EOSCogniton/ELIZ-2021/CR_Cost_Report/01_BOM/MS/MS_A0100/MS_A0100_Picture.png

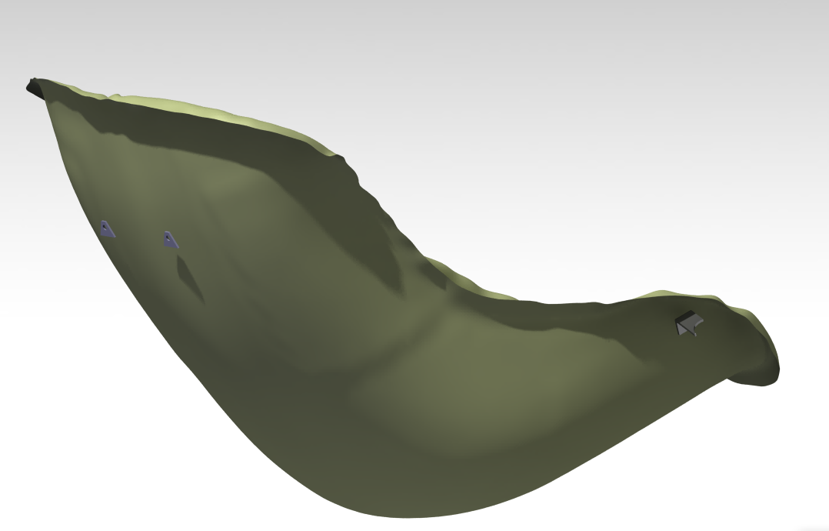
CR_Cost_Report/01_BOM/MS/MS_A0100/MS_A0100_Picture.png
