EOSCogniton/ELIZ-2021/FR_Frame_Body/modèles CATIA pour 0A/FR_A0300 (Pedal Assy) (Invictus)/Notes.txt

distance trou-trou = 5,77 mm
distance verticale jusqu'à l'axe = 7,75 mm
