EOSCogniton/ELIZ-2021/RC_Rendus_Compet/IAD/Bulkhead compliance.docx

\begin{figure}[h]

\centering

\includegraphics[width=1\textwidth]{Images/Page de garde FSG.png}

\label{fig:pdg}

\end{figure}Z

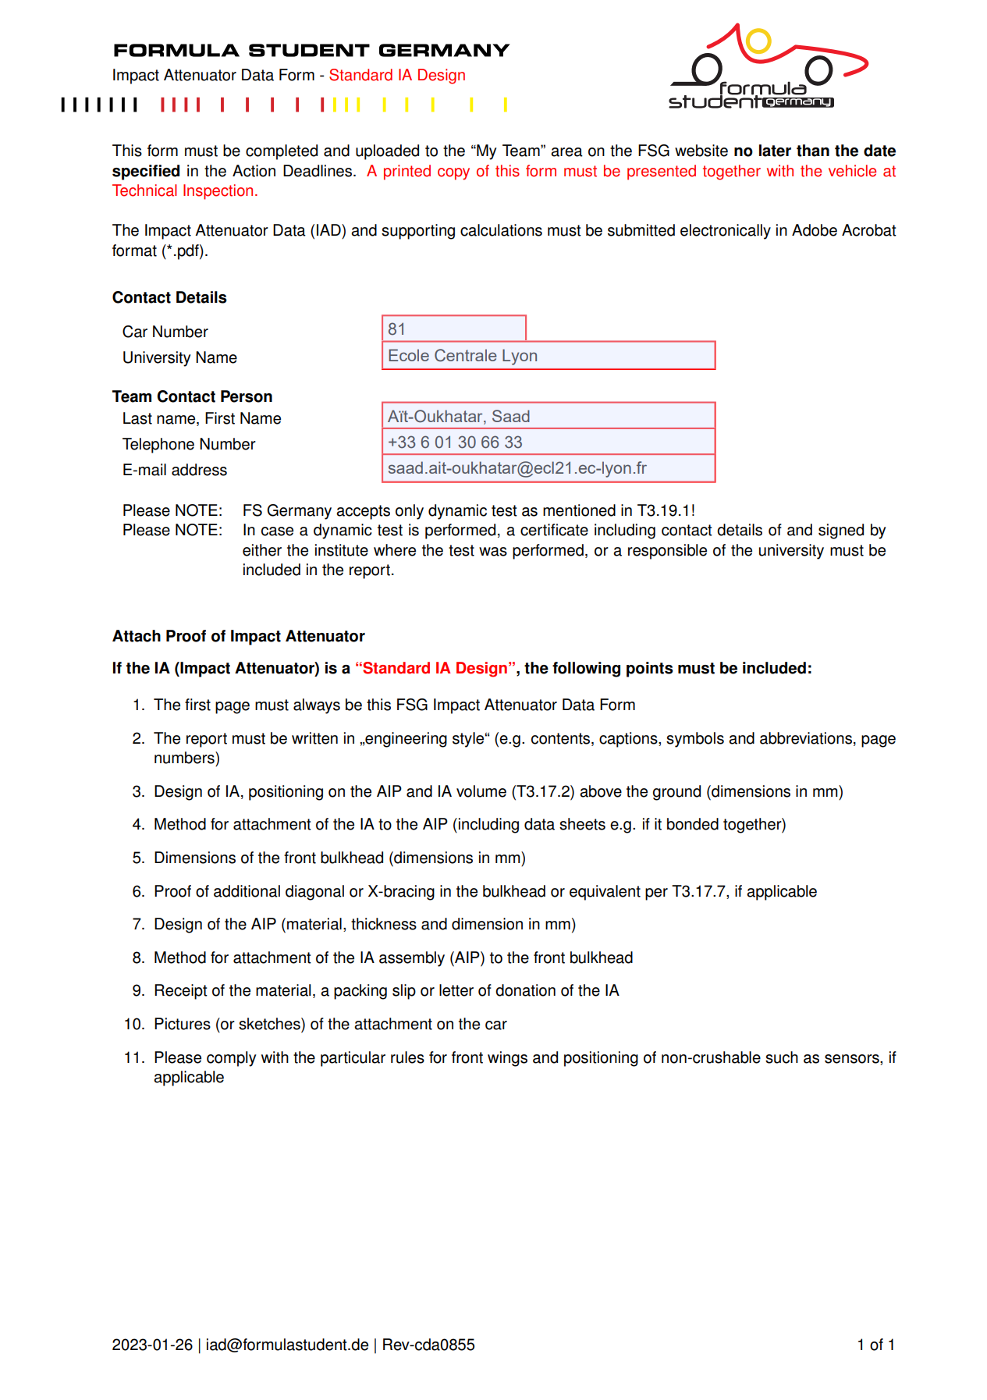
[picture p14: figure]

3. Design of IA, positioning on the AIP and IA volume :

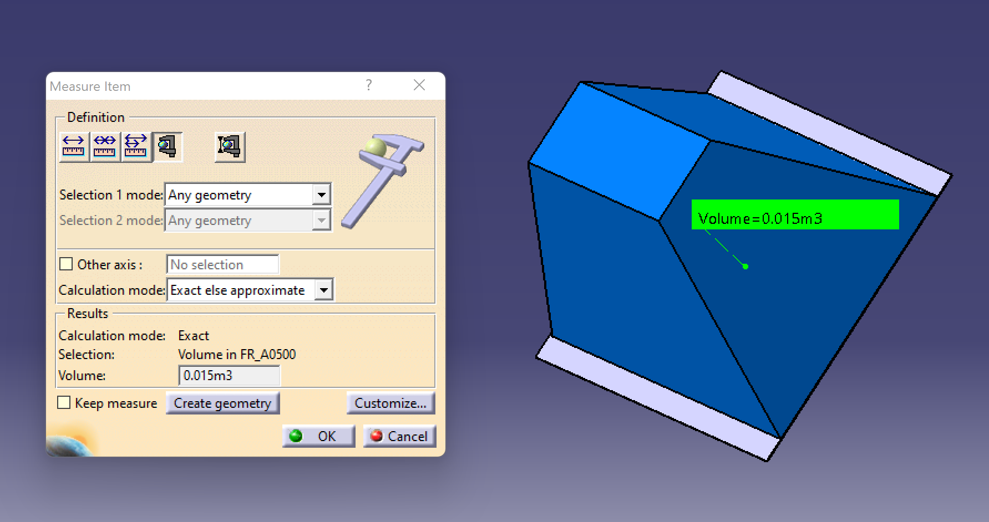
[picture p15: figure]
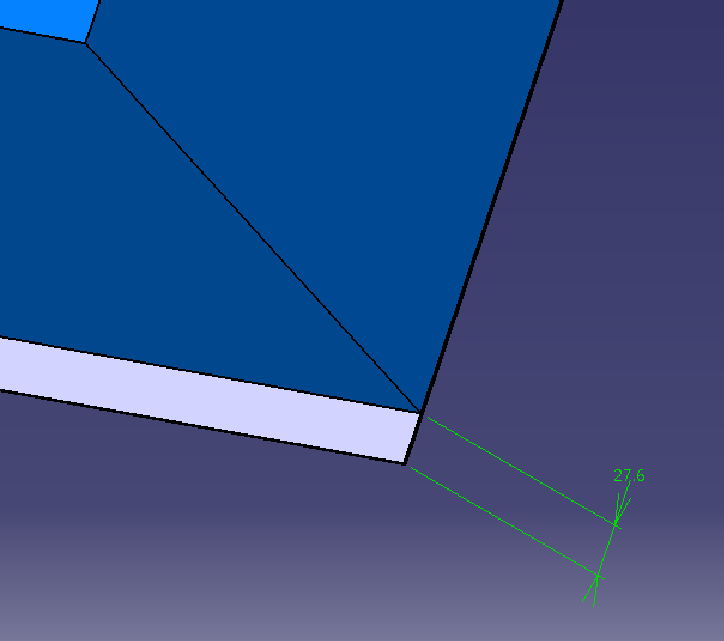
[picture p16: figure]

4. Method for attachment of the IA to the AIP

The Impact Attenuator is glued to the Anti-Intrusion plate. Here follows the data sheet of the glue used :

5. & 6. Dimensions of the front bulkhead and proof of an additional diagonal :

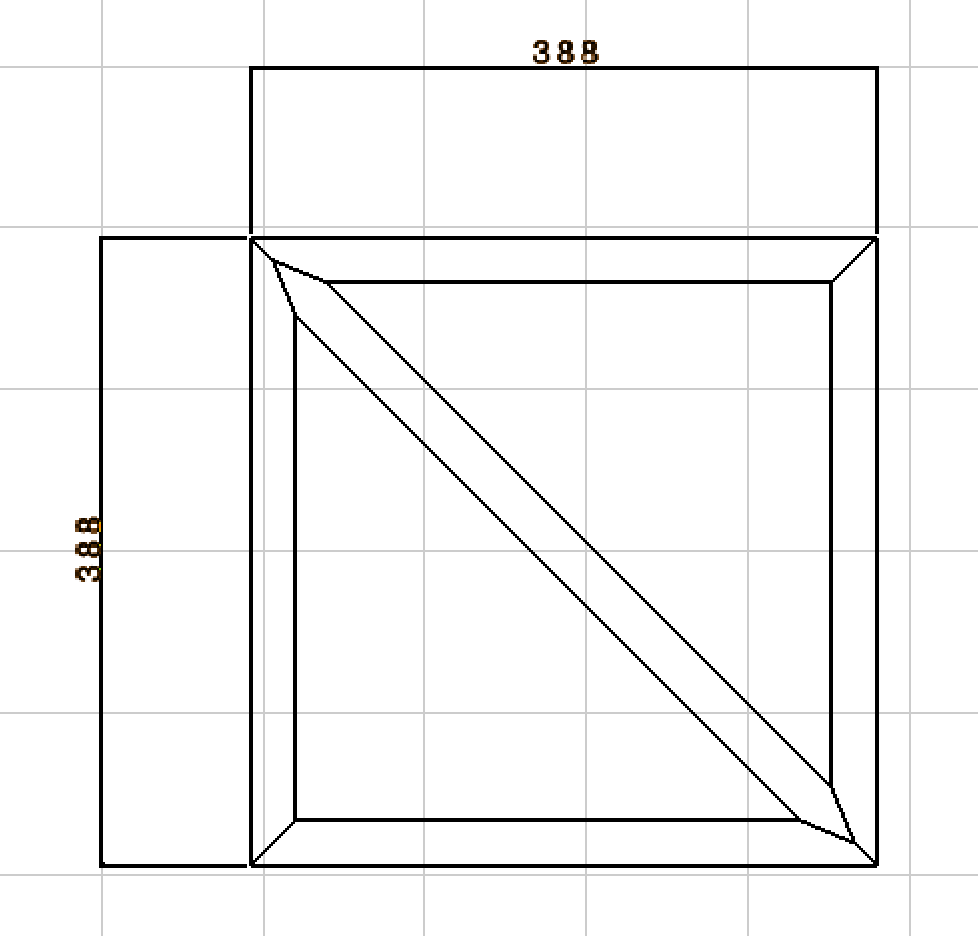
[picture p17: figure]

Tubes dimensions : 28 x 1.5

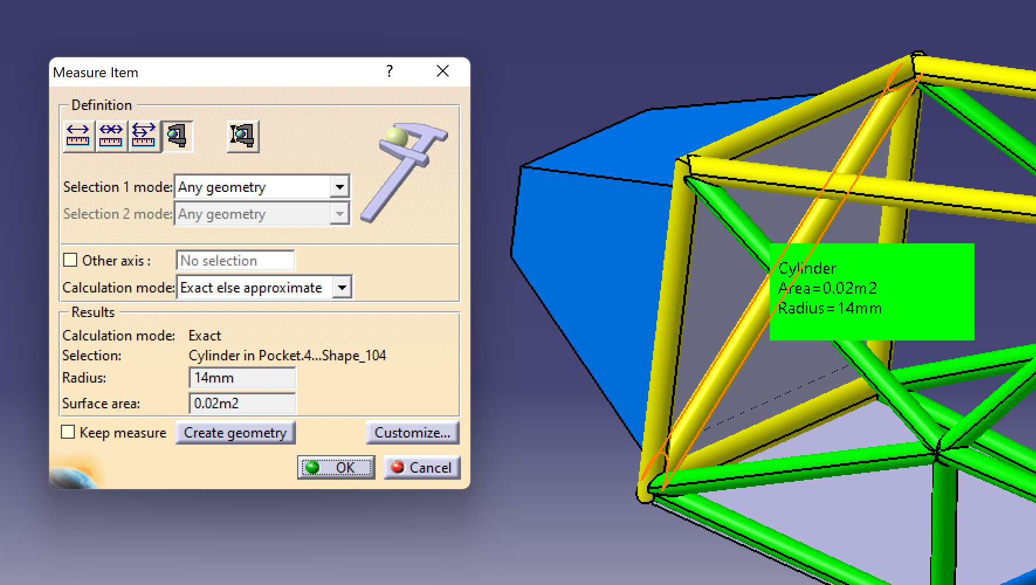
[picture p18: figure]

7. Design of the AIP :

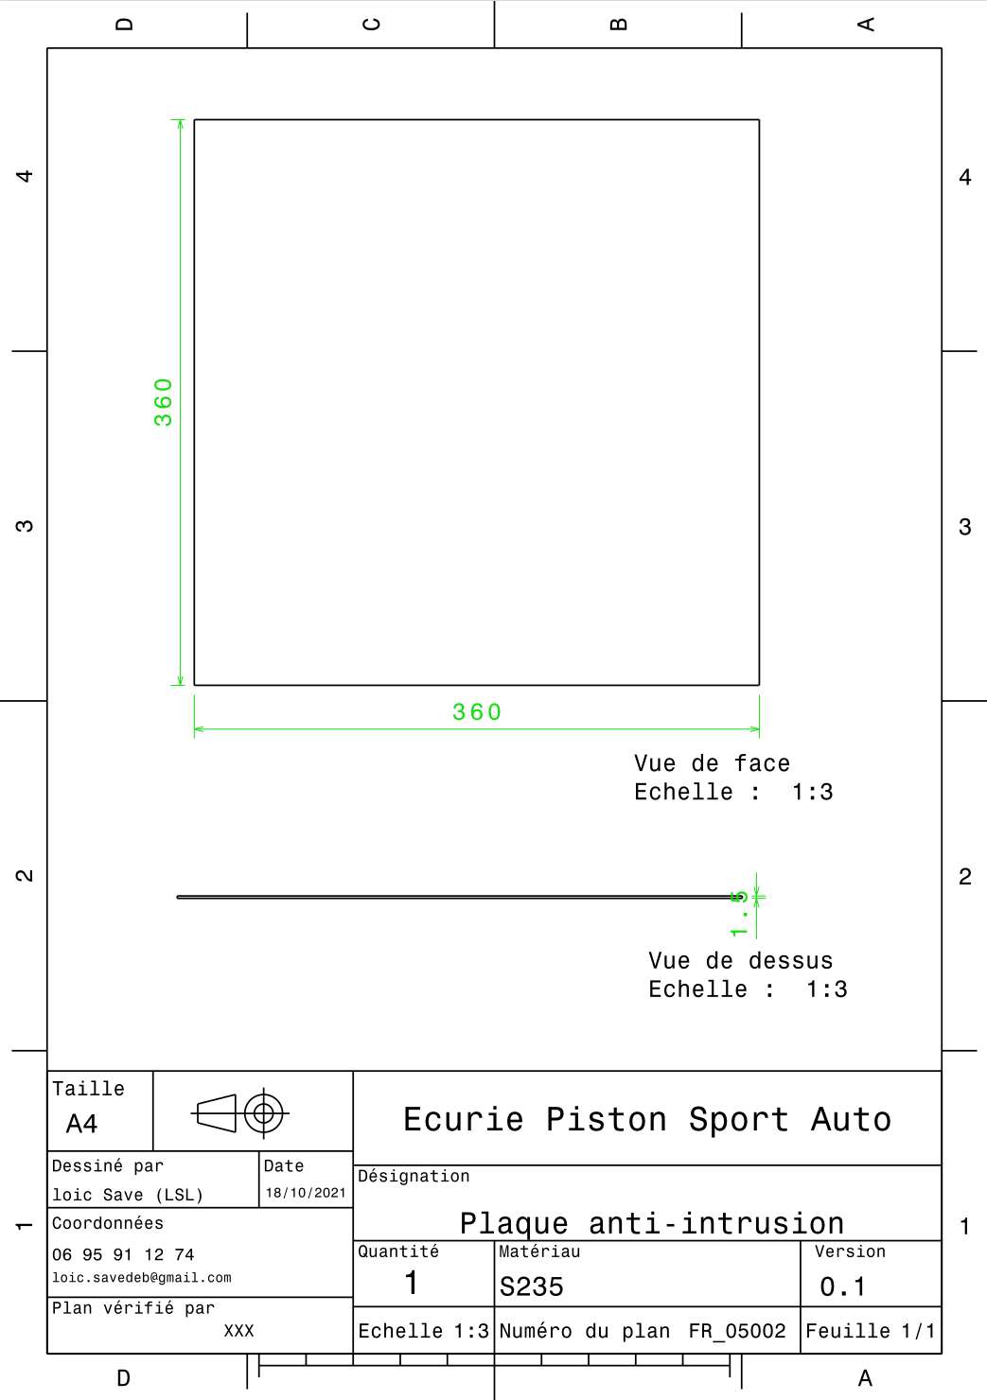
[picture p19: figure]

8.

9.

10.
