EOSCogniton/ELIZ-2021/FR_Frame_Body/FR_A01100 (gabarit)/firewall/consignes impression gabarit.docx

Pour la partie haute : 4 attaches longues

Pour la partie milieu haute : 2 attaches courtes, un support

Pour la partie milieu inf : 2 attaches 15d et 2 jointures milieu

Pour la partie basse : 2 attaches 15d
