EOSCogniton/ELIZ-2021/FR_Frame_Body/FR_A0100 (Frame)/Frame_Tutos/Tutoriel_Gueules_de_loup_Invictus.docx

Tutoriel gueules de loup

Rédigé initialement par Optimus

MAJ Par Invictus le 26/11/19

Ci-dessous les différentes étapes pour une gueule de loup, le tout est illustré pour le tube Shape_712

Le but de ce tutoriel est de vous expliquer comment faire des Gueules de Loup. Les Gueules de Loup sont les découpes Laser effectués sur les extrémités des tubes pour qu’ils puissent s’emboiter entre eux et ainsi pouvoir être soudés.
En effet, Catia ne les fait pas automatiquement, donc il faut modifier CHAQUE tube 1 par 1 pour pouvoir les envoyer en Prod.
Ce tutoriel vous explique comment les dessiner, et comment savoir quel tube s’emboite dans quel tube.

I - Choix des tubes relimitants

Pour commencer, seront relimitants les tubes ayant une « relimitation bissectrice » au nœud étudié

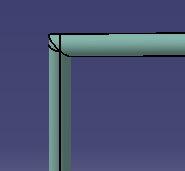
[picture p25: figure]
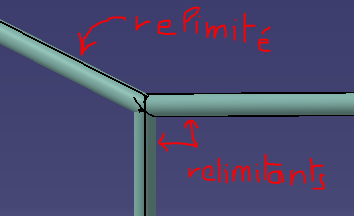
[picture p26: figure]

Le bulkhead, le front hoop et le main hoop sont relimitants

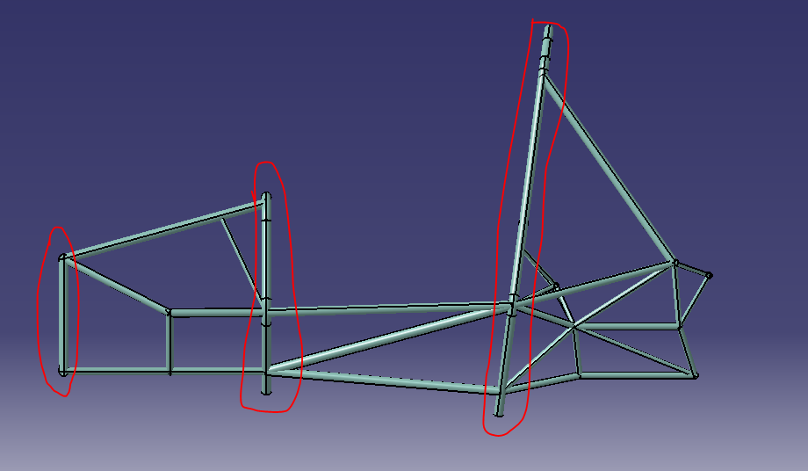
[picture p27: figure]

Enfin, lorsqu’un tube entre dans un autre, c’est lui qui est relimité (celui qui rentre). Attention, un tube peut être relimitant par rapport à un tube, et relimité par rapport à un autre.

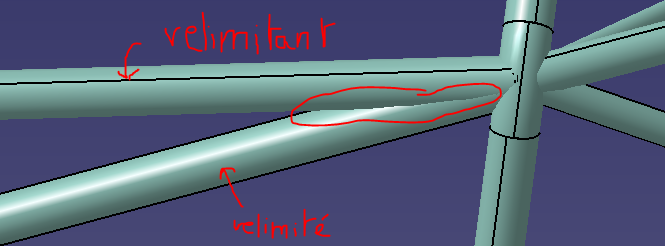
[picture p28: figure]
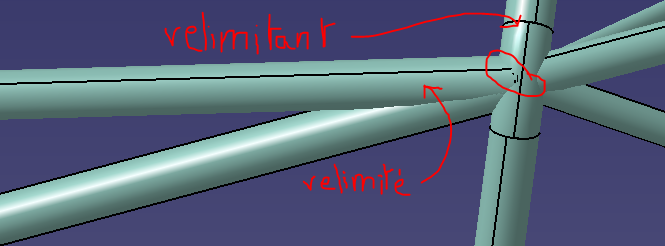
[picture p29: figure]

II – Faire une Gueule de Loup

Ci-dessous les différentes étapes pour une gueule de loup, le tout est illustré pour le tube Shape_712

- Choisir un tube de travail (cf liste donnée à chacun) tube relimité
- Ouvrir l’assemblage Frae_Prod (STUF-2020\FR_Frame_Body\FR_A0100 (Frame)\Frame_Production\Tubulaire_Prod)
- Chercher le tube à travailler dans l’arbre
- Ouvrir sa sous arborescence (signe +)

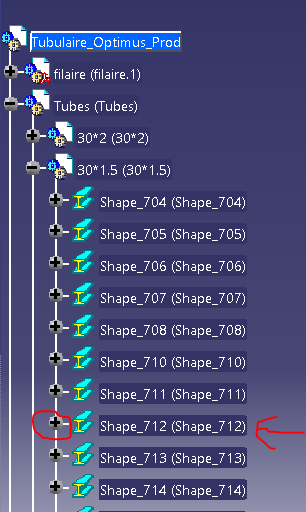
[picture p30: figure]

- Double cliquer pour en faire l’objet de travail

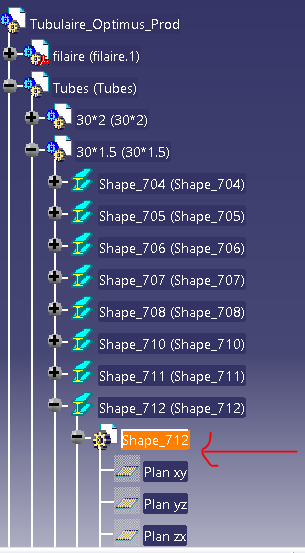
[picture p31: figure]

(**)

- Démarrer le mode part design (Démarrer, conception mécanique, Part design)
- Faites Clic Droit sur votre Part et faites « Recadrez sur » pour la retrouver dans l’espace.
- (*) Repérer un tube avec lequel il entre en contact, et sur lequel il devra s’adapter. Ce tube sera le relimitant (ici, le tube rouge doit s’adapter au jaune et au bleu)

Cf aide à la fin pour ce choix

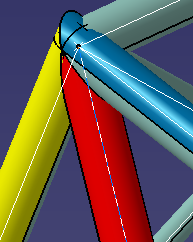
[picture p32: figure]

- Créer un plan normal sur le fil (axe) correspondant à ce tube relimitant (celui qui impose l’adaptation, pas celui que l’on travaille (relimité))

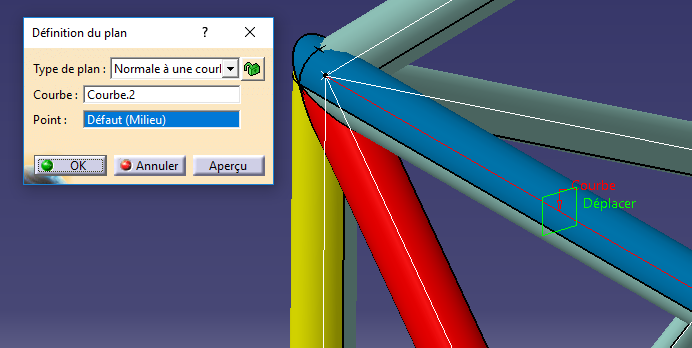
[picture p33: figure]

- Créer une esquisse sur ce plan
- Dessiner un cercle de diamètre le diamètre extérieur du tube relimitant
- Créer une contrainte de coïncidence (distance nulle) entre le centre du cercle et l’axe du tube relimitant (axe en rouge sur le screen (axe du tube bleu))

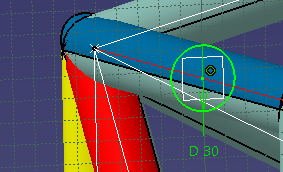
[picture p34: figure]

- Sortir de l’esquisse
- Créer une poche depuis cette esquisse, et sur une longueur permettant de dépasser totalement le tube relimité

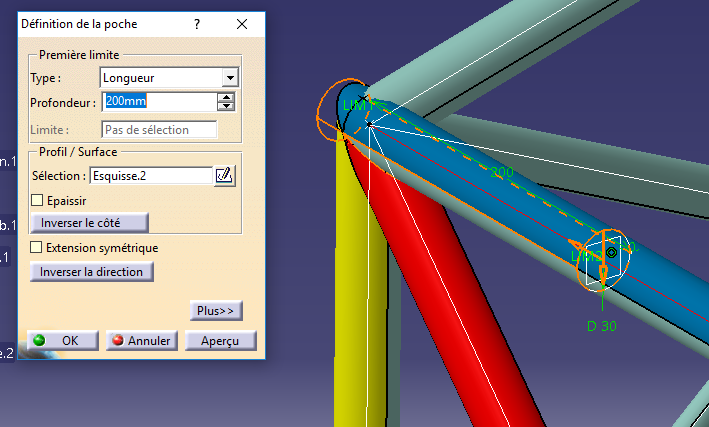
[picture p35: figure]

- Réitérer l’opération depuis le point (*), pour tous les autres tubes relimitants qui entrent en contact avec le notre (par exemple le jaune ici)
- Faites bien attention à ce que vous soyez bien dans l’arbre dans la Part du tube ! Sinon votre poche peut être en train de s’appliquer sur d’autres tubes !
- Enregistrer le tube travaillé uniquement ! (Fichier/enregistrer, en restant dans la configuration de la photo (**)), du coup en fermant l’assemblage Frame_Prod, on n’enregistre pas !!

OU :

Clic droit sur l’objet en cours, puis sous menu « objet… » puis « ouvrir dans une nouvelle fenêtre », puis là vous enregistrez ! Puis vous fermez l’assemblage sans enregistrer, et vous le réouvrez pour repartir sur un nouveau tube

- On obtient alors le tube correctement découpé

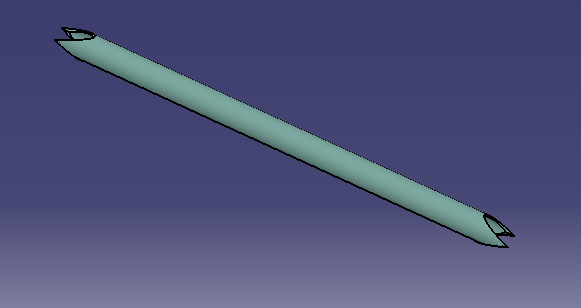
[picture p36: figure]

- N’oubliez pas de Push et de remplir le Excel / Liste de choses à faire qui vous aura été fourni

https://docs.google.com/spreadsheets/d/1tl6bBZY0b3RQ9-AJJpEZ0ktwOgrjCneLkRfVlmMJEiY/edit?usp=sharing
