EOSCogniton/ELIZ-2021/DR_Design_Report/07_Visuels_presentation/A - Overall vehicle design - Final.pdf

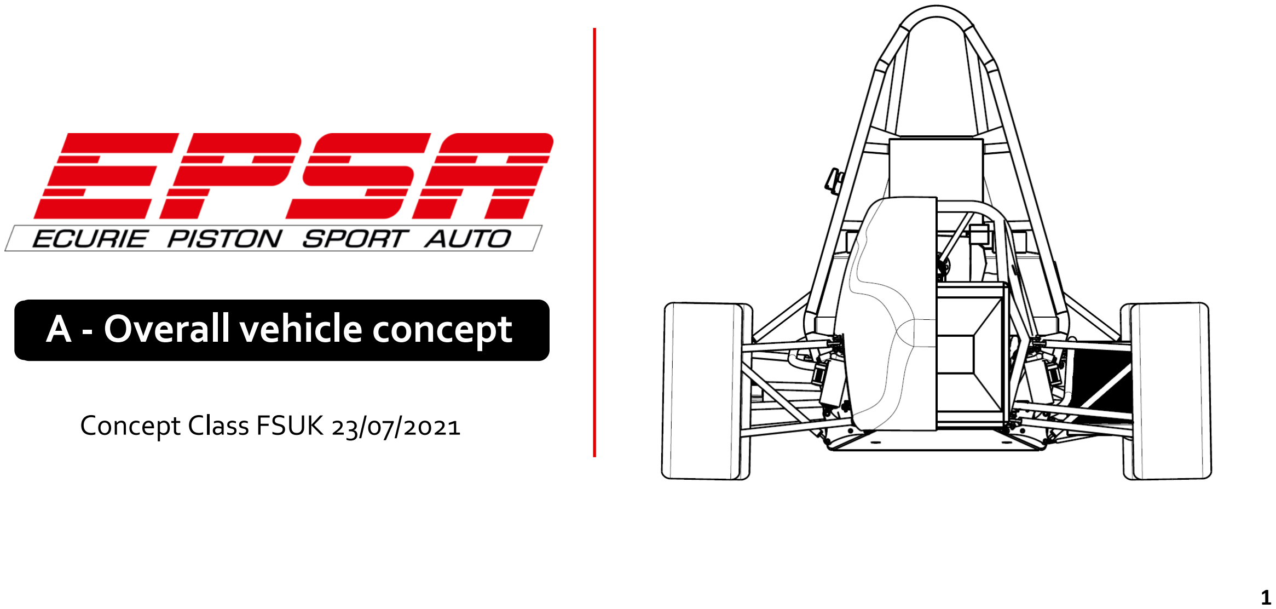
[picture p56: page 1]

# A Management Document - Overall vehicle concept

# Concept Class FSUK 23/07/2021

1

© EPSA Association, 2019. All rights reserved. Information contained in this document is indicative only. No representation or warranty is given or should be relied on that it is complete or correct or will apply to any particular project. This will depend on the technical and commercial circumstances. It is provided without liability and is subject to change without notice. Reproduction, use or disclosure to third parties, without express written authorisation, is strictly prohibited.

# Objectives

# 1st electric vehicle: Pass the Scrutineering + Finish endurance

# Focus on reliability

Event | Objective | Max pts
Cost Event | 75 | /100
Business Event | 60 | /75
Design Event | 80 | /150
Skid Pad | 30 | /75
Acceleration | 30 | /100
Autocross | 40 | /125
Endurance | 125 | /275
Efficiency | 10 | /100
Total | 450 | /1000
Event | Objective
SkidPad | 5,3 sec
Acceleration | 4,4 sec
Endurance | Finish

2

# The vehicle: Valkyriz

3

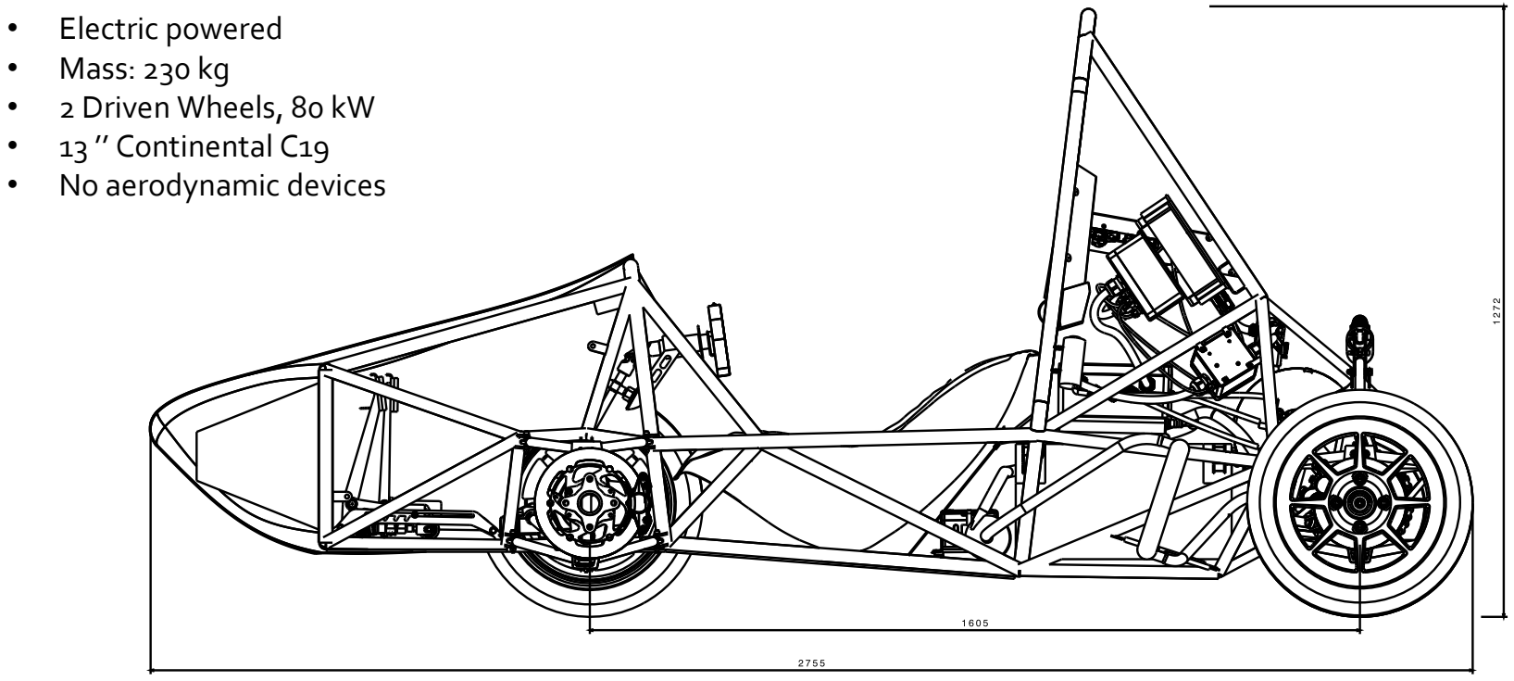
[picture p57: figure]
• Electric powered • Mass: 230 kg • 2 Driven Wheels, 80 kW • 13 ’’ Continental C19 • No aerodynamic devices

# Frame & Body

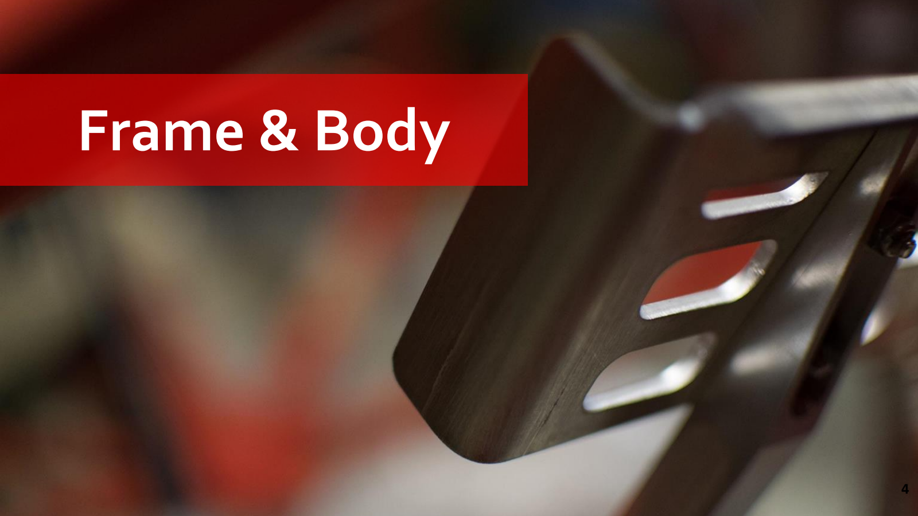
[picture p58: page 4]

4

# Frame & Body

5

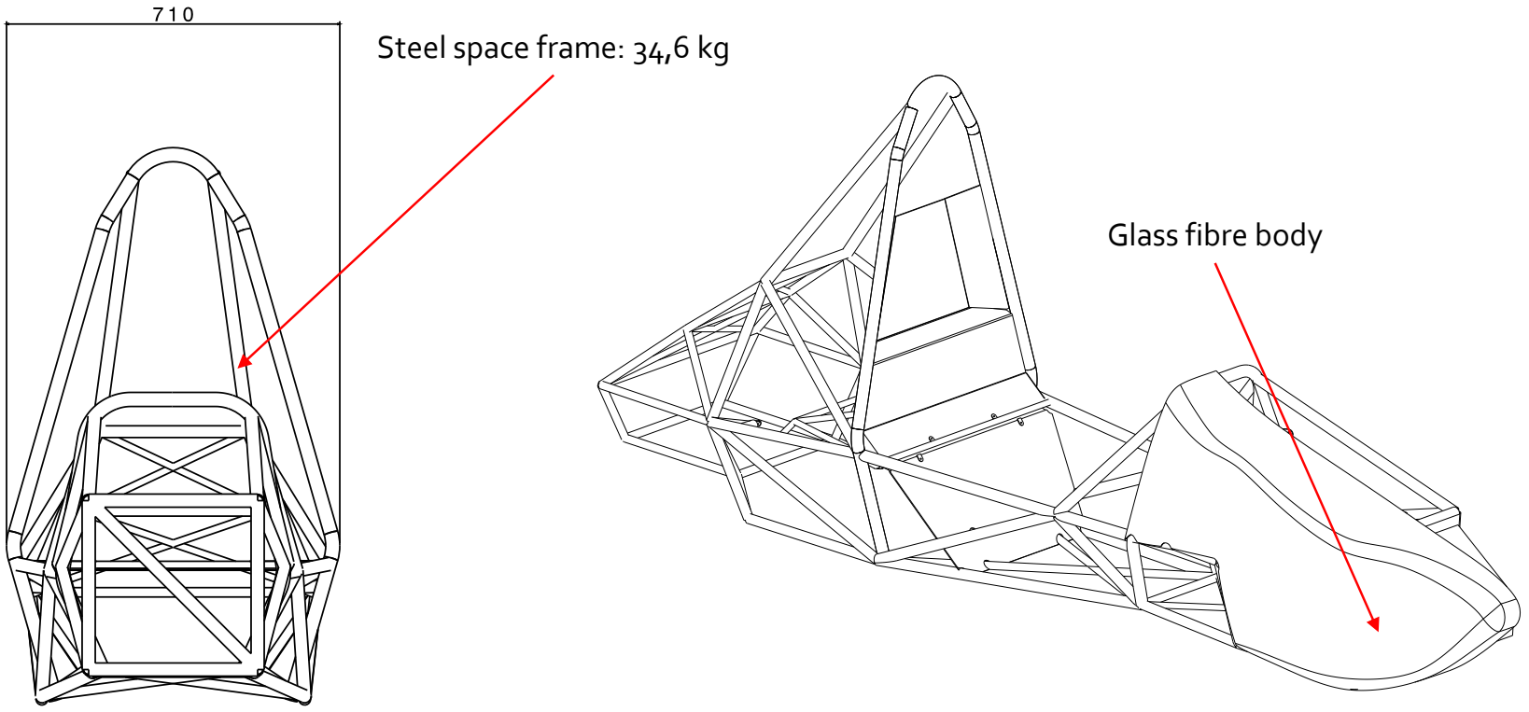
[picture p59: figure]
Steel space frame: 34,6 kg; Glass fibre body

# Suspension system

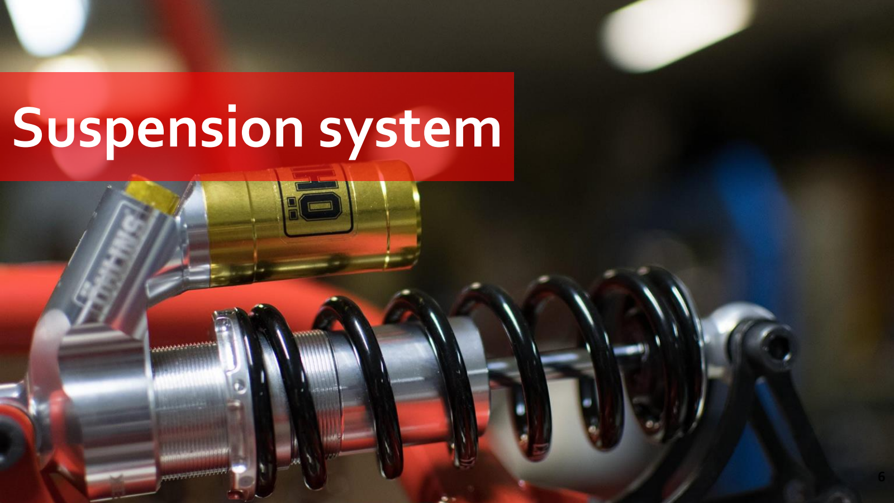
[picture p60: page 6]

6

# Front Suspension System

# Pull rod

# Anti roll bar Double wishbone

# Parallel steering system

7

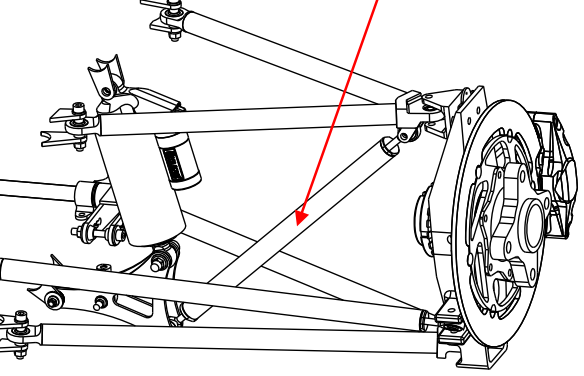
[picture p61: figure]

# Rear Suspension System

# Double wishbone

# Drexler limited slip differential

# Push Rod

8

# Powertrain

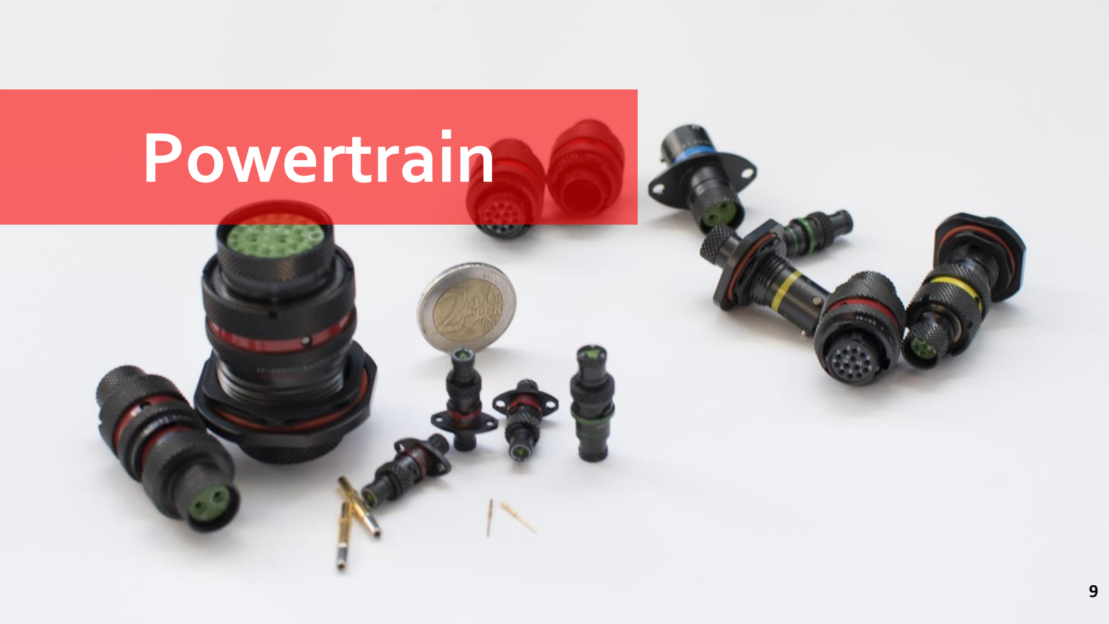
[picture p62: page 9]

9

# Powertrain

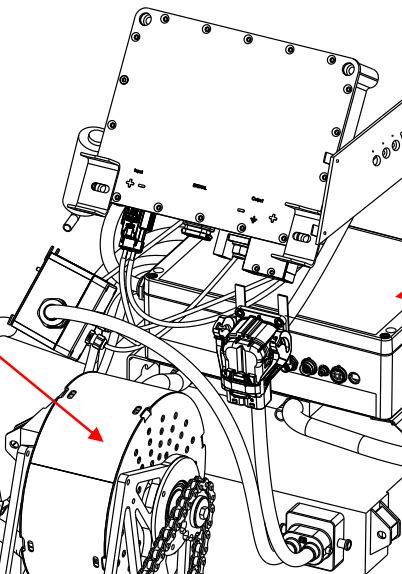
[picture p63: figure]

# One Motor EMRAX 228: 80 kW

# Accumulator: 7.3 kWh

# Inverter BAMOCAR D3

# 2 driven wheels

# Liquid Cooling system

10

# Overview

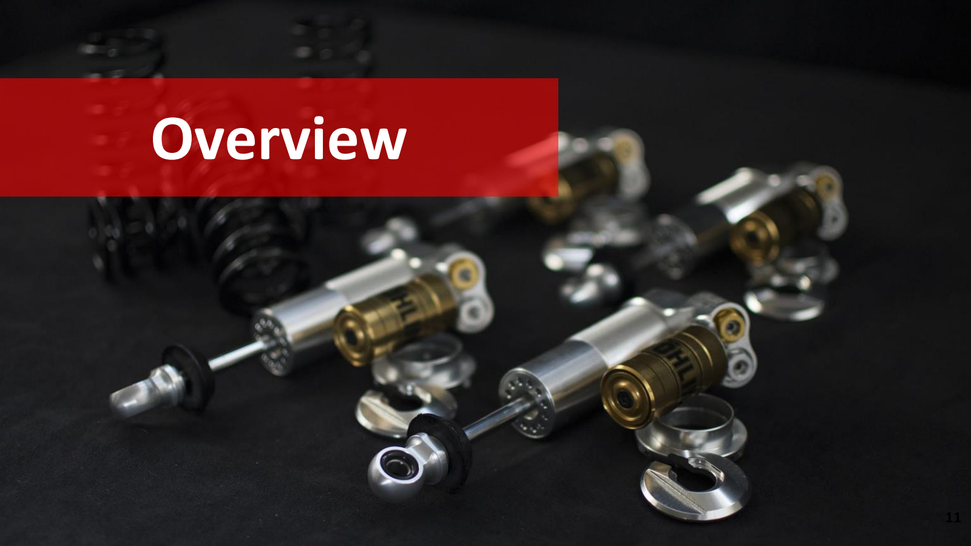
[picture p64: page 11]

11

# Mass schedule

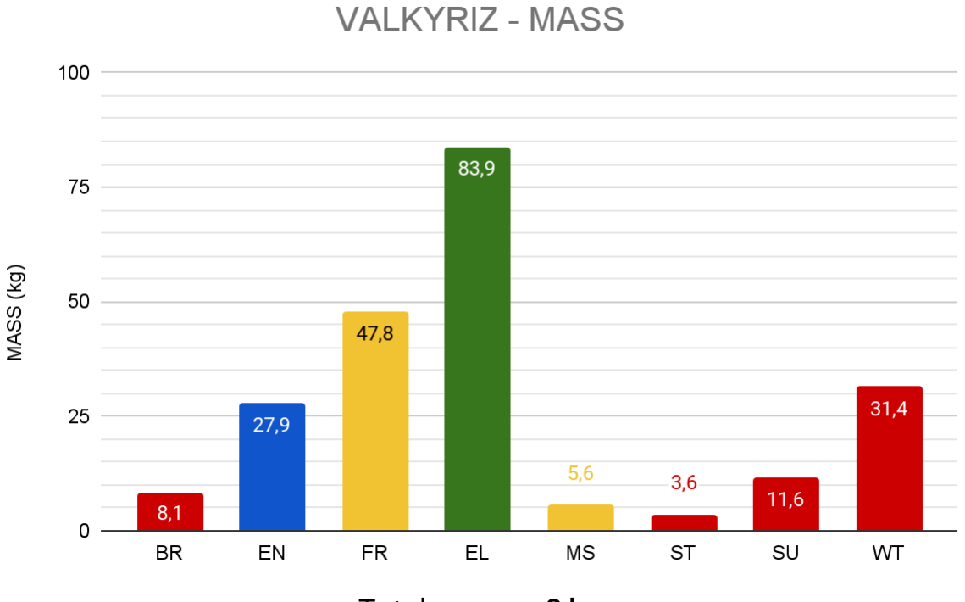
[picture p65: figure]

# Total mass: 218 kg

12

# Cost schedule

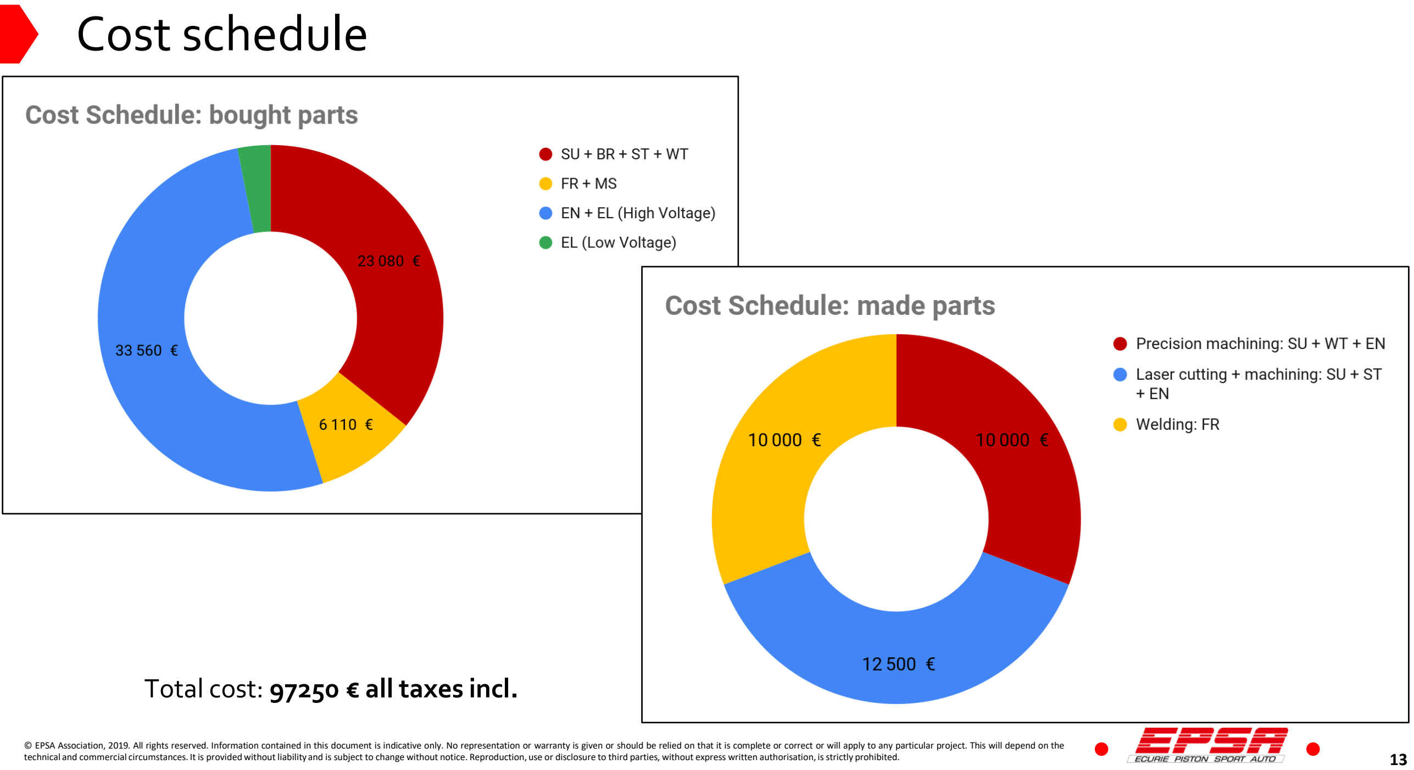
[picture p66: page 13]

Total cost: 97250 € all taxes incl.

13

# Appendices

# XXh - XXh

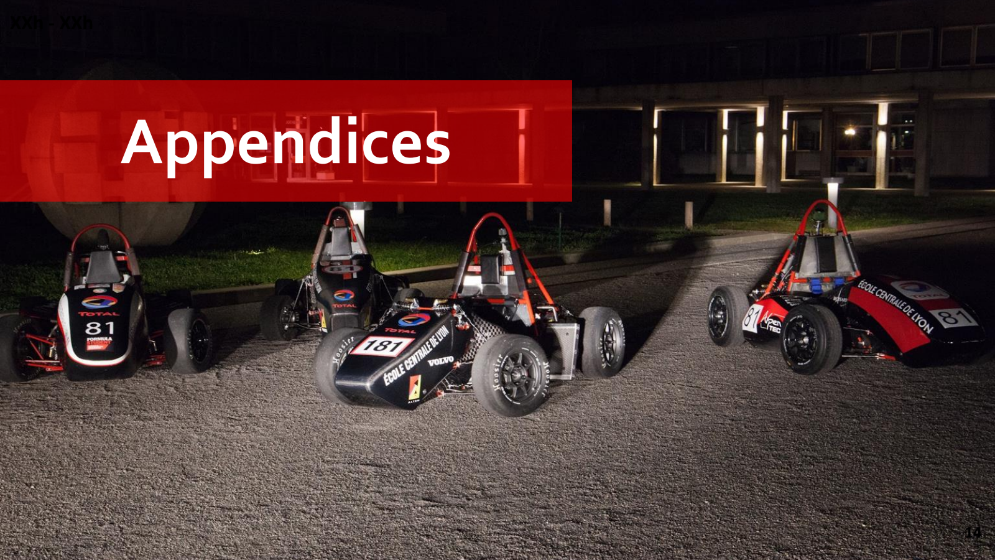
[picture p67: page 14]

14

# Front suspension: Top View

15

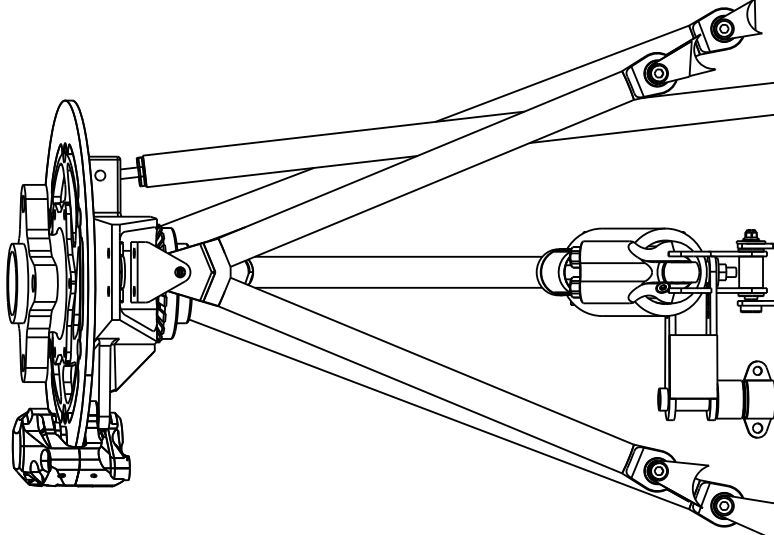
[picture p68: figure]

# Rear suspension: Top View

16

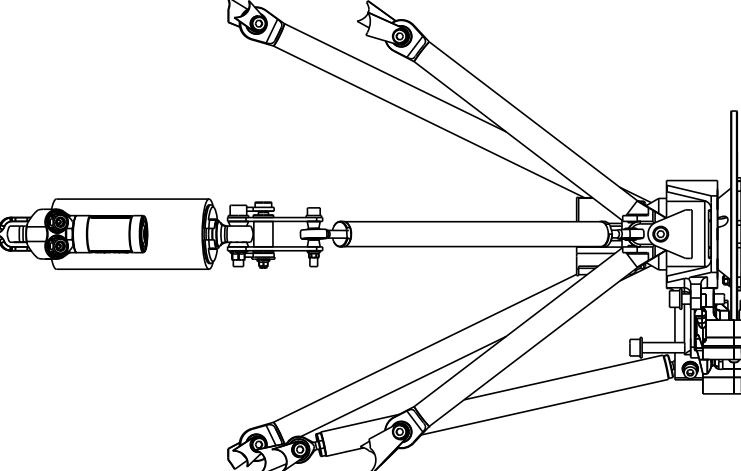
[picture p69: figure]

# Rear suspension system

17

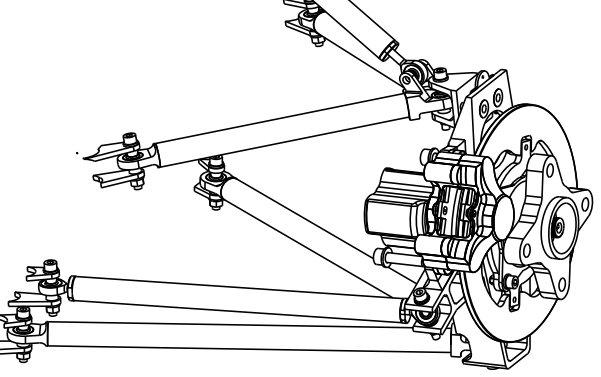
[picture p70: figure]

# Powertrain integrated into the Frame

18

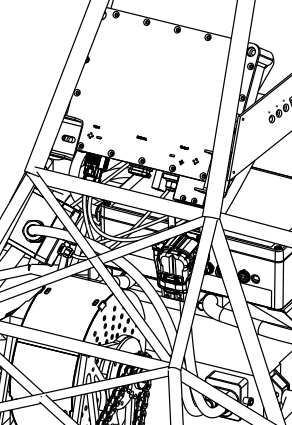
[picture p71: figure]

# Frame

19

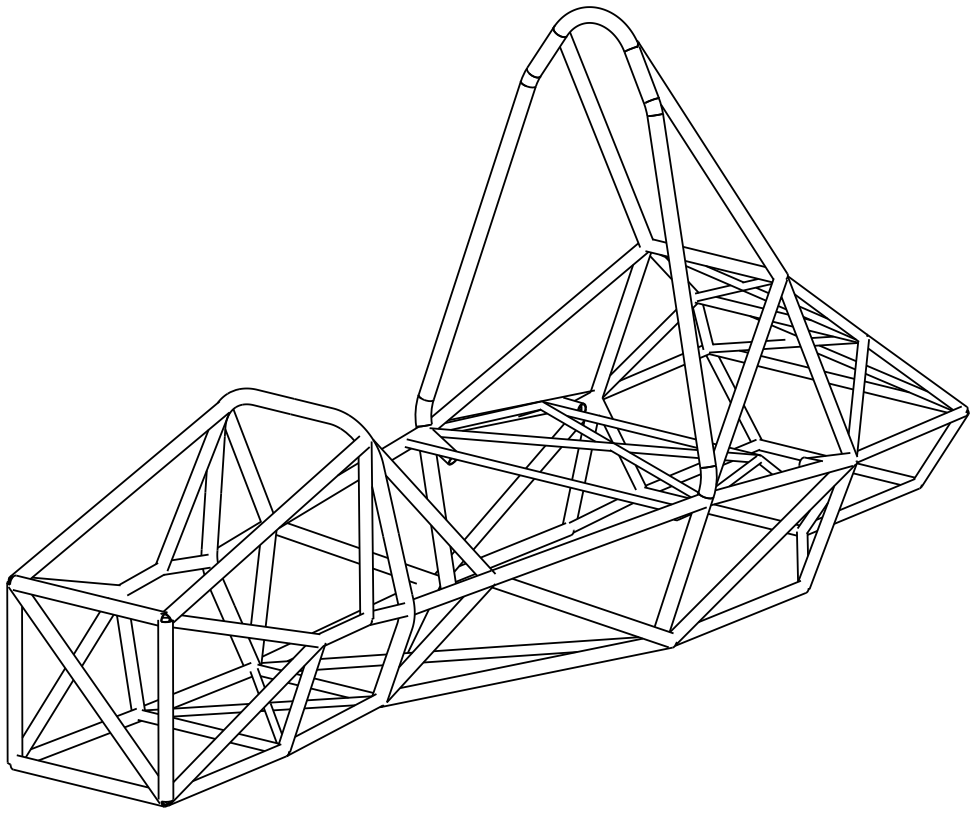
[picture p72: figure]

# Frame: Top View

20

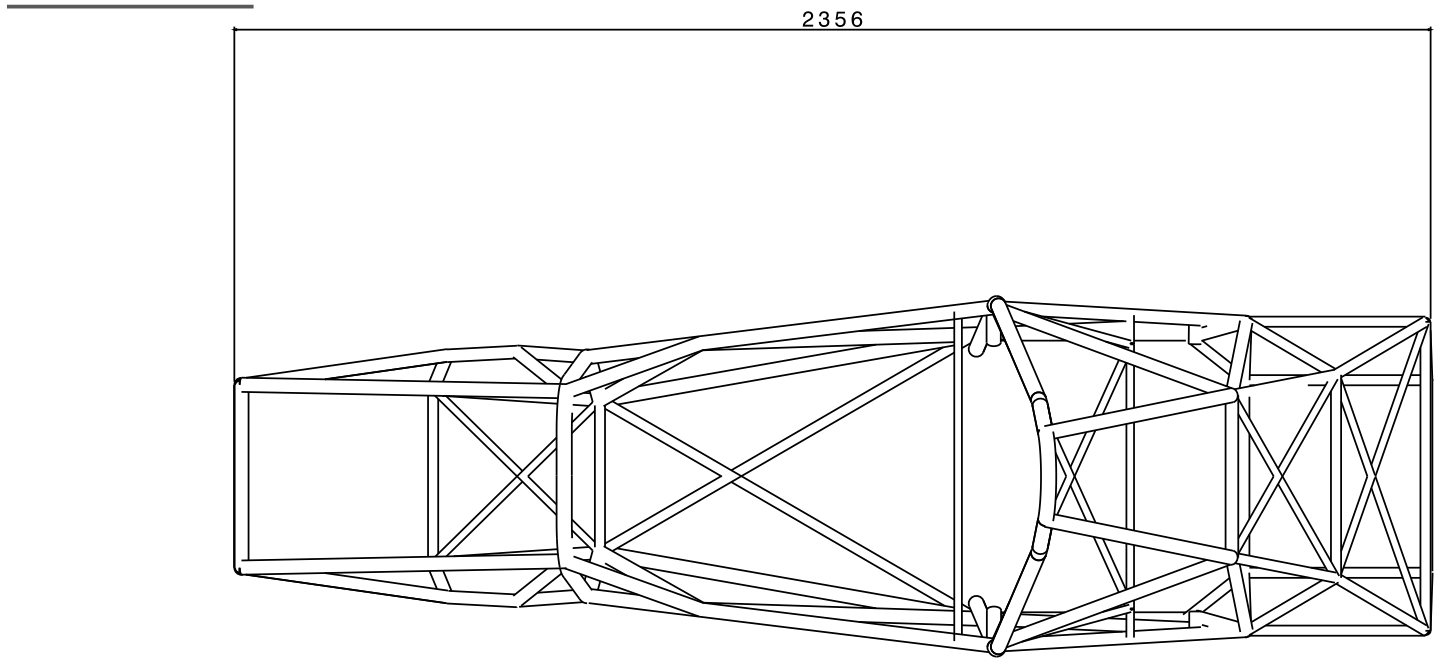
[picture p73: figure]

# Frame: Side View

21

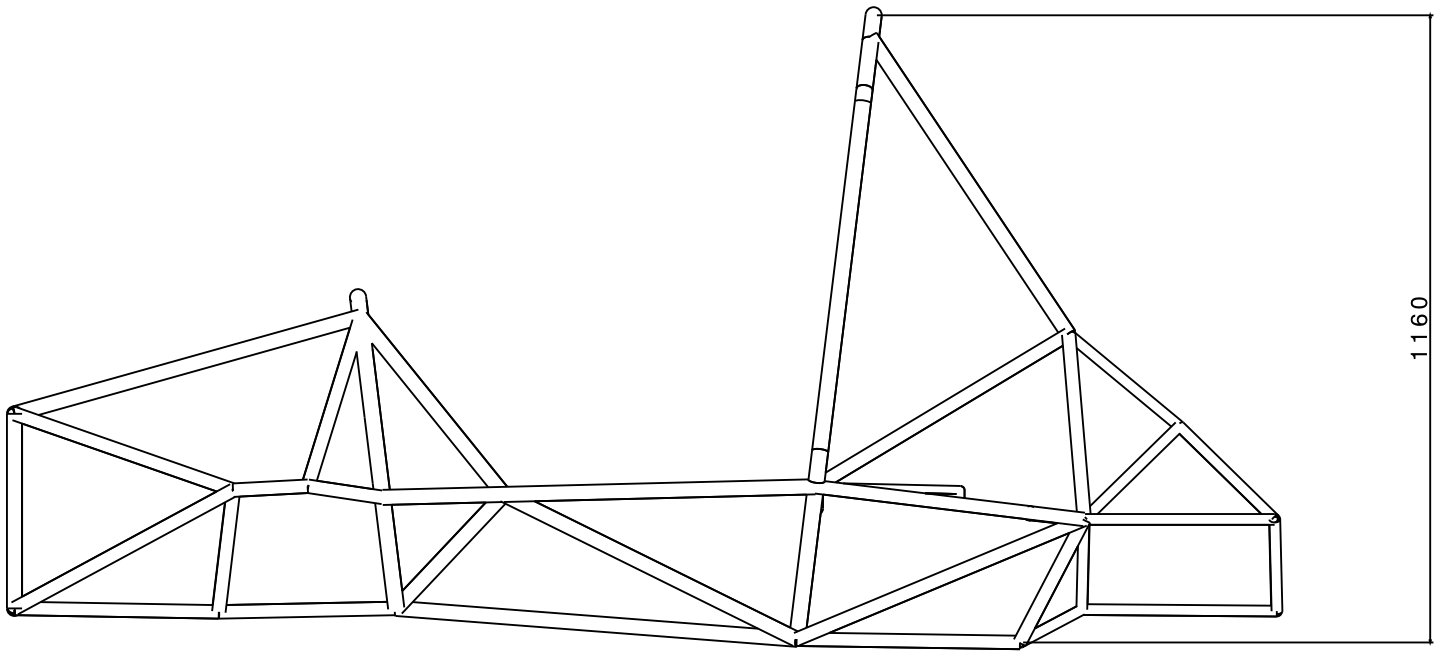
[picture p74: figure]

# A-Arms

22

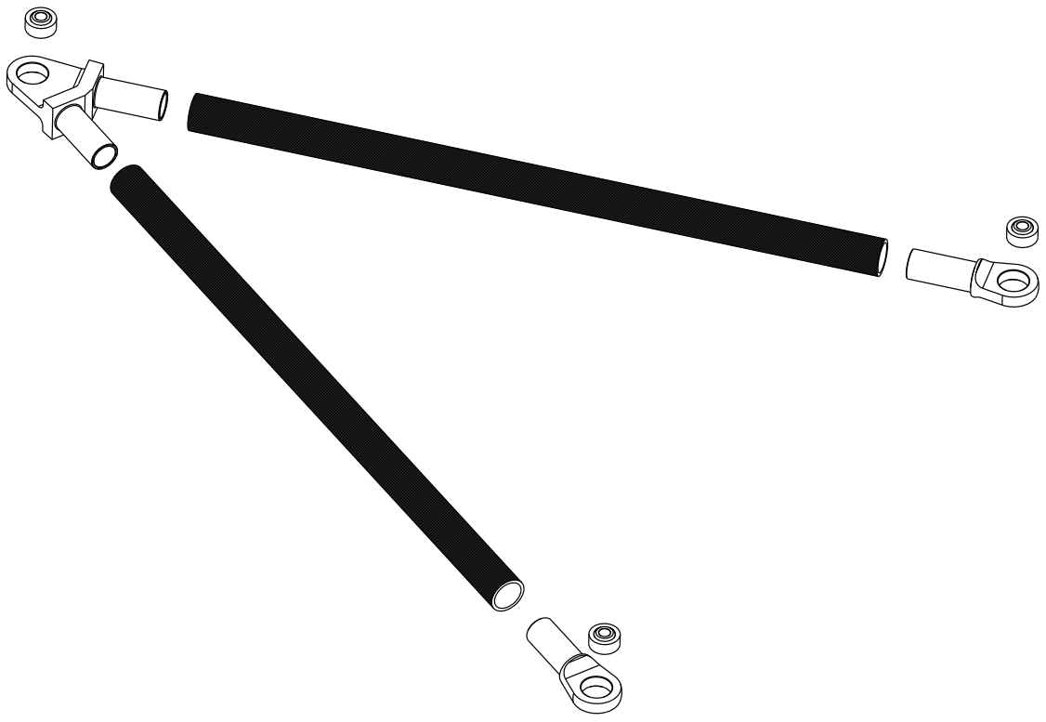
[picture p75: figure]

# Wheel Assembly

23

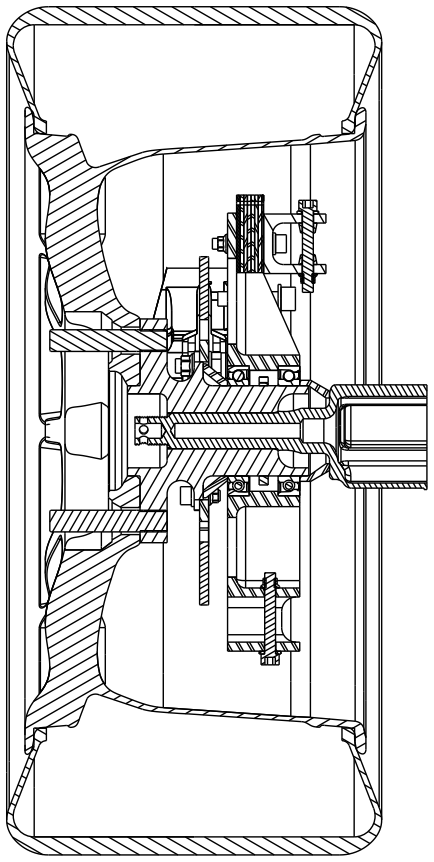
[picture p76: figure]
