EOSCogniton/ELIZ-2021/DR_Design_Report/06_Rendu_compet/281_Ecurie Piston Sport Auto_Design_Support_Part_B.pdf

# Ecole Centrale de Lyon – Car n°281

## B - Structural Design inc Suspension & Brakes

### Frame

### Objectives

- Enhance the position of the driver,
- Minimize the ratio between weight and torsion stiffness

### Conception guidelines

| Target | Simulation
Stiffness (Nm/deg) | 1600 - 2000 | 1865
Weight (kg) | 35-40 | 35

### Load table

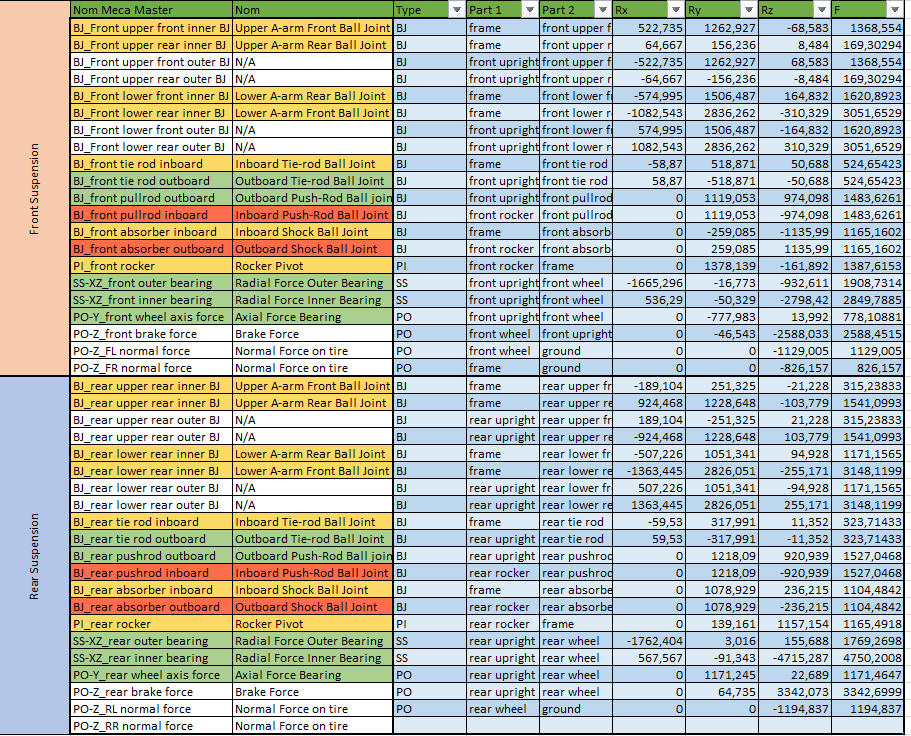
[picture p79: figure]

Fig 1. Load table for Right Turn 1G + braking 1G, given by the software MECAMaster.

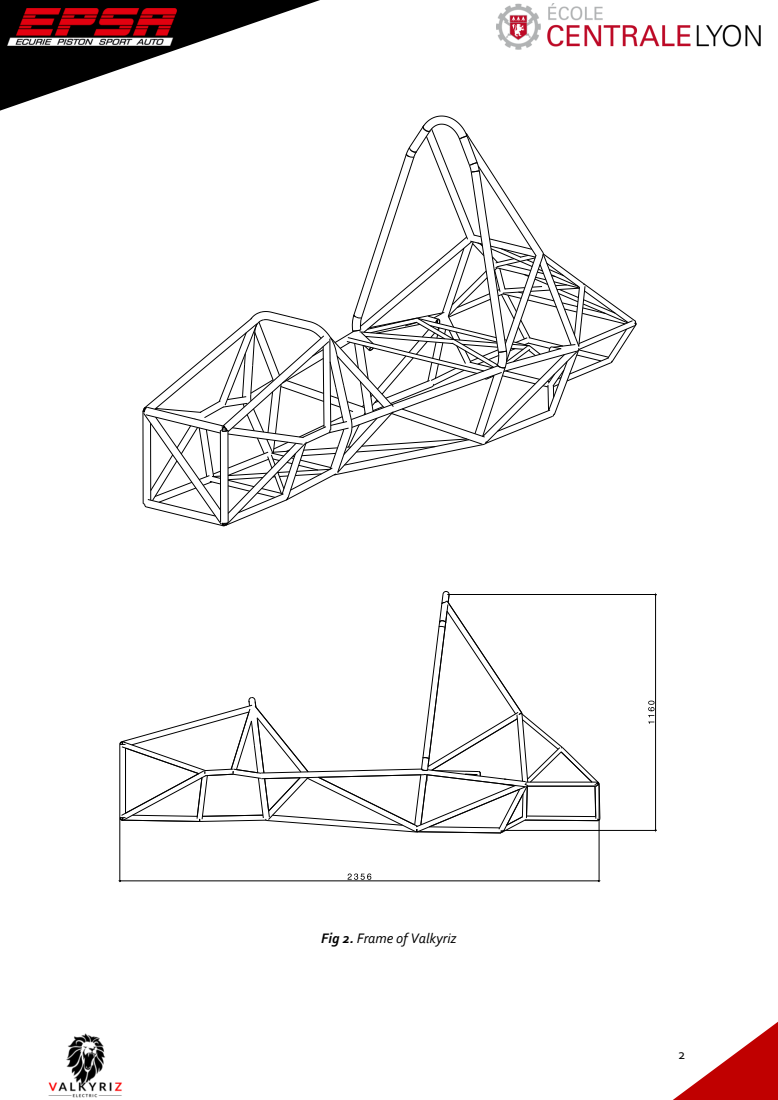
[picture p80: page 2]

Fig 2. Frame of Valkyriz

### Suspension design

### Objectives

- Optimise the contact patch between the tire and the road surface in order to maximise the grip.
- Provide the best driver control of the vehicle.

### Conception guidelines

- Linear behaviour to simplify calculations
- Slow camber changes
- Minimized and coordinated roll centers movements
- Prevent from compliances and non-linear effects
- Move down the gravity center of the car

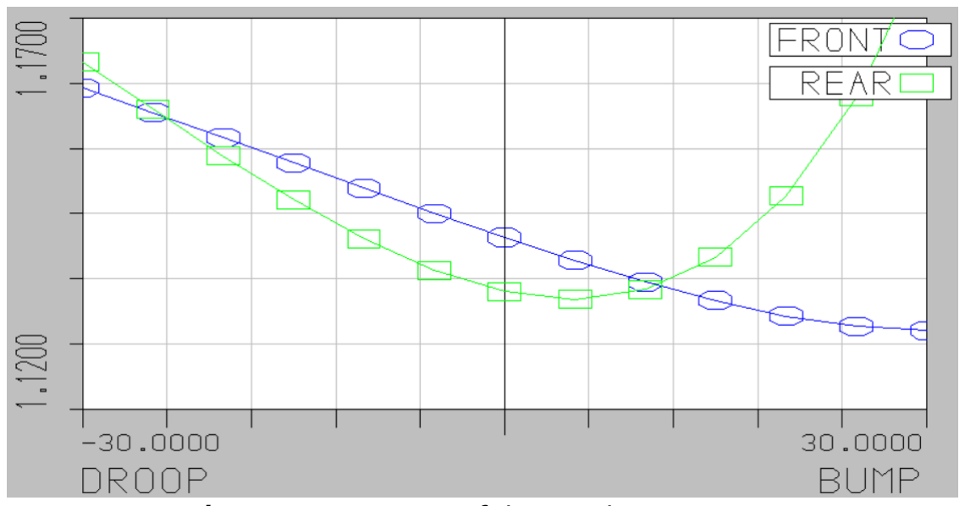
[picture p81: figure]

Fig 3. Motion Ratios of the Car during BUMP.

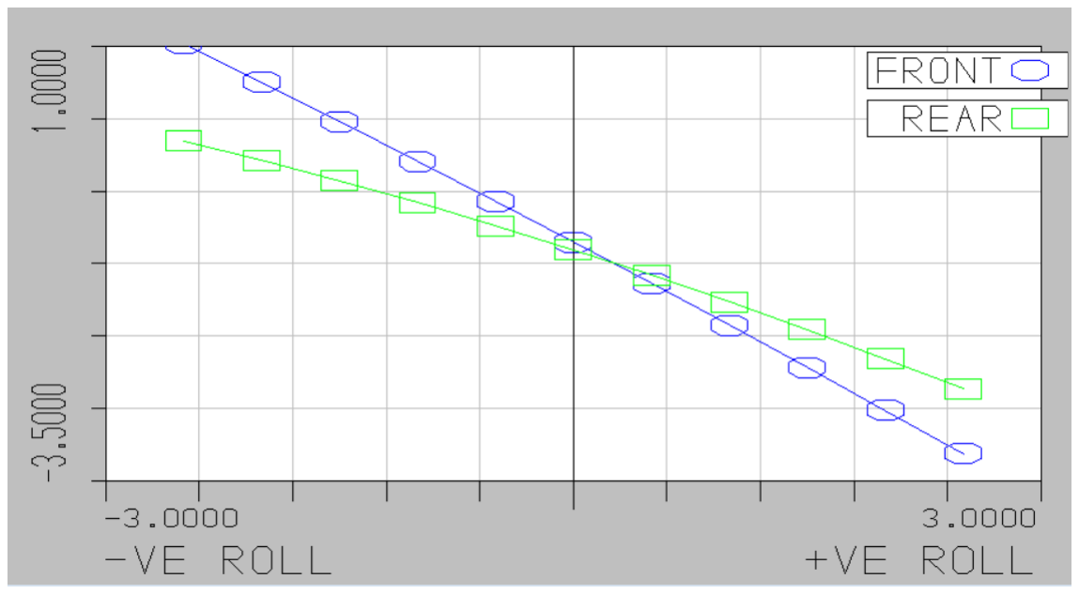
[picture p82: figure]

Fig 4. Camber variations during Roll.

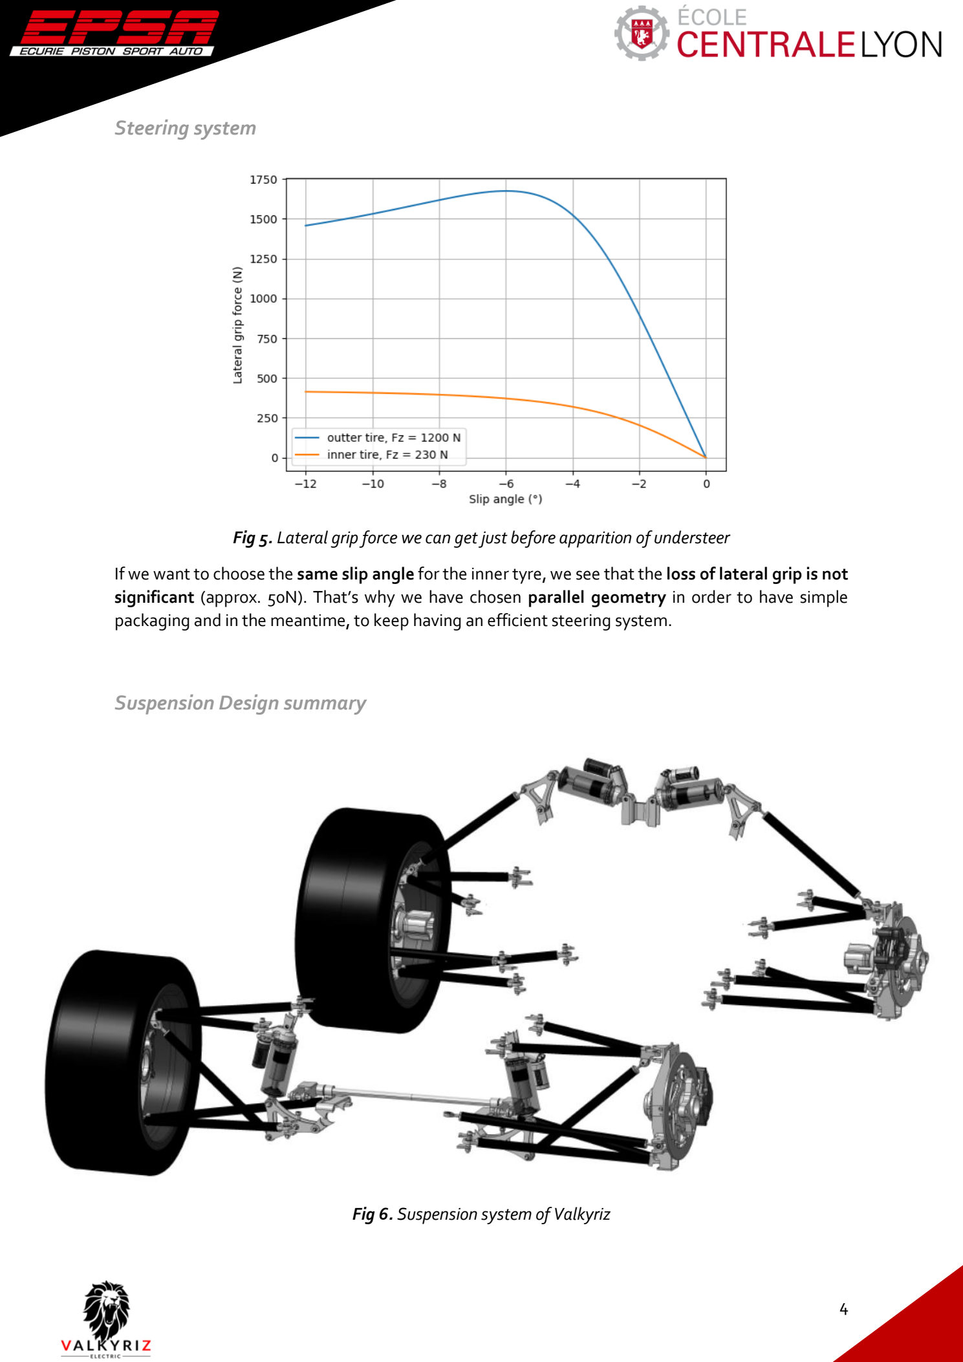
[picture p83: page 4]

### Steering system

Fig 5. Lateral grip force we can get just before apparition of understeer

If we want to choose the same slip angle for the inner tyre, we see that the loss of lateral grip is not significant (approx. 50N). That’s why we have chosen parallel geometry in order to have simple packaging and in the meantime, to keep having an efficient steering system.

### Suspension Design summary

Fig 6. Suspension system of Valkyriz

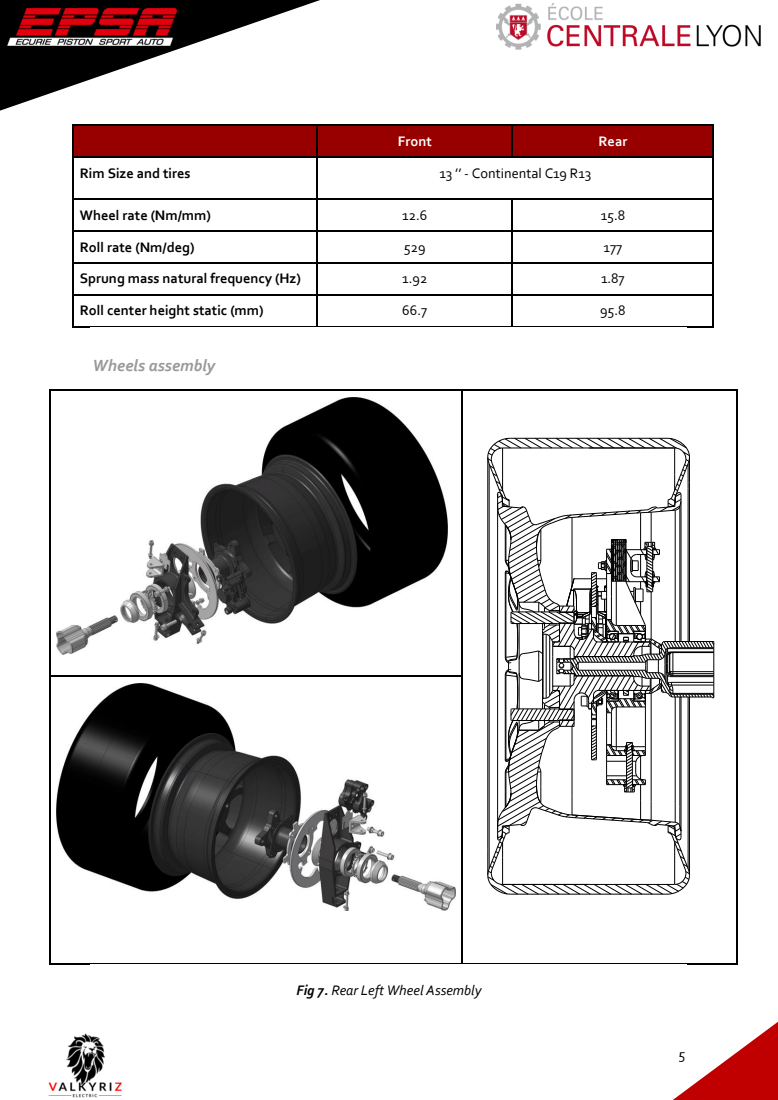
[picture p84: page 5]
Wheels assembly

Front | Rear

Rim Size and tires | 13 ’’ - Continental C19 R13

Wheel rate (Nm/mm) | 12.6 | 15.8

Roll rate (Nm/deg) | 529 | 177

Sprung mass natural frequency (Hz) | 1.92 | 1.87

Roll center height static (mm) | 66.7 | 95.8

Fig 7. Rear Left Wheel Assembly
