EOSCogniton/ELIZ-2021/DR_Design_Report/06_Rendu_compet/281_Ecurie Piston Sport Auto_Design_Support_Part_D.pdf

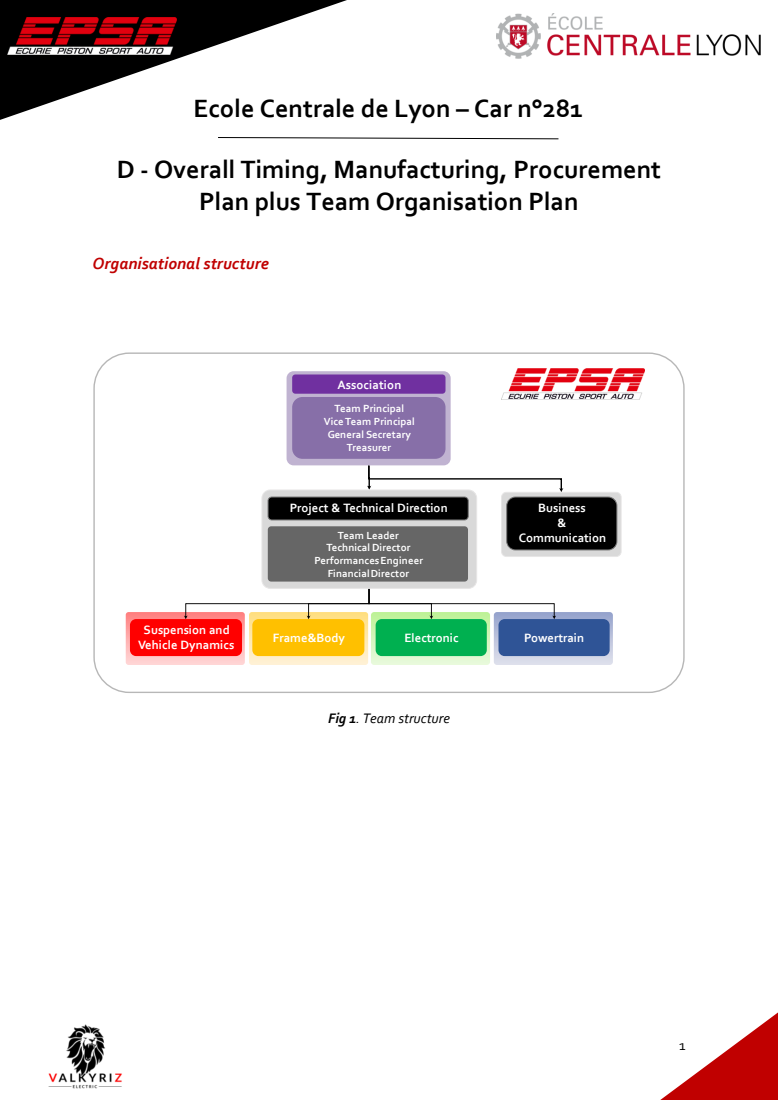
[picture p91: page 1]
Organisational structure

Ecole Centrale de Lyon – Car n°281

D - Overall Timing, Manufacturing, Procurement

Plan plus Team Organisation Plan

Fig 1. Team structure

Timeline

Timeline of next year

Focus: Timeline of the powertrain testbench
