EOSCogniton/ELIZ-2021/DR_Design_Report/04_DSS/281_Ecurie Piston Sport Auto_Spec Sheet.xlsx

Sheet: FS_Specs_EV
EV Design Spec Sheet |  |  |  |  |  |  | 2021
Competitors: Please read the Instructions-Tips (tab below) prior to the completion and submission of this sheet.
Car No. |  | 281
School |  | Ecole Centrale de Lyon
Dimensions | Units
Overall Dimensions | mm | Length: | 2757 | Width: | 1460 | Height: | 1272
Wheelbase & Track | mm | Wheelbase: | 1605 | Front Track: | 1254 | Rear Track: | 1200
Center of Gravity Design Height | mm | CG Height: | 290 | Confirmed Via: | N/A
Mass without driver | kg | Front: | 101.2 | Rear: | 128.8 | Total: | 230
Weight Distribution with 68kg driver |  | % Front: | 0.44 | % Left: | 0.56
Suspension Parameters | Units | Front |  |  | Rear
Tire Size, Compound and Make |  | 205/470 R13 FORMULA STUDENT C19 |  |  | 205/470 R13 FORMULA STUDENT C19
Wheels (width, construction) |  | 7 in 7 in |  |  | 7 in
Suspension Type |  | Double wishbone, rocker arm damper, pull-rod |  |  | Double wishbone, rocker arm damper, push-rod
Suspension design travel | mm | Jounce (col D): Rebound (col E): | 25 | 25 | Jounce (col G): Rebound (col H): | 25 | 25
Wheel rate (chassis to wheel center) | N/mm | 12.6 |  |  | 15.8
Roll rate (chassis to wheel center) | NM/deg | 529 |  |  | 177
Sprung mass natural frequency | Hz | 1.9187 |  |  | 1.8733
Jounce Damping | % critical | N/A | at __ mm/sec: | N/A | N/A | at __ mm/sec: | N/A
Rebound Damping | % critical | N/A | at __ mm/sec: | N/A | N/A | at __ mm/sec: | N/A
Motion ratio | _.__:1 | 1,14:1 | Type: | progressive | 1,14:1 | Type: | progressive
Ride Camber (Rate of Camber Change) | deg/m | 13.5 |  |  | 46
Roll Camber | deg/deg | 0.85 |  |  | 0.51
Static Toe (- out, + in) | deg | 0 |  |  | 0
Static camber | deg | -1,03 |  |  | -1.11
Static camber adjustment method |  | Camber shim between upright and upper wishbone |  |  | Camber shim between upright and upper wishbone
Anti dive / Anti Squat | % | 0 |  |  | 0
Roll center height above ground, static | mm | 66,7 |  |  | 95,8
Roll center position at 1g lateral acc | mm | Height (col D): Lateral (col E): | 66,5 | 35,4 | Height (col G): Lateral (col H): | 95,9 | 5,6
Front Caster, Trail, and Scrub Radius |  | Caster (deg): | 0,75/0 | Kin Trail (mm): | N/A | Scrub Rad (mm) | N/A
Front Kingpin Axis |  | Inclination (deg): | 6,38/6,78 | Offset (mm): | 20,5/29,4
Static Ackermann | % | 3,3 | Adjustable? | No
Suspension Adjustment Methods |  | Suspension rod lenght adjustable with screws
Steer Ratio, C-Factor, Steer Arm Length |  | Steer Ratio (x:1) | 4.05:1 | c-factor (mm) | 88,9 | Steer Arm Length | 58,2
Brake System / Hub & Axle | Units | Front |  |  | Rear
Rotors |  | Fixed brake bell, d=164mm / t=5mm, aluminium, coating NA |  |  | Fixed brake bell, d=132,9/t=5mm, aluminium, coating NA
Master Cylinder |  | Beringer brakes, MC 127, proportioning with rear by a balancer bar |  |  | Beringer brakes, MC 127, D piston: 12.7 mm. Piston stroke : 20 mm.
Calipers |  | Beringer brakes, ber-2p1a/g, d piston: 32mm |  |  | Beringer brakes, 10BRG2D1, d piston: 27mm
Brake Pad/Lining Material |  | Beringer Brakes KIT1158S |  |  | Beringer Brakes KIT2547S
Force and Pressures @ 1g Deceleration |  | Front Pres. (bar): | 3.38 | Rear Pres. (bar): | 2.27 | Pedal Force (kN) | 0.13
Upright Assembly |  | Alu upright, link between Hub, double wishbone, toe rod and brake system |  |  | Alu upright, link between Hub, double wishbone, toe rod and brake system
Hub Bearings |  | Dowels, brake bell, spacer, bearing, speed dic, bearing, lock washer, lock nut |  |  | Dowels, brake bell, spacer, bearing, speed dic, bearing, spacer, tripod
Axle type, size, and material |  | NA |  |  | Tripod, drive shaft
Ergonomics | Units
Driver Size Adjustments |  | Fixed seat and adjustable pedals (in depth)
Seat (materials, padding/damping) |  | Karting seat, carbon and kevlar
Steering Wheel (dia, construction) |  | Diamter (mm) | 270 | Construction | Formula Style steering wheel
Shift Actuator (type, location) |  | None
Clutch Actuator (type, location) |  | None
Instrumentation |  | Speed, water temp, low and high voltage batteries voltage, high voltage battery power, AMS & IMD indicator
Optional: (e.g., Driver Safety Systems, etc.?) |  | N/A
Electrical (non-drive systems) | Units
Power Management / Control |  | All electrical components fuse protected & power devices relay-activated. 3 way switch on the dashboard.
Wiring / Loom / ECM mounting |  | Signal cables : 22-24 AWG. Low power cables : 12-18 AWG. Waterproof harnessing tapes + spiral wrap.
Battery / Charging System |  | Super B LiFePO4 5 Ah, charged after every race by the battery provider dedicated charger.
Grounding |  | Separated grounds for TS Accumulator & LV battery. LV Ground loop for fan, pump and dashboard.
Driver Assist Systems |  | Launch control, traction control.
Logging / Telemetry |  | AutosportLab MK3 logging system. 8 analog channel + bus CAN.
Special Sensing Technology |  | N/A
Frame | Units
Frame Construction |  | Steel spaceframe
Material |  | 25CrMo4 Steel
Joining method and material |  | Steel welding
Bare frame mass with brackets & paint | kg | Target: | 40 | Physical Test: | N/A
Torsional stiffness | N-m/deg | Target: | 4400 | Simulated: | N/A | Physical Test: | N/A
Torsional stiffness validation method |  | N/A
Impact Attenuator configuration |  | Glued to the anti-intrusion plate
Impact Attenuator dimensions | mm | Width: | 356 | Height: | 305 | Depth: | 254
Impact Attenuator energy capacity | kJ | Energy: | N/A | Method: | N/A
Tractive Drive Power System | Units | Front |  |  | Rear
Motor Manufacturer / Model / Type |  | N/A |  |  | Emrax 228 Medium Voltage and liquid cooling
Motor Technology utilized |  | N/A |  |  | Permanent Magnet Synchronous Motor
Motor Count and Location(s) |  | N/A |  |  | 1 motor at the rear of the car
Driven Wheel Count & Location(s) |  | N/A |  |  | 2 driven wheels at the rear
Nominal Motor Voltage (phase and volts) | P, V | Phase (col D): Voltage (col E): | N/A | N/A | Phase (col G): Voltage (col H): | N/A | 331
Maximum Design Motor RPM (1/min) | rpm | N/A |  |  | 5500
Base Speed (max torque until xx RPM) | rpm | N/A |  |  | 4400
Maximum Motor Torque (peak) | Nm for Xsec | N/A |  |  | 230 for a few seconds
Maximum Motor Torque (continuous) | Nm | N/A |  |  | 102
Maximum Motor Power (peak) | kW at RPM | N/A |  |  | 109 at 5500 RPM
Maximum Motor Power (continuous) | kW @ RPM | N/A |  |  | 53 at 5500 RPM
Motor Speed Sensor(s)? If so, what type |  | N/A |  |  | One pole pair resolver
Significant Motor Modifications |  | N/A |  |  | No
Motor Controller(s) Type / Model |  | N/A |  |  | BAMOCAR-PG-D3-700/400-400
Motor Controller Discharge Power (peak) | kW for x sec | N/A |  |  | 180 but we don't have the time yet
Controller Continuous Discharge Power | kW | N/A |  |  | 90
Accumulator Cell Manufacturer / Type |  | N/A |  |  | Hong Kong Mingda Electric Power
Accumulator Cell Voltage / Capacity | Volts, mAh | N/A |  |  | 3,7 / 8300
Accumulator Voltage (fully charged) | V | N/A |  |  | 504
Accumulator Cell Technology/Chemistry |  | N/A |  |  | Lithium Polymer
Accumulator Cell Configuration |  | N/A |  |  | 120S2P
Accumulator Discharge Power (peak) | kW for x sec | N/A |  |  | 100,8 but we don't have them time yet
Accumulator Discharge Pwr (continuous) | kW | N/A |  |  | 55.5
Accumulator Full Charge Time | hrs:min | N/A |  |  | N/A
Accumulator Charging Efficiency | % | N/A |  |  | 94.2
Accumulator Charging Power | kW | N/A |  |  | 44258
Torque Control Modes (vectoring, etc.) |  | N/A |  |  | N/A
Other Special Components |  | N/A |  |  | N/A
Drivetrain | Units
Drive Type |  | Chain : CBR.900.RR '92/95 16X42 RK530GXW # (SC29,SC28). No gear box
Differential Type (if used) |  | Adjustable limited slip differential
Final Drive Reduction Ratio | _:1 | 3,23:1
Vehicle Speed @ max power (design) rpm | kph | 1st gear: | 151 | 2nd gear: | N/A | 3rd gear: | N/A
Vehicle Speed @ max power (design) rpm | kph | 4th gear: | N/A | 5th gear: | N/A | 6th gear: | N/A
Half shaft size and material |  | High alloy 4130 steel, 403,8mm(left), 365mm(right)
Axle Joint type |  | Tripod, RCV, D4672-TA, alloy 4340 steel
Aerodynamics (if applicable) | Units
Type / Configuration |  | N/A
Forces (at 80 kph, ρ= 1.162 kg/m^3) |  | Downforce (N): | N/A | % Front: | N/A | Drag (N): | N/A
Coefficients & Reference Area |  | Cl: | N/A | Ref. Area (m^2): | N/A | Cd: | N/A
Noteable Features (active, etc) |  | N/A
Other Information | Units
Body Work (material, process) |  | Fiberglass, molded nose and flexible plates attached to the tubes
Team Profile (max 1200 characters, written in third person please, for inclusion in event programme) |  | E.g. Team EV from the University of Wattage will be aiming for a top 10 finish at this year's Formula Student competition for their most successful campaign to date. Established in 2010, the team last enjoyed success in the 2019 competition with their highest placed finish of 11th overall and third best scoring EV team. Since 2019, focus has been on improved aerodynamics and power to weight ratio. As well as a top 10 finish, the team will target finishing Endurance with an improved efficiency score. Team Leader, Flo Voltage, and the team would like to thank their sponsors xxxx, ssss and rrrrr as well as Faculty Advisor Dr. E. Lectric and the University of Wattage for their continued support of the Formula Student programme.
Optional Information

Sheet: Programme Info
Car Number | Length/Width/Height/Wheelbase (all mm) | Track (front/rear mm) | Weight (kg) | Weight distribution (front/rear kg) | Suspension | Tyres | Wheels | Brakes | Chassis | Electric Motor | Accumulator | Max power/max torque | Transmission | Differential | Final drive | Team profile
281 | 2757/1460/1272/1605 | 1254/1200 | 230 | 101,2/128,8 | Double wishbone, rocker arm damper, pull-rod front/Double wishbone, rocker arm damper, push-rod rear | 205/470 R13 FORMULA STUDENT C19 front/205/470 R13 FORMULA STUDENT C19 rear | 7 in 7 in front/7 in rear | Beringer brakes, MC 127, proportioning with rear by a balancer bar front/Beringer brakes, MC 127, D piston: 12.7 mm. Piston stroke : 20 mm. rear | Steel spaceframe | N/A front/N/A rear | N/A front/Hong Kong Mingda Electric Power rear | N/A front,109 at 5500 RPM rear/N/A front,230 for a few seconds rear | Chain : CBR.900.RR '92/95 16X42 RK530GXW # (SC29,SC28). No gear box | Adjustable limited slip differential | 3,23:1 | E.g. Team EV from the University of Wattage will be aiming for a top 10 finish at this year's Formula Student competition for their most successful campaign to date. Established in 2010, the team last enjoyed success in the 2019 competition with their highest placed finish of 11th overall and third best scoring EV team. Since 2019, focus has been on improved aerodynamics and power to weight ratio. As well as a top 10 finish, the team will target finishing Endurance with an improved efficiency score. Team Leader, Flo Voltage, and the team would like to thank their sponsors xxxx, ssss and rrrrr as well as Faculty Advisor Dr. E. Lectric and the University of Wattage for their continued support of the Formula Student programme.
 |  |  |  |  |  | ,

Sheet: Instructions-Tips
Instructions / Tips for Design Specification Sheet
Formatting: Please do not modify the formating of the spec sheet. It has been laid out to print on a single sheet of 8.5 x 11 paper (double sided). While we acknowledge that there is little space in the cells, we ask that you be brief and include longer descriptive information within the Design Report.
Completeness: Please complete the spec sheet in its entirety. The judges expect that there will be a value or description entered for each and every line item contained within. If by chance, the particular item does not apply to your vehicle / design, please enter "N/A" in the space provided. N/A in this case meaning: Not Applicable.
Range of Values: In cases where you have yet to determine a specific value for a parameter, please input the range that you anticipate the values to fall within. Please make the noted range as tight (ie. narrow bandwidth) as you feel comfortable.
Units: For the majority of the specifications requiring a numerical input, an example of the desired unit of measure has been provided. Please be consistent with the units as specified on this sheet.
Comments / Clue Tabs: For many line items, there is additional descriptive information provided if you hover your cursor over the specification cell. Please use this information to guide your entry.
Understanding: The sample values in the template are fictional and should not be used as the baseline for your designs. Note that the specifications identified within the spec sheet contain the type of information the judges will expect you to know, understand, and be capable of discussing during the Design Event. Key factors during the discussion shall be the engineering rationale behind each decision and resulting specification.
Consistency: All values contained within this spec sheet are expected to align with your Design report and your vehicle at competition. It should be expected that inconsistencies will be discussed during the Design event. Without adequate reasoning for the discrepancies, a negative impact on your design score may result.
Timeliness: Please submit the Spec Sheet and Design Report ON TIME. Late submission penalties can be significant and there is little excuse for points lost due to late submissions.
Data Entry Issues: If you are having issues with Excel not taking a value (especially if a negative sign is used) please try beginning the entry with a " ' " as the first character.
File naming: Please name your file as follows Car No_Team Name_Spec Sheet e.g. 001_Racing Eagles_Spec Sheet Also, the file shall be uploaded as a spreadsheet, not a PDF.
