EOSCogniton/ELIZ-2021/Insertion_visserie/Read me.txt

Merci de ne pas modifier les noms des dossiers.

Pour connaître le fonctionnement de la macro, vous pouvez lire la documentation, notamment le rapport de PLM, ou demander à RCT pour cette saison 2021.
