EOSCogniton/ELIZ-2021/SU_Suspension/06_Rotules/Askubal G-8D/Read Me.txt

A retrouver sous le nom SU_01005 sur la maquette.

Il faut mettre la documentation
