EOSCogniton/ELIZ-2021/EL_Electrical/EL_A0400 (TS Box)/Info.txt

Il faut changer le boitier pour un boitier alu :

trouver les bons Insulator pour les jeux de barres.
