EOSCogniton/ELIZ-2021/EL_Electrical/CATIA/EL_A0400 (TS Box)/EL_A04003 (Relais)/Relais Info.txt

Littelfuse les relais pour voiture 

DCNLEV50-BAS

TE : ils marchent.

IHVA150 Series
