EOSCogniton/ELIZ-2021/Organisation Git.docx

Dépôts GIT – Saison 2021

# ELIZ-2021

Ce dépôt ne doit servir QUE POUR LE CATIA DE VALKYRIZ. Les modèles, documentation, maquettes primitives et autre n’ont rien à faire là.

Règles d’utilisation :

- Un assemblage, c’est :
  - Un dossier dans le système associé, qui porte le nom donné dans la nomenclature, et qui contient :
  - L’assemblage Catia (du même nom)
  - Toutes les pièces, nommées d’après la nomenclature.

# BENCH01-EPSA

Ce dépôt ne doit servir QUE POUR LA MAQUETTE DETAILLEE DE BENCH01, c’est à dire le CATIA, le soft et autres codes.

Règles d’utilisation :

- Pour la gestion du CATIA, les règles sont identiques à ELIZ-2021.
- L’ensemble des ressources non reliées à CATIA sont regroupées dans un dossier EL-ELECTRICAL.

# Modèles-EPSA

Contient tous les modèles utilisés à l’écurie (dynamique véhicule, refroidissement, freinage …) . Ce dépôt se transmet de saison en saison.

Règles d’utilisation :

- Chaque dossier principal est nommé « XX_description », avec XX un acronyme en 2 lettres.
