EOSCogniton/ELIZ-2021/DR_Design_Report/01_MEP_Globales/Vue_face_Top_traitfin.png

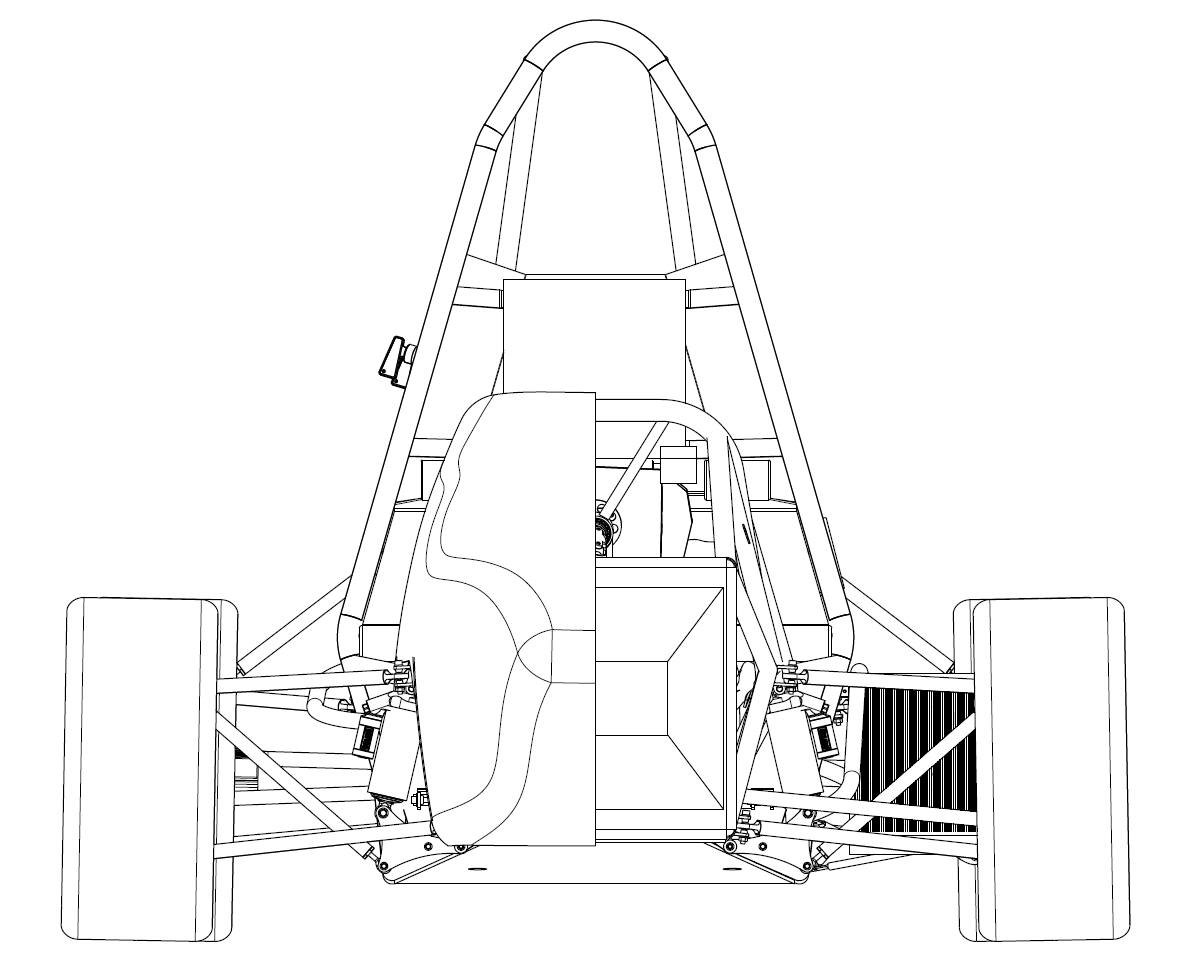
DR_Design_Report/01_MEP_Globales/Vue_face_Top_traitfin.png
