EOSCogniton/ELIZ-2021/DR_Design_Report/01_MEP_Globales/Vue_ISO.png

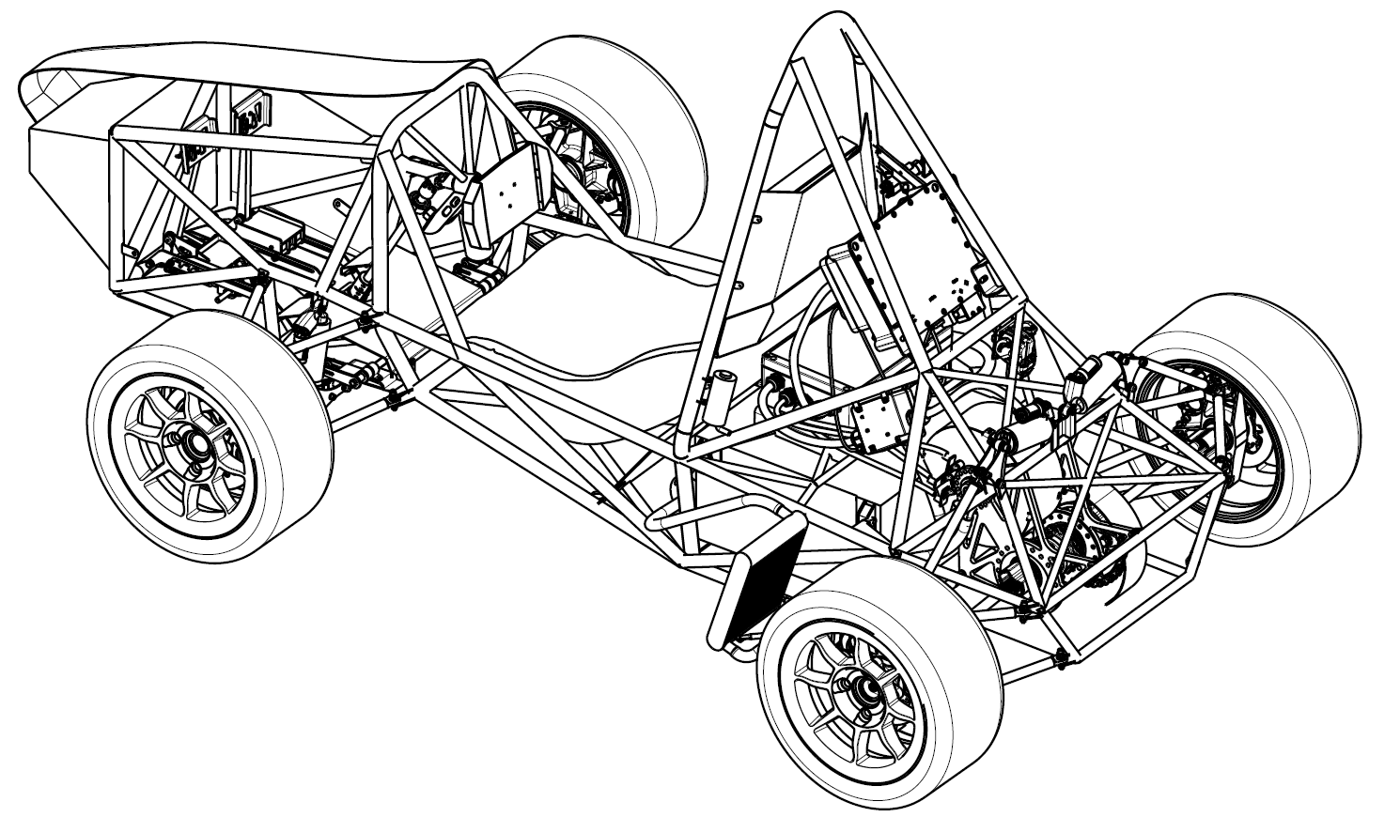
DR_Design_Report/01_MEP_Globales/Vue_ISO.png
