EOSCogniton/ELIZ-2021/DR_Design_Report/05_Design_Report/coupe_roue_equipee.png

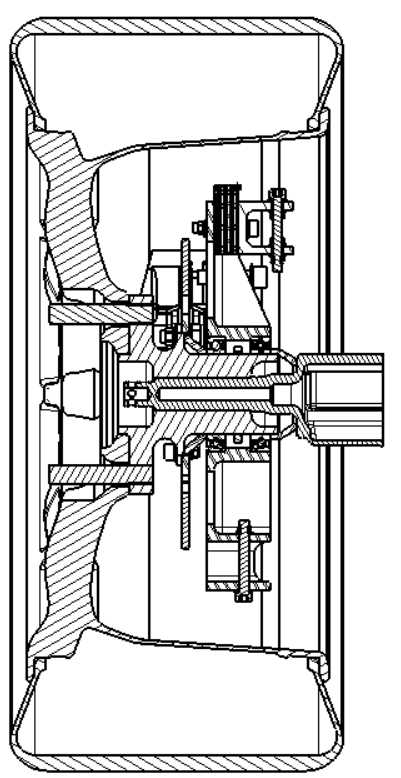
DR_Design_Report/05_Design_Report/coupe_roue_equipee.png
