EOSCogniton/ELIZ-2021/EL_Electrical/CATIA/EL_A0200 (Wire Harness-Connectors)/01FEA/figure/chappe3/chappe3_x_06.png

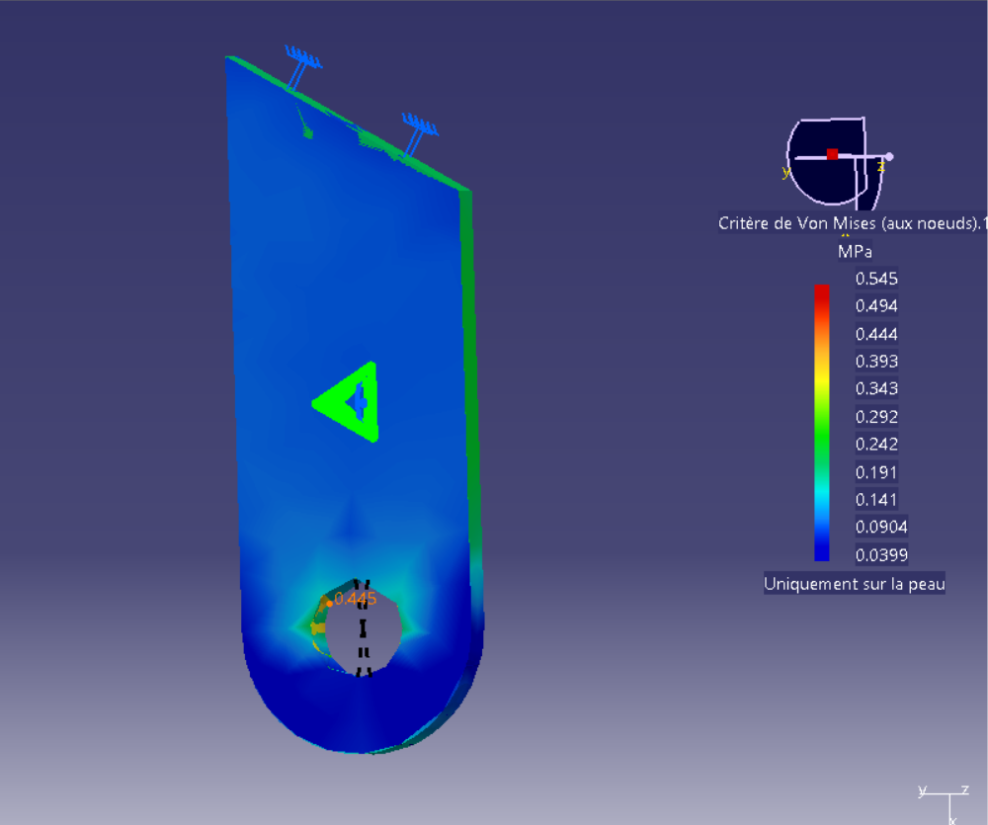
EL_Electrical/CATIA/EL_A0200 (Wire Harness-Connectors)/01FEA/figure/chappe3/chappe3_x_06.png
