EOSCogniton/ELIZ-2021/EL_Electrical/EL_A0400 (TS Box)/TS Box visual Top Down lighted.jpg

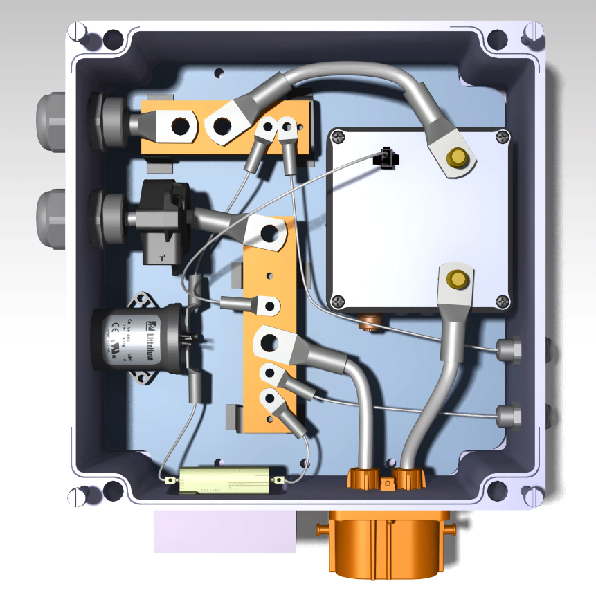
EL_Electrical/EL_A0400 (TS Box)/TS Box visual Top Down lighted.jpg
