EOSCogniton/ELIZ-2021/EN_Engine_Drivetrain/EN_A0200 (Cooling System)/EN_02003_Picture.jpg

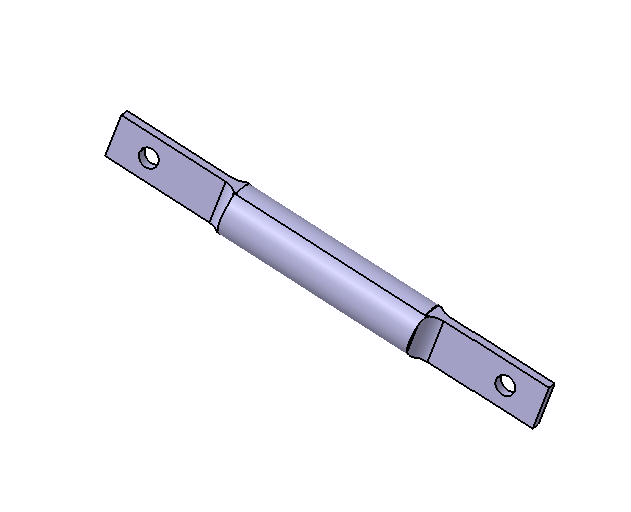
EN_Engine_Drivetrain/EN_A0200 (Cooling System)/EN_02003_Picture.jpg
