EOSCogniton/ELIZ-2021/FR_Frame_Body/modèles CATIA pour 0A/FR_A0300 (Pedal Assy) (Invictus)/Ressources PROM Jodie/accel1.PNG

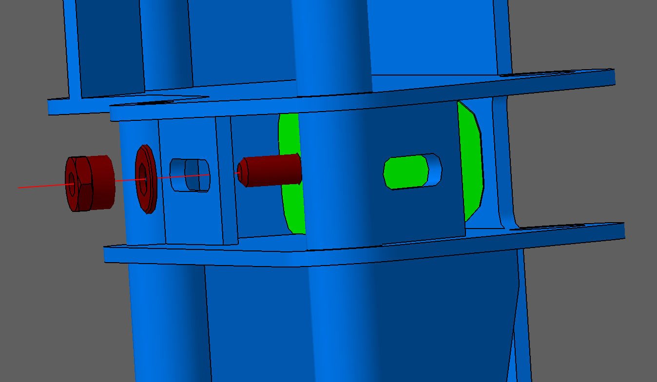
FR_Frame_Body/modèles CATIA pour 0A/FR_A0300 (Pedal Assy) (Invictus)/Ressources PROM Jodie/accel1.PNG
