EOSCogniton/ELIZ-2021/RC_Rendus_Compet/CCPU/15 x 1,5.png

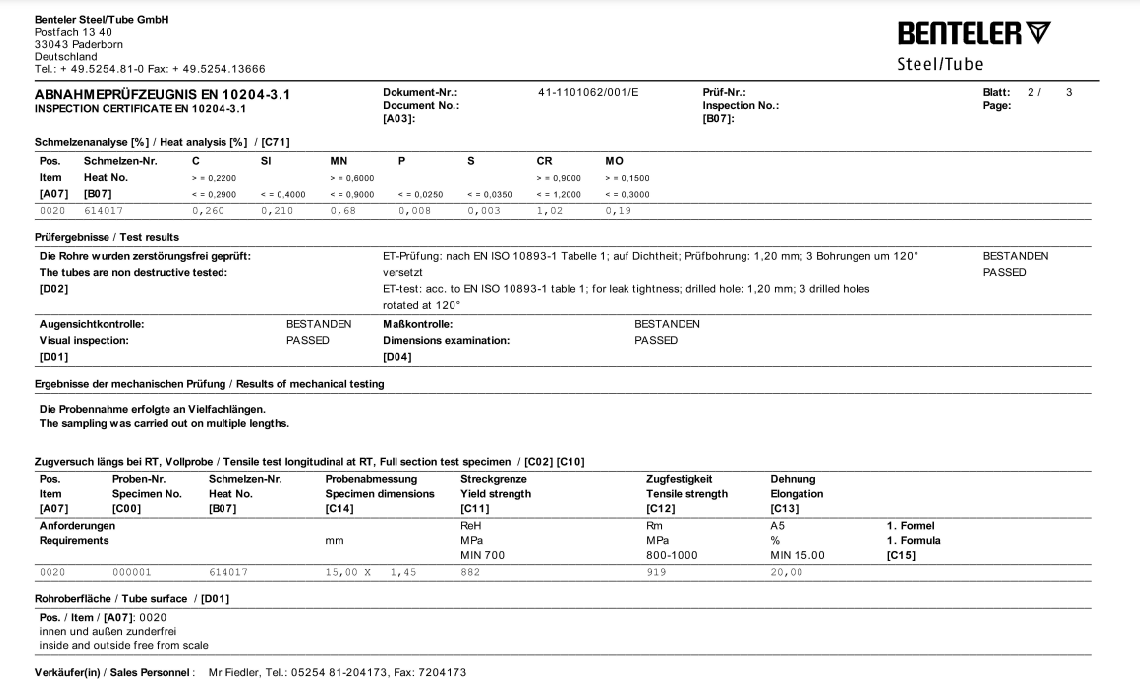
RC_Rendus_Compet/CCPU/15 x 1,5.png
