EOSCogniton/ELIZ-2021/RC_Rendus_Compet/images/comparaison frame Invictus Valkyriz.png

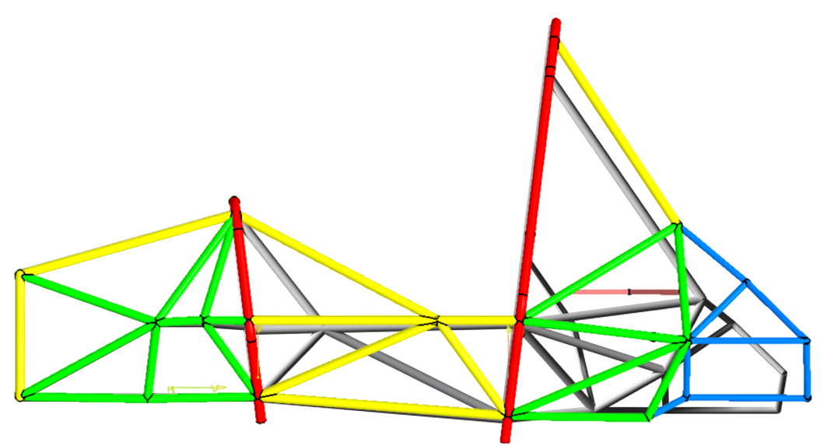
RC_Rendus_Compet/images/comparaison frame Invictus Valkyriz.png
