EOSCogniton/ELIZ-2021/RC_Rendus_Compet/images/cotes ses.jpg

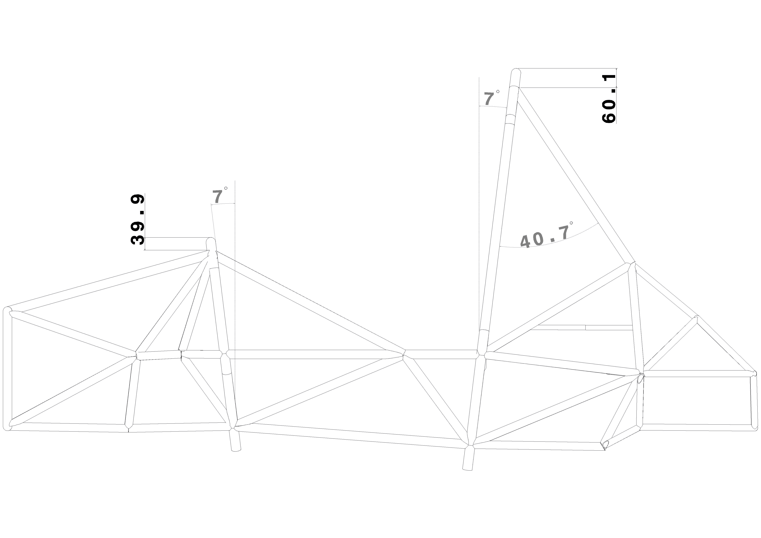
RC_Rendus_Compet/images/cotes ses.jpg
