EOSCogniton/ELIZ-2021/RC_Rendus_Compet/images/cotes ses.png

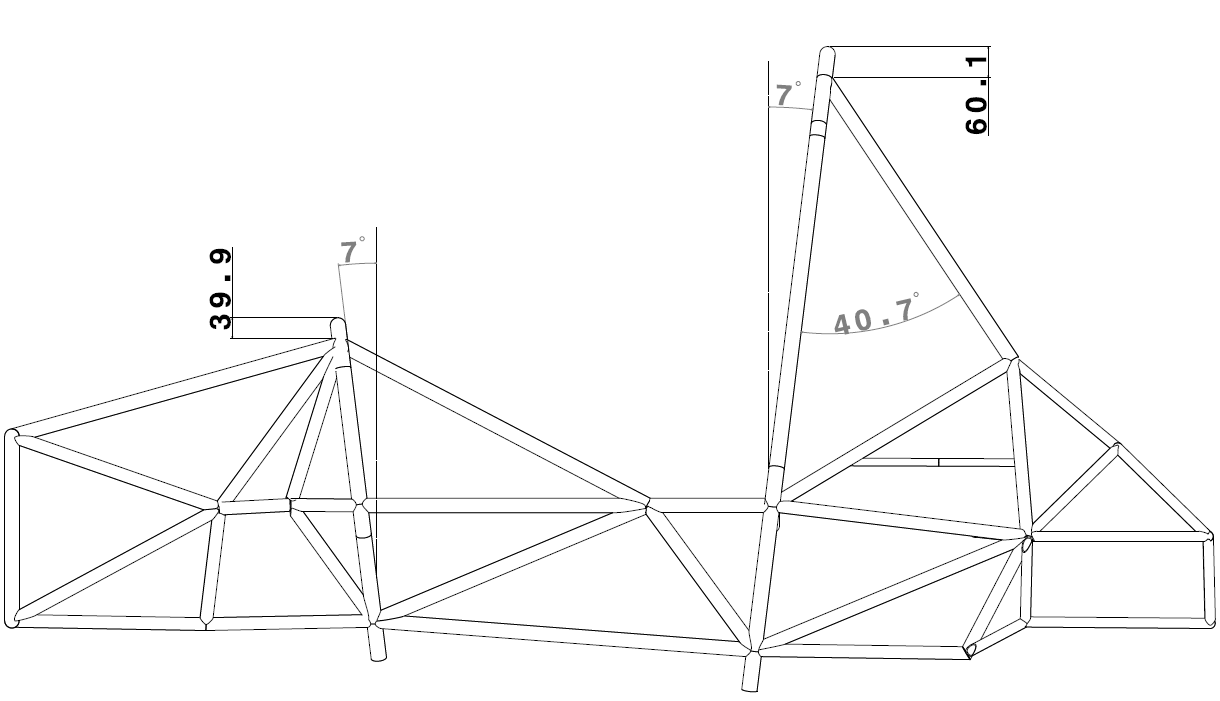
RC_Rendus_Compet/images/cotes ses.png
