EOSCogniton/ELIZ-2021/RC_Rendus_Compet/images/datasheet_nomex_page-0003.jpg

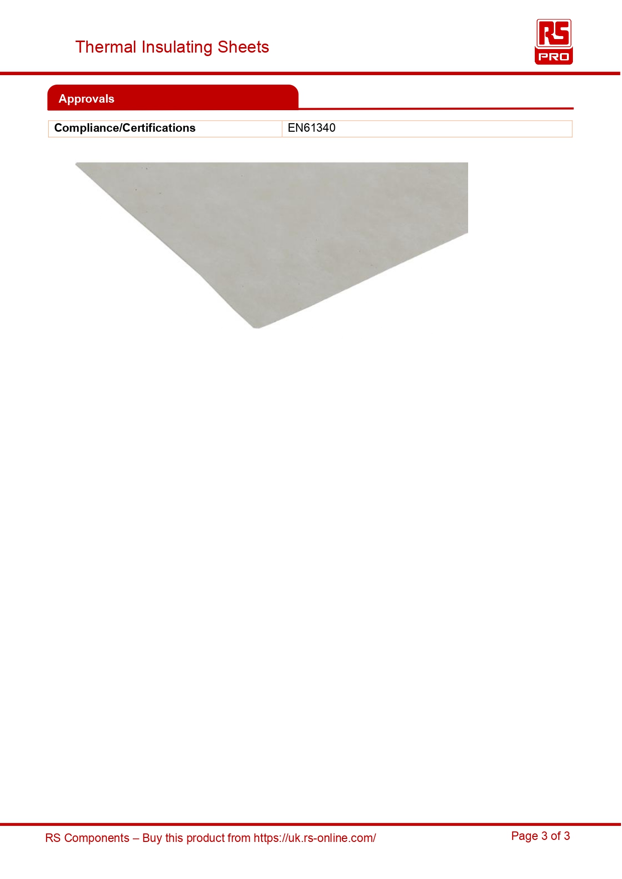
RC_Rendus_Compet/images/datasheet_nomex_page-0003.jpg
