EOSCogniton/ELIZ-2021/RC_Rendus_Compet/images/IA.png

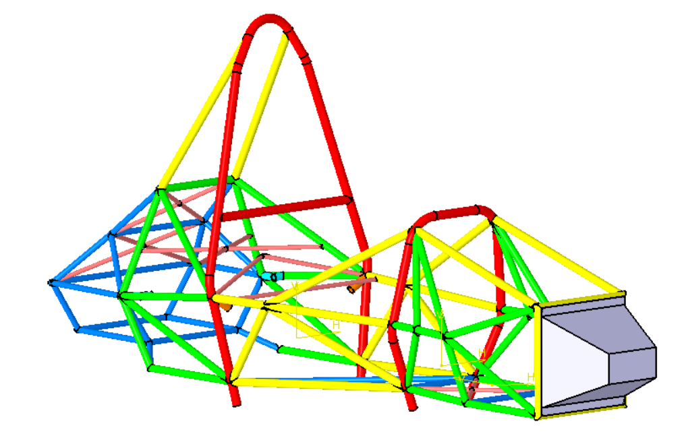
RC_Rendus_Compet/images/IA.png
