EOSCogniton/ELIZ-2021/RC_Rendus_Compet/images/lubricating system.png

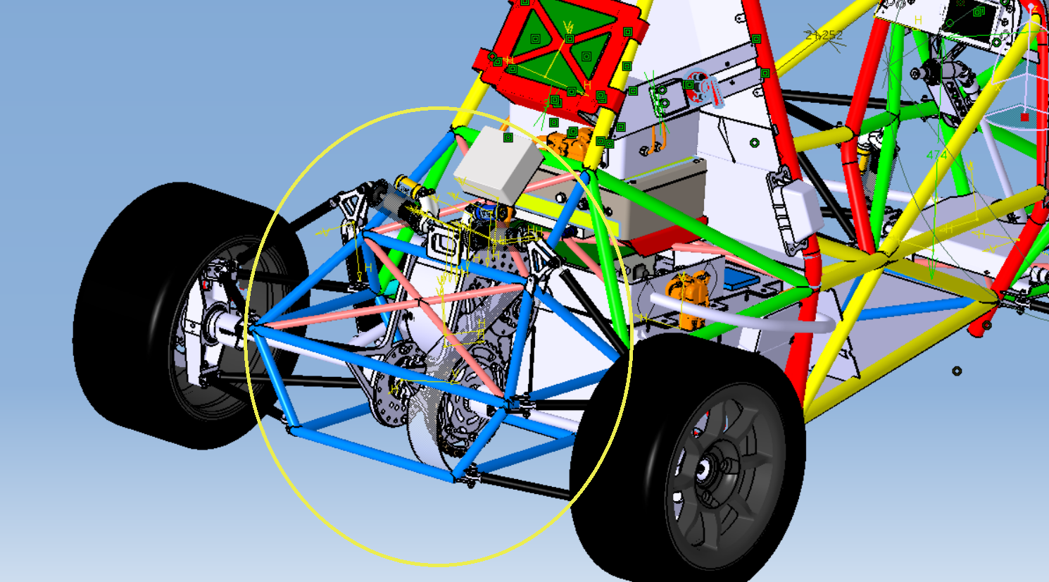
RC_Rendus_Compet/images/lubricating system.png
