EOSCogniton/ELIZ-2021/RC_Rendus_Compet/images/légende tube.png

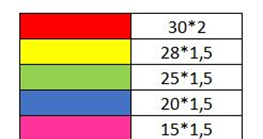
RC_Rendus_Compet/images/légende tube.png
