EOSCogniton/ELIZ-2021/RC_Rendus_Compet/images/RDM (sangles).png

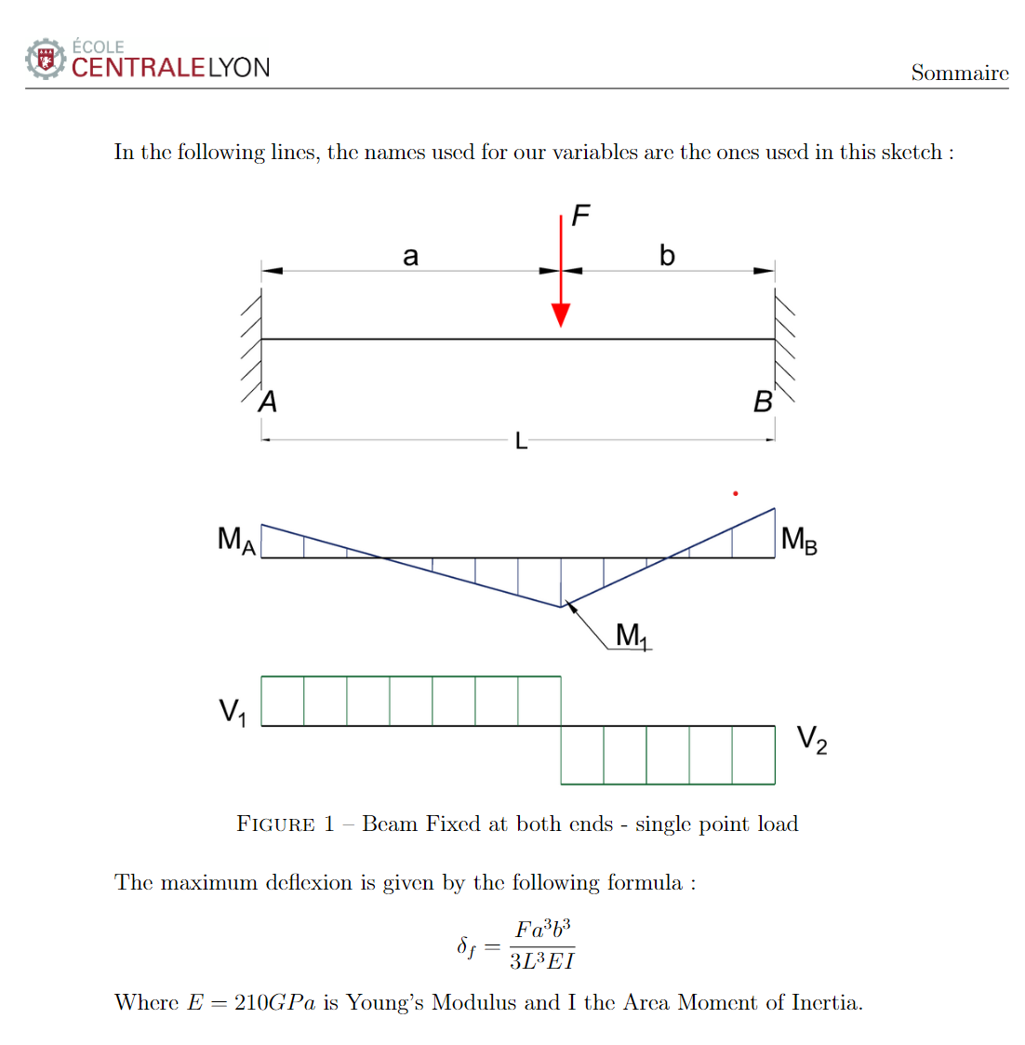
RC_Rendus_Compet/images/RDM (sangles).png
