EOSCogniton/ELIZ-2021/RC_Rendus_Compet/images/RDM SHB.png

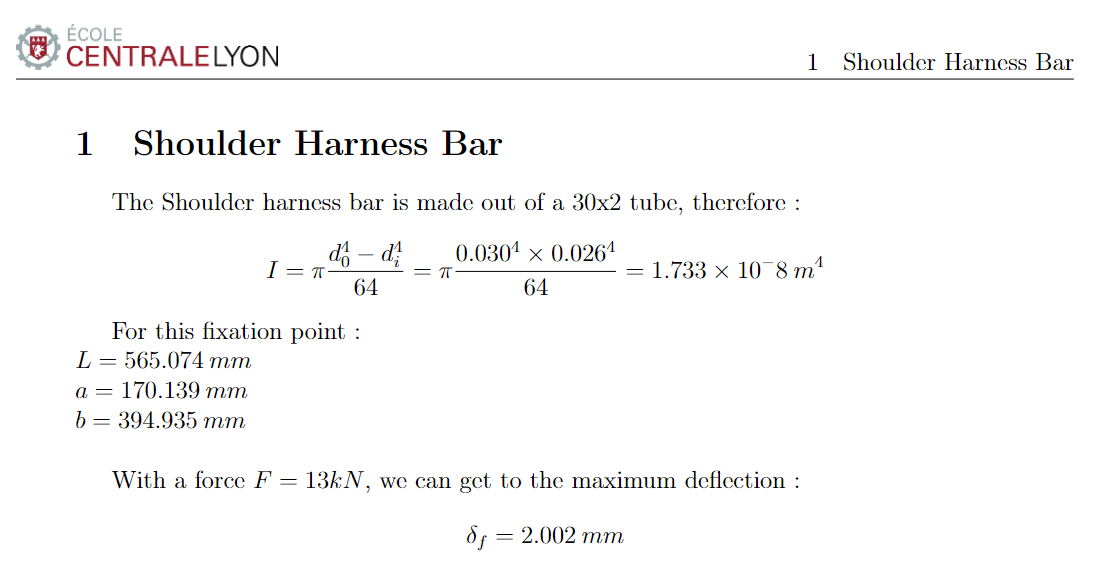
RC_Rendus_Compet/images/RDM SHB.png
