EOSCogniton/ELIZ-2021/RC_Rendus_Compet/images/RDM SIS.png

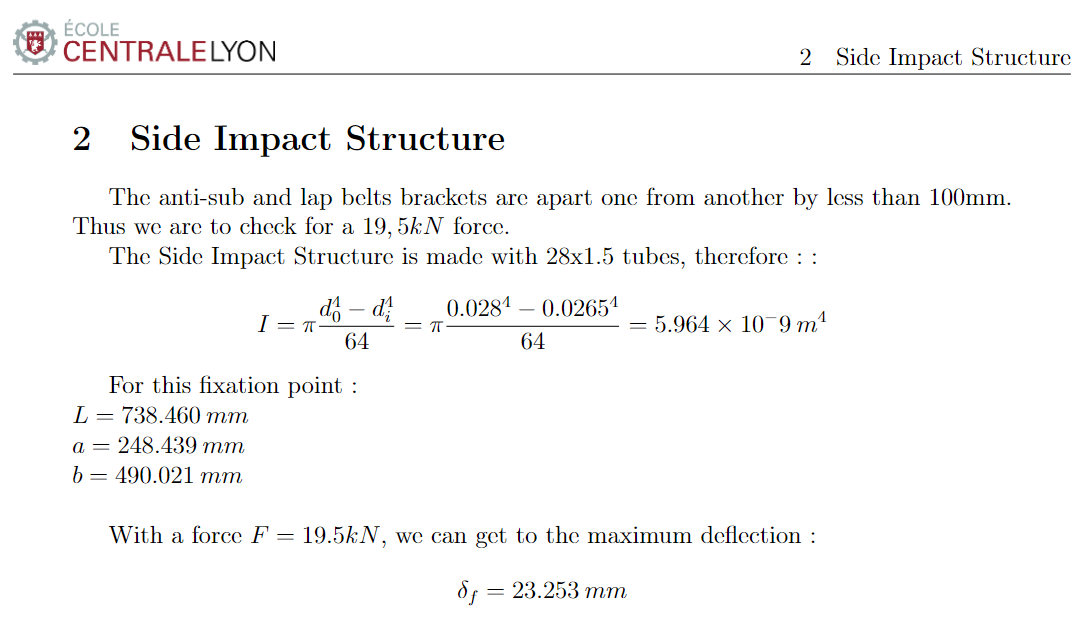
RC_Rendus_Compet/images/RDM SIS.png
