EOSCogniton/ELIZ-2021/RC_Rendus_Compet/images/soudure HV container.jpg

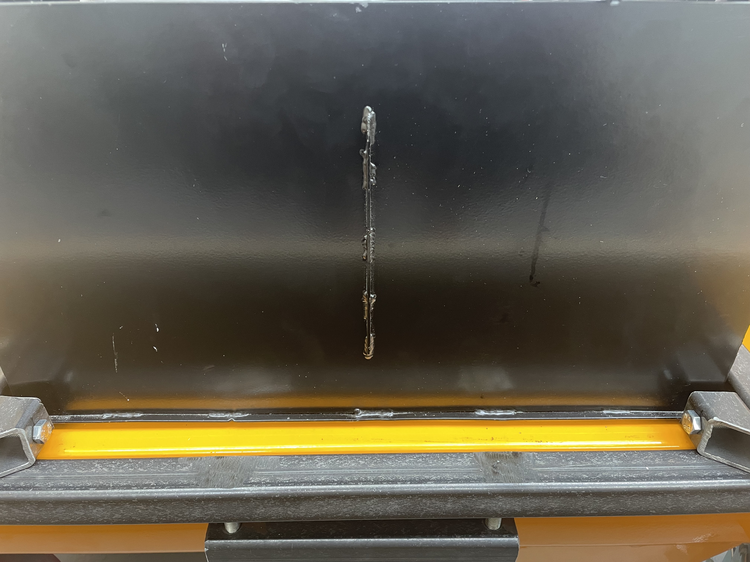
RC_Rendus_Compet/images/soudure HV container.jpg
