EOSCogniton/ELIZ-2021/RC_Rendus_Compet/images/TSAC/20 G vertical.png

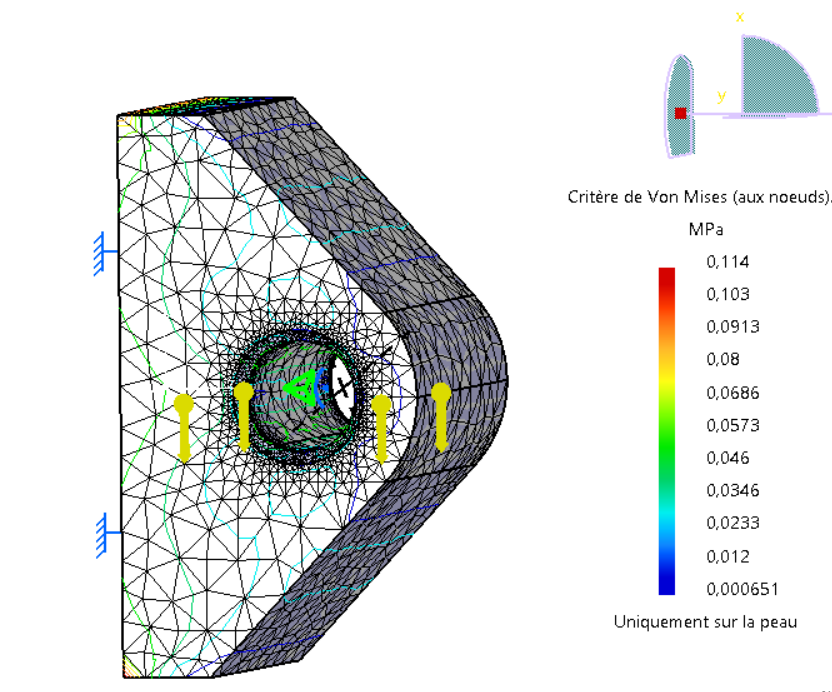
RC_Rendus_Compet/images/TSAC/20 G vertical.png
