EOSCogniton/ELIZ-2021/RC_Rendus_Compet/images/TSAC/40G lateral.png

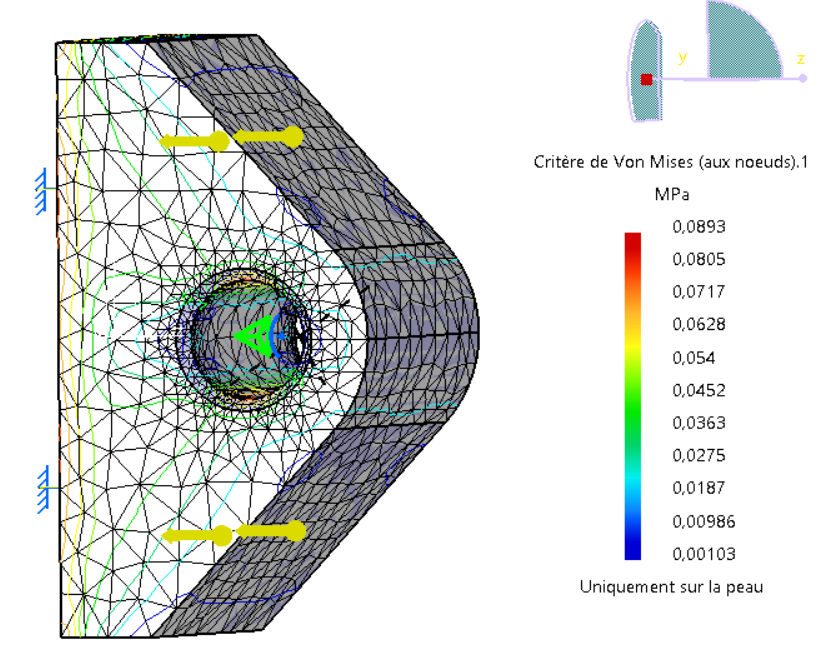
RC_Rendus_Compet/images/TSAC/40G lateral.png
