EOSCogniton/ELIZ-2021/RC_Rendus_Compet/images/TSAC/40G x.png

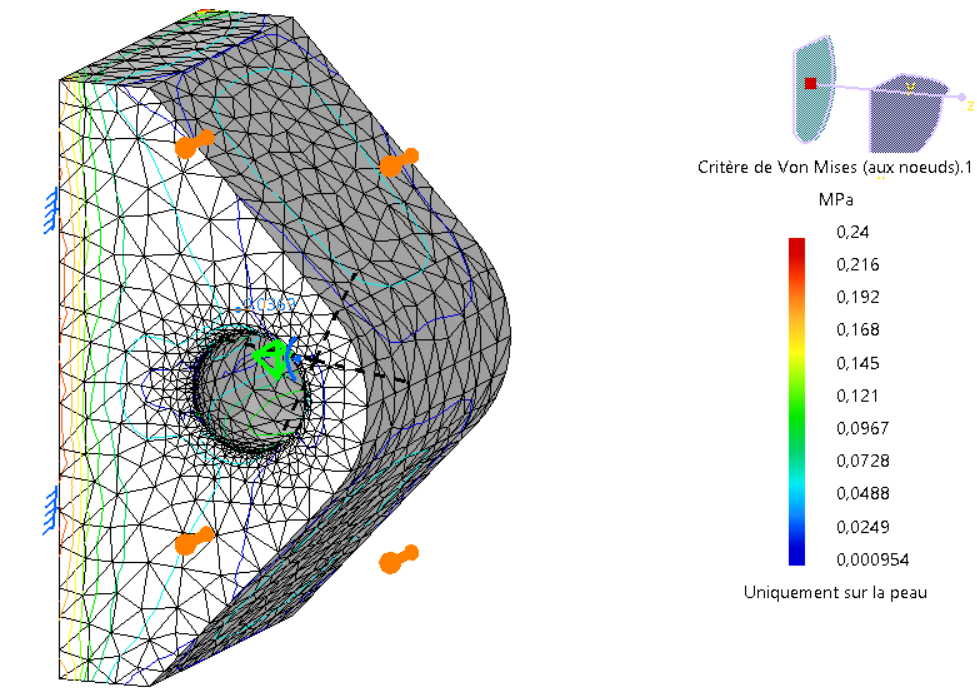
RC_Rendus_Compet/images/TSAC/40G x.png
