EOSCogniton/ELIZ-2021/RC_Rendus_Compet/images/TSAC/Appairage batterie.png

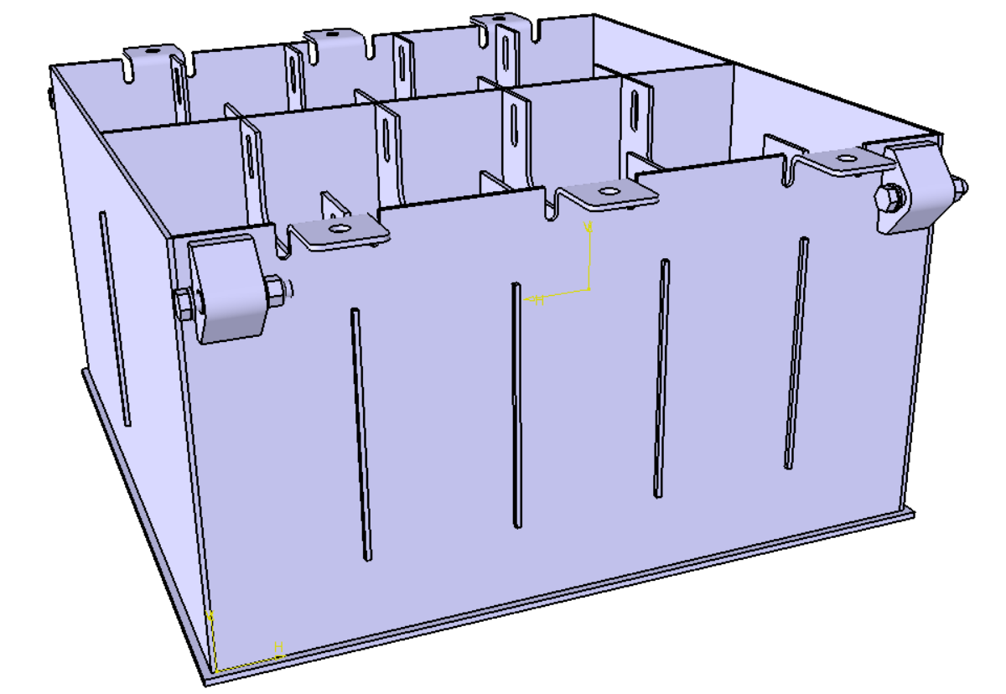
RC_Rendus_Compet/images/TSAC/Appairage batterie.png
