EOSCogniton/ELIZ-2021/RC_Rendus_Compet/images/TSAC/Container mounting point.png

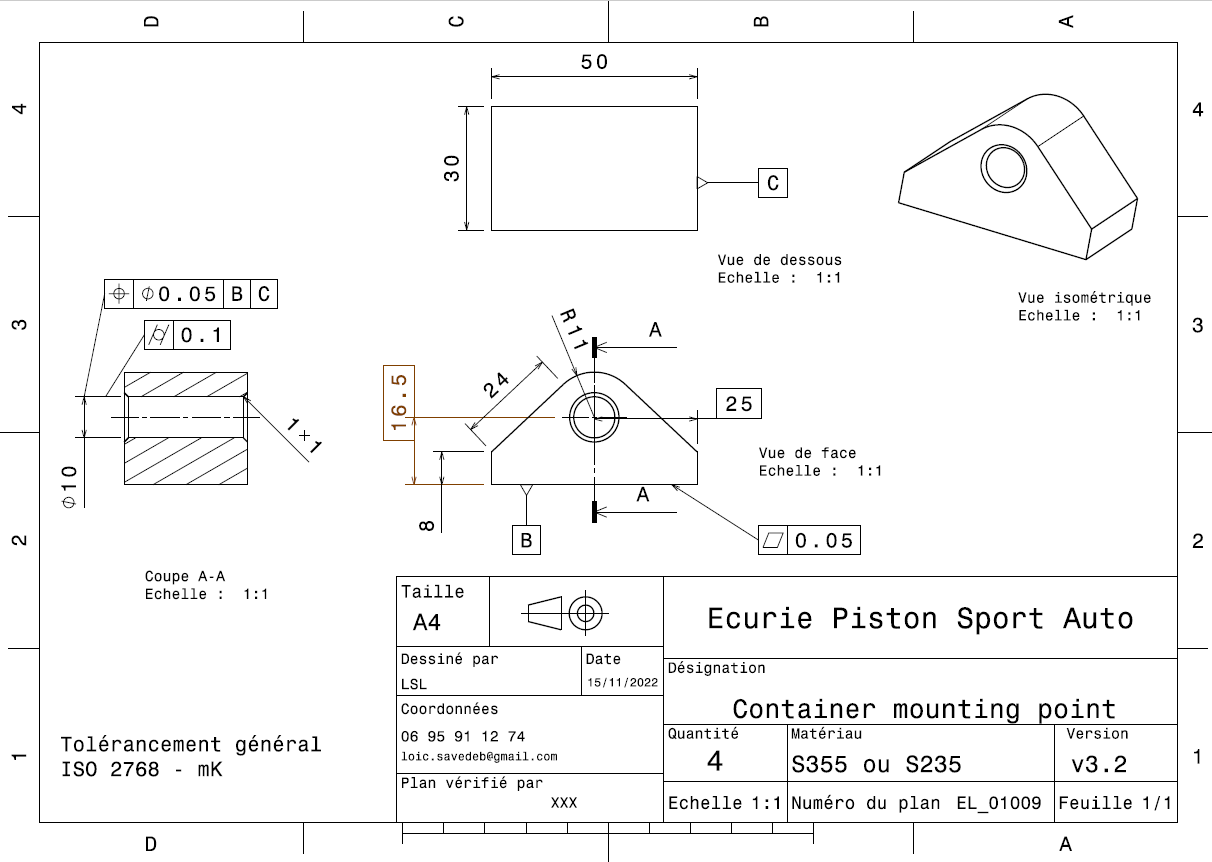
RC_Rendus_Compet/images/TSAC/Container mounting point.png
