EOSCogniton/ELIZ-2021/RC_Rendus_Compet/images/TSAC/dimensionnement vis countainer mounting point.jpg

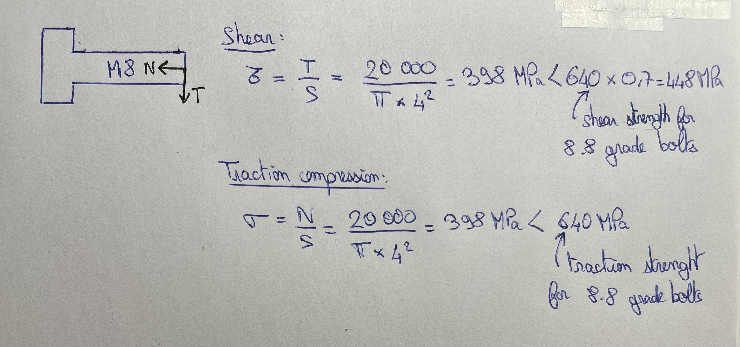
RC_Rendus_Compet/images/TSAC/dimensionnement vis countainer mounting point.jpg
