EOSCogniton/ELIZ-2021/RC_Rendus_Compet/images/vue de coté.png

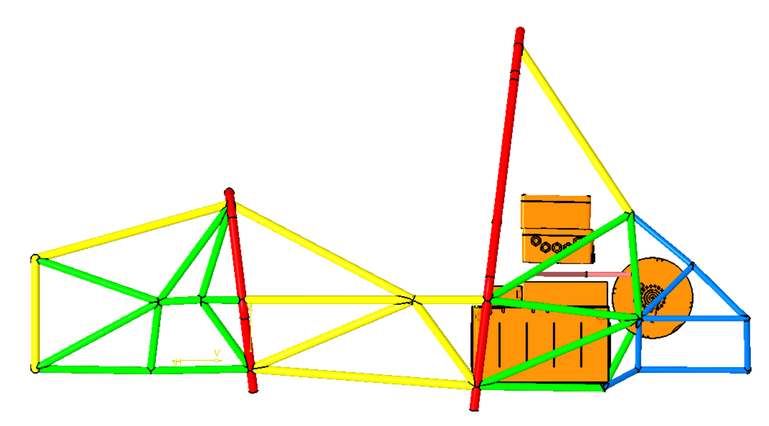
RC_Rendus_Compet/images/vue de coté.png
