EOSCogniton/ELIZ-2021/RC_Rendus_Compet/images/Vue de côté2 detoure.png

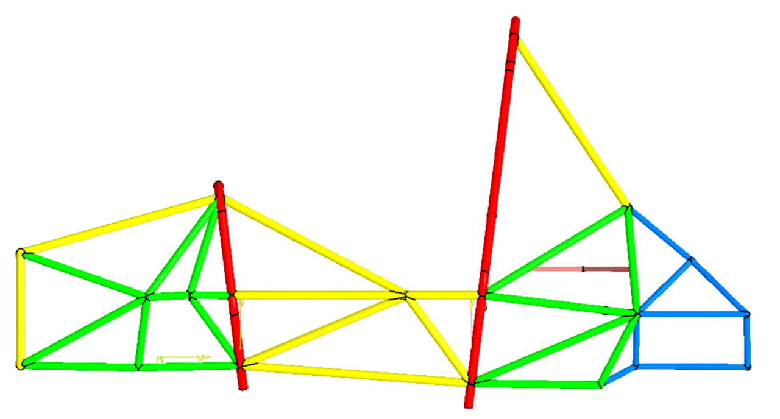
RC_Rendus_Compet/images/Vue de côté2 detoure.png
