EOSCogniton/ELIZ-2021/RC_Rendus_Compet/images/Vue de côté.png

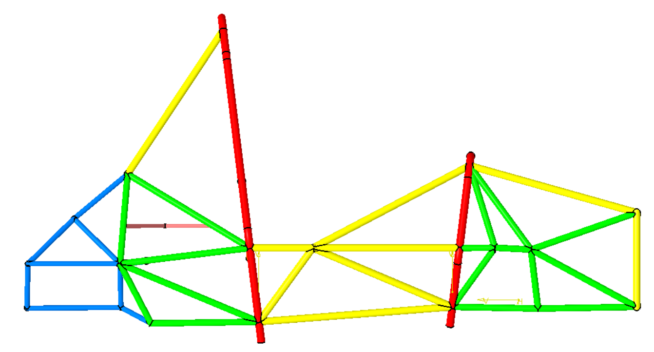
RC_Rendus_Compet/images/Vue de côté.png
