EOSCogniton/ELIZ-2021/RC_Rendus_Compet/images/vue de dessous.png

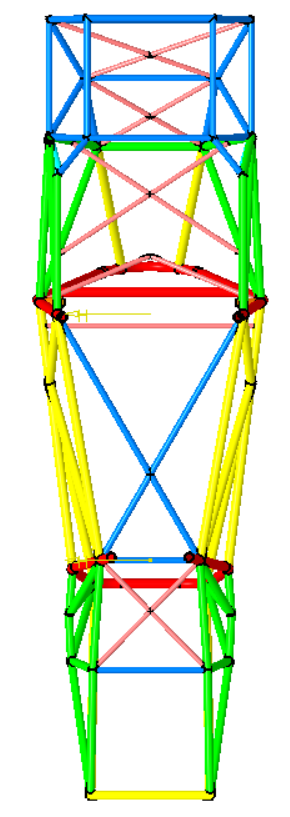
RC_Rendus_Compet/images/vue de dessous.png
