EOSCogniton/ELIZ-2021/RC_Rendus_Compet/images/vue de dessus.png

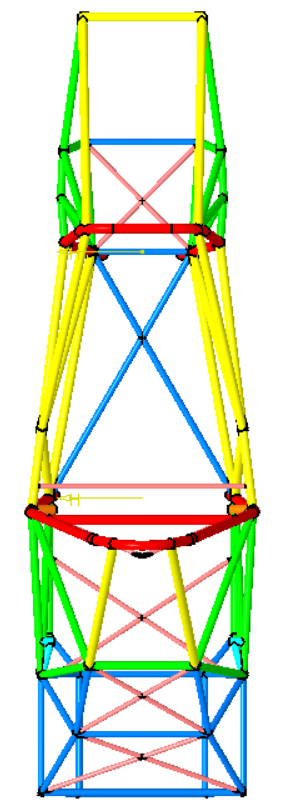
RC_Rendus_Compet/images/vue de dessus.png
