EOSCogniton/ELIZ-2021/RC_Rendus_Compet/images/vue de dos.png

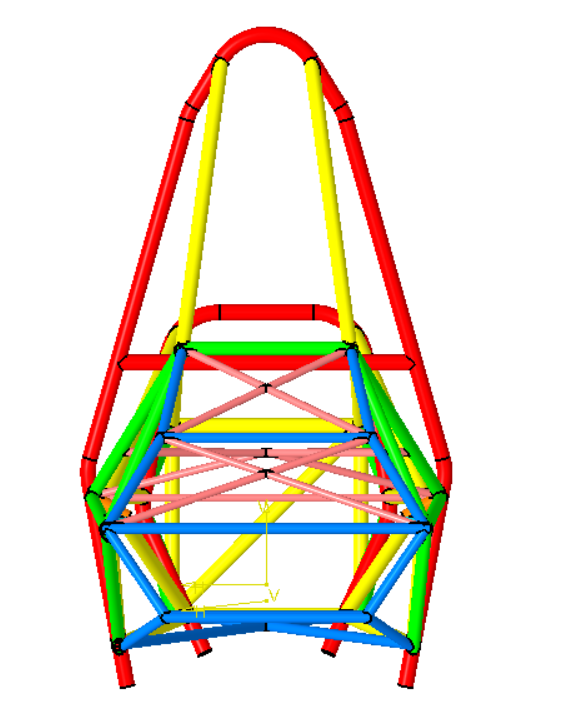
RC_Rendus_Compet/images/vue de dos.png
