EOSCogniton/ELIZ-2021/RC_Rendus_Compet/images/vue de face.png

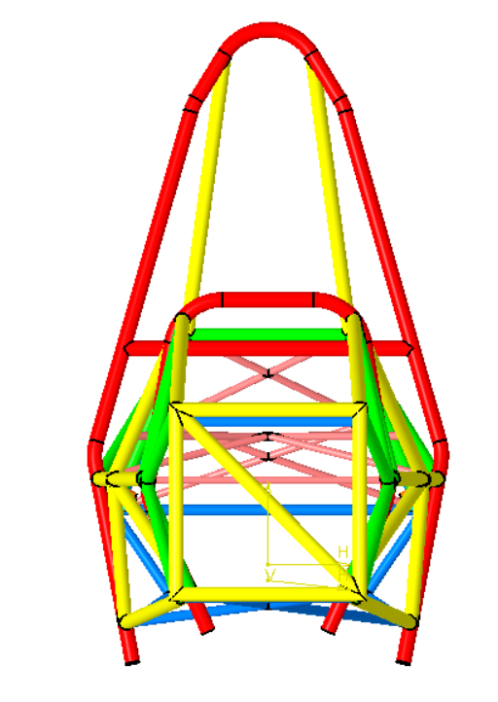
RC_Rendus_Compet/images/vue de face.png
