EOSCogniton/ELIZ-2021/RC_Rendus_Compet/images/vue prismatique arriere.png

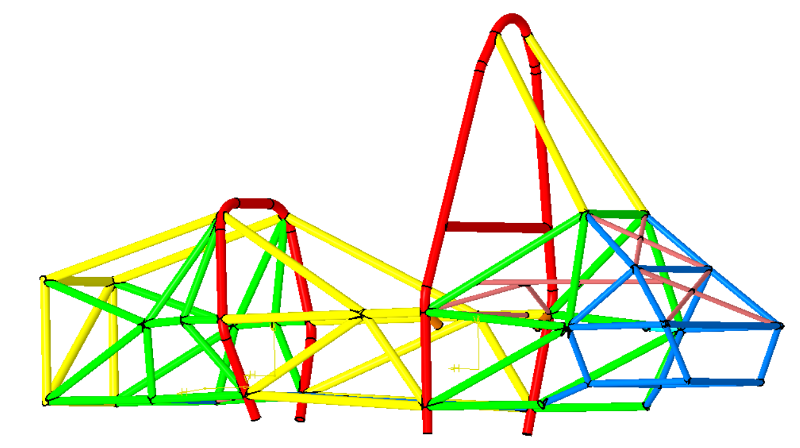
RC_Rendus_Compet/images/vue prismatique arriere.png
