EOSCogniton/ELIZ-2021/RC_Rendus_Compet/images/vue prismatique.png

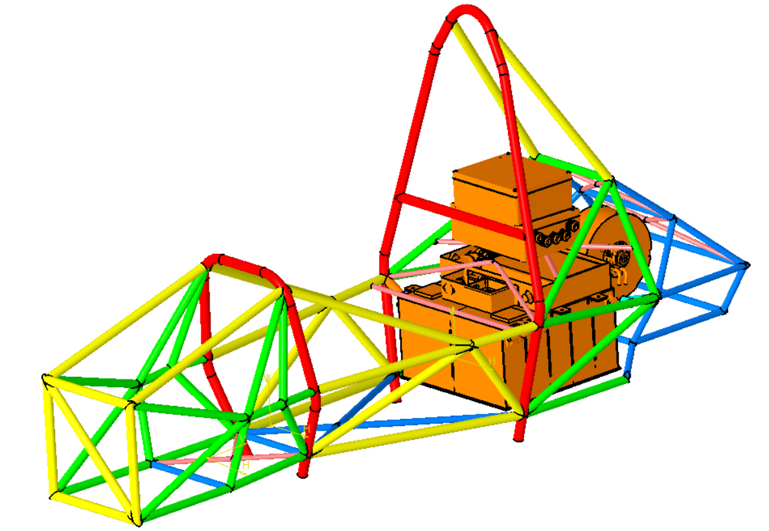
RC_Rendus_Compet/images/vue prismatique.png
