EOSCogniton/ELIZ-2021/SU_Suspension/07_FEA/SU_3003_tubes_fin.JPG

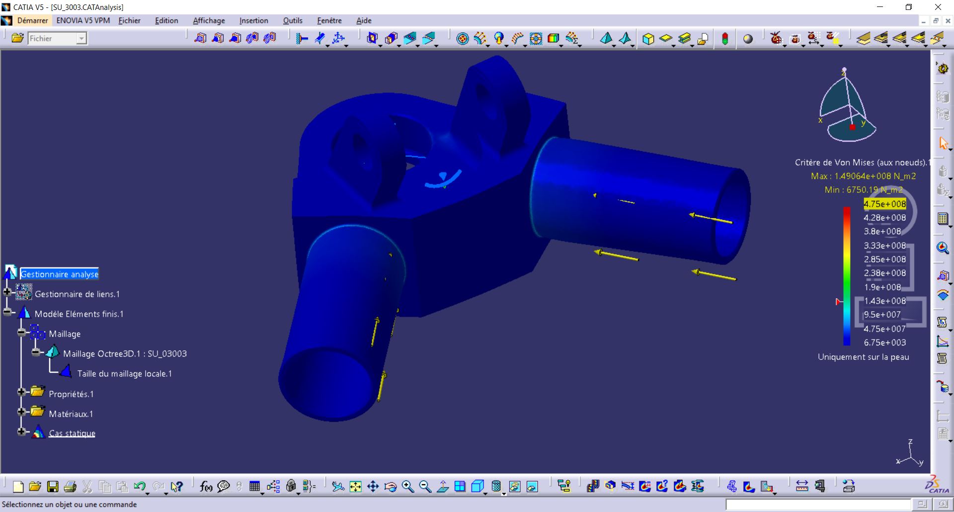
SU_Suspension/07_FEA/SU_3003_tubes_fin.JPG
