EOSCogniton/ELIZ-2021/SU_Suspension/07_FEA/upright_bump_gros.JPG

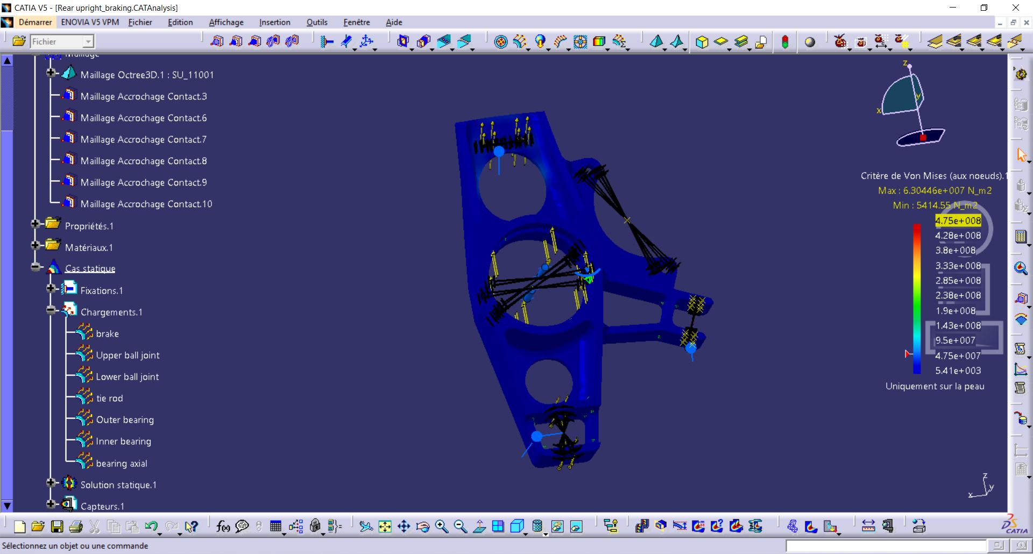
SU_Suspension/07_FEA/upright_bump_gros.JPG
