EOSCogniton/ELIZ-2021/SU_Suspension/07_FEA/upright_virage+freinage_moyen.JPG

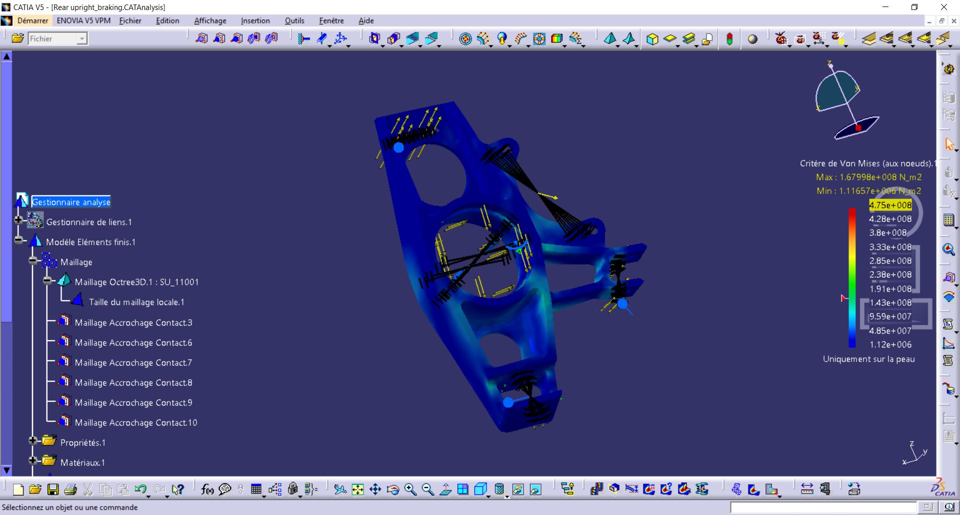
SU_Suspension/07_FEA/upright_virage+freinage_moyen.JPG
