EOSCogniton/ELIZ-2021/CR_Cost_Report/02-REAL_CASES/2_Resource and cost planning/Cost/Cost_plannification.pptx

## Previsionnal Expenses

Suspension Budget

Powertrain Budget

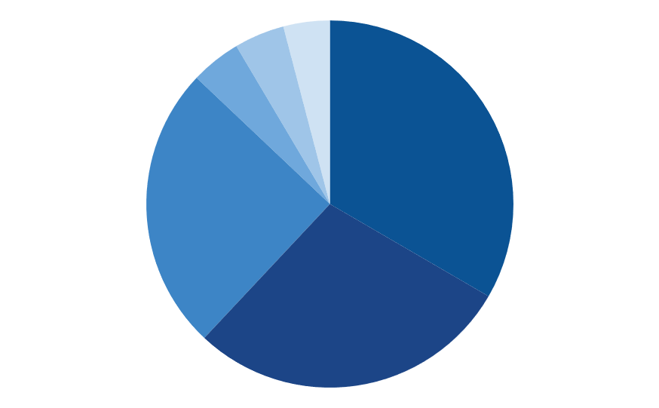
[picture p199: figure]

12 630€

14 680€

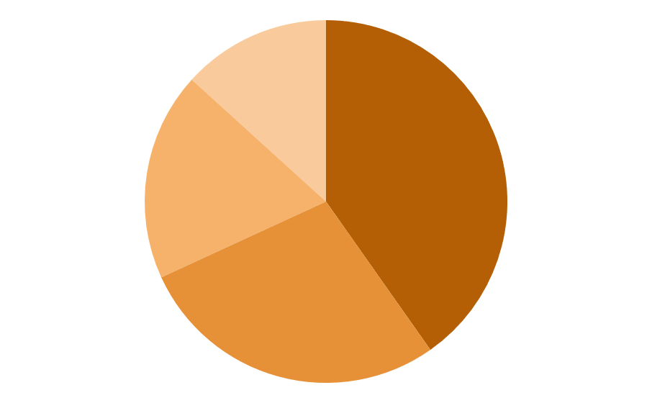
[picture p200: figure]

Steering system 13%

Intake system
5%

Fuel system 4%

Cooling system
4%

Engine & accessories
33%

Wheels and Tires
40%

Brake system
19%

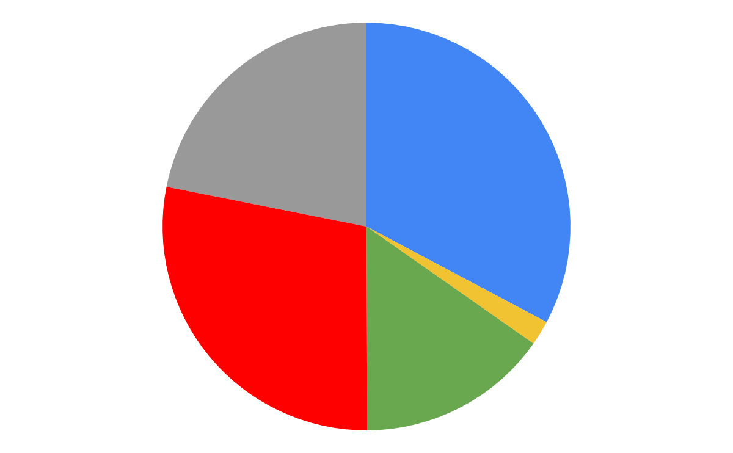
[picture p201: figure]

46 400€

Exhaust system
25%

Dampers
28%

Miscellaneous
22%

33%

Secondary drivetrain system
29%

880 €

Electrical Budget

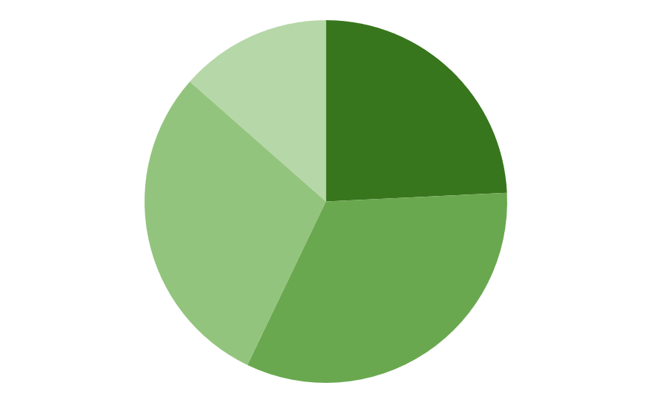
[picture p202: figure]

6 810€

28%

15%

2%

Frame Budget

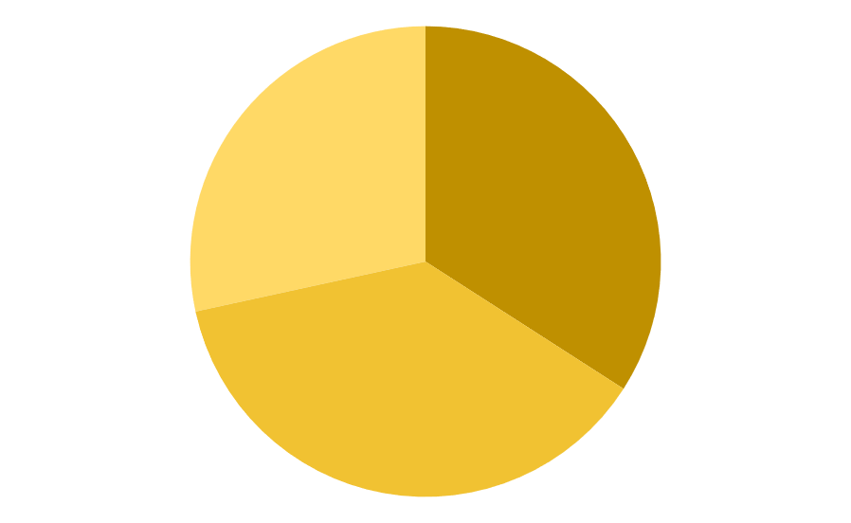
[picture p203: figure]

Data acquisition
14%

Crash box
28%

Frame bending
34%

Other (ECU, Battery…)
24%

Financial provisions:
5 400€

electronic
30%

Gear Shift
25%

Paint
38%

## Overview Expenses

Suspension Budget

Powertrain Budget

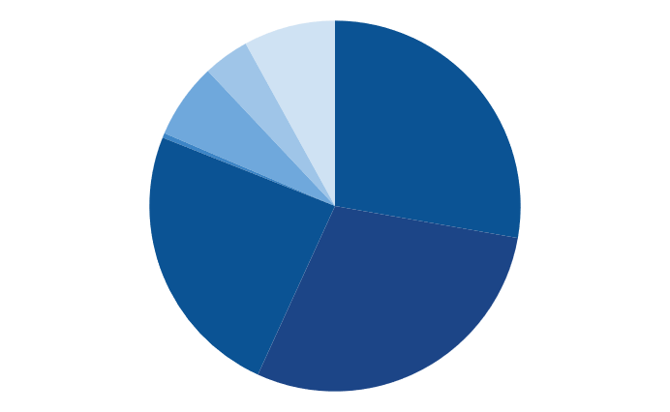
[picture p204: figure]

Miscellaneous
2%

19 480€

14 046€

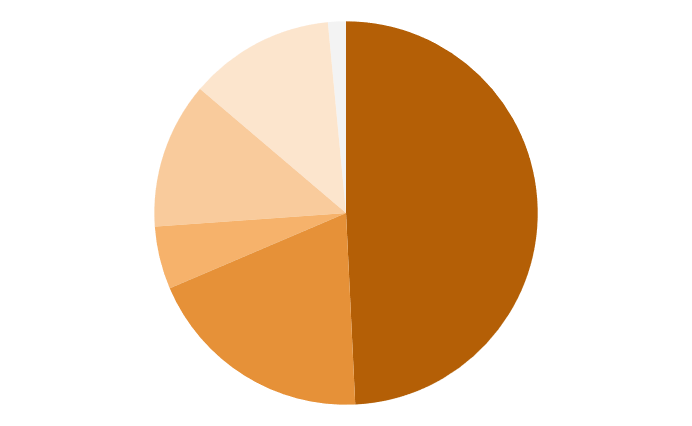
[picture p205: figure]

A_arms 12%

Fuel system 7%

Cooling system
4%

Miscellaneous
8%

Engine & accessories
28%

Steering system
12%

Wheels and Tires
49%

Intake system
≈0%

Brake system
5%

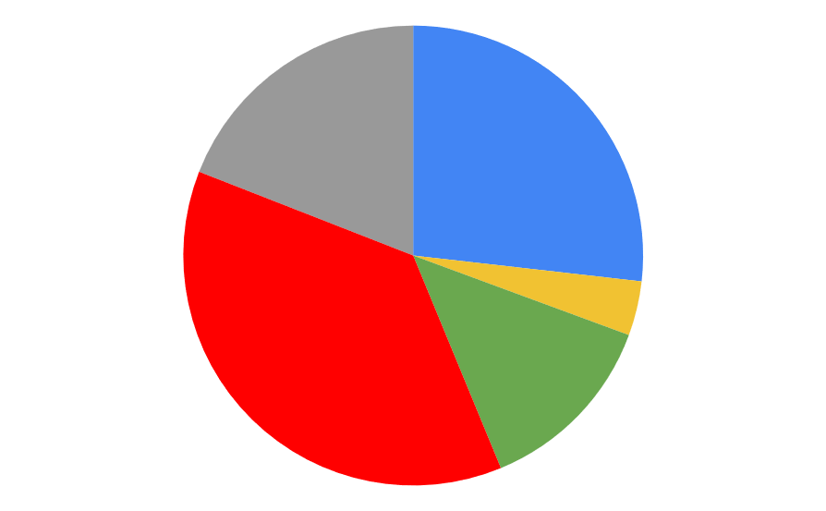
[picture p206: figure]

52 418€

Miscellaneous
19%

Exhaust system
24%

Dampers
20%

27%

Secondary drivetrain system
29%

2 005 €

Rigidity tests
26%

Electrical Budget

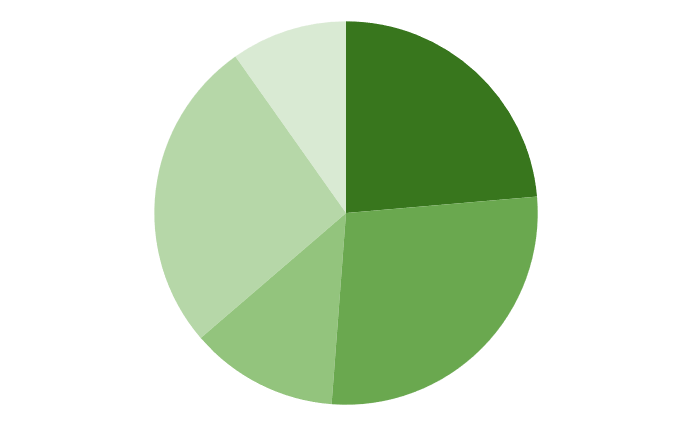
[picture p207: figure]

6 893€

37%

13%

4%

Frame Budget

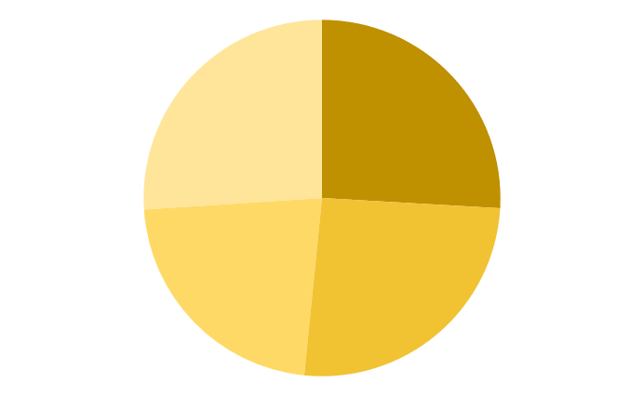
[picture p208: figure]

Miscellaneous
8%

Bodywork 26%

Data acquisition
22%

Other (ECU, Battery…)
20%

Electronic
11%

Gear Shift
39%

Paint
22%

Frame
26%
