EOSCogniton/ELIZ-2021/CR_Cost_Report/ZZ-Ressources/05-REAL_CASES/FS_ATA/Prototype_and_mass_production.pptx

## Prototype and mass production

Examples of manufacturing processes for mass production

Different manufacturing processes

Manufacturing processes (for prototyping and mass production):
- Milling
- Turning
- Laser and waterjet cut
- 3D printing
- Weldments
Manufacturing processes (for mass production):
- Stamping
- Foundry
- Broaching
- Injection molding

Exhaust system

Prototype: Complex geometry to realise acoustic waves.

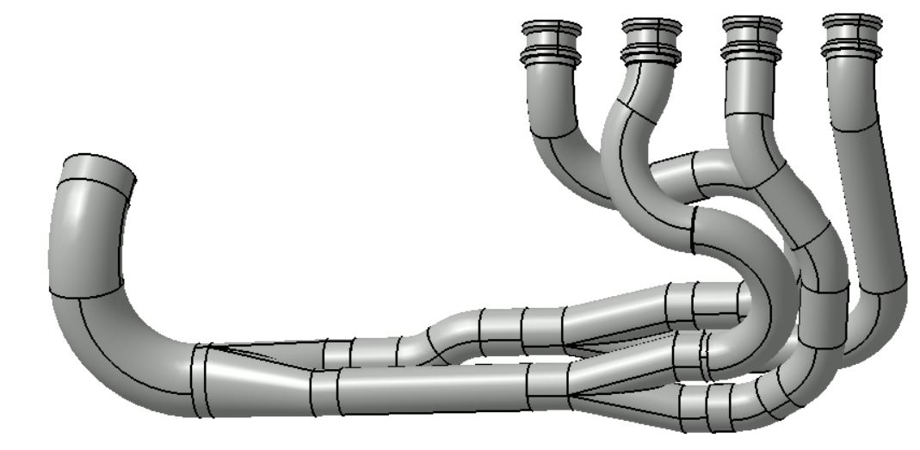
[picture p221: figure]

Intake system

Prototype: 3D printed part + aluminium laser cutted part.

Mass production:
Left: Changement of manufacturing process. Thermoforming from extruded pipes + injection molding.
Right: Injection molding.

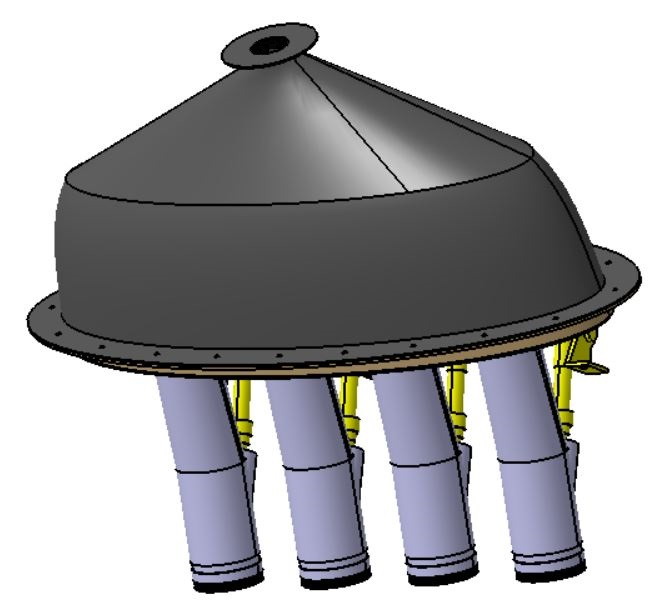
[picture p222: figure]
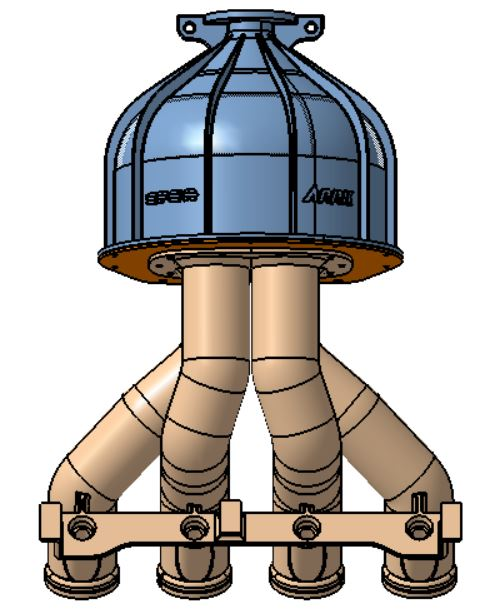
[picture p223: figure]

Mass production: Reduce complexity to reduce cost.

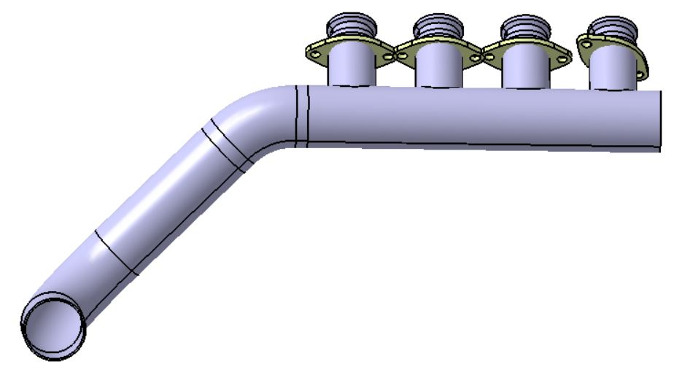
[picture p224: figure]

Oil pan

Example of cost evolution

See below an example of cost evolution versus complexity and size of the series for 3D printing and conventionnal production.


Prototype: Aluminiun laser and waterjet cutted part + welding.

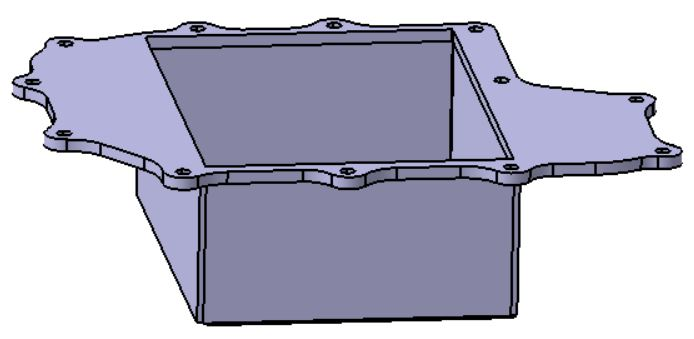
[picture p225: figure]

A-arms

Prototype: CFRP tubes with aluminium machined parts.

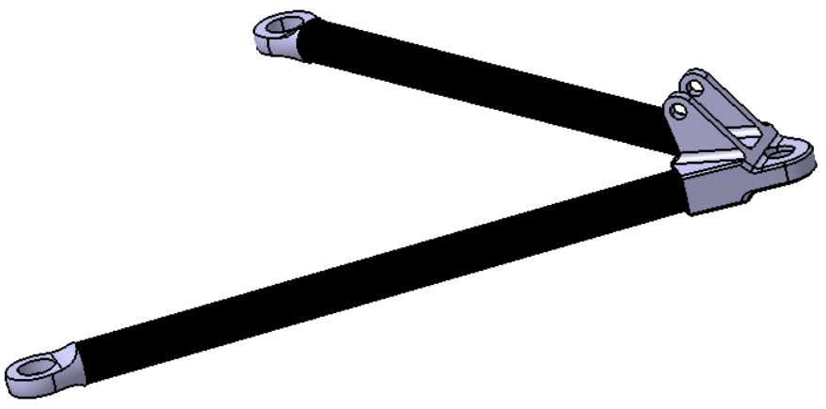
[picture p226: figure]

Mass production: Changement of manufacturing process.
Stamping process.

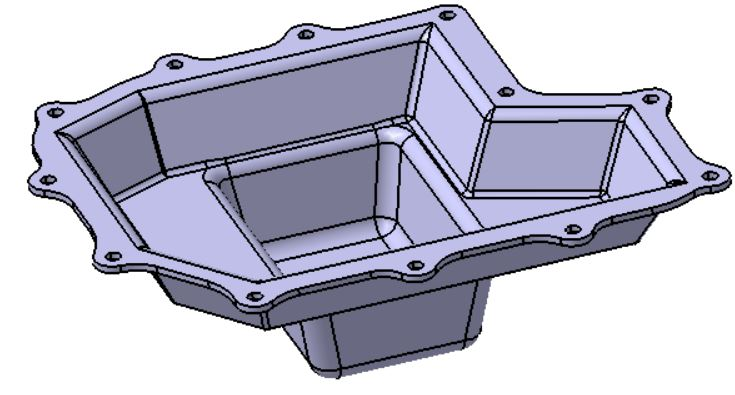
[picture p227: figure]

Prototype: Changement of materials, manufacturing and assembly processes.
Weldments, steel with tubes and laser cutted part.

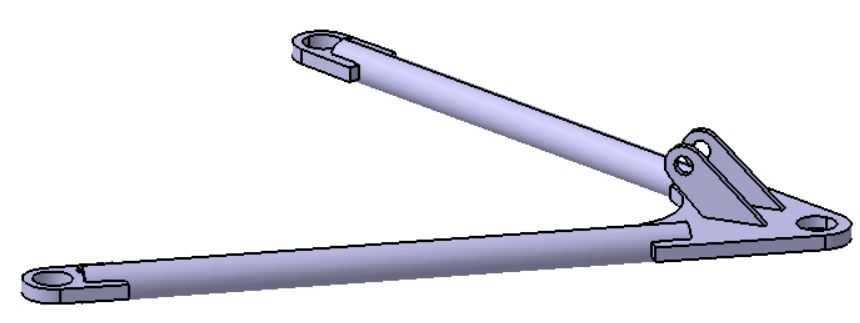
[picture p228: figure]
