EOSCogniton/ELIZ-2021/CR_Cost_Report/03-FR-CBOM/CRD_EPSA/SMF_EPSA.pdf

system | assembly | sub_assembly | assembly_no | part | part_comments | makebuy | part_quantity | part_no
FR | Frame / Frame Tubes FR_A0100
FR | Frame / Frame Tubes | | FR_A0100 | Frame | 25CrMo4 ; 30*1,5, 25*1,5, 20*15, 15*1,5 | m | | 1 FR_01001
FR | Bodywork | FR_A0200
FR | Bodywork | | FR_A0200 | Nose | Nose of the bodywork | b | | 1 FR_02001
FR | Bodywork | | FR_A0200 | Side plates | Side plate from the front hoop to main | b | | 2 FR_02002
FR | Bodywork | | FR_A0200 | Additional plates | Lower side plate with holes | b | | 2 FR_02003
FR | Bodywork | | FR_A0200 | Push-clips | Attachement of the nose to the frame | b | | 4 FR_02004
FR | Bodywork | | FR_A0200 | Hook and loop belts | Attachement of the bodywork to the frame | b | | 20 FR_02005
FR | Pedals (Accelerator) | FR_A0300
FR | Pedals (Accelerator) | | FR_A0300 | Frame throttle | laser cut and soldered | m | | 1 FR_03001
FR | Pedals (Accelerator) | | FR_A0300 | Footrest | laser cut and bended | m | | 1 FR_03002
FR | Pedals (Accelerator) | | FR_A0300 | Throttle pedal stick | link frame and footrest | m | | 1 FR_03003
FR | Pedals (Accelerator) | | FR_A0300 | Throttle fixing rail | allow position adjustment | m | | 2 FR_03004
FR | Pedals (Accelerator) | | FR_A0300 | Throttle rail wedge | laser cut | m | | 2 FR_03005
FR | Pedals (Accelerator) | | FR_A0300 | Throttle Threated Rod | to position rails | m | | 2 FR_03006
FR | Pedals (Accelerator) | | FR_A0300 | Throttle Front Rail Wedge | laser cut | m | | 2 FR_03007
FR | Pedals (Accelerator) | | FR_A0300 | Negative Mechanical Stop | to protect potentiometers | m | | 1 FR_03008
FR | Pedals (Accelerator) | | FR_A0300 | Positive Mechanical Stop | to protect potentiometers | m | | 1 FR_03009
FR | Pedals (Accelerator) | | FR_A0300 | Throttle pedal bearing | allow soft rotation | b | | 2 FR_03010
FR | Pedals (Accelerator) | | FR_A0300 | Springs | bring back the pedal | b | | 2 FR_03011
FR | Pedals (Accelerator) | | FR_A0300 | Potentiometer | Detects pedal postition | b | | 2 FR_03012
FR | Pedals (Accelerator) | | FR_A0300 | Throttle R Threaded rods | to position frame | b | | 1 FR_03013
FR | Pedals (Accelerator) | | FR_A0300 | Throttle F Threaded rods | to position frame | b | | 1 FR_03014
FR | Pedals (Accelerator) | | FR_A0300 | Axle Spacer | allow good position | m | | 1 FR_03015
FR | Pedals (Accelerator) | | FR_A0300 | Potentiom R Threaded Rod | Fix potentiom to frame | b | | 1 FR_03016
FR | Pedals (Brake) | FR_A0400
FR | Pedals (Brake) | | FR_A0400 | Frame brake | laser cut and solded | m | | 1 FR_04001
FR | Pedals (Brake) | | FR_A0400 | Brake pedal Stick | link frame and footrest | m | | 1 FR_04002
FR | Pedals (Brake) | | FR_A0400 | Footrest | laser cut and bended | m | | 1 FR_04003
FR | Pedals (Brake) | | FR_A0400 | Master cylinder | pressurize brake liquid | b | | FR_04004
FR | Pedals (Brake) | | FR_A0400 | Master cylinder wedge | link master cylinder and stick | m | | 2 FR_04005
FR | Pedals (Brake) | | FR_A0400 | Brake fixing rail | allow position adjustment | m | | 2 FR_04006
FR | Pedals (Brake) | | FR_A0400 | Brake R Fixing Rail Wedge | rear wedges | m | | 2 FR_04007
FR | Pedals (Brake) | | FR_A0400 | Brake F Fixing Rail Wedge | front wedges | m | | 2 FR_04008
FR | Pedals (Brake) | | FR_A0400 | Distribution Brake Axle | link cylinder to ball joint | b | | 1 FR_04009
FR | Pedals (Brake) | | FR_A0400 | Distribution Axle Tread | maintain Brake Axle | b | | 2 FR_04010
FR | Pedals (Brake) | | FR_A0400 | Distribution Cylinder | support for ball joint | b | | 1 FR_04011
FR | Pedals (Brake) | | FR_A0400 | Distribution Ball Joint | allows rotation | b | | 1 FR_04012
FR | Pedals (Brake) | | FR_A0400 | BOTS Support | support the BOTS | m | | 1 FR_04013
FR | Pedals (Brake) | | FR_A0400 | BOTS | security if brakes don't work | b | | 1 FR_04014
FR | Pedals (Brake) | | FR_A0400 | Brake Pedal Hose Wedge | to maintain brake hose | m | | 1 FR_04015

FR | Pedals (Brake) | FR_A0400 | Distribution Cylinder | link axle and axle thread | b | 2 FR_04016
FR | Pedals (Brake) | FR_A0400 | Brake Pedale Bearing | allow soft rotation | b | 2 FR_04017
FR | Pedals (Brake) | FR_A0400 | Brake Threated Rod | to position frame | b | 2 FR_04018
FR | Impact Attenuator | FR_A0500
FR | Impact Attenuator | FR_A0500 | Impact Attenuator | Approved by event | b | 1 FR_05001
FR | Impact Attenuator | FR_A0500 | Anti-intrusion Plate | Steel, (thickness 1.5mm) | m | 1 FR_05002
FR | Floor Pan | FR_A0600
FR | Floor Pan | FR_A0600 | Front plate | Floor pan from front hoop to front car | m | 1 FR_06001
FR | Floor Pan | FR_A0600 | Cockpit plate | Floor pan from front hoop to main hoop | m | 1 FR_06002

FR | Frame / Frame Tubes FR_A0100 | Retour
FR | Frame / Frame Tubes | FR_A0100 | Frame | 25CrMo4 ; 30*1,5, 25*1,5, 20*15, 15*1,5 m | 1 FR_01001

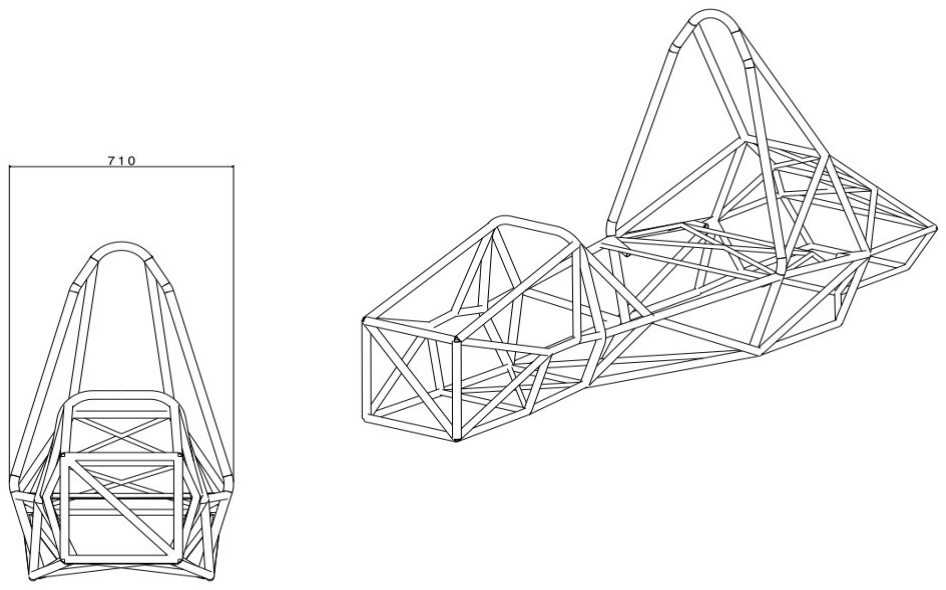
[picture p234: figure]

FR | Bodywork | FR_A0200 | Retour
FR | Bodywork | FR_A0200 | Nose | Nose of the bodywork b | 1 FR_02001
FR | Bodywork | FR_A0200 | Side plates Side plate from the front hoop to main b | 2 FR_02002
FR | Bodywork | FR_A0200 | Additional plates Lower side plate with holes b | 2 FR_02003
FR | Bodywork | FR_A0200 | Push-clips | Attachement of the nose to the frame b | 4 FR_02004
FR | Bodywork | FR_A0200 | Hook and loop belts Attachement of the bodywork to the frame b | 20 FR_02005

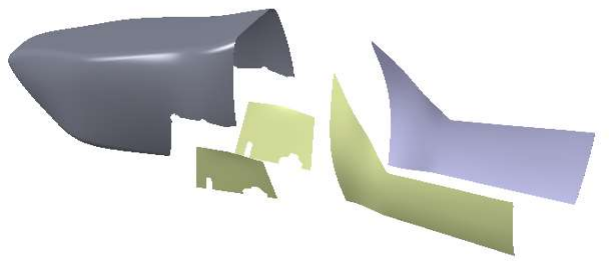
[picture p235: figure]

FR | FR_A0200 | Nose | FR_02001

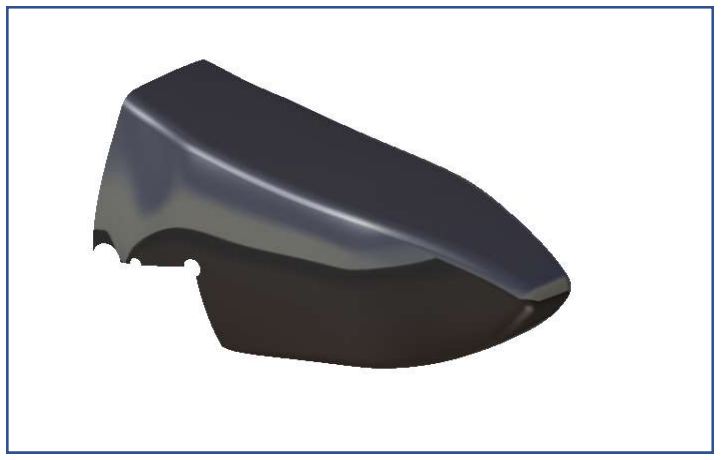
[picture p236: figure]

FR | FR_A0200 | Side plates FR_02002

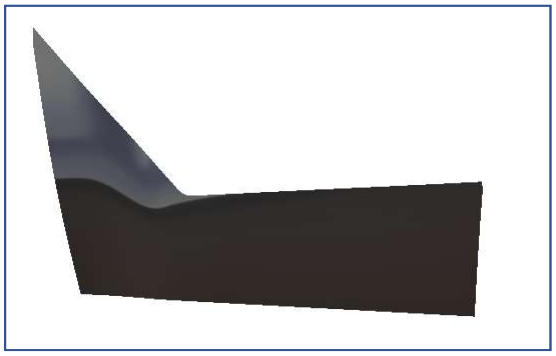
[picture p237: figure]

FR | FR_A0200 | Additional plates FR_02003

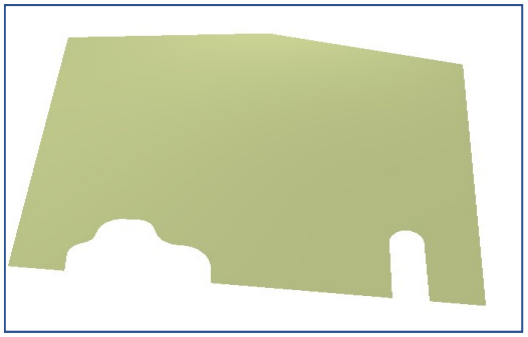
[picture p238: figure]

FR | FR_A0200 | Push-clips | FR_02004

FR | FR_A0200 | Hook and loop belts FR_02005

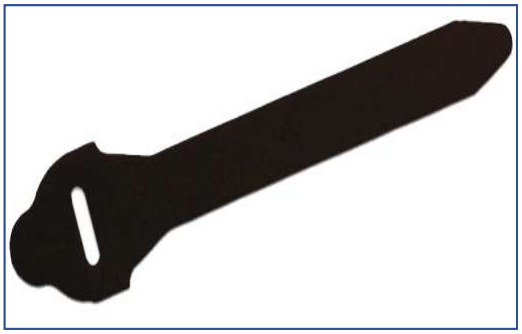
[picture p239: figure]

FR | Pedals (Accelerator) FR_A0300 | Retour
FR | Pedals (Accelerator) | FR_A0300 | Frame throttlelaser cut and soldered m | 1 FR_03001
FR | Pedals (Accelerator) | FR_A0300 | Footrest | laser cut and bended m | 1 FR_03002
FR | Pedals (Accelerator) | FR_A0300 | Throttle pedal stick link frame and footrest m | 1 FR_03003
FR | Pedals (Accelerator) | FR_A0300 | Throttle fixing rail allow position adjustment m | 2 FR_03004
FR | Pedals (Accelerator) | FR_A0300 | Throttle rail wedge laser cut | m | 2 FR_03005
FR | Pedals (Accelerator) | FR_A0300 | Throttle Threated Rod to position railsm | 2 FR_03006
FR | Pedals (Accelerator) | FR_A0300 | Throttle Front Rail Wedge laser cut | m | 2 FR_03007
FR | Pedals (Accelerator) | FR_A0300 | Negative Mechanical Stop to protect potentiometers m | 1 FR_03008
FR | Pedals (Accelerator) | FR_A0300 | Positive Mechanical Stop to protect potentiometers m | 1 FR_03009
FR | Pedals (Accelerator) | FR_A0300 | Throttle pedal bearing allow soft rotation b | 2 FR_03010
FR | Pedals (Accelerator) | FR_A0300 | Springs | bring back the pedal b | 2 FR_03011
FR | Pedals (Accelerator) | FR_A0300 | PotentiometerDetects pedal postition b | 2 FR_03012
FR | Pedals (Accelerator) | FR_A0300 | Throttle R Threaded rods to position frame b | 1 FR_03013
FR | Pedals (Accelerator) | FR_A0300 | Throttle F Threaded rods to position frame b | 1 FR_03014
FR | Pedals (Accelerator) | FR_A0300 | Axle Spacer allow good position m | 1 FR_03015
FR | Pedals (Accelerator) | FR_A0300 | Potentiom R Threaded Rod Fix potentiom to frame b | 1 FR_03016

FR | FR_A0300 | Frame throttleFR_03001

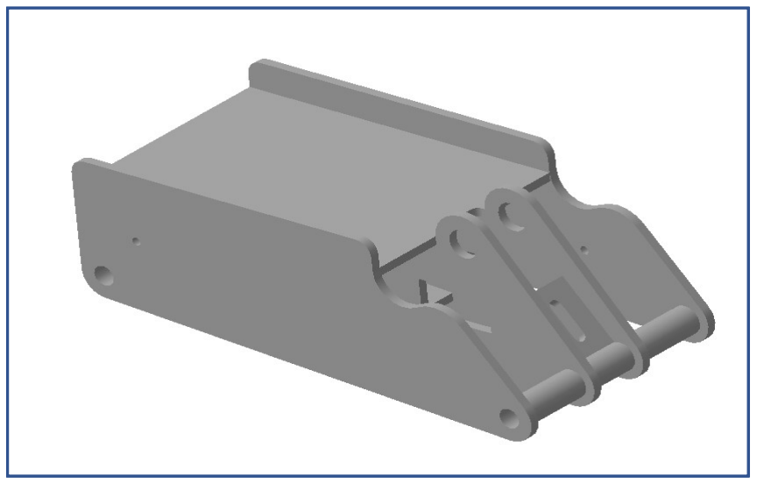
[picture p240: figure]

FR | FR_A0300 | Footrest | FR_03002

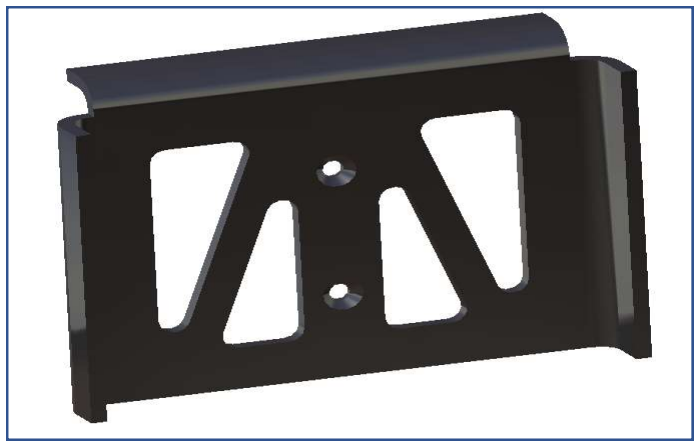
[picture p241: figure]

FR | FR_A0300 | Throttle pedal stick FR_03003

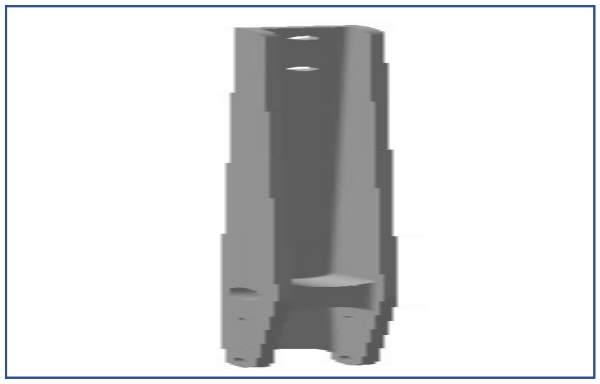
[picture p242: figure]

FR | FR_A0300 | Throttle fixing rail FR_03004

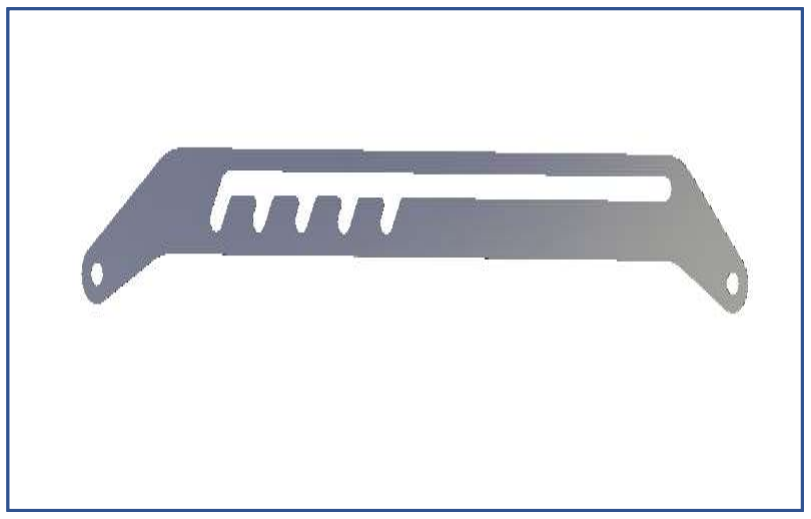
[picture p243: figure]

FR | FR_A0300 | Throttle rail wedge FR_03005

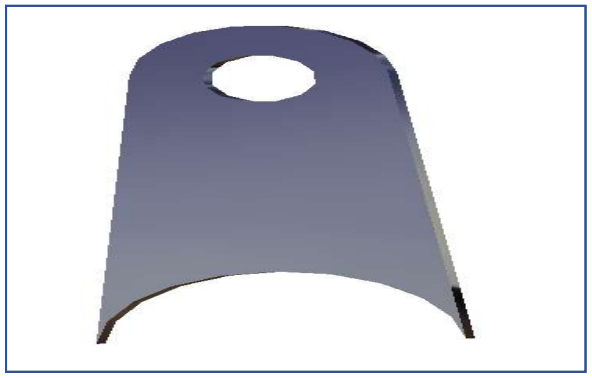
[picture p244: figure]

FR | FR_A0300 | Throttle Threated Rod FR_03006

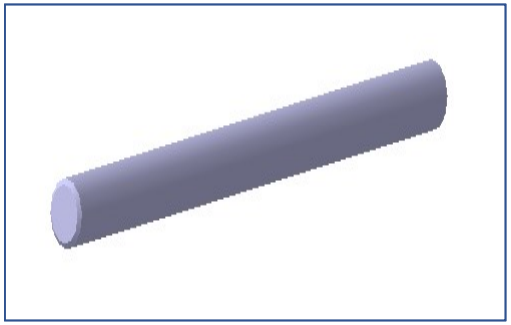
[picture p245: figure]

FR | FR_A0300 | Throttle Front Rail Wedge FR_03007

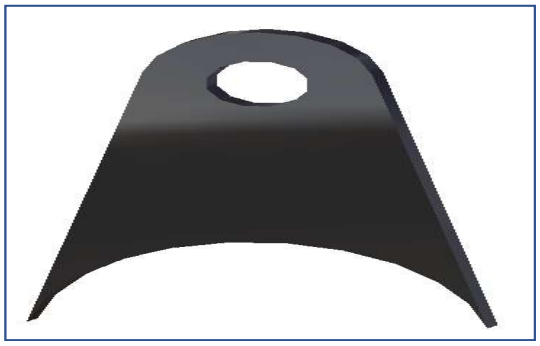
[picture p246: figure]

FR | FR_A0300 | Negative Mechanical Stop FR_03008

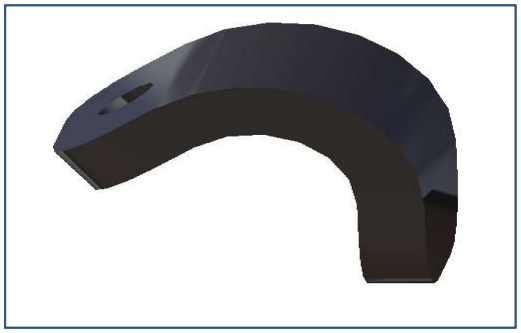
[picture p247: figure]

FR | FR_A0300 | Positive Mechanical Stop FR_03009

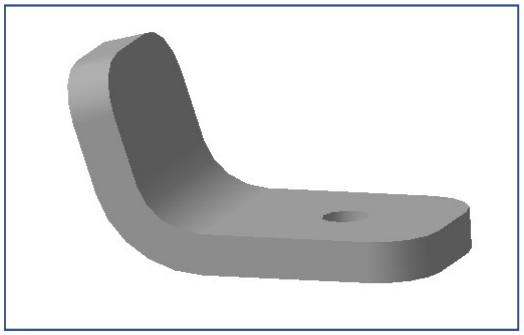
[picture p248: figure]

FR | FR_A0300 | Throttle pedal bearing FR_03010

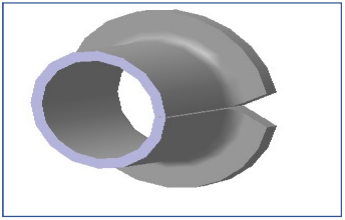
[picture p249: figure]

FR | FR_A0300 | Springs | FR_03011

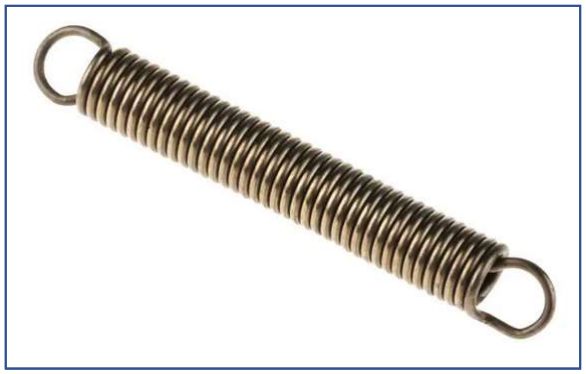
[picture p250: figure]

FR | FR_A0300 | PotentiometerFR_03012

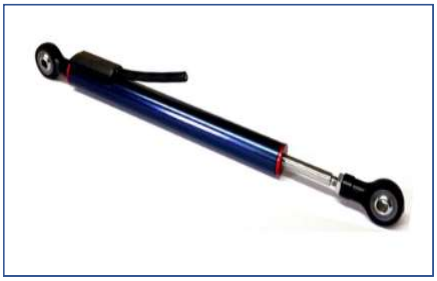
[picture p251: figure]

FR | FR_A0300 | Throttle R Threaded rods FR_03013

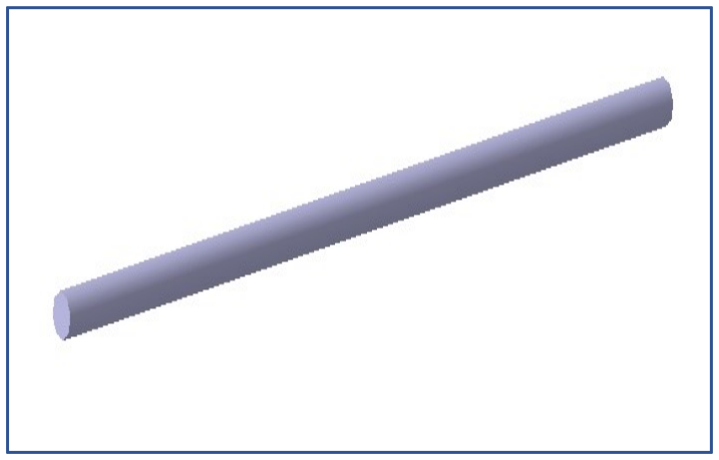
[picture p252: figure]

FR | FR_A0300 | Throttle F Threaded rods FR_03014

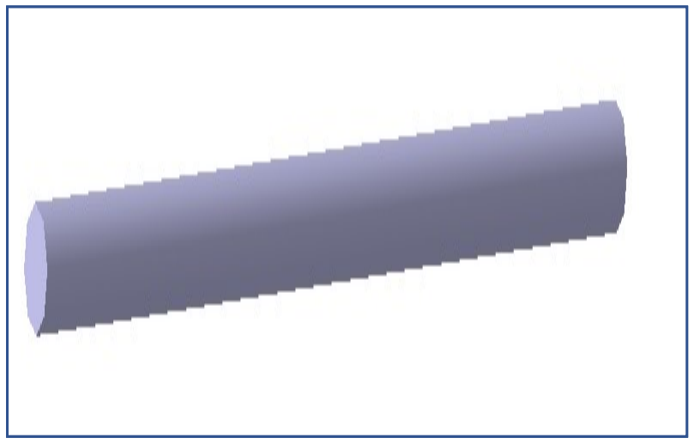
[picture p253: figure]

FR | FR_A0300 | Axle Spacer FR_03015

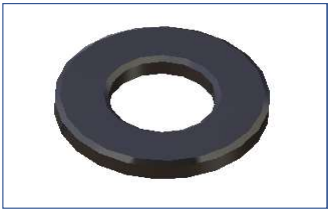
[picture p254: figure]

FR | FR_A0300 | Potentiom R Threaded Rod FR_03016

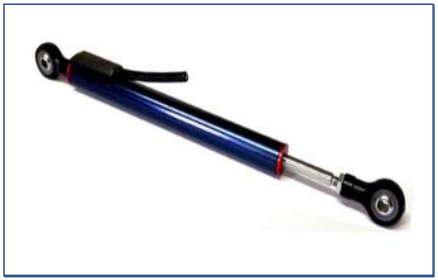
[picture p255: figure]

FR | Pedals (Brake)FR_A0400 | Retour
FR | Pedals (Brake) | FR_A0400 | Frame brake laser cut and solded m | 1 FR_04001
FR | Pedals (Brake) | FR_A0400 | Brake pedal Stick link frame and footrest m | 1 FR_04002
FR | Pedals (Brake) | FR_A0400 | Footrest | laser cut and bended m | 1 FR_04003
FR | Pedals (Brake) | FR_A0400 | Master cylinderpressurize brake liquid b | FR_04004
FR | Pedals (Brake) | FR_A0400 | Master cylinder wedge link master cylinder and stick m | 2 FR_04005
FR | Pedals (Brake) | FR_A0400 | Brake fixing railallow position adjustment m | 2 FR_04006
FR | Pedals (Brake) | FR_A0400 | Brake R Fixing Rail Wedge rear wedges m | 2 FR_04007
FR | Pedals (Brake) | FR_A0400 | Brake F Fixing Rail Wedge front wedges m | 2 FR_04008
FR | Pedals (Brake) | FR_A0400 | Distribution Brake Axle link cylinder to ball joint b | 1 FR_04009
FR | Pedals (Brake) | FR_A0400 | Distribution Axle Tread maintain Brake Axle b | 2 FR_04010
FR | Pedals (Brake) | FR_A0400 | Distribution Cylinder support for ball joint b | 1 FR_04011
FR | Pedals (Brake) | FR_A0400 | Distribution Ball Joint allows rotationb | 1 FR_04012
FR | Pedals (Brake) | FR_A0400 | BOTS Support support the BOTS m | 1 FR_04013
FR | Pedals (Brake) | FR_A0400 | BOTS | security if brakes don't work b | 1 FR_04014
FR | Pedals (Brake) | FR_A0400 | Brake Pedal Hose Wedge to maintain brake hose m | 1 FR_04015
FR | Pedals (Brake) | FR_A0400 | Distribution Cylinder link axle and axle thread b | 2 FR_04016
FR | Pedals (Brake) | FR_A0400 | Brake Pedale Bearing allow soft rotation b | 2 FR_04017
FR | Pedals (Brake) | FR_A0400 | Brake Threated Rod to position frame b | 2 FR_04018

FR | FR_A0400 | Frame brake FR_04001

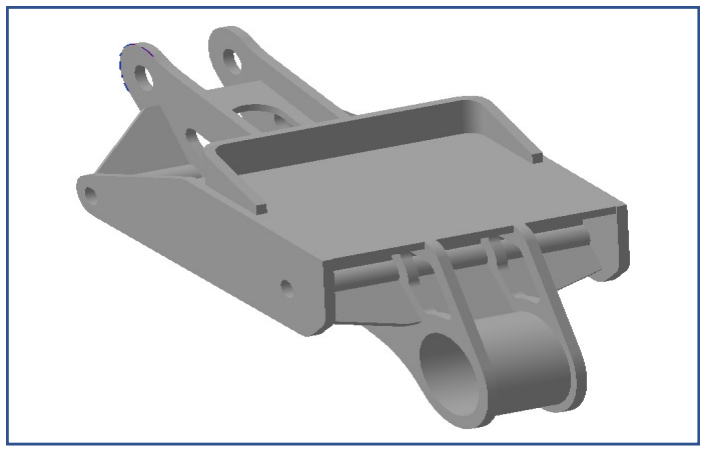
[picture p256: figure]

FR | FR_A0400 | Brake pedal Stick FR_04002

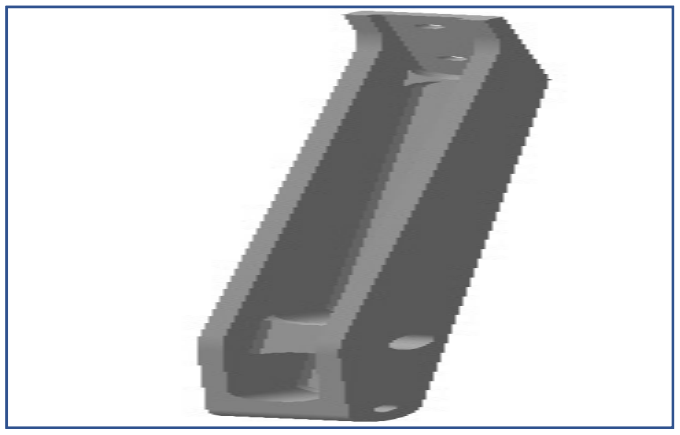
[picture p257: figure]

FR | FR_A0400 | Footrest | FR_04003

FR | FR_A0400 | Master cylinderFR_04004

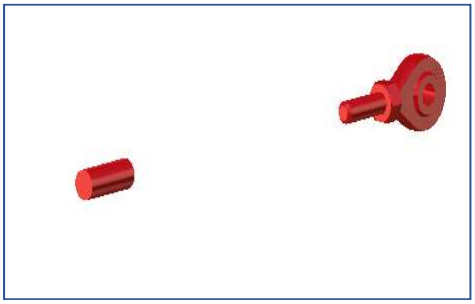
[picture p258: figure]

FR | FR_A0400 | Master cylinder wedge FR_04005

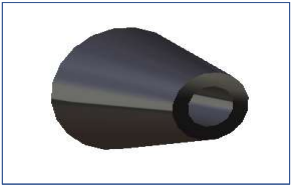
[picture p259: figure]

FR | FR_A0400 | Brake fixing railFR_04006

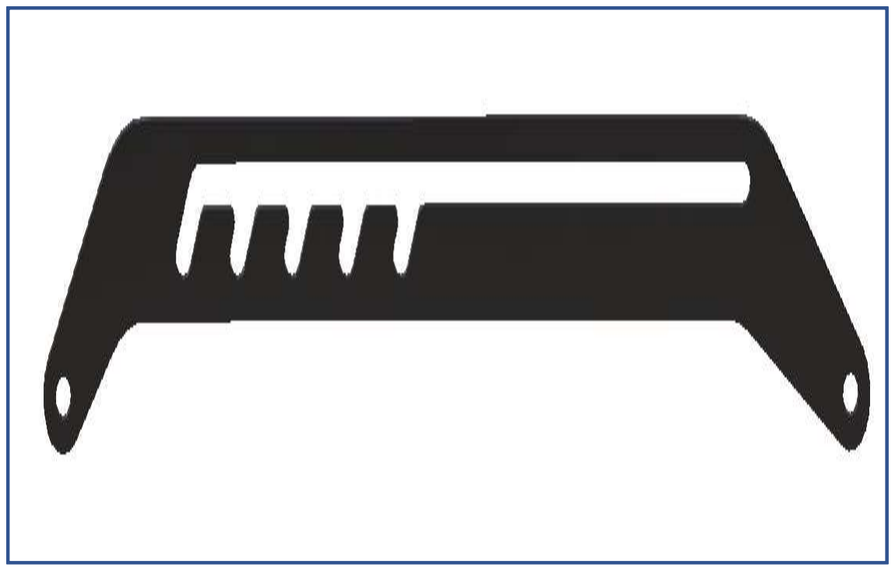
[picture p260: figure]

FR | FR_A0400 | Brake R Fixing Rail Wedge FR_04007

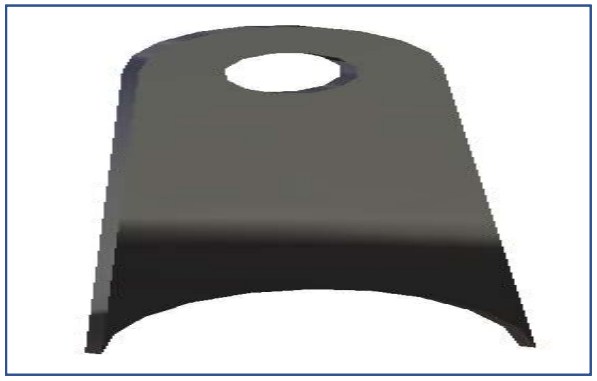
[picture p261: figure]

FR | FR_A0400 | Brake F Fixing Rail Wedge FR_04008

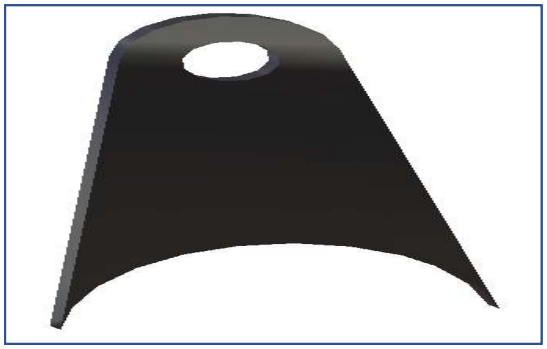
[picture p262: figure]

FR | FR_A0400 | Distribution Brake Axle FR_04009

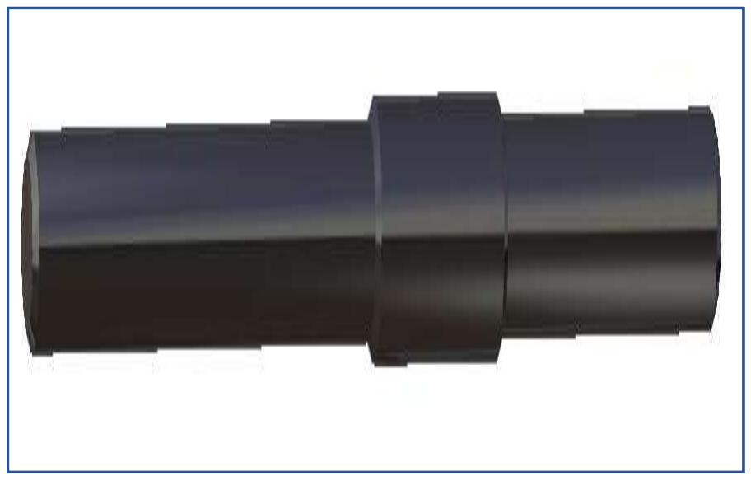
[picture p263: figure]

FR | FR_A0400 | Distribution Axle Tread FR_04010

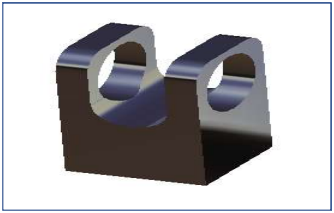
[picture p264: figure]

FR | FR_A0400 | Distribution Cylinder FR_04011

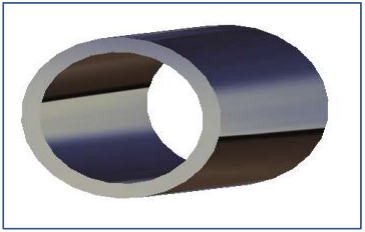
[picture p265: figure]

FR | FR_A0400 | Distribution Ball Joint FR_04012

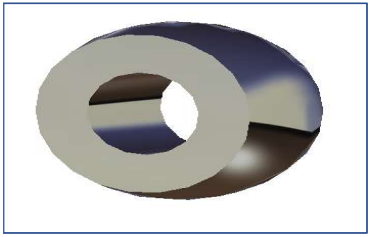
[picture p266: figure]

FR | FR_A0400 | BOTS Support FR_04013

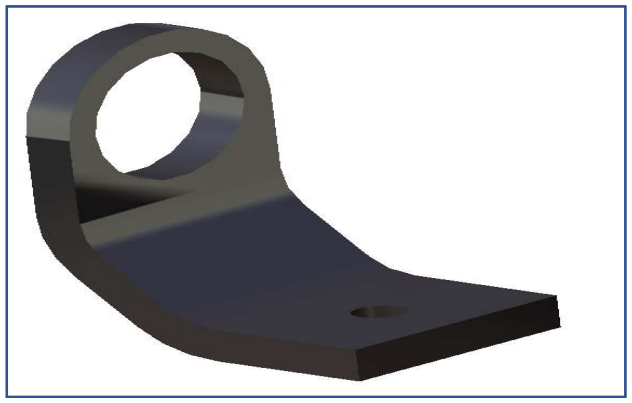
[picture p267: figure]

FR | FR_A0400 | BOTS | FR_04014

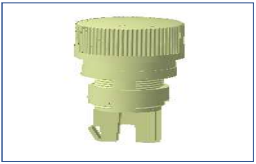
[picture p268: figure]

FR | FR_A0400 | Brake Pedal Hose Wedge FR_04015

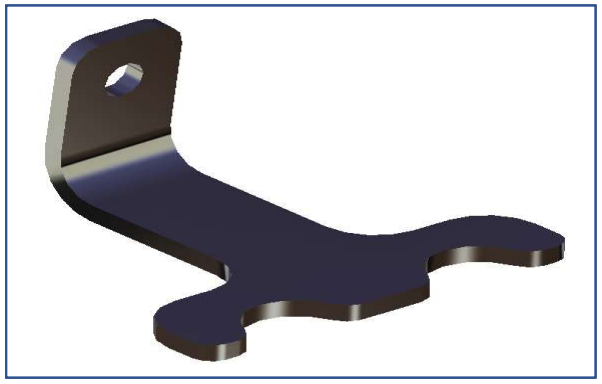
[picture p269: figure]

FR | FR_A0400 | Distribution Cylinder FR_04016

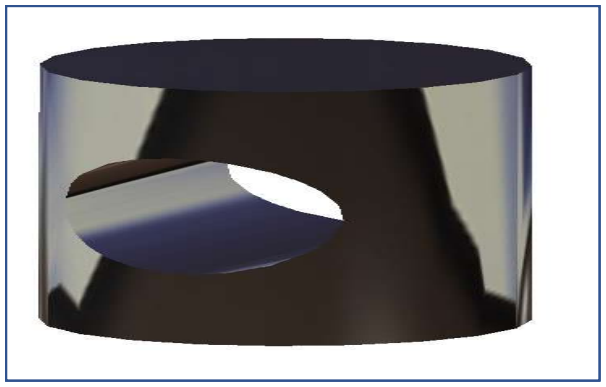
[picture p270: figure]

FR | FR_A0400 | Brake Pedale Bearing FR_04017

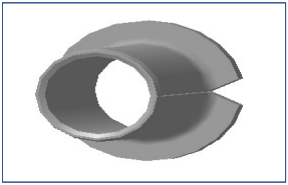
[picture p271: figure]

FR | FR_A0400 | Brake Threated Rod FR_04018

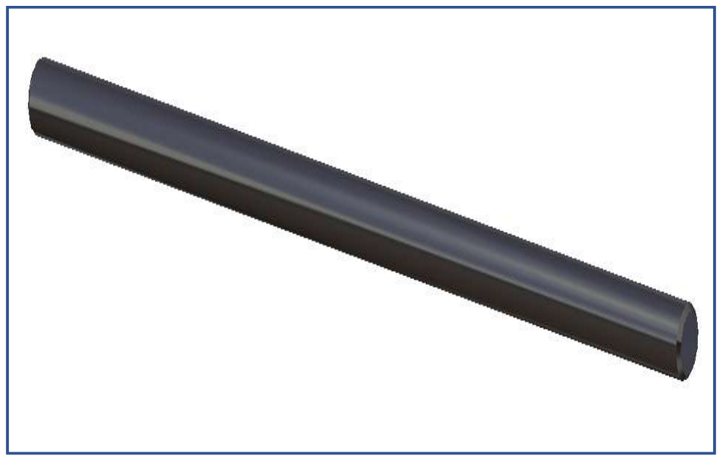
[picture p272: figure]

FR | Impact Atenuator FR_A0600 | Retour
FR | Impact Attenuator | FR_A0500 | Front plate Floor pan from front hoop to front car m | 1 FR_05001
FR | Impact Attenuator | FR_A0500 | Cockpit plate Floor pan from front hoop to main hoop m | 1 FR_05002

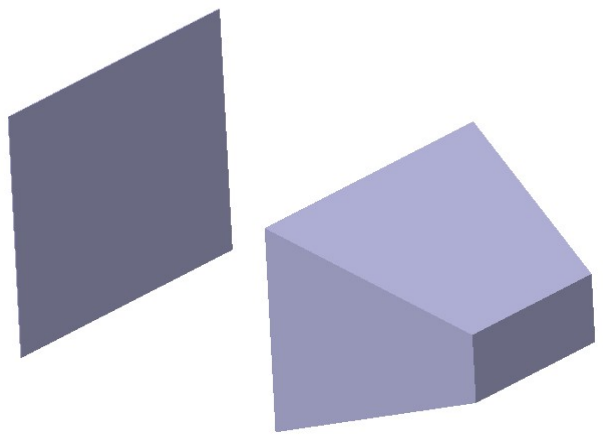
[picture p273: figure]

FR | FR_A0500 | Impact Attenuator FR_05001

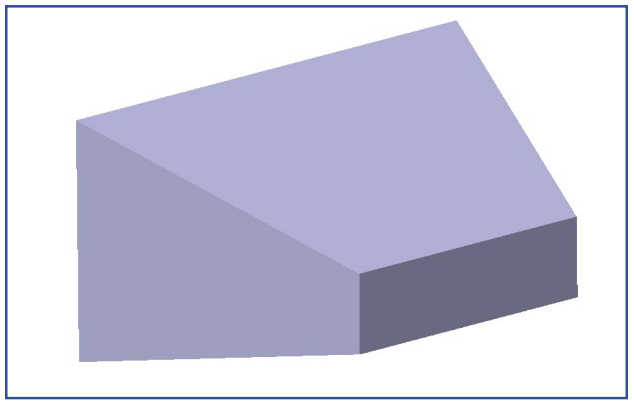
[picture p274: figure]

FR | FR_A0500 | Anti intrusion plate FR_05002

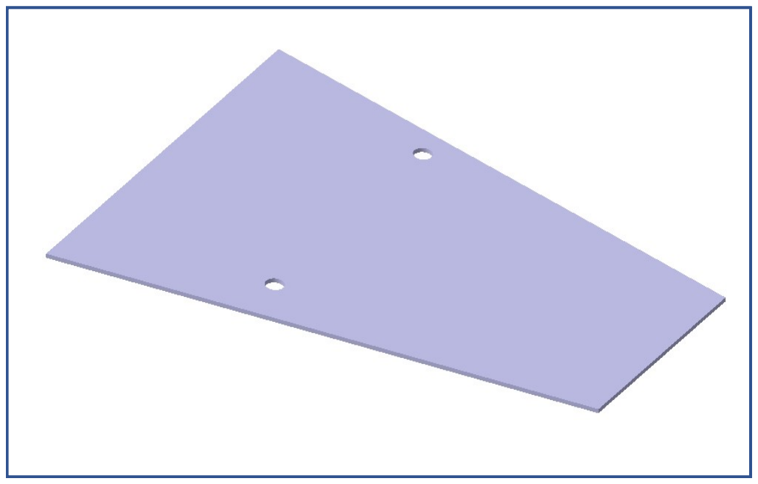
[picture p275: figure]

FR | FR_A0600 | Front plate FR_06001

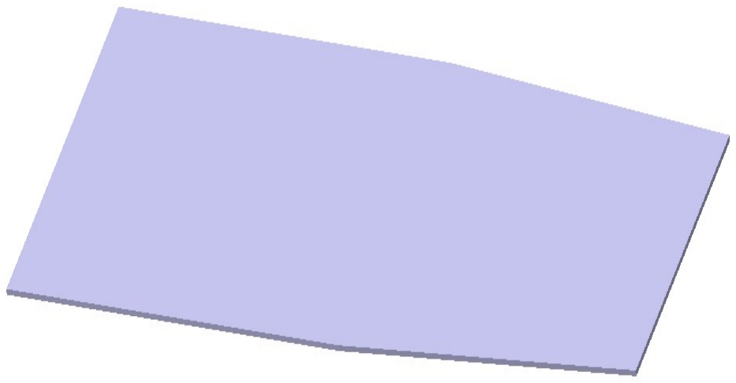
[picture p276: figure]

FR | FR_A0600 | Cockpit plate FR_06002
