EOSCogniton/ELIZ-2021/CR_Cost_Report/ZZ-Ressources/2019_RENDUS_COMPET/Cost_Model_Cost_Report.pdf

## Cost report presentation

## Cost model

The aim of this document is to show the process and philosophy behind the costing method used for the FSAE Cost Event.

### Context and hypothesis

Company description

The simulated company is sized to be a prototyping shop, able to manufacture and assemble most of the components of an FSAE car. Therefore, it will not have in-house specific expensive machinery used for a unique or only few parts of the car. For instance, 3D stereolithography printer used for the air intake, water-jet cutter, …

Of course, the machinery will not be used all the year to build only one FSAE car. Thus, we assume that the remaining time where the equipment is not allocated for the FS project is used for other customers, to build another car, small/medium series of components, prototypes, …

The same hypothesis is used for manpower.

Therefore, the shop is built around:

- Administrative department for marketing, production support (materials orders, invoice, …), finance, …
- Several shop floor workstations:
- A 3 axis Haas CNC Mill VF-3SSYT
- A CNC mill with Y axis Haas ST35-Y
- A CNC laser table FL510HD-1000 from Baileigh
- An assembly station
- A welding station
- A conventional machining area with a mill and a lathe
- A metrological lab
- FAO workstations

Hypothesis

The following assumption are used in the cost model:

- The shop is running 35 hours a week, 46 week per year.
- During the opening time, machines are considered to have an OPE reflecting downtime, preventive maintenance, lack of orders, …
- Manpower of the shop floor are considered to work 95% of the time

Items are attributed a linear depreciation between 3 to 10 years regarding equipment type.

In this simulation is not included:

- Building expense: rent, security, insurance

- VAT for the purchased and sold products
- Governmental taxes
- Margin applied on sell products

Cost model division

It has been chosen to divide the model in several parts.

- Overhead costs : Include all the equipment and expenses needed to run the company.
- Manufacturing cost :
- Machining cost : Equipment like CNC mill and lathe cost are detailed. This cost is added to manpower and overhead cost.
- Assembly cost : This part use cycle time for operation, mix to overhead and manpower cost to reflect the price of assembly.
- Bought parts :
- Materials
- Fasteners

Sources

The cost is built on reliable source to ensure the quality of the model. Machine prices came from Baileigh industrial, Haas machining. Informatic equipment from HP. Metrology equipment are sourced from Mitutoyo, Starrett and Orexad… This is also applicable to fasteners and materials.

General data

Operator are considered to be skilled machinist. Thus, he could manage a CNC machine and program simple parts.

Category | Description | Value | Explanation
Manpower | Operator | 21 376.00 € | Cost per year
| Technician | 39 809.00 €
| Engineer | 69 843.00 €
| Sales/administrative | 39 809.00 €
Time | Hours/week | 35
| Week/year | 46
| Base OPE | 80% | Because prototyping company so not running all time, 6 percent used for maintenance and cleaning of shop floor
| People efficiency | 95% | People not working all time, need to pay them during this time
Energies | Electricity Subscription | 2 874.82 €
| Electricity Rate /kWh | 0.08 €
| Water rate/m³ | 2.22 €
Others | Euro --> Dollar Rate | 1.12964
| TVA | 20%

General Data

### Overhead cost

The overhead cost includes all the equipment and expenses needed to run the company.

Therefore, it takes into account office furniture, items used for different workstations, administrative wages, manpower time used for maintenance purpose, energies cost for small machinery and offices, …

This overhead is then distributed equally between each workstation production in order to annually compensate the overhead expense of the company.

Category | Description | Cost

Depreciation
time (year) | Cost/year
Metrology | Micrometres | 2 320.00 € | 10 | 232.00 €
| Inside micrometers | 1 838.40 € | 10 | 183.84 €
| Indicators | 1 272.00 € | 10 | 127.20 €
| Profile projector | 48 334.81 € | 10 | 4 833.48 €
| Reference Block | 3 209.60 € | 10 | 320.96 €
| Depth gauges | 492.90 € | 10 | 49.29 €
| Measurement column | 5 390.00 € | 10 | 539.00 €
Real Estate | Electricity subscription | 2 874.82 € | 1 | 2 874.82 €
| Electricity consumption for office and small components (avg 16kW) | 1 999.47 € | 1 | 1 999.47 €
| Water (60m^3) | 132.96 € | 1 | 132.96 €
Manwork | Administrative/sales people | 39 809.00 € | 1 | 39 809.00 €
| 40% engineer | 27 937.20 € | 1 | 27 937.20 €
| 5% of manwork OPE on shopfloor | 11 403.29 € | 1 | 11 403.29 €
| Maintenance manwork | 13 108.79 € | 1 | 13 108.79 €
IT | Computers | 6 843.36 € | 3 | 2 281.12 €
| Printer | 192.96 € | 3 | 64.32 €
| Printer consumable (4000 A4pages B&W, 1600 A4pages Colors) | 277.54 € | 1 | 277.54 €
| Office Pack (3 license) | 316.80 € | 1 | 316.80 €
| Dedicated Software (Fusion 360) - 2 license | 796.80 € | 1 | 796.80 €
| Internet/phone access | 1 224.00 € | 1 | 1 224.00 €
| Phone/mobile phone | 381.00 € | 3 | 127.00 €
Office | Office furniture | 200.00 € | 1 | 200.00 €
| Worktable & office storage | 10 550.00 € | 10 | 1 055.00 €
Manufacturing | Band Saw/Drill Press/Sheet metal bender/Hydraulic press/belt and disc grinder/Vise | 19 442.43 € | 10 | 1 944.24 €
| Lifting equipment | 3 259.00 € | 10 | 325.90 €
| Forklift | 1 031.54 € | 10 | 103.15 €
| Roller Cabinet (3 V3 and 3+ V5) | 8 137.45 € | 10 | 813.75 €
| Other specific tools (scribing tool, eletrical pliers, simple measuring tools, …) | 4 068.73 € | 10 | 406.87 €
| Power tools | 4 000.00 € | 5 | 800.00 €
| Consumables (saw blades, drill bits, taps, abrasives, …) | 3 000.00 € | 1 | 3 000.00 €
| Locker | 2 302.57 € | 10 | 230.26 €
| Workstations | 7 066.95 € | 10 | 706.70 €
| Storage equipment (Shelves, drawer, tool cart, boxes, …) | 7 110.13 € | 10 | 711.01 €
| Air compressor | 12 999.00 € | 10 | 1 299.90 €
| Electricity for air compressor (15kW) | 1 874.50 € | 1 | 1 874.50 €
| Industrial Hoovers | 2 150.00 € | 10 | 215.00 €

Overheads cost

### Manufacturing cost

For each equipment, a fixed cost is built around machine, tooling, fixture prices and maintenance cost dedicated to the workstation. It is depreciated as the overhead is. Then is added variable cost like electricity cutting fluid, filler and tools. A ratio is determined to link a machining data (volume, length) to execution time. Finally, it is possible to associate a cost on each operation.

Milling and turning

For both milling and turning, a machine has been selected from Haas catalogue to fulfil most of the production need for the FSAE prototype. A Y axis lathe with live tooling has been preferred to a classic CNC lathe as it allows more versatile machining like sprocket machining and reduce the number of setups.

The company expect to keep its equipment in a proper condition. Therefore, 5 min of operator preventive maintenance (OPM) is included for each job.

The removal rate and programming time has been determined through a CAM analysis of one of our part with Fusion 360. It allows to include machine non-cutting time to obtain an estimation of volume removed per minute.

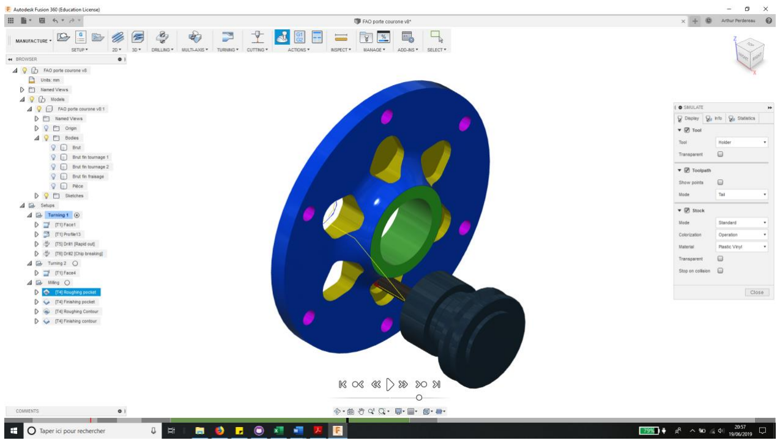
[picture p279: figure]

Programming and metrology operation are added separately to the process in order to show the allocation in the part cost. It is also index on volume removed.

The machine is considered to be managed by an operator. During a first part run in the machine, the operator ensures the program do not have any issue. Coefficient are used for multiple parts as the programming is not needed anymore, and the program is validated through the first run.

The programming of the part could be allocated to an operator, a technician or an engineer regarding part complexity. In this case, the metrology of the part is allocated to the same employee.

For conventional machining, the measurements are included in the machining process.

## OP Description Variable Way of costing Cost Depreciation

## time (year) Cost/year

3 Axis CNC Mill Direct No 108 020.00 € 10 10 802.00 €

Power consumption (kW) 22.4 Milling tool holders No 4 000.00 € 5 800.00 €

OPE 80% Fixtures No 2 500.00 € 5 500.00 €
OPM per job (Cleaning in min) 5 Maintenance No 5 % of initial cost /year 5 401.00 € 1 5 401.00 €

Removal rate (for Aluminium) (min/mm^3) 1.00E-04 Electricity Yes Cost/hour 1.40 €

Programming time and supply order / mm^3

## (50% of machining time) 5.00E-05

Cutting tools Yes €/hour 20.00 €

Measuring and deflash time / mm^3

## (40% of machining time) 4.00E-05

Cutting fluid Yes Refilling/year (1time) 88.03 € 1 88.03 €

Setup time (fixture and tools) (min) 20

CNC lathe with Y Axis No 133 720.00 € 10 13 372.00 €

Power consumption (kW) 29.8 Turning tool holders No 19 200.00 € 10 1 920.00 €

OPE 80% Turning insert holders No 4 800.00 € 5 960.00 €
OPM per job (Cleaning in min) 5 Maintenance No 5 % of initial cost /year 6 686.00 € 1 6 686.00 €

Removal rate (for Aluminium) (min/mm^3) 1.00E-04 Electricity Yes Cost/hour 1.87 €

Programming time and supply order/ mm^3

## (50% of machining time) 5.00E-05

Cutting tools Yes Cost/hour 10.00 €

Measuring and deflash time / mm^3

## (40% of machining time) 4.00E-05

Cutting fluid Yes Refilling/year (1time) 88.03 € 1 88.03 €

Setup time (fixture and tools) (min) 15

Milling machine No 15 000.00 € 10 1 500.00 €

Power consumption (kW) 6 Turning machine No 10 000.00 € 10 1 000.00 €

OPE 44% Tool holders and fixtures No 7 625.00 € 5 1 525.00 €

OPM per job (Cleaning in min) 5 Maintenance No 3 % of initial cost /year 750.00 € 1 750.00 €

Removal rate (for aluminium)

## (include measuring) (min/mm^3) 3.00E-04

Electricity Yes Cost/hour 0.38 €
Setup time (fixture and tools) (min) 10 Cutting tools Yes Cost/hour 10.00 €

Conventionnal machining

Manufacturing cost

Milling

Turning

Laser cutting

Laser cutting removal rate has been chosen from manufacturer spec sheet of the laser cutter.

As this kind of machine is really efficient, it is difficult to index a programming time on the cut length. Therefore, we assume a constant programming time of 1.5 min per part. It is also applicable for measuring operation, that consist of measuring basic part dimensions like holes diameter.

The setup time is related to a full metal sheet with coefficient as it is more realistic.

Welding

The welding rate was estimated thanks to a precise timing of the different steps necessary to weld the exhaust system and all the aluminium parts. The welding rate includes the time of putting in position the parts to be welded, the time of tack welding, the time of welding of course but also the time of metrology.

All the cost of the different of the welding manufacturing machines were found at professional suppliers (Orexad, promeca).

OP | Description | Variable | Way of costing | Cost | Depreciation
time (year) | Cost/year
Laser Cutting Power consumption (kW) 7.5 OPE 70% OPM per job (Cleaning in min) 5 Removal rate (for steel) (min/mm) 4.60E-04 Programation time (min) 1.5 Measuring time (min) 1 Setup time (min) 8 | 2D Laser cut | No | | 185 010.27 € | 10 | 18 501.03 €
| Maintenance | No | 5 % of initial cost /year | 9 250.51 € | 1 | 9 250.51 €
| Electricity | Yes | Cost/hour | 0.47 €
| Assist Gas O2 or air | Yes | Cost/hour | 5.07 €

Manufacturing cost

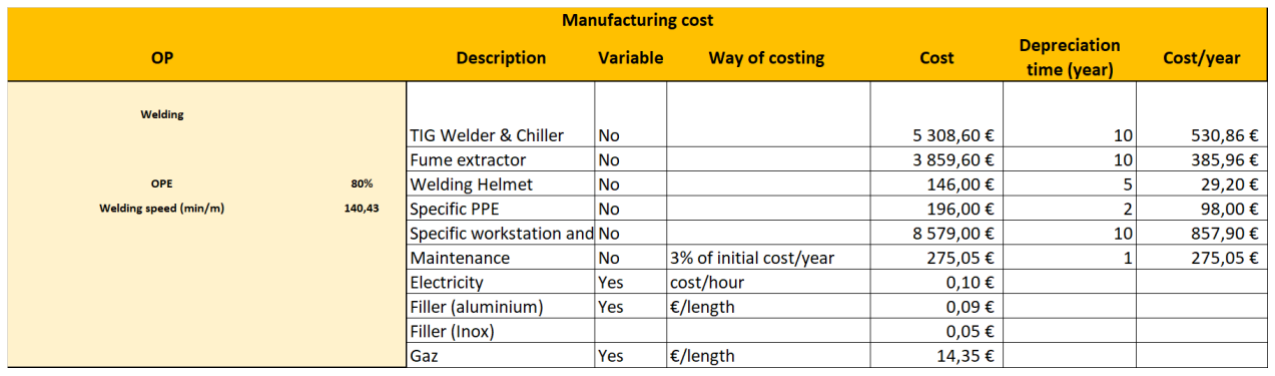
[picture p280: figure]

### Processes cost

Thanks to the established cost model, a cost / hour for each employee, fixing cost included, was determined.

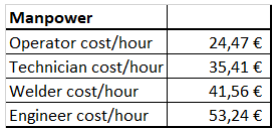
[picture p281: figure]

In order to determine the rest of the processes cost, the different time for each process were methodically timed during vehicle integration. All the details of the processes cost can be found on the summary.

### Fasteners cost

All the fasteners cost used are the one of the team suppliers (TDI visserie, k-Nut, Oreca, …). The price indicated by unit is always the one with taxes (TTC). The one calculated in the column Price when a quantity is entered is without taxes (HT).

All the details of the fasteners cost can be found on the summary.

### Materials cost

Concerning the materials cost, prices between suppliers have been compared to obtain a right price.

Concerning the raw materials, a study was realised to see the influence of the dimensions on the price by mm^3. As the differences of price observed for the dimensions of materials used for Engine & Powertrain were very low, it was decided to keep a unique price (€/mm^3) for each material. Same conclusions for the metal sheet materials.

All the details of the materials cost can be found on the summary.

### Summary

Overhead summary

Fixed Cost | Sum of fixed cost/year (+5% extra equipment integrated) | 128 441.42 €
| Fixed cost/hour to charge on operation (machine/station/programing/metrology) | 11.78 €
Manpower cost | Operator cost/hour | 12.69 €
| Technician cost/hour | 23.63 €
| Welder cost/hour | 29.77 €
| Engineer cost/hour | 41.46 €

Overhead Summary

Manufacturing summary

Milling For aluminium as standard Price for cutting Steel 250% Price for cutting Delrin 50% | Yearly fixed cost of machine | 17 591.03 €
| Fixed cost of machine / hour | 25.56 €
| Cost of machine/hour running | 46.96 €
Cost of machining part (€/mm^3) | 9.94E-05
Manpower part of machining cost | 21%
Cost of programing part Operator (€/mm^3) | 2.04E-05
Cost of programing part Technician(€/mm^3) | 2.95E-05
Cost of programing part Engineer (€/mm^3) | 4.44E-05
Cost of measuring part Operator (€/mm^3) | 1.63E-05
Cost of measuring part Technician(€/mm^3) | 2.36E-05
Cost of measuring part Engineer (€/mm^3) | 3.55E-05
Cost of Setup + cleaning | 15.94 €
Turning For aluminium as standard Price for cutting Steel 250% Price for cutting Delrin 50% | Yearly fixed cost of machine | 23 026.03 €
| Fixed cost of machine / hour | 29.82 €
| Cost of machine/hour running | 41.68 €
Cost of machining part (€/mm^3) | 9.06E-05
Manpower part of machining cost | 23%
Cost of programing part Operator (€/mm^3) | 2.04E-05
Cost of programing part Technician(€/mm^3) | 2.95E-05
Cost of programing part Engineer (€/mm^3) | 4.44E-05
Cost of measuring part Operator (€/mm^3) | 1.63E-05
Cost of measuring part Technician(€/mm^3) | 2.36E-05
Cost of measuring part Engineer (€/mm^3) | 3.55E-05
Cost of Setup + cleaning | 14.17 €
Laser cutting For steel as standard Price for cutting aluminium 72% | Yearly fixed cost of machine | 27 751.54 €
| Fixed cost of machine / hour | 36.62 €
| Cost of machine/hour running | 42.17 €
Cost of machining part (€/mm) | 3.62E-04
Manpower part of machining cost | 27%
Cost of programing part Operator (€) | 0.61 €
Cost of programing part Technician(€) | 0.89 €
Cost of measuring part Operator (€) | 0.41 €
Cost of measuring part Technician(€) | 0.59 €
Cost of Setup + cleaning | 10.68 €
Welding | Yearly fixed cost of machine | 2 176.97 €
| Fixed cost of machine / hour | 13.49 €
| Cost of machine/hour running | 13.59 €
Cost of aluminium welding part (€/m) | 115.92 €
Cost of steel welding part (€/m) | 115.89 €
Conventionnal machining | Yearly fixed cost of machine | 4 775.00 €
| Fixed cost of machine / hour | 18.58 €
| Cost of machine/hour running | 28.96 €
Cost of machining part (€/mm^3) | 2.08E-04
Cost of Setup + cleaning | 7.82 €

Manufacturing Summary

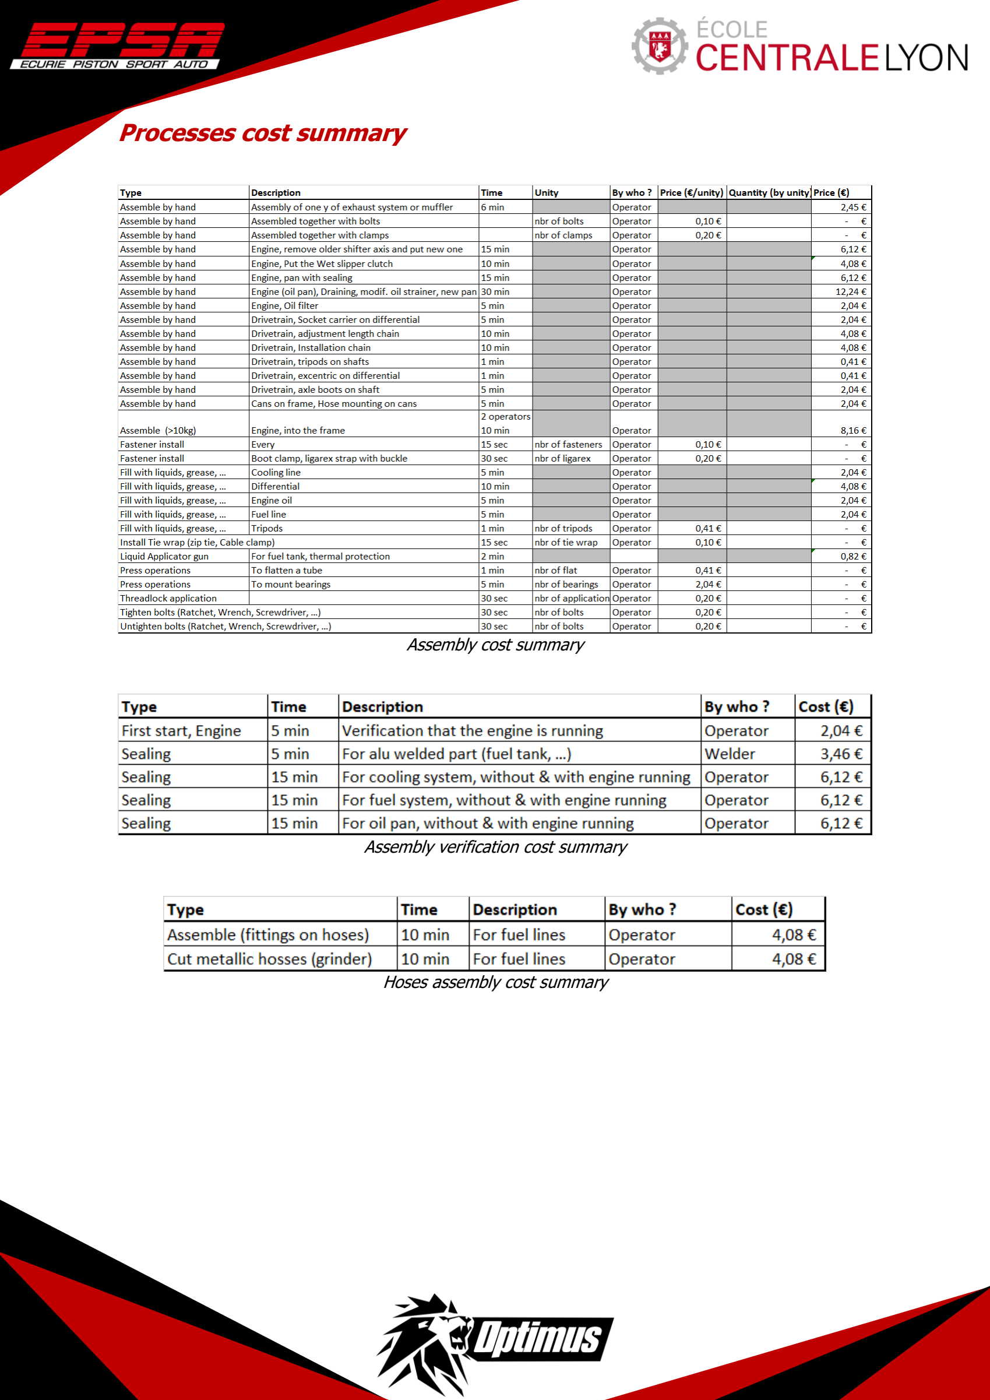
[picture p282: page 10]

### Processes cost summary

Assembly cost summary

Assembly verification cost summary

Hoses assembly cost summary

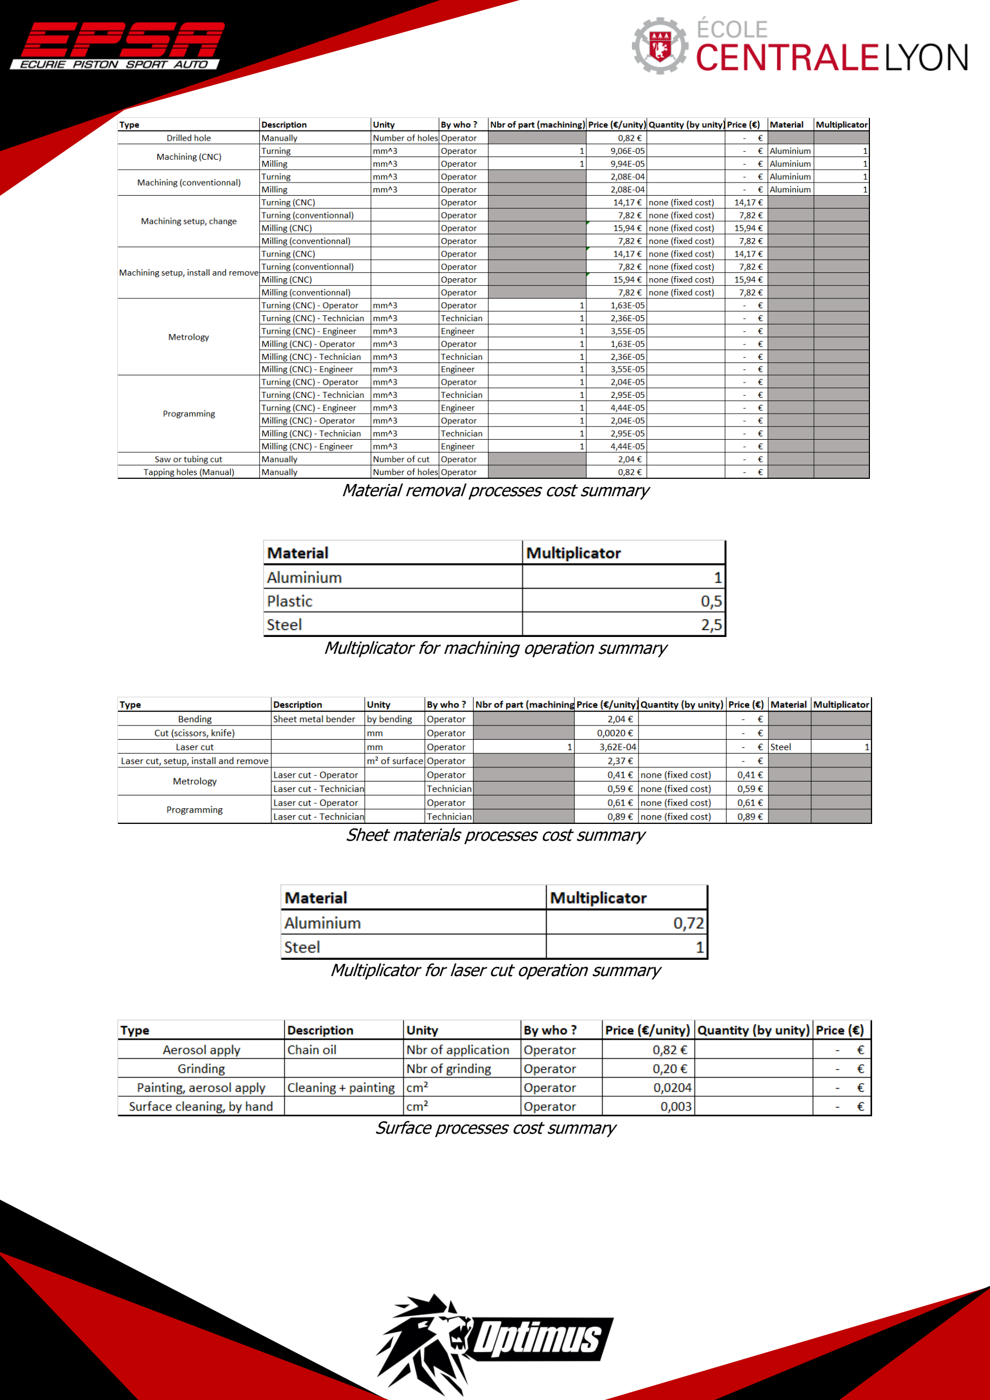
[picture p283: page 11]

Material removal processes cost summary

Multiplicator for machining operation summary

Sheet materials processes cost summary

Multiplicator for laser cut operation summary

Surface processes cost summary

Welding operation cost summary

### Fasteners cost summary

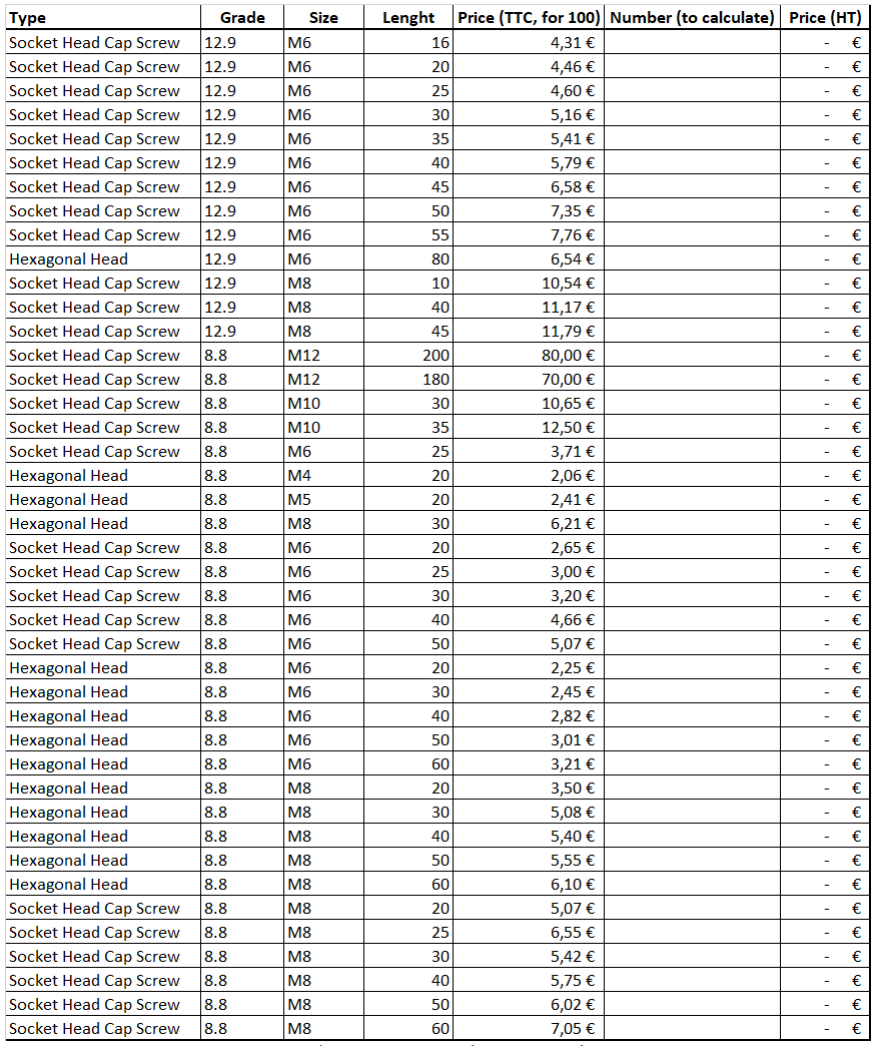
[picture p284: figure]

Bolts cost summary (source : TDI)

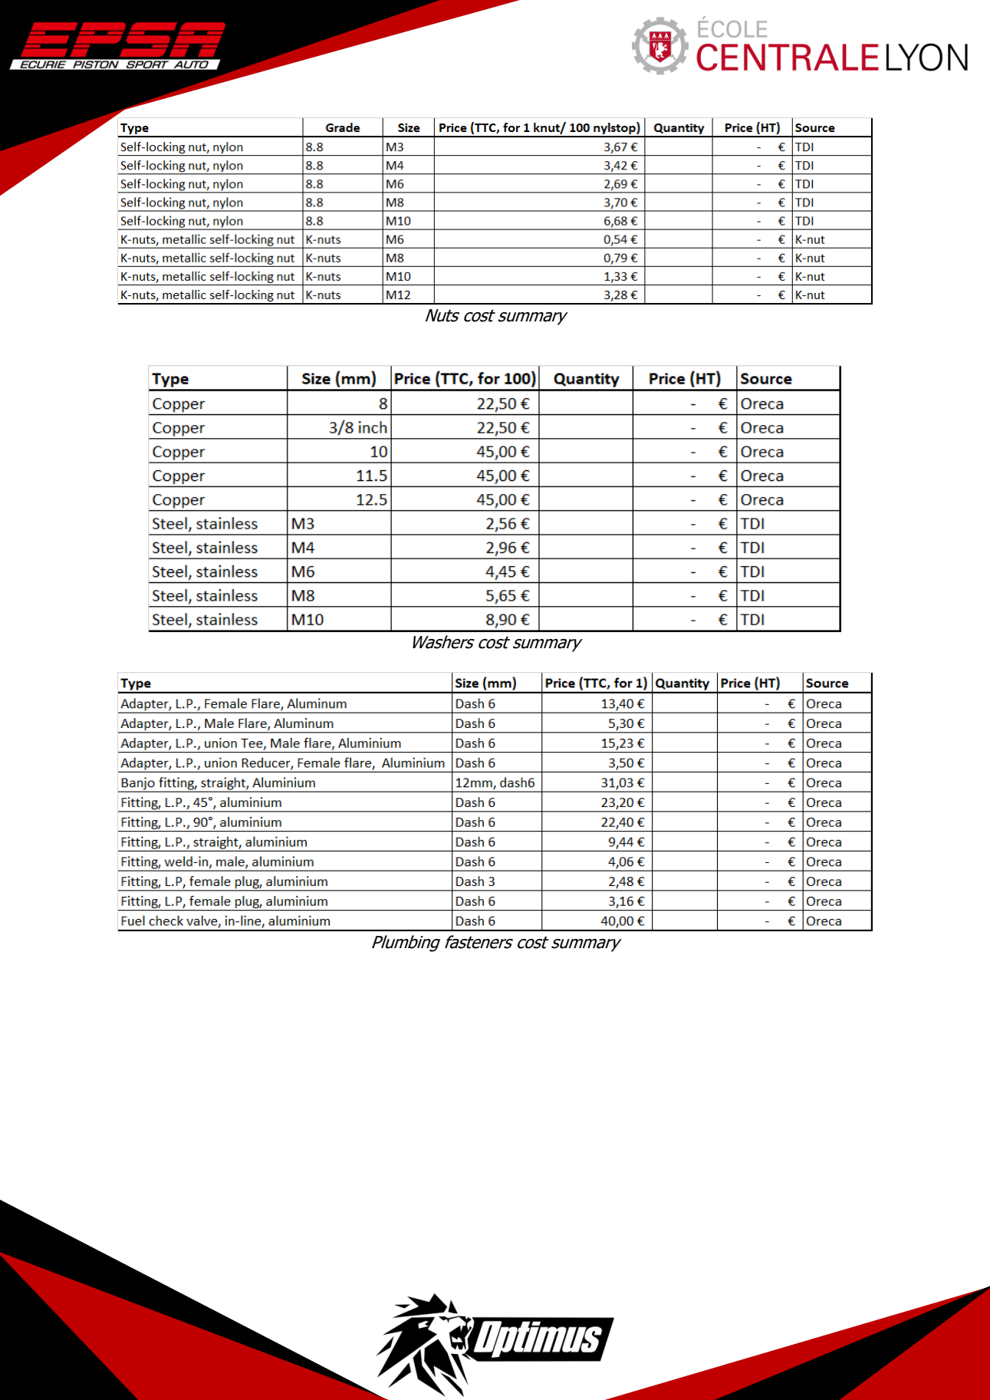
[picture p285: page 14]

Nuts cost summary

Washers cost summary

Plumbing fasteners cost summary

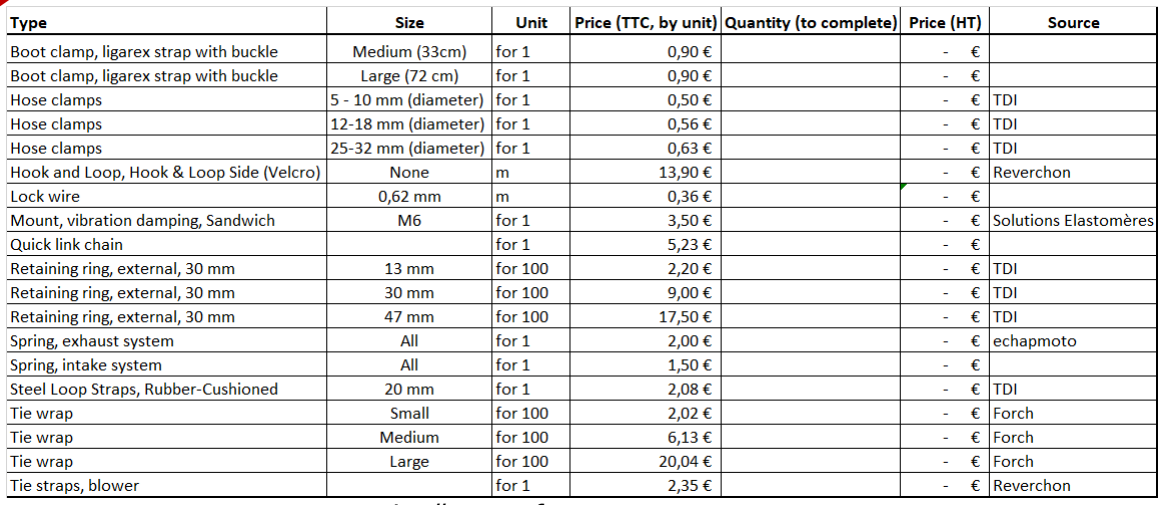
[picture p286: figure]

Miscellaneous fasteners cost summary

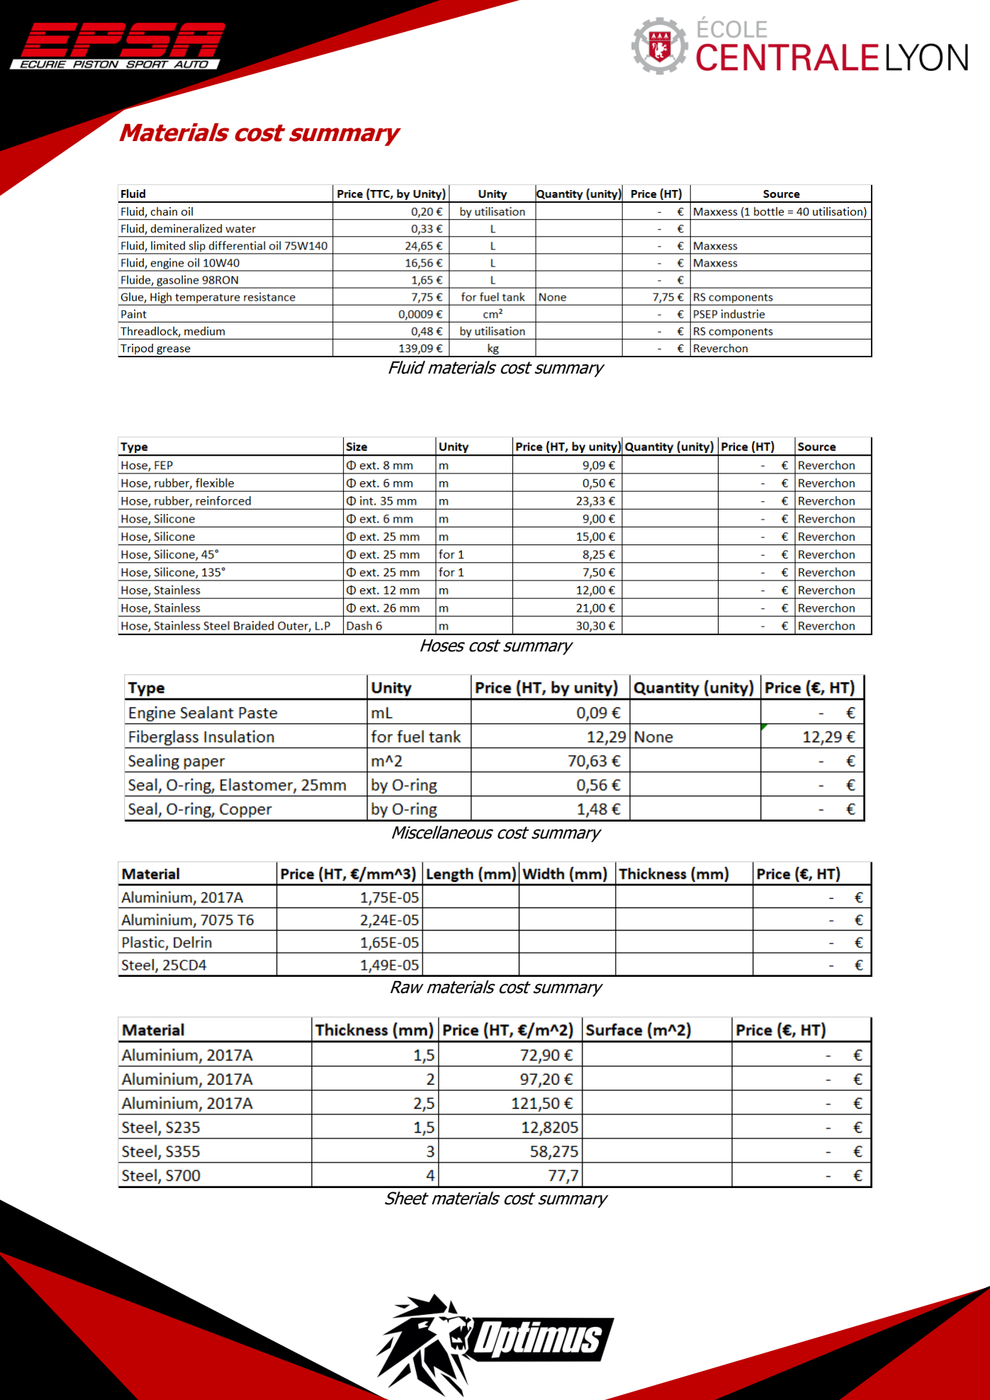
[picture p287: page 16]

### Materials cost summary

Fluid materials cost summary

Hoses cost summary

Miscellaneous cost summary

Raw materials cost summary

Sheet materials cost summary

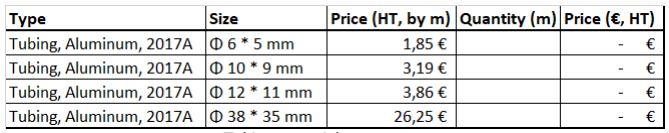
[picture p288: figure]

Tubing materials cost summary

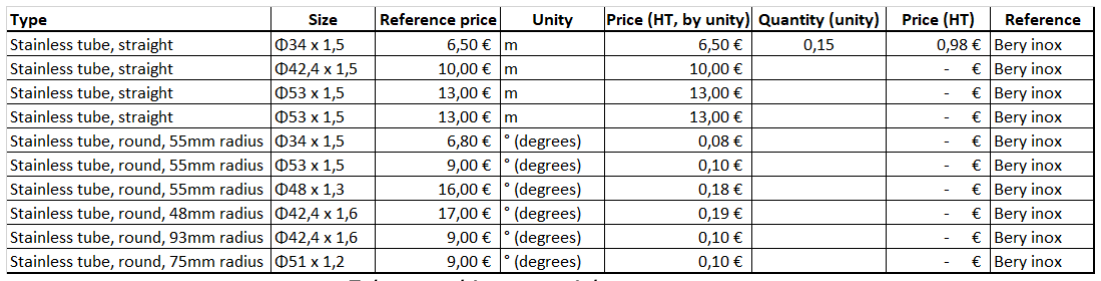
[picture p289: figure]

Exhaust tubing materials cost summary
