EOSCogniton/ELIZ-2021/CR_Cost_Report/03-FR-CBOM/CRD_EPSA/CRD_EPSA_2021/COST_Explanation_file_EPSA.pdf

# Cost & Manufacturing Event

## Cost Explanation file

This document details the Cost Model of the Ecurie Piston Sport Auto (EPSA) team. It aims at clarifying the construction of the CBOM presented at the FSUK Cost Event. To do so, it explains the costing method used which means, the assumptions and calculations done.

### Context and hypothesis

Company description
The simulated company is sized to be a prototyping center, able to manufacture and assemble most of the components for the frame and the body of a Formula Student car. Therefore, it will not have in-house specific expensive machineries used for a unique or only few parts of the Frame & Body System. For instance, 3 axis CNC Mills or CNC lathes will not be part of the investments. Nonetheless they will be considered as outsources expenses.

Of course, the company, its machinery and manpower, will not be dedicated all year long to build only one or few Formula Student frames. Thus, we assume that the remaining time, when the equipment is not allocated for the FS project, is used for other customers, to build other car frames, small/medium series of components, prototypes, …

Therefore, the company is composed with :
- Administrative Division: This division gathers the services that run the business. As it is a really small company that is simulated, we suppose it is held by only one person that has the salary equivalent to the salary of aTechnician in France.
- Operational Division: This division is directly related to the lifecycle of the products.
- Research & Development
- Manufacturing &Assembly Service

Hypothesis
In order to provide a better simulation of the expenses, the model is based on the following assumptions:
The general organisation:
- The company is French.That is why it follows the french labour laws.
- It is running 35 hours a week, 46 weeks per year.
The effectiveness of the company:
- During the opening time, machines are considered to have an Overall Production Effectiveness (OPE) reflecting downtime, preventive maintenance, lack of orders,…
- Manpower of the shop floor are considered to work 95% of the time
The workforce:
- Operators are considered to be skilled machinists. Thus, he could manage a CNC machine and program simple parts.
- D’autres hypothèses sur les autres postes
The expenses:
- Items are attributed a linear depreciation between 3 to 10 years regarding equipment type.
- Building expense (rent, security, insurance) are not included
- VAT for the purchased and sold products are not included
- Governmental taxes are not included
- Margin applied on sell products are not included

Cost model division
The cost model has been divided in the following parts:
Overhead costs : This section includes all the expenses needed to run the company:
- Furniture
- Office consumables...
Manufacturing cost : This section includes all the expenses needed to the production:
- Manpower
- Machining cost
- Assembly cost
Bought parts :
- Materials
- Fasteners

Overall information

First, we need to introduce some data that will be necessary in many costs calculations:

General Data
Category | Description | Value | Explanation
Administrative Workforce | Sales/Administratives | 50 414,81 € | Cost per year
| Welder | 43 935,00 € | Cost per year
| Operator | 36 901,56 €
| Technician | 50 414,81 €
| Engineer | 59 295,58 €
| Hours/week | 35 | French labour law impose this minimal rate to earn the min wage
| Week/year | 45 | Total of week per year without, holiday, bank holiday…
| Base OPE | 80% | It is a prototyping company, soit does not run nonstop. 6%: maintenance and cleaning of shop floor
| People efficiency | 95% | People cannot be working nonstop.
| Electricity Subscription | 3 449,78 €
| Electricity Rate /kWh | 0,09 €
| Water rate/m3 | 3,32 €
| Euro to Dollar Rate | 1,2076 | The 13/05/2021 rate
| VAT | 20% | FrenchVAT

Operative
Workforce

Time

Energies

Others

Moreover, the company owns several shop floor workstations :
- A laser tube cutting machine
- 2 CNC mills: one for wood milling, the other for metal milling
- A CNC laser table
- A sheet metal bender
- An assembly station
- A welding station
- Machines to produce body (air compressor, spray workstation, woodworkstation…)
- A conventional machining area with a mill and a lathe

- A metrological lab
- FAO workstations

Sources
The cost is built on reliable sources to ensure the quality of the model. Machine prices came from providers such as Baileigh industrial, Haas machining,... Informatic equipment comes from HP. Metrology equipment are sourced from Mitutoyo, Starrett and Orexad… This is also applicable to fasteners and materials. When we needed equipment and were not able to find a reliable source, we asked prices of these components to our partners and providers.

### Overhead cost

The overhead cost includes all the equipment and expenses needed to run the company. Therefore, it takes into account office furniture, items used for different workstations, administrative wages, manpower time used for maintenance purposes, energy cost for small machinery and offices, …
This overhead is then distributed equally between each workstation production in order to annually compensate the overhead expense of the company.

Overheads cost
Category | Description | Cost (incl tax) | Depreciation time (year) | Cost/year
| Administrative/sales people | 50 414,81 € | 1 | 50 414,81 €
| 50% engineer | 29 647,79 € | 1 | 29 647,79 €
| 5% of manwork OPE on shopfloor | 9 538,36 € | 1 | 9 538,36 €
| Maintenance manwork | 4 990,86 € | 1 | 4 990,86 €
| Electricity subscription | 3 449,78 € | 1 | 3 449,78 €
| Electricity consumption for office and small components (avg 16kW) | 2 373,05 € | 1 | 2 373,05 €
| Water (60m^3) | 199,44 € | 1 | 199,44 €
| Softwares | 911,12 € | 1 | 911,12 €
| Printer | 269,90 € | 3 | 89,97 €
| Printer consumable (4000 A4pages B&W, 1600 A4pages Colors,A4x5000,A3x2000) | 392,57 € | 1 | 392,57 €
| Computers and accessories | 14 911,80 € | 3 | 4 970,60 €
| Internet/phone access | 1 468,80 € | 1 | 1 468,80 €
| Phone/mobile phone | 1 598,40 € | 3 | 532,80 €
| Office furniture | 200,00 € | 1 | 200,00 €
| Worktable & office storage | 16 747,20 € | 10 | 1 674,72 €
| Manufacturing tools (Band Saw, Drill, Metal bender, belt and disc grinder,Vise, forklift…) | 22 917,65 € | 10 | 2 291,76 €
| Consumables (saw blades, drill bits, taps, abrasives, …) | 3 000,00 € | 1 | 3 000,00 €
| Roller Cabinet (3V3 and 3V5) | 10 266,00 € | 10 | 1 026,60 €
| Other specific tools (scribing tool, eletrical pliers, simple measuring tools, …) | 5 133,00 € | 10 | 513,30 €
| Shopfloor organisation equipement (locker, shelves, drawer…) | 33 591,00 € | 10 | 3 359,10 €
| Industrial Hoovers | 2 580,00 € | 10 | 258,00 €
| Micrometres | 2 416,67 € | 10 | 241,67 €
| Inside micrometers | 1 915,00 € | 10 | 191,50 €
| Indicators | 998,33 € | 10 | 99,83 €
| Profile projector | 48 334,81 € | 10 | 4 833,48 €
| Reference Block | 3 343,33 € | 10 | 334,33 €
| Depth gauges | 513,33 € | 10 | 51,33 €
| Measurement column | 5 390,00 € | 10 | 539,00 €

Manwork

Energy
Consumptio
n

IT&Office

Manufacturi
ng

Metrology

Overhead Summary
Fixed Cost | Sum of fixed cost/year (+5% extra equipment integrated) | 133 974,31 €
| Fixed cost/hour to charge on operation (machine/station/programing/metrology) | 16,29 €
Manpower cost | Operator cost/hour | 23,38 €
| Welder cost/hour | 27,83 €
| Technician cost/hour | 31,94 €
| Engineer cost/hour | 37,56 €

### Manufacturing cost

For each equipment, a fixed cost is built around machine, tooling, fixture prices and maintenance cost dedicated to the workstation. It is depreciated as the overhead is. Then is added variable cost like electricity cutting fluid, filler and tools. A ratio is determined to link a machining data (volume, length) to execution time. Finally, it is possible to associate a cost on each operation.

Milling and turning

Turning was quite particular. Indeed as there are really few parts to turn in the system Frame&Body that we studied, we considered that the company owned a conventional lathe and its price was added to the fixed cost of the overall company. This is why, when it comes to turning, only the fixed costs and the cost of manpower are considered.

For metal milling, a machine has been selected from Haas catalogue to fulfil most of the production need for the FSAE prototype.A Y axis lathe with live tooling has been preferred to a classic CNC lathe as it allows more versatile machining like sprocket machining and reduce the number of setups. The wood milling machine was chosen thanks to the partner that helps us to do the Bodywork. The company expects to keep its equipment in a proper condition. Therefore, 5 min of operator preventive maintenance (OPM) is included for each job.
The removal rate and programming time has been determined through a CAM analysis of one of our parts with Fusion 360. It includes machine non-cutting time in the estimation of volume removed per minute.

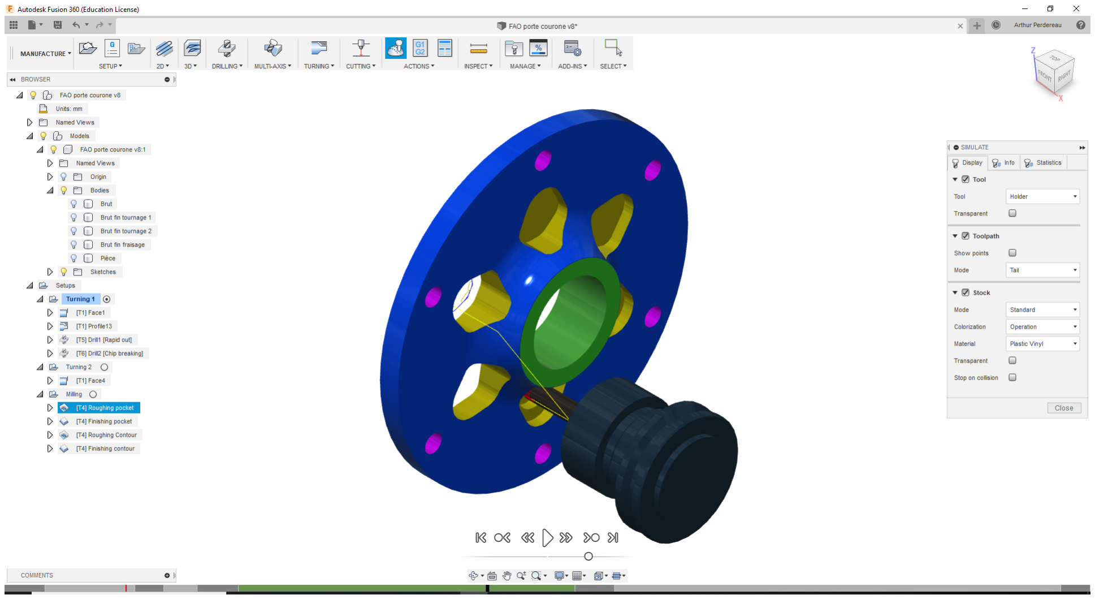
[picture p290: figure]

Programming and metrology operations are added separately to the process in order to show the allocation in the part cost. It is also indexed on volume removed.
The machine is considered to be managed by an operator. During a first part run in the machine, the operator ensures the program does not have any issue. Coefficients are used for multiple parts as the programming is not needed anymore, and the program is validated through the first run.
The programming of the part could be allocated to an operator, a technician or an engineer regarding part complexity. In this case, the metrology of the part is allocated to the same employee. For conventional machining, the measurements are included in the machining process.

Manufacturing cost: Machinery performances
Operating performances of the Machine | Spec
Milling
Power consumption (kW) | 22,40
OPE | 80%
OPM per job (Cleaning in min) | 5
Removal rate (forAluminium) (min/mm^3) | 1,00E-04
Programming time and supply order (min/ mm^3) (50% of machining time) | 5,00E-05
Measuring and deflash time (min/ mm^3) (40% of machining time) | 4,00E-05
Setup time per job (fixture and tools) (min) | 20

Conventionnal machining
Power consumption (kW) | 6
OPE | 44%
OPM per job (Cleaning in min) | 5
Removal rate (for aluminium) (include measuring) (min/mm^3) | 3,00E-04
Setup time (fixture and tools) (min) | 10

Manufacturing cost : Equipement Costs

Description | Variable | Way of costing | Cost

Depreciation
time (year)

Cost/year

| | Milling
3Axis CNC Mill Direct | No | | 95 994,00 € | 10 | 9 599,40 €
Milling tool holders | No | | 4 800,00 € | 5 | 800,00 €
Fixtures | No | | 2 500,00 € | 5 | 500,00 €
Maintenance | No | 5 % of initial cost each year | 4 799,70 € | 1 | 4 799,70 €
Cutting fluid | No | 200L/year | 2 116,00 € | 1 | 2 116,00 €
Electricity | Yes | €/hour | 1,68 €
Cutting tools | Yes | €/hour | 20,00 €

Conventionnal
Conventionnal milling machine | No | | 18 000,00 € | 10 | 1 800,00 €
Conventionnal turning machine | No | | 12 000,00 € | 10 | 1 200,00 €
Tool holders and fixtures | No | | 28 073,50 € | 5 | 5 614,70 €
Maintenance | No | 3 % of initial cost /year | 900,00 € | 1 | 900,00 €
Electricity | Yes | €/hour | 0,25 €
Cutting tools | Yes | €/hour | 10,00 €

Laser cutting

Laser cutting removal rate has been chosen from the manufacturer spec sheet of the laser cutter. As this kind of machine is really efficient, it is difficult to index a programming time on the cut length. Therefore, we assume a constant programming time of 2 min per part. It is also applicable for measuring operations that consist of measuring basic part dimensions like holes diameter.
The setup time is related to a full metal sheet with coefficient as it is more realistic.
For 3D laser cutting, all the performances were discussed with the partner that welds the frame tubes with us. Especially for the programming and operation times.

Manufacturing cost: Machinery performances
Operating performances of the Machine | Spec
2D Laser Cutting
Power consumption (kW) | 7,5
OPE | 70%
OPM per job (Cleaning in min) | 5
Removal rate (for steel) (min/mm²) | 1,37E-04
Programmation time (min) | 2
Measuring time (min) | 1
Cost of Oxygen (€/mm²) | 0,0000334 €
Setup time (min) | 8

3D Laser Cutting
Power consumption (kW) | 6
OPE | 80%
OPM per job (Cleaning in min) | 5
Programmation time and supply order (min/tube) | 10
Time of operation per tube (s/tube) if raw < 6m (setup + cutting) | 613
Time of operation per tube (s/tube) if raw > 6m (setup + cutting) | 373

Manufacturing cost : Equipment Costs

Description | Variable | Way of costing | Cost

Depreciation
time (year)

Cost/year

| | 2D Laser Cutting
2D Laser cut | No | | 120 726,40 € | 10 | 12 072,64 €
Maintenance | No | 5 % of initial cost each year | 6 036,32 € | 1 | 6 036,32 €
Electricity | Yes | Cost/hour | 0,49 €

3D Laser Cutting
Laser cutter tube fiber | No | | 1 000 000,00 € | 7 | 142 857,14 €
Maintenance | No | estimated by our partner | 10 000,00 € | 1 | 10 000,00 €
Consumables | No | | 1 500,00 € | 1 | 1 500,00 €
Water draining | No | | 1 500,00 € | 1 | 1 500,00 €
Electricity | Yes | €/hour | 0,45 €

Welding

The welding rate was estimated thanks to a precise timing of the different steps necessary to weld the exhaust system and all the aluminium parts that the team used to do before when it was doing thermic combustion cars. The welding rate includes the time of putting in position the parts to be welded, the time of tack welding, the time of welding of course but also the time of metrology.
All the cost of the welding manufacturing machines were found at professional suppliers (Orexad, promeca).

Manufacturing cost: Machinery performances
Operating performances of the Machine | Spec
Welding
Power consumption (kW) | 4,96
OPE | 80%
OPM per job (Cleaning in min) | 2
Welding speed (min/m) | 1,40E+02
Setup time (min) | 2

Manufacturing cost : Equipment Costs

Description | Variable | Way of costing | Cost

Depreciation time
(year)

Cost/year

| | Welding
TIG Welder &Chiller | No | | 7 129,69 € | 10 | 712,97 €
Fume extractor | No | | 3 546,58 € | 10 | 354,66 €
Welding table | No | | 5 220,00 € | 10 | 522,00 €
Specific welding tools | No | | 1 815,60 € | 5 | 363,12 €
EPI (Welmet, gloves,…) | No | | 298,12 € | 5 | 59,62 €
Maintenance | No | 5 % of initial cost each year | 533,81 € | 1 | 533,81 €
Electricity | Yes | €/hour | 0,47 €
Filler (35CrMo4) | Yes | €/m | 4,89 €
Gaz | Yes | €/m | 14,35 €

### Processes cost

Thanks to the cost model, a cost / hour for each employee, fixing cost included, was determined.

Manpower | Hourly Wage (€/h/employee)
Operator -Grade 4 | 23,38 €
Operator -Grade 9 Welder | 27,83 €
Technician -Grade 23 | 31,94 €
Engineer -Grade II | 37,56 €

In order to determine the rest of the process's cost, the different time for each process were methodically timed during previous vehicle integration. All the details of the process's cost can be found in the summary.

### Fasteners cost

All the fasteners cost used are the one of the team suppliers (TDI visserie, k-Nut, Oreca, …). The price indicated by the unit is always the one with taxes (TTC). The one calculated in the column Price when a quantity is entered is without taxes (HT). All the details of the fasteners cost can be found on the summary.

### Materials cost

Concerning the materials cost, prices between suppliers have been compared to obtain a right price. Concerning the raw materials, a study was realised to see the influence of the dimensions on the price by mm^3. As the differences of price observed for the dimensions of materials used for Engine & Powertrain were very low, it was decided to keep a unique price (€/mm^3) for each material. Same conclusions for the metal sheet materials.

Materials | Steel S235 | Steel S355 | Steel S700 | Steel 25CD4 | Alu 2017A | Alu 7075T6
Chemical composition | S235 | S355 | S700 | 24CrMo 5 | AlCu4MgSi | AlZn6MgCu
Tensile Strength: Yield (MPa) | 235 | 355 | 700 | 350 | 120 | 480

All the details of the materials cost can be found on the summary.

### Summary

Manufacturing Summary
Comments | Costs
Milling
Prices calculated for aluminium | | Cost of the Machinery
Corrective factor if material = steel | 250% | Yearly fixed cost of machine | 17815
Corrective factor if material = Delrin | 50% | Fixed cost of machine / hour | 3,04E+01
| | Total cost of machine/hour (+ variable costs) | 5,21E+01
| | Cost of the Process
| | Cost of machining part (€/mm^3) | 1,26E-04
| | Manpower part of machining cost | 31%

x = volume (mm^3) removed from the piece c1 = x* cost of the machining part
c2 =x * (cost of programming + measuring) c3 = fixed cost of setup + cleaning

Cost of the piece
=
c1 +c2+c3

Other costs
Cost of programing part Operator (€/mm^3) | 3,31E-05
Cost of programing partTechnician(€/mm^3) | 4,61E-05
Cost of programing part Engineer (€/mm^3) | 5,45E-05
Cost of measuring part Operator (€/mm^3) | 2,64E-05
Cost of measuring partTechnician(€/mm^3) | 3,69E-05
Cost of measuring part Engineer (€/mm^3) | 4,36E-05
Cost of Setup + cleaning | 2,24E+01
3D Laser Cutting
Prices calculated for steel | | Cost of the Machinery
Corrective factor if material = aluminium | 50% | Yearly fixed cost of machine | 155 857,14 €
Corrective factor if material = Delrin | 25% | Fixed cost of machine / hour | 1,40E+02
| | Total cost of machine/hour (+ variable costs) | 1,40E+02
| | Cost of the Process
| | Cost of machining part if raw < 6m (€/tube) | 2,78E+01
| | Cost of machining part if raw > 6m (€/tube) | 1,69E+01
| | Manpower part of machining cost (average) | 14%

x =nb of tubes
c1 = x* cost of the machining part c2 =x * cost of programming c3 = fixed cost of cleaning

Cost of the piece
=
c1 +c2+c3

Other costs
Cost of programing part Operator (€/tube) | 6,61E+00
Cost of programing partTechnician(€/tube) | 8,04E+00
Cost of programing part Engineer (€/tube) | 8,98E+00
Cost Cleaning (setup included in operation time) | 1,36E+01
2D Laser Cutting
Prices calculated for steel | | Cost of the Machinery
Corrective factor if material = aluminium | 42% | Yearly fixed cost of machine | 18 108,96 €
| | Fixed cost of machine / hour | 3,27E+01
| | Total cost of machine/hour (+ variable costs) | 3,32E+01

x =nb of mm to cut
y = nb of mm² to cut = x*thickeness c1 = y* cost of the machining part c2 =y * cost of oxygen
c3 = y* prog and measuring part c4 = fixed cost of cleaning Cost of the piece
= c1 +c2 c3+ c4
| Cost of the Process
Cost of machining part (€/mm) | 1,29E-04
Cost of oxygen (€/mm) | 0,0000334 €
Manpower part of machining cost (average) | 41%
Other costs
Cost of programing and measuring part Operator (€) | 1,32E+00
Cost of programing and measuring partTechnician(€) | 1,61E+00
Cost of programing and measuring part Engineer (€) | 1,80E+00
Cost Cleaning (setup included in operation time) | 12,15 €
Tube Welding

c1 = lenght to weld * welding speed* cost of the machine
c2 =lenght to weld * cost of filler gas and metal
c3 = hours of welder work * welder hourly salary * nb of welders
C = c1+c2 + c3
Yearly fixed cost of machine | 2 546,18 €
Fixed cost of machine / hour | 1,83E+01
Total cost of machine/hour (+ variable costs) | 1,88E+01
Cost of the Process
Cost of filler metal (€/m) | 4,89 €
Cost of filler gas (€/m) | 14,35 €
Total Manpower cost for welding the frame (discussion with our partner) | 6 680,01 €

Bracket Welding

x =nb of m to weld/ t1 = time of wood coding design / t2 = time of wood coding manufacturing / t3 = time for positioning the bracket
c1 = x* cost of the machining part
c2 =x * cost of material
c3 = fixed cost of cleaning
c4 = t1*cost of engineer + t2 * cost of technician+ t3 * cost of welder Cost of the piece
= c1 +c2 c3+ c4
Yearly fixed cost of machine | 2 546,18 €
Fixed cost of machine / hour | 1,83E+01
Total cost of machine/hour (+ variable costs) | 1,88E+01
Cost of the Process
Cost of filler metal and gas (€/m) | 19,25 €
Cost of machining part (€/m) | 174,23 €
Manpower part of machining cost (average) | 75%
Other costs for wood coding parts
Cost of wood coding conception by an Engineer (€/h of conception) | 37,56 €
Cost of wood coding manufacturing by aTechnician (€/min) | 0,53 €
Cost of positioning the brackets by Welder (€/min) | 0,46 €
Conventionnal Machining

x = volume (mm^3) removed from the piece c1 = x* cost of the machining part
c2 = fixed cost of setup + cleaning

Cost of the piece = c1 +c2

Yearly fixed cost of machine | 9 514,70 €
Fixed cost of machine / hour | 3,00E+01
Cost of machine/hour running | 4,02E+01
Cost of the Process
Cost of machining part (€/mm^3) | 1,98E-04
Cost of Setup + cleaning | 8,89E+00
Body Manufacturing
Yearly fixed cost of machine | 52 088,34 €

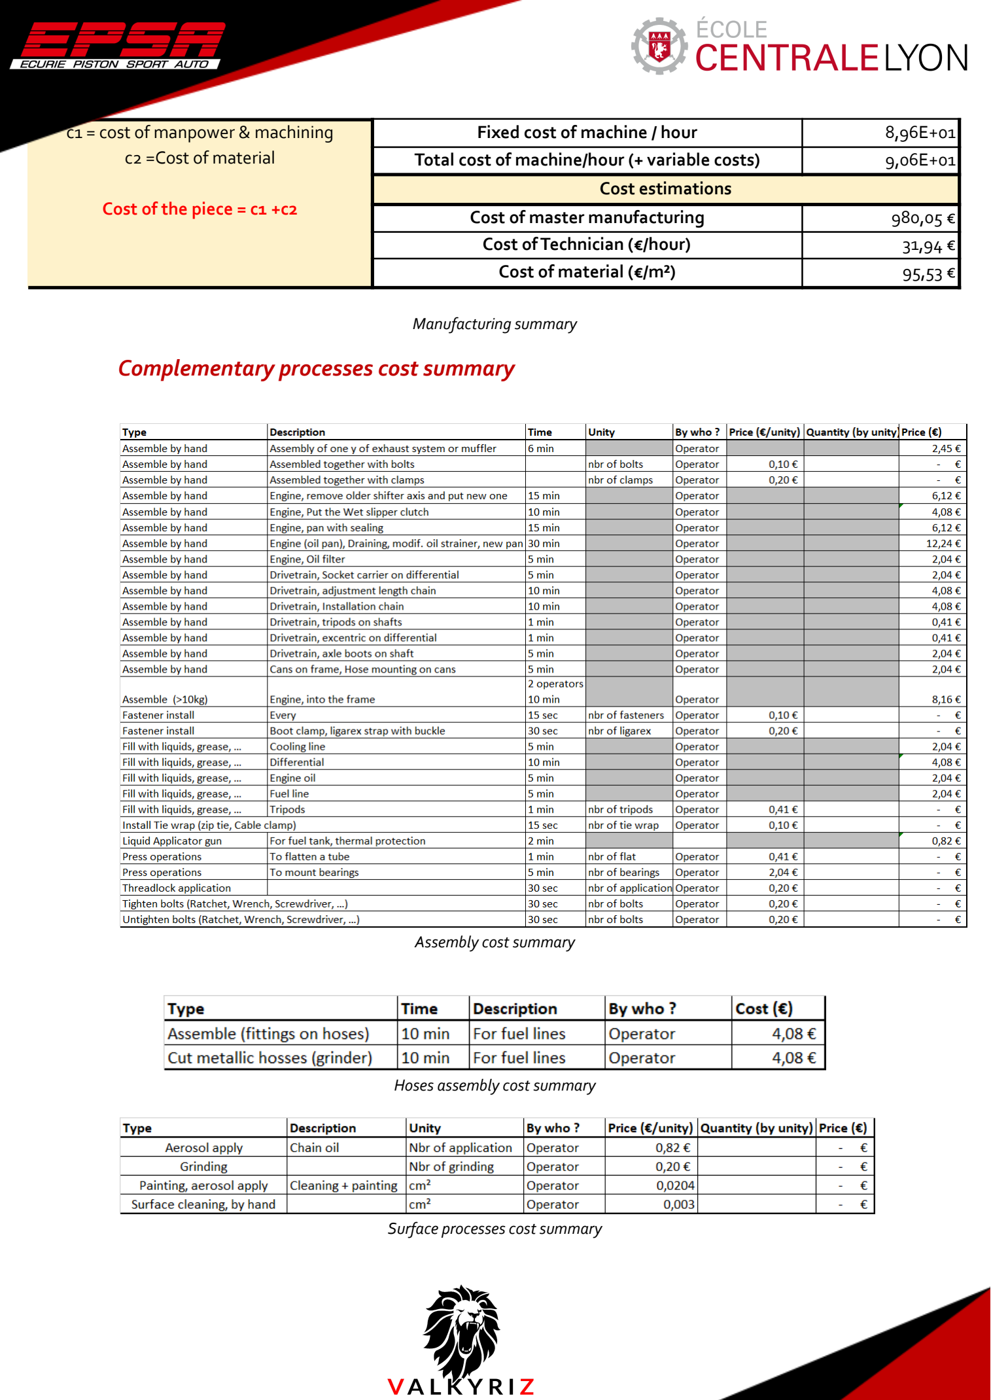
[picture p291: page 13]

c1 = cost of manpower & machining c2 =Cost of material Cost of the piece = c1 +c2 | Fixed cost of machine / hour | 8,96E+01
| Total cost of machine/hour (+ variable costs) | 9,06E+01
Cost estimations
Cost of master manufacturing | 980,05 €
Cost ofTechnician (€/hour) | 31,94 €
Cost of material (€/m²) | 95,53 €

Manufacturing summary

### Complementary processes cost summary

Assembly cost summary

Hoses assembly cost summary

Surface processes cost summary

### Fasteners cost summary


Bolts cost summary (source :TDI)

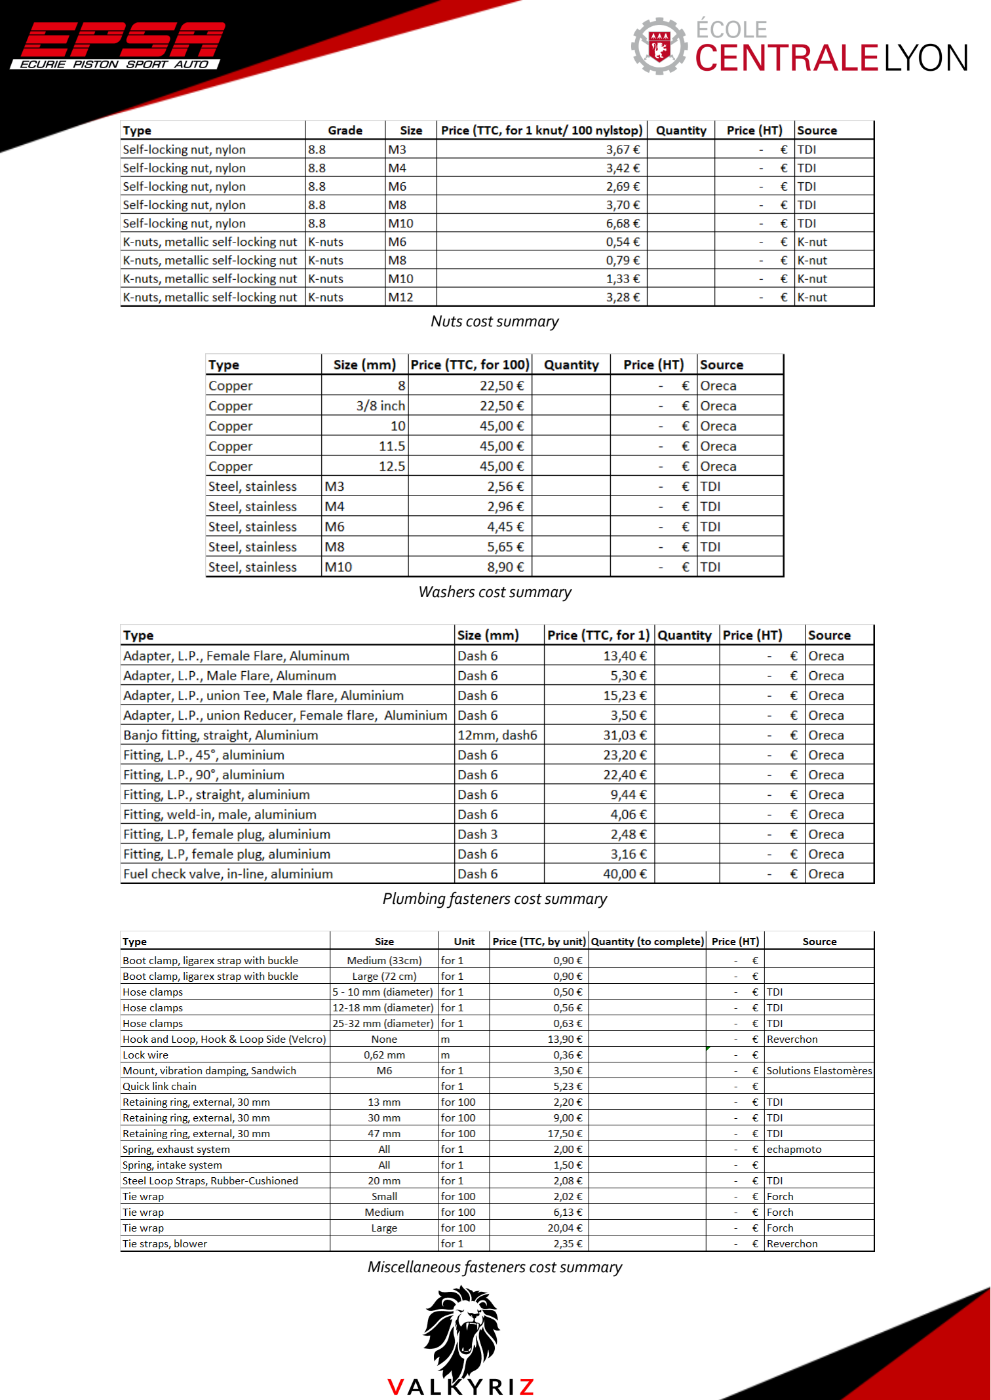
[picture p292: page 15]

Nuts cost summary

Washers cost summary

Plumbing fasteners cost summary

Miscellaneous fasteners cost summary

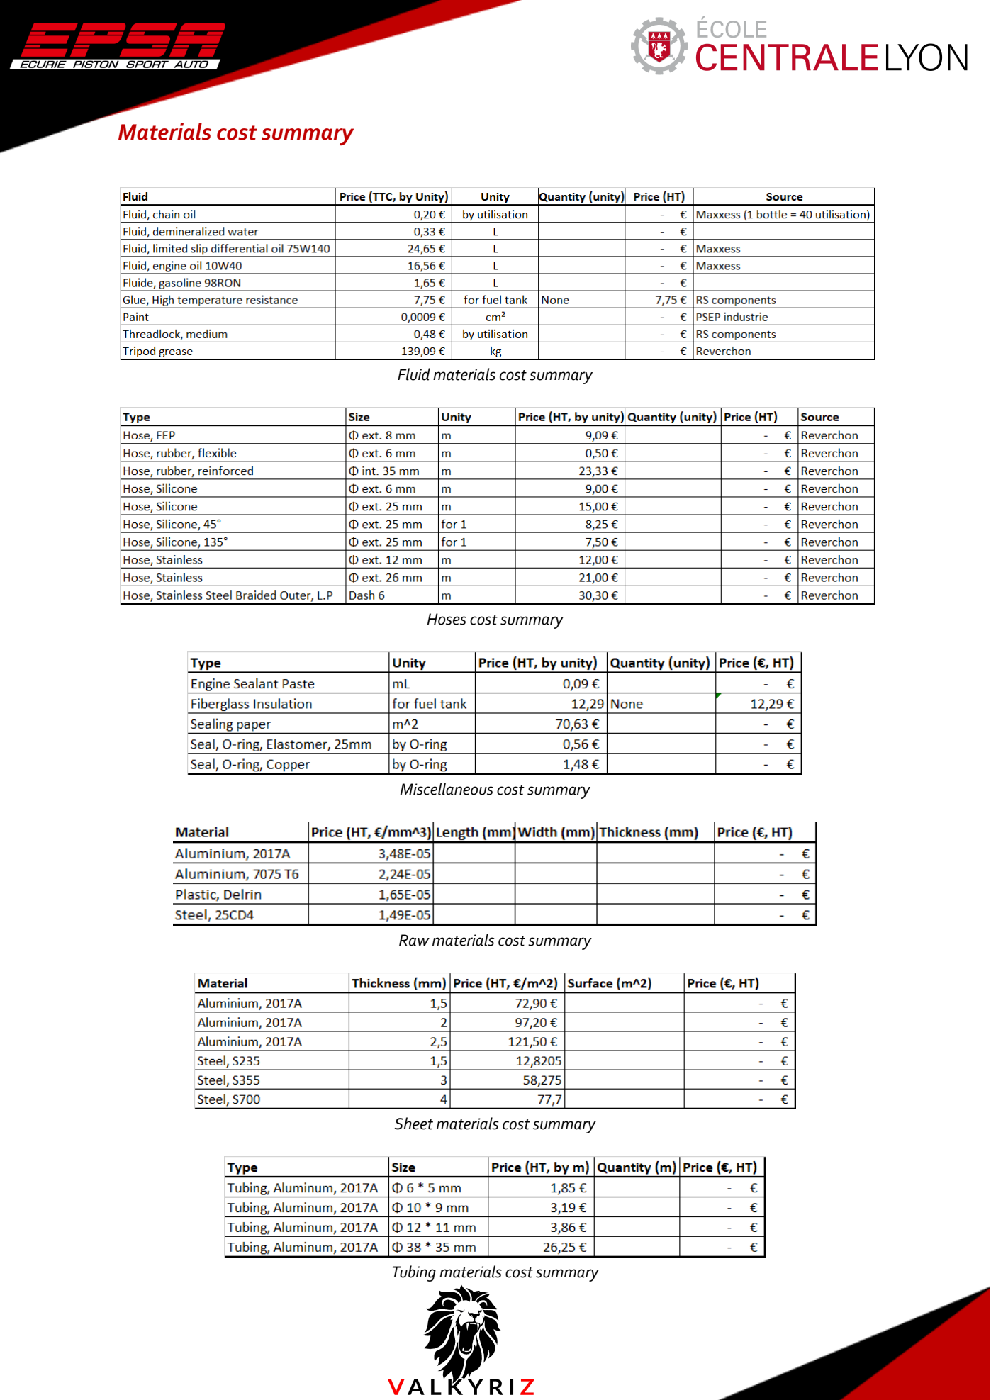
[picture p293: page 16]

### Materials cost summary

Fluid materials cost summary

Hoses cost summary

Miscellaneous cost summary

Raw materials cost summary

Sheet materials cost summary

Tubing materials cost summary
