EOSCogniton/ELIZ-2021/CR_Cost_Report/ZZ-Ressources/05-REAL_CASES/FS_ATA/Affiches_a_imprimer_A3.pdf

# Previsionnal Expenses

14 680€ 12 630€

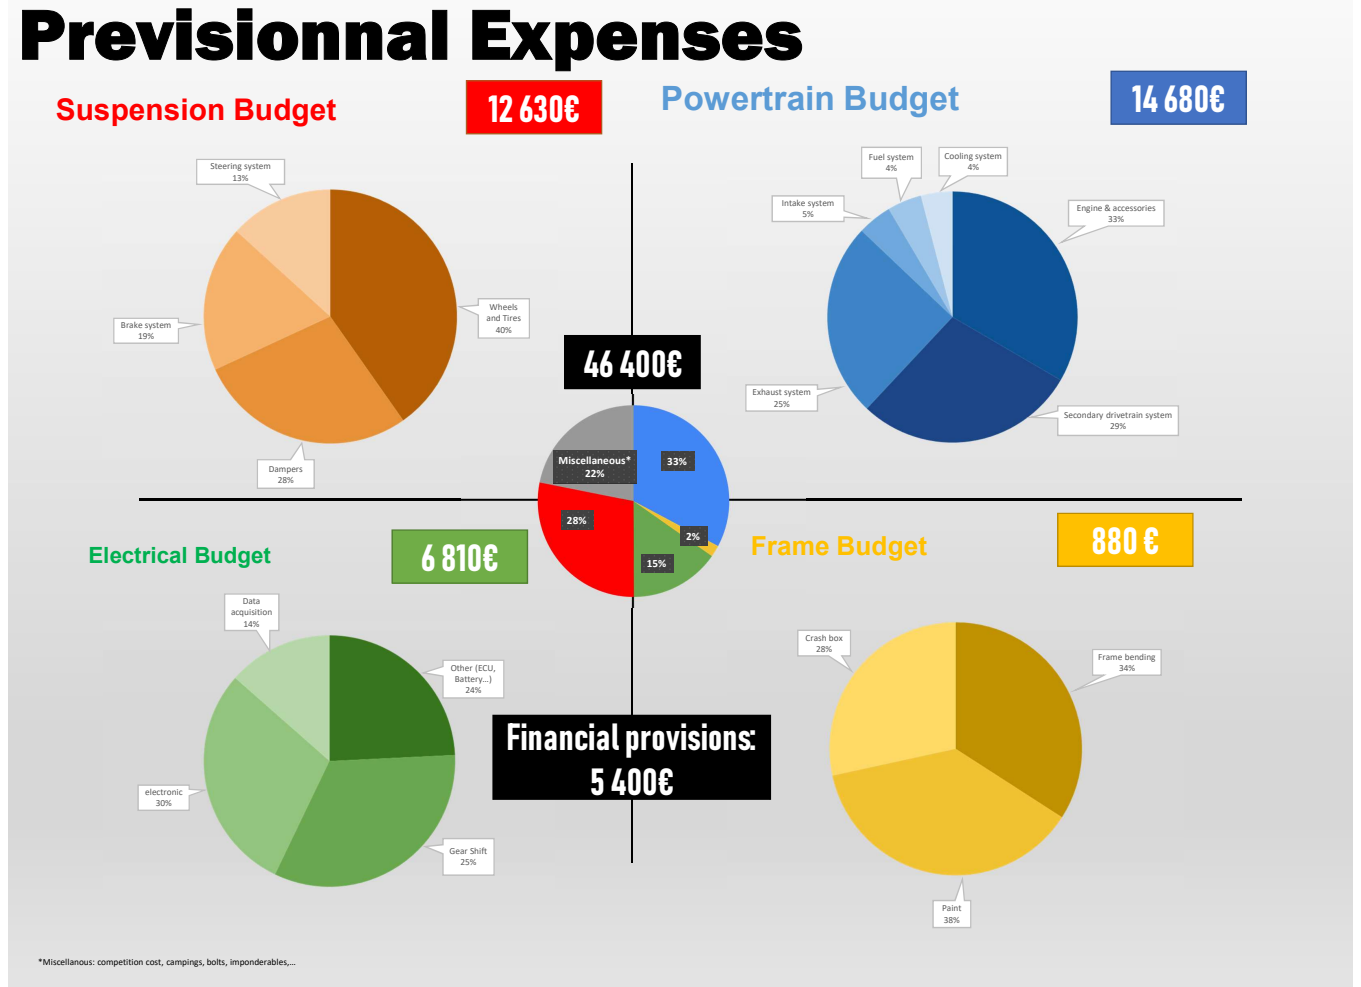
[picture p294: page 1]
Electrical Budget; Frame Budget; Crash box 28%; Paint 38%; Frame bending 34%; Engine & accessories 33%; Cooling system 4%; Fuel system 4%; Intake system 5%; Dampers 28%; Exhaust system 25%; Wheels and Tires 40% Brake system 19%; Steering system 13%; Other (ECU, Battery…) 24%; electronic 30%; Gear Shift 25%; Data acquisition 14%; 28% Miscellaneous* 22%; Financial provisions: 5 400€

Powertrain Budget Suspension Budget

Secondary drivetrain system

*Miscellanous: competition cost, campings, bolts, imponderables,…

# Overview Expenses

14 046€ 19 480€

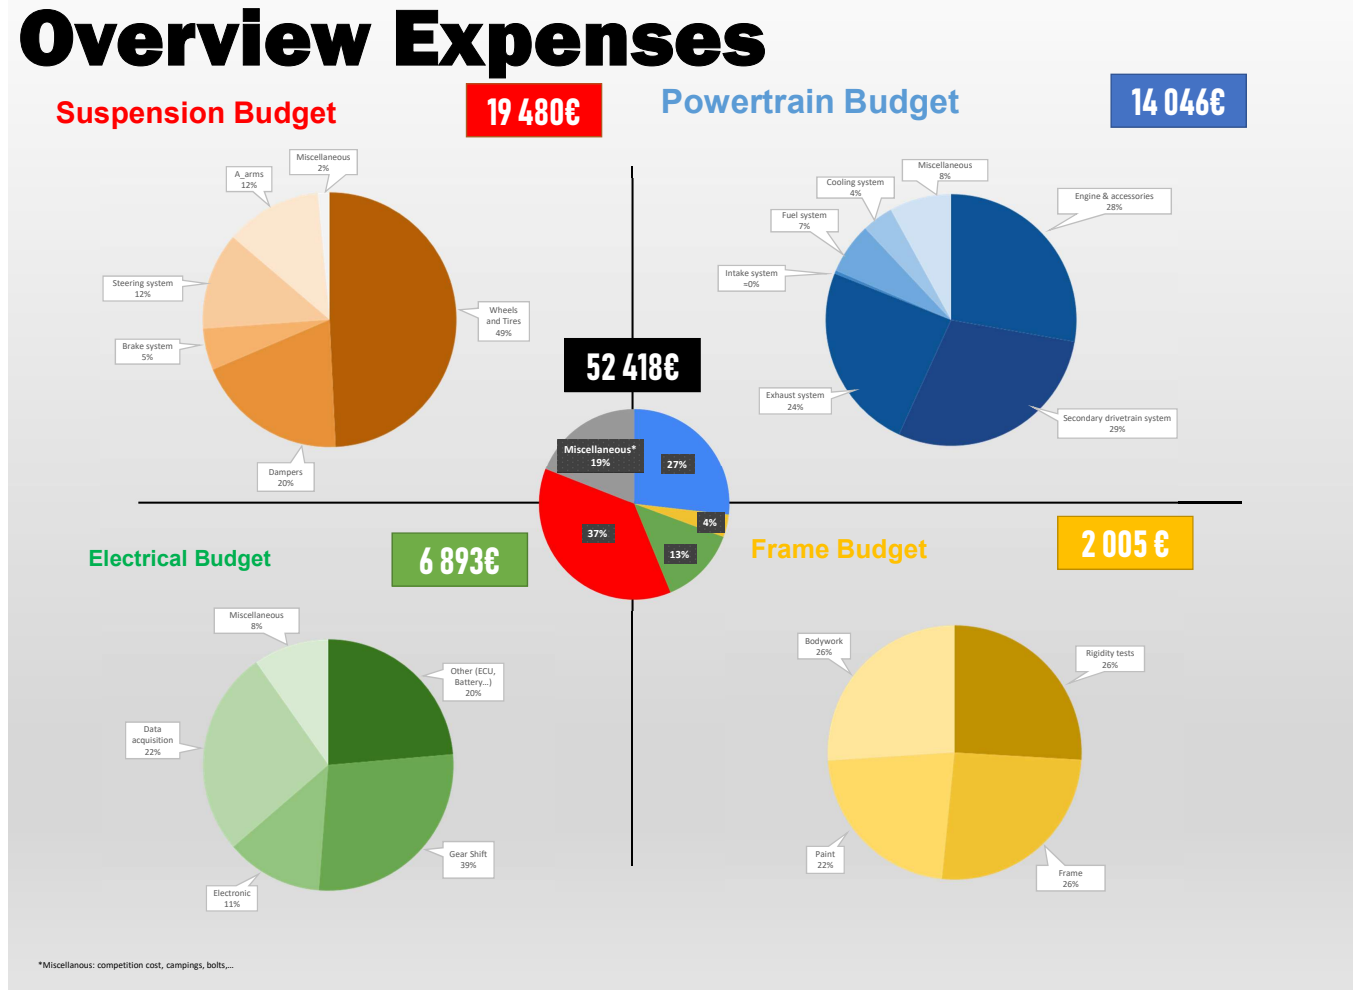
[picture p295: page 2]
Electrical Budget; Frame Budget; Bodywork 26%; Paint 22%; Rigidity tests 26%; Engine & accessories 28%; Cooling system 4%; Fuel system 7%; Intake system ≈0%; Dampers 20%; Exhaust system 24%; Wheels and Tires 49%; Brake system 5%; A_arms 12%; Other (ECU, Battery…) 20%; Miscellaneous 8%; Gear Shift 39%; Data acquisition 22%; 37% Miscellaneous* 19%; Frame 26%; Electronic 11%; Steering system 12%; Miscellaneous

Powertrain Budget Suspension Budget

Secondary drivetrain system

*Miscellanous: competition cost, campings, bolts,…

# Workshop organisation

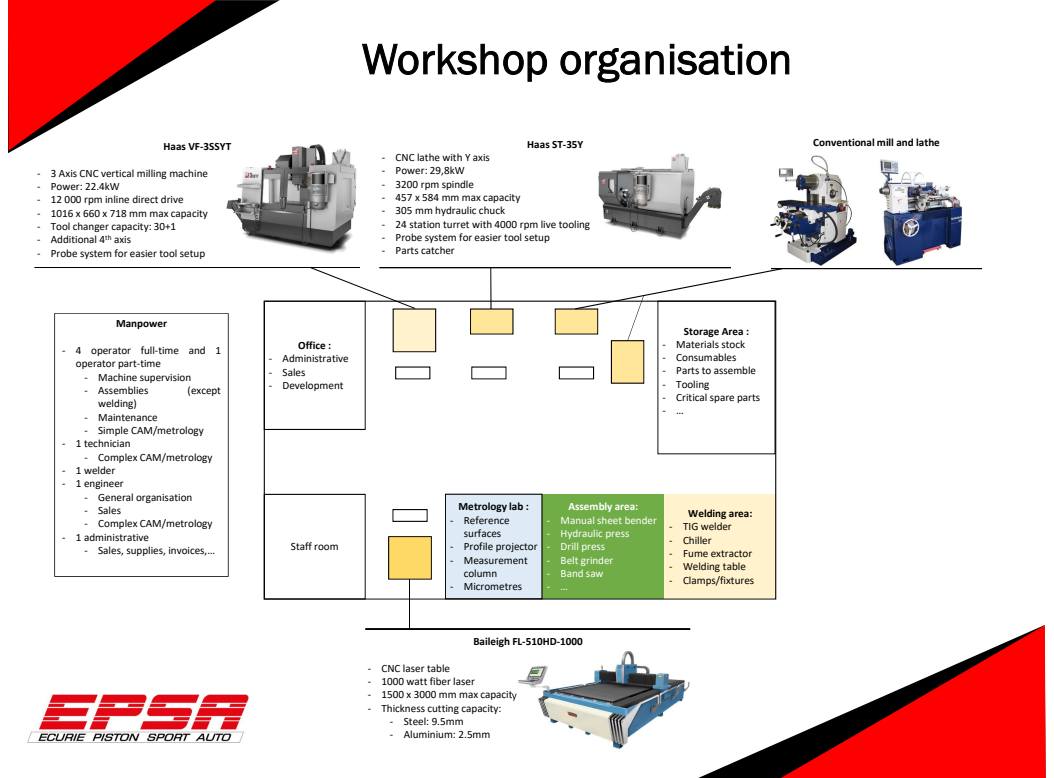
[picture p296: page 3]
Welding area:; - TIG welder - Chiller - Fume extractor - Welding table - Clamps/fixtures; Metrology lab : - Reference surfaces - Profile projector - Measurement column - Micrometres; Office : - Administrative - Sales - Development; Staff room; Haas ST-35Y; Haas VF-3SSYT; Baileigh FL-510HD-1000; Manpower; - Assemblies; (except

Conventional mill and lathe

- CNC lathe with Y axis
- Power: 29,8kW
- 3200 rpm spindle
- 457 x 584 mm max capacity
- 305 mm hydraulic chuck
- 24 station turret with 4000 rpm live tooling
- Probe system for easier tool setup
- Parts catcher

- 3 Axis CNC vertical milling machine
- Power: 22.4kW
- 12 000 rpm inline direct drive
- 1016 x 660 x 718 mm max capacity
- Tool changer capacity: 30+1
- Additional 4th axis

Storage Area :
- Materials stock
- Consumables
- Parts to assemble
- Tooling
- Critical spare parts

- 4 operator full-time and 1
operator part-time
- Machine supervision
welding)
- Maintenance
- Simple CAM/metrology
- 1 technician
- Complex CAM/metrology
- 1 welder
- 1 engineer
- General organisation
- Sales
- 1 administrative
- Sales, supplies, invoices,…

Assembly area:
- Manual sheet bender
- Hydraulic press
- Drill press
- Belt grinder
- Band saw

- CNC laser table
- 1000 watt fiber laser
- 1500 x 3000 mm max capacity
- Thickness cutting capacity:
- Steel: 9.5mm
- Aluminium: 2.5mm
