EOSCogniton/ELIZ-2021/CR_Cost_Report/SFD.xlsm

Sheet: Feuil1
system | assembly | sub_assembly | assembly_no | part | part_comments | makebuy | part_quantity | part_no
FR | Frame / Frame Tubes |  | FR_A0100 | Frame | 25CrMo4 ; 30*1,5, 25*1,5, 20*15, 15*1,5 | m | 1 | FR_01001
FR | Frame / Frame Tubes | FR_A0100
FR | Frame / Frame Tubes |  | FR_A0100 | Frame | 25CrMo4 ; 30*1,5, 25*1,5, 20*15, 15*1,5 | m | 1 | FR_01001

Sheet: FR_A0100
FR | Frame / Frame Tubes | FR_A0100 |  |  |  |  |  |  | Retour
FR | Frame / Frame Tubes |  | FR_A0100 | Frame | 25CrMo4 ; 30*1,5, 25*1,5, 20*15, 15*1,5 | m | 1 | FR_01001

Sheet: FR_01001
FR | FR_A0100 | Frame | FR_01001
