EOSCogniton/ELIZ-2021/CR_Cost_Report/SFD.xlsx

System | Assembly | Part ID | Component (25 chars max) | Comment (40 chars max) | Bought/Made | Qty
FR | FR_A0100 |  | Frame / Frame Tubes |  |  | 1
 |  | FR_01001 | Frame | 25CrMo4 ; 30*1,5, 25*1,5, 20*15, 15*1,5 | m | 1
FR | FR_A0200 |  | Bodywork |  |  | 1
 |  | FR_02001 | Nose | Nose of the bodywork | b | 1
 |  | FR_02002 | Side plates | Side plate from the front hoop to main | b | 2
 |  | FR_02003 | Additional plates | Lower side plate with holes | b | 2
 |  | FR_02004 | Push-clips | Attachement of the nose to the frame | b | 4
 |  | FR_02005 | Hook and loop belts | Attachement of the bodywork to the frame | b | 20
FR | FR_A0300 |  | Pedal (Accelerator) |  |  | 1
 |  | FR_03001 | Frame throttle | laser cut and soldered | m | 1
 |  | 8x30HEX_8.8 | M8x30 shoulder screw | M8x30 (frame-stick) | b | 1
 |  | M8_n | Washer_M8 | M8 washer (frame-stick) | b | 1
 |  | M8_s_8.8 | Nut 8x16 | M8x16 nut (frame-stick) | b | 1
 |  | 4x25CHC_8.8 | M4 CHC Screw | M4x25 (Stick - neg stop) | b | 1
 |  | M4_n | Washer_M4 | M4 (Stick - neg stop) | b | 1
 |  | M4_s_8.8 | Nut 4x9 | M4x9 (Stick - neg stop) | b | 1
 |  | FR_03002 | Footrest | laser cut and bended | m | 1
 |  | 4x25HEX_8.8 | M4x25 Screw | M4x25 (footrest - stick) | b | 2
 |  | M4_s_8.8 | Nut 4x9 | M4x9 (footrest - stick) | b | 2
 |  | FR_03003 | Throttle pedal stick | link frame and footrest | m | 1
 |  | FR_03004 | Throttle fixing rail | allow position adjustment | m | 2
 |  | 6x30HEX_8.8 | M6x30 Screw | M6x30 (fix rail - wedges) | b | 4
 |  | M6_n | Washer_M6 | M6 (fix rail - wedges) | b | 8
 |  | M6_s_8.8 | Nut 6x12 | M6x12 (fix rail - wedges) | b | 4
 |  | FR_03005 | Throttle rail wedge | laser cut | m | 2
 |  | FR_03006 | Throttle Threated Rod | to position rails | m | 2
 |  | FR_03007 | Throttle Front Rail Wedge | laser cut | m | 2
 |  | FR_03008 | Negative Mechanical Stop | to protect potentiometers | m | 1
 |  | FR_03009 | Positive Mechanical Stop | to protect potentiometers | m | 1
 |  | 4x25CHC_8.8 | M4x25 CHC Screw | M4x25 (Pos stop - frame) | b | 1
 |  | M4_n | Washer_M4 | M4 (Pos stop - frame) | b | 1
 |  | M4_s_8.8 | Nut 4x9 | M4x9 (Pos stop - frame) | b | 1
 |  | FR_03010 | Throttle pedal bearing | allow soft rotation | b | 2
 |  | FR_03011 | Springs | bring back the pedal | b | 2
 |  | FR_03012 | Potentiometer | Detects pedal postition | b | 2
 |  | FR_03013 | Throttle R Threaded rods | to position frame | b | 1
 |  | M6_s_8.8 | Nut 6x12 | Fix the threaded rod | b | 2
 |  | M6_n | Washer_M6 | Fix the threaded rod | b | 2
 |  | FR_03014 | Throttle F Threaded rods | to position frame | b | 1
 |  | M6_n | Washer_M6 | Washer_M6 | b | 2
 |  | M6_s_8.8 | Nut 6x12 | Nut 6x12 | b | 2
 |  | FR_03015 | Axle Spacer | allow good position | m | 1
 |  | FR_03016 | Potentiom R Threaded Rod | Fix potentiom to frame | b | 1
 |  | M3_s_8.8 | Nut 3 | Fix the threaded rod | b | 6
 |  | M3_n | Washer_M3 | Fix the threaded rod | b | 6
 |  | FR_03016 | Potentiom F Threaded Rod | Fix potentiom to frame | b | 1
 |  | M3_s_8.8 | Nut 3 | Fix the threaded rod | b | 6
 |  | M3_n | Washer_M3 | Fix the threaded rod | b | 6
FR | FR_A0400 |  | Pedal (Brake) |  |  | 1
 |  | FR_04001 | Frame brake | laser cut and solded | m | 1
 |  | 8x30HEX_8.8 | M8x30 shoulder screw | M8x30 (frame-stick) | b | 1
 |  | M8_n | Washer_M8 | M8 washer (frame-stick) | b | 1
 |  | M8_s_8.8 | Nut 8x16 | M8x16 nut (frame-stick) | b | 1
 |  | 4x25CHC_8.8 | M4 CHC Screw | M4x25 (BOTS support) | b | 1
 |  | M4_n | Washer_M4 | M4 (BOTS support) | b | 1
 |  | M4_s_8.8 | Nut 4x9 | M4x9 (BOTS support) | b | 1
 |  | FR_04002 | Brake pedal Stick | link frame and footrest | m | 1
 |  | 6x80HEX_8.8 | M6x80 Screw | M6x80 (master cyl-stick) | b | 1
 |  | M6_n | Washer_M6 | M6 (master cyl-stick) | b | 1
 |  | M6_s_8.8 | Nut 6x12 | M6x12 (master cyl-stick) | b | 1
 |  | FR_04003 | Footrest | laser cut and bended | m | 1
 |  | 4x30CHC_8.8 | M4x30 CHC Screw | M4x30 (footrest - stick) | b | 2
 |  | M4_s_8.8 | Nut 4x9 | M4x9 (footrest - stick) | b | 2
 |  | FR_04004 | Master cylinder | pressurize brake liquid | b
 |  | FR_04005 | Master cylinder wedge | link master cylinder and stick | m | 2
 |  | FR_04006 | Brake fixing rail | allow position adjustment | m | 2
 |  | 6x30HEX_8.8 | M6x30 Screw | M6x30 (fix rail - wedges) | b | 4
 |  | M6_n | Washer_M6 | M6 (fix rail - wedges) | b | 8
 |  | M6_s_8.8 | Nut 6x12 | M6x12 (fix rail - wedges) | b | 4
 |  | FR_04007 | Brake R Fixing Rail Wedge | rear wedges | m | 2
 |  | FR_04008 | Brake F Fixing Rail Wedge | front wedges | m | 2
 |  | FR_04009 | Distribution Brake Axle | link cylinder to ball joint | b | 1
 |  | FR_04010 | Distribution Axle Tread | maintain Brake Axle | b | 2
 |  | FR_04011 | Distribution Cylinder | support for ball joint | b | 1
 |  | FR_04012 | Distribution Ball Joint | allows rotation | b | 1
 |  | FR_04013 | BOTS Support | support the BOTS | m | 1
 |  | FR_04014 | BOTS | security if brakes don't work | b | 1
 |  | FR_04015 | Brake Pedal Hose Wedge | to maintain brake hose | m | 1
 |  | FR_04016 | Distribution Cylinder | link axle and axle thread | b | 2
 |  | FR_04017 | Brake Pedale Bearing | allow soft rotation | b | 2
 |  | FR_04018 | Brake Threated Rod | to position frame | b | 2
 |  | M6_s_8.8 | Nut 6x12 | Fix the threaded rod | b | 2
 |  | M6_n | Washer_M6 | Fix the threaded rod | b | 2
FR | FR_A0500 |  | Impact Attenuator |  |  | 1
 |  | FR_04001 | Impact Attenuator | Approved by event |  | 1
 |  | FR_04002 | Anti-intrusion Plate | Steel, (thickness 1.5mm) |  | 1
FR | FR_A0600 |  | Floor Pan |  |  | 1
 |  | FR_05001 | Front plate | Floor pan from front hoop to front car |  | 1
 |  | FR_06002 | Cockpit plate | Floor pan from front hoop to main hoop |  | 1
 |  | 4x20CHC_8.8 | M4 Screw | M4x20 Screw to fix pan to frame |  | 8
 |  | M4_n | M4 Washer | M4 washer to fix pan to frame |  | 8
 |  | M4_s_8.8 | M4 Nut | M4 Nutto fix pan to frame |  | 8
