EOSCogniton/ELIZ-2021/CR_Cost_Report/01_BOM/00_Cost_Report_Document/COST_Model.xlsx

Sheet: Summary
General Data |  |  |  | Overheads cost |  |  |  |  | Manufacturing cost: Machinery performances |  | Manufacturing cost : Equipement Costs |  |  |  |  |  | Manufacturing Summary
Category | Description | Value | Explanation | Category | Description | Cost (incl tax) | Depreciation time (year) | Cost/year | Operating perfomances of the Machine | Spec | Description | Variable | Way of costing | Cost | Depreciation time (year) | Cost/year | Comments |  | Costs
Administrative Workforce | Sales/Administratives | 50414.81 € | Cost per year | Manwork | Administrative/sales people | 50414.81 € | 1 | 50414.81 € | Milling |  | Milling |  |  |  |  |  | Milling
Operative Workforce | Welder | 43935.00 € | Cost per year |  | 50% engineer | 29647.79 € | 1 | 29647.79 € | Power consumption (kW) | 22.4 | 3 Axis CNC Mill Direct | No |  | 95994.00 € | 10 | 9599.40 € | Prices calculated for aluminium |  | Cost of the Machinery
 | Operator | 36901.56 € |  |  | 5% of manwork OPE on shopfloor | 9538.36 € | 1 | 9538.36 € | OPE | 80% | Milling tool holders | No |  | 4800.00 € | 5 | 800.00 € | Corrective factor if material = steel | 250% | Yearly fixed cost of machine | 17815.1
 | Technician | 50414.81 € |  |  | Maintenance manwork | 4990.86 € | 1 | 4990.86 € | OPM per job (Cleaning in min) | 5 | Fixtures | No |  | 2500.00 € | 5 | 500.00 € | Corrective factor if material = Delrin | 50% | Fixed cost of machine / hour | 30.39829882
 | Engineer | 59295.58 € |  | Energy Consumption | Electricity subscription | 3449.78 € | 1 | 3449.78 € | Removal rate (for Aluminium) (min/mm^3) | 0.0001 | Maintenance | No | 5 % of initial cost each year | 4799.70 € | 1 | 4799.70 € |  |  | Total cost of machine/hour (+ variable costs) | 52.08206202
Time | Hours/week | 35 | French labour law impose this minimal rate to earn the min wage |  | Electricity consumption for office and small components (avg 16kW) | 2373.05 € | 1 | 2373.05 € | Programming time and supply order (min/ mm^3) (50% of machining time) | 5e-05 | Cutting fluid | No | 200L/year | 2116.00 € | 1 | 2116.00 € | x = volume (mm^3) removed from the piece c1 = x* cost of the machining part c2 =x * (cost of programming + measuring) c3 = fixed cost of setup + cleaning Cost of the piece = c1 +c2+c3 |  | Cost of the Process
 | Week/year | 45.1 | Total of week per year without, holiday, bank holiday… |  | Water (60m^3) | 199.44 € | 1 | 199.44 € | Measuring and deflash time (min/ mm^3) (40% of machining time) | 4e-05 | Electricity | Yes | €/hour | 1.68 € |  |  |  |  | Cost of machining part (€/mm^3) | 0.0001257661211 | 24.61620289
 | Base OPE | 80% | It is a prototyping company, soit does not run nonstop. 6%: maintenance and cleaning of shop floor | IT&Office | Softwares | 911.12 € | 1 | 911.12 € | Setup time per job (fixture and tools) (min) | 20 | Cutting tools | Yes | €/hour | 20.00 € |  |  |  |  | Manpower part of machining cost | 30.98027044%
 | People efficiency | 95% | People cannot be working nonstop. |  | Printer | 269.90 € | 3 | 89.97 € | 3D Laser Cutting |  | 3D Laser Cutting |  |  |  |  |  |  |  | Other costs
Energies | Electricity Subscription | 3449.78 € |  |  | Printer consumable (4000 A4pages B&W, 1600 A4pages Colors, A4x5000, A3x2000) | 392.57 € | 1 | 392.57 € | Power consumption (kW) | 6 | Laser cutter tube fiber | No |  | 1000000.00 € | 7 | 142857.14 € |  |  | Cost of programing part Operator (€/mm^3) | 3.305690958e-05 | 6.470228912
 | Electricity Rate /kWh | 0.09 € |  |  | Computers and accessories | 14911.80 € | 3 | 4970.60 € | OPE | 80% | Maintenance | No | estimated by our partner | 10000.00 € | 1 | 10000.00 € |  |  | Cost of programing part Technician(€/mm^3) | 4.609669709e-05
 | Water rate/m3 | 3.32 € |  |  | Internet/phone access | 1468.80 € | 1 | 1468.80 € | OPM per job (Cleaning in min) | 5 | Consumables | No |  | 1500.00 € | 1 | 1500.00 € |  |  | Cost of programing part Engineer (€/mm^3) | 5.449824961e-05
Others | Euro to Dollar Rate | 1.2076 | The 13/05/2021 rate |  | Phone/mobile phone | 1598.40 € | 3 | 532.80 € | Programmation time and supply order (min/tube) | 10 | Water draining | No |  | 1500.00 € | 1 | 1500.00 € |  |  | Cost of measuring part Operator (€/mm^3) | 2.644552766e-05
 | VAT | 20% | French VAT |  | Office furniture | 200.00 € | 1 | 200.00 € | Time of operation per tube (s/tube) if raw < 6m (setup + cutting) | 613 | Electricity | Yes | €/hour | 0.45 € |  |  |  |  | Cost of measuring part Technician(€/mm^3) | 3.687735768e-05
 |  |  |  |  | Worktable & office storage | 16747.20 € | 10 | 1674.72 € | Time of operation per tube (s/tube) if raw > 6m (setup + cutting) | 373 | 2D Laser Cutting |  |  |  |  |  |  |  | Cost of measuring part Engineer (€/mm^3) | 4.359859969e-05
 |  |  |  | Manufacturing | Manufacturing tools (Band Saw, Drill, Metal bender, belt and disc grinder, Vise, forklift…) | 22917.65 € | 10 | 2291.76 € | 2D Laser Cutting |  | 2D Laser cut | No |  | 120726.40 € | 10 | 12072.64 € |  |  | Cost of Setup + cleaning | 22.40662895
 |  |  |  |  | Consumables (saw blades, drill bits, taps, abrasives, …) | 3000.00 € | 1 | 3000.00 € | Power consumption (kW) | 7.5 | Maintenance | No | 5 % of initial cost each year | 6036.32 € | 1 | 6036.32 € | 3D Laser Cutting
 |  |  |  |  | Roller Cabinet (3 V3 and 3 V5) | 10266.00 € | 10 | 1026.60 € | OPE | 70% | Electricity | Yes | €/hour | 0.49 € |  |  | Prices calculated for steel |  | Cost of the Machinery
 |  |  |  |  | Other specific tools (scribing tool, eletrical pliers, simple measuring tools, …) | 5133.00 € | 10 | 513.30 € | OPM per job (Cleaning in min) | 5 | Welding |  |  |  |  |  | Corrective factor if material = aluminium | 50% | Yearly fixed cost of machine | 155857.14 €
 |  |  |  |  | Shopfloor organisation equipement (locker, shelves, drawer…) | 33591.00 € | 10 | 3359.10 € | Removal rate (for steel) (min/mm²) | 0.0001368262414 | TIG Welder & Chiller | No |  | 7129.69 € | 10 | 712.97 € | Corrective factor if material = Delrin | 25% | Fixed cost of machine / hour | 139.7125551
 |  |  |  |  | Industrial Hoovers | 2580.00 € | 10 | 258.00 € | Programation time (min) | 2 | Fume extractor | No |  | 3546.58 € | 10 | 354.66 € |  |  | Total cost of machine/hour (+ variable costs) | 140.1635631
 |  |  |  | Metrology | Micrometres | 2416.67 € | 10 | 241.67 € | Measuring time (min) | 1 | Welding table | No |  | 5220.00 € | 10 | 522.00 € | x =nb of tubes c1 = x* cost of the machining part c2 =x * cost of programming c3 = fixed cost of cleaning Cost of the piece = c1 +c2+c3 |  | Cost of the Process
 |  |  |  |  | Inside micrometers | 1915.00 € | 10 | 191.50 € | Cost of Oxygen (€/mm²) | 0.0000334 € | Specific welding tools | No |  | 1815.60 € | 5 | 363.12 € |  |  | Cost of machining part if raw < 6m (€/tube) | 27.84742765 | 23.86674005
 |  |  |  |  | Indicators | 998.33 € | 10 | 99.83 € | Setup time (min) | 8 | EPI (Welmet, gloves,…) | No |  | 298.12 € | 5 | 59.62 € |  |  | Cost of machining part if raw > 6m (€/tube) | 16.94468273 | 14.52250251
 |  |  |  |  | Profile projector | 48334.81 € | 10 | 4833.48 € | Welding |  | Maintenance | No | 5 % of initial cost each year | 533.81 € | 1 | 533.81 € |  |  | Manpower part of machining cost (average) | 14.29463304%
 |  |  |  |  | Reference Block | 3343.33 € | 10 | 334.33 € | Power consumption (kW) | 4.96 | Electricity | Yes | €/hour | 0.47 € |  |  |  |  | Other costs
 |  |  |  |  | Depth gauges | 513.33 € | 10 | 51.33 € | OPE | 80% | Filler (35CrMo4) | Yes | €/m | 4.89 € |  |  |  |  | Cost of programing part Operator (€/tube) | 6.611381916
 |  |  |  |  | Measurement column | 5390.00 € | 10 | 539.00 € | OPM per job (Cleaning in min) | 2 | Gaz | Yes | €/m | 14.35 € |  |  |  |  | Cost of programing part Technician(€/tube) | 8.038184445
 |  |  |  |  |  |  |  |  | Welding speed (min/m) | 140.4308321 | Conventionnal |  |  |  |  |  |  |  | Cost of programing part Engineer (€/tube) | 8.975865706
 |  |  |  | Overhead Summary |  |  |  |  | Setup time (min) | 2 | Conventionnal milling machine | No |  | 18000.00 € | 10 | 1800.00 € |  |  | Cost Cleaning (setup included in operation time) | 13.59084715
 |  |  |  | Fixed Cost | Sum of fixed cost/year (+5% extra equipment integrated) |  |  | 133974.31 € | Conventionnal machining |  | Conventionnal turning machine | No |  | 12000.00 € | 10 | 1200.00 € | 2D Laser Cutting
 |  |  |  |  | Fixed cost/hour to charge on operation (machine/station/programing/metrology) |  |  | 16.29 € | Power consumption (kW) | 6 | Tool holders and fixtures | No |  | 28073.50 € | 5 | 5614.70 € | Prices calculated for steel |  | Cost of the Machinery
 |  |  |  | Manpower cost | Operator cost/hour |  |  | 23.38 € | OPE | 44% | Maintenance | No | 3 % of initial cost /year | 900.00 € | 1 | 900.00 € | Corrective factor if material = aluminium | 42.23095342% | Yearly fixed cost of machine | 18108.96 €
 |  |  |  |  | Welder cost/hour |  |  | 27.83 € | OPM per job (Cleaning in min) | 5 | Electricity | Yes | €/hour | 0.25 € |  |  |  |  | Fixed cost of machine / hour | 32.67962143
 |  |  |  |  | Technician cost/hour |  |  | 31.94 € | Removal rate (for aluminium) (include measuring) (min/mm^3) | 0.0003 | Cutting tools | Yes | €/hour | 10.00 € |  |  |  |  | Total cost of machine/hour (+ variable costs) | 33.17291143
 |  |  |  |  | Engineer cost/hour |  |  | 37.56 € | Setup time (fixture and tools) (min) | 10 | Body Manufacturing |  |  |  |  |  | x =nb of mm to cut y = nb of mm² to cut = x*thickeness c1 = y* cost of the machining part c2 =y * cost of oxygen c3 = y* prog and measuring part c4 = fixed cost of cleaning Cost of the piece = c1 +c2 c3+ c4 |  | Cost of the Process
 |  |  |  |  |  |  |  |  | Body Manufacturing |  | CNC Mill | No |  | 300000.00 € | 10 | 30000.00 € |  |  | Cost of machining part (€/mm) | 0.0001289599231 | 0.7452593957
 |  |  |  |  |  |  |  |  | Power consumption (kW) | 22.4 | Spray station | No |  | 30810.00 € | 10 | 3081.00 € |  |  | Cost of oxygen (€/mm) | 0.0000334 € | 0.1930608 €
 |  |  |  |  |  |  |  |  | OPE | 45% | Woodworking station | No |  | 6990.00 € | 5 | 1398.00 € |  |  | Manpower part of machining cost (average) | 41.33933658%
 |  |  |  |  |  |  |  |  |  |  | Specific Tooling | No |  | 5344.20 € | 5 | 1068.84 € |  |  | Other costs
 |  |  |  |  |  |  |  |  |  |  | Maintenance | No | 5 % of initial cost /year | 16540.50 € | 1 | 16540.50 € |  |  | Cost of programing and measuring part Operator (€) | 1.322276383
 |  |  |  |  |  |  |  |  |  |  | Electricity | Yes | €/hour | 0.95 € |  |  |  |  | Cost of programing and measuring part Technician(€) | 1.607636889
 |  |  |  |  |  |  |  |  |  |  | Resin | Yes | €/m² | 29.95 € |  |  |  |  | Cost of programing and measuring part Engineer (€) | 1.795173141
 |  |  |  |  |  |  |  |  |  |  | Fiber fabric | Yes | €/m² | #REF! |  |  |  |  | Cost Cleaning (setup included in operation time) | 12.15 €
 |  |  |  |  |  |  |  |  |  |  |  |  |  |  |  |  | Tube Welding
 |  |  |  |  |  |  |  |  |  |  |  |  |  |  |  |  | c1 = lenght to weld * welding speed* cost of the machine c2 =lenght to weld * cost of filler gas and metal c3 = hours of welder work * welder hourly salary * nb of welders C = c1+c2 + c3 |  | Yearly fixed cost of machine | 2546.18 €
 |  |  |  |  |  |  |  |  |  |  |  |  |  |  |  |  |  |  | Fixed cost of machine / hour | 18.30698151
 |  |  |  |  |  |  |  |  |  |  |  |  |  |  |  |  |  |  | Total cost of machine/hour (+ variable costs) | 18.77302311 | 0
 |  |  |  |  |  |  |  |  |  |  |  |  |  |  |  |  |  |  | Cost of the Process
 |  |  |  |  |  |  |  |  |  |  |  |  |  |  |  |  |  |  | Cost of filler metal (€/m) | 4.89 € | 0.00 €
 |  |  |  |  |  |  |  |  |  |  |  |  |  |  |  |  |  |  | Cost of filler gas (€/m) | 14.35 € | 0.00 €
 |  |  |  |  |  |  |  |  |  |  |  |  |  |  |  |  |  |  | Total Manpower cost for welding the frame (discussion with our partner) | 6680.01 €
 |  |  |  |  |  |  |  |  |  |  |  |  |  |  |  |  | Bracket Welding
 |  |  |  |  |  |  |  |  |  |  |  |  |  |  |  |  | x =nb of m to weld/ t1 = time of wood coding design / t2 = time of wood coding manufacturing / t3 = time for positioning the bracket c1 = x* cost of the machining part c2 =x * cost of material c3 = fixed cost of cleaning c4 = t1*cost of engineer + t2 * cost of technician+ t3 * cost of welder Cost of the piece = c1 +c2 c3+ c4 |  | Yearly fixed cost of machine | 2546.18 €
 |  |  |  |  |  |  |  |  |  |  |  |  |  |  |  |  |  |  | Fixed cost of machine / hour | 18.30698151
 |  |  |  |  |  |  |  |  |  |  |  |  |  |  |  |  |  |  | Total cost of machine/hour (+ variable costs) | 18.77302311
 |  |  |  |  |  |  |  |  |  |  |  |  |  |  |  |  |  |  | Cost of the Process
 |  |  |  |  |  |  |  |  |  |  |  |  |  |  |  |  |  |  | Cost of filler metal and gas (€/m) | 19.25 € | 69.83 €
 |  |  |  |  |  |  |  |  |  |  |  |  |  |  |  |  |  |  | Cost of machining part (€/m) | 174.23 € | 316.05 €
 |  |  |  |  |  |  |  |  |  |  |  |  |  |  |  |  |  |  | Manpower part of machining cost (average) | 74.78093133%
 |  |  |  |  |  |  |  |  |  |  |  |  |  |  |  |  |  |  | Other costs for wood coding parts
 |  |  |  |  |  |  |  |  |  |  |  |  |  |  |  |  |  |  | Cost of wood coding conception by an Engineer (€/h of conception) | 37.56 €
 |  |  |  |  |  |  |  |  |  |  |  |  |  |  |  |  |  |  | Cost of wood coding manufacturing by a Technician (€/min) | 0.53 €
 |  |  |  |  |  |  |  |  |  |  |  |  |  |  |  |  |  |  | Cost of positioning the brackets by Welder (€/min) | 0.46 €
 |  |  |  |  |  |  |  |  |  |  |  |  |  |  |  |  | Conventionnal Machining
 |  |  |  |  |  |  |  |  |  |  |  |  |  |  |  |  | x = volume (mm^3) removed from the piece c1 = x* cost of the machining part c2 = fixed cost of setup + cleaning Cost of the piece = c1 +c2 |  | Yearly fixed cost of machine | 9514.70 €
 |  |  |  |  |  |  |  |  |  |  |  |  |  |  |  |  |  |  | Fixed cost of machine / hour | 29.9899638
 |  |  |  |  |  |  |  |  |  |  |  |  |  |  |  |  |  |  | Cost of machine/hour running | 40.2380182
 |  |  |  |  |  |  |  |  |  |  |  |  |  |  |  |  |  |  | Cost of the Process
 |  |  |  |  |  |  |  |  |  |  |  |  |  |  |  |  |  |  | Cost of machining part (€/mm^3) | 0.0001983414575
 |  |  |  |  |  |  |  |  |  |  |  |  |  |  |  |  |  |  | Cost of Setup + cleaning | 8.894595745
 |  |  |  |  |  |  |  |  |  |  |  |  |  |  |  |  | Body Manufacturing
 |  |  |  |  |  |  |  |  |  |  |  |  |  |  |  |  | c1 = cost of manpower & machining c2 =Cost of material Cost of the piece = c1 +c2 |  | Yearly fixed cost of machine | 52088.34 €
 |  |  |  |  |  |  |  |  |  |  |  |  |  |  |  |  |  |  | Fixed cost of machine / hour | 89.6209733
 |  |  |  |  |  |  |  |  |  |  |  |  |  |  |  |  |  |  | Total cost of machine/hour (+ variable costs) | 90.5680901
 |  |  |  |  |  |  |  |  |  |  |  |  |  |  |  |  |  |  | Cost estimations
 |  |  |  |  |  |  |  |  |  |  |  |  |  |  |  |  |  |  | Cost of master manufacturing | 980.05 €
 |  |  |  |  |  |  |  |  |  |  |  |  |  |  |  |  |  |  | Cost of Technician (€/hour) | 31.94 €
 |  |  |  |  |  |  |  |  |  |  |  |  |  |  |  |  |  |  | Cost of material (€/m²) | 95.53 €

Sheet: Frame tubes
Diamètre tube (mm) | Longueur tube (m) | Nombre tubes | Prix matière tube (€HT/m) | Longueur à souder (m) | Prix découpe tube (€TTC)
30 | 4.4 | 18 | 19 | 1.696460033 | 633.85 €
28 | 10.6 | 21 | 15.9 | 1.84725648 | 521.86 €
25 | 10.7 | 33 | 14 | 2.591813939 | 804.53 €
20 | 8.3 | 24 | 11.5 | 1.507964474 | 578.94 €
15 | 6.1 | 16 | 9.5 | 0.7539822369 | 390.49 €
Total |  |  |  | 8.397477163
Prix découpe tube (€ TTC) | 2929.66 €
Prix soudure tube total (€ HT) | 6841.64 €
Prix tubes total (€ TTC) | 666.45 €
Prix peinture total | 360.00 €
Prix cintrage total (€ HT) | 360.00 €

Sheet: Manpower & time
Documentation Sources
Description | Source
Automotive wage table | https://www.gestionnaire-paie.com/convention-collective-automobile-salaires-minima/
Wage cost calculation for the company | https://www.service-public.fr/professionnels-entreprises/vosdroits/services-en-ligne-et-formulaires/simulateur-cout-embauche
Working time | https://www.juristique.org/social/duree-du-travail
Grades in automobile sector | https://www.services-automobile.fr/sites/default/files/2018-04/Convention%20collective%20-%20Chapitre%20III.pdf
 | https://www.services-automobile.fr/sites/default/files/2020-11/1.4%20-%20Chap.III%20bis%20-%20V29_0.pdf
 | https://www.services-automobile.fr/sites/default/files/2018-04/Convention%20collective%20-%20Chapitre%20V.pdf
Welder Wages in France | https://www.reconversionprofessionnelle.org/salaire-soudeur/
Minimal Wage in France | https://travail-emploi.gouv.fr/droit-du-travail/la-remuneration/article/le-smic-montants-en-vigueur-a-compter-du-1er-janvier-2021
Manpower Cost
Manpower | Staffing | Month wage (gross) | Yearly wage cost for the company (total) | Shopfloor allocation | Fixed cost (5% of the time) | Hourly Wage (€/h/employee)
Operator - Grade 4 (Laser cutting, bending and painting) | 1.0 | 2120.78 € | 36901.56 € | 3 | 5535.23 € | 23.38 € | 1.95 €
Operator - Grade 9 Welder | 1.0 | 2525.00 € | 43935.00 € | 2 |  | 27.83 €
Technician - Grade 23 | 1.0 | 2897.40 € | 50414.81 € | 1 | 2520.74 € | 31.94 €
Engineer - Grade II | 1.0 | 3407.79 € | 59295.58 € | 0.5 | 1482.39 € | 37.56 €
 |  |  | Sum | 6.5 | 9538.36 €
Data for working time
Description | Value
Days/year | 365
Days of weekend | 104
Bank holliday | 8
Payed holliday (5 W) and payed leave (2,5 D) | 27.5
Theoretical worked days | 225.5
Theoretical worked week | 45.1
Manwork availability (95%) /year (hrs) | 1499.575
Workforce allocation
 | CNC mill | Laser Cutter 3D | Laser Cutter 2D | Welding/Assembly | Body Workstation | Prior programmation | Metrology | Maintenance | Total
OPE (machine programmation + operation) | 80% | 80% | 70% | 80% | 45% | 80% | 80% | 6% | -
OPE of machine in hours (hours/year) | 1262.8 | 1262.8 | 1104.95 | 1262.8 | 710.325 | 1262.8 | 1262.8 | 94.71 | 8223.985
Supervision time required (%) | 1 | 1 | 0.5 | 2 | 1 | 1 | 1 | 1 | 8.5
Supervision time (hours/year) | 1262.8 | 1262.8 | 552.475 | 2525.6 | 710.325 | 1262.8 | 1262.8 | 94.71 | 8934.31
Operator - Grade 4 (Laser cutting, bending and painting) | 0.85 | 0.85 | 0.4 |  | 0.5 |  | 0.36 | 0.04 | 3
Operator - Grade 9 Welder |  |  |  | 1.7 |  |  | 0.22 | 0.08 | 2
Technician - Grade 23 |  |  |  |  |  | 0.35 | 0.65 |  | 1
Engineer - Grade II |  |  |  |  |  | 0.5 |  |  | 0.5
Sum of allocated hours (hrs) | 1274.63875 | 1274.63875 | 599.83 | 2549.2775 | 749.7875 | 1274.63875 | 1844.47725 | 179.949 | 9747.2375
Time allocated sufficient (true/false) | TRUE | TRUE | TRUE | TRUE | TRUE | TRUE | TRUE | TRUE | TRUE
Other
Maintenance manwork cost | 4990.862338

Sheet: Energies
Category | Description | Comments | Value | Price (€) (incl tax) | Source
Electricity | Subscription | €/kVA (escl tax) | 38.64 € | 46.37 € | https://www.fournisseurs-electricite.com/edf/pro/tarifs-reglementes/jaune#decomposition-facture
 | Power needed | kVA | 74.4 |  | https://www.fournisseurs-electricite.com/guides/compteur/puissance/estimation
 | Subscription total | € (escl tax) | 2874.82 € | 3449.78 €
 | Price | €/kWh (escl tax) | 0.08 € | 0.09 € | https://www.kelwatt.fr/guide/prix-electricite-entreprise
Water | Water price | €/m3 | 2.77 € | 3.32 € | http://www.eau-direct.fr/gestion/prix.html

Sheet: IT&Office
Categories | Description | Comments | Unit of price | excl tax | incl tax | Total (incl taxe) | Source
Softwares | Fusion 360 | 2 license | /year/user | 373.33 € | 448.00 € | 896.00 € | https://www.autodesk.fr/products/fusion-360/subscribe?plc=F360&term=1-YEAR&support=ADVANCED&quantity=1
 | Office 365 business | x5 (= technician + engineer + operators ) | /month/user | 4.20 € | 5.04 € | 15.12 € | https://products.office.com/fr-fr/compare-all-microsoft-office-products?tab=2
Printing | Printer A3/A4/… Scan/Fax… | x1 | Need depreciation | 224.92 € | 269.90 € | 269.90 € | https://store.hp.com/FranceStore/Merch/Product.aspx?id=G5J38A&opt=A80&sel=PRN
 | Black cartridge 2000 pages | x3 | /year | 41.67 € | 50.00 € | 150.00 € | https://store.hp.com/FranceStore/Merch/Product.aspx?id=L0S70AE&opt=&mastersku=L0S70AE&masteropt=&sel=SUP
 | 4 pack cartridge 1600 pages | x1 | /year | 114.99 € | 137.99 € | 137.99 € | https://store.hp.com/FranceStore/Merch/Product.aspx?id=3HZ52AE&opt=&mastersku=3HZ52AE&masteropt=&sel=SUP
 | A4 *2500 | x2 | /year | 23.60 € | 28.32 € | 56.64 € | https://www.officedepot.fr/a/pb/Papier-Office-Depot-A4-80-g-m2-Blanc-Business-2500-Feuilles/pr=&id=1456200/
 | A3*2500 | x1 | /year | 39.95 € | 47.94 € | 47.94 € | https://www.officedepot.fr/a/pb/Papier-Office-Depot-A3-80-g-m2-Blanc-Everyday-2500-Feuilles/pr=&id=3057842/
Computer | Laptop | 1 (always useful) | Need depreciation | 849.00 € | 2097.60 € | 6292.80 € | https://store.hp.com/FranceStore/Merch/Product.aspx?id=2ZC41ET&opt=ABF&mastersku=2ZC41ET&masteropt=ABF&sel=NTB
 | CAD PC | 2 PC for CAD | Need depreciation | 1791.75 € | 2150.10 € | 4300.20 € | https://store.hp.com/FranceStore/Merch/Product.aspx?id=6QN64ET&opt=ABF&sel=DTP
 | Office computer | x5 (= technician + engineer + operators ) | Need depreciation | 517.00 € | 620.40 € | 3102.00 € | https://store.hp.com/FranceStore/Merch/Product.aspx?id=4CZ83ET&opt=ABF&mastersku=4CZ83ET&masteropt=ABF&sel=DTP
Accessories | Screen 24" | x5 (= technician + engineer + operators ) | Need depreciation | 153.00 € | 183.60 € | 918.00 € | https://store.hp.com/FranceStore/Merch/Product.aspx?id=3ML21AT&opt=ABB&mastersku=3ML21AT&masteropt=ABB&sel=MTO
 | Laptop backpack | 1 for the only laptop | Need depreciation | 45.00 € | 54.00 € | 54.00 € | https://store.hp.com/FranceStore/Merch/Product.aspx?id=1KM17AA&opt=&mastersku=1KM17AA&masteropt=&sel=DEF
 | Keyboard and mouse | 6 for the 6 computers | Need depreciation | 34.00 € | 40.80 € | 244.80 € | https://store.hp.com/FranceStore/Merch/Product.aspx?id=T6T83AA&opt=ABF&mastersku=T6T83AA&masteropt=ABF&sel=ACC
 | Docking station | x1 | Need depreciation | 181.00 € | 217.20 € | 217.20 € | https://store.hp.com/FranceStore/Merch/Product.aspx?id=1MK33AA&opt=ABB&mastersku=1MK33AA&masteropt=ABB&sel=ACC
Internet access | Internet/phone access | 2 standard line, one mobile | /year | 1224.00 € | 1468.80 € | 1468.80 € | Orange Document
Phones | Mobile phone for shop floor | x2 | Need depreciation | 96.00 € | 115.20 € | 230.40 € | https://www.telecomsupplier.fr/avaya-3730-dect-combine.html
 | Phones | x4 | Need depreciation | 285.00 € | 342.00 € | 1368.00 € | https://www.telecomsupplier.fr/avaya-1608-i-ip-telephone-paquet-de-4.html
Categories | Description | Comments | Unit of price | excl tax | incl tax | Total (incl taxe) | Source
Office | Angle worktable | x5 (= technician + engineer + operators ) | Need depreciation | 619.00 € | 742.80 € | 3714.00 € | https://www.francebureau.com/media/catalogue-mobilier/bureau-modulaire-kibo.pdf
 | Drawer | x5 (= technician + engineer + operators ) | Need depreciation | 248.00 € | 297.60 € | 1488.00 € | https://www.francebureau.com/media/catalogue-mobilier/bureau-modulaire-kibo.pdf
 | Shelves without door | x2 | Need depreciation | 320.00 € | 384.00 € | 384.00 € | https://www.francebureau.com/media/catalogue-mobilier/bureau-modulaire-kibo.pdf
 | Shelves with door | x2 | Need depreciation | 515.00 € | 618.00 € | 1236.00 € | https://www.francebureau.com/media/catalogue-mobilier/bureau-modulaire-kibo.pdf
 | Direction worktable | x2 | Need depreciation | 1125.00 € | 1350.00 € | 2700.00 € | https://www.francebureau.com/media/catalogue-mobilier/bureau-direction-etretat.pdf
 | Meeting table | x1 | Need depreciation | 1851.00 € | 2221.20 € | 2221.20 € | https://www.francebureau.com/media/catalogue-mobilier/table-reunion-modulable-arc-reunion.pdf
 | Chair | x10 | Need depreciation | 417.00 € | 500.40 € | 5004.00 € | https://www.francebureau.com/alto-16.html

Sheet: Manufacturing
Category | Description | Comments | Price (€) (excl tax) | Price (€) (incl tax) | Source
Machinery | Convetionnal mill and basic tooling |  | 15000.00 € | 18000.00 € | https://www.machineseeker.fr/mss/schaublin+13
 | Conventionnal Lathe and basic tooling |  | 10000.00 € | 12000.00 € | https://www.surplex.com/fr/vente/c/tours-paralleles-4340.html
Manufacturing tools | Sheet metal bender | For the brackets | 1072 | 1286.40 € | https://www.baileigh.com/sheet-metal-brake-hb-4816e
 | Stock Band saw | For the raw material | 12350.00 € | 14820.00 € | https://www.baileigh.com/semi-auto-band-saw-bs-330sa
 | Drill Press |  | 3954.00 € | 4744.80 € | https://www.baileigh.com/variable-speed-drill-press-dp-1200vs
 | Disc and belt grinder |  | 405.00 € | 486.00 € | https://www.manutan.fr/fr/maf/ponceuse-combinee-disque-bande-jsg-233-promac-230-v
 | Forklift | 1 | 1031.54 € | 1237.848 | https://www.orexad.com/fr/transpalette-galvanise-2-5t/p-G3019000006
 | Vice |  | 245 | 294.00 € | https://www.manutan.fr/fr/maf/etau-magnat
Tool cabinet | Roller cabinet + standard tooling | Tooling kit V3 | 1112.50 € | 1335.00 € | https://www.promeca.com/composition-v5-servante-chrono-6m3-facom-chrono-v5pb-promotion
 | Roller cabinet + standard tooling | Tooling kit V5 | 1739.17 € | 2087.00 € | https://www.master-outillage.com/facom/13765-servante-rouge-7-tiroirs-composition-d-outillage-v8-facom-jetv8m3-3148519073409.html
Organising | Shelves | 5 | 69.40 € | 83.28 € | https://www.orexad.com/fr/fond-tole-rayonnage-a-tablettes-tolees-g-robust/p-G1408010697
 | Stock Shelves | 1 | 1433.25 € | 1719.90 € | https://www.orexad.com/fr/rayonnage-mi-lourd-double-face-horizontale-g-lever/r-PR_G1408014469?
 | Small boxes cart | 1 | 1866.02 € | 2239.22 € | https://www.orexad.com/fr/desserte-de-transport/p-G1359000463
 | Tool holder cart | 1 | 859.65 € | 1031.58 € | https://www.orexad.com/fr/systemes-cn/p-G1359000803
 | Closed drawer | 3 | 699.07 € | 838.88 € | https://www.orexad.com/fr/armoire-a-portes-battantes/p-G1359000412
 | Storage boxes | 30 | 16.90 € | 20.28 € | https://www.orexad.com/fr/bac-rako/p-G1383000092
 | Standard workstation with drawer | 6 | 1001.67 € | 1202.00 € | https://www.orexad.com/fr/etabli-standard/p-G1359000849
 | Standard workstation | 3 | 352.31 € | 422.77 € | https://www.orexad.com/fr/etabli-standard/p-G1359000830
 | Locker | 6 | 2302.57 € | 2763.08 € | https://www.orexad.com/fr/vestiaire-ventile-sur-socle/r-PR_1012867?
Cleaning | Industrial hoover | 2 | 1075.00 € | 1290.00 € | https://www.manutan.fr/fr/maf/aspirateur-eau-et-poussieres-nt-70-2-me-tc-karcher

Sheet: Metrology
Description | Spec | Price (€) (incl tax) | Price (€) (excl tax) | Source
Moveable head Indicator | 0.001mm | 149 € | 124.17 € | https://shop.mitutoyo.fr/web/mitutoyo/fr_FR/mitutoyo/1305010043843/Comparateur%20%C3%A0%20palpeur%20orientable%2C%20mod%C3%A8le%20horizontal/$catalogue/mituto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
Base + movable head indicator | 0.01 | 129 € | 107.50 € | https://shop.mitutoyo.fr/web/mitutoyo/fr_FR/mitutoyo/1305198758390/Comparateur%20%C3%A0%20palpeur%20orientable%2C%20mod%C3%A8le%20horizontal/$catalogue/mituto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
Indicator | 0.01 | 60 € | 50.00 € | https://shop.mitutoyo.fr/web/mitutoyo/fr_FR/mitutoyo/1300888710750/Comparateur%20m%C3%A9canique%2C%20dos%20plat/$catalogue/mitutoyoData/PR/2044SB/index.xhtml
Magnetic stand multiple joint |  | 167 € | 139.17 € | https://shop.mitutoyo.fr/web/mitutoyo/fr_FR/mitutoyo/01.05.03/Support%20articul%C3%A9%20magn%C3%A9ti/$catalogue/mitutoyoData/PR/7019B/index.xhtml
Magnetic stand basic |  | 94 € | 78.33 € | https://shop.mitutoyo.fr/web/mitutoyo/fr_FR/mitutoyo/01.05.033/Base%20magn%C3%A9tique%20avec%20r%C3%A9glage%20fin/$catalogue/mitutoyoData/PR/7011SN/index.xhtml
V Block |  | 282 € | 235.00 € | https://shop.mitutoyo.fr/web/mitutoyo/fr_FR/mitutoyo/01.05.077/Paire%20de%20v%C3%A9s/$catalogue/mitutoyoData/PR/911-111/index.xhtml
Granit surface plate |  | 408 € | 340.00 €
Gauge block set |  | 3322 € | 2768.33 € | https://shop.mitutoyo.fr/web/mitutoyo/fr_FR/mitutoyo/01.07.01/Jeu%20de%20cales%20-%20m%C3%A9trique%20-%20Cert.%20Insp.%20-%20ISO/$catalogue/mitutoyoData/PR/51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
External Micrometer | 0-100 0.001 | 1390 € | 1158.33 € | https://shop.mitutoyo.fr/web/mitutoyo/fr_FR/mitutoyo/01.02.01.0/Microm%C3%A8tre%20DIGIMATIC%20IP65%20en%20jeu%200-100%20mm/$catalogue/mitutoyoData/PR/293-963/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
 | 150-300 0.01 | 1202 € | 1001.67 € | https://shop.mitutoyo.fr/web/mitutoyo/fr_FR/mitutoyo/01.02.01.032/Microm.%20d%27ext%C3%A9rieur%20col%20de%20cygne%20en%20jeu/$catalogue/mitutoyoData/PR/103-91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
 | 100-125 0.01 | 146 € | 121.67 € | https://shop.mitutoyo.fr/web/mitutoyo/fr_FR/mitutoyo/01.02.01.031/Microm.%20d%27ext%C3%A9rieur%20col%20de%20cygne/$catalogue/mitutoyoData/PR/103-141-10/index.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
 | 125-150 0.01 | 162 € | 135.00 € | https://shop.mitutoyo.fr/web/mitutoyo/fr_FR/mitutoyo/01.02.01.031/Microm.%20d%27ext%C3%A9rieur%20col%20de%20cygne/$catalogue/mitutoyoData/PR/103-142-10/index.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
Inside micrometer | 20-50 0.005 | 1623 € | 1352.50 € | https://shop.mitutoyo.fr/web/mitutoyo/fr_FR/mitutoyo/1355993040307/Microm%C3%A8tre%20d%27int%C3%A9rieur%20Holtest%20en%20jeu%2020-50%20mm/$catalogue/mitutoyoD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
 | 12-20 0.005 | 675 € | 562.50 € | https://shop.mitutoyo.fr/web/mitutoyo/fr_FR/mitutoyo/1355993040307/Microm%C3%A8tre%20d%27int%C3%A9rieur%20Holtest%20en%20jeu/$catalogue/mitutoyoData/PR/368-99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
Electronic depth gauge | 0-200 0.01 | 308.00 € | 256.67 € | http://www.starrett.com/metrology/product-detail/3753A-8~200
Profil projector | 510x342 mm | 58001.77 € | 48334.81 € | https://www.orexad.com/fr/projecteur-de-profil-pj-h30/p-G1213001821
Measurement column | 600mm | 6468 | 5390.00 € | https://www.orexad.com/fr/colonne-de-mesure-817clm-cap-600-770-pupitre-2d/p-G1197000019

Sheet: Milling
Equipements
Description | Spec info | Price HT | Price TTC | Source
Reference of the CNC Mills |  |  | 0.00 € | https://www.haascnc.com/shop/category/pricelist.html
Chosen CNC Mill | VF-3SSYT | 79995.00 € | 95994.00 € | https://www.haascnc.com/machines/vertical-mills/vf-series/models/medium/vf-3ssyt.html
Tool Holder | Qty:40 | 100.00 € | 120.00 € | https://www.hoffmann-group.com/FR/fr/hof/Accessoires-machines/Porte-outils/c/30
Milling vise | 2500.00 € | 2083.33 € | 2500.00 € | https://www.hoffmann-group.com/FR/fr/hof/Accessoires-machines/Etaux/Etau-haute-pression-CN---NC8/p/360405-125L
Description | Spec info | Value |  | Source
Technical info | Rotation per minute (rpm) | 12000.00 |  | https://www.haascnc.com/machines/vertical-mills/vf-series/models/medium/vf-3ssyt.html
 | Travel (x,y,z) (mm) | 1016,660,635
 | Power (kW) | 22.40
 | Nominal torque and rpm | 122Nm @ 2000rpm
 | Max cutting speed | 21.2m/min
 | Max load on axis | 13723N
 | electrospindle | yes
 | table dimensions (mm) | x=1372, y=610
 | Material
 | Coolant
 |  | Value | Provider | Source
 | Coolants references |  |  | https://www.otelo.fr/catalogue/fluides-huiles-coupe-solubles.html
 | Coolant chosen |  | Rocol Ultra cut 250+ | https://www.otelo.fr/catalogue/huile-coupe/rocol-0003050209-skg.html
 | Price (€ incl tax/L) | 10.58 € |  | Need 200L/year

Sheet: 3D Laser Cutting
Equipements
Description | Spec info | Price HT | Price TTC | Source
Laser cutter tube Fiber |  | 833333.33 € | 1000000.00 € | Chosen one
Laser cutter tube C02 |  | 625000.00 € | 750000.00 €
Revision price | (€/year) (3 days /machine) | 8333.33 € | 10000.00 € | Discussion with our partner Noel Métal
Consumables | (€/year) lences, buses… | 1250.00 € | 1500.00 €
Water draining | (€/year) | 1250.00 € | 1500.00 €
 | Operation
 | Programation on the machine
 |  | Value | Source
 | Programation time / tube (min) | 5
 | Loading of the machine
 |  | Value | Source
 | Loading time if raw < 6m (min) | 5 | Discussion with our partner Noel Métal
 | Loading time if raw > 6m (min) | 1
 | Cutting
 |  | Value | Source
 | Cutting time for little sections (s/cut) | 3 | Discussion with our partner Noel Métal (little section <254mm)
 | Cutting time for big sections (s/cut) | 40
 | Graving time (s) | 10
 |  | Value | Source
 | Time (s/tube) if raw < 6m | 613 | Discussion with our partner Noel Métal
 | Time (s/tube) if raw > 6m | 373
 | Cost of operator (€/tube) if raw < 6m | 3.98 €
 | Cost of operator (€/tube) if raw > 6m | 2.42 €

Sheet: 2D Laser Cutting
Equipements
Description | Spec info | Price HT | Price TTC | Source
Laser 2D cutter Baileigh | 1500x3000x8mm max | 100605.33 € | 120726.40 € | https://www.baileigh.com/cnc-laser-table-fl-510hd-500
Cutting metal products |  |  |  | https://www.bosslaser.com/metal-cutting-product/
Assist gas 02 |  | 105.00 € | 126.00 € | https://www.cedeo.fr/p/outillage-et-equipements/oxygene-grande-bouteille-10-6m3-ref-g110-i1001l50r2a001-A1204487
Description | Spec info | Value |  | Source
Dimensions of Laser 2D cutter | 1500x3000x8mm max
Power (kW) | 7.5
Assist gas 02 flow and pressure needed | 10.6m^3 @ 200bar + 4,5 hrs of cutting
Time of cutting per bottle |  |  |  | https://fr.wikipedia.org/wiki/Loi_de_Boyle-Mariotte
Calcul of cutting time (min/mm²)
 | Thickness (mm) | mm/min | min/mm^2
Mild Steel | 0.81 | 19812 | 6.231414805e-05
 | 1.63 | 5842 | 0.0001050148806
 | 2.31 | 3175 | 0.000136346593
 | 3.26 | 2184.4 | 0.0001404268752
 | 4.12 | 1879.6 | 0.0001291330318
 | 5.82 | 1498.6 | 0.0001146545481
 | 6.35 | 1270 | 0.000124000248
 | 7.938 | 762 | 0.0001653232499
 | 9.525 | 584.2 | 0.0001797105043
Medium removal rate (min/mm²) | 0.0001368262414
Stainless | 0.81 | 19812 | 6.231414805e-05
 | 1.63 | 5486.4 | 0.0001118214006
 | 2.31 | 1879.6 | 0.0002303151909
 | 3.26 | 1193.8 | 0.0002569513036
 | 4.12 | 609.6 | 0.0003981601814
Medium removal rate (min/mm²) | 0.0002119124449
Aluminium | 0.81 | 7620 | 0.0001620167849
 | 1.63 | 3048 | 0.0002012785212
 | 2.31 | 711.2 | 0.0006086901475
Medium removal rate (min/mm²) | 0.0003239951512
Price of Oxygen (€/min)
Data | Debit (L/min) | Pressure (bar) | Volume (L)
Oxygen 45CFM@90PSI | 1273.5 | 62 | 10600
1CFM = 28,3L/min
1PSI =6 894,76N/m² | Cutting time per bottle (s)
Mariotte Law : t(min) = P(bar)*V(L)/Q(L/min) | 30963.48645
Lenght cuttable per bottle (mm²)
3771631.102

Sheet: Welding
Equipements
Description | Spec info | Price TTC | Price HT | Source
Tig Welder AC/DC |  | 5908.19 € | 4923.49 € | https://www.promeca.com/poste-a-souder-tig220-ac-dc-ta34-ref-eau-esab-caddy-tig2200iac-dc
Tig Chiller |  | 1221.50 € | 1017.92 € | https://www.orexad.com/fr/refroidisseurs-cool-arc/p-G1189001474
Fume extractor |  | 3546.58 € | 2955.48 € | https://www.orexad.com/fr/mobiflex-200-m-systeme-d-aspiration-des-fumees/p-G1189001541
Welding table | 4000x2000 + adjustable height | 5220.00 € | 4350.00 € | https://lastafelshop.com/product/welding-table-4000-x-2000-complete/?lang=en
Squares | complete pack | 393.60 € | 328.00 € | https://fireballtool.com/magic-pack-plus/
Clamping devices | complete pack | 1422.00 € | 1185.00 € | https://lastafelshop.com/product/starter-packet-big/?lang=en
Welding helmet |  | 182.12 € | 151.77 € | https://www.promeca.com/cagoule-speedglas-100v-noir-751120
Clothes/gloves |  | 116.00 € | 96.67 € | https://www.promeca.com/soudage-et-accessoires/equipements-du-soudeur/vetements-specifiques-du-soudeur
 | Material
 | Neutral gas : Argon, quality 2.2
 |  | Value | Provider | Source
 | Price for one bottle (€ HT) | 200.00 € | Conversations with our partner Bery Inox
 | Consumption (unity = bottles/year) | 18
 | Consumption for exhaust system (unity = bottles) | 0.39
 | Lenght of welding for exhaust system (m) | 5.5
 | Price (€/m) | 14.35 €
 | Metal rod : Ø ??? mm TIG acier 35CrMo4
 |  | Value | Source
 | Price (€/kg, HT) | 78 | Conversations with our partner La Giraudière
 | Radius (mm) | 1.6
 | Consumption (m of metal rod / m of welding) | 1.3
 | Weight by welding rod (kg/m) | 0.06273132211
 | Price of welding metal (€/m, HT) | 4.89 €
 | Welding (set up, Tack welding, welding and verification)
 |  | Value | Source
 | Time of the Welding (h) | 120 | Conversation with our partners (Bery Inox and La Giraudière)
 | Cost of operator (€/h) | 55.67 €
 | Cost of operator (€ HT) | 6680.01 €
 | Overall Welding cost (€ HT) | 6699.26 €

Sheet: Conventional Machinery
Category | Description | Comments | Price (€) (excl tax) | Price (€) (incl tax) | Source
Machinery | Convetionnal mill and basic tooling |  | 15000.00 € | 18000.00 € | https://www.machineseeker.fr/mss/schaublin+13
 | Conventionnal Lathe and basic tooling |  | 10000.00 € | 12000.00 € | https://www.surplex.com/fr/vente/c/tours-paralleles-4340.html

Sheet: Body Manufacturing
Tooling
Description | Spec info | Price HT | Price TTC | Source
Drill | Makita 18V Drilling machine + batteries | 280.83 € | 337.00 € | https://www.manomano.fr/p/perceuse-visseuse-18-v-li-ion-4-ah-13-mm-3-batteriesmakita-ddf482rm3j-1442275
Nail gun | Makita 18V Pin Nailer | 573.33 € | 688.00 € | https://www.manomano.fr/p/cloueuse-sans-fil-2-batteries-makita-dbn600rtj-1-pcs-10186275
Sander | Makita 310W Orbital Sander | 158.33 € | 190.00 € | https://www.manomano.fr/p/ponceuse-excentrique-310w-150mm-dans-makpac-makita-bo6030j-19544979?model_id=50464
JigSaw | Makita 720W JigSaw | 154.17 € | 185.00 € | https://www.manomano.fr/p/scie-sauteuse-pendulaire-4351fctk-makita-28080
Air Compressor | Michelin Air Compressor 270L | 1495.83 € | 1795.00 € | https://www.manomano.fr/catalogue/p/michelin-compresseur-270-litres-75-cv-14bars-19634090?model_id=19632092
Roller for resin | Combined roller Aluminium - D15 X140 | 14.92 € | 17.90 € | https://ecomposites.fr/outillage/107-ebulleur-aluminium-combine-d15-x140.html
Roller for resin | Combined roller Aluminium - D45 X70 | 15.75 € | 18.90 € | https://ecomposites.fr/outillage/53-ebulleur-combine-d45x70.html
Kit for resin application | Brush + rollers + gloves | 14.08 € | 16.90 € | https://ecomposites.fr/les-kits/86-kit-resine-gelcoat.html
Spray gun |  | 1746.25 € | 2095.50 € | https://www.esska.fr/shop/Pistolet-pulverisateur-a-2-composants-pilote-mixte-N-melange-exterieur--762432000003-8820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
Machining
Description | Spec info | Price HT | Price TTC | Source
CNC Mill | JOBS Jomach 21 (X3000 Y1600 Z1000mm) | 250000.00 € | 300000.00 € | Partner references
Spray station | All resin types | 25675.00 € | 30810.00 € | https://www.esska.fr/shop/Unite-de-pulverisation-de-fibres-avec-bras-de-mixage-externe-et-chassis-elargi--ipsb-8000-4880
Woodworking station | Leman 6 operations | 5825.00 € | 6990.00 € | https://www.outillage2000.com/machines-a-bois/combines-a-bois/combinee-leman-6-operations-mono-4722.html
Material
Description | Spec info | Price HT/m² | Price TTC/m² | Source
 | €/m² or (€/kg and kg/m²)
Epoxy surfaces gelcoat colorless | 104€/kg and 0,24kg/m² = 25€/m² | 24.96 € | 29.95 € | https://www.mack-kayak.com/gel-coats-polyester-et-epoxy/1332-gel-coat-epoxy-incolore-moulage.html
Glass twill fabric | 6,45€/m² | 6.45 € | 7.74 € | https://www.mack-kayak.com/tissus-techniques/578-carbone-serge-200g-3k.html
Biaxial glass cloth 370g | 8,20€/m² | 8.20 € | 9.84 € | https://www.castrocompositesshop.com/fr/fibres-de-renforcement/1197-450-g-m2-de-fibre-de-verre-tiss%C3%A9-biaxiale-45-45.html
Epoxy infusion resin | 20€/kg and 2kg/m² = 40€/m² | 40.00 € | 48.00 € | https://www.epodex.com/de/produkt/proplus-system/
Discussion with S2MA
What do you use to do the bodywork nose ? | 1 gelcoat de surface époxy incolore : utilisé 300g
 | 1 sergé verre de 200g avec voile de surface : utilisé 2.5m²
 | 1 tissu de verre biaxial 370g : utilisé 2.5m²
 | 1 tissu sergé verre 200g : utilisé 2.5m²
 | Résine d'infusion époxy : utilisé 2.5kg
 | + bache à vide , tissus et accessoires techniques pour réaliser l'infusion.
 | Utilisation d'une pompe à vide.
How long does it take ? (50h, 1 person) | 5h to cut the glass fibers
 | 8h to apply layers on the master
 | 8h to apply the resin
 | 2h of cleaning
 | 5h to cast in the master
 | 10h to smooth the surface
 | 5h to cut the last holes and the final part
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
