EOSCogniton/ELIZ-2021/CR_Cost_Report/01_BOM/00_Cost_Report_Document/Ressources COST Model/Cost_v1.5.xlsx

Sheet: Summary
General Data |  |  |  | Overheads cost |  |  |  |  | Manufacturing cost
Category | Description | Value | Explanation | Category | Description | Cost | Depreciation time (year) | Cost/year | OP |  | Description | Variable | Way of costing | Cost | Depreciation time (year) | Cost/year
Manpower | Operator | 21376.00 € | Cost per year | Metrology | Micrometres | 2320.00 € | 10 | 232.00 € | Milling |  | 3 Axis CNC Mill Direct | No |  | 108020.00 € | 10 | 10802.00 €
 | Technician | 39809.00 € |  |  | Inside micrometers | 1838.40 € | 10 | 183.84 € | Power consumption (kW) | 22.4 | Milling tool holders | No |  | 4000.00 € | 5 | 800.00 €
 | Engineer | 69843.00 € |  |  | Indicators | 1272.00 € | 10 | 127.20 € | OPE | 80% | Fixtures | No |  | 2500.00 € | 5 | 500.00 €
 | Sales/administrative | 39809.00 € |  |  | Profile projector | 48334.81 € | 10 | 4833.48 € | OPM per job (Cleaning in min) | 5 | Maintenance | No | 5 % of initial cost /year | 5401.00 € | 1 | 5401.00 €
Time | Hours/week | 35 |  |  | Reference Block | 3209.60 € | 10 | 320.96 € | Removal rate (for Aluminium) (min/mm^3) | 0.0001 | Electricity | Yes | Cost/hour | 1.40 €
 | Week/year | 45.6 |  |  | Depth gauges | 492.90 € | 10 | 49.29 € | Programming time and supply order / mm^3 (50% of machining time) | 5e-05 | Cutting tools | Yes | €/hour | 20.00 €
 | Base OPE | 80% | Because prototyping company so not running all time, 6 percent used for maintenance and cleaning of shop floor |  | Measurement column | 5390.00 € | 10 | 539.00 € | Measuring and deflash time / mm^3 (40% of machining time) | 4e-05 | Cutting fluid | Yes | Refilling/year (1time) | 88.03 € | 1 | 88.03 €
 | People efficiency | 95% | People not working all time, need to pay them during this time | Real Estate | Electricity subscription | 2874.82 € | 1 | 2874.82 € | Setup time (fixture and tools) (min) | 20
Energies | Electricity Subscription | 2874.82 € |  |  | Electricity consumption for office and small components (avg 16kW) | 1999.47 € | 1 | 1999.47 € | Turning |  | CNC lathe with Y Axis | No |  | 133720.00 € | 10 | 13372.00 €
 | Electricity Rate /kWh | 0.08 € |  |  | Water (60m^3) | 132.96 € | 1 | 132.96 € | Power consumption (kW) | 29.8 | Turning tool holders | No |  | 19200.00 € | 10 | 1920.00 €
 | Water rate/m3 | 2.22 € |  | Manwork | Administrative/sales people | 39809.00 € | 1 | 39809.00 € | OPE | 80% | Turning insert holders | No |  | 4800.00 € | 5 | 960.00 €
Others | Euro --> Dollar Rate | 1.12964 |  |  | 40% engineer | 27937.20 € | 1 | 27937.20 € | OPM per job (Cleaning in min) | 5 | Maintenance | No | 5 % of initial cost /year | 6686.00 € | 1 | 6686.00 €
 | TVA | 20% |  |  | 5% of manwork OPE on shopfloor | 11403.29 € | 1 | 11403.29 € | Removal rate (for Aluminium) (min/mm^3) | 0.0001 | Electricity | Yes | Cost/hour | 1.87 €
 |  |  |  |  | Maintenance manwork | 13837.05 € | 1 | 13837.05 € | Programming time and supply order/ mm^3 (50% of machining time) | 5e-05 | Cutting tools | Yes | Cost/hour | 10.00 €
 |  |  |  | IT | Computers | 6843.36 € | 3 | 2281.12 € | Measuring and deflash time / mm^3 (40% of machining time) | 4e-05 | Cutting fluid | Yes | Refilling/year (1time) | 88.03 € | 1 | 88.03 €
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
