EOSCogniton/ELIZ-2021/CR_Cost_Report/01_BOM/BR/BR_A0100/BR_A0100_Picture.png

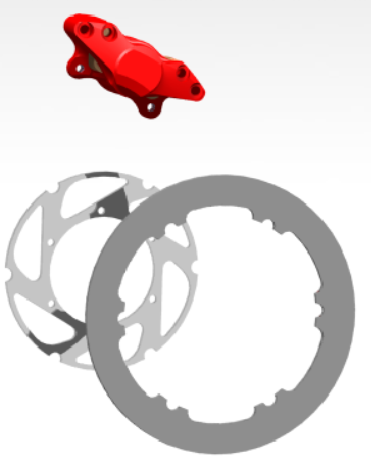
CR_Cost_Report/01_BOM/BR/BR_A0100/BR_A0100_Picture.png
