EOSCogniton/ELIZ-2021/CR_Cost_Report/01_BOM/BR/BR_A0200/BR_02002_Picture.png

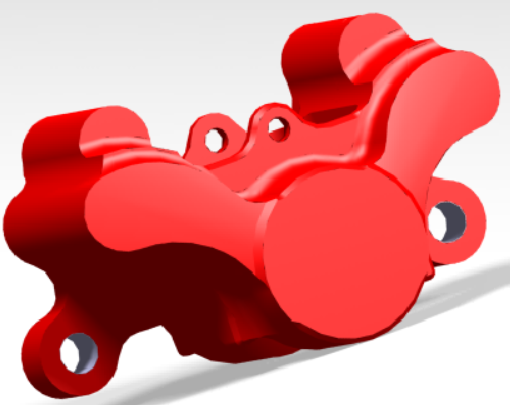
CR_Cost_Report/01_BOM/BR/BR_A0200/BR_02002_Picture.png
