EOSCogniton/ELIZ-2021/CR_Cost_Report/01_BOM/EN/EN_A0100 (Engine)/EN_01004_Picture.jpg

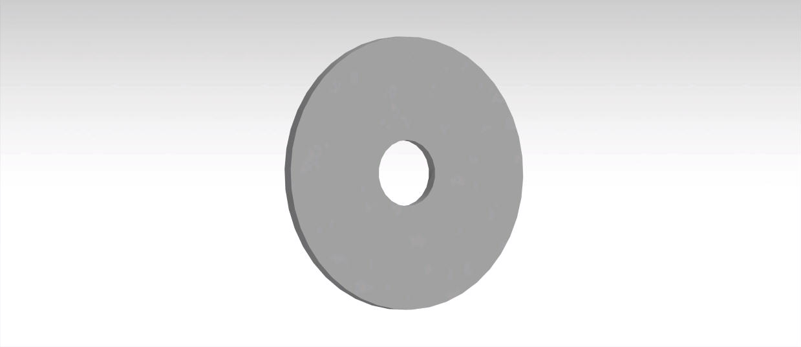
CR_Cost_Report/01_BOM/EN/EN_A0100 (Engine)/EN_01004_Picture.jpg
