EOSCogniton/ELIZ-2021/CR_Cost_Report/01_BOM/EN/EN_A0200 (Cooling System)/EN_02002_Picture.jpg

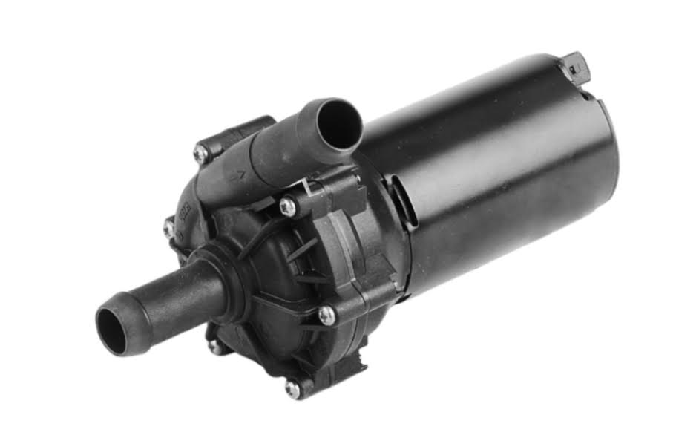
CR_Cost_Report/01_BOM/EN/EN_A0200 (Cooling System)/EN_02002_Picture.jpg
