EOSCogniton/ELIZ-2021/CR_Cost_Report/01_BOM/EN/EN_A0300 (Overflow Bottles)/EN_A0300_Picture.jpg

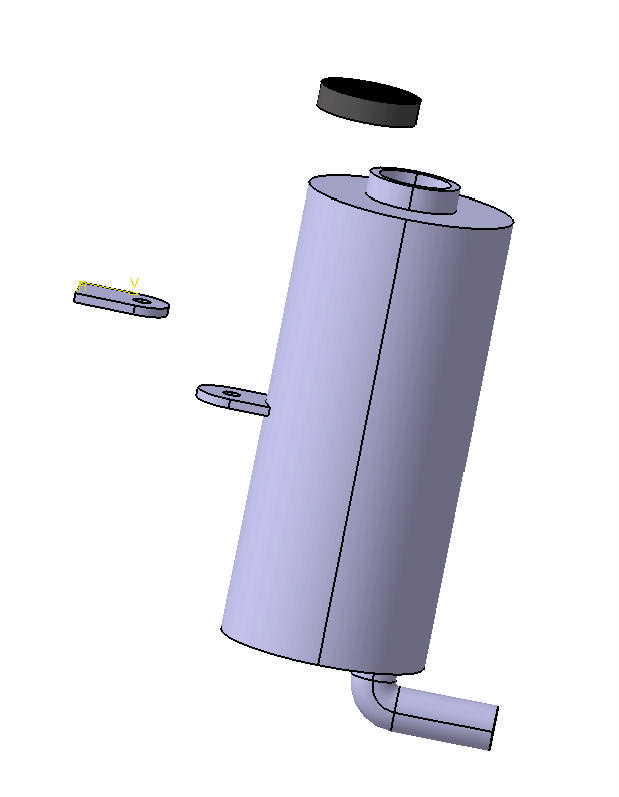
CR_Cost_Report/01_BOM/EN/EN_A0300 (Overflow Bottles)/EN_A0300_Picture.jpg
