EOSCogniton/ELIZ-2021/CR_Cost_Report/01_BOM/FR/FR_A0900/FR_090012-15 EN.png

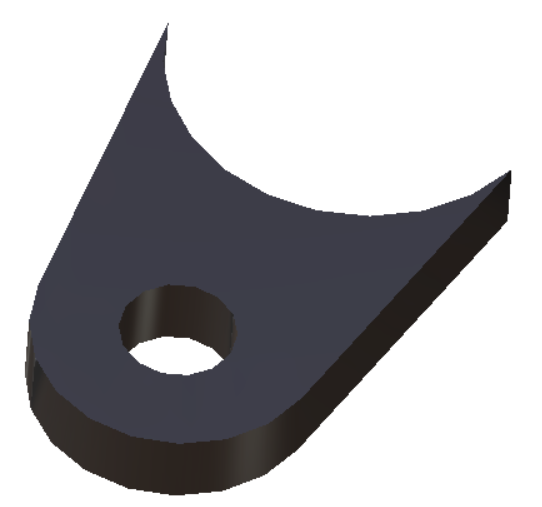
CR_Cost_Report/01_BOM/FR/FR_A0900/FR_090012-15 EN.png
