EOSCogniton/ELIZ-2021/CR_Cost_Report/01_BOM/FR/FR_A1100/FR_12001 MS_Picture.png

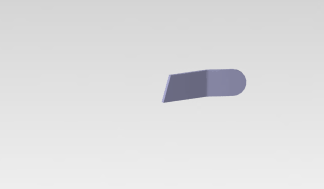
CR_Cost_Report/01_BOM/FR/FR_A1100/FR_12001 MS_Picture.png
