EOSCogniton/ELIZ-2021/CR_Cost_Report/01_BOM/FR/FR_A1200/FR_12004 ST.png

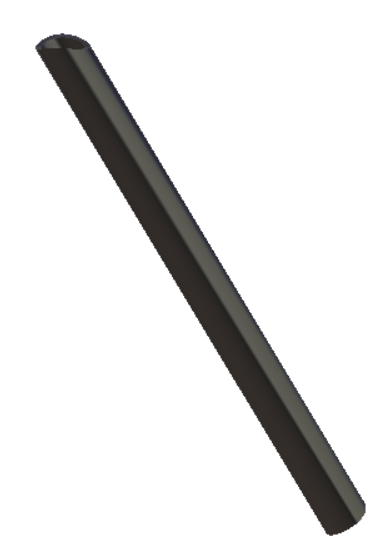
CR_Cost_Report/01_BOM/FR/FR_A1200/FR_12004 ST.png
