EOSCogniton/ELIZ-2021/CR_Cost_Report/01_BOM/FR/FR_A1200/FR_12006-8 ST-2.png

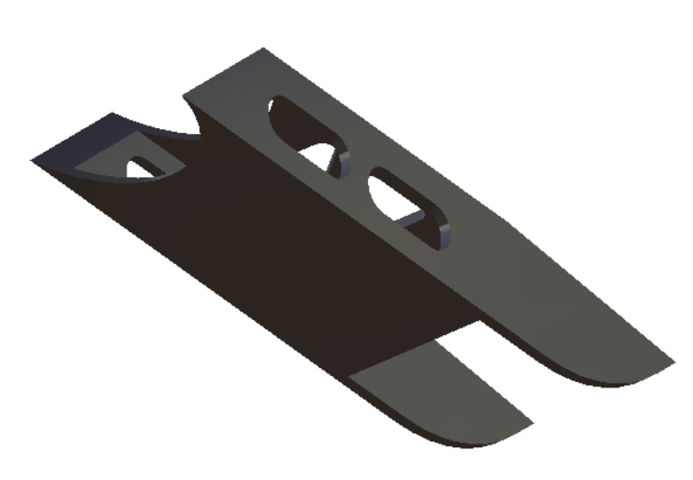
CR_Cost_Report/01_BOM/FR/FR_A1200/FR_12006-8 ST-2.png
