EOSCogniton/ELIZ-2021/CR_Cost_Report/01_BOM/FR/FR_A1200/FR_13001Y ST_Picture.jpg

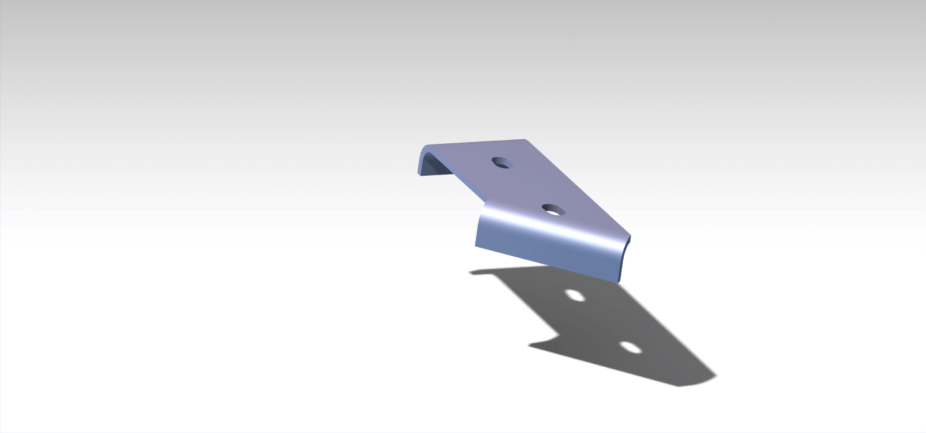
CR_Cost_Report/01_BOM/FR/FR_A1200/FR_13001Y ST_Picture.jpg
