EOSCogniton/ELIZ-2021/CR_Cost_Report/01_BOM/FR/FR_A1300/FR_13002 SU.png

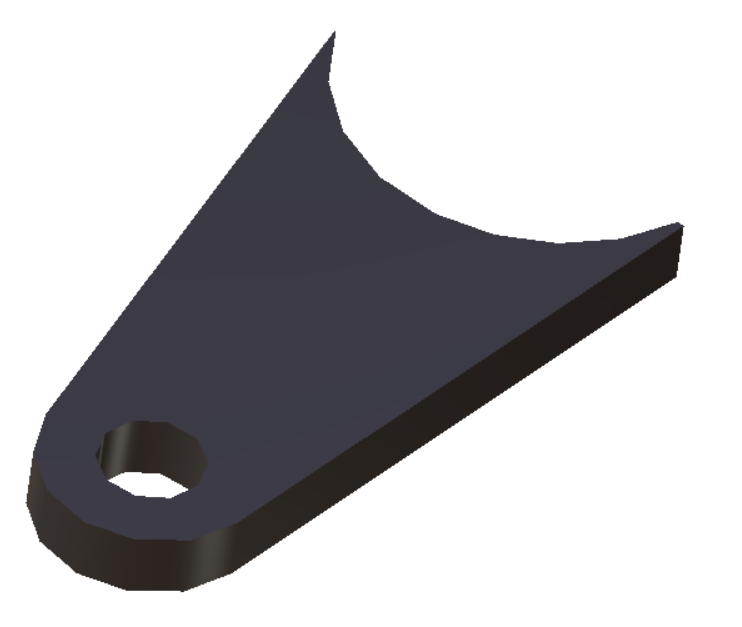
CR_Cost_Report/01_BOM/FR/FR_A1300/FR_13002 SU.png
