EOSCogniton/ELIZ-2021/CR_Cost_Report/01_BOM/MS/MS_A0200/MS_02002_Picture.png

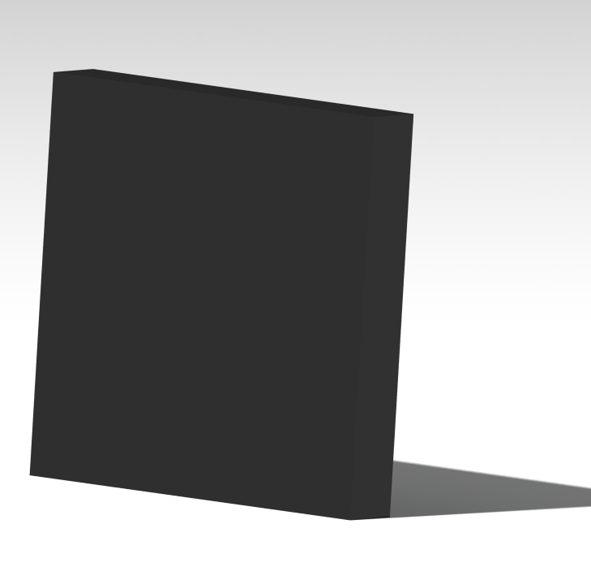
CR_Cost_Report/01_BOM/MS/MS_A0200/MS_02002_Picture.png
