EOSCogniton/ELIZ-2021/CR_Cost_Report/01_BOM/MS/MS_A0300/MS_03003_Picture.png

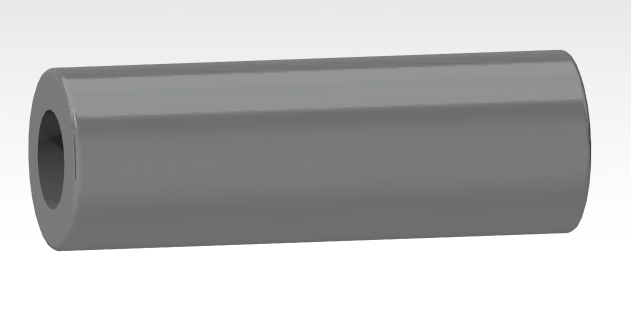
CR_Cost_Report/01_BOM/MS/MS_A0300/MS_03003_Picture.png
