EOSCogniton/ELIZ-2021/CR_Cost_Report/01_BOM/MS/MS_A0400/MS_04003_Picture.png

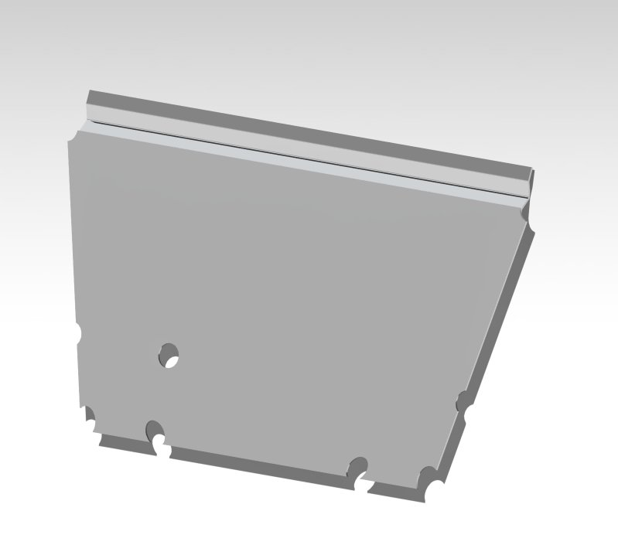
CR_Cost_Report/01_BOM/MS/MS_A0400/MS_04003_Picture.png
