EOSCogniton/ELIZ-2021/CR_Cost_Report/01_BOM/ST/ST_A0300/ST_03004_Picture.jpg

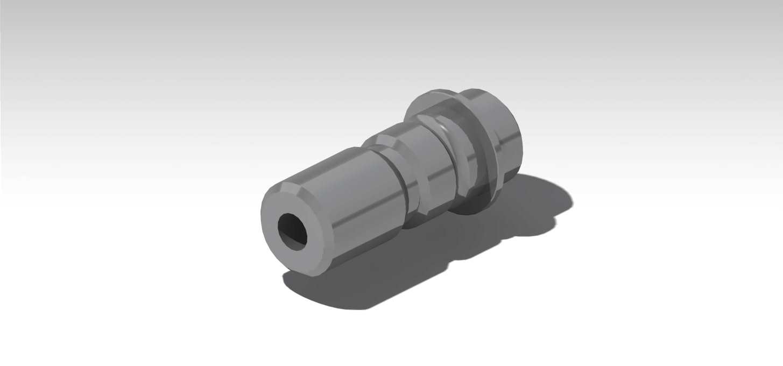
CR_Cost_Report/01_BOM/ST/ST_A0300/ST_03004_Picture.jpg
