EOSCogniton/ELIZ-2021/CR_Cost_Report/01_BOM/ST/ST_A0400/ST_04003_Picture.jpg

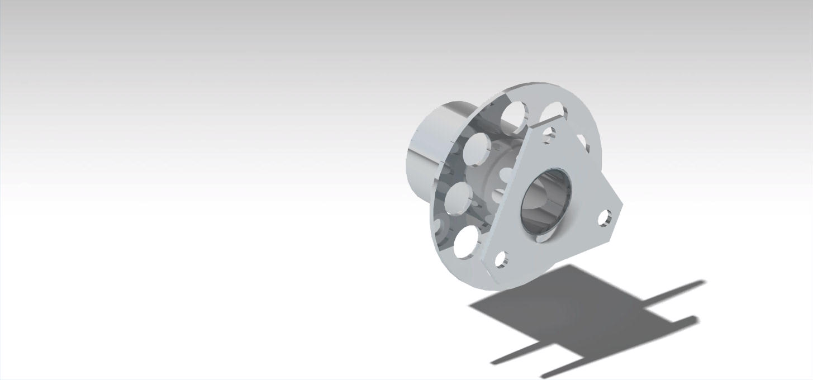
CR_Cost_Report/01_BOM/ST/ST_A0400/ST_04003_Picture.jpg
