EOSCogniton/ELIZ-2021/CR_Cost_Report/01_BOM/SU/SU_A0100/SU_01001_Picture.png

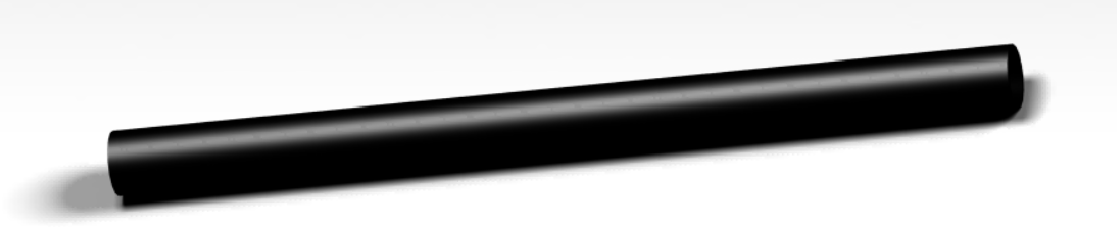
CR_Cost_Report/01_BOM/SU/SU_A0100/SU_01001_Picture.png
