EOSCogniton/ELIZ-2021/CR_Cost_Report/01_BOM/SU/SU_A0100/SU_01004_Picture.jpg

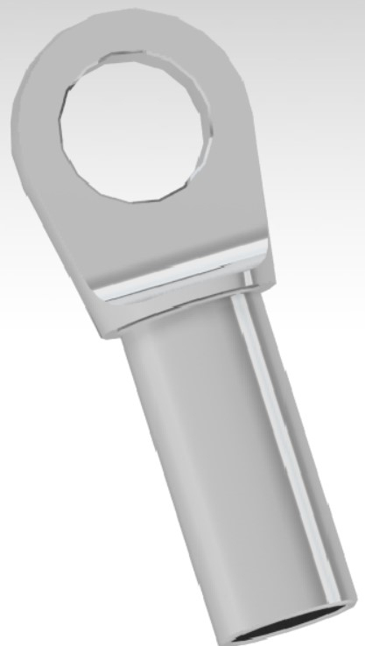
CR_Cost_Report/01_BOM/SU/SU_A0100/SU_01004_Picture.jpg
