EOSCogniton/ELIZ-2021/CR_Cost_Report/01_BOM/SU/SU_A0200/SU_02003_Picture.png

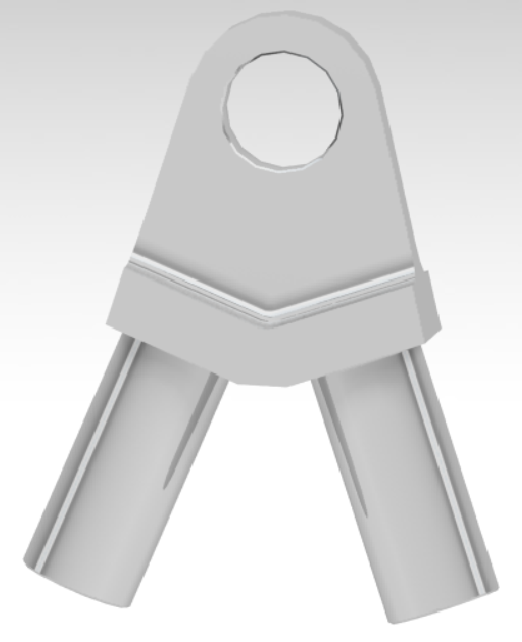
CR_Cost_Report/01_BOM/SU/SU_A0200/SU_02003_Picture.png
