EOSCogniton/ELIZ-2021/CR_Cost_Report/01_BOM/SU/SU_A0200/SU_A0200_Picture.png

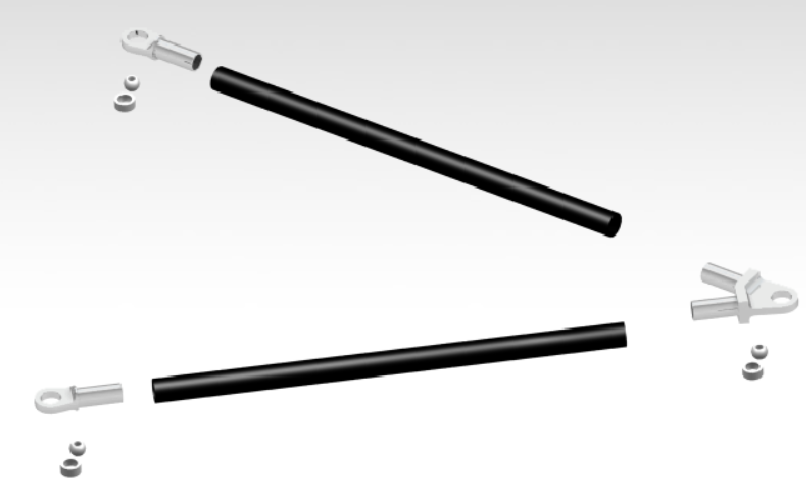
CR_Cost_Report/01_BOM/SU/SU_A0200/SU_A0200_Picture.png
