EOSCogniton/ELIZ-2021/CR_Cost_Report/01_BOM/SU/SU_A0300/SU_A0300_Picture.png

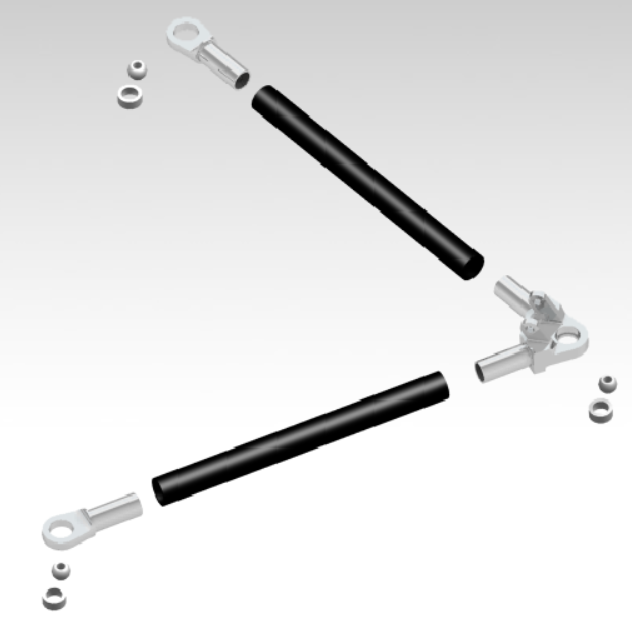
CR_Cost_Report/01_BOM/SU/SU_A0300/SU_A0300_Picture.png
