EOSCogniton/ELIZ-2021/CR_Cost_Report/01_BOM/SU/SU_A0400/SU_04003_Picture.png

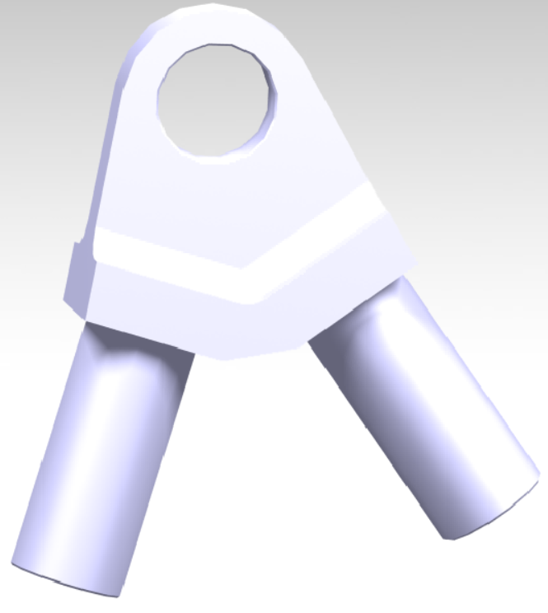
CR_Cost_Report/01_BOM/SU/SU_A0400/SU_04003_Picture.png
