EOSCogniton/ELIZ-2021/CR_Cost_Report/01_BOM/SU/SU_A0500/SU_05002_Picture.png

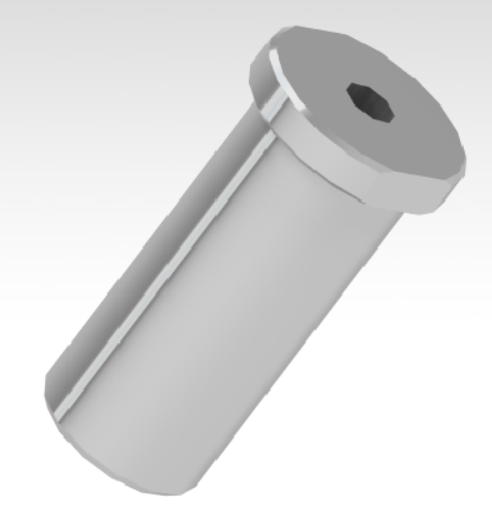
CR_Cost_Report/01_BOM/SU/SU_A0500/SU_05002_Picture.png
