EOSCogniton/ELIZ-2021/CR_Cost_Report/01_BOM/WT/WT_A0100/WT_01001_Picture.jpg

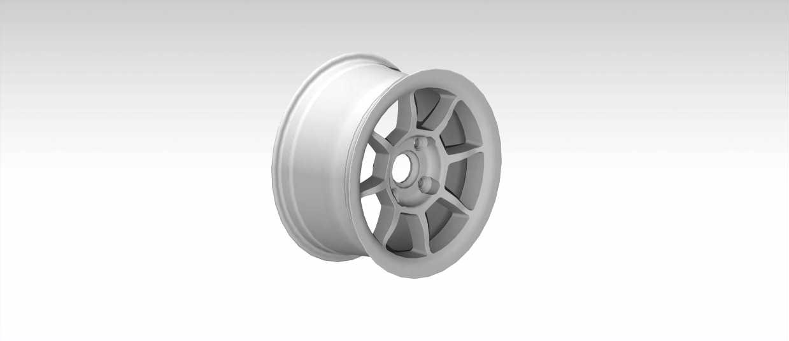
CR_Cost_Report/01_BOM/WT/WT_A0100/WT_01001_Picture.jpg
