EOSCogniton/ELIZ-2021/CR_Cost_Report/01_BOM/WT/WT_A0200/WT_02005_Picture.jpg

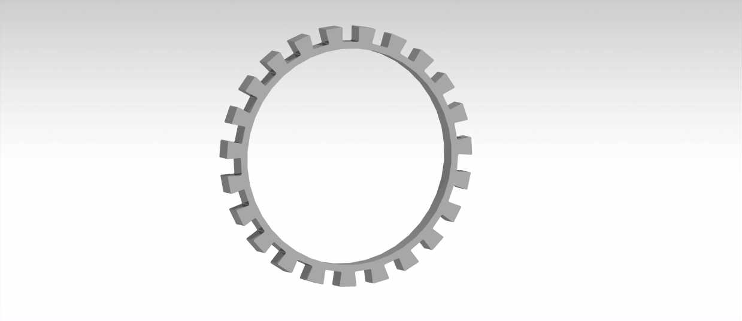
CR_Cost_Report/01_BOM/WT/WT_A0200/WT_02005_Picture.jpg
