EOSCogniton/ELIZ-2021/CR_Cost_Report/01_BOM/WT/WT_A0300/WT_A0300_Picture.jpg

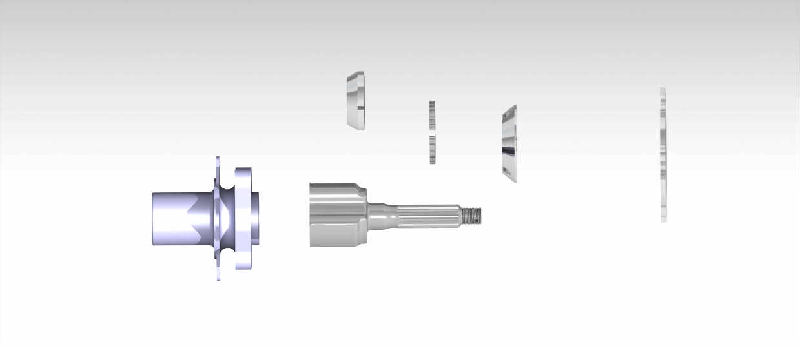
CR_Cost_Report/01_BOM/WT/WT_A0300/WT_A0300_Picture.jpg
