EOSCogniton/ELIZ-2021/CR_Cost_Report/Images_CRD/FR_02001_picture.PNG

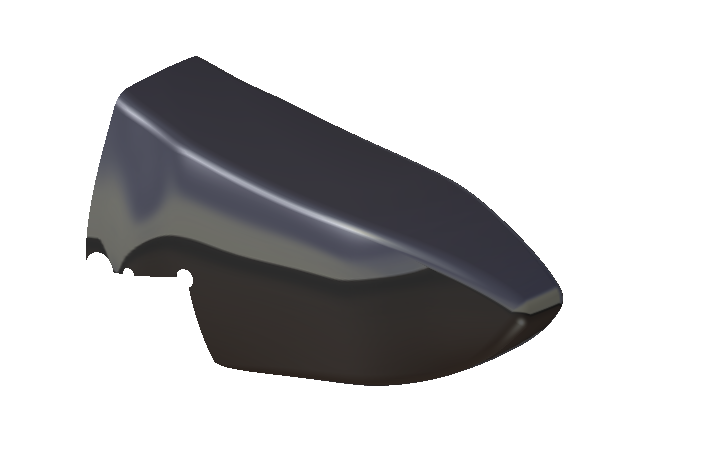
CR_Cost_Report/Images_CRD/FR_02001_picture.PNG
