EOSCogniton/ELIZ-2021/CR_Cost_Report/Images_CRD/FR_02003_Picture.PNG

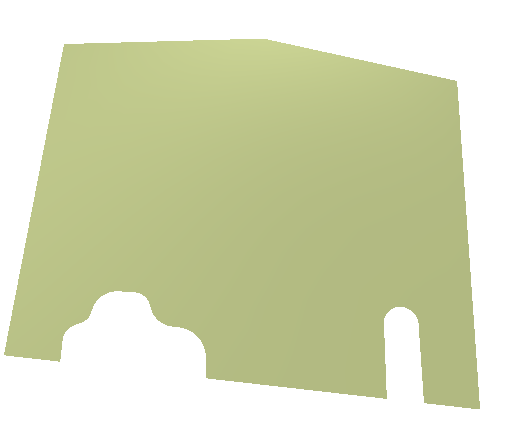
CR_Cost_Report/Images_CRD/FR_02003_Picture.PNG
