EOSCogniton/ELIZ-2021/CR_Cost_Report/Images_CRD/FR_03010_Picture.PNG

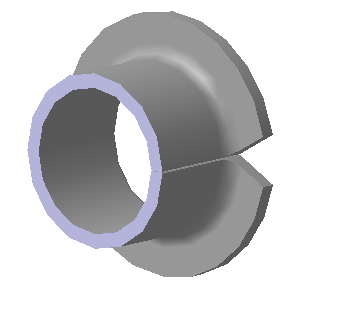
CR_Cost_Report/Images_CRD/FR_03010_Picture.PNG
