EOSCogniton/ELIZ-2021/CR_Cost_Report/Images_CRD/FR_04001_Picture.PNG

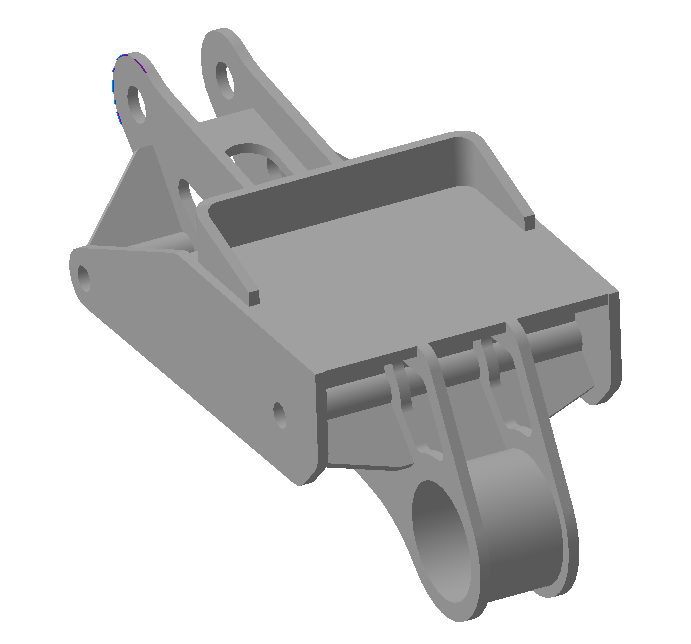
CR_Cost_Report/Images_CRD/FR_04001_Picture.PNG
