EOSCogniton/ELIZ-2021/CR_Cost_Report/ZZ-Ressources/00_Compléments/Slides_FS_ATA/differences FSGvsFSATA.png

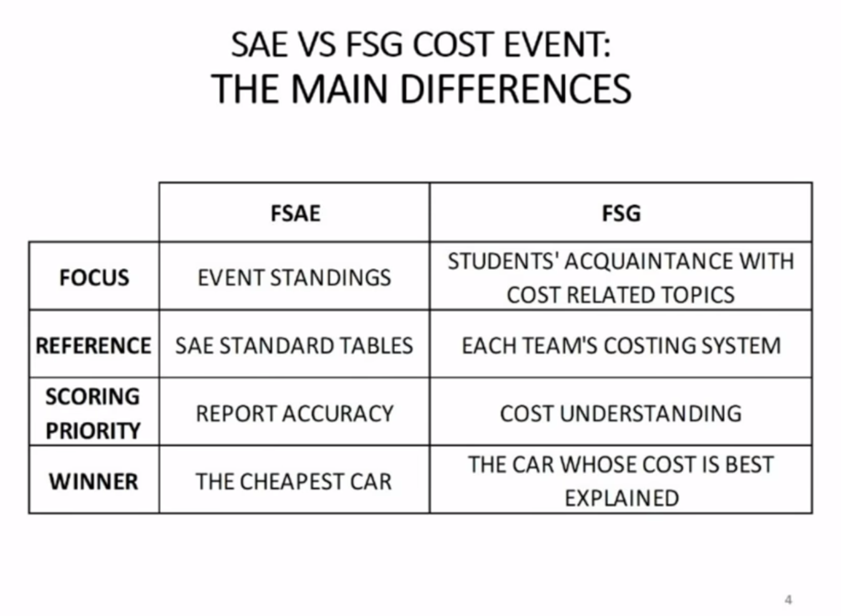
CR_Cost_Report/ZZ-Ressources/00_Compléments/Slides_FS_ATA/differences FSGvsFSATA.png
