EOSCogniton/ELIZ-2021/CR_Cost_Report/ZZ-Ressources/05-REAL_CASES/FS_ATA/software_development.jpg

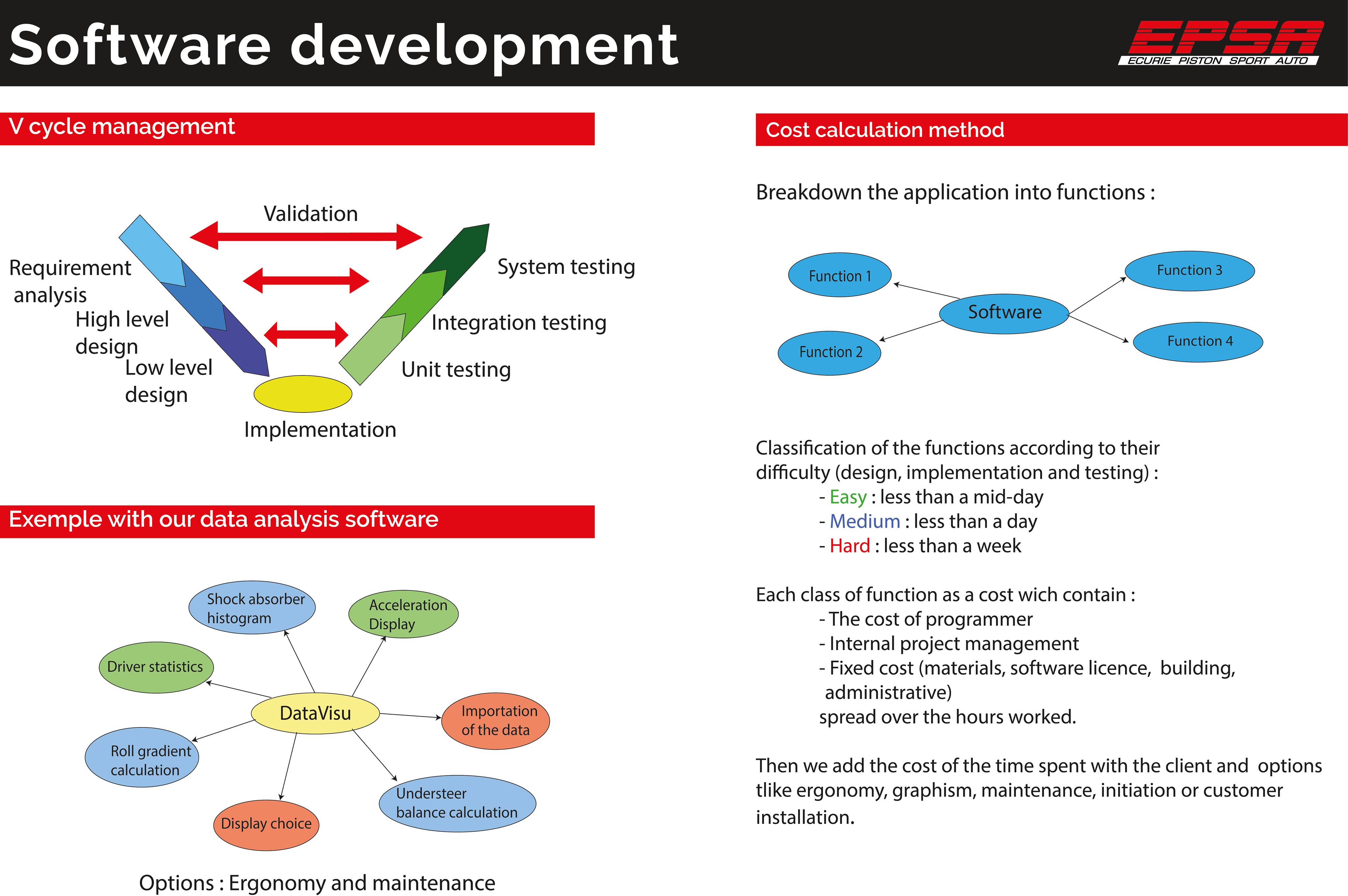
CR_Cost_Report/ZZ-Ressources/05-REAL_CASES/FS_ATA/software_development.jpg
