EOSCogniton/ELIZ-2021/CR_Cost_Report/ZZ-Ressources/2019_RENDUS_COMPET/FSN/proof.JPG

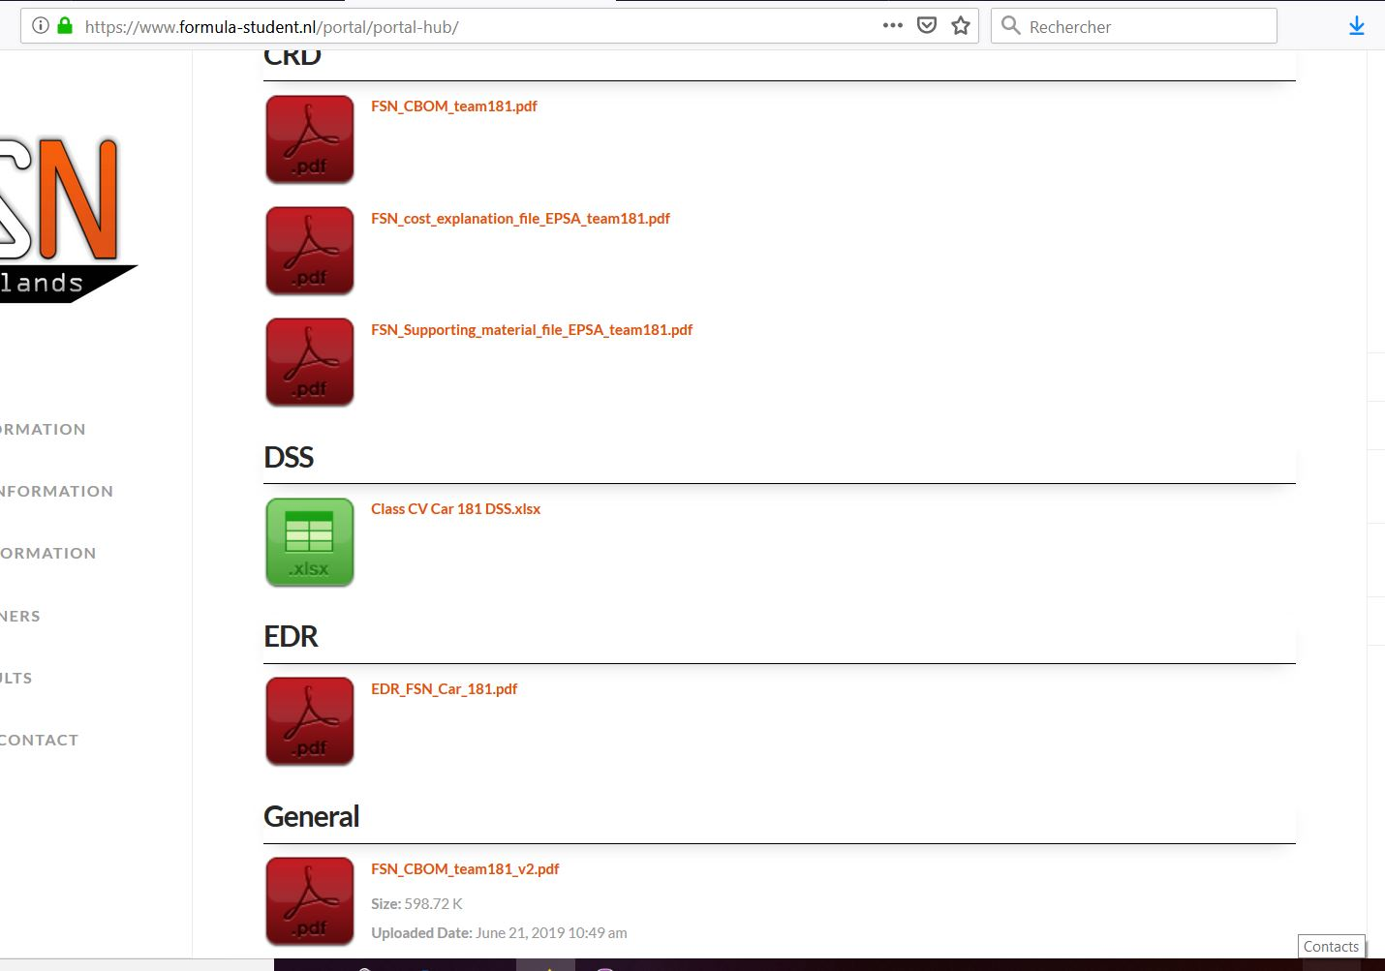
CR_Cost_Report/ZZ-Ressources/2019_RENDUS_COMPET/FSN/proof.JPG
