EOSCogniton/ELIZ-2021/EL_Electrical/CATIA/Gabarits/Gabarit MS bis/attache main hoop.dxf

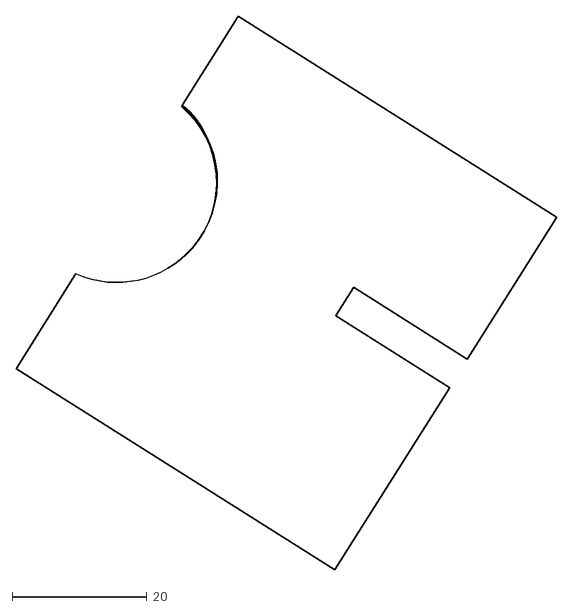
[picture p483: CAD file, 2022-11-24]
EL_Electrical/CATIA/Gabarits/Gabarit MS bis/attache main hoop.dxf
80.4 x 82.2
