EOSCogniton/ELIZ-2021/EL_Electrical/CATIA/Gabarits/Gabarit MS bis/MEP gabarit MS bis/MEP gabarit attache main hoop.dxf

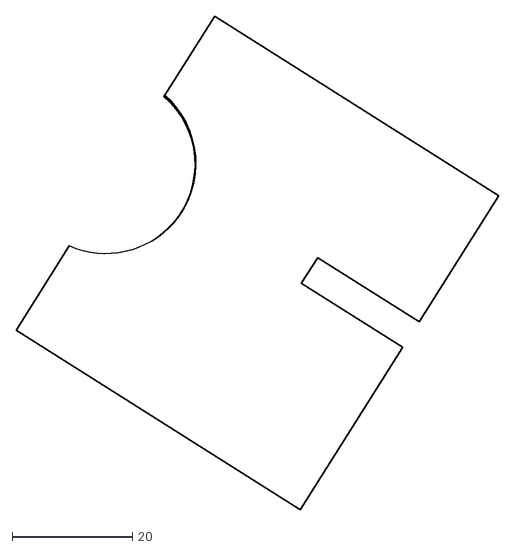
[picture p484: CAD file, 2022-11-27]
EL_Electrical/CATIA/Gabarits/Gabarit MS bis/MEP gabarit MS bis/MEP gabarit attache main hoop.dxf
80.4 x 82.2
