EOSCogniton/ELIZ-2021/FR_Frame_Body/FR_A0100 (Frame)/Frame_Production/MEP/Hoop/main hoop.stp

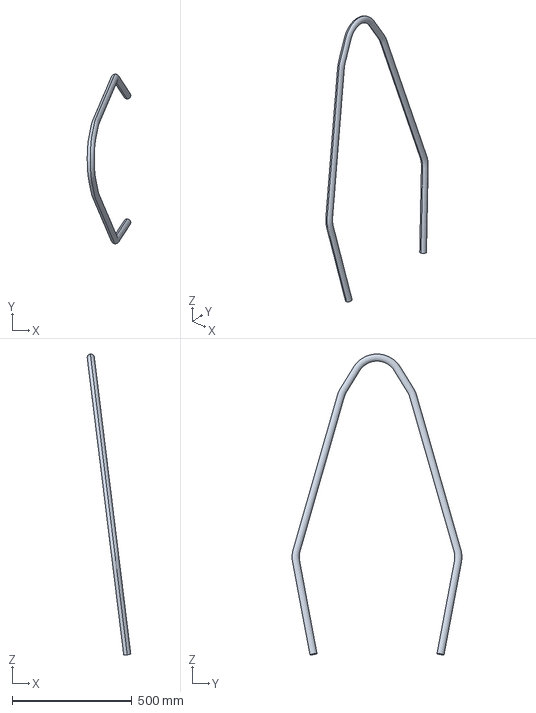
[picture p485: CAD file, 2021-12-08]
FR_Frame_Body/FR_A0100 (Frame)/Frame_Production/MEP/Hoop/main hoop.stp
182.0 x 709.5 x 1257.5 mm
