EOSCogniton/ELIZ-2021/AA - Mise en plan/La mache laser/Pdf+dxf/EL_A1000 (CONTAINER BATTERIE)/MEP EL_01006_DXF [Container main divider].dxf

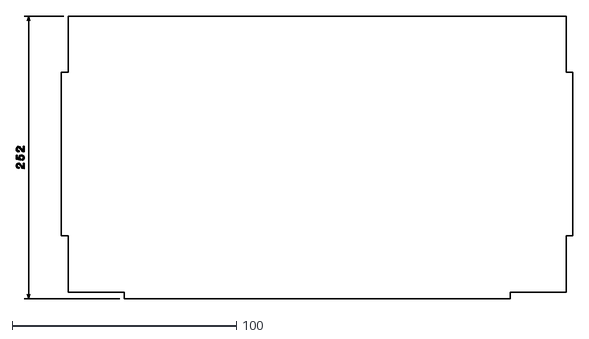
[picture p486: CAD file, 2022-01-12]
AA - Mise en plan/La mache laser/Pdf+dxf/EL_A1000 (CONTAINER BATTERIE)/MEP EL_01006_DXF [Container main divider].dxf
248.2 x 126.0
