EOSCogniton/ELIZ-2021/AA - Mise en plan/Boisard/pdf/Vague artemiz/ST_04002 (Half Moon below).stp

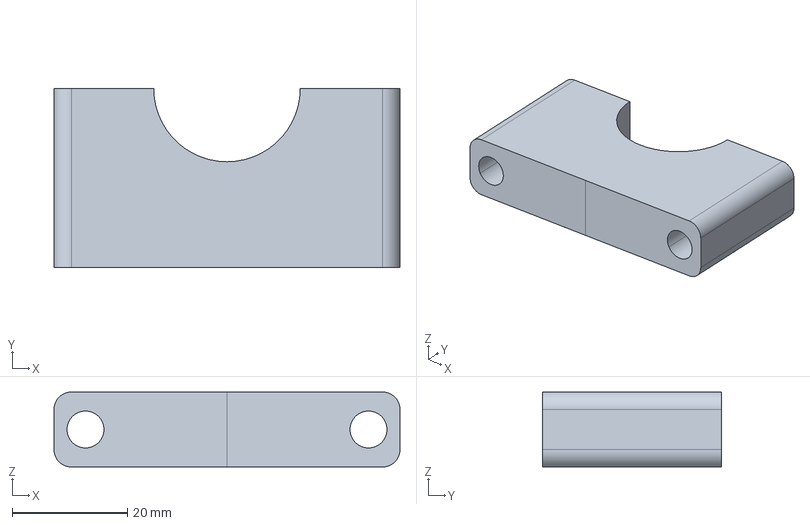
[picture p488: CAD file, 2022-11-23]
AA - Mise en plan/Boisard/pdf/Vague artemiz/ST_04002 (Half Moon below).stp
60.0 x 31.0 x 13.0 mm
