EOSCogniton/ELIZ-2021/AA - Mise en plan/Gorge de loup_artemiz/EN_01002 (flanged shaft).stp

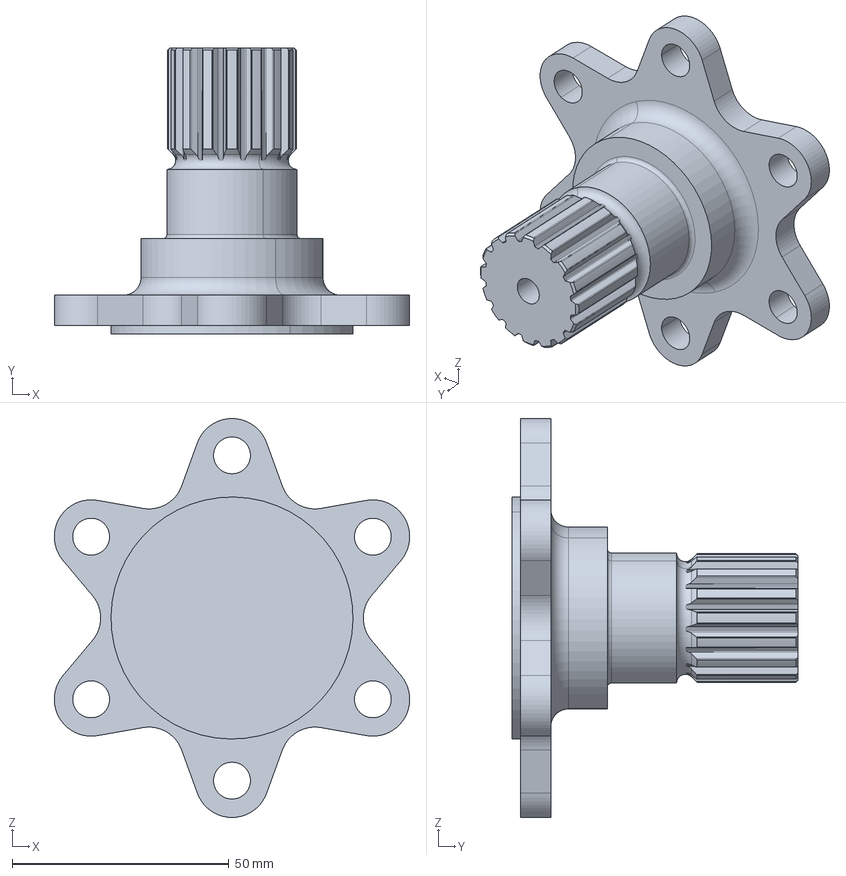
[picture p489: CAD file, 2023-03-05]
AA - Mise en plan/Gorge de loup_artemiz/EN_01002 (flanged shaft).stp
81.9 x 66.0 x 92.0 mm
