EOSCogniton/ELIZ-2021/AA - Mise en plan/La Fabrique/1ervague/FR_010001 (Insert front).stp

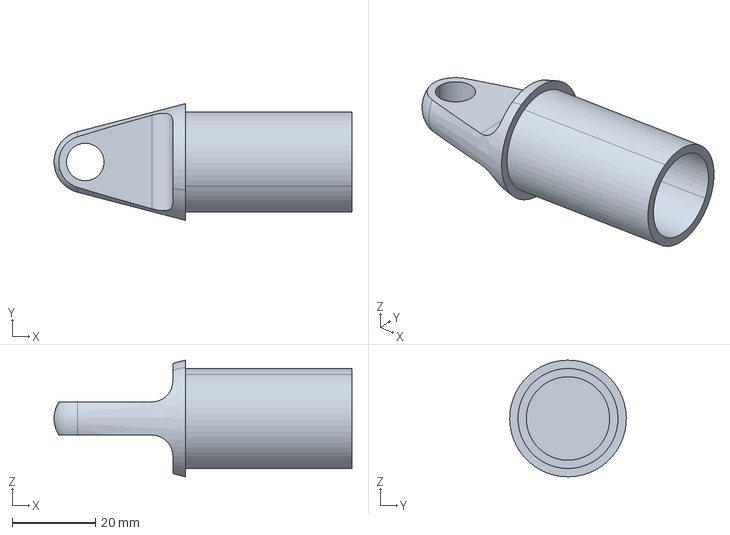
[picture p490: CAD file, 2022-11-15]
AA - Mise en plan/La Fabrique/1ervague/FR_010001 (Insert front).stp
71.5 x 28.0 x 28.0 mm
