EOSCogniton/ELIZ-2021/AA - Mise en plan/La Fabrique/SU_03003  (Rear Upper Rod-End Support).stp

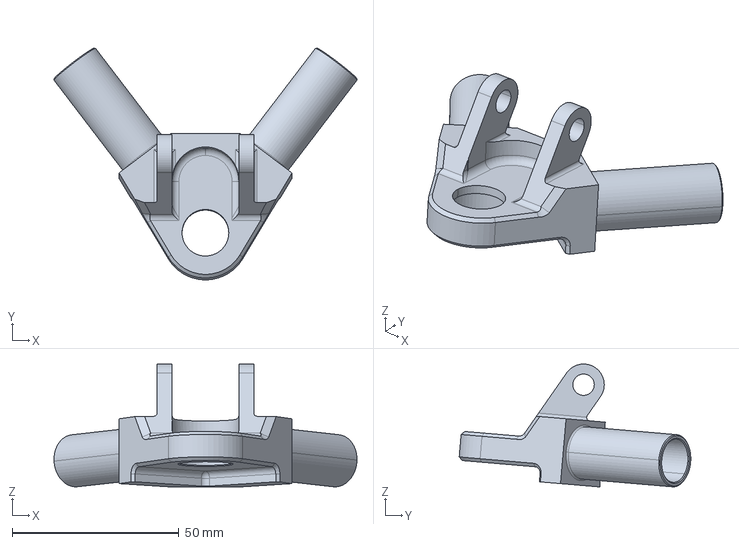
[picture p491: CAD file, 2024-03-12]
AA - Mise en plan/La Fabrique/SU_03003 (Rear Upper Rod-End Support).stp
90.8 x 69.4 x 36.9 mm
