EOSCogniton/ELIZ-2021/AA - Mise en plan/La mache laser/Brake Pedal/FR_04005 (Master Cylinder Wedge).dxf

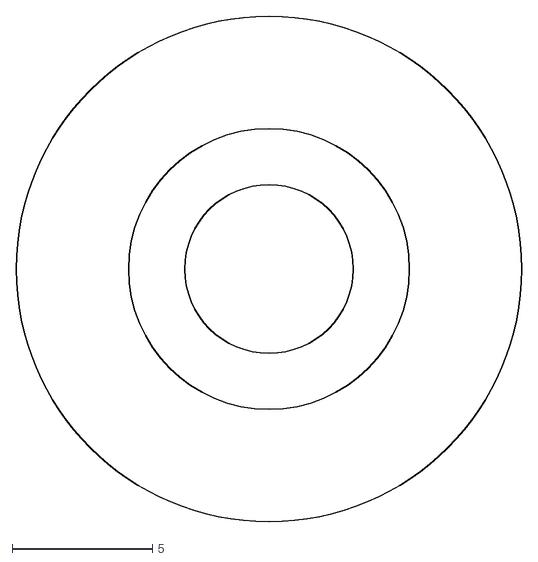
[picture p492: CAD file, 2021-11-15]
AA - Mise en plan/La mache laser/Brake Pedal/FR_04005 (Master Cylinder Wedge).dxf
18.0 x 18.0
