EOSCogniton/ELIZ-2021/AA - Mise en plan/La mache laser/Chapes_SU/Chapes_SU_Artemiz/Chape_tie-rod_Up.dxf

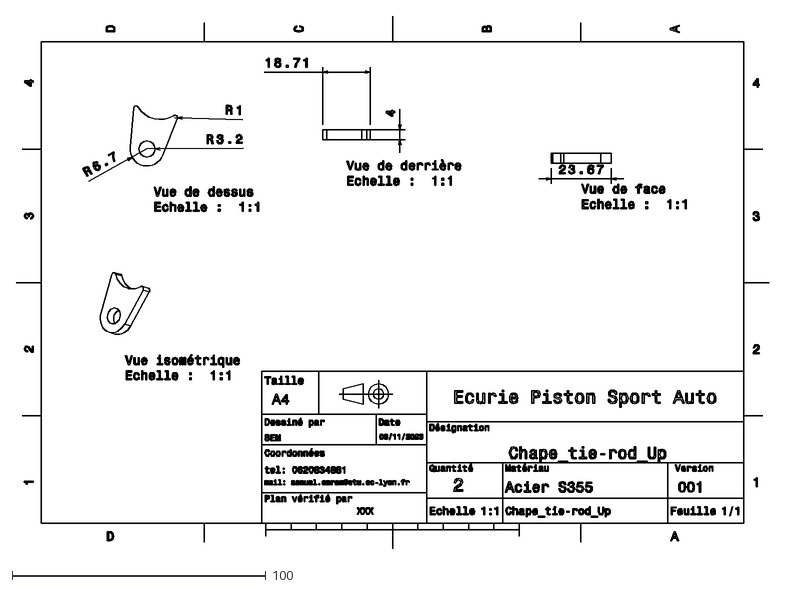
[picture p495: CAD file, 2023-11-12]
AA - Mise en plan/La mache laser/Chapes_SU/Chapes_SU_Artemiz/Chape_tie-rod_Up.dxf
297.0 x 210.0
