EOSCogniton/ELIZ-2021/AA - Mise en plan/La mache laser/CHASEA 2023/AIP/MEP_AIP.dxf

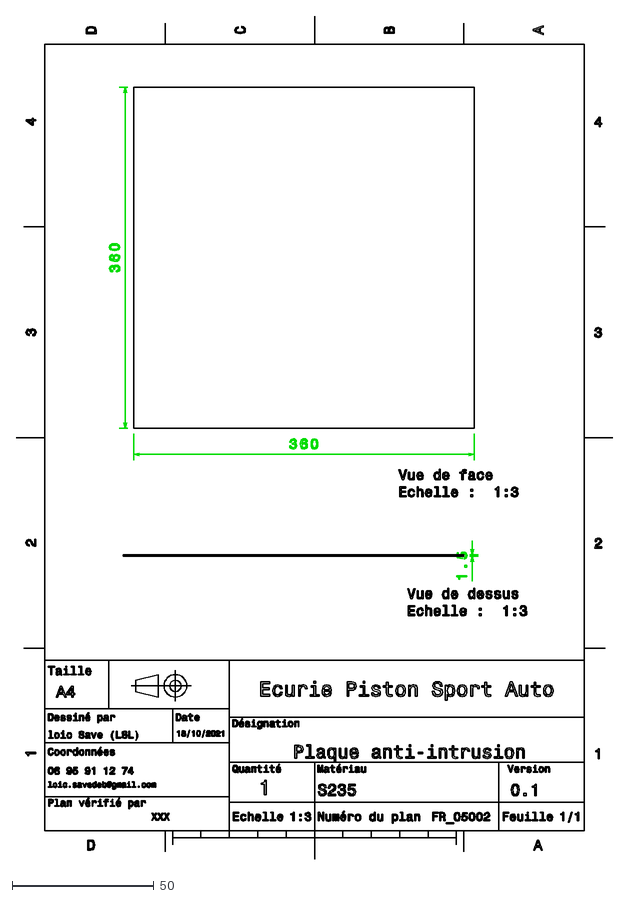
[picture p496: CAD file, 2022-09-28]
AA - Mise en plan/La mache laser/CHASEA 2023/AIP/MEP_AIP.dxf
210.0 x 297.0
