EOSCogniton/ELIZ-2021/AA - Mise en plan/La mache laser/CHASEA 2023/Batterie LV/MEP_chapes_LV.dxf

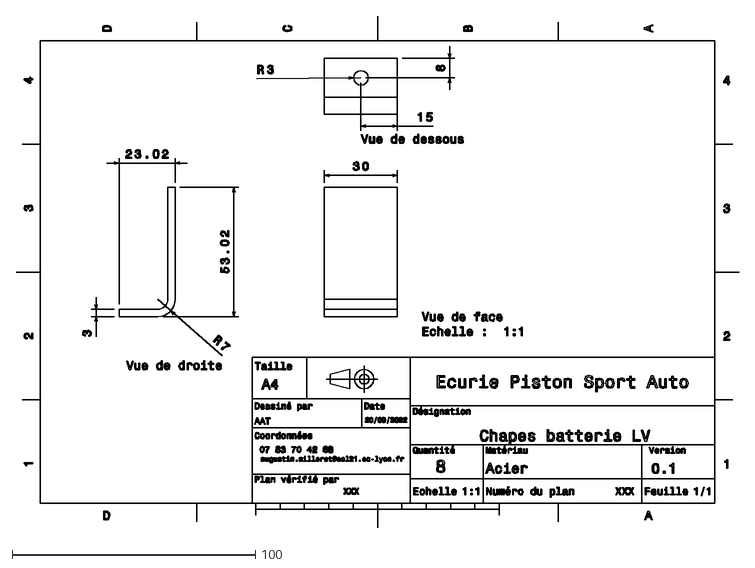
[picture p497: CAD file, 2022-10-06]
AA - Mise en plan/La mache laser/CHASEA 2023/Batterie LV/MEP_chapes_LV.dxf
297.0 x 210.0
