EOSCogniton/ELIZ-2021/AA - Mise en plan/La mache laser/CHASEA 2023/Brake pedal/FR_04013 (BOTS Support).stp

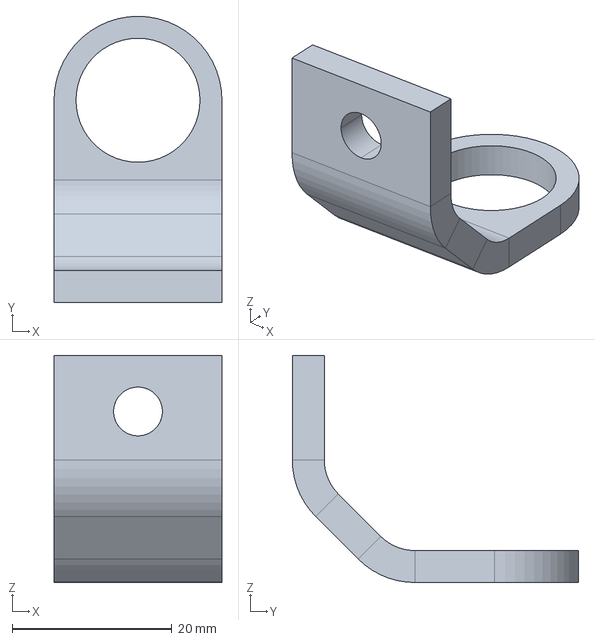
[picture p498: CAD file, 2023-02-01]
AA - Mise en plan/La mache laser/CHASEA 2023/Brake pedal/FR_04013 (BOTS Support).stp
21.0 x 35.8 x 28.4 mm
