EOSCogniton/ELIZ-2021/AA - Mise en plan/La mache laser/CHASEA 2023/carrosserie/MEP_chape_carrosserie.dxf

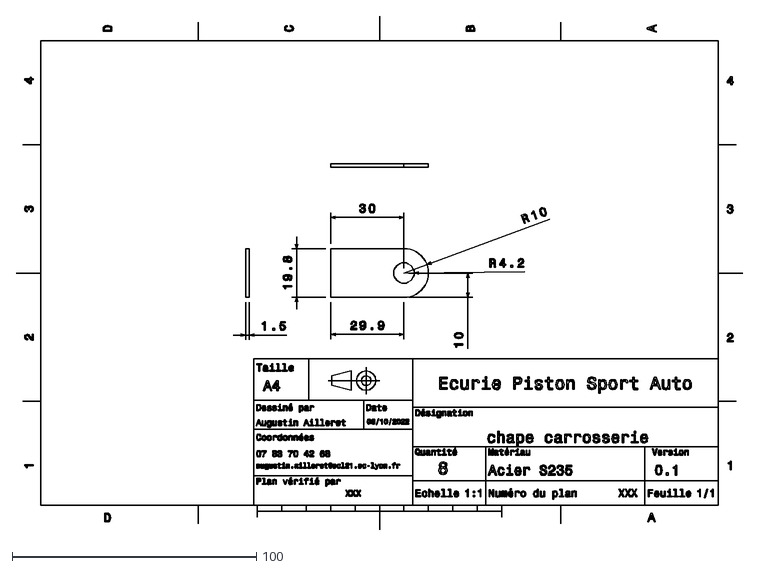
[picture p499: CAD file, 2022-10-06]
AA - Mise en plan/La mache laser/CHASEA 2023/carrosserie/MEP_chape_carrosserie.dxf
297.0 x 210.0
