EOSCogniton/ELIZ-2021/AA - Mise en plan/La mache laser/CHASEA 2023/Fond plat/FR_06001(Front Plate).dxf

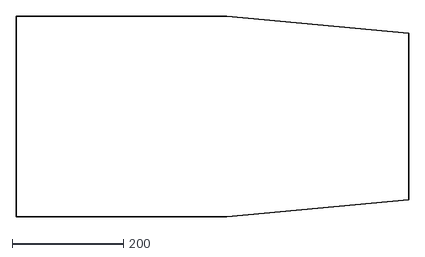
[picture p500: CAD file, 2021-10-19]
AA - Mise en plan/La mache laser/CHASEA 2023/Fond plat/FR_06001(Front Plate).dxf
706.0 x 360.0
