EOSCogniton/ELIZ-2021/AA - Mise en plan/La mache laser/CHASEA 2023/Throttle pedal/FR_03009 (Positive Throttle Mechanical Stop).stp

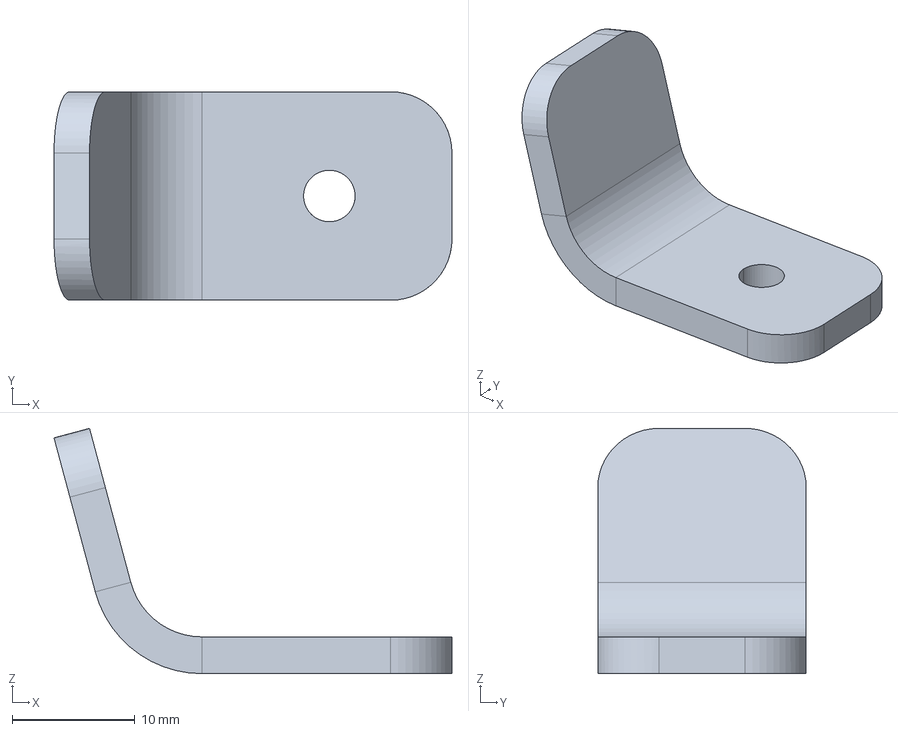
[picture p501: CAD file, 2022-10-07]
AA - Mise en plan/La mache laser/CHASEA 2023/Throttle pedal/FR_03009 (Positive Throttle Mechanical Stop).stp
32.5 x 17.0 x 20.0 mm
