EOSCogniton/ELIZ-2021/AA - Mise en plan/La mache laser/Elec Valky v3/EL_A1102 (Chape brake light).stp

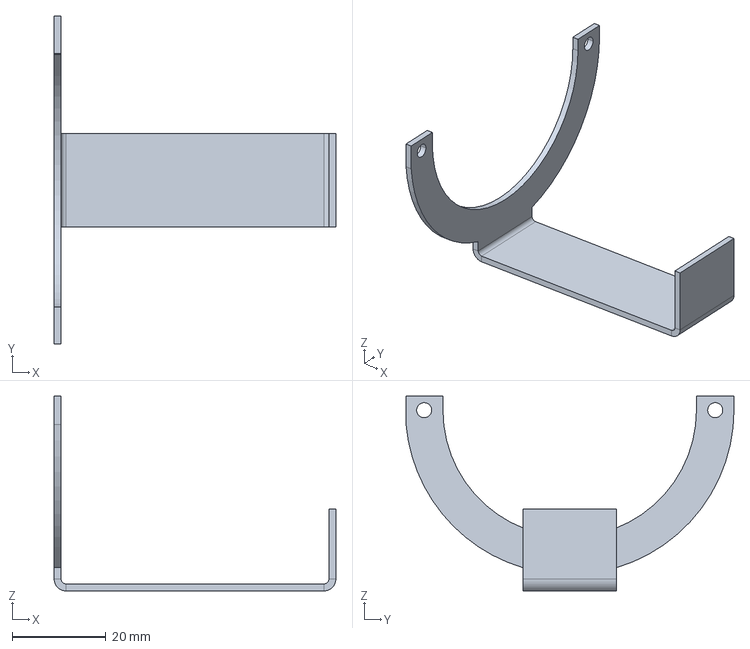
[picture p502: CAD file, 2022-11-16]
AA - Mise en plan/La mache laser/Elec Valky v3/EL_A1102 (Chape brake light).stp
60.0 x 69.9 x 41.5 mm
