EOSCogniton/ELIZ-2021/AA - Mise en plan/La mache laser/EN_01007 Round Scatter Shield.dxf

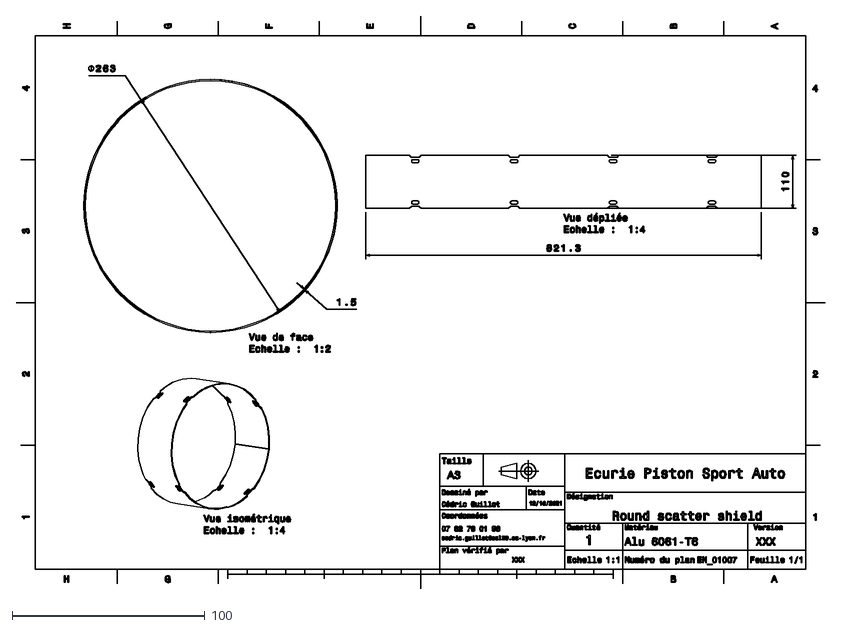
[picture p503: CAD file, 2021-11-15]
AA - Mise en plan/La mache laser/EN_01007 Round Scatter Shield.dxf
420.0 x 297.0
