EOSCogniton/ELIZ-2021/AA - Mise en plan/La mache laser/FR A0300 Throttle Pedal/FR_03004 (throttle fixing rail).dxf

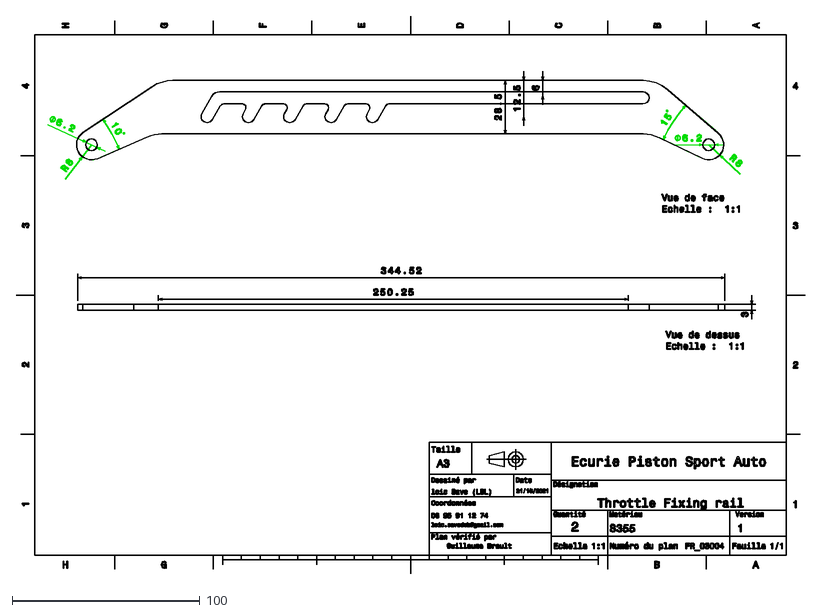
[picture p504: CAD file, 2022-01-12]
AA - Mise en plan/La mache laser/FR A0300 Throttle Pedal/FR_03004 (throttle fixing rail).dxf
420.0 x 297.0
