EOSCogniton/ELIZ-2021/AA - Mise en plan/La mache laser/LAS2023/CHAPE/Chape_FL_Damper_Up.stp

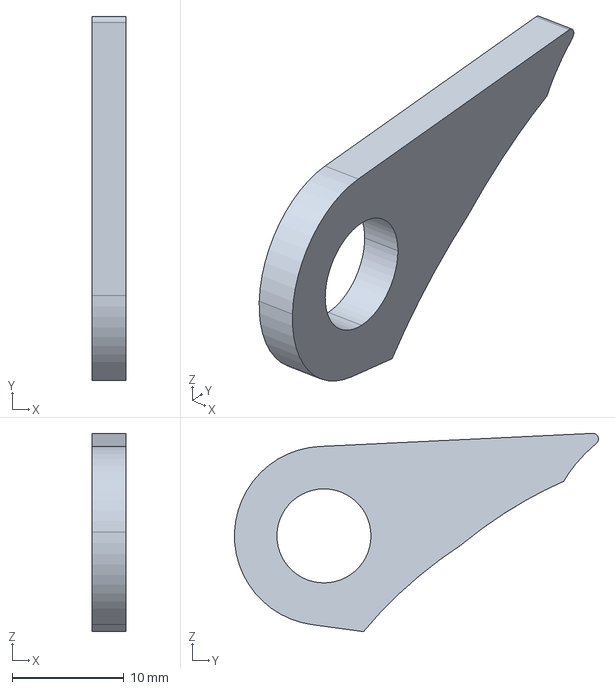
[picture p505: CAD file, 2022-10-13]
AA - Mise en plan/La mache laser/LAS2023/CHAPE/Chape_FL_Damper_Up.stp
3.00 x 32.5 x 17.7 mm
