EOSCogniton/ELIZ-2021/AA - Mise en plan/La mache laser/LAS2023/Direction/Mis sur google drive/ST_04003.1 (Right Bracket).stp

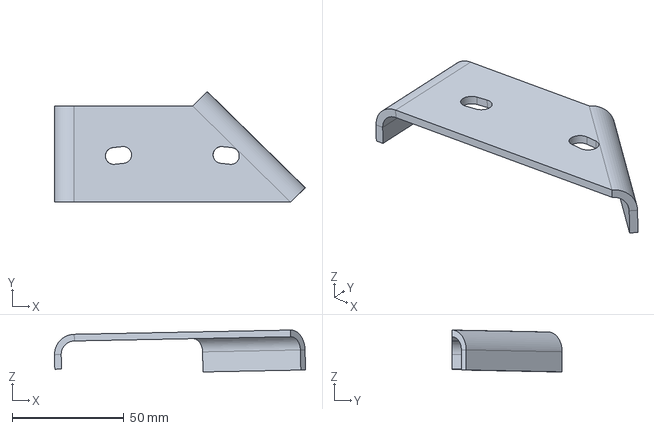
[picture p506: CAD file, 2022-10-13]
AA - Mise en plan/La mache laser/LAS2023/Direction/Mis sur google drive/ST_04003.1 (Right Bracket).stp
112.4 x 49.4 x 18.8 mm
