EOSCogniton/ELIZ-2021/AA - Mise en plan/La mache laser/LAS2023/Direction/Peu être pas/ST_05002 (Rear Bracket).dxf

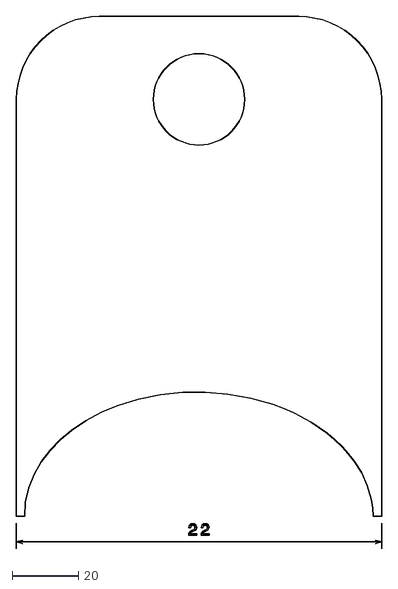
[picture p507: CAD file, 2022-01-12]
AA - Mise en plan/La mache laser/LAS2023/Direction/Peu être pas/ST_05002 (Rear Bracket).dxf
110.0 x 160.3
