EOSCogniton/ELIZ-2021/AA - Mise en plan/La mache laser/LAS2023/Direction/ST_03003 (cale).stp

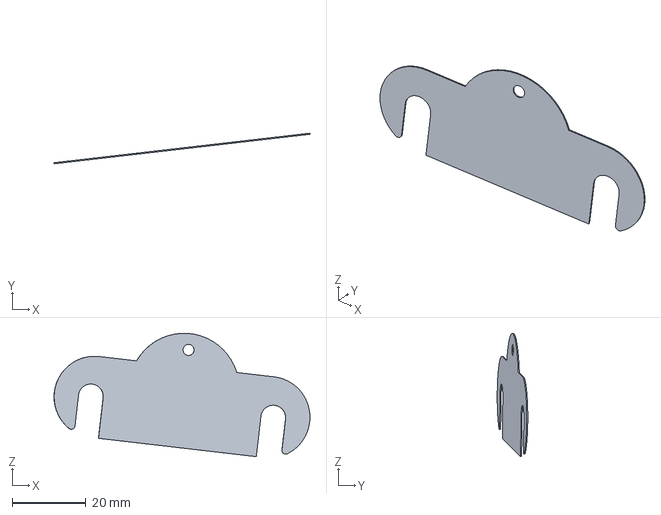
[picture p508: CAD file, 2023-01-16]
AA - Mise en plan/La mache laser/LAS2023/Direction/ST_03003 (cale).stp
69.3 x 8.29 x 33.4 mm
