EOSCogniton/ELIZ-2021/AA - Mise en plan/La mache laser/LAS2023/Suspension/SU_06001/SU_06001 (front Rocker 3 mm).dxf

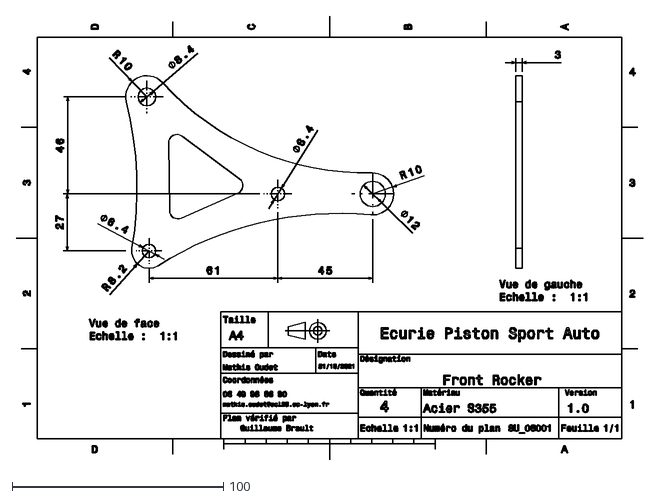
[picture p509: CAD file, 2023-01-16]
AA - Mise en plan/La mache laser/LAS2023/Suspension/SU_06001/SU_06001 (front Rocker 3 mm).dxf
297.0 x 210.0
