EOSCogniton/ELIZ-2021/AA - Mise en plan/La mache laser/LAS2023/Suspension/SU_08001/SU_08001 (Rear Rocker).stp

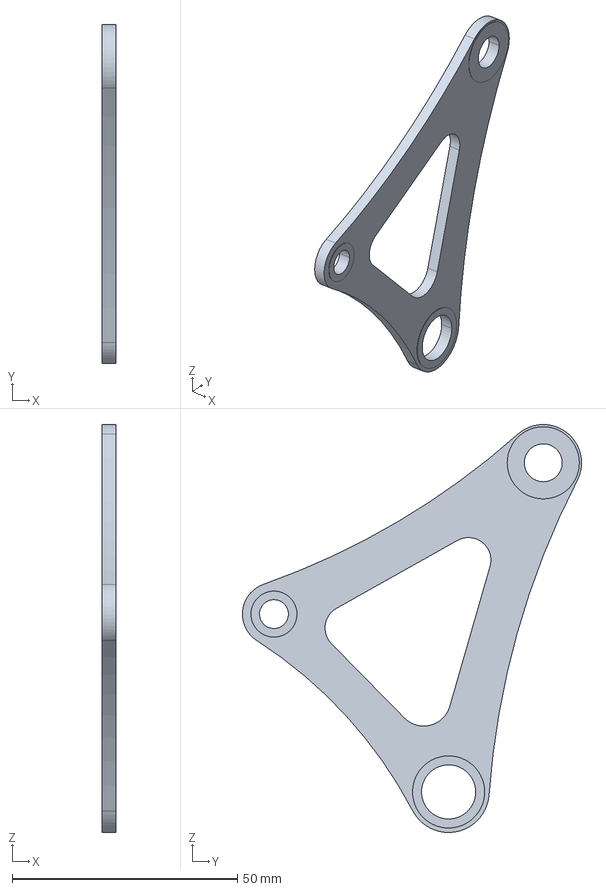
[picture p510: CAD file, 2023-01-16]
AA - Mise en plan/La mache laser/LAS2023/Suspension/SU_08001/SU_08001 (Rear Rocker).stp
3.20 x 75.2 x 90.5 mm
