EOSCogniton/ELIZ-2021/AA - Mise en plan/La mache laser/LAS2023/Suspension/SU_14006 (blade link).stp

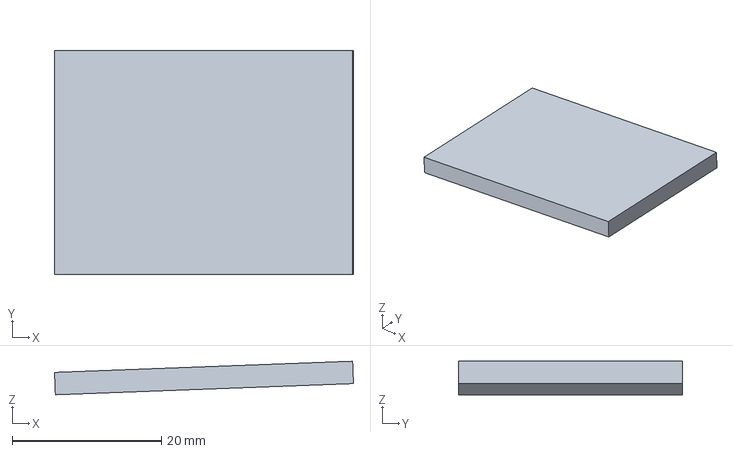
[picture p511: CAD file, 2022-10-13]
AA - Mise en plan/La mache laser/LAS2023/Suspension/SU_14006 (blade link).stp
40.0 x 30.0 x 4.50 mm
