EOSCogniton/ELIZ-2021/AA - Mise en plan/La mache laser/Oubli/MS_02001 (Support).igs

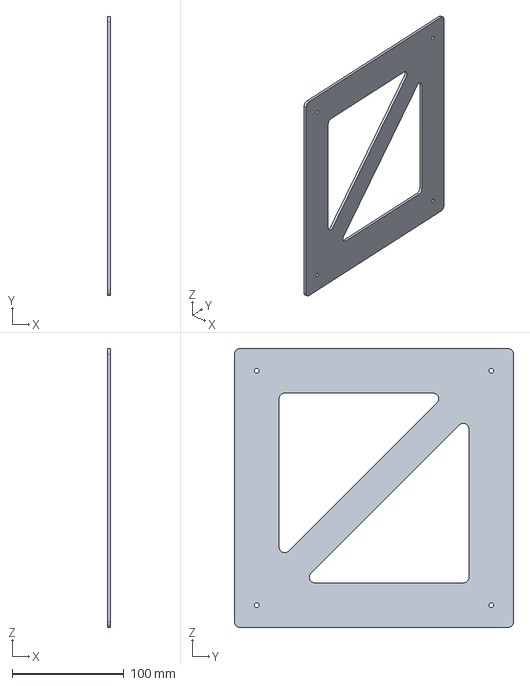
[picture p512: CAD file, 2022-07-04]
AA - Mise en plan/La mache laser/Oubli/MS_02001 (Support).igs
3.00 x 250.0 x 250.0 mm
