EOSCogniton/ELIZ-2021/AA - Mise en plan/La mache laser/Paroi pare feu/Plan de découpe/MS_04003 (Lower part).dxf

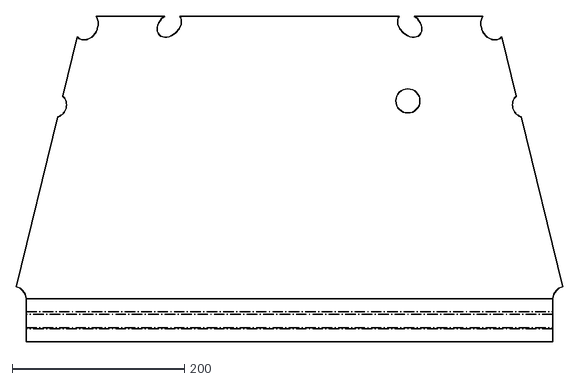
[picture p513: CAD file, 2021-10-19]
AA - Mise en plan/La mache laser/Paroi pare feu/Plan de découpe/MS_04003 (Lower part).dxf
634.0 x 378.2
