EOSCogniton/ELIZ-2021/AA - Mise en plan/La mache laser/Pdf+dxf/CHAPE BASCULEUR/Chape_FRocker_R.dxf

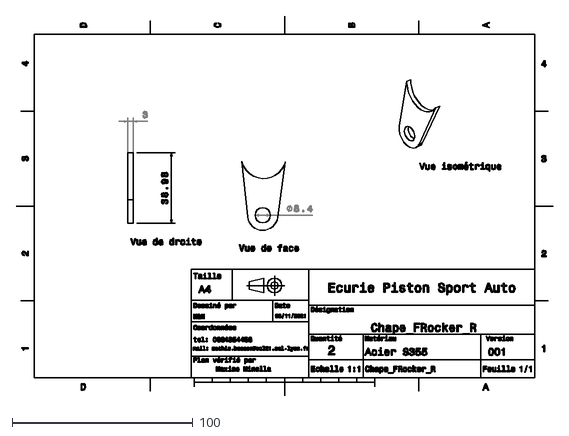
[picture p515: CAD file, 2022-01-12]
AA - Mise en plan/La mache laser/Pdf+dxf/CHAPE BASCULEUR/Chape_FRocker_R.dxf
297.0 x 210.0
