EOSCogniton/ELIZ-2021/AA - Mise en plan/La mache laser/Pdf+dxf/EL_A1000 (CONTAINER BATTERIE)/MEP EL_01011_DXF [Container lid].dxf

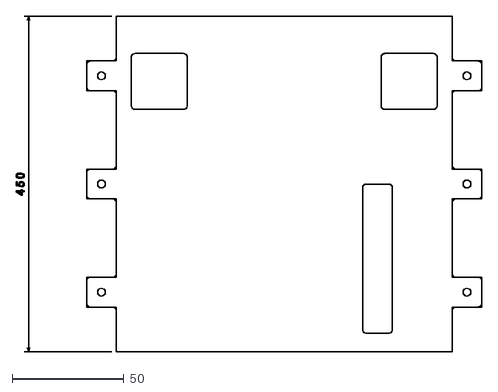
[picture p517: CAD file, 2022-01-12]
AA - Mise en plan/La mache laser/Pdf+dxf/EL_A1000 (CONTAINER BATTERIE)/MEP EL_01011_DXF [Container lid].dxf
208.1 x 150.0
