EOSCogniton/ELIZ-2021/AA - Mise en plan/La mache laser/Pdf+dxf/EN_01006/EN_01006 (Stator scatter shield).dxf

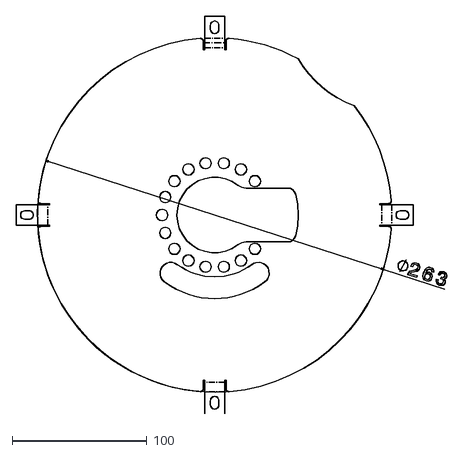
[picture p518: CAD file, 2022-01-12]
AA - Mise en plan/La mache laser/Pdf+dxf/EN_01006/EN_01006 (Stator scatter shield).dxf
319.6 x 294.6
