EOSCogniton/ELIZ-2021/AA - Mise en plan/La mache laser/Pdf+dxf/EN_01007/EN_01007 Round Scatter Shield.dxf

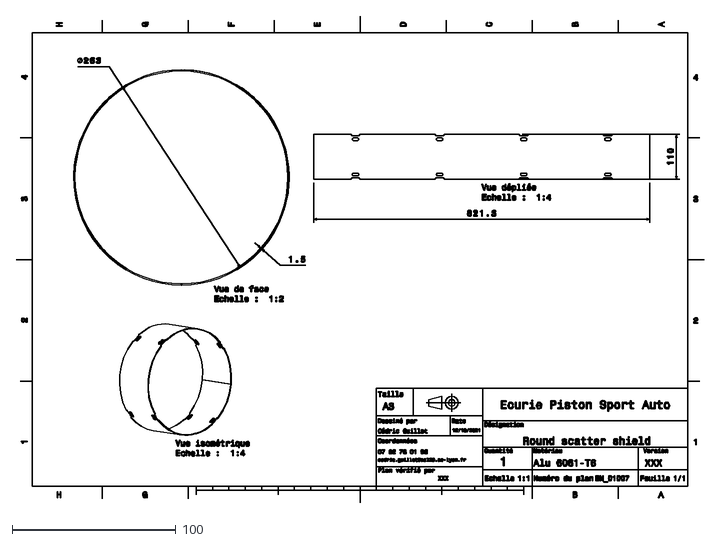
[picture p519: CAD file, 2022-01-12]
AA - Mise en plan/La mache laser/Pdf+dxf/EN_01007/EN_01007 Round Scatter Shield.dxf
420.0 x 297.0
