EOSCogniton/ELIZ-2021/AA - Mise en plan/La mache laser/Pdf+dxf/EN_01011/EN_01011 Rotor Scatter Shield.dxf

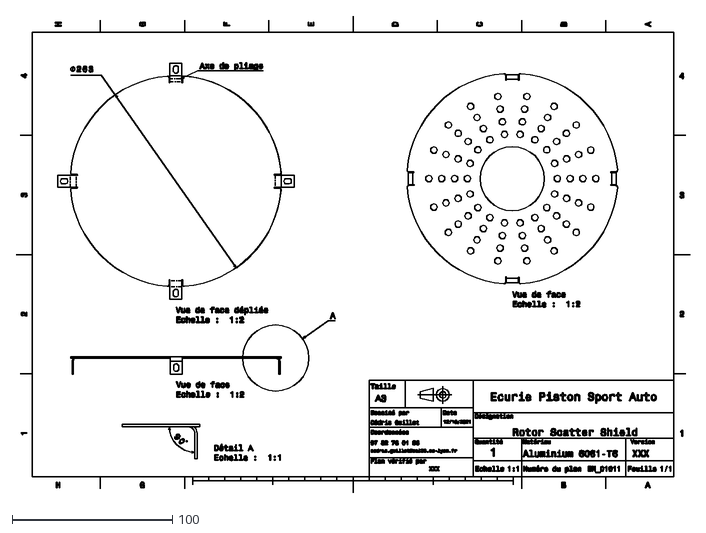
[picture p520: CAD file, 2022-01-12]
AA - Mise en plan/La mache laser/Pdf+dxf/EN_01011/EN_01011 Rotor Scatter Shield.dxf
420.0 x 297.0
