EOSCogniton/ELIZ-2021/AA - Mise en plan/La mache laser/Pdf+dxf/EN_04010/EN_04010 (Chain shield).dxf

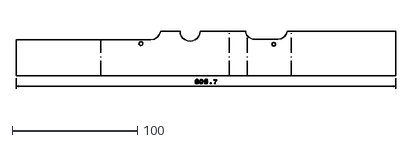
[picture p521: CAD file, 2022-01-12]
AA - Mise en plan/La mache laser/Pdf+dxf/EN_04010/EN_04010 (Chain shield).dxf
303.3 x 46.1
