EOSCogniton/ELIZ-2021/AA - Mise en plan/La mache laser/Pdf+dxf/FR_03001/FR_03001_2 bord droit.dxf

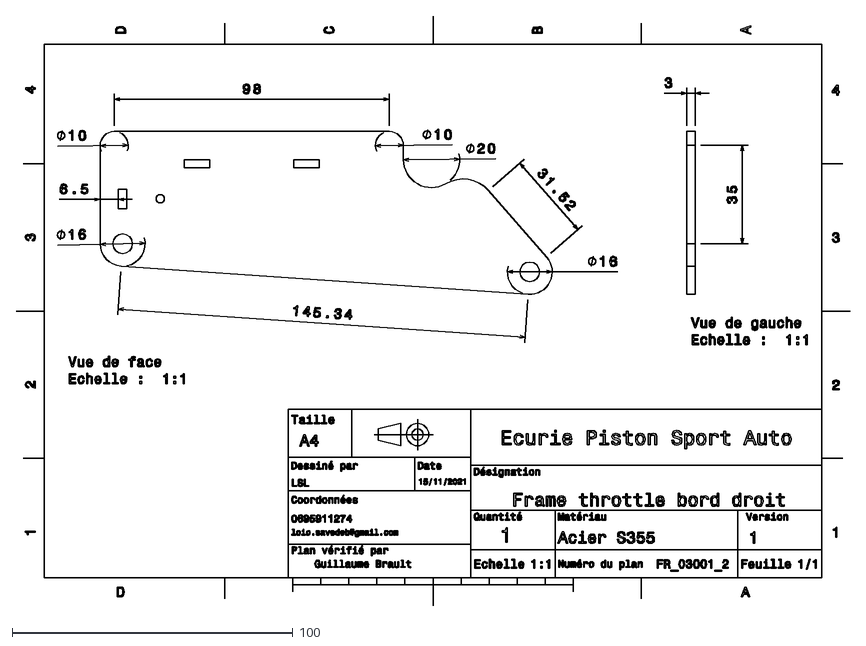
[picture p522: CAD file, 2022-01-12]
AA - Mise en plan/La mache laser/Pdf+dxf/FR_03001/FR_03001_2 bord droit.dxf
297.0 x 210.0
