EOSCogniton/ELIZ-2021/AA - Mise en plan/La mache laser/Pdf+dxf/FR_03004/FR_03004 (throttle fixing rail).dxf

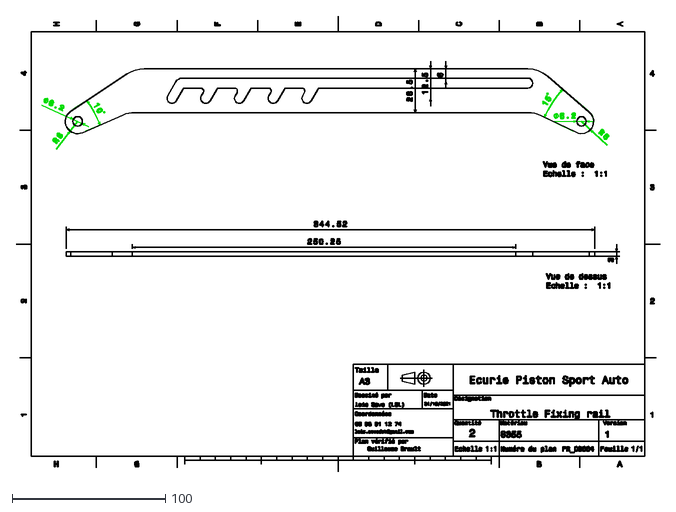
[picture p523: CAD file, 2022-01-12]
AA - Mise en plan/La mache laser/Pdf+dxf/FR_03004/FR_03004 (throttle fixing rail).dxf
420.0 x 297.0
