EOSCogniton/ELIZ-2021/AA - Mise en plan/La mache laser/Pdf+dxf/FR_03005/FR_03005 (Rear Throttle bracket).dxf

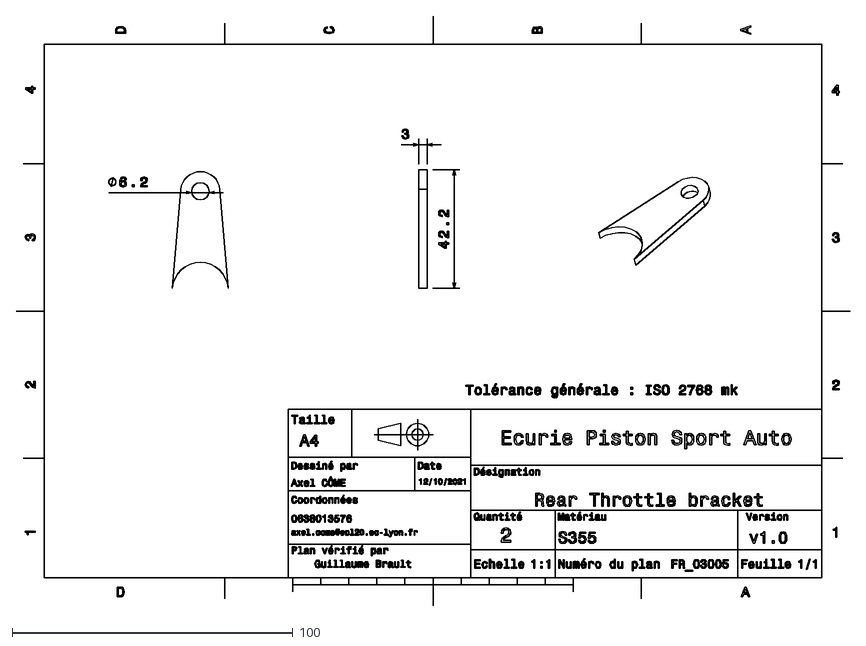
[picture p524: CAD file, 2022-01-12]
AA - Mise en plan/La mache laser/Pdf+dxf/FR_03005/FR_03005 (Rear Throttle bracket).dxf
297.0 x 210.0
