EOSCogniton/ELIZ-2021/AA - Mise en plan/La mache laser/Pdf+dxf/FR_03007/FR_03007 (Front Throttle bracket).dxf

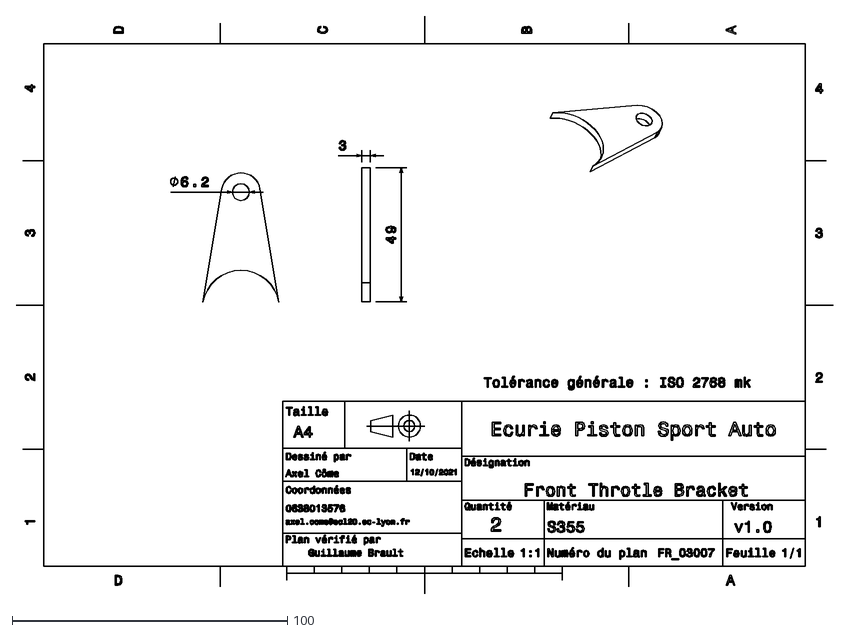
[picture p525: CAD file, 2022-01-12]
AA - Mise en plan/La mache laser/Pdf+dxf/FR_03007/FR_03007 (Front Throttle bracket).dxf
297.0 x 210.0
