EOSCogniton/ELIZ-2021/AA - Mise en plan/La mache laser/Pdf+dxf/FR_04001/FR_04001_9 (Frame Brake).dxf

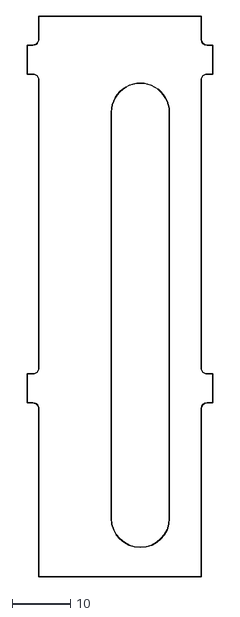
[picture p526: CAD file, 2022-01-12]
AA - Mise en plan/La mache laser/Pdf+dxf/FR_04001/FR_04001_9 (Frame Brake).dxf
32.0 x 96.7
