EOSCogniton/ELIZ-2021/AA - Mise en plan/La mache laser/Pdf+dxf/FR_04006/FR_04006 (Brake Fixing Rail).dxf

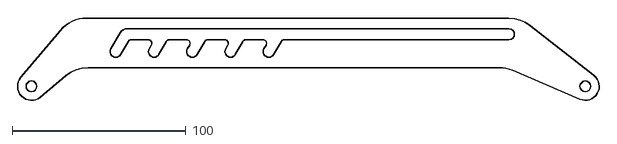
[picture p527: CAD file, 2022-01-12]
AA - Mise en plan/La mache laser/Pdf+dxf/FR_04006/FR_04006 (Brake Fixing Rail).dxf
336.2 x 48.2
