EOSCogniton/ELIZ-2021/AA - Mise en plan/La mache laser/Pdf+dxf/FR_04007/FR_04007 (Rear Brake bracket).dxf

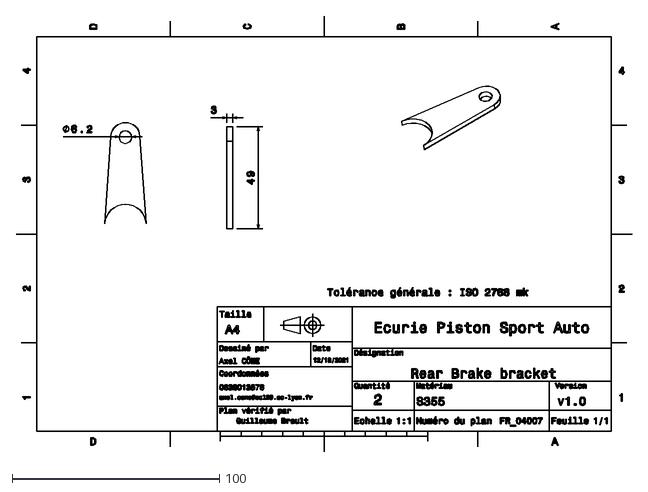
[picture p528: CAD file, 2022-01-12]
AA - Mise en plan/La mache laser/Pdf+dxf/FR_04007/FR_04007 (Rear Brake bracket).dxf
297.0 x 210.0
