EOSCogniton/ELIZ-2021/AA - Mise en plan/La mache laser/Pdf+dxf/FR_04008/FR_04008 (Front Fixing Rail Wedge).dxf

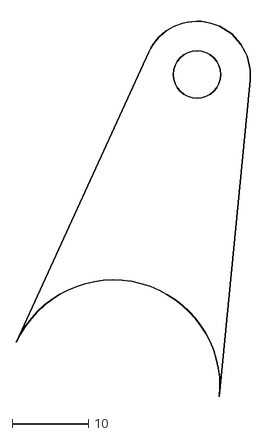
[picture p529: CAD file, 2022-01-12]
AA - Mise en plan/La mache laser/Pdf+dxf/FR_04008/FR_04008 (Front Fixing Rail Wedge).dxf
31.0 x 50.0
