EOSCogniton/ELIZ-2021/AA - Mise en plan/La mache laser/Pdf+dxf/FR_04013/FR_04013 (Bots Support).dxf

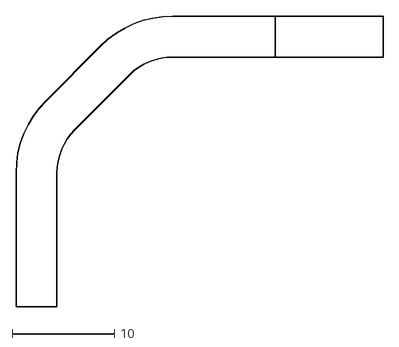
[picture p530: CAD file, 2022-01-12]
AA - Mise en plan/La mache laser/Pdf+dxf/FR_04013/FR_04013 (Bots Support).dxf
35.8 x 28.4
