EOSCogniton/ELIZ-2021/AA - Mise en plan/La mache laser/Pdf+dxf/FR_04015/FR_04015 (Brake Pedal Hose Wedge).dxf

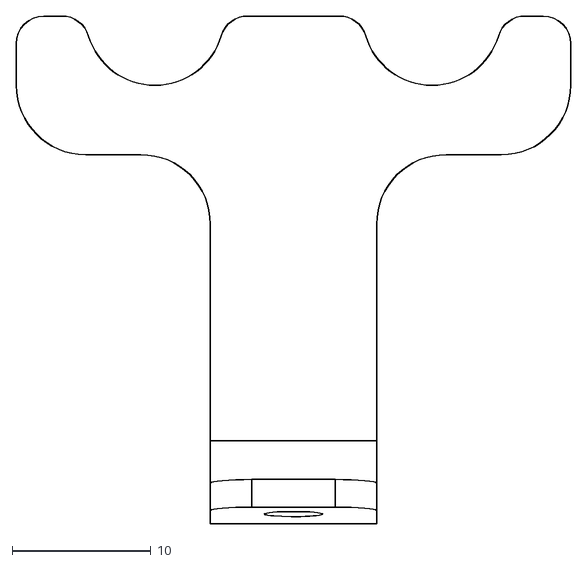
[picture p531: CAD file, 2022-01-12]
AA - Mise en plan/La mache laser/Pdf+dxf/FR_04015/FR_04015 (Brake Pedal Hose Wedge).dxf
40.0 x 36.6
