EOSCogniton/ELIZ-2021/AA - Mise en plan/La mache laser/Pdf+dxf/FR_05002/FR_05002 (AIP).dxf

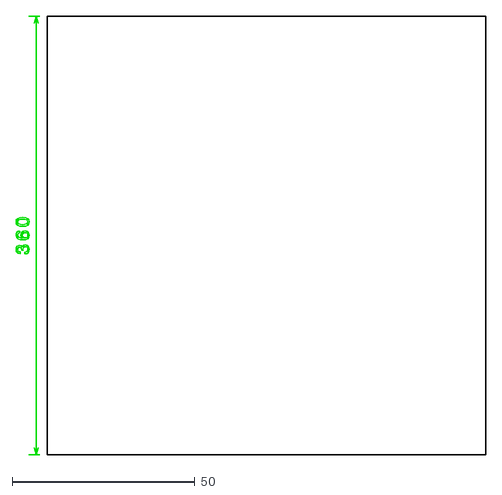
[picture p532: CAD file, 2022-01-12]
AA - Mise en plan/La mache laser/Pdf+dxf/FR_05002/FR_05002 (AIP).dxf
128.5 x 120.0
