EOSCogniton/ELIZ-2021/AA - Mise en plan/La mache laser/Pdf+dxf/MS_01006/MS_01006 (Bracket seat rear).dxf

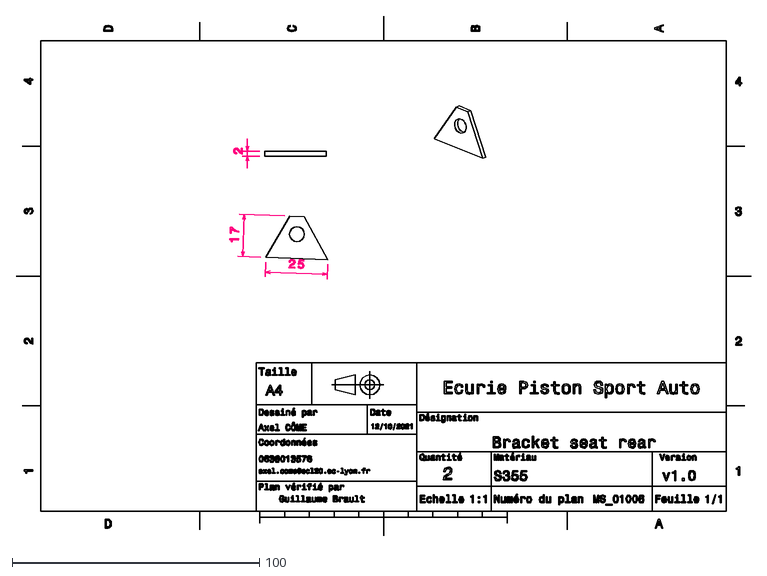
[picture p534: CAD file, 2022-01-12]
AA - Mise en plan/La mache laser/Pdf+dxf/MS_01006/MS_01006 (Bracket seat rear).dxf
297.0 x 210.0
