EOSCogniton/ELIZ-2021/AA - Mise en plan/La mache laser/Pdf+dxf/MS_01007/MS_01007_1 (Right Seat Bracket).dxf

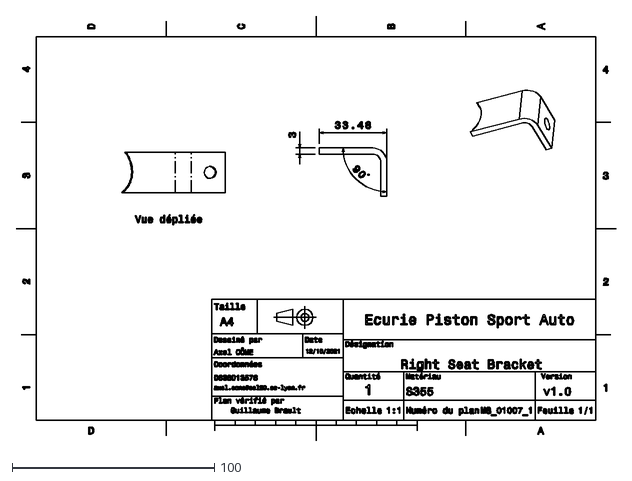
[picture p535: CAD file, 2022-01-12]
AA - Mise en plan/La mache laser/Pdf+dxf/MS_01007/MS_01007_1 (Right Seat Bracket).dxf
297.0 x 210.0
