EOSCogniton/ELIZ-2021/AA - Mise en plan/La mache laser/Pdf+dxf/MS_02002/MS_02002_2 (Left Up Bracket Head Restraint).dxf

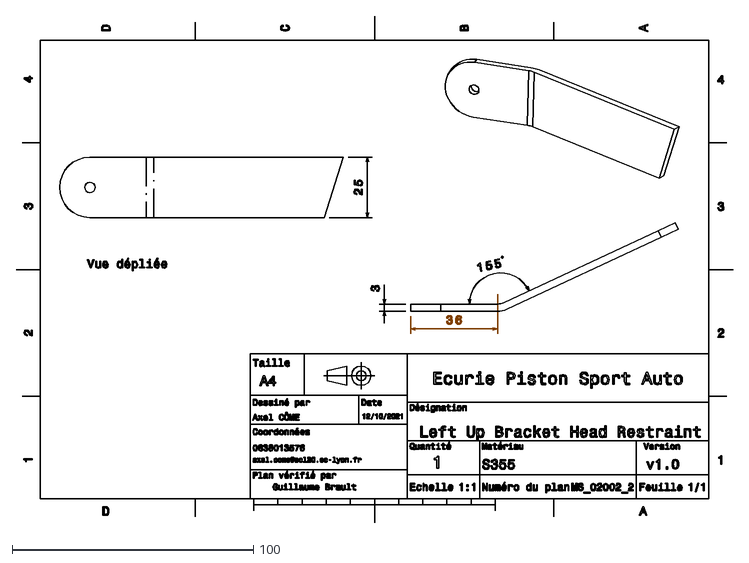
[picture p536: CAD file, 2022-01-12]
AA - Mise en plan/La mache laser/Pdf+dxf/MS_02002/MS_02002_2 (Left Up Bracket Head Restraint).dxf
297.0 x 210.0
