EOSCogniton/ELIZ-2021/AA - Mise en plan/La mache laser/Pdf+dxf/MS_03004/MS_03004 (Anti-submarine + lap belt bracket).dxf

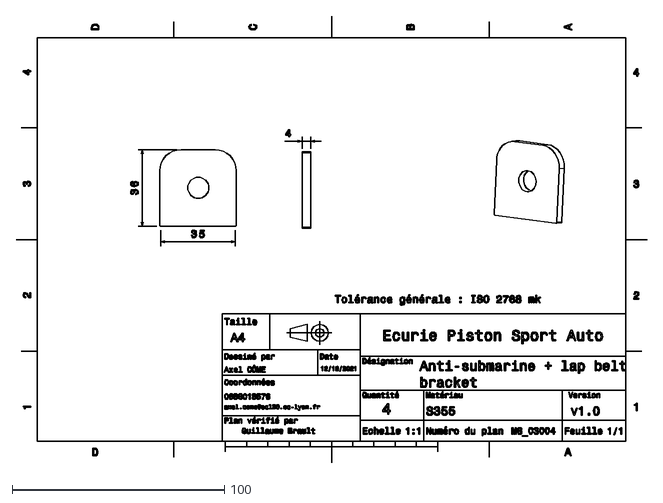
[picture p538: CAD file, 2022-01-12]
AA - Mise en plan/La mache laser/Pdf+dxf/MS_03004/MS_03004 (Anti-submarine + lap belt bracket).dxf
297.0 x 210.0
