EOSCogniton/ELIZ-2021/AA - Mise en plan/La mache laser/Pdf+dxf/MS_04001/MS_04001 (Middle part).igs

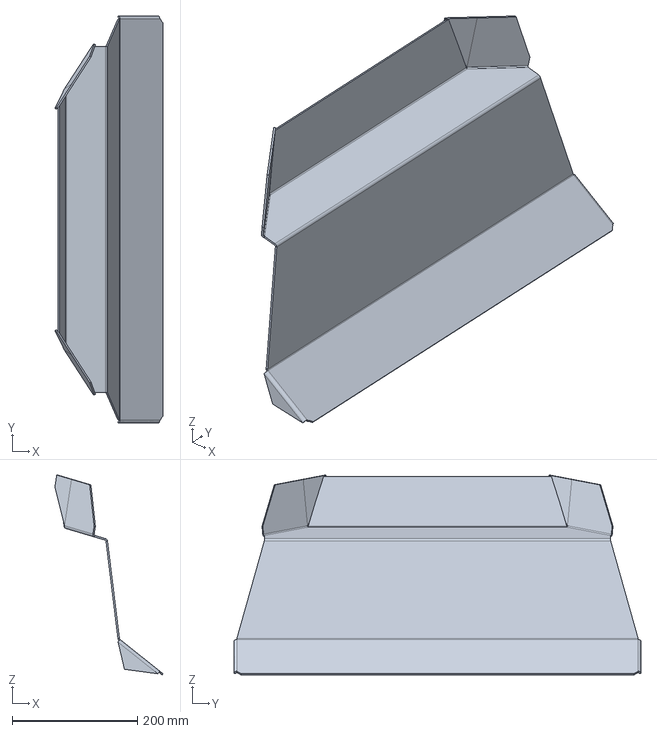
[picture p539: CAD file, 2021-10-19]
AA - Mise en plan/La mache laser/Pdf+dxf/MS_04001/MS_04001 (Middle part).igs
172.8 x 649.7 x 319.2 mm
