EOSCogniton/ELIZ-2021/AA - Mise en plan/La mache laser/Pdf+dxf/MS_04002/MS_04002 (Upper part).igs

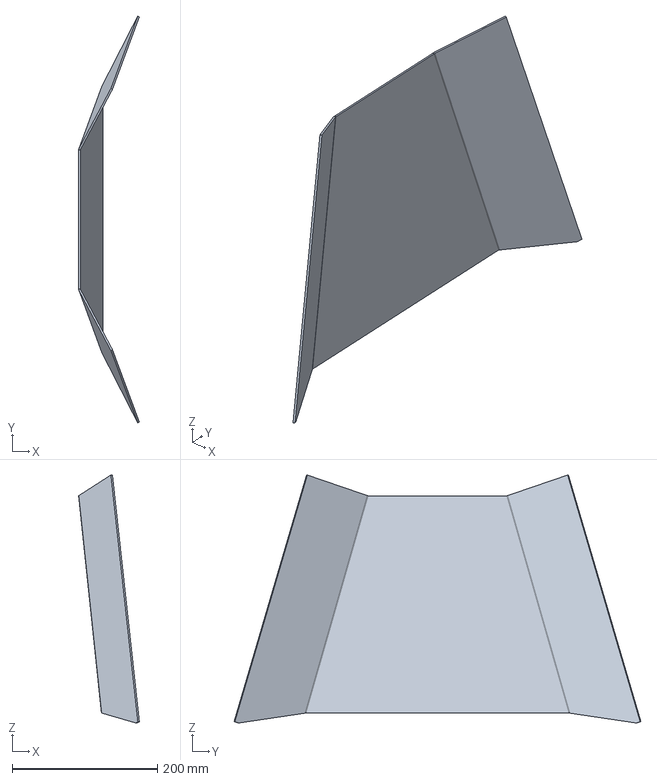
[picture p540: CAD file, 2021-10-19]
AA - Mise en plan/La mache laser/Pdf+dxf/MS_04002/MS_04002 (Upper part).igs
83.6 x 559.4 x 340.9 mm
