EOSCogniton/ELIZ-2021/AA - Mise en plan/La mache laser/Pdf+dxf/MS_04003/MS_04003 (Lower part).igs

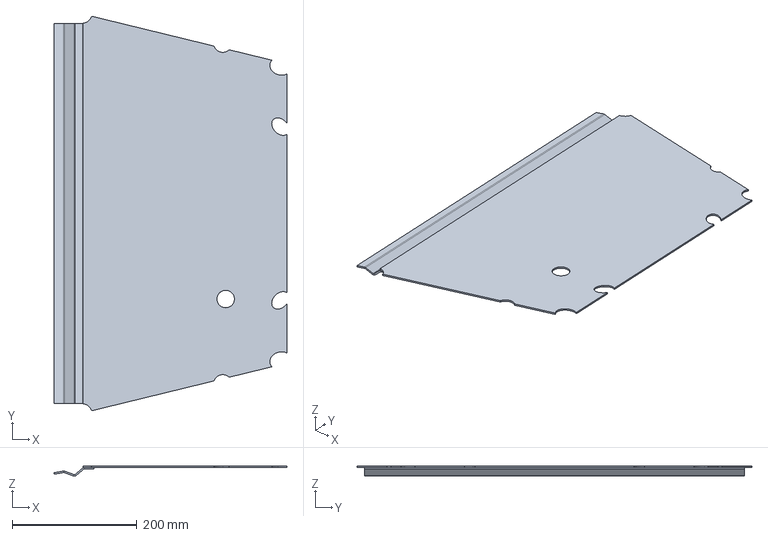
[picture p541: CAD file, 2021-10-19]
AA - Mise en plan/La mache laser/Pdf+dxf/MS_04003/MS_04003 (Lower part).igs
374.3 x 634.0 x 16.6 mm
