EOSCogniton/ELIZ-2021/AA - Mise en plan/La mache laser/Pdf+dxf/MS_04004/MS_04004 (Firewall bracket).dxf

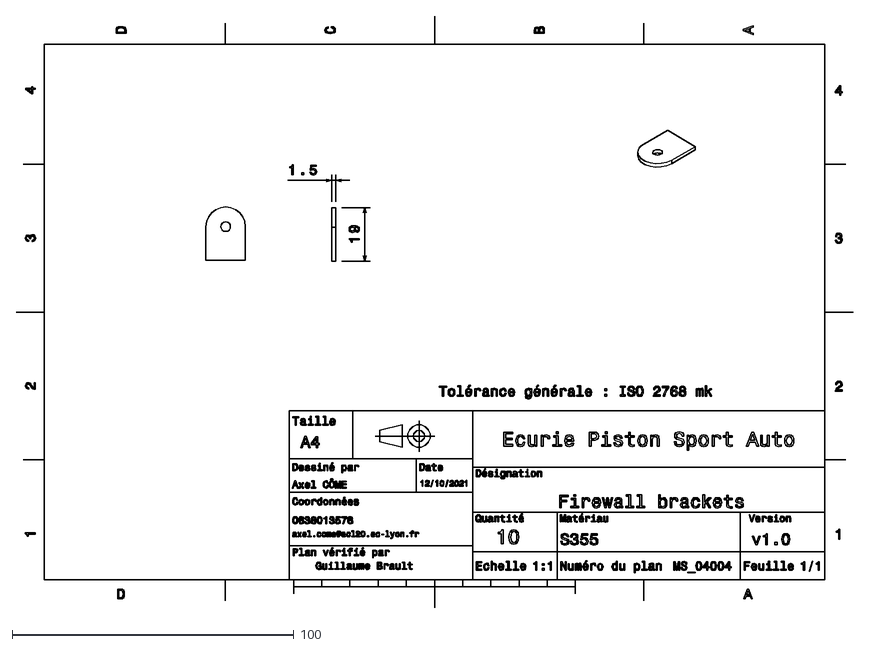
[picture p542: CAD file, 2022-01-12]
AA - Mise en plan/La mache laser/Pdf+dxf/MS_04004/MS_04004 (Firewall bracket).dxf
297.0 x 210.0
