EOSCogniton/ELIZ-2021/AA - Mise en plan/La mache laser/Pdf+dxf/MS_04005/MS_04005 (Firewall bracket).dxf

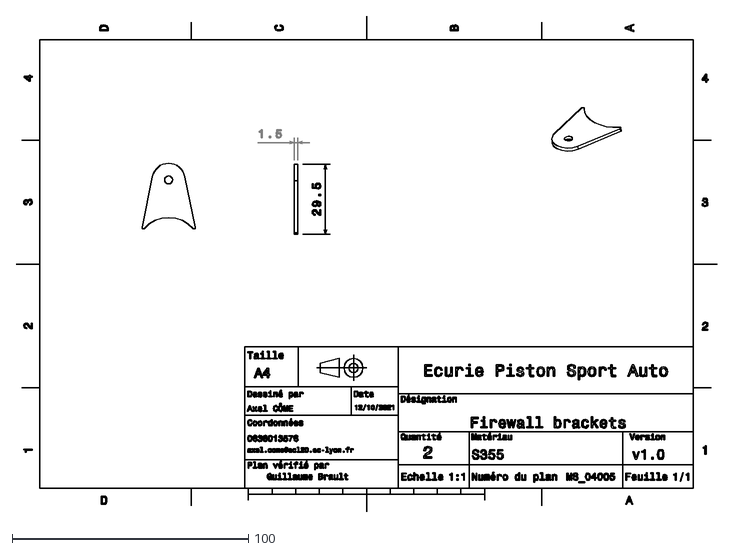
[picture p543: CAD file, 2022-01-12]
AA - Mise en plan/La mache laser/Pdf+dxf/MS_04005/MS_04005 (Firewall bracket).dxf
297.0 x 210.0
