EOSCogniton/ELIZ-2021/AA - Mise en plan/La mache laser/Pdf+dxf/ST_05003/ST_05003 ( Rack protection ).dxf

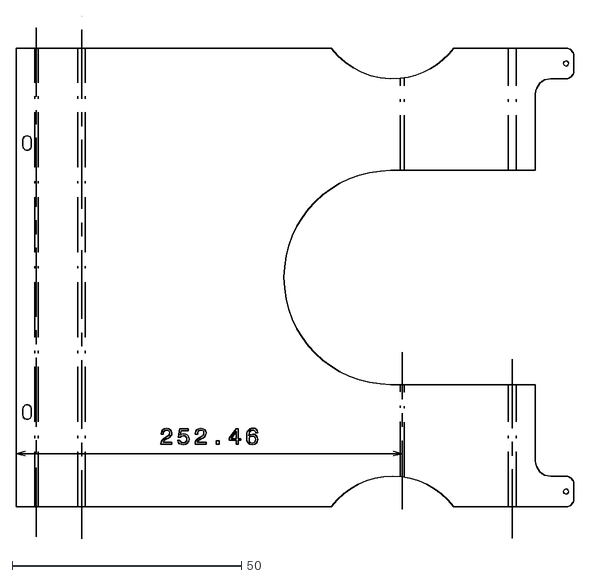
[picture p544: CAD file, 2022-01-12]
AA - Mise en plan/La mache laser/Pdf+dxf/ST_05003/ST_05003 ( Rack protection ).dxf
121.5 x 114.0
