EOSCogniton/ELIZ-2021/AA - Mise en plan/La mache laser/Pdf+dxf/ST_06003/ST_06003 (Right fixation tube).dxf

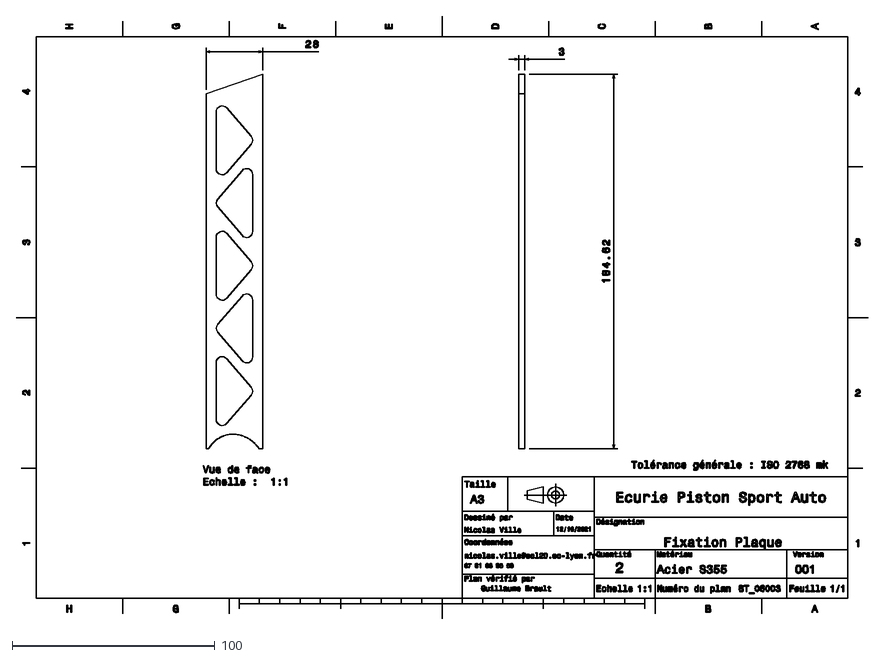
[picture p545: CAD file, 2022-01-12]
AA - Mise en plan/La mache laser/Pdf+dxf/ST_06003/ST_06003 (Right fixation tube).dxf
420.0 x 297.0
