EOSCogniton/ELIZ-2021/AA - Mise en plan/La mache laser/Pdf+dxf/ST_06006/ST_06006 (Fixation U joint side).dxf

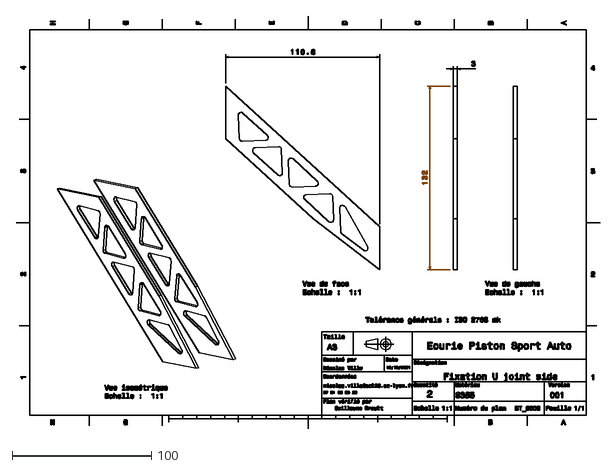
[picture p546: CAD file, 2022-01-12]
AA - Mise en plan/La mache laser/Pdf+dxf/ST_06006/ST_06006 (Fixation U joint side).dxf
420.0 x 297.0
