EOSCogniton/ELIZ-2021/AA - Mise en plan/La mache laser/Pdf+dxf/SU_14004/SU_14004 (Blade).dxf

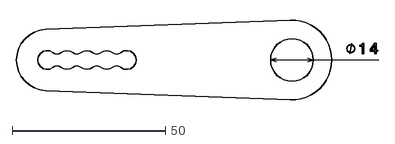
[picture p547: CAD file, 2022-01-12]
AA - Mise en plan/La mache laser/Pdf+dxf/SU_14004/SU_14004 (Blade).dxf
118.3 x 26.3
