EOSCogniton/ELIZ-2021/AA - Mise en plan/La mache laser/Pdf+dxf/SU_14011/SU_14011 (chape BAR).dxf

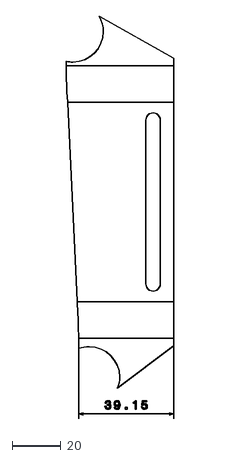
[picture p548: CAD file, 2022-01-12]
AA - Mise en plan/La mache laser/Pdf+dxf/SU_14011/SU_14011 (chape BAR).dxf
44.3 x 165.7
