EOSCogniton/ELIZ-2021/AA - Mise en plan/La mache laser/pdf/Chapes/Acier 2mm/MS_01006 (Bracket seat rear).dxf

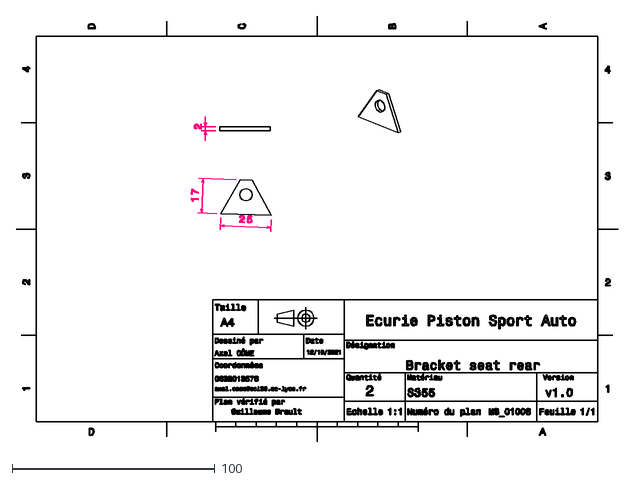
[picture p549: CAD file, 2021-12-15]
AA - Mise en plan/La mache laser/pdf/Chapes/Acier 2mm/MS_01006 (Bracket seat rear).dxf
297.0 x 210.0
