EOSCogniton/ELIZ-2021/AA - Mise en plan/La mache laser/pdf/Chapes/Acier 3mm/ST_06003 (Right fixation tube).dxf

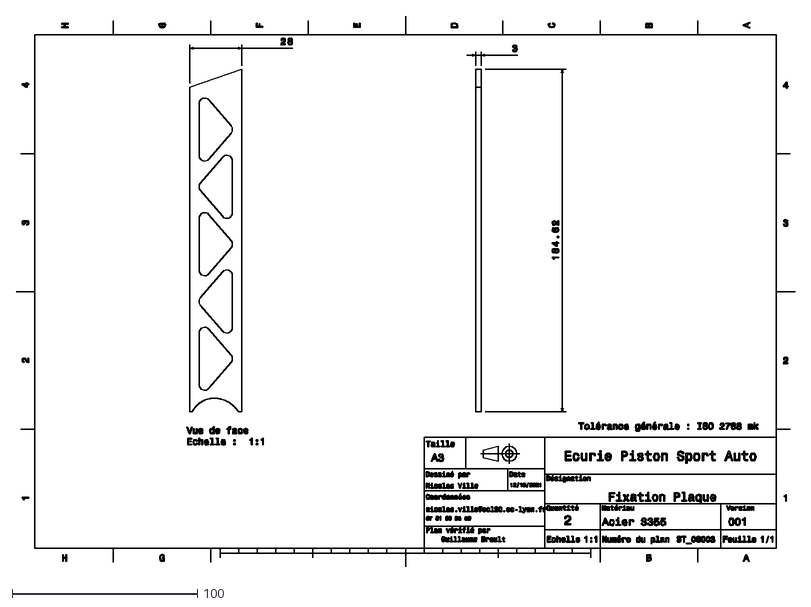
[picture p550: CAD file, 2021-12-15]
AA - Mise en plan/La mache laser/pdf/Chapes/Acier 3mm/ST_06003 (Right fixation tube).dxf
420.0 x 297.0
