EOSCogniton/ELIZ-2021/AA - Mise en plan/La mache laser/pdf/Chapes/Acier 4mm/Chape_M1b.dxf

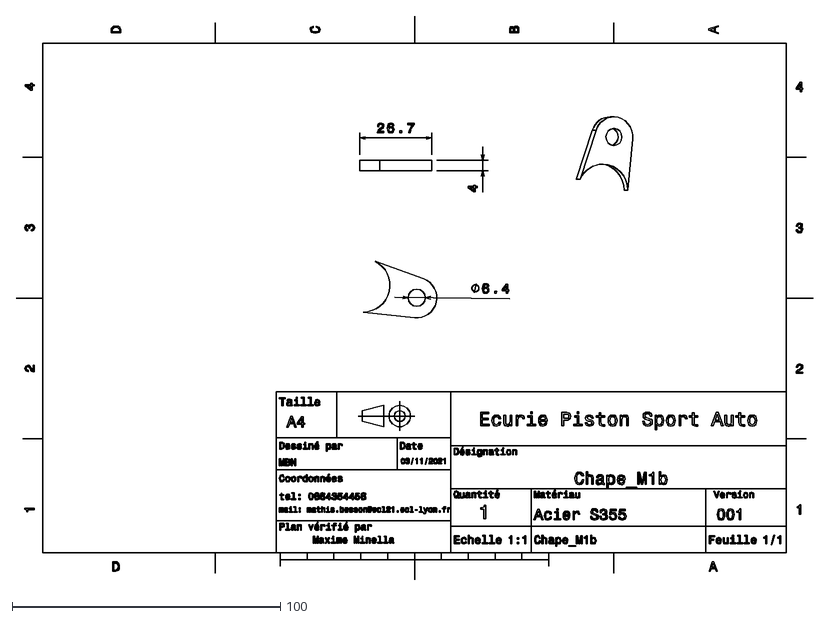
[picture p551: CAD file, 2021-12-15]
AA - Mise en plan/La mache laser/pdf/Chapes/Acier 4mm/Chape_M1b.dxf
297.0 x 210.0
