EOSCogniton/ELIZ-2021/AA - Mise en plan/La Mache Productique/Brake Pedal/FR_04002 (Brake Pedale Stick).stp

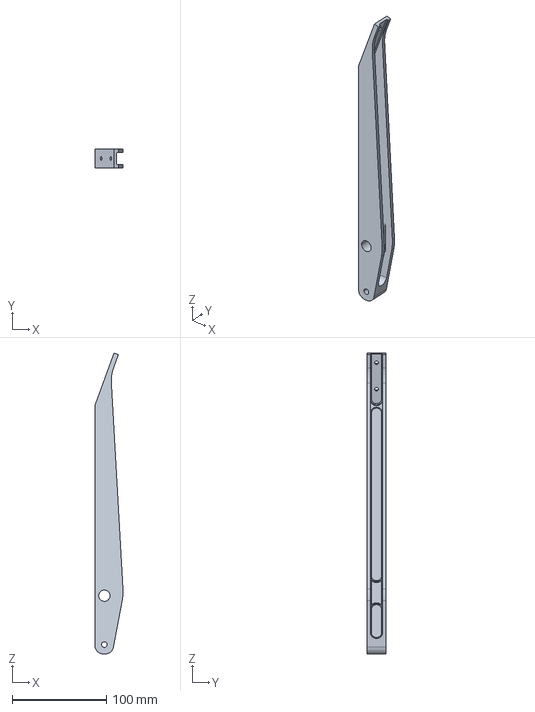
[picture p552: CAD file, 2022-10-07]
AA - Mise en plan/La Mache Productique/Brake Pedal/FR_04002 (Brake Pedale Stick).stp
29.9 x 20.0 x 320.2 mm
