EOSCogniton/ELIZ-2021/AA - Mise en plan/La Mache Productique/Pieces_LMProd_Valkyriz/EN_01010 (sprocket spacer).stp

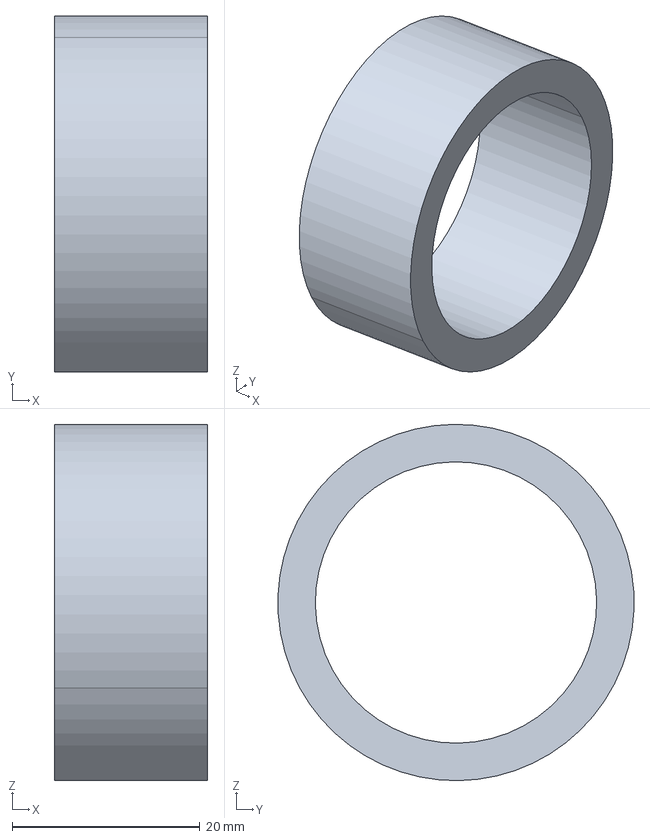
[picture p553: CAD file, 2021-11-15]
AA - Mise en plan/La Mache Productique/Pieces_LMProd_Valkyriz/EN_01010 (sprocket spacer).stp
16.3 x 38.0 x 38.0 mm
