EOSCogniton/ELIZ-2021/AA - Mise en plan/La Mache Productique/STEP/EN_01005 (bearing housing).stp

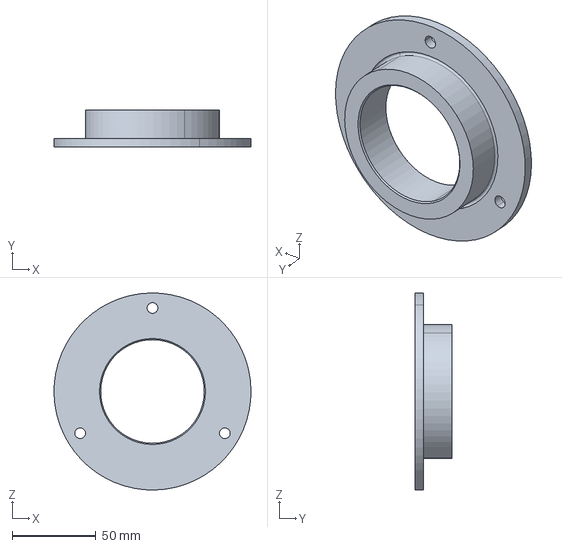
[picture p554: CAD file, 2021-11-15]
AA - Mise en plan/La Mache Productique/STEP/EN_01005 (bearing housing).stp
118.0 x 22.0 x 118.0 mm
