EOSCogniton/ELIZ-2021/AA - Mise en plan/La Mache Productique/Throttle Pedal/FR_03003 (Throttle Pedal Stick).stp

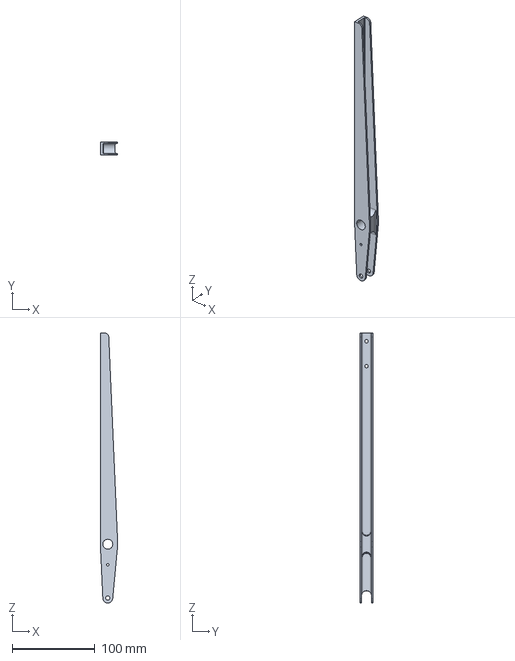
[picture p555: CAD file, 2022-10-07]
AA - Mise en plan/La Mache Productique/Throttle Pedal/FR_03003 (Throttle Pedal Stick).stp
20.9 x 16.0 x 326.0 mm
