EOSCogniton/ELIZ-2021/CR_Cost_Report/03-FR-CBOM/Chassis_EPSA.stp

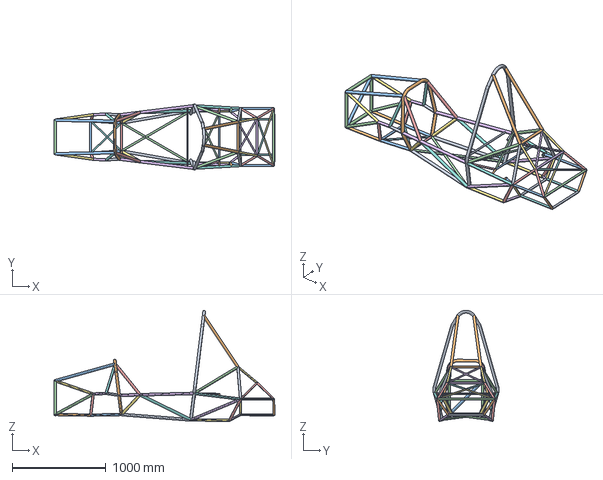
[picture p556: CAD file, 2021-06-06]
CR_Cost_Report/03-FR-CBOM/Chassis_EPSA.stp
2359.8 x 709.7 x 1187.6 mm
12x2.5
