EOSCogniton/ELIZ-2021/EL_Electrical/CATIA/Boitier elec/enclosure_rnd_455-00708.stp

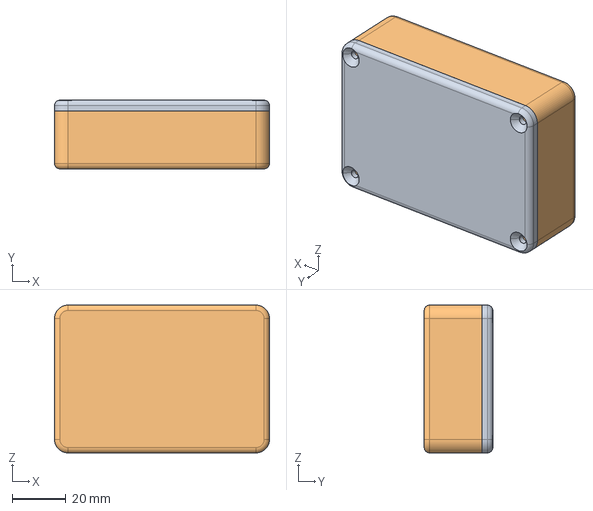
[picture p557: CAD file, 2022-07-18]
EL_Electrical/CATIA/Boitier elec/enclosure_rnd_455-00708.stp
79.9 x 25.5 x 54.9 mm
