EOSCogniton/ELIZ-2021/EL_Electrical/CATIA/chapes/igs/Chape 1590U.igs

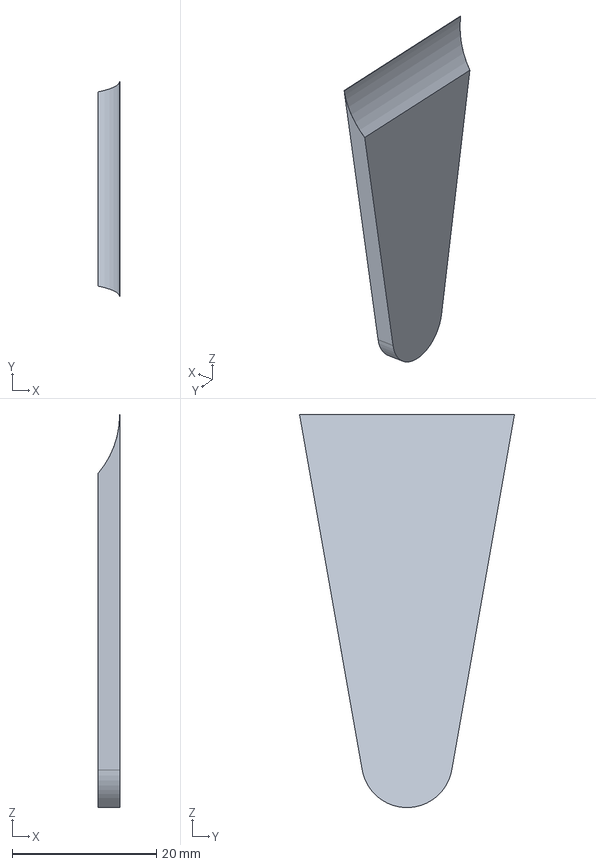
[picture p558: CAD file, 2022-07-06]
EL_Electrical/CATIA/chapes/igs/Chape 1590U.igs
3.00 x 29.9 x 54.6 mm
