EOSCogniton/ELIZ-2021/EL_Electrical/CATIA/EL_A0100 (Dash Panel)/EL_04013 (Screen support).stp

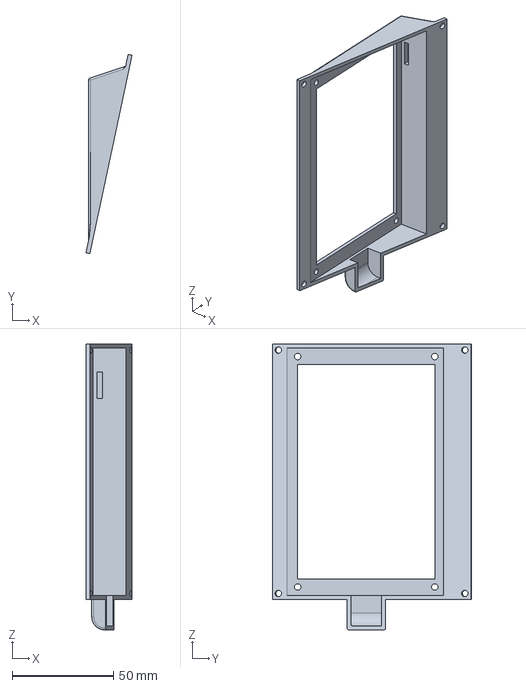
[picture p559: CAD file, 2022-02-16]
EL_Electrical/CATIA/EL_A0100 (Dash Panel)/EL_04013 (Screen support).stp
22.7 x 98.2 x 141.0 mm
