EOSCogniton/ELIZ-2021/EL_Electrical/CATIA/EL_A0400 (TS Box)/Cosse a oeillet/16mm2-5.stp

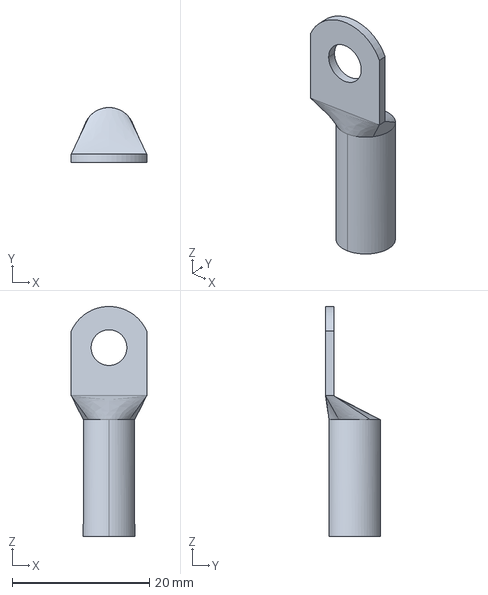
[picture p560: CAD file, 2021-12-08]
EL_Electrical/CATIA/EL_A0400 (TS Box)/Cosse a oeillet/16mm2-5.stp
11.0 x 8.00 x 33.5 mm
