EOSCogniton/ELIZ-2021/EL_Electrical/CATIA/EL_A0400 (TS Box)/EL_A04001 (Boitier)/EKO30C/Fibox_EKOE_280x280x100_B.STEP

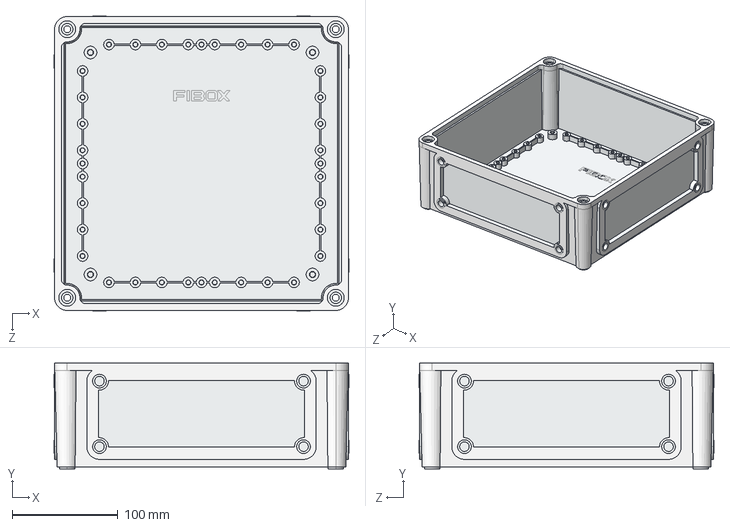
[picture p561: CAD file, 2021-12-08]
EL_Electrical/CATIA/EL_A0400 (TS Box)/EL_A04001 (Boitier)/EKO30C/Fibox_EKOE_280x280x100_B.STEP
279.0 x 100.0 x 279.0 mm
