EOSCogniton/ELIZ-2021/EL_Electrical/CATIA/EL_A0400 (TS Box)/EL_A04002 (Data Logger)/EL_A04002_2 (Data logger FS East)/dl_sensor_holder_top.stp

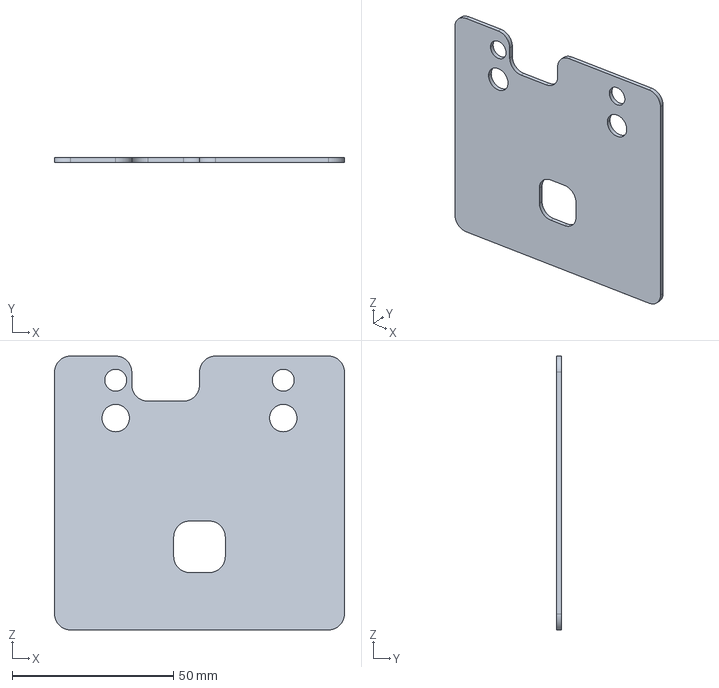
[picture p562: CAD file, 2021-11-15]
EL_Electrical/CATIA/EL_A0400 (TS Box)/EL_A04002 (Data Logger)/EL_A04002_2 (Data logger FS East)/dl_sensor_holder_top.stp
90.0 x 1.50 x 85.0 mm
