EOSCogniton/ELIZ-2021/EL_Electrical/CATIA/EL_A0400 (TS Box)/EL_A04004 (Resistance)/HS50-RSPRO.STEP

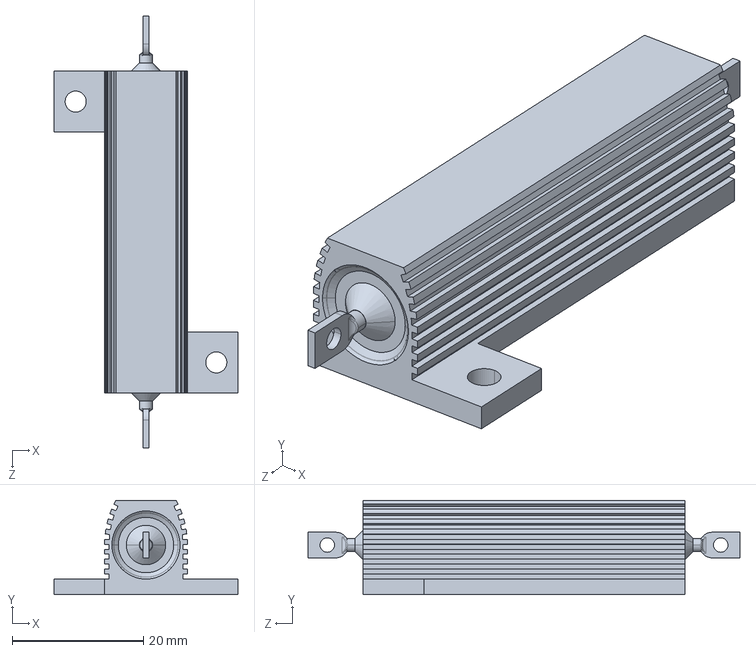
[picture p563: CAD file, 2021-11-15]
EL_Electrical/CATIA/EL_A0400 (TS Box)/EL_A04004 (Resistance)/HS50-RSPRO.STEP
28.0 x 14.4 x 65.7 mm
