EOSCogniton/ELIZ-2021/EL_Electrical/CATIA/EL_A1000 (Accumulator)/MEP batterie bois/Lower/(((Attaches Lower (x2)))).dxf

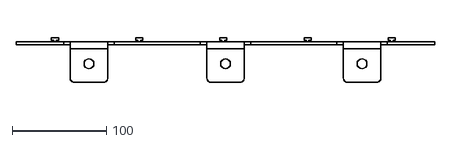
[picture p564: CAD file, 2023-03-30]
EL_Electrical/CATIA/EL_A1000 (Accumulator)/MEP batterie bois/Lower/(((Attaches Lower (x2)))).dxf
444.0 x 47.7
