EOSCogniton/ELIZ-2021/EL_Electrical/CATIA/EL_A1000 (Accumulator)/MEP batterie bois/Upper/Moyen container dessus coté 2 (x2).dxf

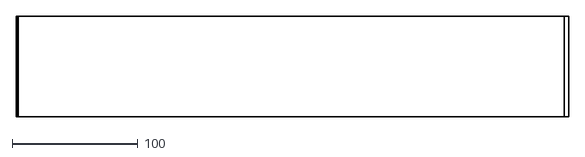
[picture p565: CAD file, 2023-03-30]
EL_Electrical/CATIA/EL_A1000 (Accumulator)/MEP batterie bois/Upper/Moyen container dessus coté 2 (x2).dxf
440.0 x 80.0
