EOSCogniton/ELIZ-2021/EL_Electrical/CATIA/EL_A1300 (High Tension Derivation Box (TSMP, HCS, CDD))/EL_A1304 (Boitier)/EKHA 130 G (Fibox)/FIBOX_EKH30C.STEP

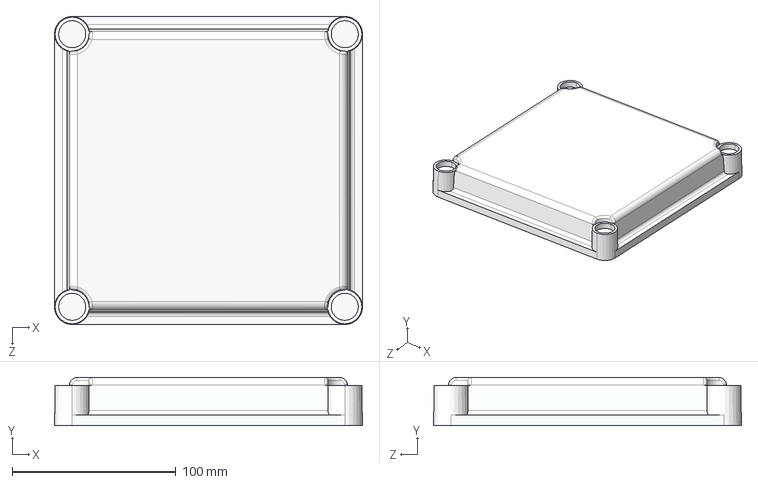
[picture p566: CAD file, 2021-11-15]
EL_Electrical/CATIA/EL_A1300 (High Tension Derivation Box (TSMP, HCS, CDD))/EL_A1304 (Boitier)/EKHA 130 G (Fibox)/FIBOX_EKH30C.STEP
188.0 x 29.5 x 188.0 mm
