EOSCogniton/ELIZ-2021/EL_Electrical/CATIA/EL_A1300 (High Tension Derivation Box (TSMP, HCS, CDD))/EL_A1304 (Boitier)/TA191209 (Fibox)/FIBOX TEMPO 1912 Base.STEP

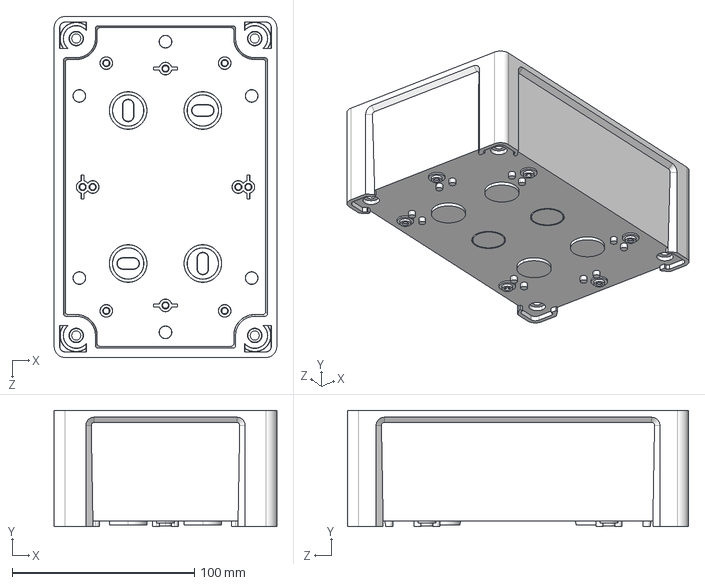
[picture p567: CAD file, 2021-11-15]
EL_Electrical/CATIA/EL_A1300 (High Tension Derivation Box (TSMP, HCS, CDD))/EL_A1304 (Boitier)/TA191209 (Fibox)/FIBOX TEMPO 1912 Base.STEP
122.2 x 63.9 x 187.2 mm
