EOSCogniton/ELIZ-2021/EL_Electrical/CATIA/Gabarits/Gabarit MS bis/MEP gabarit MS bis/MEP gabarit central.dxf

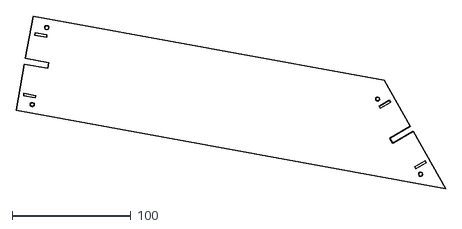
[picture p568: CAD file, 2022-11-27]
EL_Electrical/CATIA/Gabarits/Gabarit MS bis/MEP gabarit MS bis/MEP gabarit central.dxf
362.0 x 145.1
