EOSCogniton/ELIZ-2021/EL_Electrical/CATIA/Gabarits/Gabarit TdB/Plaque centrale.dxf

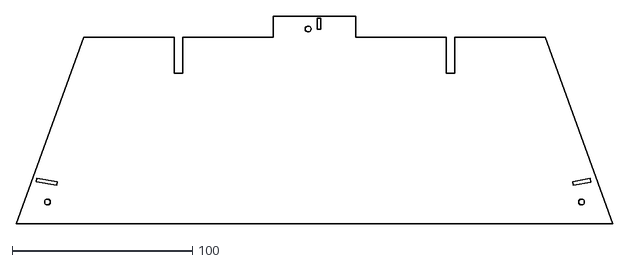
[picture p569: CAD file, 2022-12-07]
EL_Electrical/CATIA/Gabarits/Gabarit TdB/Plaque centrale.dxf
331.1 x 115.0
