EOSCogniton/ELIZ-2021/EL_Electrical/CATIA/Souriau connector/TSAL_LV_souriau_size_14.stp

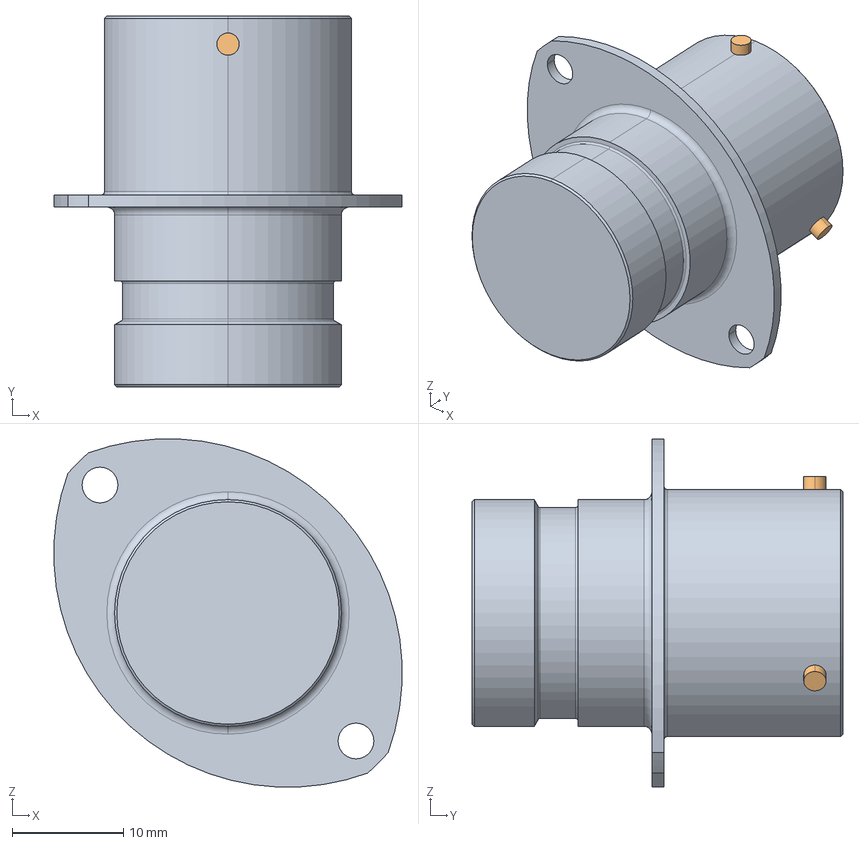
[picture p570: CAD file, 2022-07-18]
EL_Electrical/CATIA/Souriau connector/TSAL_LV_souriau_size_14.stp
31.2 x 33.3 x 31.2 mm
