EOSCogniton/ELIZ-2021/EN_Engine_Drivetrain/Gabarit/MEP/MEP_goupille.dxf

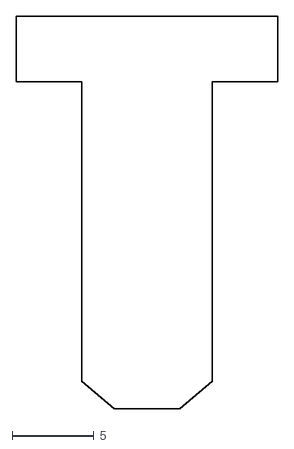
[picture p571: CAD file, 2022-11-30]
EN_Engine_Drivetrain/Gabarit/MEP/MEP_goupille.dxf
16.0 x 24.0
