EOSCogniton/ELIZ-2021/FR_Frame_Body/FR_A0100 (Frame)/Frame_Production/MEP/Tubes/114.stp

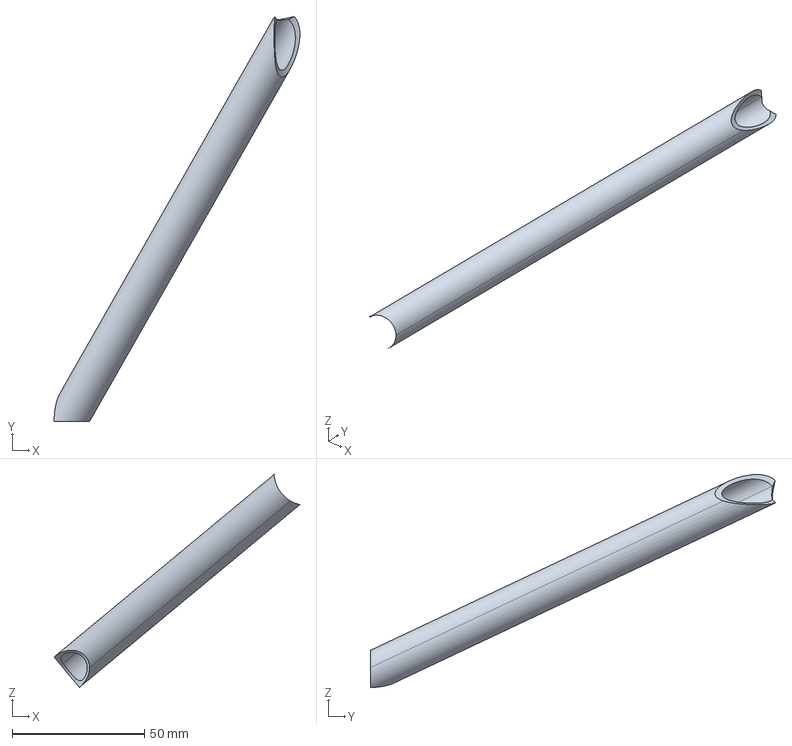
[picture p572: CAD file, 2021-12-15]
FR_Frame_Body/FR_A0100 (Frame)/Frame_Production/MEP/Tubes/114.stp
92.9 x 153.1 x 80.5 mm
