EOSCogniton/ELIZ-2021/FR_Frame_Body/FR_A01100 (gabarit)/carrosserie haut/joint_tube_15.dxf

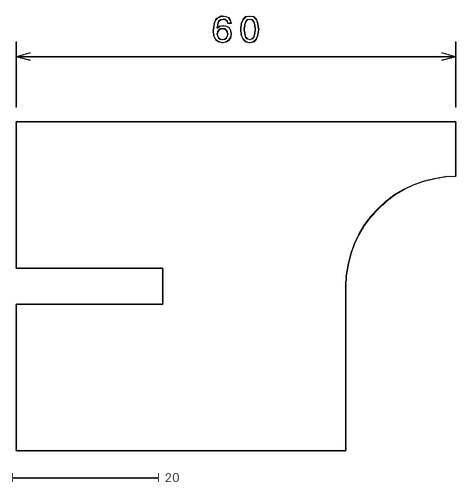
[picture p573: CAD file, 2022-11-15]
FR_Frame_Body/FR_A01100 (gabarit)/carrosserie haut/joint_tube_15.dxf
60.0 x 59.3
