EOSCogniton/ELIZ-2021/FR_Frame_Body/FR_A01100 (gabarit)/gabarit_baq/Montant_petit.dxf

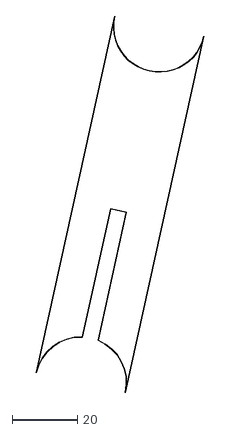
[picture p574: CAD file, 2022-11-15]
FR_Frame_Body/FR_A01100 (gabarit)/gabarit_baq/Montant_petit.dxf
51.4 x 115.2
