EOSCogniton/ELIZ-2021/FR_Frame_Body/FR_A0300_A0400 (Pedal Assy)/FR_A0300 (Throttle Pedal)/Pièces obsclètes - pédale accel/Sodemann 31420.step

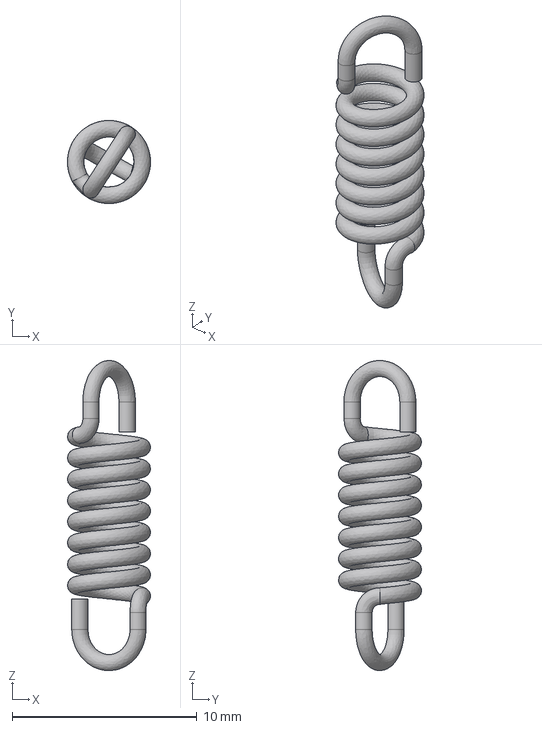
[picture p575: CAD file, 2021-02-16]
FR_Frame_Body/FR_A0300_A0400 (Pedal Assy)/FR_A0300 (Throttle Pedal)/Pièces obsclètes - pédale accel/Sodemann 31420.step
4.50 x 4.50 x 16.8 mm
