EOSCogniton/ELIZ-2021/FR_Frame_Body/FR_A0300_A0400 (Pedal Assy)/plaques accel/Prod plaques laser/FR_10001_1 (Frame Brake).stp

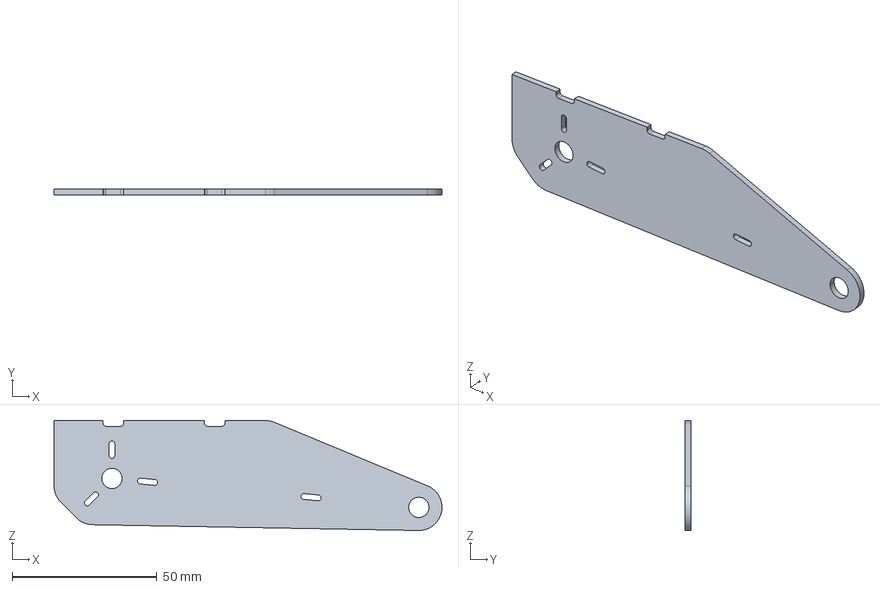
[picture p576: CAD file, 2020-11-10]
FR_Frame_Body/FR_A0300_A0400 (Pedal Assy)/plaques accel/Prod plaques laser/FR_10001_1 (Frame Brake).stp
134.0 x 2.00 x 38.0 mm
