EOSCogniton/ELIZ-2021/ST_Steering_System/Gabarit/DXF_pivot/GST_pivot_4.dxf

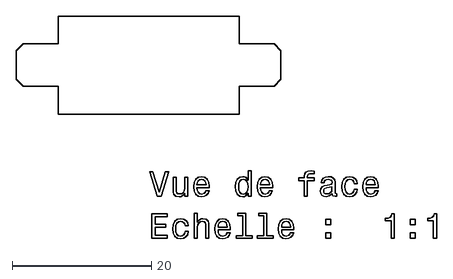
[picture p577: CAD file, 2022-11-29]
ST_Steering_System/Gabarit/DXF_pivot/GST_pivot_4.dxf
60.4 x 32.0
