EOSCogniton/ELIZ-2021/ST_Steering_System/Gabarit/DXF_rotule/GST_rotule_2.dxf

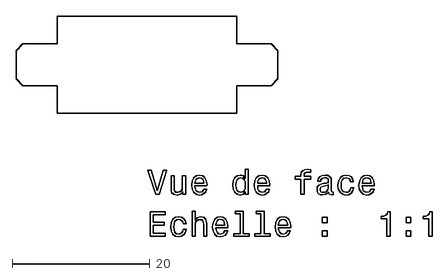
[picture p578: CAD file, 2022-11-29]
ST_Steering_System/Gabarit/DXF_rotule/GST_rotule_2.dxf
60.4 x 32.0
