EOSCogniton/ELIZ-2021/ST_Steering_System/ST_A0600 (Steering shaft pivot)/ST_A06007 (Ball Joint).stp

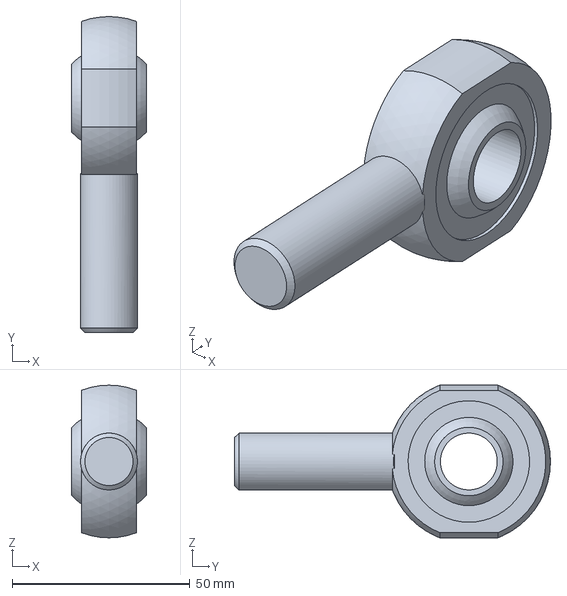
[picture p579: CAD file, 2021-02-10]
ST_Steering_System/ST_A0600 (Steering shaft pivot)/ST_A06007 (Ball Joint).stp
21.0 x 89.0 x 43.0 mm
