EOSCogniton/ELIZ-2021/SU_Suspension/Gabarits/Gabarit BAR/gabarit_BAR.dxf

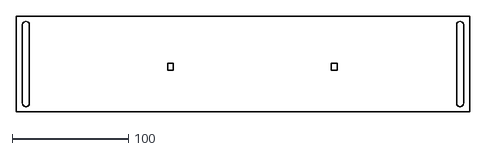
[picture p580: CAD file, 2022-04-05]
SU_Suspension/Gabarits/Gabarit BAR/gabarit_BAR.dxf
390.0 x 82.0
