EOSCogniton/ELIZ-2021/SU_Suspension/Gabarits/Gabarit steering/Support_protection.dxf

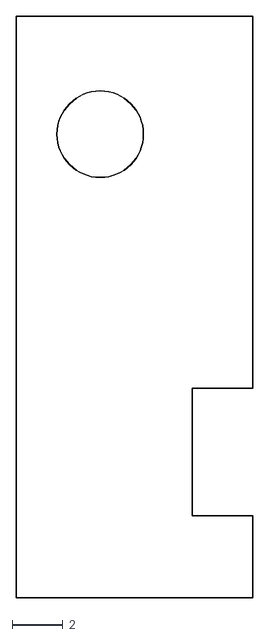
[picture p581: CAD file, 2022-04-06]
SU_Suspension/Gabarits/Gabarit steering/Support_protection.dxf
9.31 x 22.9
