EOSCogniton/ELIZ-2021/SU_Suspension/Gabarits/Gabarit_basculeur/DXF/MEP_basculeur_corp2.2.dxf

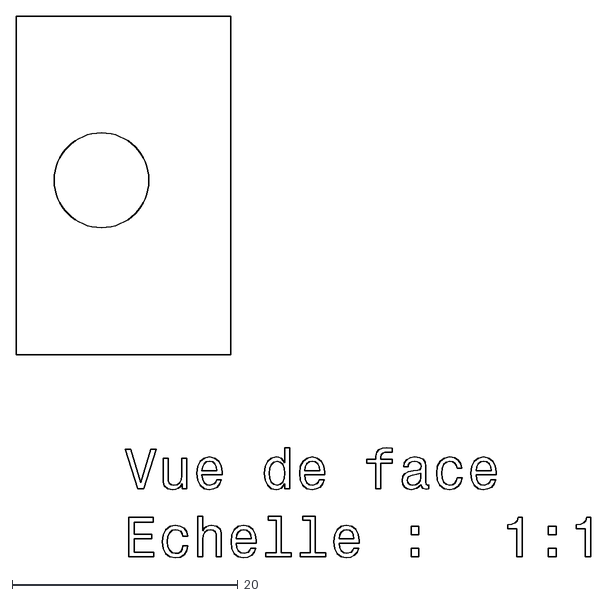
[picture p582: CAD file, 2022-11-29]
SU_Suspension/Gabarits/Gabarit_basculeur/DXF/MEP_basculeur_corp2.2.dxf
50.9 x 48.0
