EOSCogniton/ELIZ-2021/SU_Suspension/Gabarits/Gabarit_basculeur/impression basculeur avant/4mm/MEP_basculeur_corp2.2.dxf

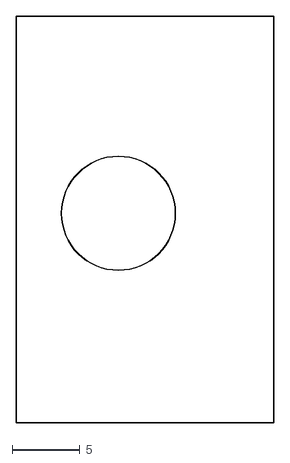
[picture p583: CAD file, 2024-03-12]
SU_Suspension/Gabarits/Gabarit_basculeur/impression basculeur avant/4mm/MEP_basculeur_corp2.2.dxf
19.0 x 30.0
