EOSCogniton/ELIZ-2021/SU_Suspension/Gabarits/Gabarit_basculeur/impression basculeur avant/MEP_basculeur_corp3.dxf

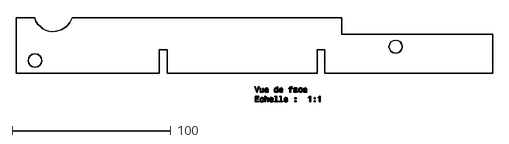
[picture p584: CAD file, 2024-03-12]
SU_Suspension/Gabarits/Gabarit_basculeur/impression basculeur avant/MEP_basculeur_corp3.dxf
300.0 x 53.0
