EOSCogniton/ELIZ-2021/SU_Suspension/Gabarits/Gabarit_Collage/GSU_collage_test.dxf

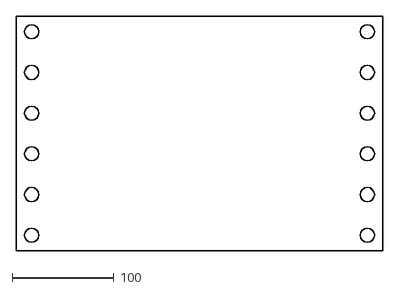
[picture p585: CAD file, 2022-12-15]
SU_Suspension/Gabarits/Gabarit_Collage/GSU_collage_test.dxf
360.0 x 230.0
