EOSCogniton/ELIZ-2021/SU_Suspension/Gabarits/Gabarit_Collage/MEP/MEP_AV.dxf

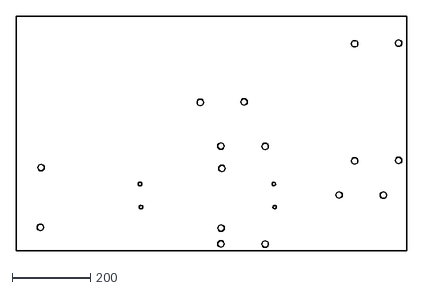
[picture p586: CAD file, 2022-12-16]
SU_Suspension/Gabarits/Gabarit_Collage/MEP/MEP_AV.dxf
1000.0 x 600.0
