EOSCogniton/ELIZ-2021/SU_Suspension/Gabarits/Gabarit_en_triangle_arriere_bas/Gabarit_pince.dxf

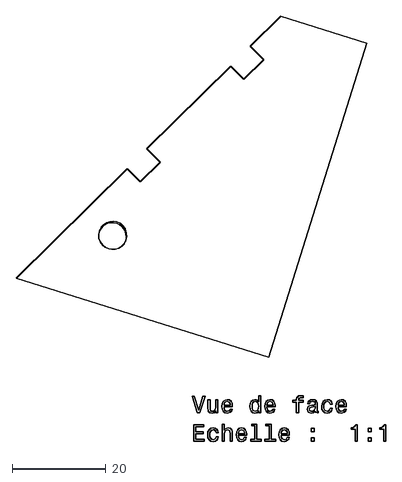
[picture p587: CAD file, 2022-11-30]
SU_Suspension/Gabarits/Gabarit_en_triangle_arriere_bas/Gabarit_pince.dxf
78.7 x 90.6
