EOSCogniton/ELIZ-2021/SU_Suspension/Gabarits/Gabarit_en_triangle_arriere_bas/MEP_AB dxf/E_pince_2.dxf

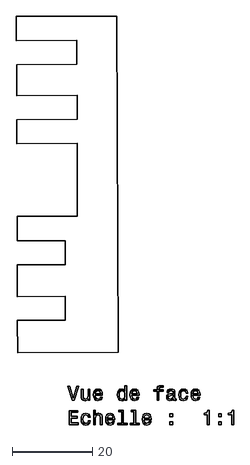
[picture p588: CAD file, 2022-11-30]
SU_Suspension/Gabarits/Gabarit_en_triangle_arriere_bas/MEP_AB dxf/E_pince_2.dxf
54.0 x 101.7
