EOSCogniton/ELIZ-2021/SU_Suspension/Gabarits/Gabarit_en_triangle_arriere_bas/MEP_triangle_ar_bas/gravure4.dxf

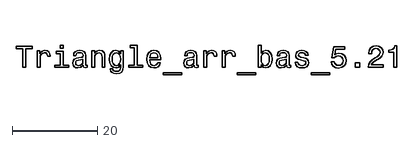
[picture p589: CAD file, 2022-09-09]
SU_Suspension/Gabarits/Gabarit_en_triangle_arriere_bas/MEP_triangle_ar_bas/gravure4.dxf
89.1 x 6.87
