EOSCogniton/ELIZ-2021/SU_Suspension/Gabarits/Gabarit_en_triangle_arriere_haut/mep_AH_dxf/piece_support_arriere_haut_2.dxf

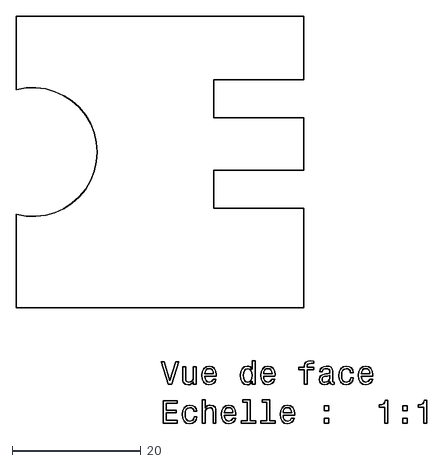
[picture p590: CAD file, 2022-11-30]
SU_Suspension/Gabarits/Gabarit_en_triangle_arriere_haut/mep_AH_dxf/piece_support_arriere_haut_2.dxf
63.7 x 63.2
