EOSCogniton/ELIZ-2021/SU_Suspension/Gabarits/Gabarit_en_triangle_arriere_haut/MEP_triangle_ar_haut/gravure3.dxf

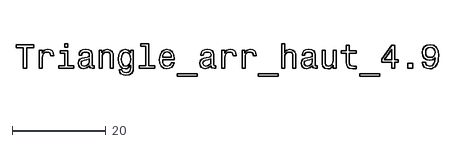
[picture p591: CAD file, 2022-09-09]
SU_Suspension/Gabarits/Gabarit_en_triangle_arriere_haut/MEP_triangle_ar_haut/gravure3.dxf
90.3 x 6.87
