EOSCogniton/ELIZ-2021/SU_Suspension/Gabarits/Gabarit_en_triangle_avant_bas/DXF_tr_av_bas/GSU_tr_av_bas_E_1.dxf

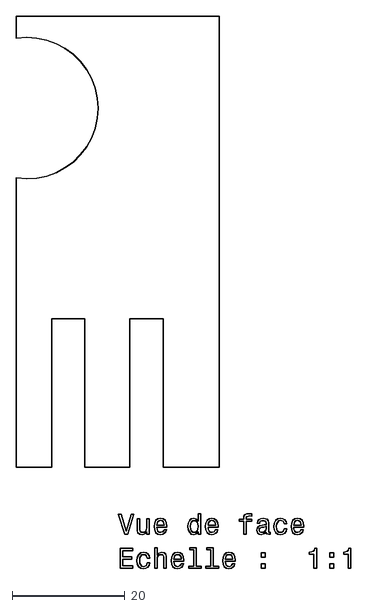
[picture p592: CAD file, 2022-11-29]
SU_Suspension/Gabarits/Gabarit_en_triangle_avant_bas/DXF_tr_av_bas/GSU_tr_av_bas_E_1.dxf
59.4 x 98.0
