EOSCogniton/ELIZ-2021/SU_Suspension/Gabarits/Gabarit_en_triangle_avant_bas/MEP/impression/6mm/GSU_tr_av_goupille.dxf

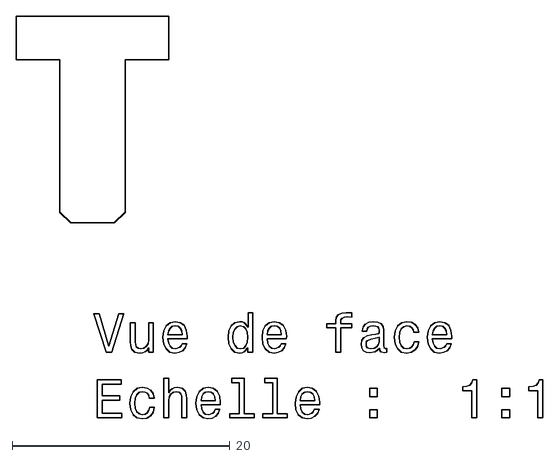
[picture p593: CAD file, 2022-11-29]
SU_Suspension/Gabarits/Gabarit_en_triangle_avant_bas/MEP/impression/6mm/GSU_tr_av_goupille.dxf
48.4 x 37.0
