EOSCogniton/ELIZ-2021/SU_Suspension/Gabarits/Gabarit_en_triangle_avant_bas/MEP/impression/GSU_tr_av_bas_E_1.dxf

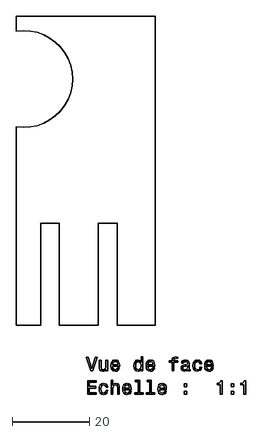
[picture p594: CAD file, 2024-03-12]
SU_Suspension/Gabarits/Gabarit_en_triangle_avant_bas/MEP/impression/GSU_tr_av_bas_E_1.dxf
59.4 x 98.0
