EOSCogniton/ELIZ-2021/SU_Suspension/Gabarits/Gabarit_en_triangle_avant_haut/mep V2/6mm/GSU_L.dxf

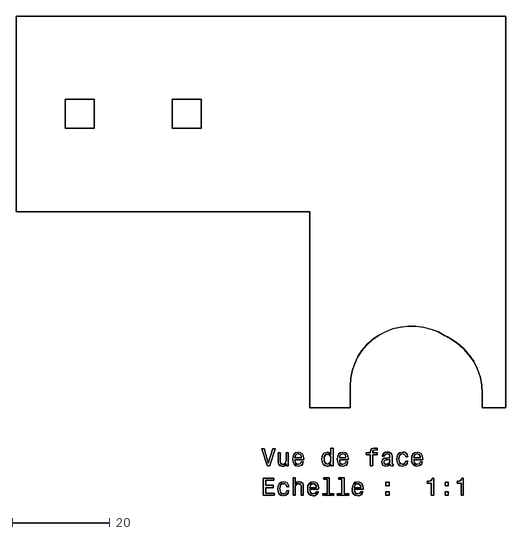
[picture p595: CAD file, 2022-11-29]
SU_Suspension/Gabarits/Gabarit_en_triangle_avant_haut/mep V2/6mm/GSU_L.dxf
100.0 x 98.0
