EOSCogniton/ELIZ-2021/SU_Suspension/Gabarits/Gabarit_en_triangle_avant_haut/mep V2/GSU_TR_AV_BAS_gauche.dxf

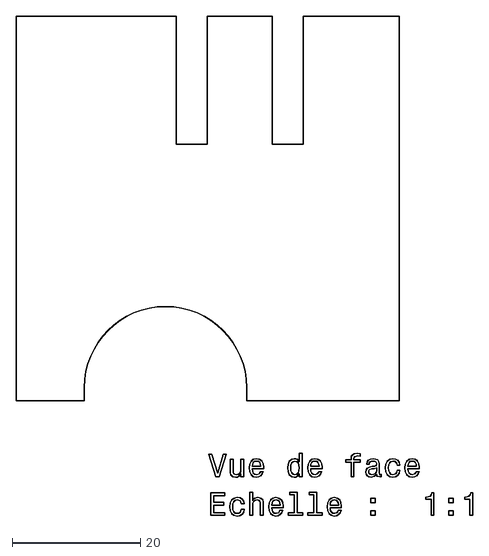
[picture p596: CAD file, 2024-03-06]
SU_Suspension/Gabarits/Gabarit_en_triangle_avant_haut/mep V2/GSU_TR_AV_BAS_gauche.dxf
71.3 x 78.0
