EOSCogniton/ELIZ-2021/SU_Suspension/SU_A1500 (Front Upper A-Arm + Rear Left Wheel Assy)/support_rotule_dessous_v4.dxf

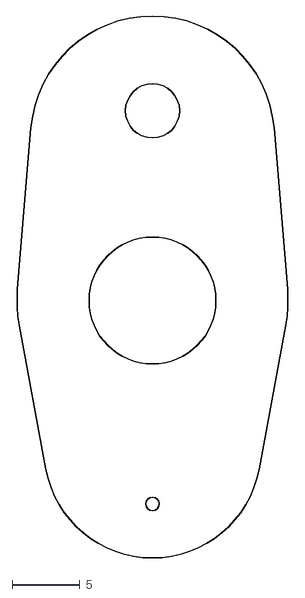
[picture p597: CAD file, 2023-05-24]
SU_Suspension/SU_A1500 (Front Upper A-Arm + Rear Left Wheel Assy)/support_rotule_dessous_v4.dxf
20.1 x 40.0
