EOSCogniton/ELIZ-2021/AA - Mise en plan/AquaCut/EN_01008_v2_2025.dxf

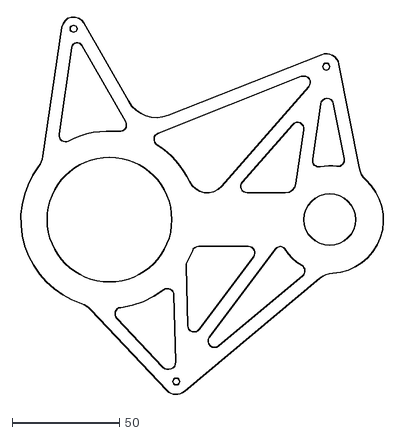
[picture p598: CAD file, 2025-05-22]
AA - Mise en plan/AquaCut/EN_01008_v2_2025.dxf
172.8 x 176.6
