EOSCogniton/ELIZ-2021/AA - Mise en plan/Boisard/pdf/Vague artemiz/WT_03004 (Tripod Housing Spacer).stp

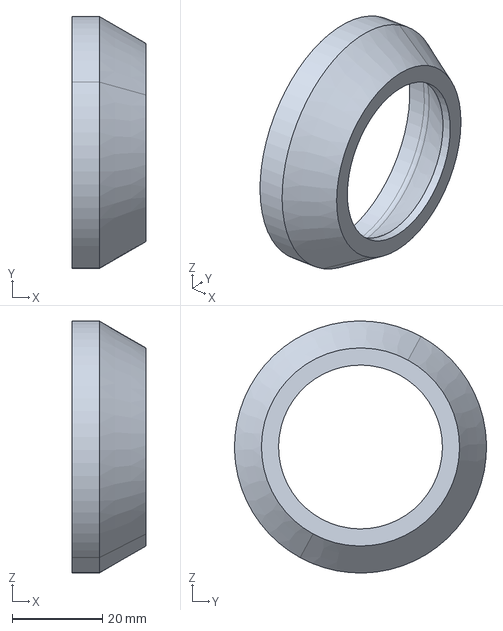
[picture p599: CAD file, 2022-11-23]
AA - Mise en plan/Boisard/pdf/Vague artemiz/WT_03004 (Tripod Housing Spacer).stp
16.5 x 56.0 x 56.0 mm
