EOSCogniton/ELIZ-2021/AA - Mise en plan/La Fabrique/1ervague/FR_010002 (Insert rear).stp

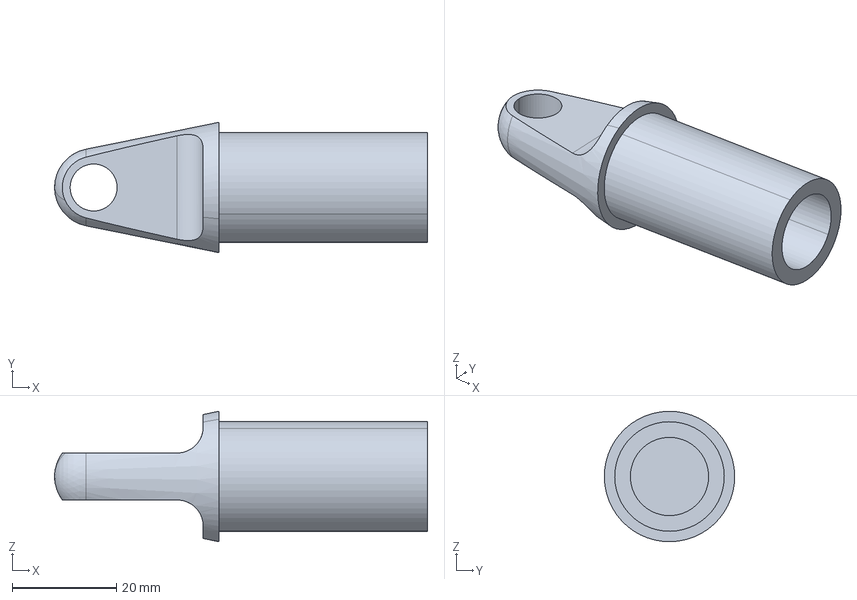
[picture p600: CAD file, 2022-11-15]
AA - Mise en plan/La Fabrique/1ervague/FR_010002 (Insert rear).stp
71.5 x 25.0 x 25.0 mm
