EOSCogniton/ELIZ-2021/AA - Mise en plan/La mache laser/Brake Pedal/FR_04006 (Brake Fixing Rail).dxf

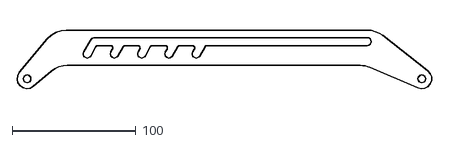
[picture p601: CAD file, 2021-11-15]
AA - Mise en plan/La mache laser/Brake Pedal/FR_04006 (Brake Fixing Rail).dxf
336.2 x 48.2
