EOSCogniton/ELIZ-2021/AA - Mise en plan/La mache laser/Chapes_SU/Chapes_SU_Artemiz/Basculeur arrière/Chape_Re_Damper_Up.dxf

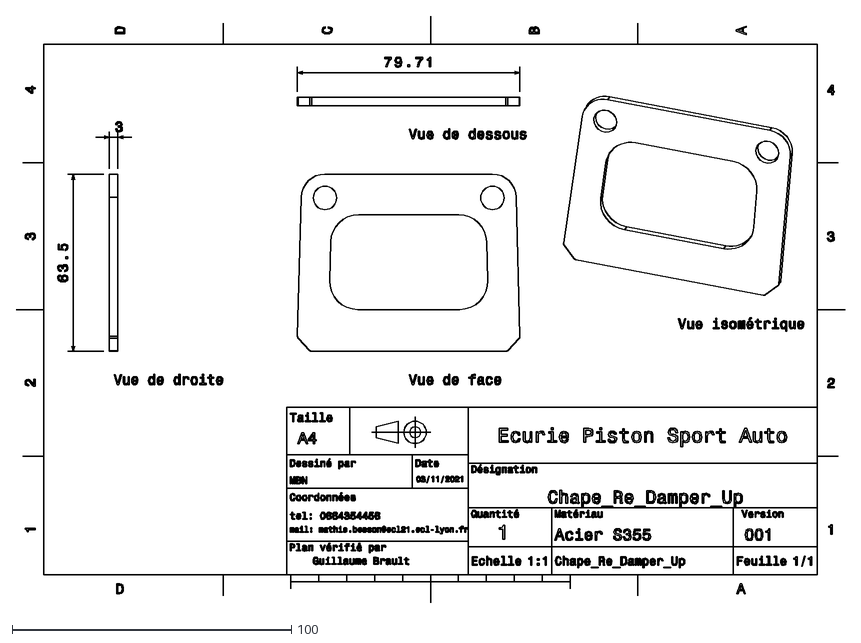
[picture p602: CAD file, 2023-11-08]
AA - Mise en plan/La mache laser/Chapes_SU/Chapes_SU_Artemiz/Basculeur arrière/Chape_Re_Damper_Up.dxf
297.0 x 210.0
