EOSCogniton/ELIZ-2021/AA - Mise en plan/La mache laser/Chapes_SU/Chapes_SU_Artemiz/Basculeur avant/Chape_FRocker_R.dxf

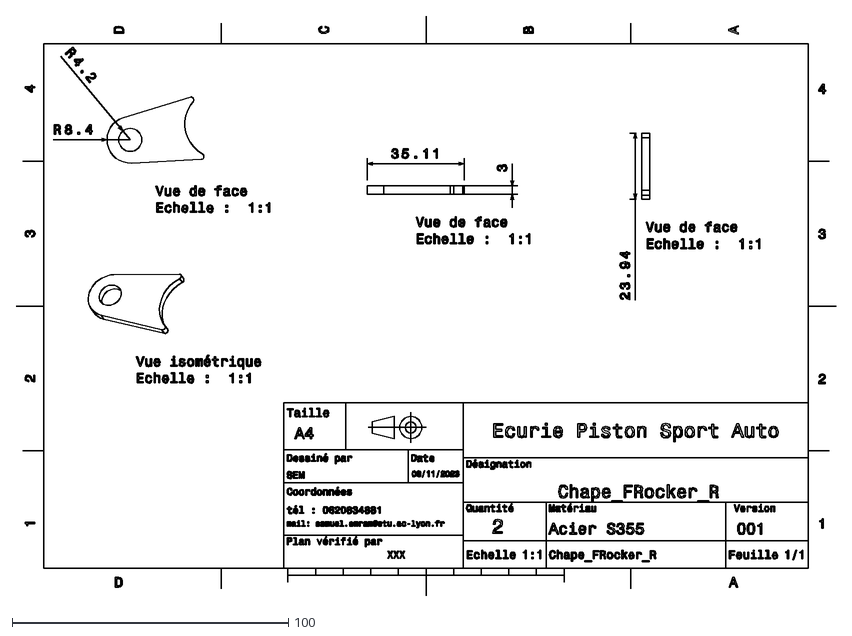
[picture p603: CAD file, 2023-11-12]
AA - Mise en plan/La mache laser/Chapes_SU/Chapes_SU_Artemiz/Basculeur avant/Chape_FRocker_R.dxf
297.0 x 210.0
