EOSCogniton/ELIZ-2021/AA - Mise en plan/La mache laser/Chapes_SU/Chapes_SU_Artemiz/Chape_tie-rod_Low.dxf

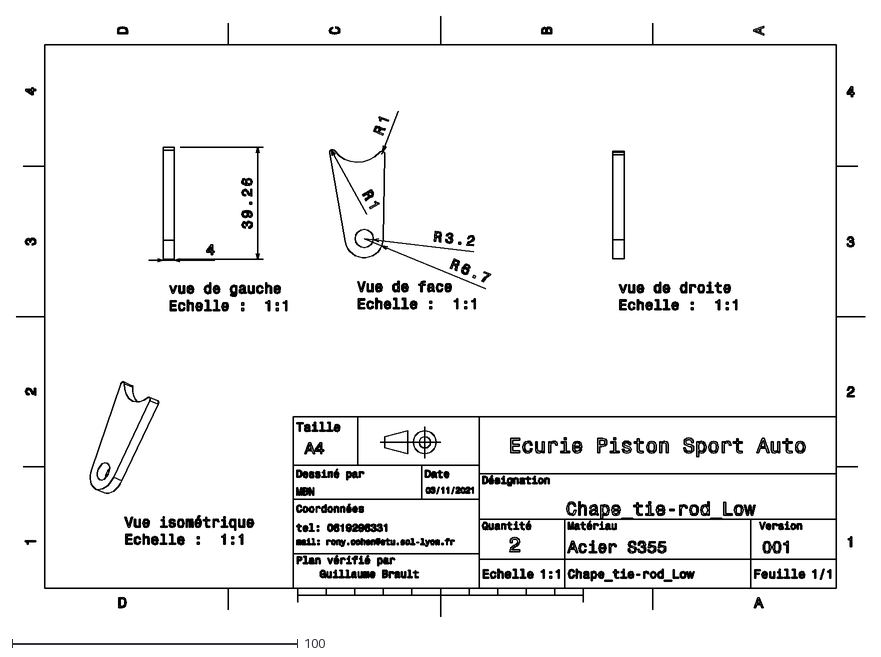
[picture p604: CAD file, 2023-11-08]
AA - Mise en plan/La mache laser/Chapes_SU/Chapes_SU_Artemiz/Chape_tie-rod_Low.dxf
297.0 x 210.0
