EOSCogniton/ELIZ-2021/AA - Mise en plan/La mache laser/CHASEA 2023/Fond plat/FR_06002(Cockpit plate).dxf

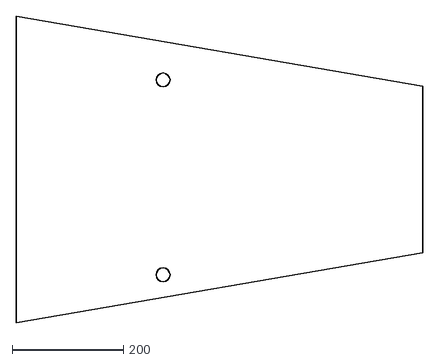
[picture p605: CAD file, 2021-10-19]
AA - Mise en plan/La mache laser/CHASEA 2023/Fond plat/FR_06002(Cockpit plate).dxf
730.0 x 550.0
