EOSCogniton/ELIZ-2021/AA - Mise en plan/La mache laser/CHASEA 2023/Throttle pedal/FR_03002 (Footrest).stp

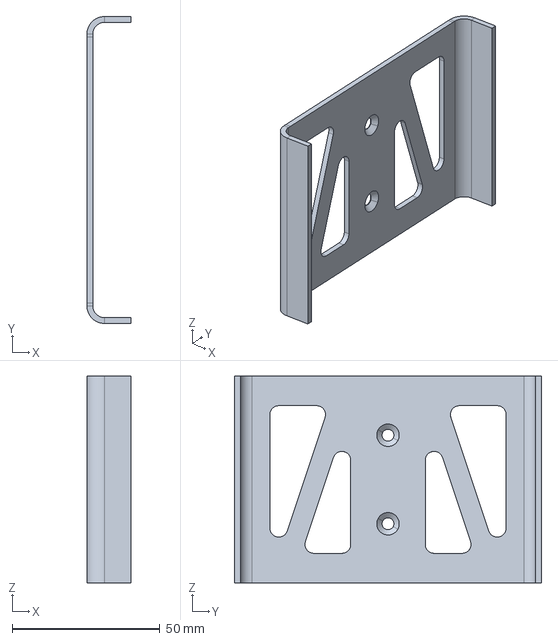
[picture p606: CAD file, 2022-10-07]
AA - Mise en plan/La mache laser/CHASEA 2023/Throttle pedal/FR_03002 (Footrest).stp
15.0 x 104.0 x 70.0 mm
