EOSCogniton/ELIZ-2021/AA - Mise en plan/La mache laser/Elec Valky v3/EL_06008 SUpport HVD.dxf

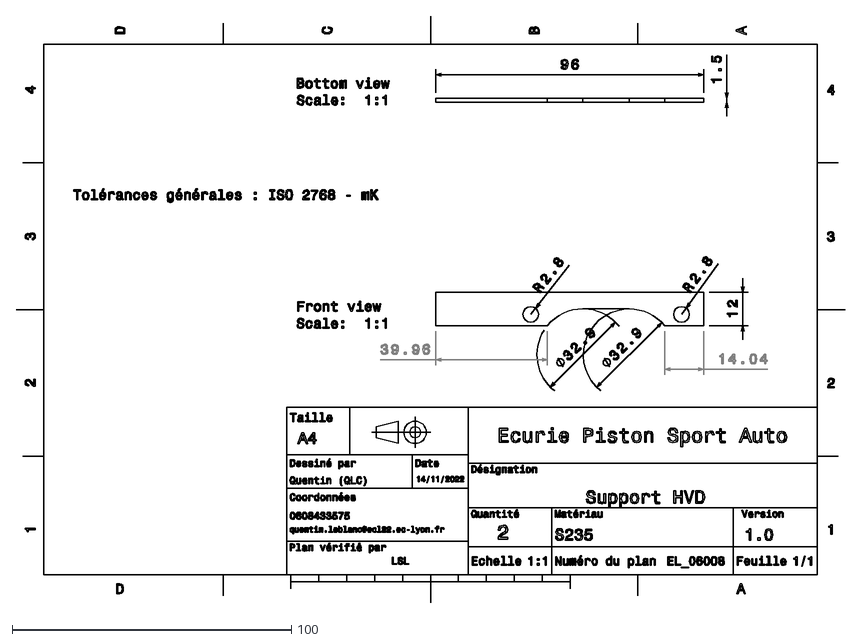
[picture p607: CAD file, 2022-11-15]
AA - Mise en plan/La mache laser/Elec Valky v3/EL_06008 SUpport HVD.dxf
297.0 x 210.0
