EOSCogniton/ELIZ-2021/AA - Mise en plan/La mache laser/EN_01011 Rotor Scatter Shield.dxf

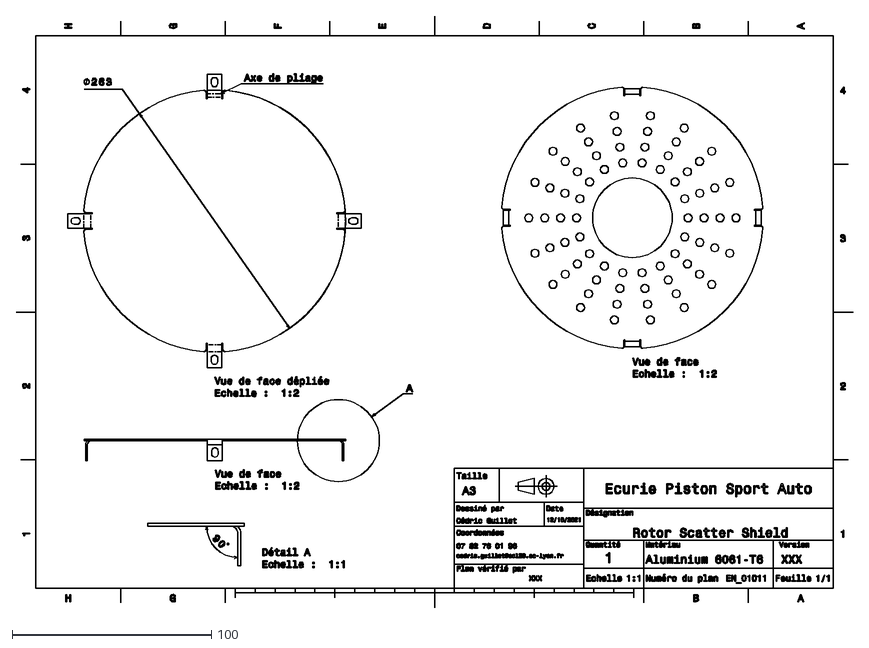
[picture p608: CAD file, 2021-11-15]
AA - Mise en plan/La mache laser/EN_01011 Rotor Scatter Shield.dxf
420.0 x 297.0
