EOSCogniton/ELIZ-2021/AA - Mise en plan/La mache laser/LAS2023/CHAPE/Chape_Fw_Ua_Rp_Up.stp

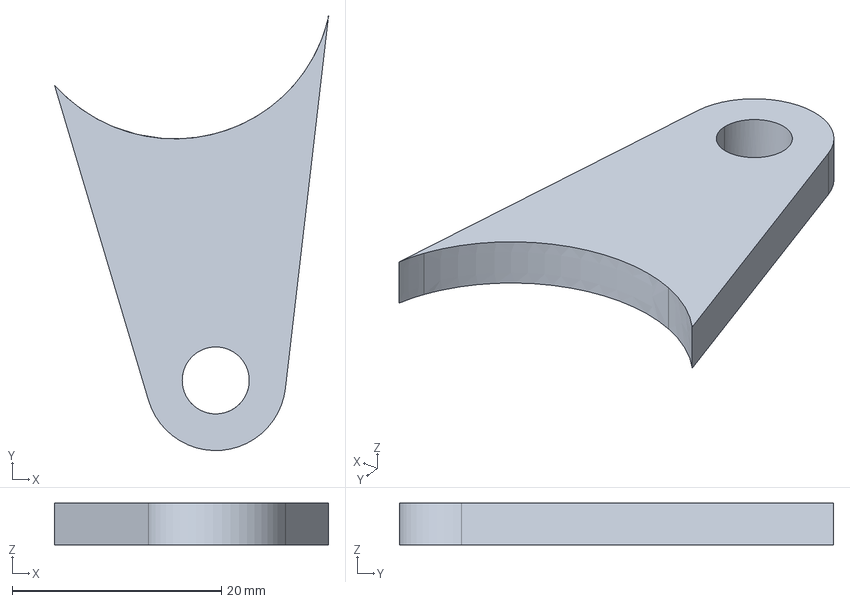
[picture p609: CAD file, 2022-10-13]
AA - Mise en plan/La mache laser/LAS2023/CHAPE/Chape_Fw_Ua_Rp_Up.stp
26.2 x 41.5 x 4.00 mm
