EOSCogniton/ELIZ-2021/AA - Mise en plan/La mache laser/LAS2023/Direction/Peu être pas/ST_05001 (Front Bracket).dxf

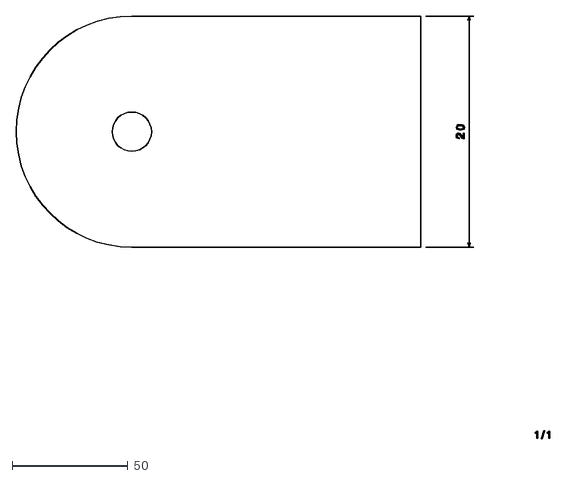
[picture p610: CAD file, 2022-01-12]
AA - Mise en plan/La mache laser/LAS2023/Direction/Peu être pas/ST_05001 (Front Bracket).dxf
230.7 x 182.9
