EOSCogniton/ELIZ-2021/AA - Mise en plan/La mache laser/LAS2023/Suspension/SU_06001/SU_06001 (Front Rocker).stp

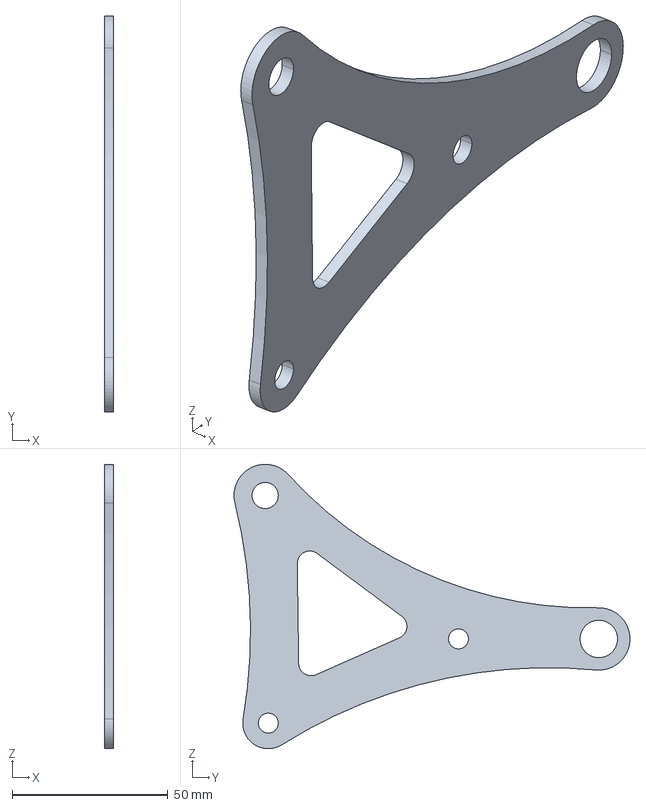
[picture p611: CAD file, 2023-01-16]
AA - Mise en plan/La mache laser/LAS2023/Suspension/SU_06001/SU_06001 (Front Rocker).stp
3.00 x 127.0 x 91.2 mm
