EOSCogniton/ELIZ-2021/AA - Mise en plan/La mache laser/LAS2023/Suspension/SU_08001/SU_08001 (Rear Rocker 3 mm).dxf

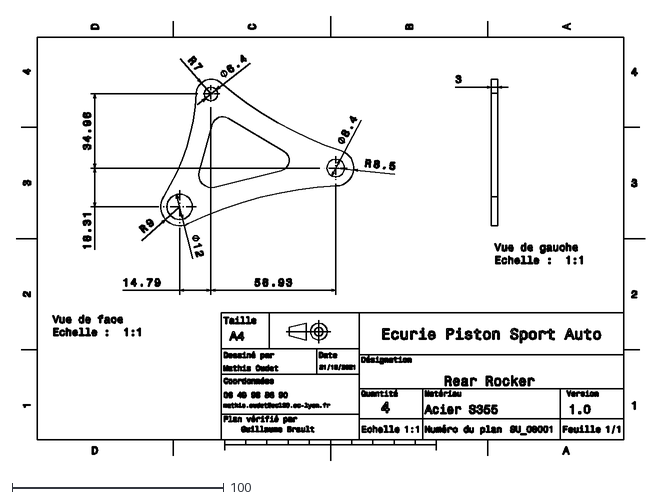
[picture p612: CAD file, 2023-01-16]
AA - Mise en plan/La mache laser/LAS2023/Suspension/SU_08001/SU_08001 (Rear Rocker 3 mm).dxf
297.0 x 210.0
