EOSCogniton/ELIZ-2021/AA - Mise en plan/La mache laser/LAS2023/Suspension/SU_11004 (Camber shim 1mm).stp

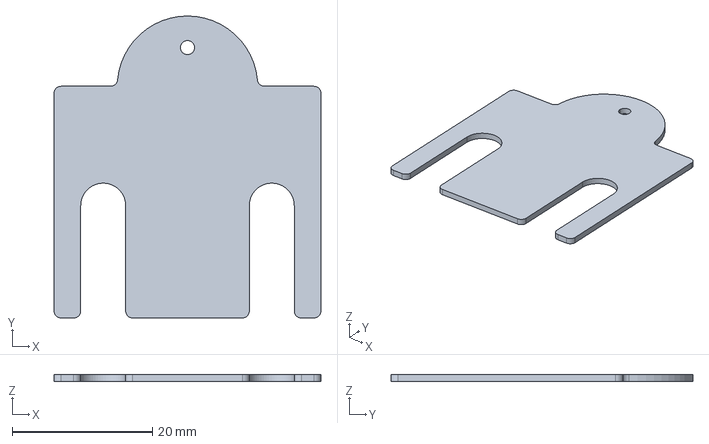
[picture p613: CAD file, 2022-10-13]
AA - Mise en plan/La mache laser/LAS2023/Suspension/SU_11004 (Camber shim 1mm).stp
38.0 x 43.0 x 1.00 mm
