EOSCogniton/ELIZ-2021/AA - Mise en plan/La mache laser/Paroi pare feu/Plan de découpe/MS_04001 (Middle part).dxf

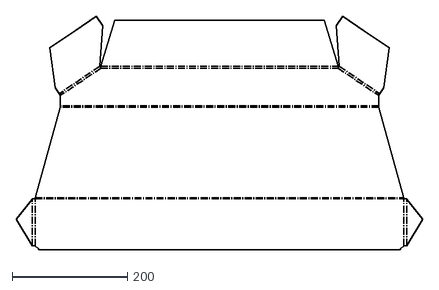
[picture p614: CAD file, 2021-10-19]
AA - Mise en plan/La mache laser/Paroi pare feu/Plan de découpe/MS_04001 (Middle part).dxf
706.3 x 405.3
