EOSCogniton/ELIZ-2021/AA - Mise en plan/La mache laser/Pdf+dxf/CHAPE AMORTISSEUR/Chape_Re_Damper_Down.dxf

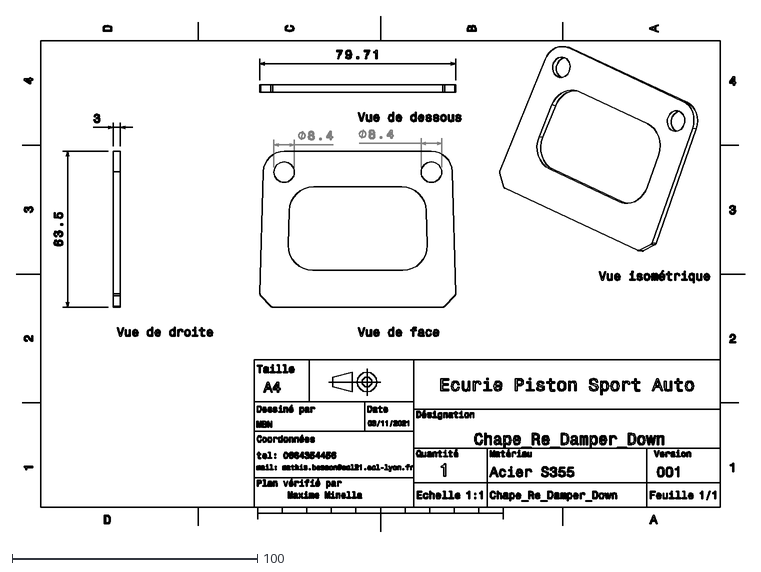
[picture p615: CAD file, 2022-01-12]
AA - Mise en plan/La mache laser/Pdf+dxf/CHAPE AMORTISSEUR/Chape_Re_Damper_Down.dxf
297.0 x 210.0
