EOSCogniton/ELIZ-2021/AA - Mise en plan/La mache laser/Pdf+dxf/CHAPE BASCULEUR/Chape_RRocker_F.dxf

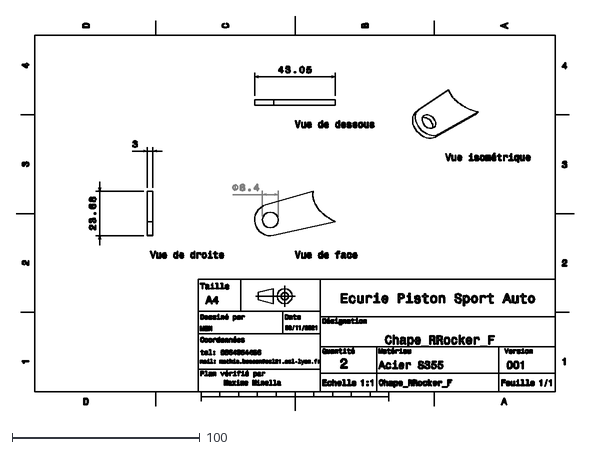
[picture p616: CAD file, 2022-01-12]
AA - Mise en plan/La mache laser/Pdf+dxf/CHAPE BASCULEUR/Chape_RRocker_F.dxf
297.0 x 210.0
