EOSCogniton/ELIZ-2021/AA - Mise en plan/La mache laser/Pdf+dxf/CHAPE SUPPORT MOTEUR/Chape_L1b.dxf

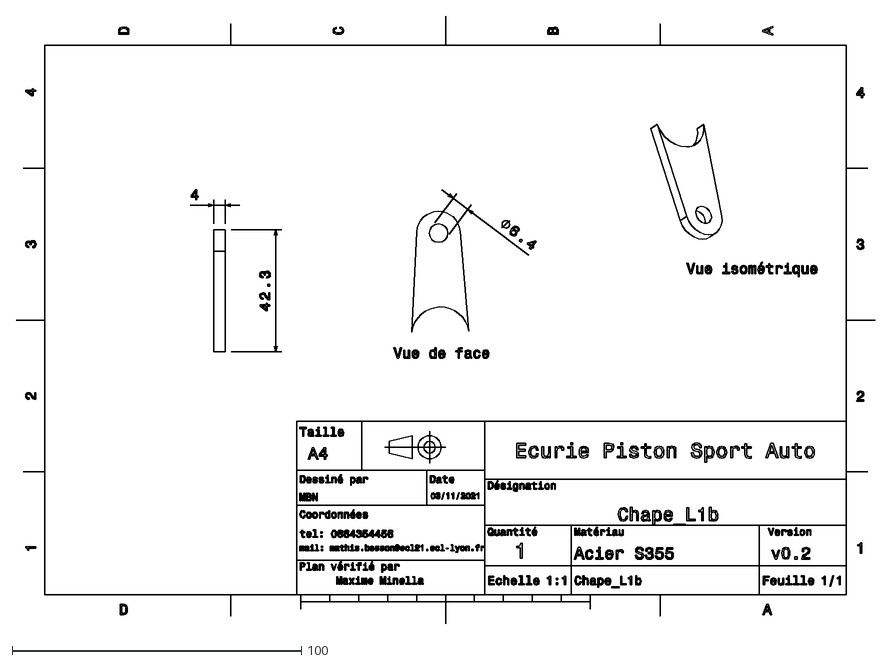
[picture p617: CAD file, 2022-01-12]
AA - Mise en plan/La mache laser/Pdf+dxf/CHAPE SUPPORT MOTEUR/Chape_L1b.dxf
297.0 x 210.0
