EOSCogniton/ELIZ-2021/AA - Mise en plan/La mache laser/Pdf+dxf/EL_A1000 (CONTAINER BATTERIE)/MEP EL_01007_DXF [Container subdivider].dxf

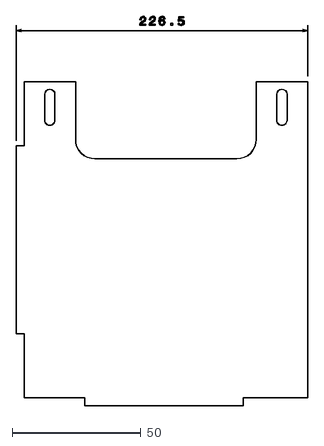
[picture p618: CAD file, 2022-01-12]
AA - Mise en plan/La mache laser/Pdf+dxf/EL_A1000 (CONTAINER BATTERIE)/MEP EL_01007_DXF [Container subdivider].dxf
113.3 x 151.4
