EOSCogniton/ELIZ-2021/AA - Mise en plan/La mache laser/Pdf+dxf/FR_03001/FR_03001_6 Entretoise fond.dxf

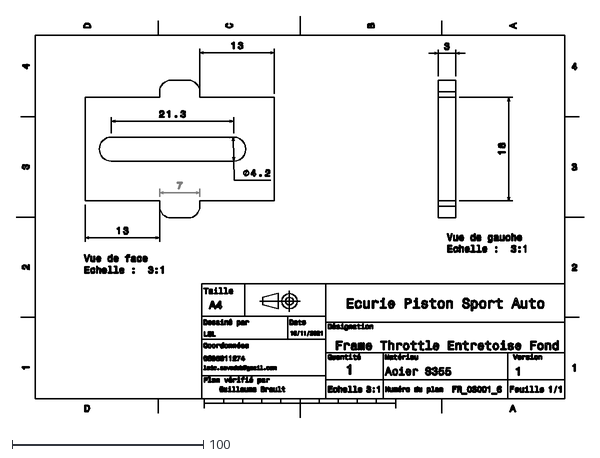
[picture p619: CAD file, 2022-01-12]
AA - Mise en plan/La mache laser/Pdf+dxf/FR_03001/FR_03001_6 Entretoise fond.dxf
297.0 x 210.0
