EOSCogniton/ELIZ-2021/AA - Mise en plan/La mache laser/Pdf+dxf/FR_04001/FR_04001_6 (Frame Brake).dxf

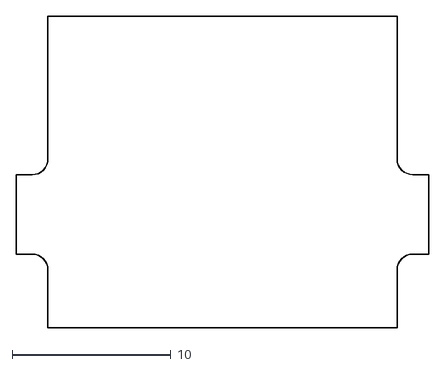
[picture p620: CAD file, 2022-01-12]
AA - Mise en plan/La mache laser/Pdf+dxf/FR_04001/FR_04001_6 (Frame Brake).dxf
26.0 x 19.7
