EOSCogniton/ELIZ-2021/AA - Mise en plan/La mache laser/Pdf+dxf/FR_04007/FR_04007 (Brake R Fixing Rail Wedge).dxf

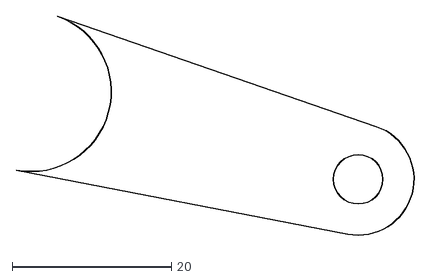
[picture p621: CAD file, 2022-01-12]
AA - Mise en plan/La mache laser/Pdf+dxf/FR_04007/FR_04007 (Brake R Fixing Rail Wedge).dxf
50.6 x 28.0
