EOSCogniton/ELIZ-2021/AA - Mise en plan/La mache laser/Pdf+dxf/FR_04008/FR_04008 (Front Brake bracket).dxf

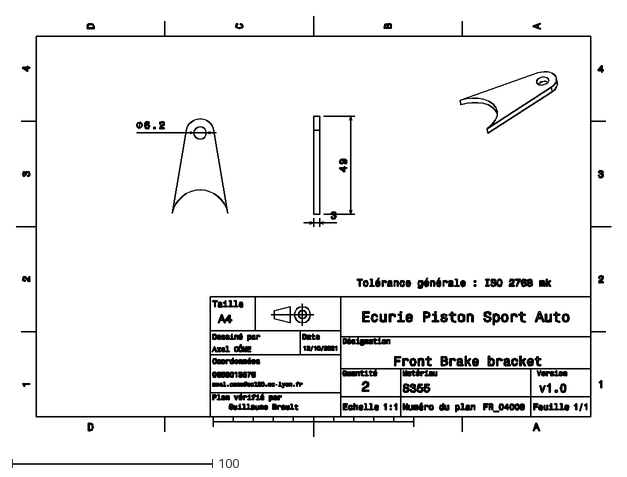
[picture p622: CAD file, 2022-01-12]
AA - Mise en plan/La mache laser/Pdf+dxf/FR_04008/FR_04008 (Front Brake bracket).dxf
297.0 x 210.0
