EOSCogniton/ELIZ-2021/AA - Mise en plan/La mache laser/Pdf+dxf/FR_06003/FR_06003_4 (Floor pan bracket)(Cockpit_Rear).dxf

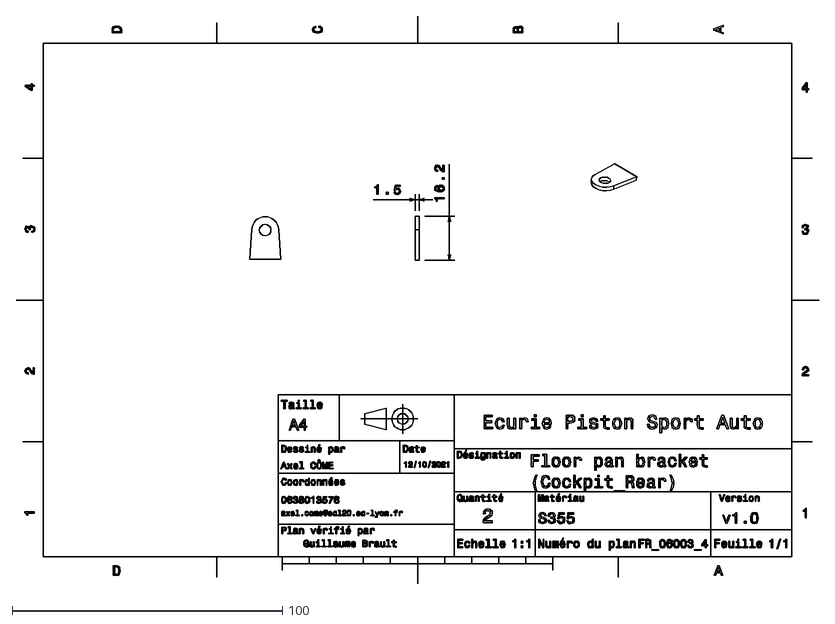
[picture p623: CAD file, 2022-01-12]
AA - Mise en plan/La mache laser/Pdf+dxf/FR_06003/FR_06003_4 (Floor pan bracket)(Cockpit_Rear).dxf
297.0 x 210.0
