EOSCogniton/ELIZ-2021/AA - Mise en plan/La mache laser/Pdf+dxf/MS_02004/MS_02004_1 (Right Down Bracket Head Restraint).dxf

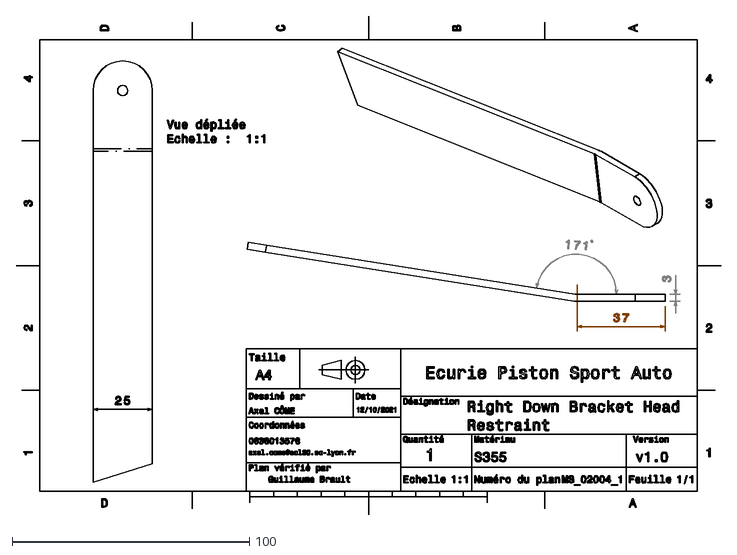
[picture p626: CAD file, 2022-01-12]
AA - Mise en plan/La mache laser/Pdf+dxf/MS_02004/MS_02004_1 (Right Down Bracket Head Restraint).dxf
297.0 x 210.0
