EOSCogniton/ELIZ-2021/(list of files, cad)

Other CAD files:
FR_Frame_Body/FR_A0100 (Frame)/Frame_Production/MEP/Hoop/filaire main hoop.stp
EL_Electrical/CATIA/EL_A1300 (High Tension Derivation Box (TSMP, HCS, CDD))/EL_A1304 (Boitier)/TA131308 (Fibox)/TA1313C.dwg
FR_Frame_Body/FR_A0100 (Frame)/Frame_Production/MEP/Hoop/filaire front hoop.stp
FR_Frame_Body/FR_A0300_A0400 (Pedal Assy)/FR_A0400 (Brake Pedal)/FR_04002 (Brake Pedale Stick).stp
AA - Mise en plan/La mache laser/LAS2023/Direction/Mis sur google drive/ST_04003 (Left Bracket).stp
AA - Mise en plan/AquaCut/EN_01008 Right Engine Bracket.dxf
AA - Mise en plan/AquaCut/EN_01008 Right Engine Bracket_V2.dxf
AA - Mise en plan/AquaCut/EN_01008 Right Engine Bracket_V3.dxf
AA - Mise en plan/AquaCut/En_01009 Left Engine Bracket.dxf
AA - Mise en plan/AquaCut/En_01009 Left Engine Bracket_V2.dxf
AA - Mise en plan/AquaCut/En_01009 Left Engine Bracket_V3.dxf
AA - Mise en plan/Boisard/pdf/Vague artemiz/FR_XXXX(Insert batterie).dxf
AA - Mise en plan/Boisard/pdf/Vague artemiz/ST_03004 (Insert middle).stp
AA - Mise en plan/Boisard/pdf/Vague artemiz/ST_03004 (insert mid).dxf
AA - Mise en plan/Boisard/pdf/Vague artemiz/ST_04001 (Half Moon top).stp
AA - Mise en plan/Boisard/pdf/Vague artemiz/ST_04001 (Half moon top).dxf
AA - Mise en plan/Boisard/pdf/Vague artemiz/ST_04002 (Half moon bellow).dxf
AA - Mise en plan/Boisard/pdf/Vague artemiz/ST_06001 (Pivot de direction).dxf
AA - Mise en plan/Boisard/pdf/Vague artemiz/ST_06001 (Steering upper shaft).stp
AA - Mise en plan/Boisard/pdf/Vague artemiz/SU_11002 (Upper arm bracket).dxf
AA - Mise en plan/Boisard/pdf/Vague artemiz/SU_11002 (Upper arm bracket).stp
AA - Mise en plan/Boisard/pdf/Vague artemiz/WT_02001 (Front Hub).dxf
AA - Mise en plan/Boisard/pdf/Vague artemiz/WT_02001 (Front Hub).stp
AA - Mise en plan/Boisard/pdf/Vague artemiz/WT_02003 (Bearing Washer).dxf
AA - Mise en plan/Boisard/pdf/Vague artemiz/WT_02003 (Front Bearing Washer).stp
AA - Mise en plan/Boisard/pdf/Vague artemiz/WT_02005 (Front Speed Sensor Disc).stp
AA - Mise en plan/Boisard/pdf/Vague artemiz/WT_02005 (speed disc).dxf
AA - Mise en plan/Boisard/pdf/Vague artemiz/WT_03001 (Rear Hub).dxf
AA - Mise en plan/Boisard/pdf/Vague artemiz/WT_03001 (Rear Hub).stp
AA - Mise en plan/Boisard/pdf/Vague artemiz/WT_03004 (Tripod housing spacer).dxf
AA - Mise en plan/La Fabrique/1ervague/EN_01005.stp
AA - Mise en plan/La Fabrique/1ervague/EN_01010 (sprocket spacer).stp
AA - Mise en plan/La Fabrique/1ervague/SU_06002 (pivot joint spacer).stp
AA - Mise en plan/La Fabrique/SU_03003 (Rear Upper Rod-End Support).dxf
AA - Mise en plan/La Mache Productique/Pieces_LMProd_Valkyriz/EN_01002 (flanged shaft).stp
AA - Mise en plan/La Mache Productique/Pieces_LMProd_Valkyriz/EN_04001 (Excentrique droit).stp
AA - Mise en plan/La Mache Productique/Pieces_LMProd_Valkyriz/EN_04013 (Excentrique Gauche).stp
AA - Mise en plan/La Mache Productique/Pieces_LMProd_Valkyriz/ST_02001 (Steering Column).stp
AA - Mise en plan/La Mache Productique/Pieces_LMProd_Valkyriz/SU_06002 (pivot joint spacer).stp
AA - Mise en plan/La Mache Productique/Pieces_LMProd_Valkyriz/SU_06003 (ball joint spacer M6 5mm).stp
AA - Mise en plan/La Mache Productique/Pieces_LMProd_Valkyriz/WT_02002 (Brake Bell).stp
AA - Mise en plan/La Mache Productique/STEP/EN_01002 (flanged shaft).stp
AA - Mise en plan/La Mache Productique/STEP/EN_04001 (Excentrique droit).stp
AA - Mise en plan/La Mache Productique/STEP/EN_04013 (Excentrique Gauche).stp
AA - Mise en plan/La Mache Productique/STEP/ST_02001 (Steering Column).stp
AA - Mise en plan/La Mache Productique/STEP/SU_06002 (pivot joint spacer).stp
AA - Mise en plan/La Mache Productique/STEP/SU_06003 (ball joint spacer M6 5mm).stp
AA - Mise en plan/La Mache Productique/STEP/WT_02002 (Brake Bell).stp
AA - Mise en plan/La Mache Productique/Throttle Pedal/FR_03003 Throttle Pedal Stick.dxf
AA - Mise en plan/La Mache Productique/Throttle Pedal/FR_03013 (Rear Potentiometer Threated Rod).dxf
AA - Mise en plan/La mache laser/Brake Pedal/FR_04002 (Brake Pedale Stick).dxf
AA - Mise en plan/La mache laser/Brake Pedal/FR_04007 (Brake R Fixing Rail Wedge).dxf
AA - Mise en plan/La mache laser/Brake Pedal/FR_04008 (Front Fixing Rail Wedge).dxf
AA - Mise en plan/La mache laser/Brake Pedal/FR_04010 (Distribution Brake Axle Tread).dxf
AA - Mise en plan/La mache laser/Brake Pedal/FR_04012 (Brake Distribution Ball Joint).dxf
AA - Mise en plan/La mache laser/Brake Pedal/FR_04013 (Bots Support).dxf
AA - Mise en plan/La mache laser/Brake Pedal/FR_04015 (Brake Pedal Hose Wedge).dxf
AA - Mise en plan/La mache laser/Brake Pedal/FR_04016 (Cylinder Screw Distribution).dxf
AA - Mise en plan/La mache laser/Brake Pedal/FR_04018 (Brake Threated Rod).dxf
AA - Mise en plan/La mache laser/Brake Pedal/Frame Brake/FR_04001_10(Frame Brake).CATPart
AA - Mise en plan/La mache laser/Brake Pedal/Frame Brake/FR_04001_11(Frame Brake).CATPart
AA - Mise en plan/La mache laser/Brake Pedal/Frame Brake/Plans de découpe/FR_04001_1 (Frame Brake).dxf
AA - Mise en plan/La mache laser/Brake Pedal/Frame Brake/Plans de découpe/FR_04001_10 (Frame Brake).dxf
AA - Mise en plan/La mache laser/Brake Pedal/Frame Brake/Plans de découpe/FR_04001_11 (Frame Brake).dxf
AA - Mise en plan/La mache laser/Brake Pedal/Frame Brake/Plans de découpe/FR_04001_2 (Frame Brake).dxf
AA - Mise en plan/La mache laser/Brake Pedal/Frame Brake/Plans de découpe/FR_04001_3 (Frame Brake).dxf
AA - Mise en plan/La mache laser/Brake Pedal/Frame Brake/Plans de découpe/FR_04001_5 (Frame Brake).dxf
AA - Mise en plan/La mache laser/Brake Pedal/Frame Brake/Plans de découpe/FR_04001_6 (Frame Brake).dxf
AA - Mise en plan/La mache laser/Brake Pedal/Frame Brake/Plans de découpe/FR_04001_7 (Frame Brake).dxf
AA - Mise en plan/La mache laser/Brake Pedal/Frame Brake/Plans de découpe/FR_04001_8 (Frame Brake).dxf
AA - Mise en plan/La mache laser/Brake Pedal/Frame Brake/Plans de découpe/FR_04001_9 (Frame Brake).dxf
AA - Mise en plan/La mache laser/CHASEA 2023/Throttle pedal/FR_03002 (Footrest).dxf
AA - Mise en plan/La mache laser/CHASEA 2023/Throttle pedal/FR_03008 (Negative Throttle Mechanical Stop).stp
AA - Mise en plan/La mache laser/CHASEA 2023/Throttle pedal/FR_03008 Negative Throttle Mechanical Stop.dxf
AA - Mise en plan/La mache laser/CHASEA 2023/Throttle pedal/FR_03009 Positive Throttle Mechanical Stop.dxf
AA - Mise en plan/La mache laser/Chapes_SU/Chapes_SU_Artemiz/Basculeur arrière/Chape_RRocker_F.dxf
AA - Mise en plan/La mache laser/Chapes_SU/Chapes_SU_Artemiz/Basculeur arrière/Chape_Re_Damper_Down.dxf
AA - Mise en plan/La mache laser/Chapes_SU/Chapes_SU_Artemiz/Basculeur avant/Chape_FL_Damper_Down.dxf
AA - Mise en plan/La mache laser/Chapes_SU/Chapes_SU_Artemiz/Basculeur avant/Chape_FRocker_F.dxf
AA - Mise en plan/La mache laser/Chapes_SU/Chapes_SU_Artemiz/Chape_Fw_La_Fp_Low.dxf
AA - Mise en plan/La mache laser/Chapes_SU/Chapes_SU_Artemiz/Chape_Fw_La_Fp_Up.dxf
AA - Mise en plan/La mache laser/Chapes_SU/Chapes_SU_Artemiz/Chape_Fw_La_Rp_Up.dxf
AA - Mise en plan/La mache laser/Chapes_SU/Chapes_SU_Artemiz/Chape_Fw_Ra_Rp_Low.dxf
AA - Mise en plan/La mache laser/Chapes_SU/Chapes_SU_Artemiz/Chape_Fw_Ua_Fp_Low.dxf
AA - Mise en plan/La mache laser/Chapes_SU/Chapes_SU_Artemiz/Chape_Fw_Ua_Fp_Up.dxf
AA - Mise en plan/La mache laser/Chapes_SU/Chapes_SU_Artemiz/Chape_Fw_Ua_Rp_Low.dxf
AA - Mise en plan/La mache laser/Chapes_SU/Chapes_SU_Artemiz/Chape_Fw_Ua_Rp_Up.dxf
AA - Mise en plan/La mache laser/Chapes_SU/Chapes_SU_Artemiz/Chape_RRocker_R.dxf
AA - Mise en plan/La mache laser/Chapes_SU/Chapes_SU_Artemiz/Chape_Rw_La_Fp_Low.dxf
AA - Mise en plan/La mache laser/Chapes_SU/Chapes_SU_Artemiz/Chape_Rw_La_Fp_Up.dxf
AA - Mise en plan/La mache laser/Chapes_SU/Chapes_SU_Artemiz/Chape_Rw_La_Rp_Up.dxf
AA - Mise en plan/La mache laser/Chapes_SU/Chapes_SU_Artemiz/Chape_Rw_Ua_Fp_Low.dxf
AA - Mise en plan/La mache laser/Chapes_SU/Chapes_SU_Artemiz/Chape_Rw_Ua_Fp_Up.dxf
AA - Mise en plan/La mache laser/Chapes_SU/Chapes_SU_Artemiz/Chape_Rw_Ua_Rp_Low.dxf
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
