EOSCogniton/ELIZ-2021/CR_Cost_Report/02-REAL_CASES/4_Make or buy decisions/Graphique.pptx

Is the components we are looking for available in the market as standard?

No

Do we have the competences to realise it ourselves?

Performances comparisons

Yes

No

Yes

No

Is it interesting for us to acquire these competences?

Does it respect our specifications?

Yes

Cost/time comparisons

Buy

Make
