EOSCogniton/ELIZ-2021/CR_Cost_Report/ZZ-Ressources/05-REAL_CASES/FS_ATA/Make_or_buy_decisions.pptx

## Make or buy decisions

Arbitrage between make or buy

Diagram to represent the procedure to arbitrate decisions between make or buy.

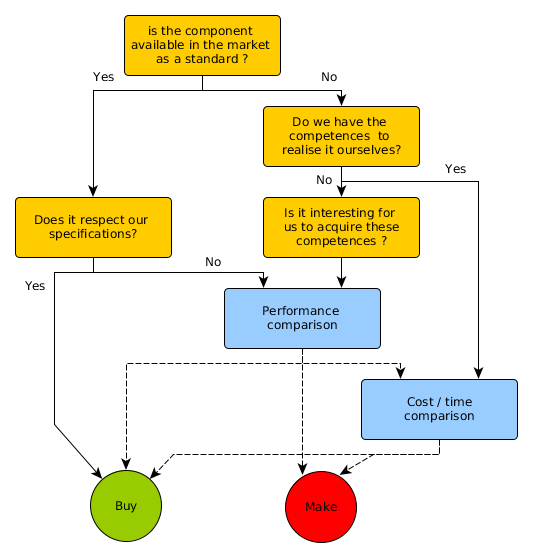
[picture p638: figure]

Bought items

Indicator used to compare products available in the market.

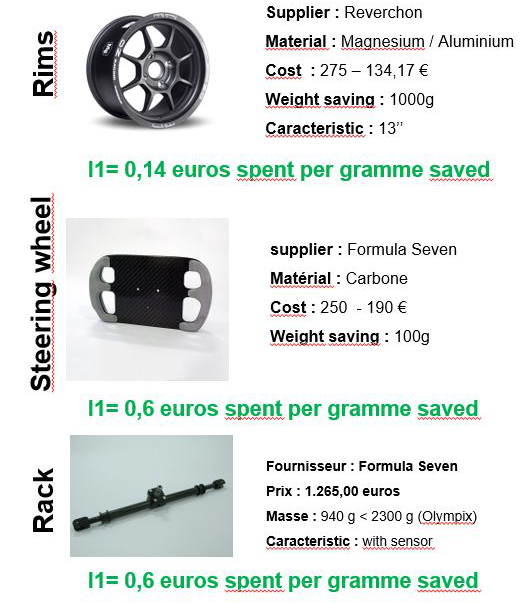
[picture p639: figure]
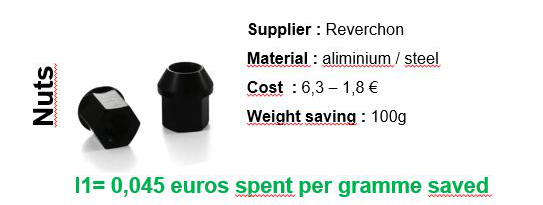
[picture p640: figure]
