EOSCogniton/ELIZ-2021/CR_Cost_Report/01_BOM/EN/EN_A0400 (Drivetrain Assembly)/EN_04001_Picture.jpg

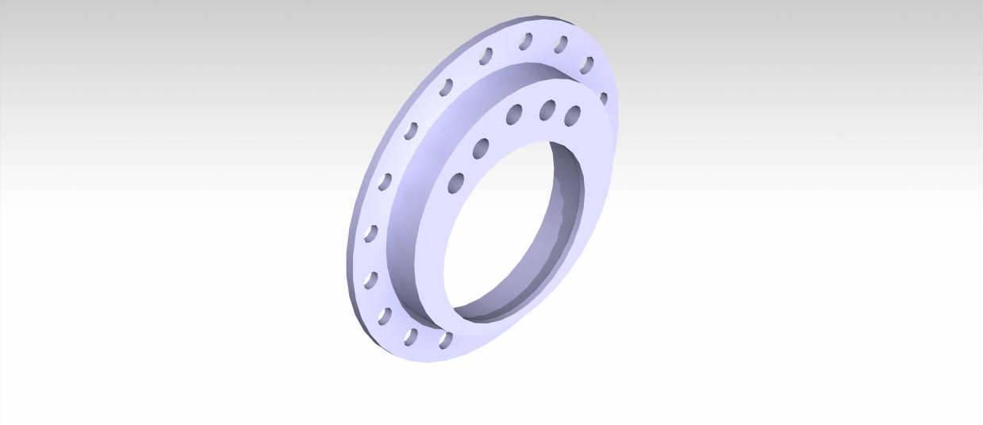
CR_Cost_Report/01_BOM/EN/EN_A0400 (Drivetrain Assembly)/EN_04001_Picture.jpg
