EOSCogniton/ELIZ-2021/EL_Electrical/CATIA/EL_A0300 (LV Battery Assembly)/01_FEA/Analysis_EL_03007_Bump_3g_1.png

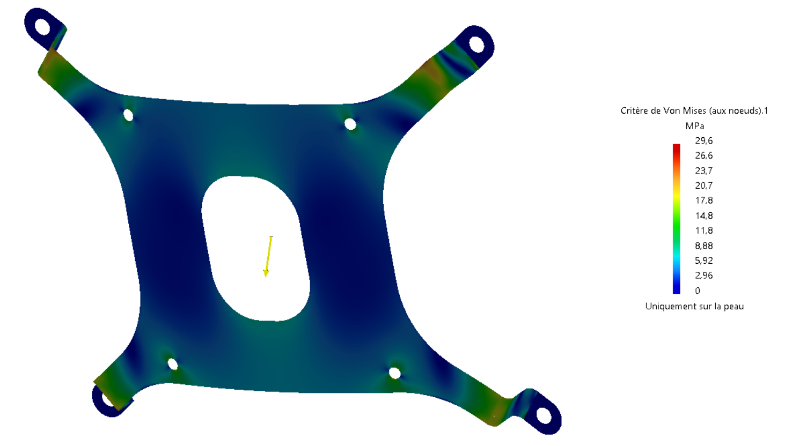
EL_Electrical/CATIA/EL_A0300 (LV Battery Assembly)/01_FEA/Analysis_EL_03007_Bump_3g_1.png
