EOSCogniton/ELIZ-2021/EL_Electrical/EL_A0400 (TS Box)/Montage Rapide Data Log.jpg

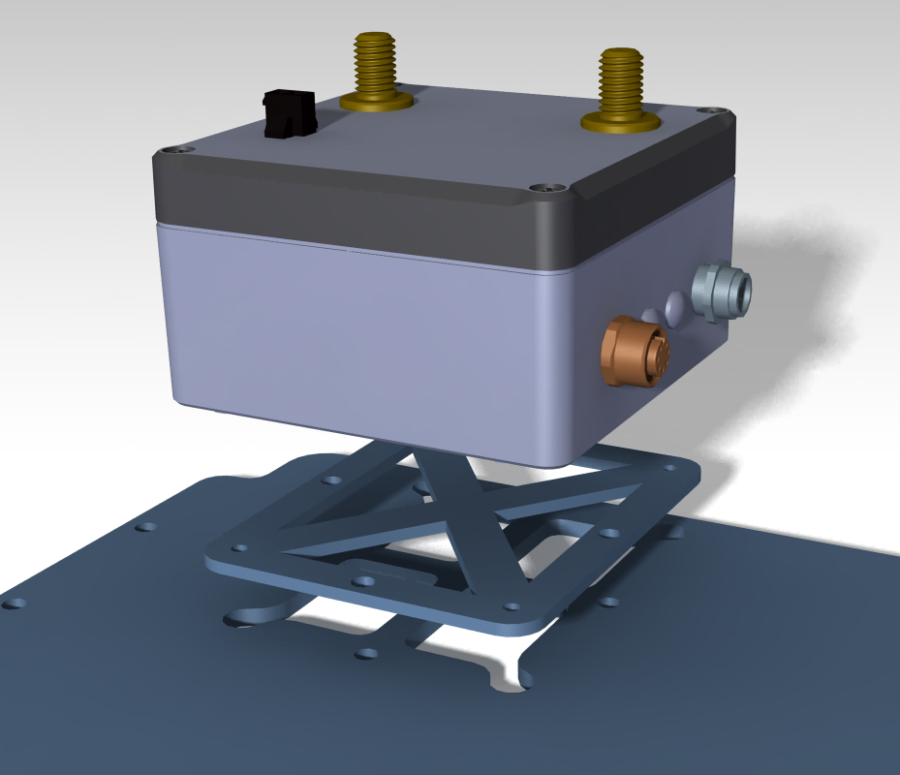
EL_Electrical/EL_A0400 (TS Box)/Montage Rapide Data Log.jpg
