EOSCogniton/ELIZ-2021/SU_Suspension/01_LAS-Auto/02_Resultats/Résultats v46a.xlsx

Front Bump |  |  |  |  |  |  |  |  |  |  |  |  |  |  | Rear Bump |  |  |  |  |  |  |  |  |  |  |  |  |  |  | Front roll |  |  |  |  |  |  |  |  |  |  |  |  |  | Rear roll |  |  |  |  |  |  |  |  |  |  |  |  |  | Steering front
Bump travel (mm) | camber angle (deg | Toe angle (deg) | Castor angle (deg) | Kingpin Angle (deg) | Damper ratio | Spring ration | Anti dive (%) | Anti squat (%) | Roll centre height to body (mm) | Roll center to ground (mm) | Half track change (mm) | Wheel base change (mm) | Damper travel (mm) | Sprong travel (mm) | Bump travel (mm) | camber angle (deg | Toe angle (deg) | Castor angle (deg) | Kingpin Angle (deg) | Damper ratio | Spring ratio | Anti dive (%) | Anti squat (%) | Roll centre height to body (mm) | Roll center to ground (mm) | Half track change (mm) | Wheel base change (mm) | Damper travel (mm) | Sprong travel (mm) | Roll angle (deg) | camber angle (deg | Toe angle (deg) | Castor angle (deg) | Kingpin Angle (deg) | Damper ratio | Spring ratio | Roll center position x (mm) | Roll center position y (mm) | Roll center position z (mm) | Half track change (mm) | Wheel base change (mm) | Damper travel (mm) | Sprong travel (mm) | Roll angle (deg) |
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
