EOSCogniton/ELIZ-2021/AA - Mise en plan/La Fabrique/SU_03003_test (Rear Upper Rod-End Support).pdf

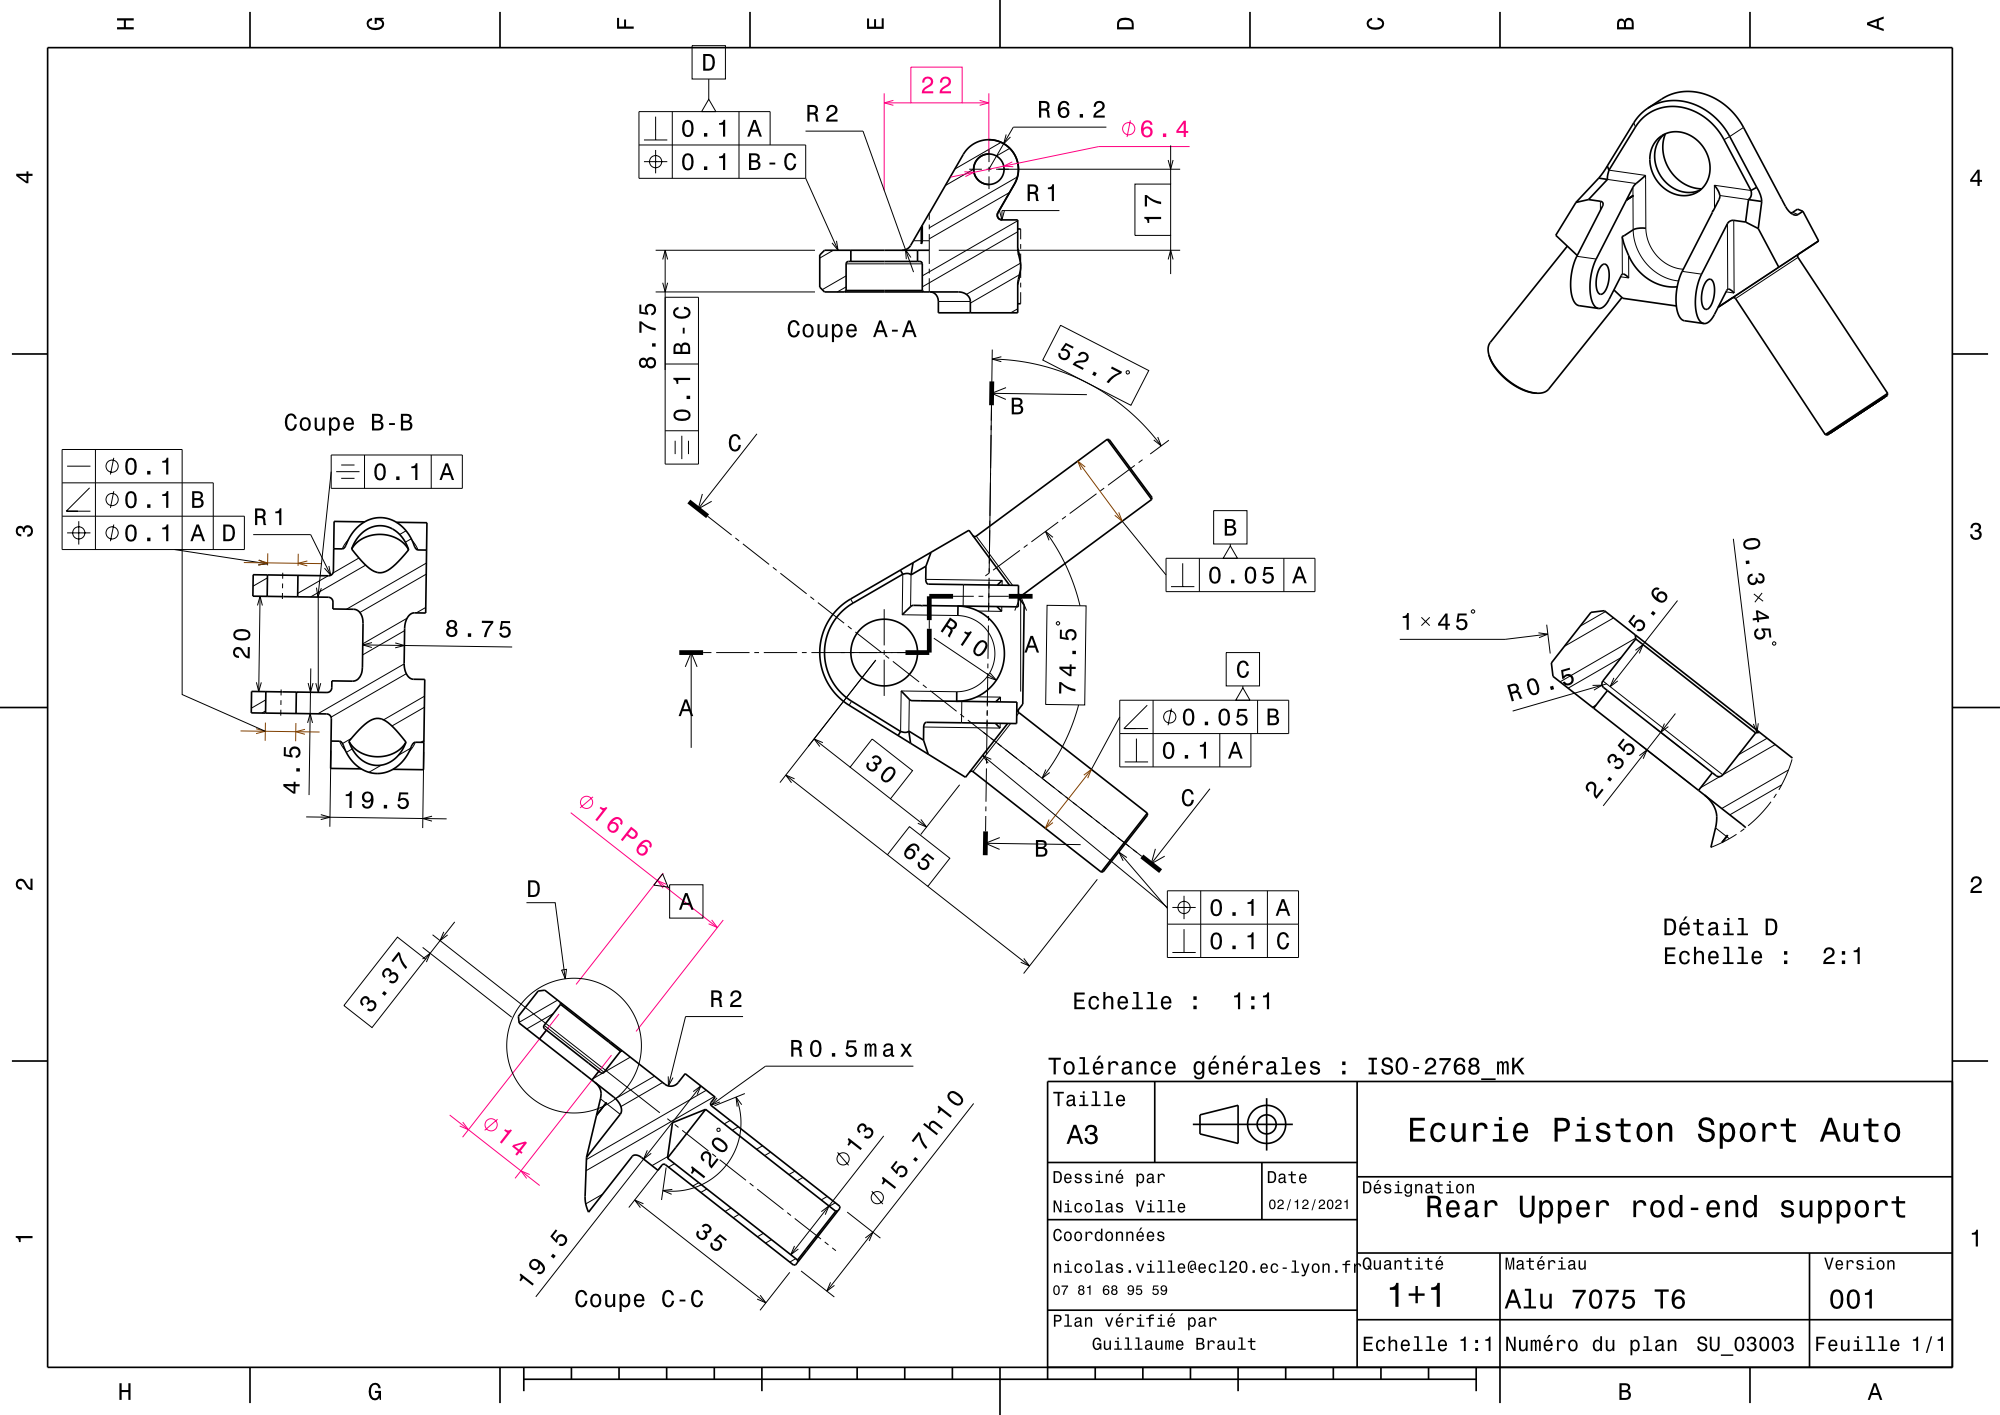
[picture p655: page 1]
