EOSCogniton/ELIZ-2021/CR_Cost_Report/03-FR-CBOM/Chassis_tubulaire_EPSA.pdf

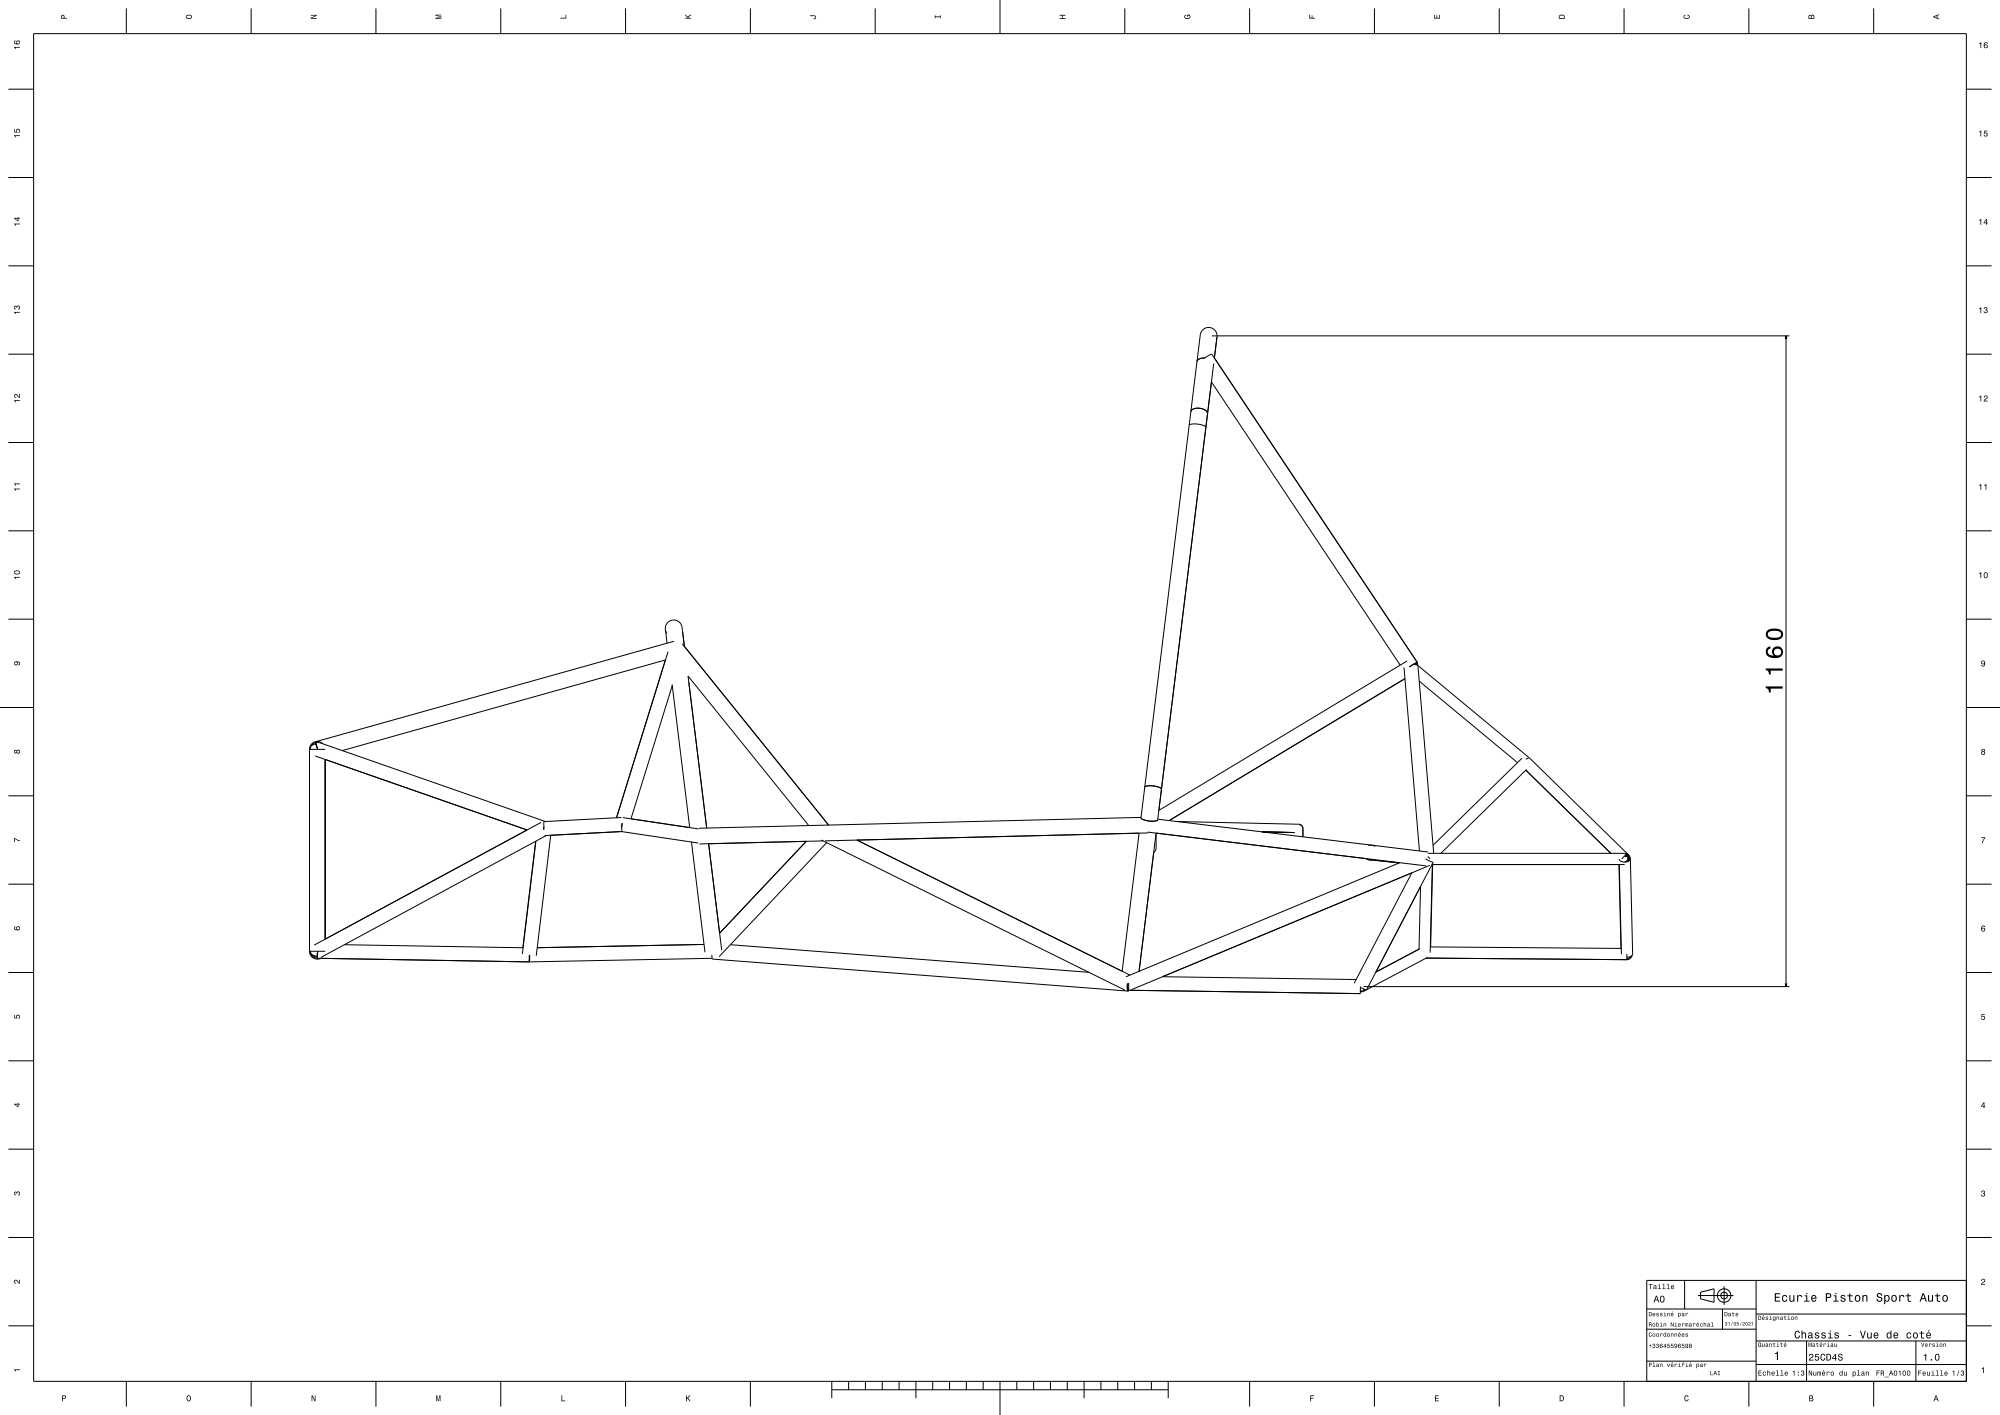
[picture p656: page 1]

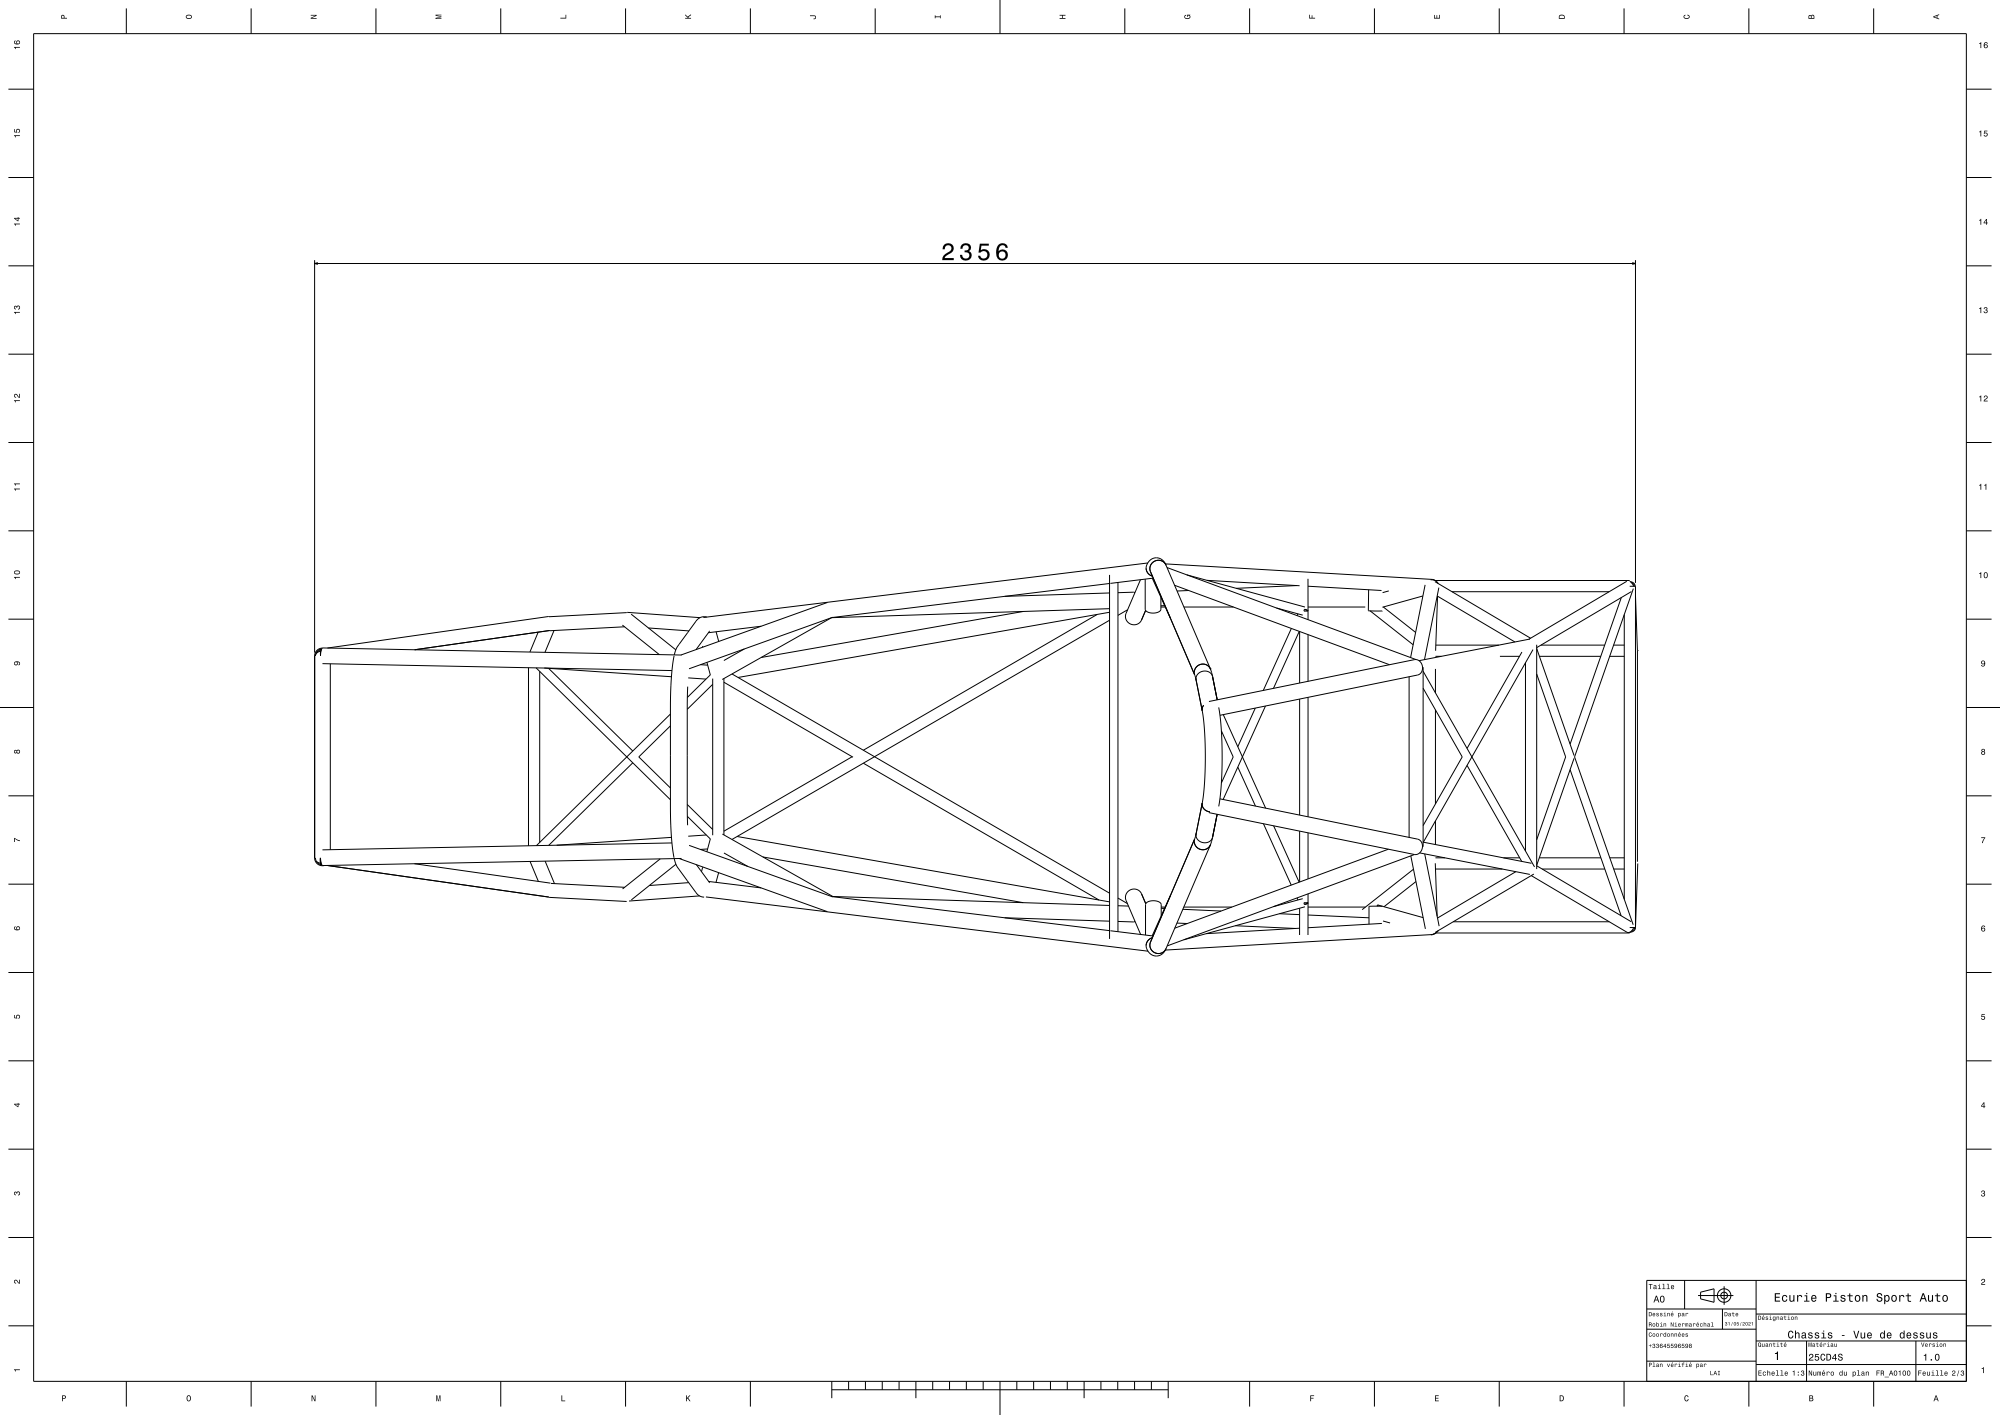
[picture p657: page 2]

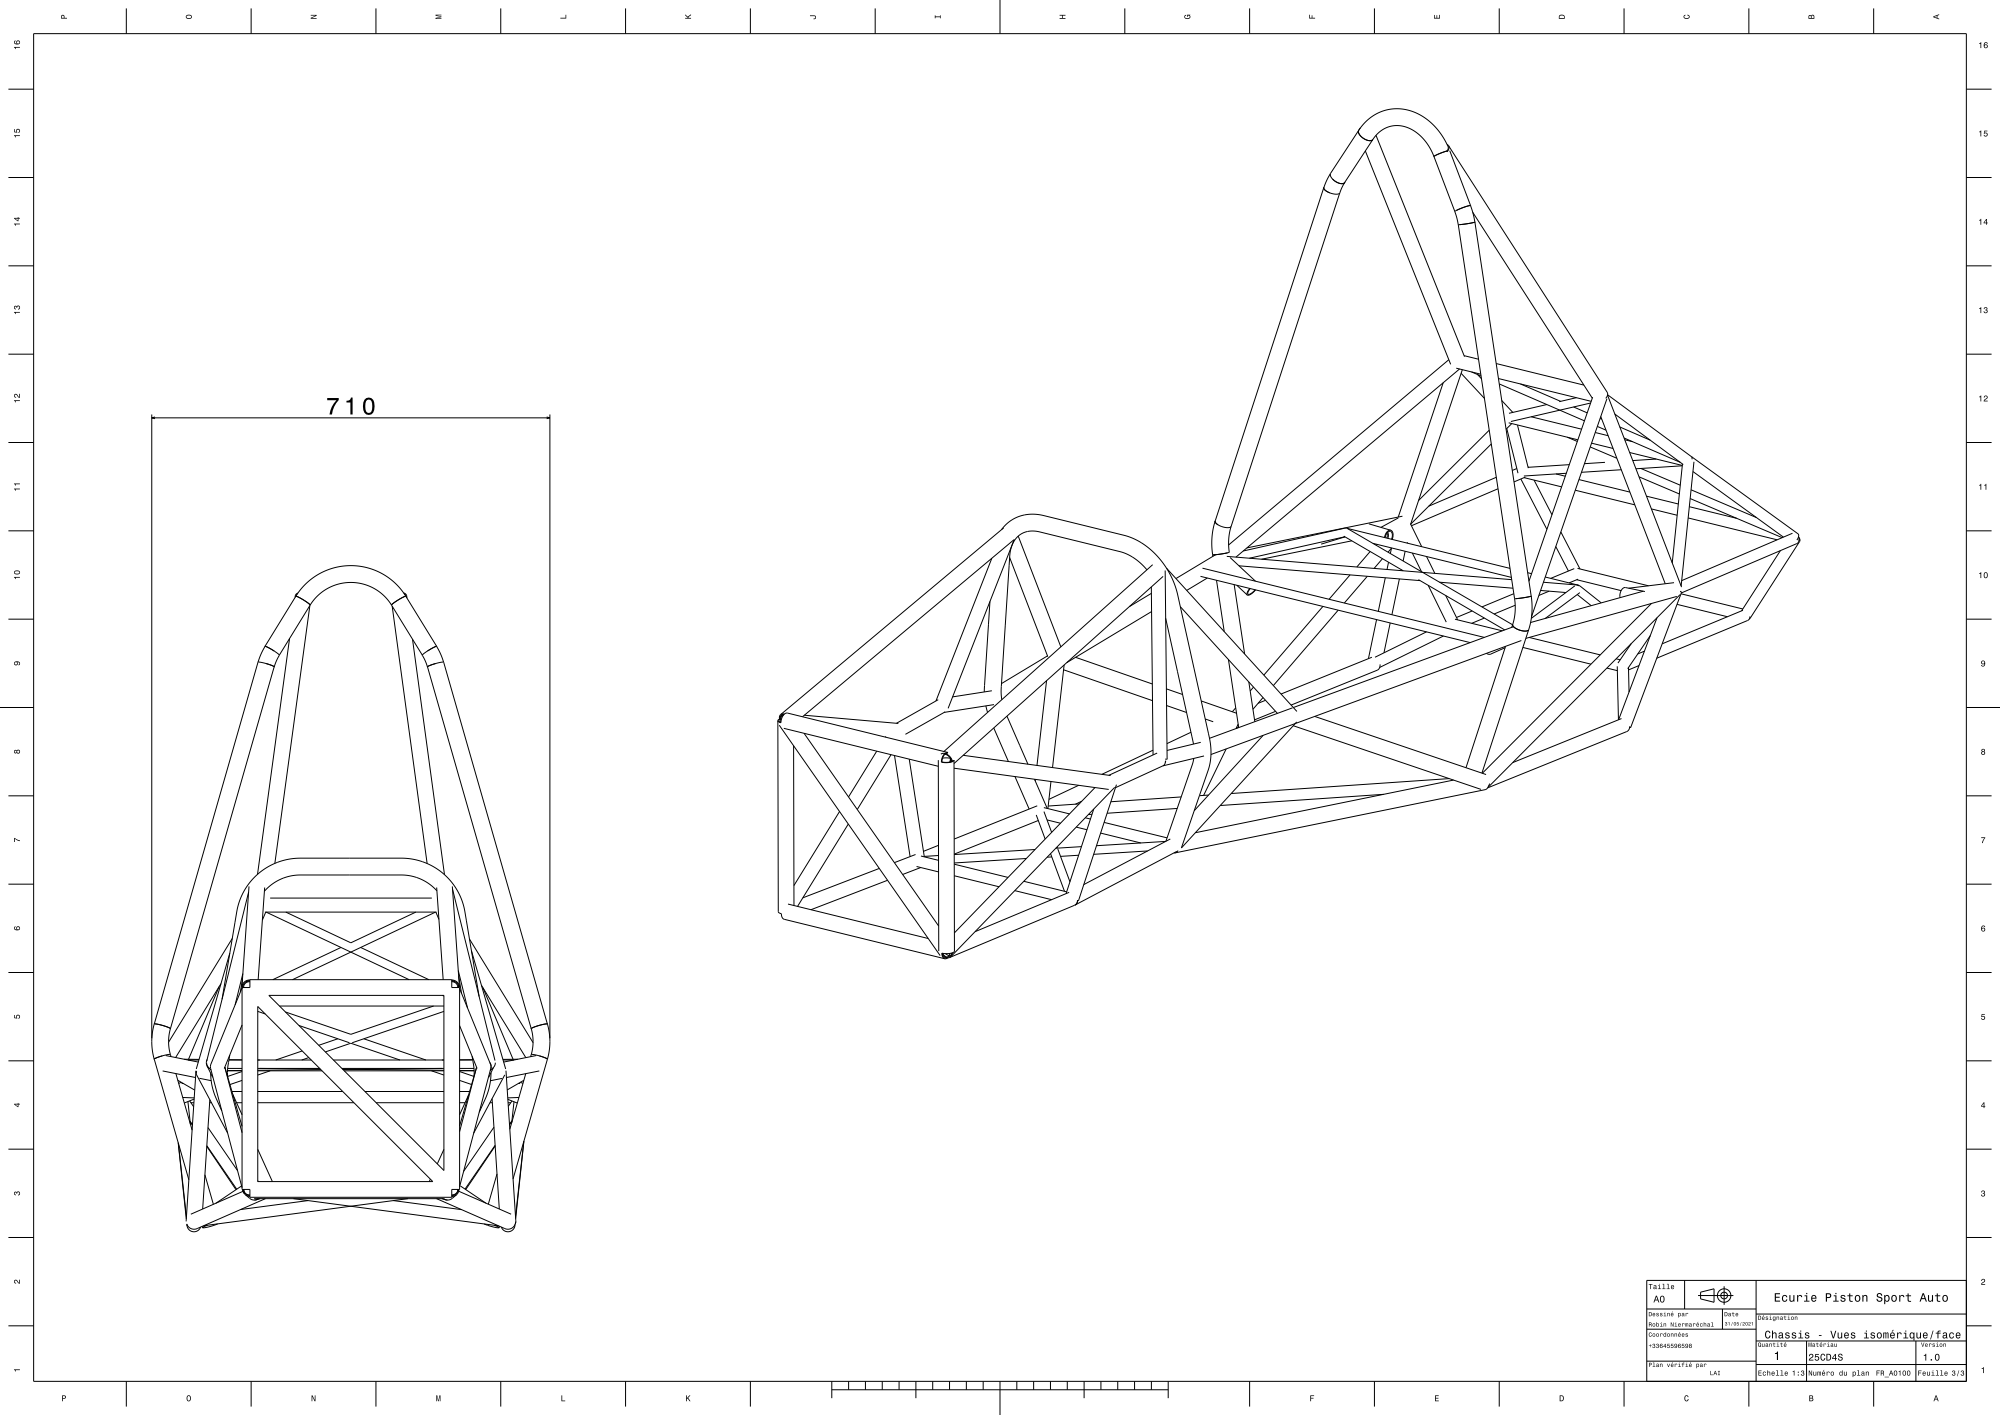
[picture p658: page 3]
