EOSCogniton/ELIZ-2021/DR_Design_Report/05_Design_Report/Coupe_roue_equipee.pdf

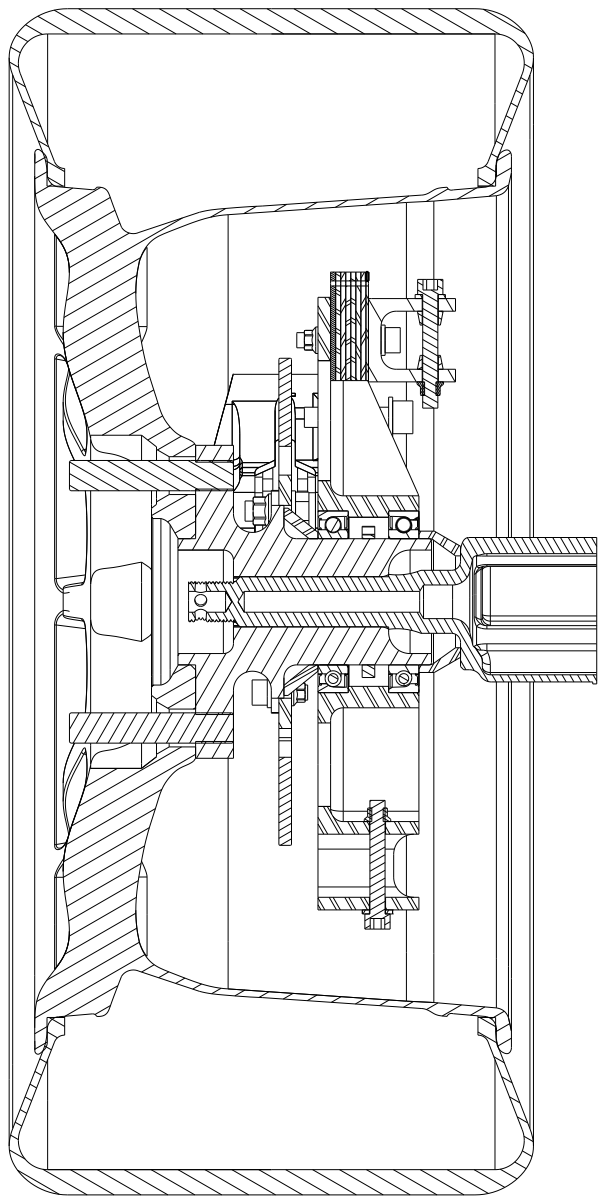
[picture p659: page 1]
