EOSCogniton/ELIZ-2021/DR_Design_Report/02_MEP_Chassis/MEP_Chassis.pdf

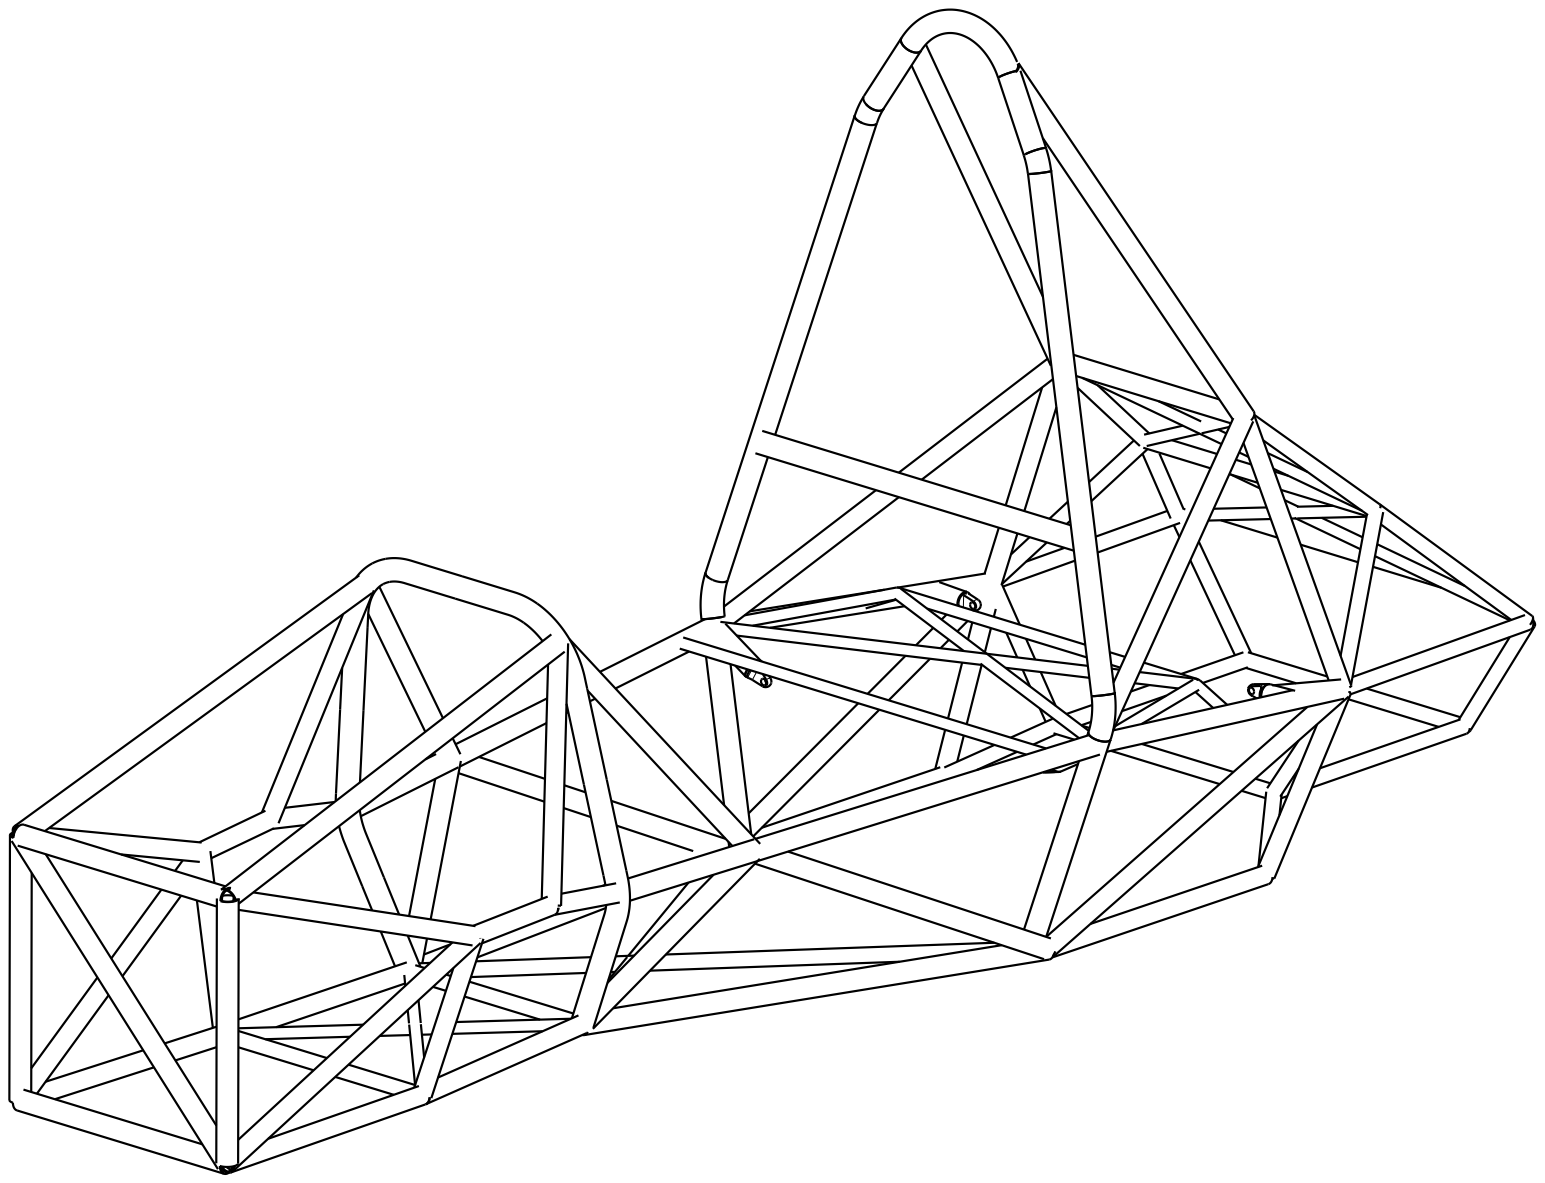
[picture p660: page 1]
