EOSCogniton/ELIZ-2021/DR_Design_Report/03_MEP_Triangles/MEP_Triangles.pdf

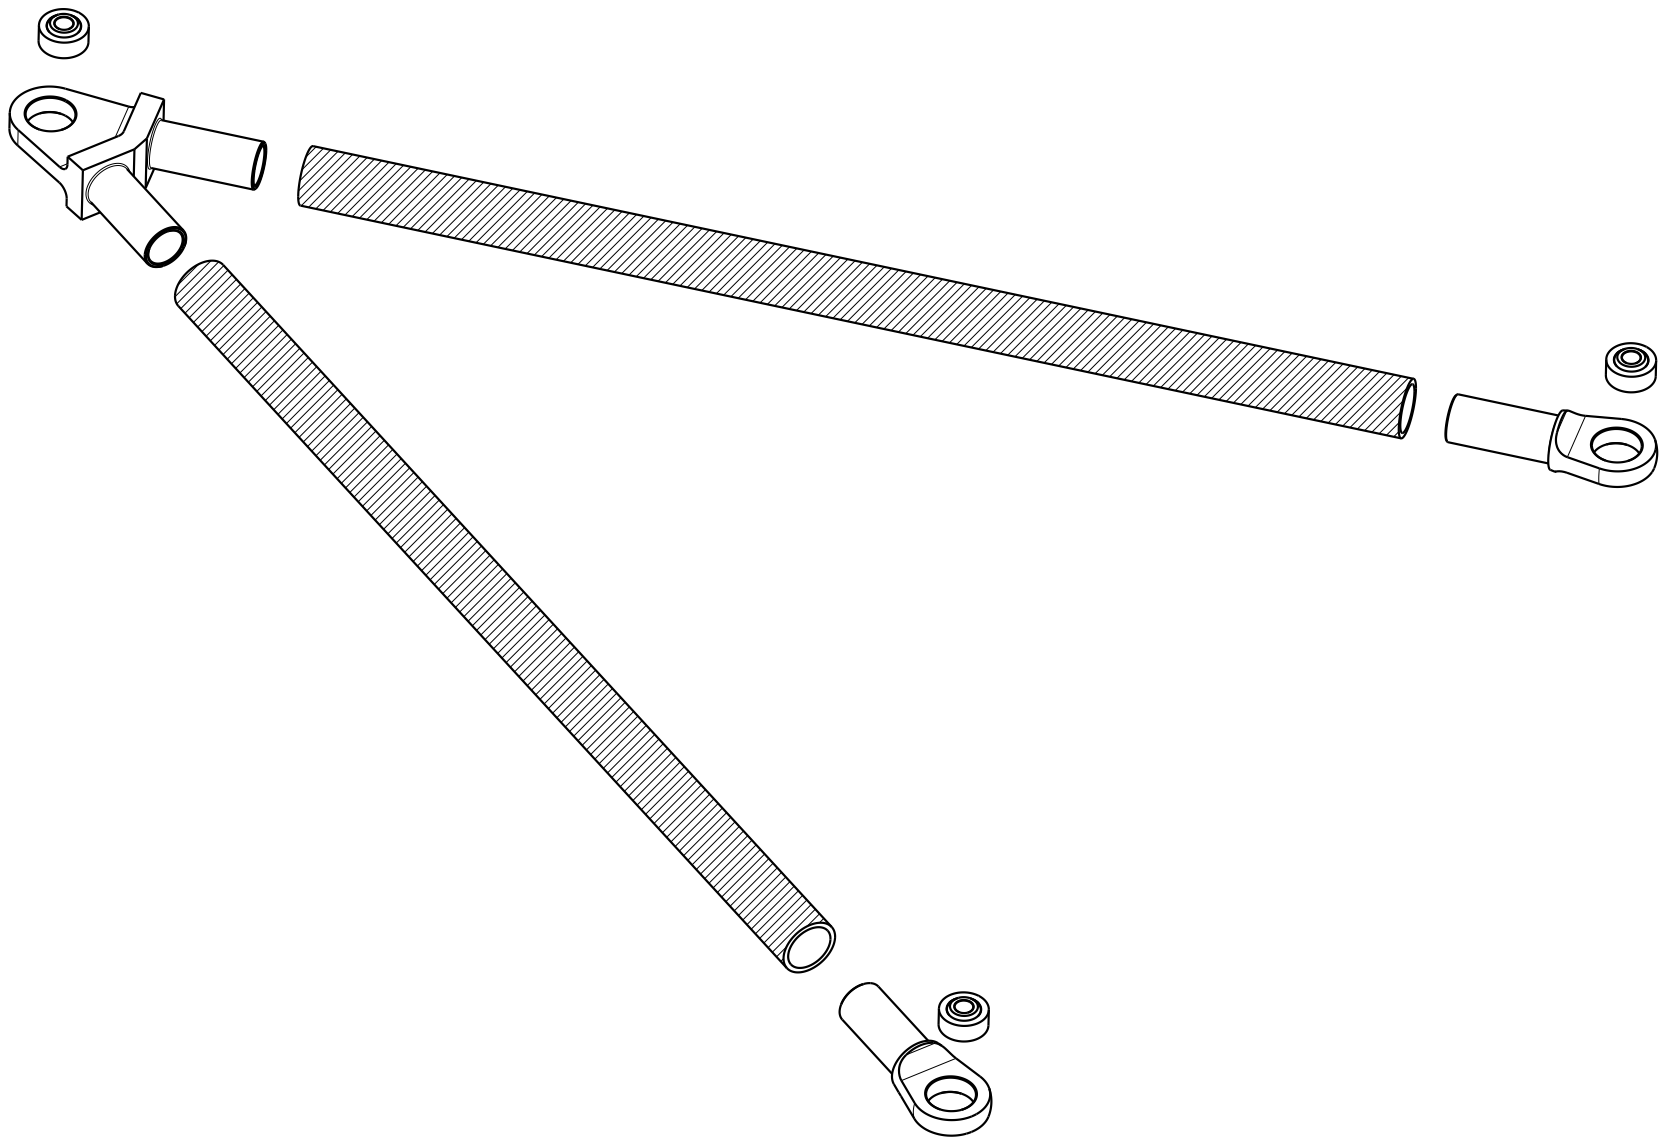
[picture p661: page 1]
