EOSCogniton/ELIZ-2021/DR_Design_Report/01_MEP_Globales/01_MEP_v0/MEP_Design_Report_Vue_de_face.pdf

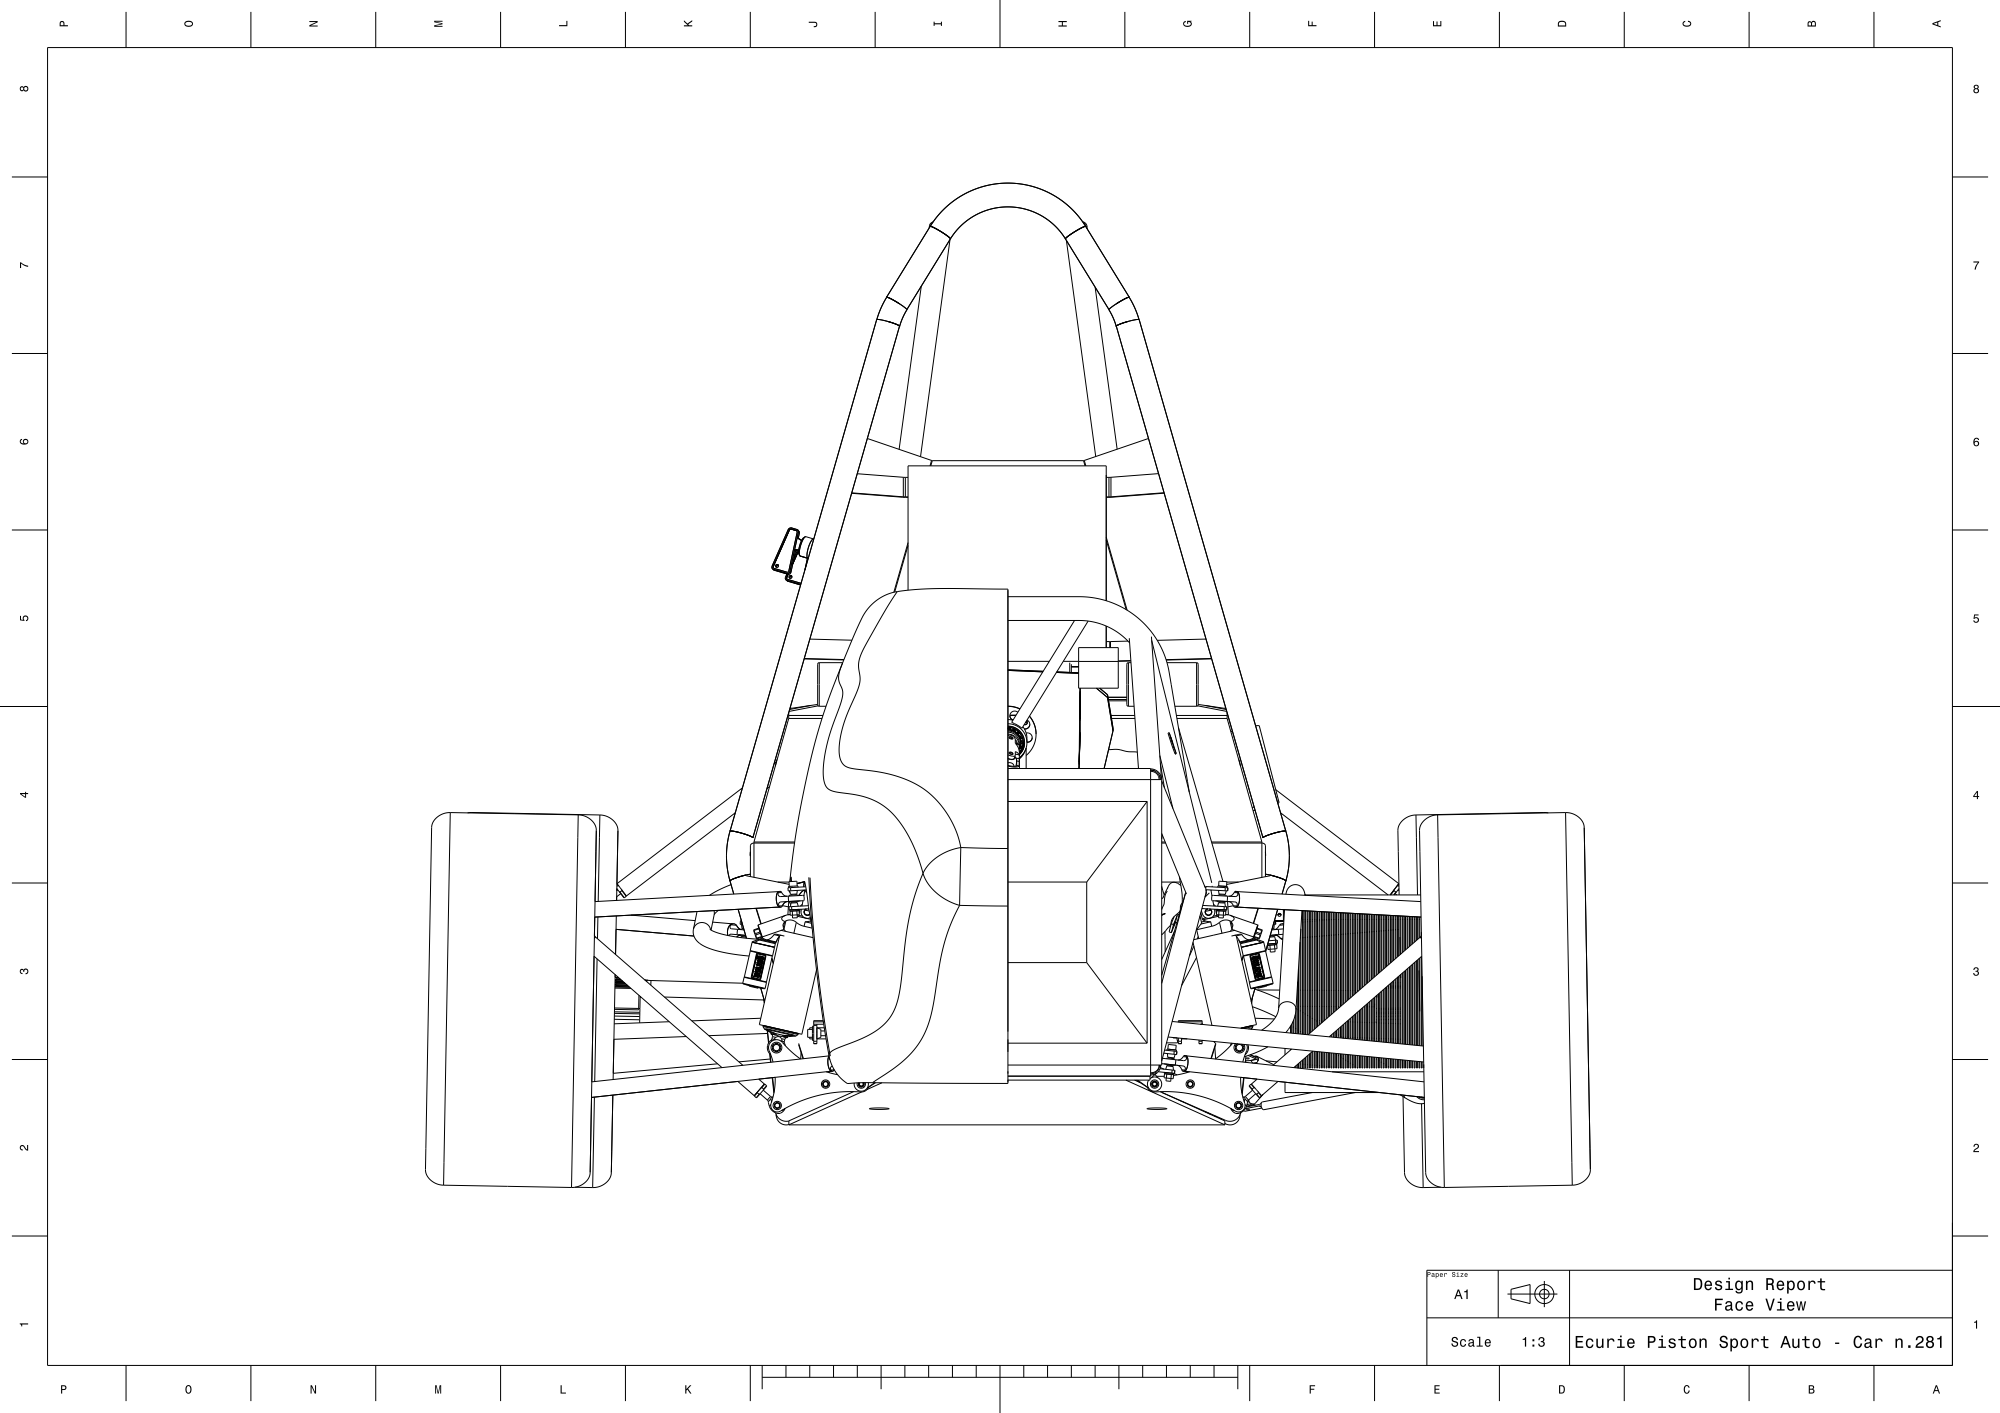
[picture p664: page 1]
