EOSCogniton/ELIZ-2021/DR_Design_Report/01_MEP_Globales/02_MEP_v1/MEP_Design_Report_Vue_de_dessus.pdf

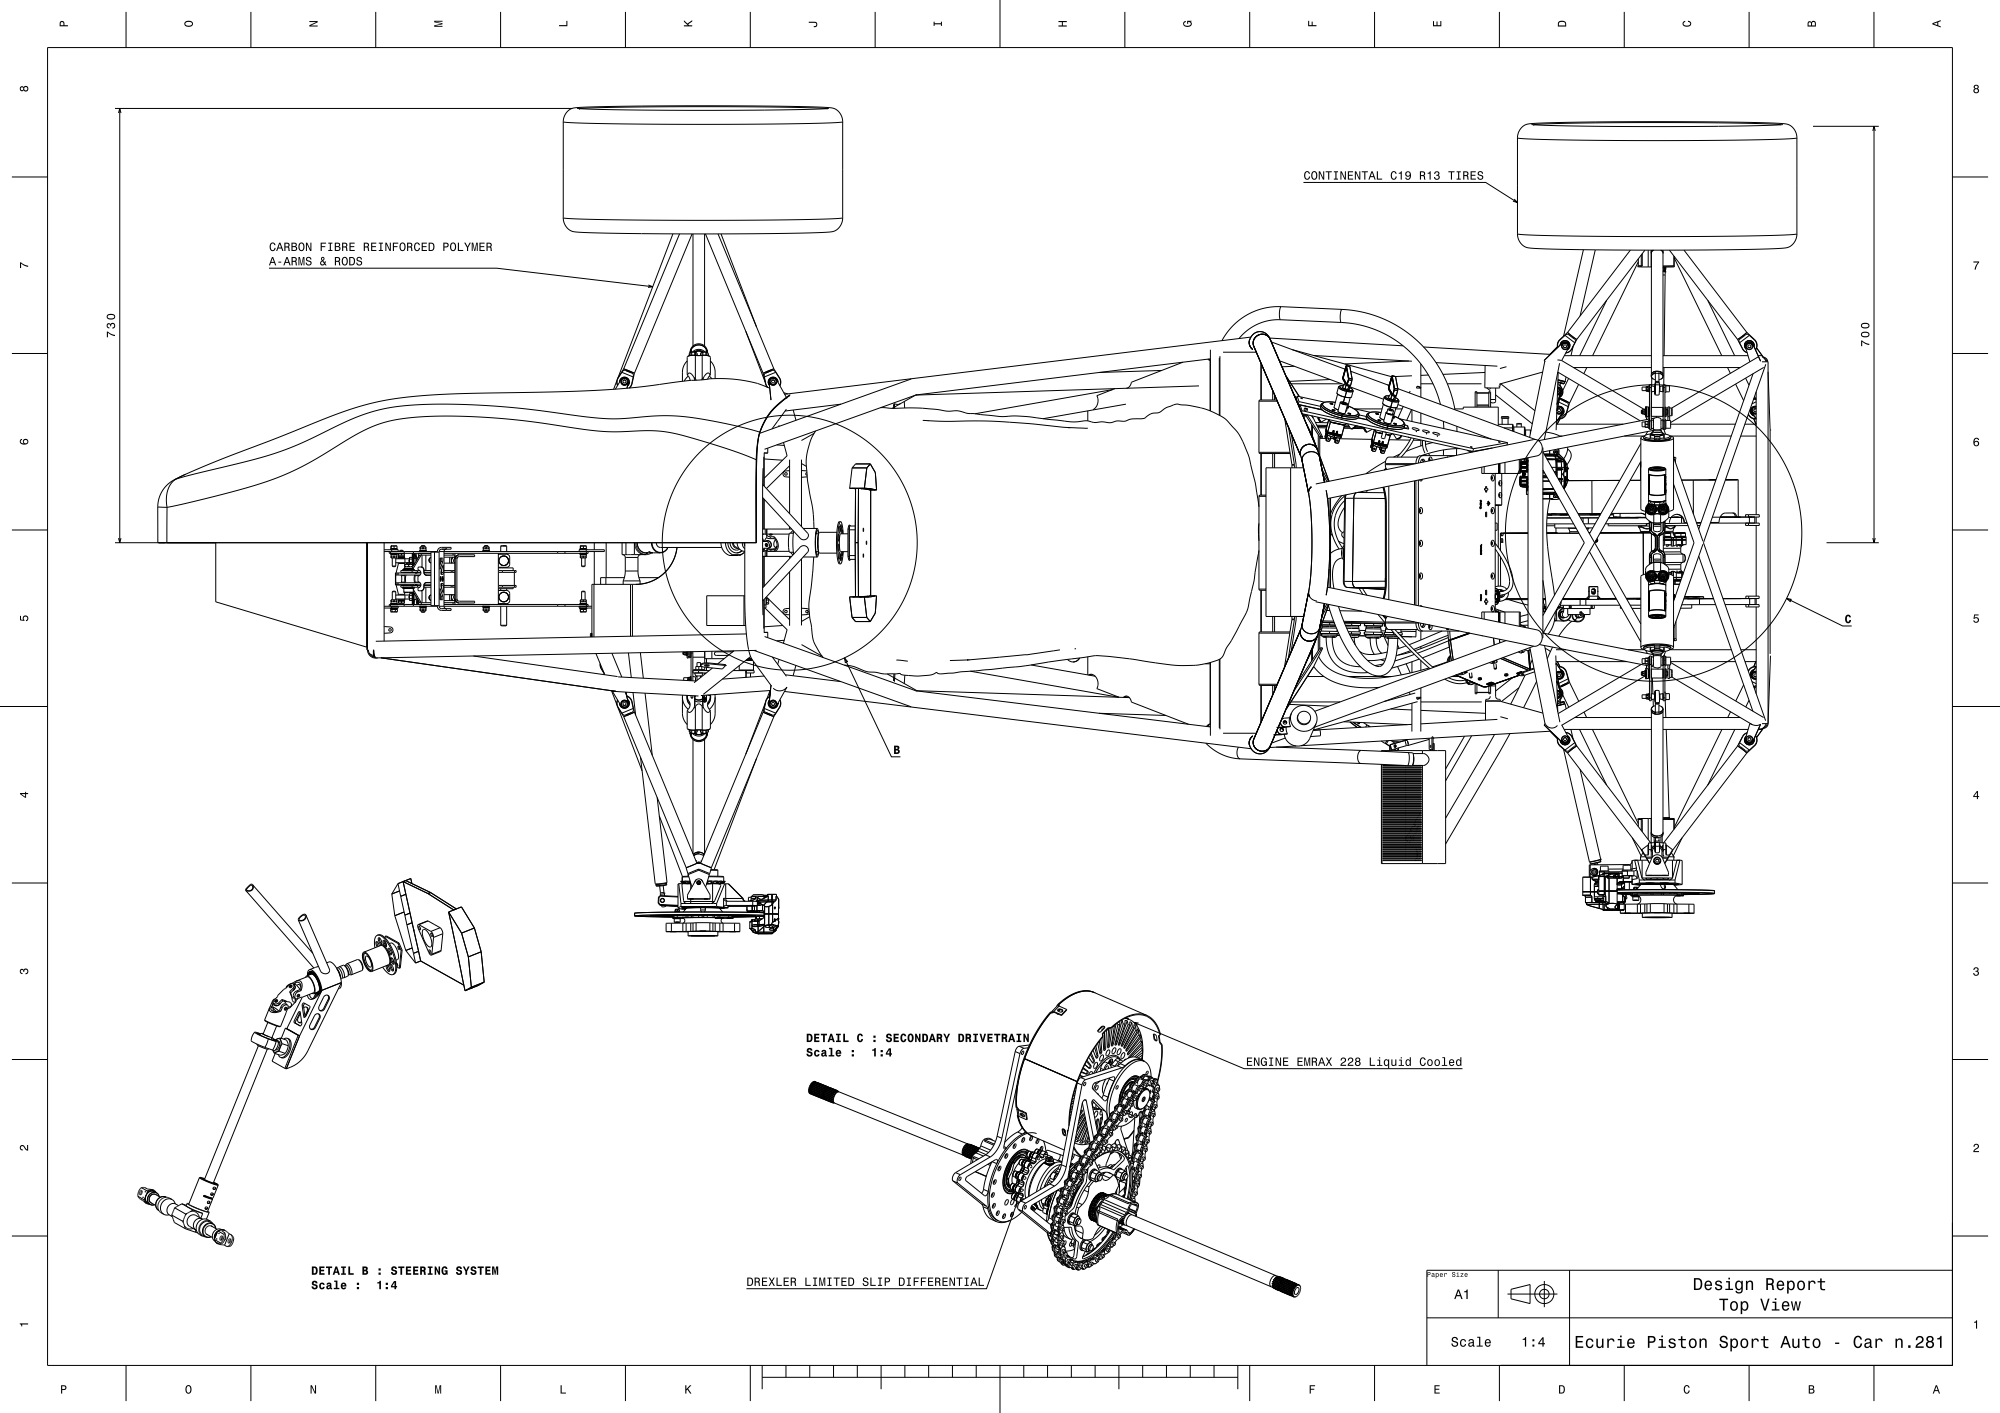
[picture p668: page 1]
