EOSCogniton/ELIZ-2021/DR_Design_Report/01_MEP_Globales/02_MEP_v1/MEP_Design_Report_Vue_de_face.pdf

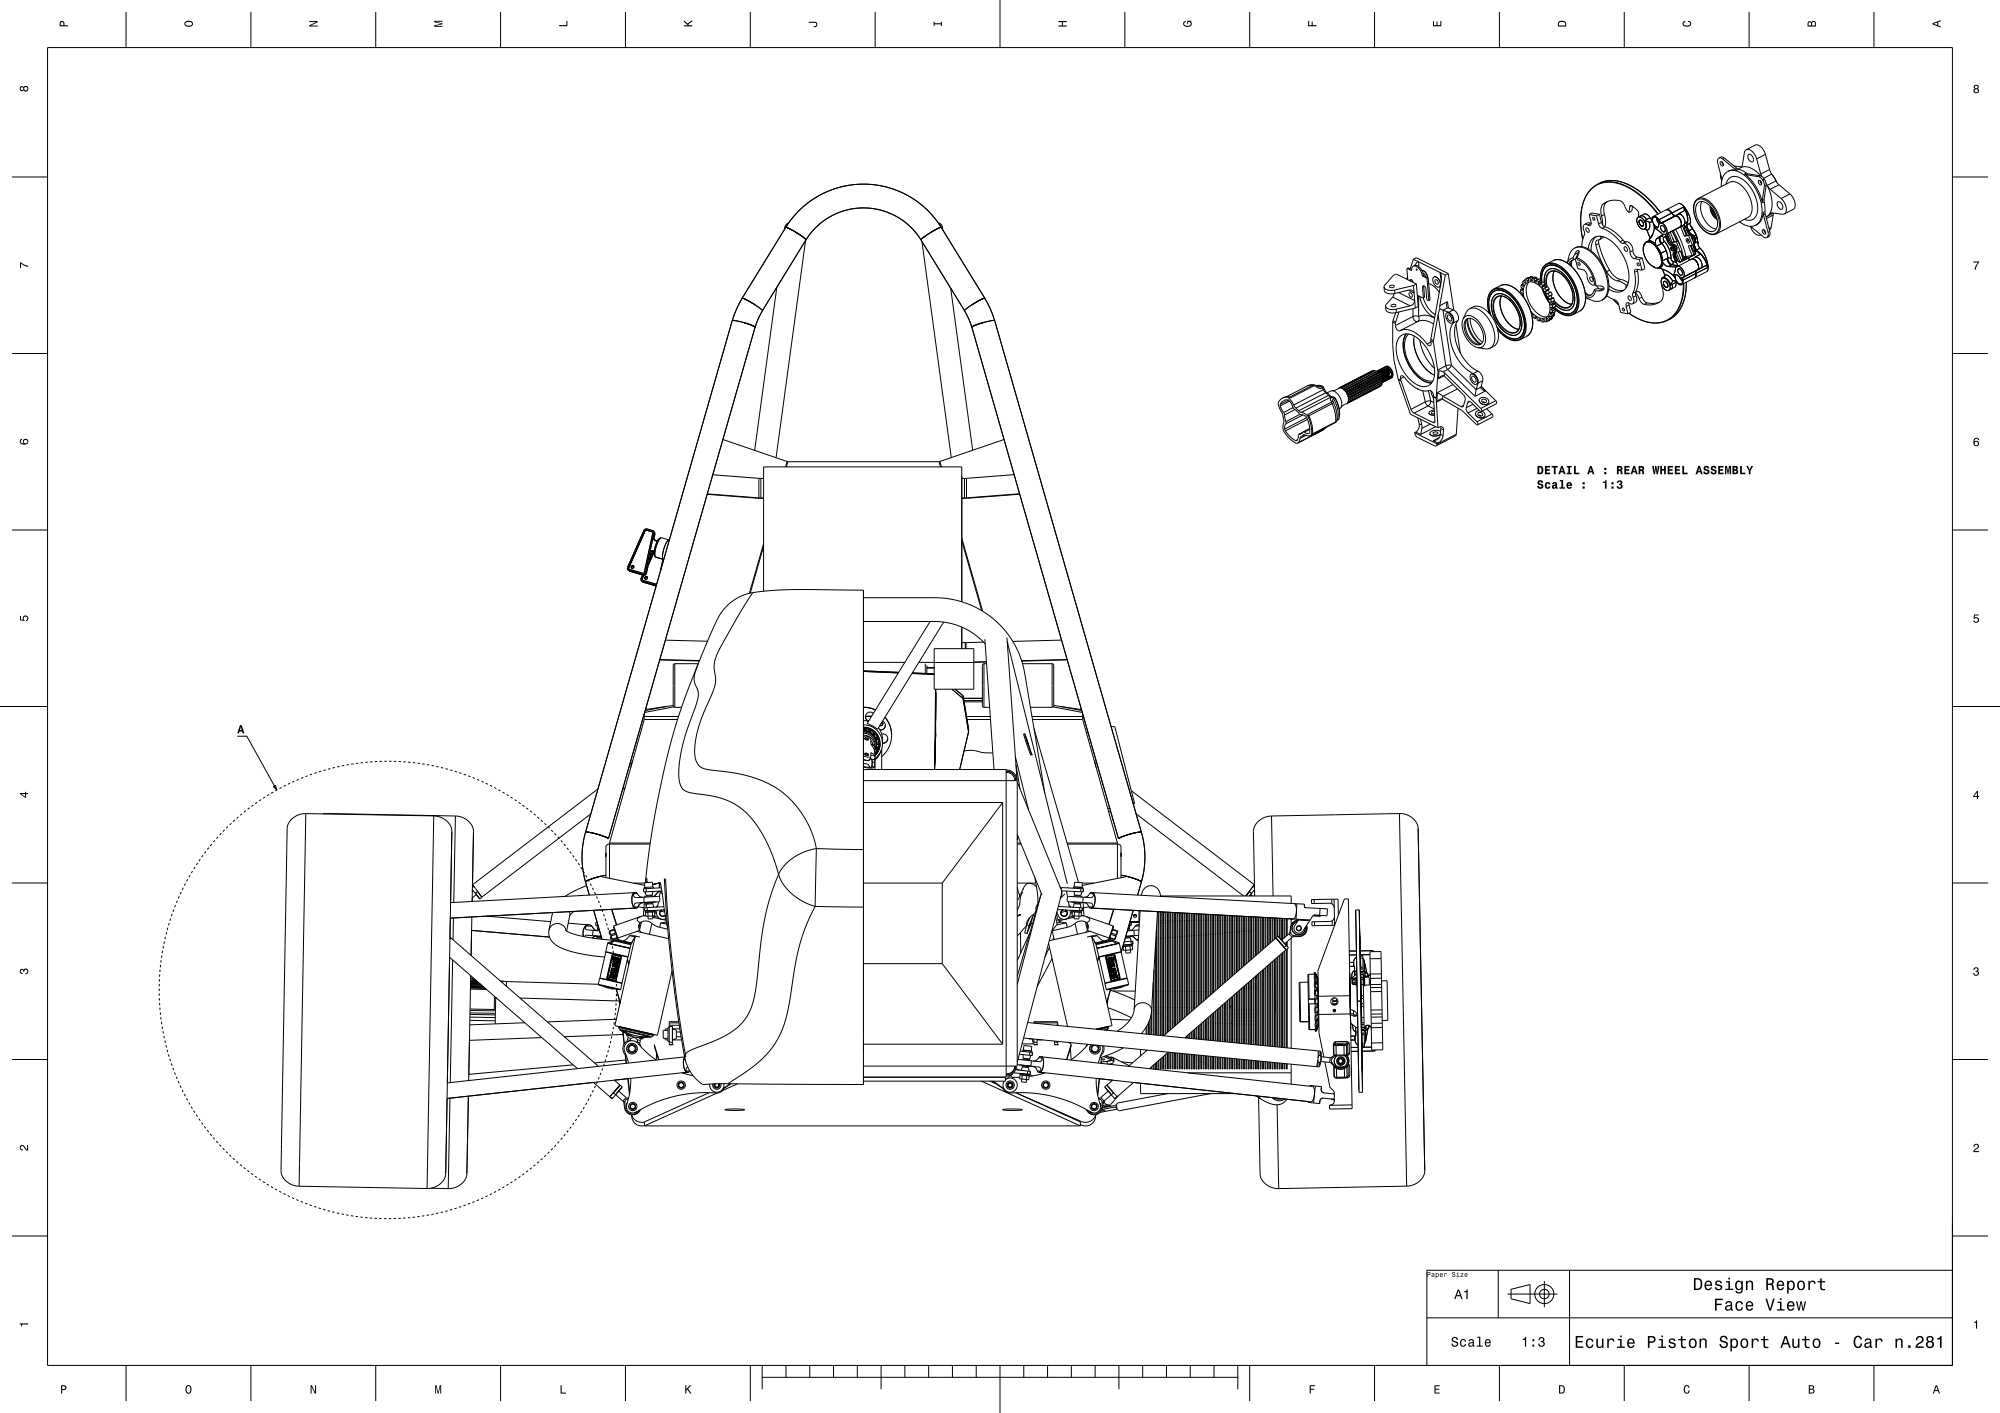
[picture p669: page 1]
