EOSCogniton/ELIZ-2021/SU_Suspension/01_LAS-Auto/02_Resultats/Résultats v46a.pdf

## Camber angle in bump

## Toe angle in bump

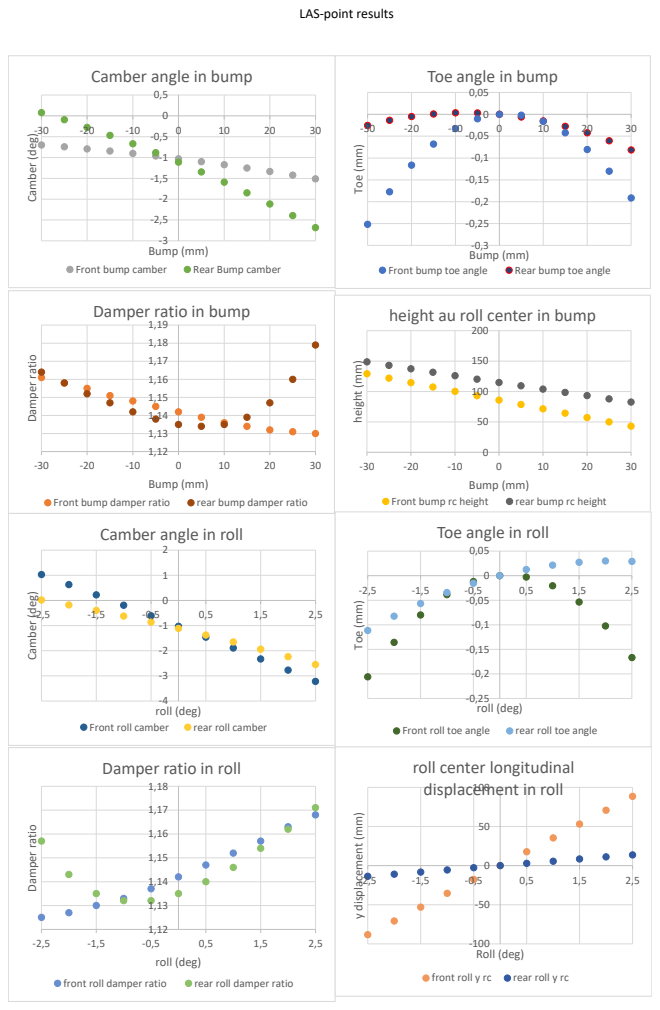
[picture p670: page 1]
30 Camber ⁽deg⁾; Bump (mm); Front bump camber; Rear Bump camber; 30 Toe ⁽mm⁾; Front bump toe angle; Rear bump toe angle; 30 Damper ratio; Front bump damper ratio; rear bump damper ratio; 30 height (mm⁾; Front bump rc height; rear bump rc height; 2,5 Camber ⁽deg⁾; roll (deg); Front roll camber; rear roll camber; 2,5 Toe ⁽mm⁾; Front roll toe angle; rear roll toe angle; 2,5 Damper ratio; front roll damper ratio; rear roll damper ratio; 2,5 y displacement (mm⁾; Roll (deg); front roll y rc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

LAS-point results

Damper ratio in bump

height au roll center in bump

Camber angle in roll

Toe angle in roll

Damper ratio in roll

roll center longitudinal
displacement in roll
