EOSCogniton/ELIZ-2021/AA - Mise en plan/La mache laser/CHASEA 2023/Throttle pedal/FR_03008 Negative Throttle Mechanical Stop.pdf

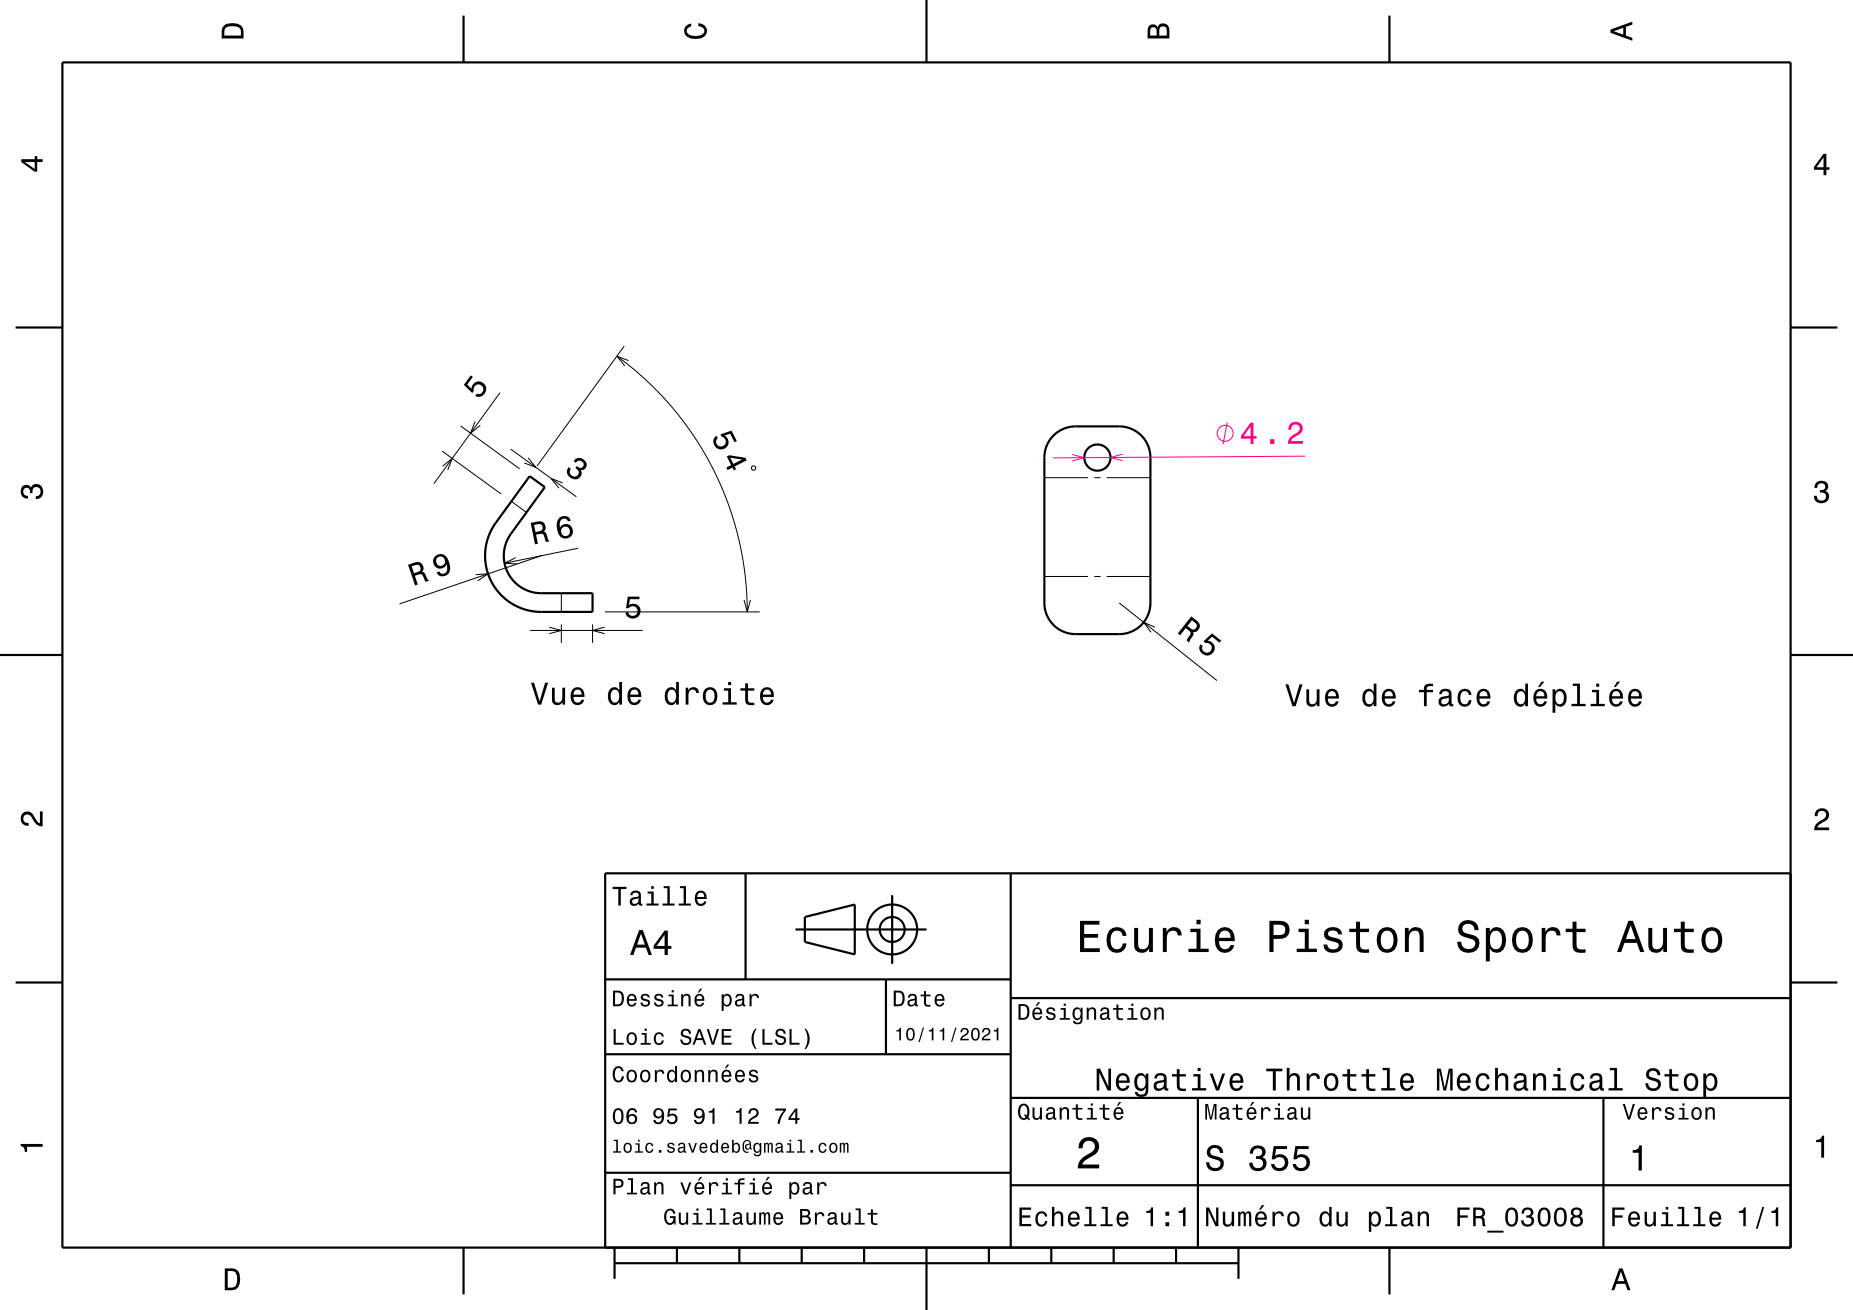
[picture p671: page 1]
