EOSCogniton/ELIZ-2021/AA - Mise en plan/La mache laser/CHASEA 2023/Throttle pedal/FR_03009 Positive Throttle Mechanical Stop.pdf

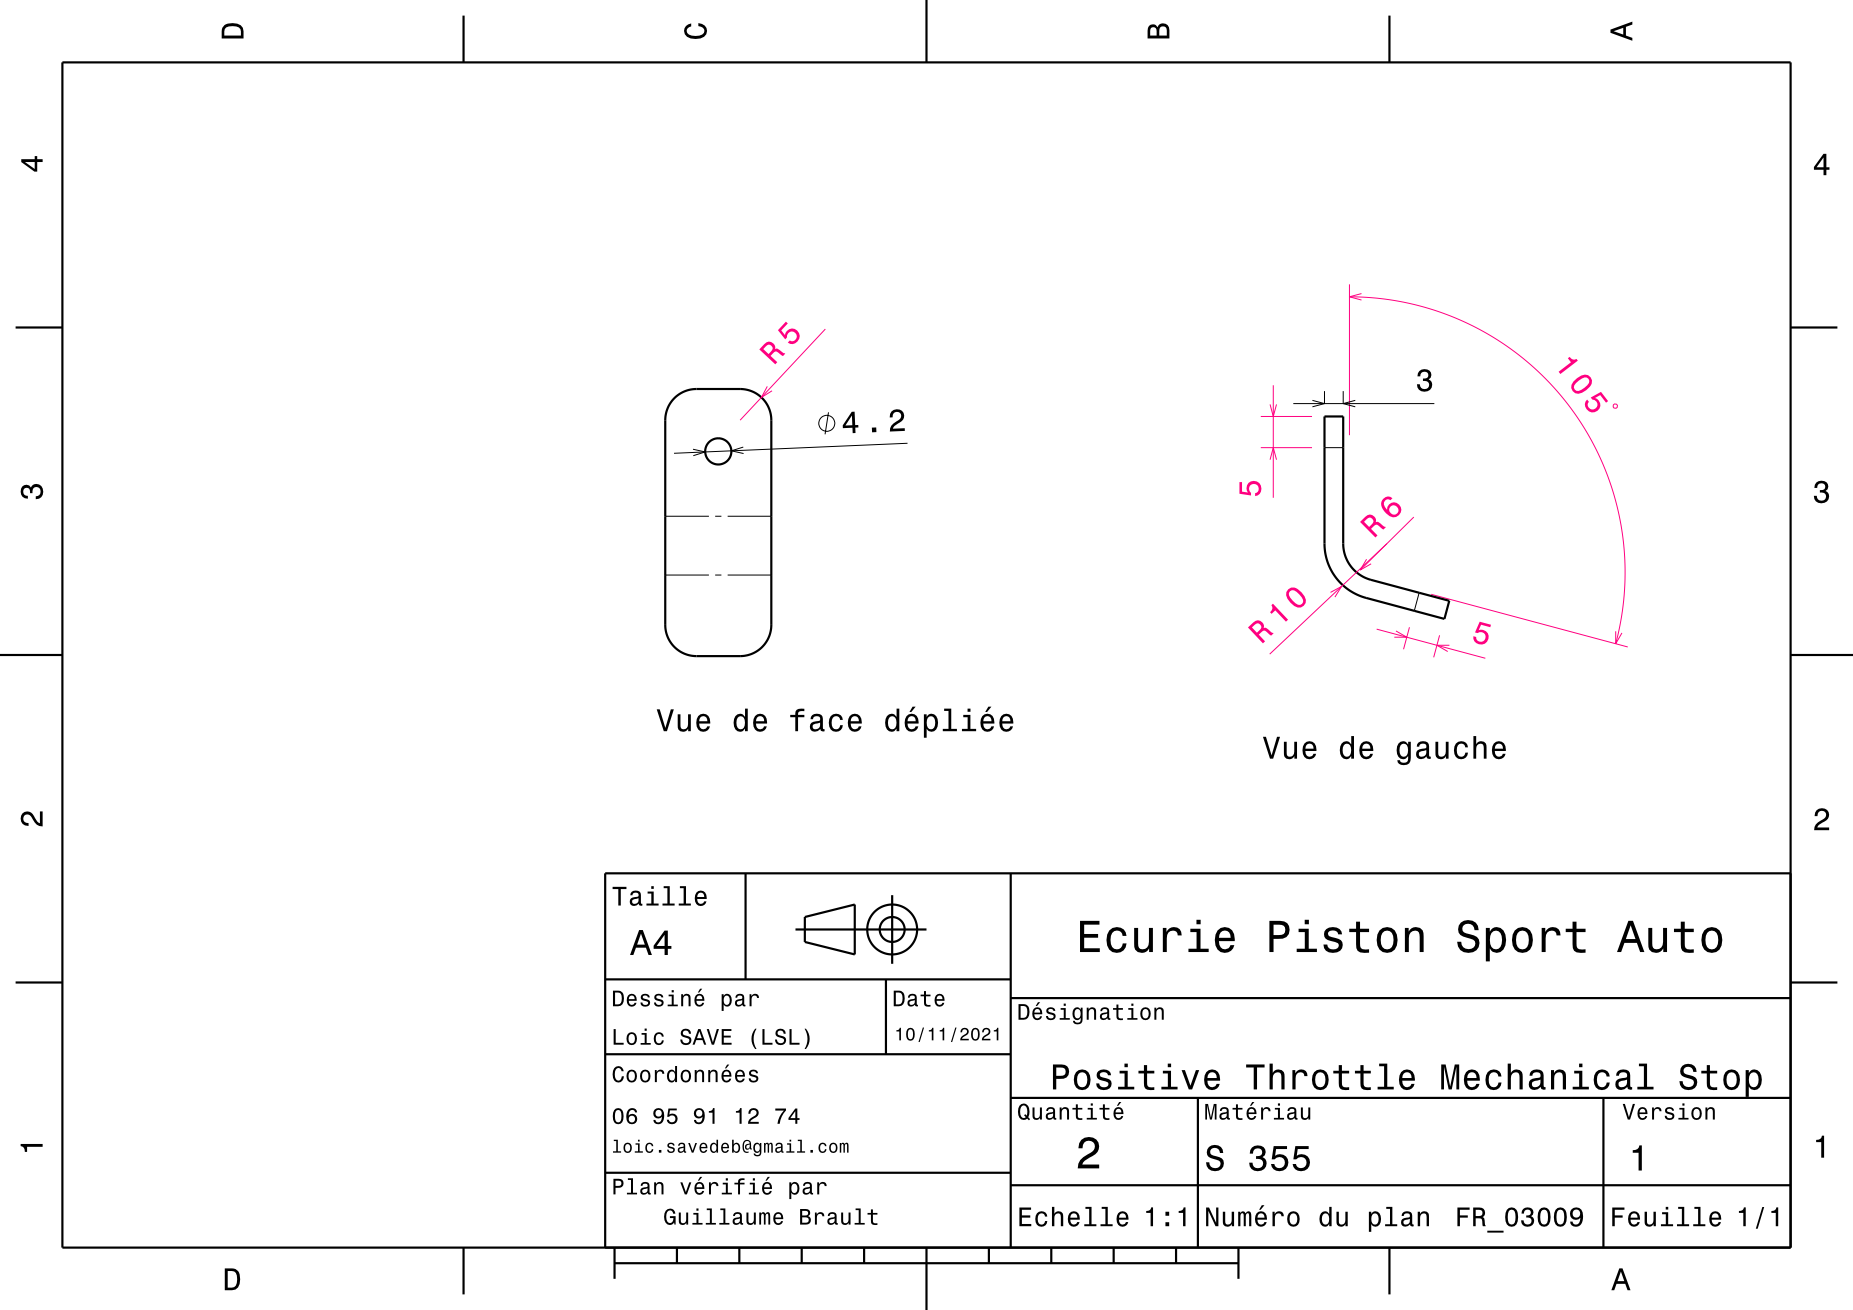
[picture p672: page 1]
