EOSCogniton/ELIZ-2021/(list of files, drawings)

Other design files:
EL_Electrical/Autre/TSAL/TSAL_ZZG/TSAL [Proteus 8.0].pdsprj
