EOSCogniton/ELIZ-2021/EL_Electrical/Autre/TSAL/TSAL_ZZG/TSAL_mainboard.brd

## EAGLE design EL_Electrical/Autre/TSAL/TSAL_ZZG/TSAL_mainboard.brd (2022-10-04)

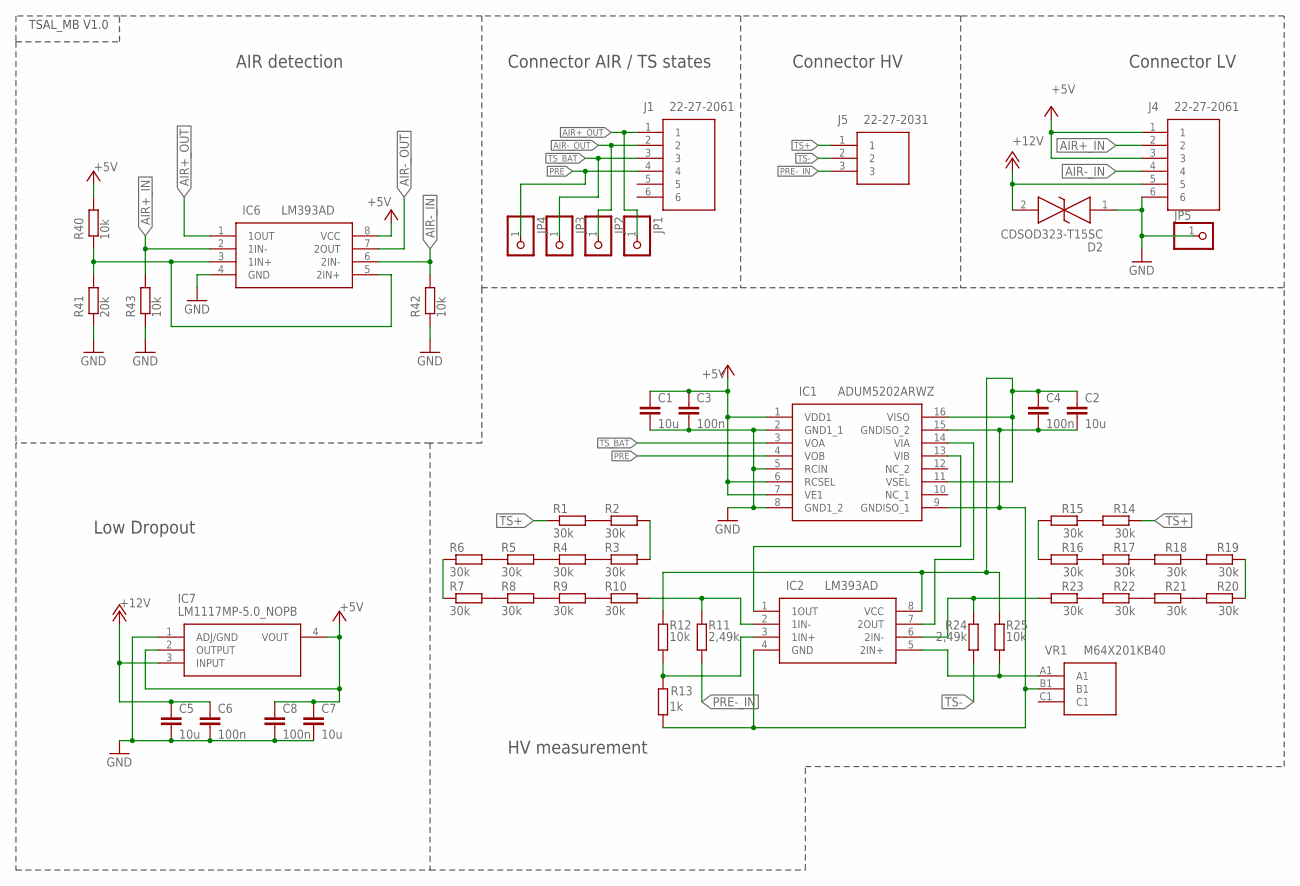
[picture p673: schematic TSAL_mainboard.sch]

Parts:
C1, C2, C5, C7: 10u; C1206
C3, C4, C6, C8: 100n; C0603
D2: CDSOD323-T15SC; SOD-323
IC1: ADUM5202ARWZ; SOIC127P1032X265-16N
IC2, IC6: LM393AD; SOIC127P600X175-8N
IC7: LM1117MP-5.0_NOPB; SOT230P700X180-4N
J1, J4: 22-27-2061; HDRV6W64P0X254_1X6_1524X580X11
J5: 22-27-2031; SHDR3W64P0X254_1X3_762X580X111
JP1, JP2, JP3, JP4, JP5: PINHD-1X1; 1X01
R1, R2, R3, R4, R5, R6, R7, R8, R9, R10, R14, R15, R16, R17, R18, R19, R20, R21, R22, R23: 30k; R1206
R11, R24: 2,49k; R0603
R12, R25, R40, R42, R43: 10k; R0603
R13: 1k; R1206
R41: 20k; R0603
VR1: M64X201KB40

Connections:
+5V: C1.1, C3.1, C7.1, C8.1, IC1.1 (VDD1), IC1.6 (RCSEL), IC1.7 (VE1), IC6.8 (VCC), IC7.2 (OUTPUT), IC7.4 (VOUT), J4.1, J4.3, R40.2
+12V: C5.1, C6.1, D2.2, IC7.3 (INPUT), J4.5
AIR+_IN: IC6.2 (1IN-), J4.2, R43.2
AIR+_OUT: IC6.1 (1OUT), J1.1, JP1.1
AIR-_IN: IC6.6 (2IN-), J4.4, R42.2
AIR-_OUT: IC6.7 (2OUT), J1.2, JP2.1
GND: C1.2, C3.2, C5.2, C6.2, C7.2, C8.2, D2.1, IC1.2 (GND1_1), IC1.5 (RCIN), IC1.8 (GND1_2), IC6.4 (GND), IC7.1 (ADJ/GND), J4.6, JP5.1, R41.1, R42.1, R43.1
unnamed: C2.1, C4.1, IC1.11 (VSEL), IC1.16 (VISO), IC2.8 (VCC), R12.1, R25.1
unnamed: R1.1, R2.2
unnamed: R2.1, R3.2
unnamed: R3.1, R4.2
unnamed: R4.1, R5.2
unnamed: R6.2, R7.1
unnamed: R7.2, R8.1
unnamed: R8.2, R9.1
unnamed: R9.2, R10.1
unnamed: R5.1, R6.1
unnamed: IC2.2 (1IN-), R10.2, R11.1
unnamed: IC2.3 (1IN+), R12.2, R13.1
unnamed: R14.1, R15.2
unnamed: R15.1, R16.2
unnamed: R16.1, R17.2
unnamed: R17.1, R18.2
unnamed: R19.2, R20.1
unnamed: R20.2, R21.1
unnamed: R21.2, R22.1
unnamed: R22.2, R23.1
unnamed: R18.1, R19.1
unnamed: IC2.6 (2IN-), R23.2, R24.1
unnamed: IC1.13 (VIB), IC2.1 (1OUT)
unnamed: IC2.5 (2IN+), R25.2, VR1.A1
unnamed: IC1.14 (VIA), IC2.7 (2OUT)
unnamed: IC6.3 (1IN+), IC6.5 (2IN+), R40.1, R41.2
unnamed: C2.2, C4.2, IC1.9 (GNDISO_1), IC1.15 (GNDISO_2), IC2.4 (GND), R13.2, VR1.B1
PRE: IC1.4 (VOB), J1.4, JP4.1
PRE-_IN: J5.3, R11.2
TS+: J5.1, R1.2, R14.2
TS-: J5.2, R24.2
TS_BAT: IC1.3 (VOA), J1.3, JP3.1

Notes on the sheet:
Low Dropout
HV measurement
TSAL_MB V1.0
Connector LV
Connector HV
Connector AIR / TS states
AIR detection

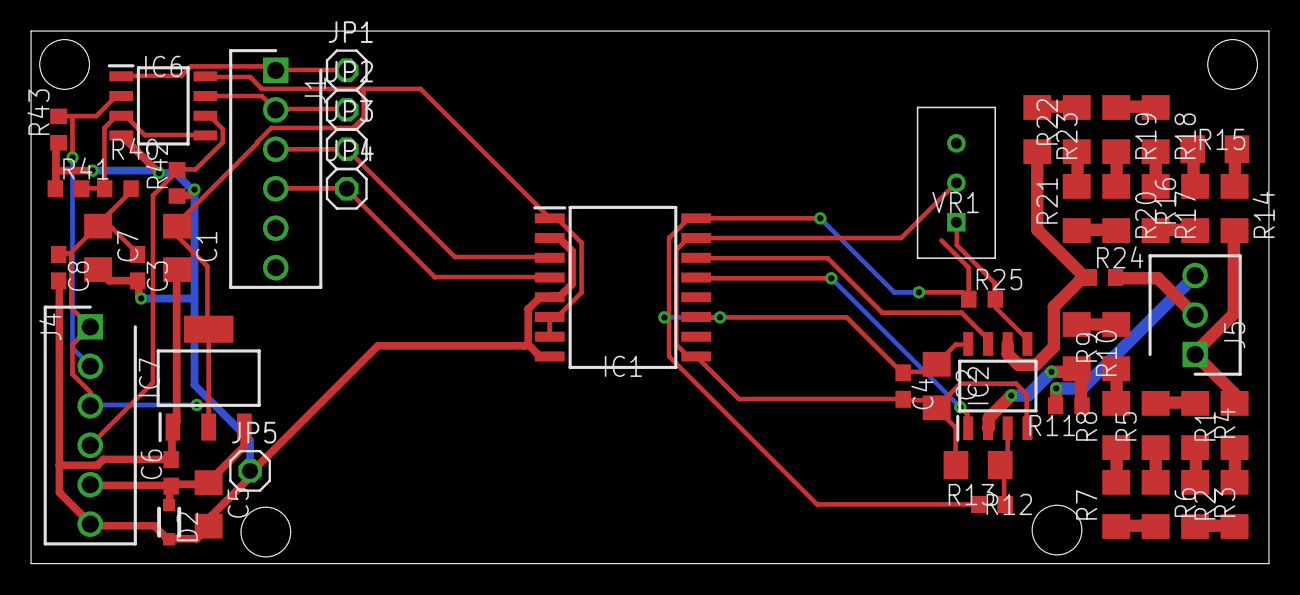
[picture p674: board TSAL_mainboard.brd from above]

Board: 2 copper layers, 79.7 x 34.3 mm, 51 parts (0 on the bottom side), 39 nets.
