EOSCogniton/ELIZ-2021/EL_Electrical/Autre/TSAL/TSAL_ZZG/TSAL_logic.brd

## EAGLE design EL_Electrical/Autre/TSAL/TSAL_ZZG/TSAL_logic.brd (2022-10-04)

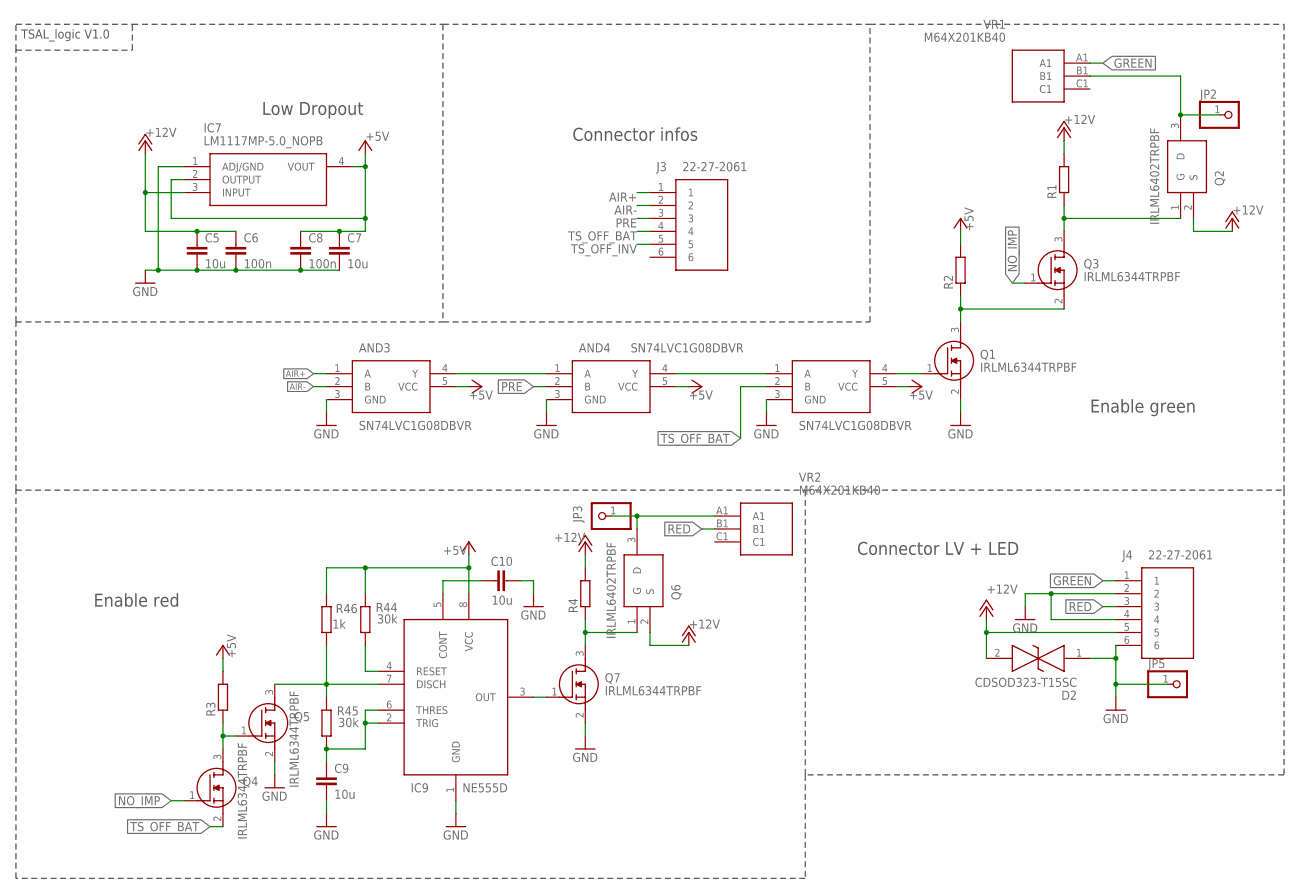
[picture p675: schematic TSAL_logic.sch, sheet 1]

Parts:
AND3, AND4, AND5: SN74LVC1G08DBVR; SOT95P280X145-5N
C5, C7, C9, C10: 10u; C1206
C6, C8: 100n; C0603
D2: CDSOD323-T15SC; SOD-323
IC7: LM1117MP-5.0_NOPB; SOT230P700X180-4N
IC9: NE555D; SOIC127P600X175-8N
J3, J4: 22-27-2061; HDRV6W64P0X254_1X6_1524X580X11
JP2, JP3, JP5: PINHD-1X1; 1X01
Q1, Q3, Q4, Q5, Q7: IRLML6344TRPBF; SOT95P237X112-3N
Q2, Q6: IRLML6402TRPBF; SOT95P237X112-3N
R1, R2, R3, R4: R-EU_R0603; R0603
R44, R45: 30k; R1206
R46: 1k; R1206
VR1, VR2: M64X201KB40

Connections:
12VN$2: Q2.1 (G), Q3.3 (D), R1.1
12VN$5: Q6.1 (G), Q7.3 (D), R4.1
12VN$29: JP2.1, Q2.3 (D), VR1.B1
+5V: AND3.5 (VCC), AND4.5 (VCC), AND5.5 (VCC), C7.1, C8.1, IC7.2 (OUTPUT), IC7.4 (VOUT), IC9.8 (VCC), R2.2, R3.2, R44.1, R46.1; also elsewhere on the board
+12V: C5.1, C6.1, D2.2, IC7.3 (INPUT), J4.5, Q2.2 (S), Q6.2 (S), R1.2, R4.2
AIR+: AND3.1 (A), J3.1; also elsewhere on the board
AIR-: AND3.2 (B), J3.2; also elsewhere on the board
GND: AND3.3 (GND), AND4.3 (GND), AND5.3 (GND), C5.2, C6.2, C7.2, C8.2, C9.2, C10.2, D2.1, IC7.1 (ADJ/GND), IC9.1 (GND), J4.2, J4.4, J4.6, JP5.1, Q1.2 (S), Q5.2 (S), Q7.2 (S); also elsewhere on the board
GREEN: J4.1, VR1.A1
unnamed: Q1.3 (D), Q3.2 (S), R2.1
unnamed: JP3.1, Q6.3 (D), VR2.A1
unnamed: Q4.3 (D), Q5.1 (G), R3.1
unnamed: IC9.3 (OUT), Q7.1 (G)
unnamed: AND4.4 (Y), AND5.1 (A)
unnamed: AND3.4 (Y), AND4.1 (A)
unnamed: AND5.4 (Y), Q1.1 (G)
unnamed: IC9.7 (DISCH), Q5.3 (D), R45.2, R46.2
unnamed: C9.1, IC9.2 (TRIG), IC9.6 (THRES), R45.1
unnamed: IC9.4 (RESET), R44.2
unnamed: C10.1, IC9.5 (CONT)
NO_IMP: Q3.1 (G), Q4.1 (G); also elsewhere on the board
PRE: AND4.2 (B), J3.3
RED: J4.3, VR2.B1
TS_OFF_BAT: AND5.2 (B), J3.4, Q4.2 (S); also elsewhere on the board
TS_OFF_INV: J3.5; also elsewhere on the board

Notes on the sheet:
Enable green
Enable red
Low Dropout
Connector infos
TSAL_logic V1.0
Connector LV + LED

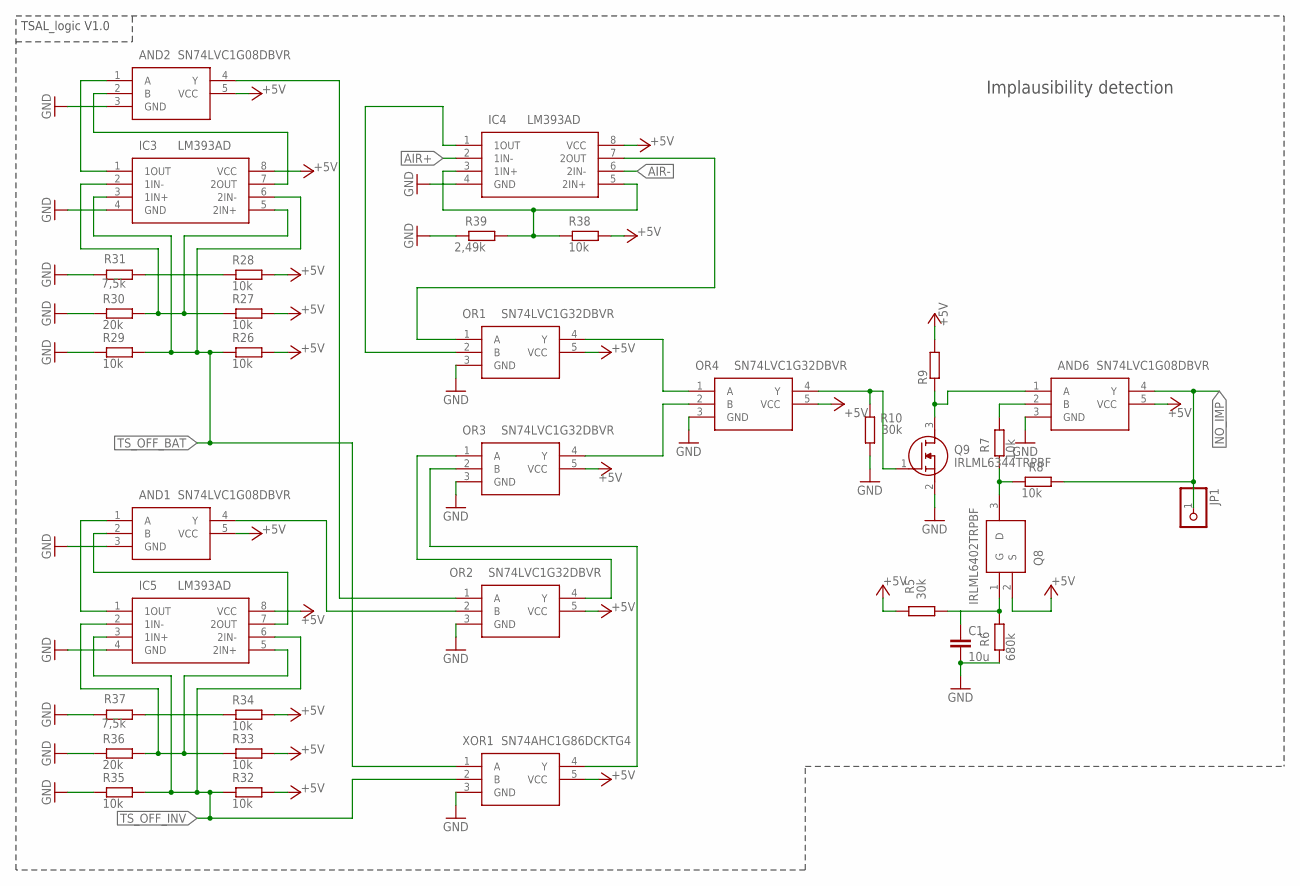
[picture p676: schematic TSAL_logic.sch, sheet 2]

Parts:
AND1, AND2, AND6: SN74LVC1G08DBVR; SOT95P280X145-5N
C1: 10u; C1206
IC3, IC4, IC5: LM393AD; SOIC127P600X175-8N
JP1: PINHD-1X1; 1X01
OR1, OR2, OR3, OR4: SN74LVC1G32DBVR; SOT95P280X145-5N
Q8: IRLML6402TRPBF; SOT95P237X112-3N
Q9: IRLML6344TRPBF; SOT95P237X112-3N
R5, R10: 30k; R1206
R6: 680k; R0603
R7, R8, R26, R27, R28, R29, R32, R33, R34, R35, R38: 10k; R0603
R9: R-EU_R0603; R0603
R30, R36: 20k; R0603
R31, R37: 7,5k; R0805
R39: 2,49k; R0603
XOR1: SN74AHC1G86DCKTG4; SOT65P210X110-5N

Connections:
+5V: AND1.5 (VCC), AND2.5 (VCC), AND6.5 (VCC), IC3.8 (VCC), IC4.8 (VCC), IC5.8 (VCC), OR1.5 (VCC), OR2.5 (VCC), OR3.5 (VCC), OR4.5 (VCC), Q8.2 (S), R5.1, R9.2, R26.2, R27.2, R28.2, R32.2, R33.2, R34.2, R38.2, XOR1.5 (VCC); also elsewhere on the board
AIR+: IC4.2 (1IN-); also elsewhere on the board
AIR-: IC4.6 (2IN-); also elsewhere on the board
GND: AND1.3 (GND), AND2.3 (GND), AND6.3 (GND), C1.2, IC3.4 (GND), IC4.4 (GND), IC5.4 (GND), OR1.3 (GND), OR2.3 (GND), OR3.3 (GND), OR4.3 (GND), Q9.2 (S), R6.1, R10.2, R29.1, R30.1, R31.1, R35.1, R36.1, R37.1, R39.1, XOR1.3 (GND); also elsewhere on the board
unnamed: OR2.4 (Y), OR3.1 (A)
unnamed: OR4.4 (Y), Q9.1 (G), R10.1
unnamed: C1.1, Q8.1 (G), R5.2, R6.2
unnamed: AND6.2 (B), R7.2
unnamed: Q8.3 (D), R7.1, R8.1
unnamed: IC4.7 (2OUT), OR1.1 (A)
unnamed: AND1.4 (Y), OR2.2 (B)
unnamed: OR3.2 (B), XOR1.4 (Y)
unnamed: OR1.4 (Y), OR4.1 (A)
unnamed: AND6.1 (A), Q9.3 (D), R9.1
unnamed: R28.1, R31.2
unnamed: IC3.2 (1IN-), IC3.5 (2IN+), R27.1, R30.2
unnamed: AND2.1 (A), IC3.1 (1OUT)
unnamed: AND2.2 (B), IC3.7 (2OUT)
unnamed: R34.1, R37.2
unnamed: IC5.2 (1IN-), IC5.5 (2IN+), R33.1, R36.2
unnamed: AND1.2 (B), IC5.7 (2OUT)
unnamed: AND1.1 (A), IC5.1 (1OUT)
unnamed: IC4.3 (1IN+), IC4.5 (2IN+), R38.1, R39.2
unnamed: IC4.1 (1OUT), OR1.2 (B)
unnamed: AND2.4 (Y), OR2.1 (A)
unnamed: OR3.4 (Y), OR4.2 (B)
NO_IMP: AND6.4 (Y), JP1.1, R8.2; also elsewhere on the board
TS_OFF_BAT: IC3.3 (1IN+), IC3.6 (2IN-), R26.1, R29.2, XOR1.1 (A); also elsewhere on the board
TS_OFF_INV: IC5.3 (1IN+), IC5.6 (2IN-), R32.1, R35.2, XOR1.2 (B); also elsewhere on the board

Notes on the sheet:
Implausibility detection
TSAL_logic V1.0

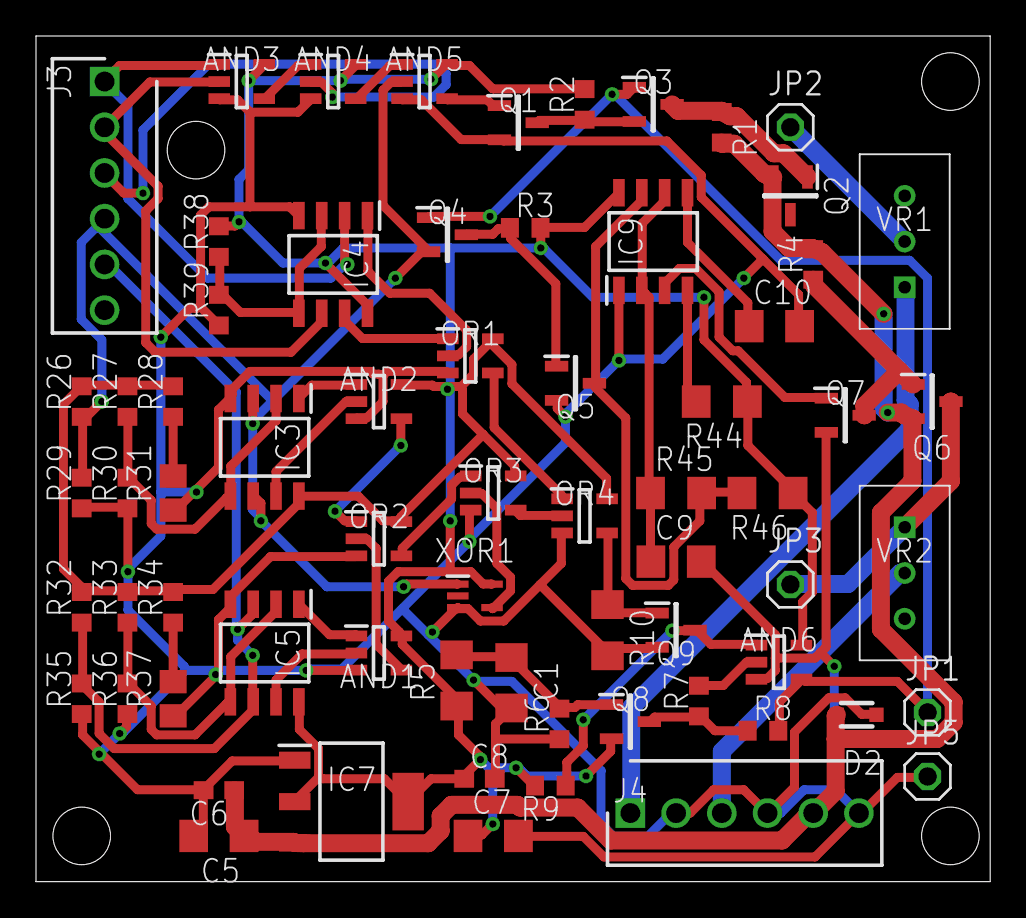
[picture p677: board TSAL_logic.brd from above]

Board: 2 copper layers, 53.0 x 47.0 mm, 68 parts (0 on the bottom side), 47 nets.
