EOSCogniton/ELIZ-2021/EL_Electrical/Autre/TSAL/TSAL_contactor_state_and_accumulator_voltage_measurement/TSAL_contactor_state_and_accumulator_voltage_measurement_TNN_V1.0.brd

## EAGLE design EL_Electrical/Autre/TSAL/TSAL_contactor_state_and_accumulator_voltage_measurement/TSAL_contactor_state_and_accumulator_voltage_measurement_TNN_V1.0.brd (2021-12-28)

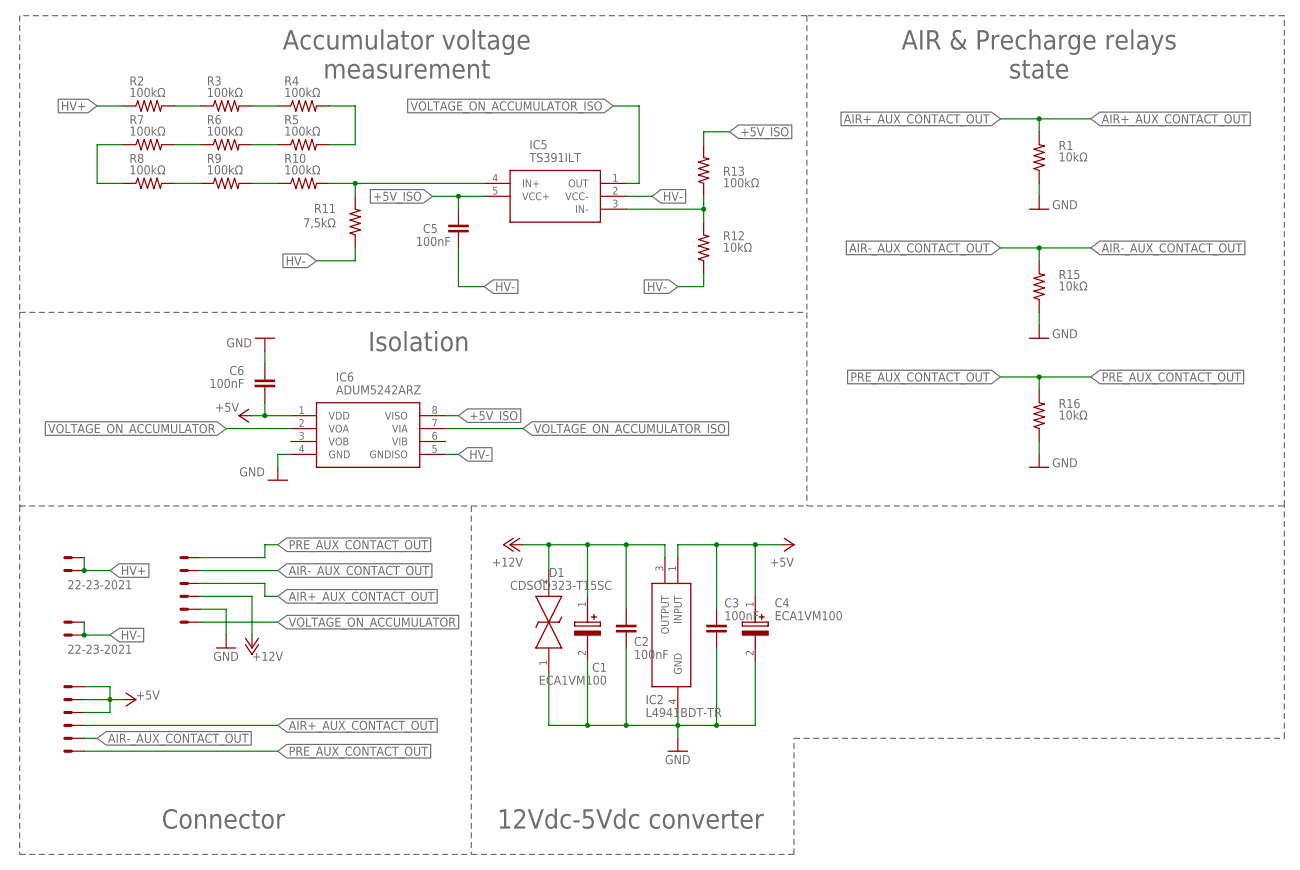
[picture p678: schematic TSAL_contactor_state_and_accumulator_voltage_measurement_TNN_V1.0.sch]

Parts:
AUX_CONTACT: 22-23-2061
C1, C4: ECA1VM100; CAPPRD200W55D525H1200
C2, C3, C5, C6: 100nF; C0603
D1: CDSOD323-T15SC; SOD-323
HV+: 22-23-2021
HV-: 22-23-2021
IC2: L4941BDT-TR; TO228P972X240-3N
IC5: TS391ILT; SOT95P280X145-5N
IC6: ADUM5242ARZ; SOIC127P600X175-8N
POWER_AND_TSAL_SIGNAL: 22-23-2061
R1, R12, R15, R16: 10kΩ; R0603
R2, R3, R4, R5, R6, R7, R8, R9, R10, R13: 100kΩ; R0603
R11: 7,5kΩ; R0603

Connections:
+5V: AUX_CONTACT.4, AUX_CONTACT.5, AUX_CONTACT.6, C3.1, C4.1 (+), C6.1, IC2.1 (INPUT), IC6.1 (VDD)
+5V_ISO: C5.2, IC5.5 (VCC+), IC6.8 (VISO), R13.2
+12V: C1.1 (+), C2.1, D1.2, IC2.3 (OUTPUT), POWER_AND_TSAL_SIGNAL.3
AIR+_AUX_CONTACT_OUT: AUX_CONTACT.3, POWER_AND_TSAL_SIGNAL.4, R1.2
AIR-_AUX_CONTACT_OUT: AUX_CONTACT.2, POWER_AND_TSAL_SIGNAL.5, R15.2
GND: C1.2 (-), C2.2, C3.2, C4.2 (-), C6.2, D1.1, IC2.4 (GND), IC6.4 (GND), POWER_AND_TSAL_SIGNAL.2, R1.1, R15.1, R16.1
HV+: HV+.1, HV+.2, R2.1
HV-: C5.1, HV-.1, HV-.2, IC5.2 (VCC-), IC6.5 (GNDISO), R11.1, R12.1
unnamed: R2.2, R3.1
unnamed: R3.2, R4.1
unnamed: R4.2, R5.2
unnamed: R5.1, R6.2
unnamed: R6.1, R7.2
unnamed: R7.1, R8.1
unnamed: R8.2, R9.1
unnamed: R9.2, R10.1
unnamed: IC5.4 (IN+), R10.2, R11.2
unnamed: IC5.3 (IN-), R12.2, R13.1
PRE_AUX_CONTACT_OUT: AUX_CONTACT.1, POWER_AND_TSAL_SIGNAL.6, R16.2
VOLTAGE_ON_ACCUMULATOR: IC6.2 (VOA), POWER_AND_TSAL_SIGNAL.1
VOLTAGE_ON_ACCUMULATOR_ISO: IC5.1 (OUT), IC6.7 (VIA)

Notes on the sheet:
Connector
12Vdc-5Vdc converter
Accumulator voltage measurement
Isolation
AIR & Precharge relays state

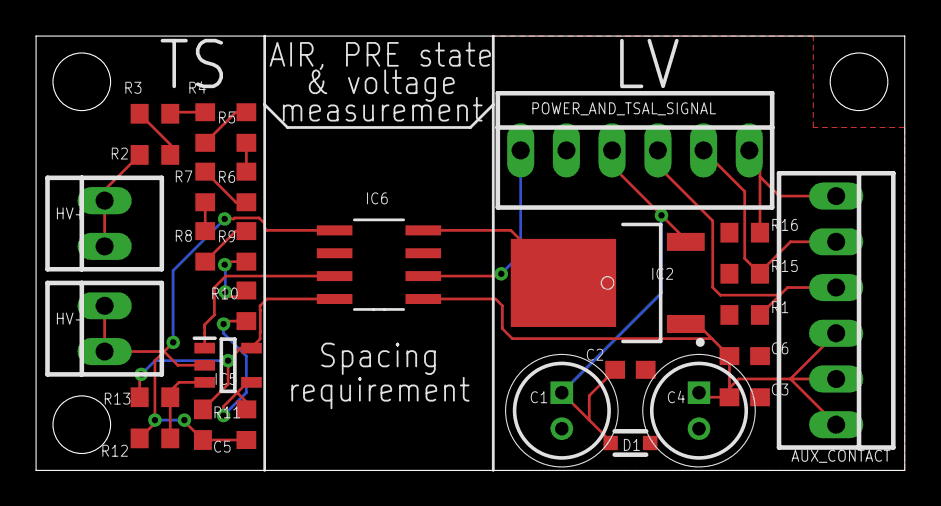
[picture p679: board TSAL_contactor_state_and_accumulator_voltage_measurement_TNN_V1.0.brd from above]

Board: 2 copper layers, 48.3 x 24.1 mm, 29 parts (0 on the bottom side), 21 nets.
