EOSCogniton/ELIZ-2021/EL_Electrical/Autre/TSAL/TSAL_inverter_voltage_measurement/TSAL_inverter_voltage_measurement_TNN_V1.0.brd

## EAGLE design EL_Electrical/Autre/TSAL/TSAL_inverter_voltage_measurement/TSAL_inverter_voltage_measurement_TNN_V1.0.brd (2021-12-28)

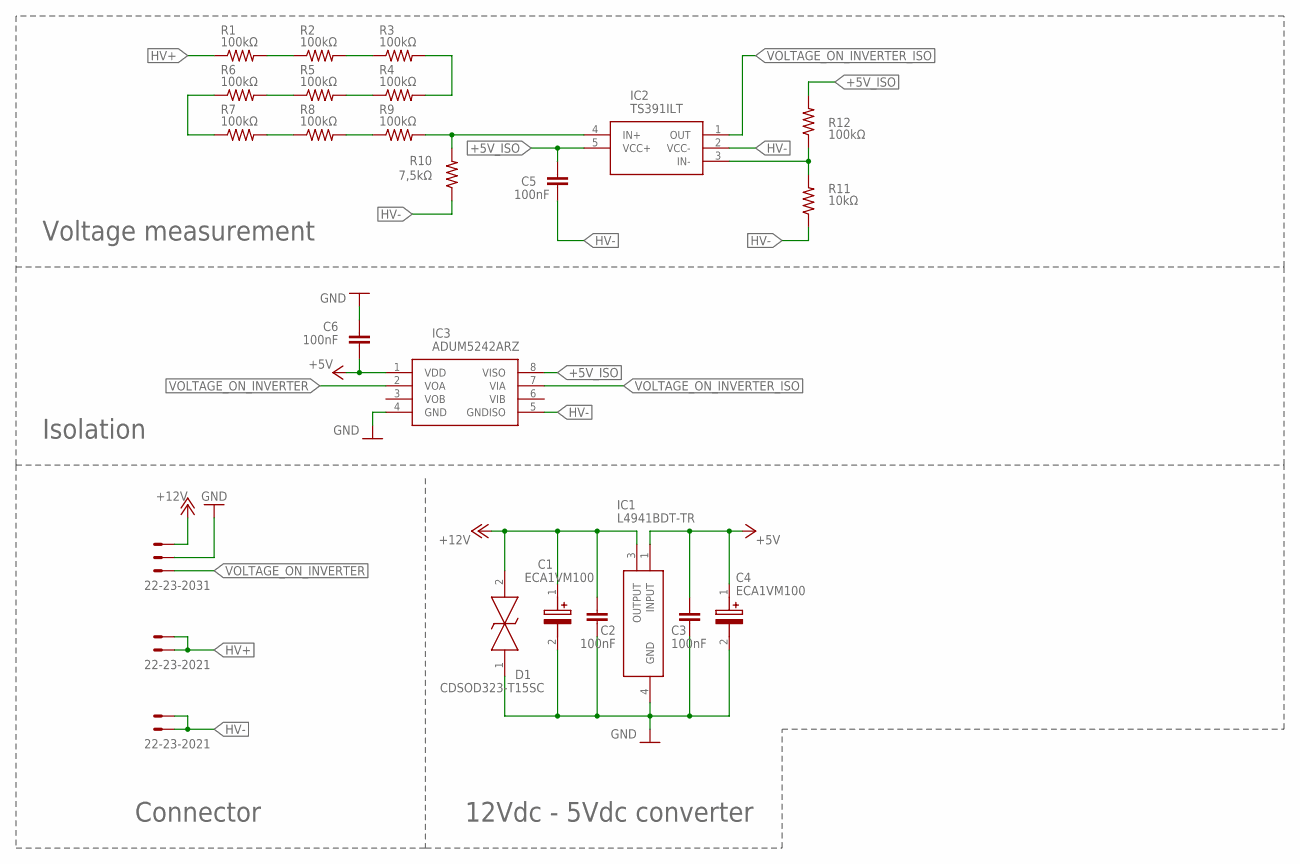
[picture p680: schematic TSAL_inverter_voltage_measurement_TNN_V1.0.sch]

Parts:
C1, C4: ECA1VM100; CAPPRD200W55D525H1200
C2, C3, C5, C6: 100nF; C0603
D1: CDSOD323-T15SC; SOD-323
HV+: 22-23-2021
HV-: 22-23-2021
IC1: L4941BDT-TR; TO228P972X240-3N
IC2: TS391ILT; SOT95P280X145-5N
IC3: ADUM5242ARZ; SOIC127P600X175-8N
LOW_VOLTAGE: 22-23-2031
R1, R2, R3, R4, R5, R6, R7, R8, R9, R12: 100kΩ; R0603
R10: 7,5kΩ; R0603
R11: 10kΩ; R0603

Connections:
+5V: C3.2, C4.1 (+), C6.1, IC1.1 (INPUT), IC3.1 (VDD)
+5V_ISO: C5.2, IC2.5 (VCC+), IC3.8 (VISO), R12.2
+12V: C1.1 (+), C2.2, D1.2, IC1.3 (OUTPUT), LOW_VOLTAGE.3
GND: C1.2 (-), C2.1, C3.1, C4.2 (-), C6.2, D1.1, IC1.4 (GND), IC3.4 (GND), LOW_VOLTAGE.2
HV+: HV+.1, HV+.2, R1.1
HV-: C5.1, HV-.1, HV-.2, IC2.2 (VCC-), IC3.5 (GNDISO), R10.1, R11.1
unnamed: R1.2, R2.1
unnamed: R2.2, R3.1
unnamed: R3.2, R4.2
unnamed: R4.1, R5.2
unnamed: R5.1, R6.2
unnamed: R6.1, R7.1
unnamed: R7.2, R8.1
unnamed: R8.2, R9.1
unnamed: IC2.4 (IN+), R9.2, R10.2
unnamed: IC2.3 (IN-), R11.2, R12.1
VOLTAGE_ON_INVERTER: IC3.2 (VOA), LOW_VOLTAGE.1
VOLTAGE_ON_INVERTER_ISO: IC2.1 (OUT), IC3.7 (VIA)

Notes on the sheet:
Connector
12Vdc - 5Vdc converter
Isolation
Voltage measurement

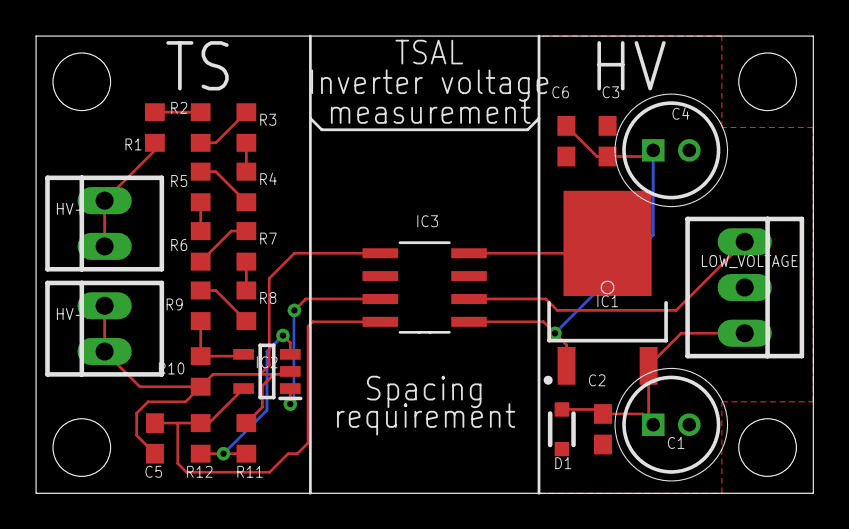
[picture p681: board TSAL_inverter_voltage_measurement_TNN_V1.0.brd from above]

Board: 2 copper layers, 43.2 x 25.4 mm, 25 parts (0 on the bottom side), 18 nets.
