EOSCogniton/ELIZ-2021/EL_Electrical/Autre/Shutdown_circuit/Precharge circuit/Precharge_circuit_logic_TNN_V1.0.brd

## EAGLE design EL_Electrical/Autre/Shutdown_circuit/Precharge circuit/Precharge_circuit_logic_TNN_V1.0.brd (2021-12-28)

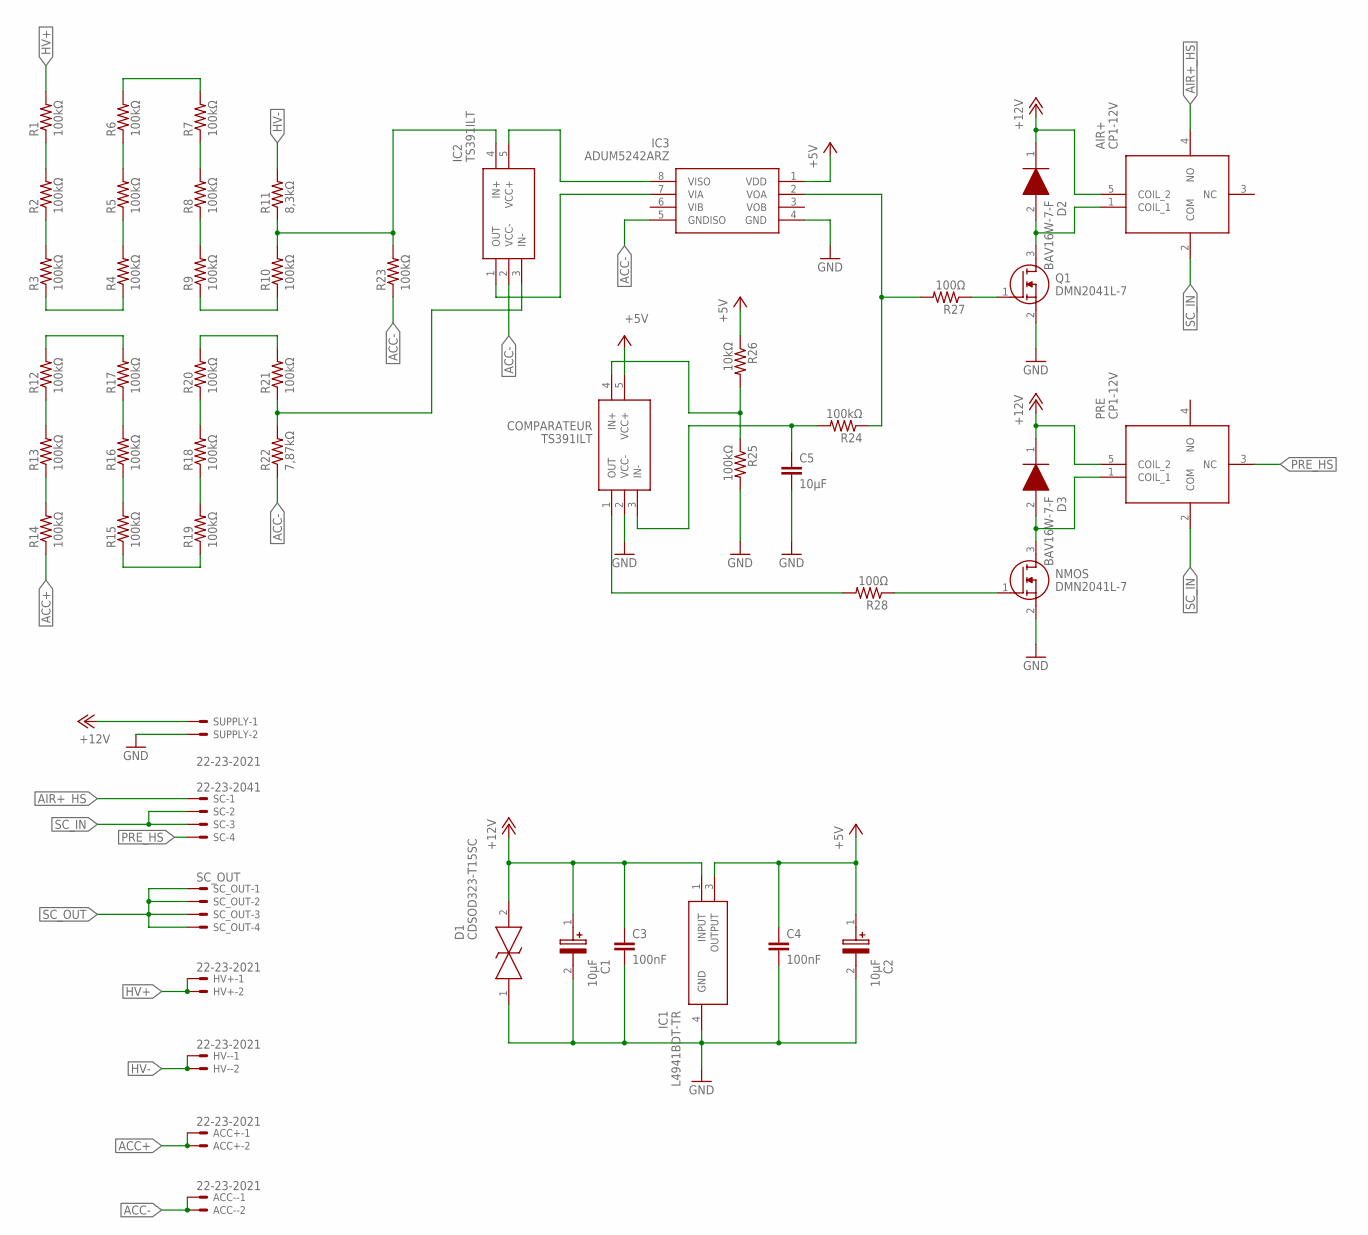
[picture p682: schematic Precharge_circuit_logic_TNN_V1.0.sch]

Parts:
ACC+: 22-23-2021
ACC-: 22-23-2021
AIR+: CP1-12V; CP1FORMC_1
C1, C2: 10μF; CAPPRD200W55D525H1200
C3, C4: 100nF; C0603
C5: 10μF; C0603
COMPARATEUR: TS391ILT; SOT95P280X145-5N
D1: CDSOD323-T15SC; SOD-323
D2, D3: BAV16W-7-F; SOD3716X145N
HV+: 22-23-2021
HV-: 22-23-2021
IC1: L4941BDT-TR; TO228P972X240-3N
IC2: TS391ILT; SOT95P280X145-5N
IC3: ADUM5242ARZ; SOIC127P600X175-8N
NMOS: DMN2041L-7; SOT96P240X110-3N
PRE: CP1-12V; CP1FORMC_1
Q1: DMN2041L-7; SOT96P240X110-3N
R1, R2, R3, R4, R5, R6, R7, R8, R9, R10, R12, R13, R14, R15, R16, R17, R18, R19, R20, R21, R23, R24, R25: 100kΩ; R0603
R11: 8,3kΩ; R0603
R22: 7,87kΩ; R0603
R26: 10kΩ; R0603
R27, R28: 100Ω; R0603
SC: 22-23-2041
SC_OUT: SC_OUT; 22-23-2041
SUPPLY: 22-23-2021

Connections:
+5V: C2.1 (+), C4.1, COMPARATEUR.5 (VCC+), IC1.3 (OUTPUT), IC3.1 (VDD), R26.1
+12V: AIR+.5 (COIL_2), C1.1 (+), C3.1, D1.2, D2.1 (K), D3.1 (K), IC1.1 (INPUT), PRE.5 (COIL_2), SUPPLY.1
ACC+: ACC+.1, ACC+.2, R14.1
ACC-: ACC-.1, ACC-.2, IC2.2 (VCC-), IC3.5 (GNDISO), R22.1, R23.1
AIR+_HS: AIR+.4 (NO), SC.1
GND: C1.2 (-), C2.2 (-), C3.2, C4.2, C5.2, COMPARATEUR.2 (VCC-), D1.1, IC1.4 (GND), IC3.4 (GND), NMOS.2 (S), Q1.2 (S), R25.2, SUPPLY.2
HV+: HV+.1, HV+.2, R1.2
HV-: HV-.1, HV-.2, R11.2
unnamed: R1.1, R2.2
unnamed: R2.1, R3.2
unnamed: R3.1, R4.1
unnamed: R4.2, R5.1
unnamed: R5.2, R6.1
unnamed: R6.2, R7.2
unnamed: R7.1, R8.2
unnamed: R8.1, R9.2
unnamed: R9.1, R10.1
unnamed: IC2.4 (IN+), R10.2, R11.1, R23.2
unnamed: IC2.5 (VCC+), IC3.8 (VISO)
unnamed: COMPARATEUR.4 (IN+), R25.1, R26.2
unnamed: R13.1, R14.2
unnamed: R12.1, R13.2
unnamed: R12.2, R17.2
unnamed: R16.2, R17.1
unnamed: R15.2, R16.1
unnamed: R15.1, R19.1
unnamed: R18.1, R19.2
unnamed: R18.2, R20.1
unnamed: R20.2, R21.2
unnamed: IC2.3 (IN-), R21.1, R22.2
unnamed: D3.2 (A), NMOS.3 (D), PRE.1 (COIL_1)
unnamed: IC2.1 (OUT), IC3.7 (VIA)
unnamed: C5.1, COMPARATEUR.3 (IN-), R24.2
unnamed: IC3.2 (VOA), R24.1, R27.2
unnamed: COMPARATEUR.1 (OUT), R28.2
unnamed: AIR+.1 (COIL_1), D2.2 (A), Q1.3 (D)
unnamed: NMOS.1 (G), R28.1
unnamed: Q1.1 (G), R27.1
PRE_HS: PRE.3 (NC), SC.4
SC_IN: AIR+.2 (COM), PRE.2 (COM), SC.2, SC.3
SC_OUT: SC_OUT.1, SC_OUT.2, SC_OUT.3, SC_OUT.4

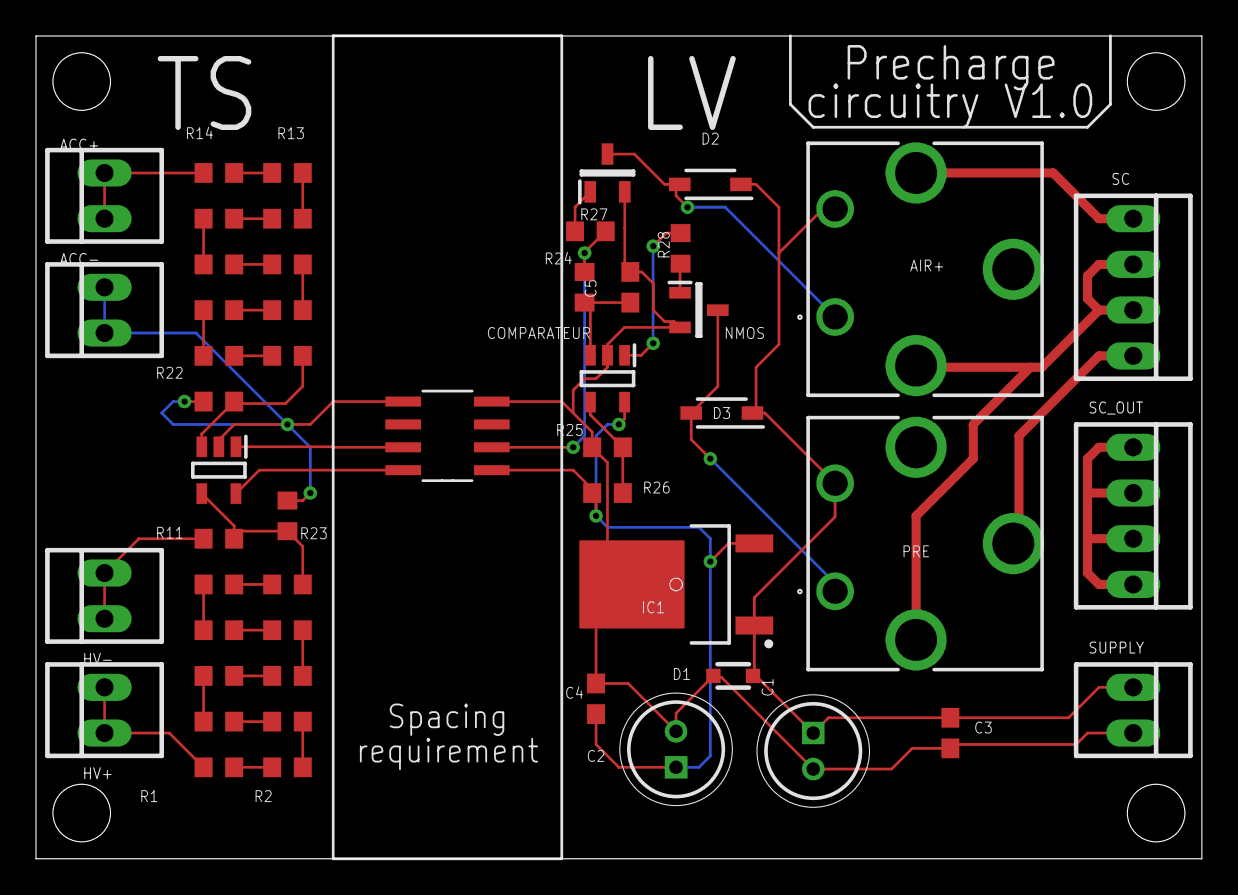
[picture p683: board Precharge_circuit_logic_TNN_V1.0.brd from above]

Board: 2 copper layers, 64.8 x 45.7 mm, 51 parts (0 on the bottom side), 41 nets.
