EOSCogniton/ELIZ-2021/EL_Electrical/Autre/Accumulator indicator voltage/Indicator_voltage_TNN_V1.0.brd

## EAGLE design EL_Electrical/Autre/Accumulator indicator voltage/Indicator_voltage_TNN_V1.0.brd (2021-12-28)

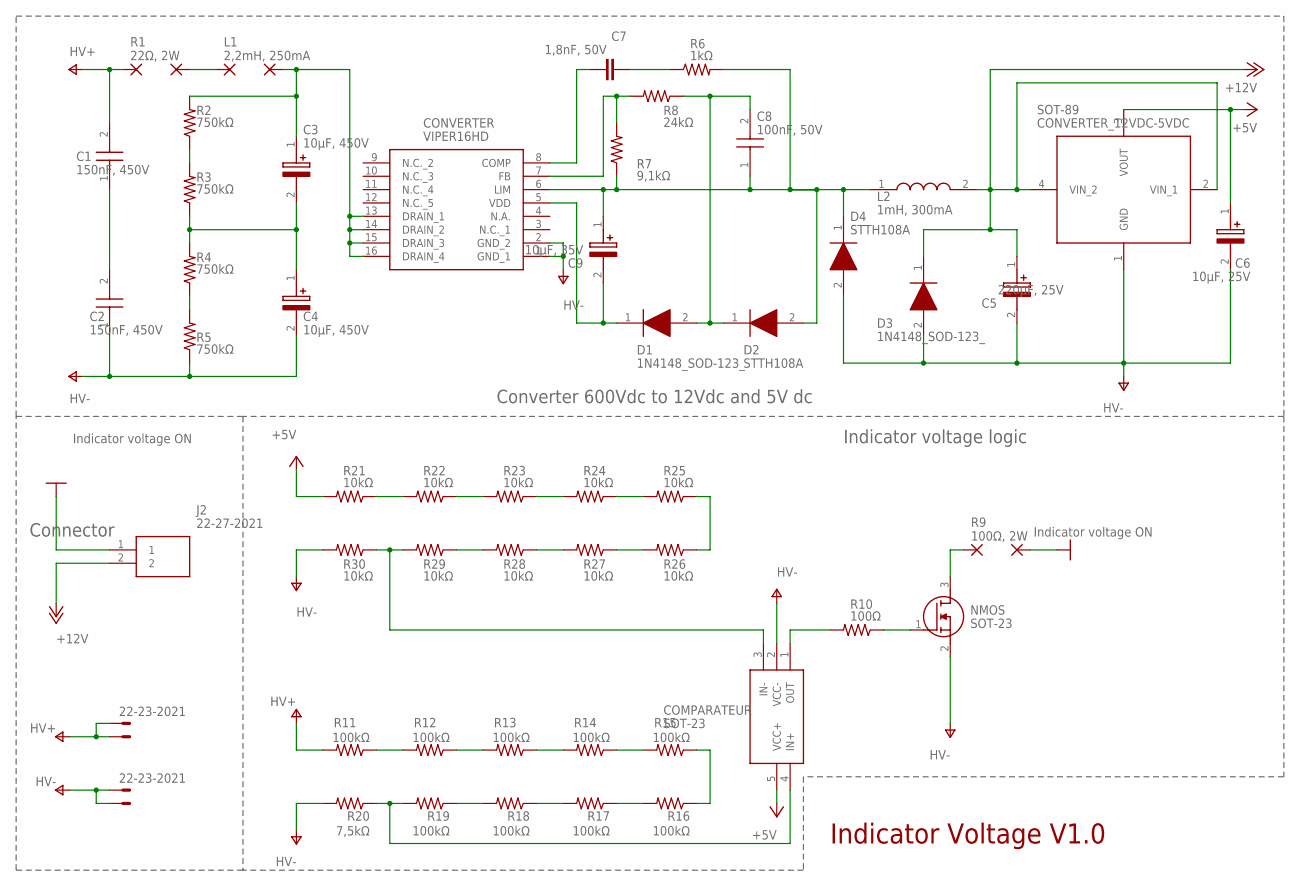
[picture p684: schematic Indicator_voltage_TNN_V1.0.sch]

Parts:
C1, C2: 150nF, 450V; CAPC4720X175N
C3, C4: 10μF, 450V; CAPPRD500W60D1300H2250
C5: 220μF, 25V; CAPPRD500W60D1300H2250
C6: 10μF, 25V; CAPPRD200W55D525H1200
C7: 1,8nF, 50V; C0805
C8: 100nF, 50V; CAPC2012X88N
C9: 10μF, 35V; CAPPRD200W55D525H1200
COMPARATEUR: SOT-23; SOT95P280X145-5N
CONVERTER: VIPER16HD; SOIC127P600X175-16N
CONVERTER_12VDC-5VDC: SOT-89; ST-SOT-89
D1, D3: 1N4148_SOD-123_; SOD3716X135N
D2, D4: STTH108A; DIOM5126X265N
HV+: 22-23-2021
HV-: 22-23-2021
J2: 22-27-2021; SHDR2W64P0X254_1X2_508X580X117
L1, L3: 2,2mH, 250mA; 1,6/0,8
L2: 1mH, 300mA; RLB0914
NMOS: SOT-23; SOT96P240X110-3N
PAD2, PAD4: 1,6/0,8
R1: 22Ω, 2W; 1,6/0,8
R2, R3, R4, R5: 750kΩ; M3216
R6: 1kΩ; M2012
R7: 9,1kΩ; M2012
R8: 24kΩ; M2012
R9: 100Ω, 2W; 1,6/0,8
R10: 100Ω; R0603
R11, R12, R13, R14, R15, R16, R17, R18, R19: 100kΩ; R0603
R20: 7,5kΩ; R0603
R21, R22, R23, R24, R25, R26, R27, R28, R29, R30: 10kΩ; R0603

Connections:
0V: J2.1, PAD4.1
+5V: C6.1 (+), COMPARATEUR.5 (VCC+), CONVERTER_12VDC-5VDC.3 (VOUT), R21.2
+12V: C5.1 (+), CONVERTER_12VDC-5VDC.2 (VIN_1), CONVERTER_12VDC-5VDC.4 (VIN_2), D3.1 (K), J2.2, L2.2
unnamed: R11.1, R12.2
unnamed: L1.1, PAD2.1
unnamed: C9.2 (-), CONVERTER.5 (VDD), D1.1 (K)
unnamed: C1.1, C2.2
unnamed: C3.1 (+), CONVERTER.13 (DRAIN_1), CONVERTER.14 (DRAIN_2), CONVERTER.15 (DRAIN_3), CONVERTER.16 (DRAIN_4), L3.1, R2.2
unnamed: R4.1, R5.2
unnamed: C3.2 (-), C4.1 (+), R3.1, R4.2
unnamed: R2.1, R3.2
unnamed: C7.2, CONVERTER.8 (COMP)
unnamed: C7.1, R6.1
unnamed: C8.1, C9.1 (+), CONVERTER.6 (LIM), D2.2 (A), D4.1 (K), L2.1, R6.2, R7.1
unnamed: C8.2, D1.2 (A), D2.1 (K), R8.1
unnamed: R12.1, R13.2
unnamed: CONVERTER.7 (FB), R7.2, R8.2
unnamed: R13.1, R14.2
unnamed: R14.1, R15.2
unnamed: R15.1, R16.1
unnamed: R16.2, R17.1
unnamed: R17.2, R18.1
unnamed: R18.2, R19.1
unnamed: COMPARATEUR.4 (IN+), R19.2, R20.1
unnamed: COMPARATEUR.1 (OUT), R10.2
unnamed: R21.1, R22.2
unnamed: R22.1, R23.2
unnamed: R23.1, R24.2
unnamed: R24.1, R25.2
unnamed: R25.1, R26.1
unnamed: R26.2, R27.1
unnamed: R27.2, R28.1
unnamed: R28.2, R29.1
unnamed: COMPARATEUR.3 (IN-), R29.2, R30.1
unnamed: NMOS.3 (D), R9.1
unnamed: NMOS.1 (G), R10.1
V+: C1.2, HV+.1, HV+.2, R1.1, R11.2
V-: C2.1, C4.2 (-), C5.2 (-), C6.2 (-), COMPARATEUR.2 (VCC-), CONVERTER.1 (GND_1), CONVERTER.2 (GND_2), CONVERTER_12VDC-5VDC.1 (GND), D3.2 (A), D4.2 (A), HV-.1, HV-.2, NMOS.2 (S), R5.1, R20.2, R30.2

Notes on the sheet:
Converter 600Vdc to 12Vdc and 5V dc
Indicator voltage logic
Connector
Indicator Voltage V1.0

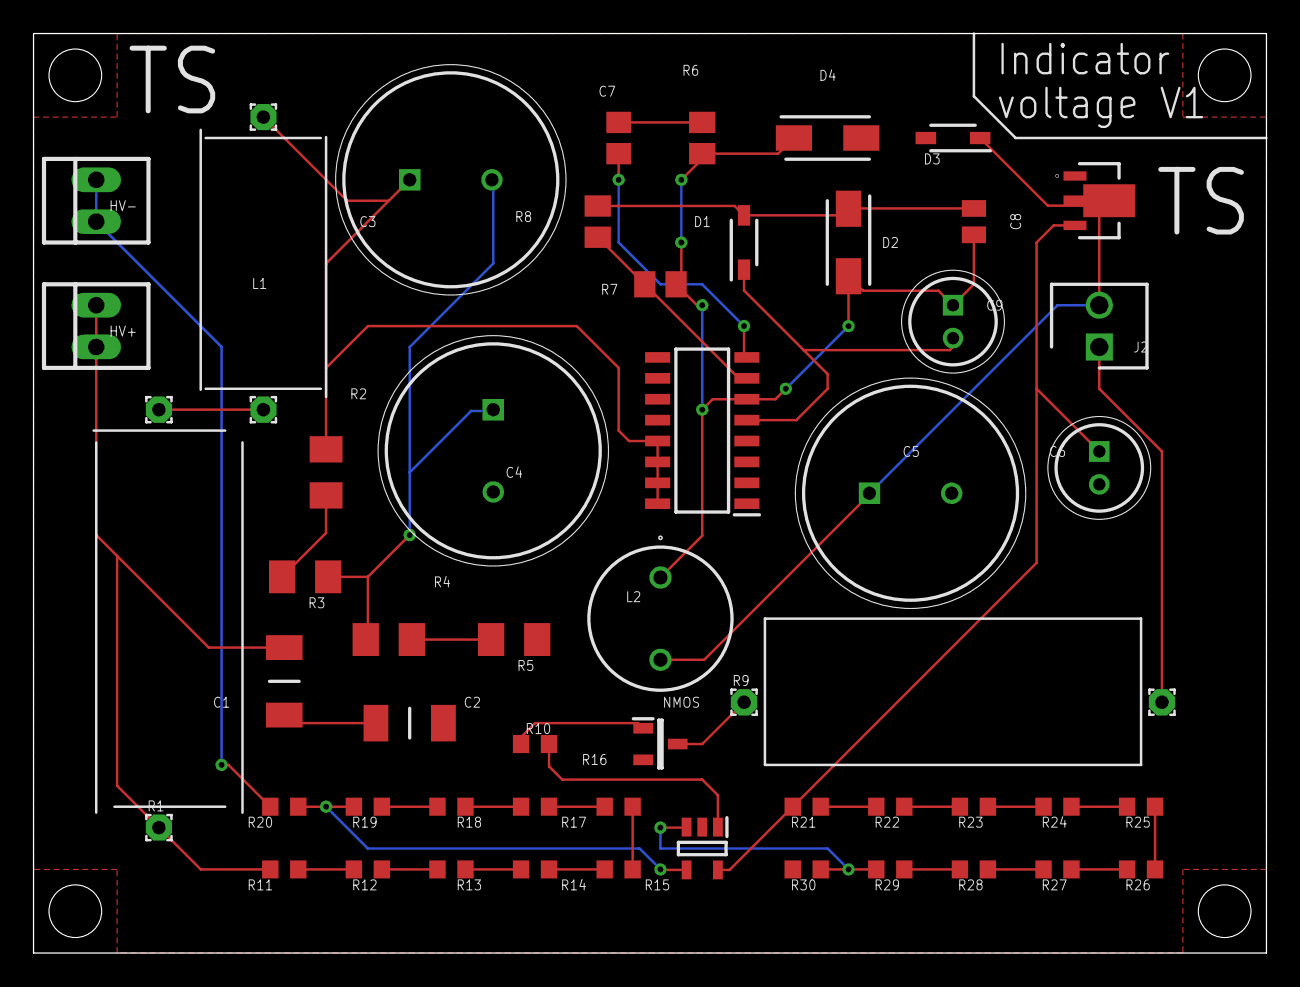
[picture p685: board Indicator_voltage_TNN_V1.0.brd from above]

Board: 2 copper layers, 74.9 x 55.9 mm, 55 parts (0 on the bottom side), 38 nets.
