EOSCogniton/ELIZ-2021/EL_Electrical/Autre/Shutdown_circuit/AMS/AMS_TNN_V1.0.brd

## EAGLE design EL_Electrical/Autre/Shutdown_circuit/AMS/AMS_TNN_V1.0.brd (2021-12-28)

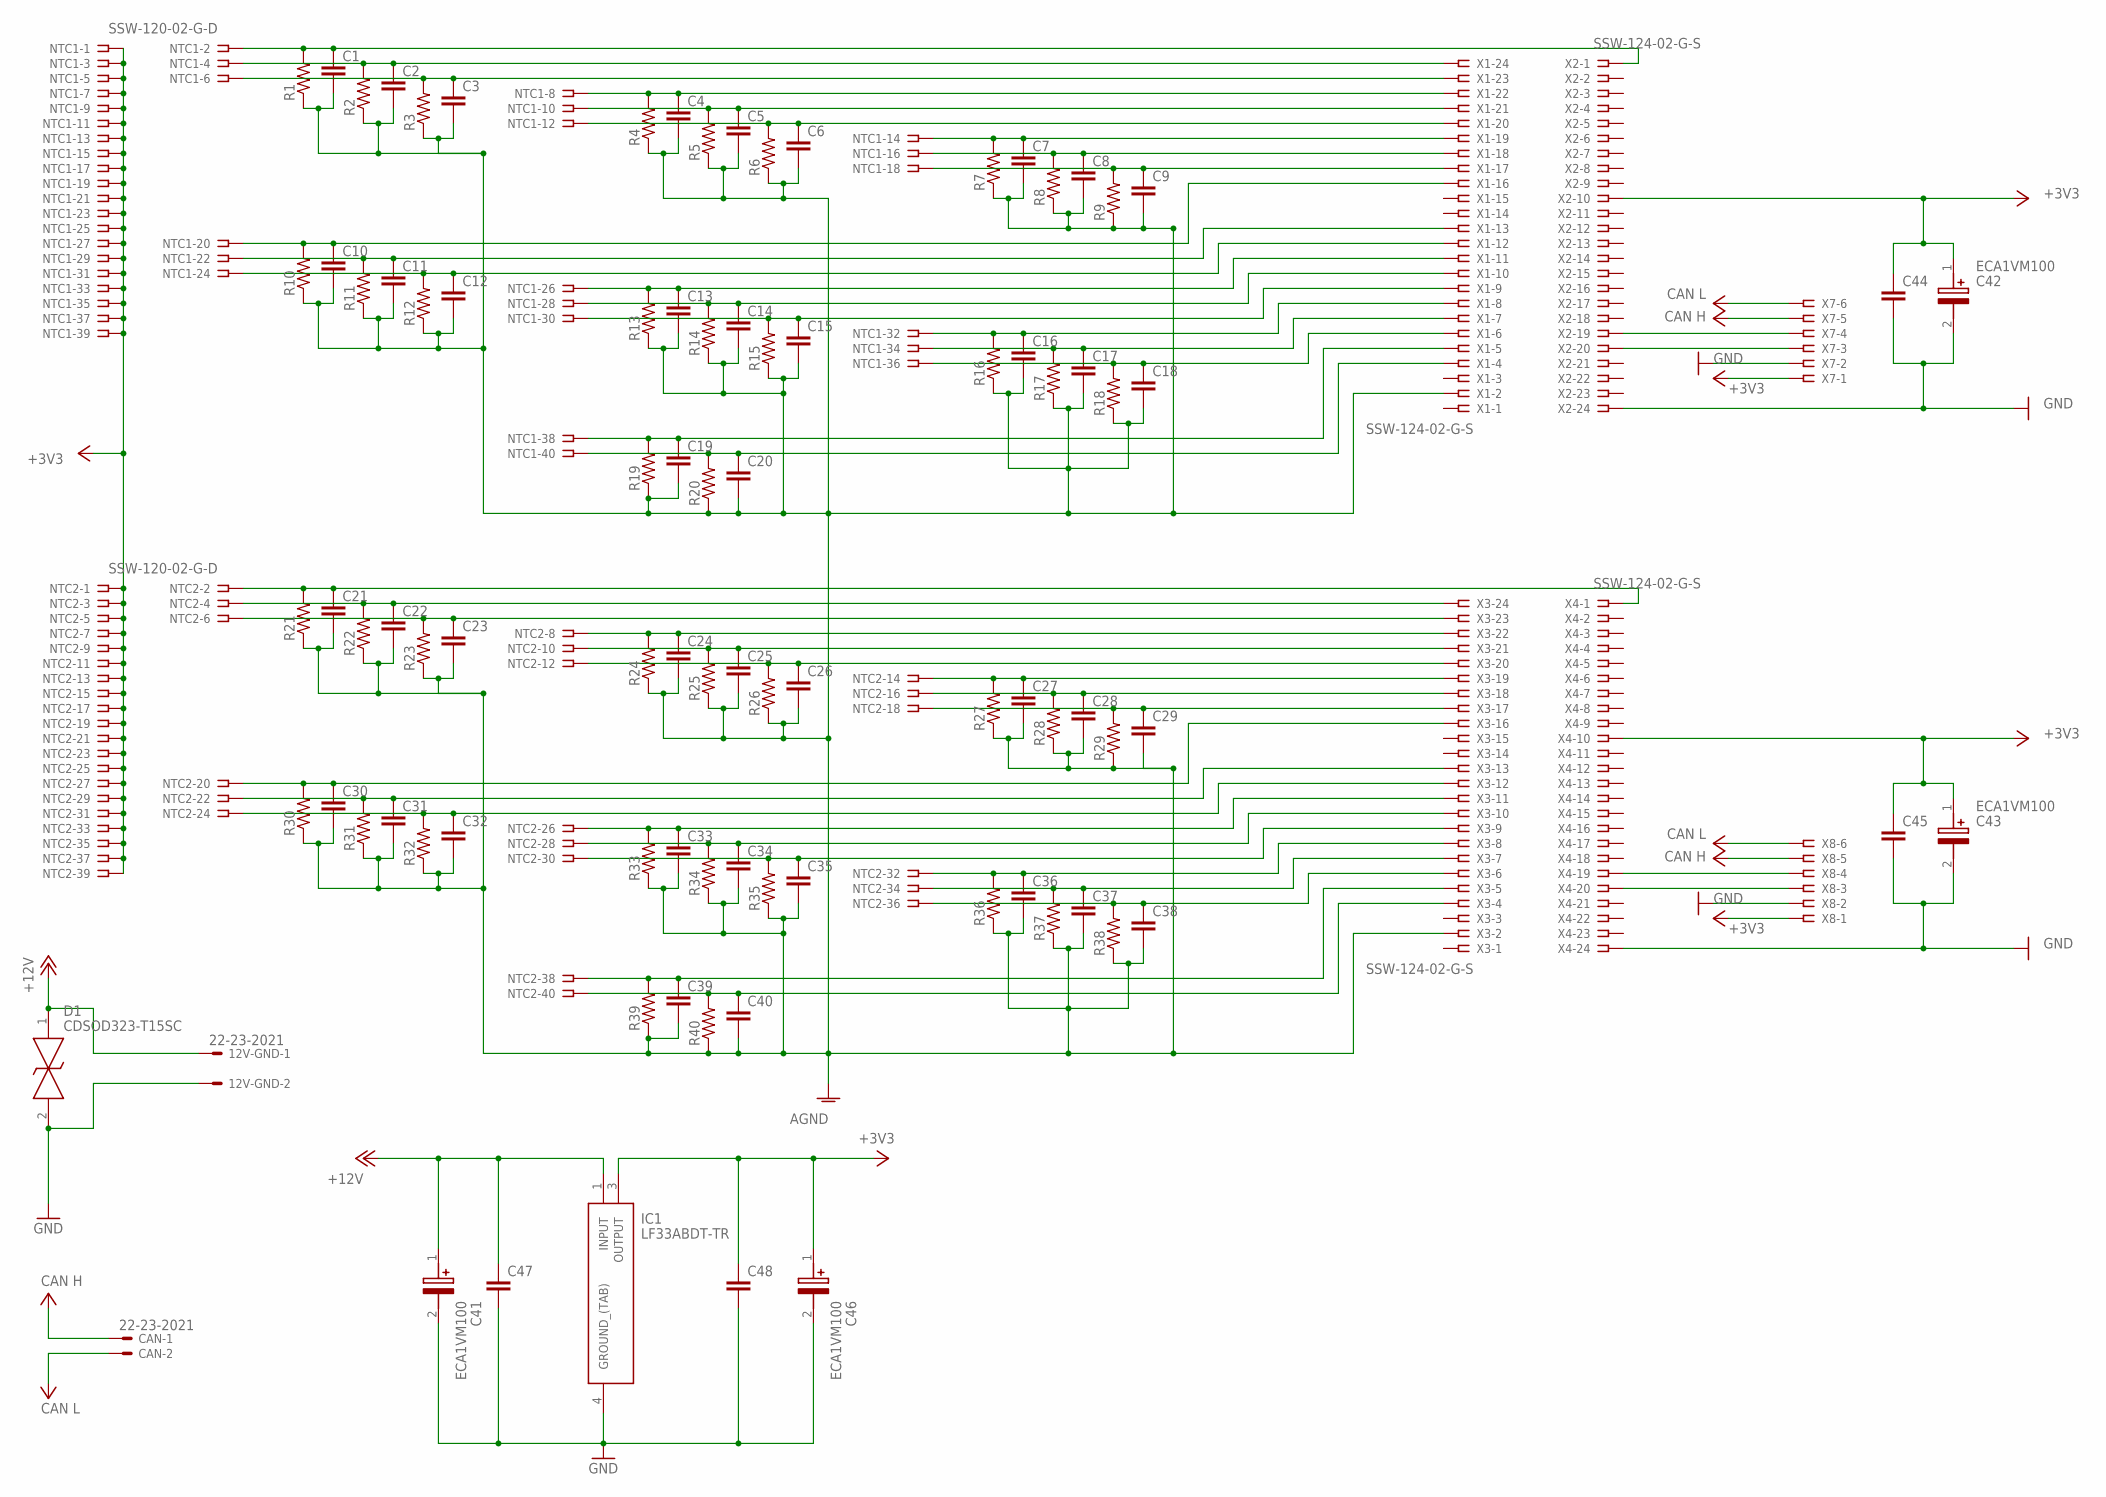
[picture p686: schematic AMS_TNN_V1.0.sch]

Parts:
12V-GND: 22-23-2021
C1, C2, C3, C4, C5, C6, C7, C8, C9, C10, C11, C12, C13, C14, C15, C16, C17, C18, C19, C20, C21, C22, C23, C24, C25, C26, C27, C28, C29, C30, C31, C32, C33, C34, C35, C36, C37, C38, C39, C40, C44, C45, C47, C48: C-EUC0603; C0603
C41, C42, C43, C46: ECA1VM100; CAPPRD200W55D525H1200
CAN: 22-23-2021
D1: CDSOD323-T15SC; SOD-323
IC1: LF33ABDT-TR; TO228P972X240-3N
NTC1, NTC2: SSW-120-02-G-D
R1, R2, R3, R4, R5, R6, R7, R8, R9, R10, R11, R12, R13, R14, R15, R16, R17, R18, R19, R20, R21, R22, R23, R24, R25, R26, R27, R28, R29, R30, R31, R32, R33, R34, R35, R36, R37, R38, R39, R40: R-US_R0603; R0603
X1, X2, X3, X4: SSW-124-02-G-S
X7, X8: SSW-106-02-G-S

Connections:
+3V3: C42.1 (+), C43.1 (+), C44.1, C45.1, C46.1 (+), C48.1, IC1.3 (OUTPUT), NTC1.1, NTC1.3, NTC1.5, NTC1.7, NTC1.9, NTC1.11, NTC1.13, NTC1.15, NTC1.17, NTC1.19, NTC1.21, NTC1.23, NTC1.25, NTC1.27, NTC1.29, NTC1.31, NTC1.33, NTC1.35, NTC1.37, NTC1.39, NTC2.1, NTC2.3, NTC2.5, NTC2.7, NTC2.9, NTC2.11, NTC2.13, NTC2.15, NTC2.17, NTC2.19, NTC2.21, NTC2.23, NTC2.25, NTC2.27, NTC2.29, NTC2.31, NTC2.33, NTC2.35, NTC2.37, NTC2.39, X2.10, X4.10, X7.1, X8.1
+12V: 12V-GND.1, C41.1 (+), C47.1, D1.1, IC1.1 (INPUT)
AGND: C1.2, C2.2, C3.2, C4.2, C5.2, C6.2, C7.2, C8.2, C9.2, C10.2, C11.2, C12.2, C13.2, C14.2, C15.2, C16.2, C17.2, C18.2, C19.2, C20.2, C21.2, C22.2, C23.2, C24.2, C25.2, C26.2, C27.2, C28.2, C29.2, C30.2, C31.2, C32.2, C33.2, C34.2, C35.2, C36.2, C37.2, C38.2, C39.2, C40.2, R1.1, R2.1, R3.1, R4.1, R5.1, R6.1, R7.1, R8.1, R9.1, R10.1, R11.1, R12.1, R13.1, R14.1, R15.1, R16.1, R17.1, R18.1, R19.1, R20.1, R21.1, R22.1, R23.1, R24.1, R25.1, R26.1, R27.1, R28.1, R29.1, R30.1, R31.1, R32.1, R33.1, R34.1, R35.1, R36.1, R37.1, R38.1, R39.1, R40.1, X1.2, X3.2
GND: 12V-GND.2, C41.2 (-), C42.2 (-), C43.2 (-), C44.2, C45.2, C46.2 (-), C47.2, C48.2, D1.2, IC1.4 (GROUND_(TAB)), X2.24, X4.24, X7.2, X8.2
unnamed: C1.1, NTC1.2, R1.2, X2.1
unnamed: C2.1, NTC1.4, R2.2, X1.24
unnamed: C3.1, NTC1.6, R3.2, X1.23
unnamed: C4.1, NTC1.8, R4.2, X1.22
unnamed: C5.1, NTC1.10, R5.2, X1.21
unnamed: C6.1, NTC1.12, R6.2, X1.20
unnamed: C7.1, NTC1.14, R7.2, X1.19
unnamed: C8.1, NTC1.16, R8.2, X1.18
unnamed: C9.1, NTC1.18, R9.2, X1.17
unnamed: C10.1, NTC1.20, R10.2, X1.16
unnamed: C11.1, NTC1.22, R11.2, X1.13
unnamed: C12.1, NTC1.24, R12.2, X1.12
unnamed: C13.1, NTC1.26, R13.2, X1.11
unnamed: C14.1, NTC1.28, R14.2, X1.10
unnamed: C15.1, NTC1.30, R15.2, X1.9
unnamed: C18.1, NTC1.36, R18.2, X1.6
unnamed: C16.1, NTC1.32, R16.2, X1.8
unnamed: C17.1, NTC1.34, R17.2, X1.7
unnamed: C21.1, NTC2.2, R21.2, X4.1
unnamed: C20.1, NTC1.40, R20.2, X1.4
unnamed: C22.1, NTC2.4, R22.2, X3.24
unnamed: C23.1, NTC2.6, R23.2, X3.23
unnamed: C24.1, NTC2.8, R24.2, X3.22
unnamed: C25.1, NTC2.10, R25.2, X3.21
unnamed: C26.1, NTC2.12, R26.2, X3.20
unnamed: C27.1, NTC2.14, R27.2, X3.19
unnamed: C28.1, NTC2.16, R28.2, X3.18
unnamed: C29.1, NTC2.18, R29.2, X3.17
unnamed: C30.1, NTC2.20, R30.2, X3.16
unnamed: C31.1, NTC2.22, R31.2, X3.13
unnamed: C32.1, NTC2.24, R32.2, X3.12
unnamed: C33.1, NTC2.26, R33.2, X3.11
unnamed: C34.1, NTC2.28, R34.2, X3.10
unnamed: C35.1, NTC2.30, R35.2, X3.9
unnamed: C36.1, NTC2.32, R36.2, X3.8
unnamed: C37.1, NTC2.34, R37.2, X3.7
unnamed: C38.1, NTC2.36, R38.2, X3.6
unnamed: C40.1, NTC2.40, R40.2, X3.4
unnamed: C39.1, NTC2.38, R39.2, X3.5
unnamed: X2.20, X7.3
unnamed: X2.19, X7.4
unnamed: X4.20, X8.3
unnamed: X4.19, X8.4
unnamed: C19.1, NTC1.38, R19.2, X1.5
V+: CAN.1, X7.5, X8.5
V-: CAN.2, X7.6, X8.6

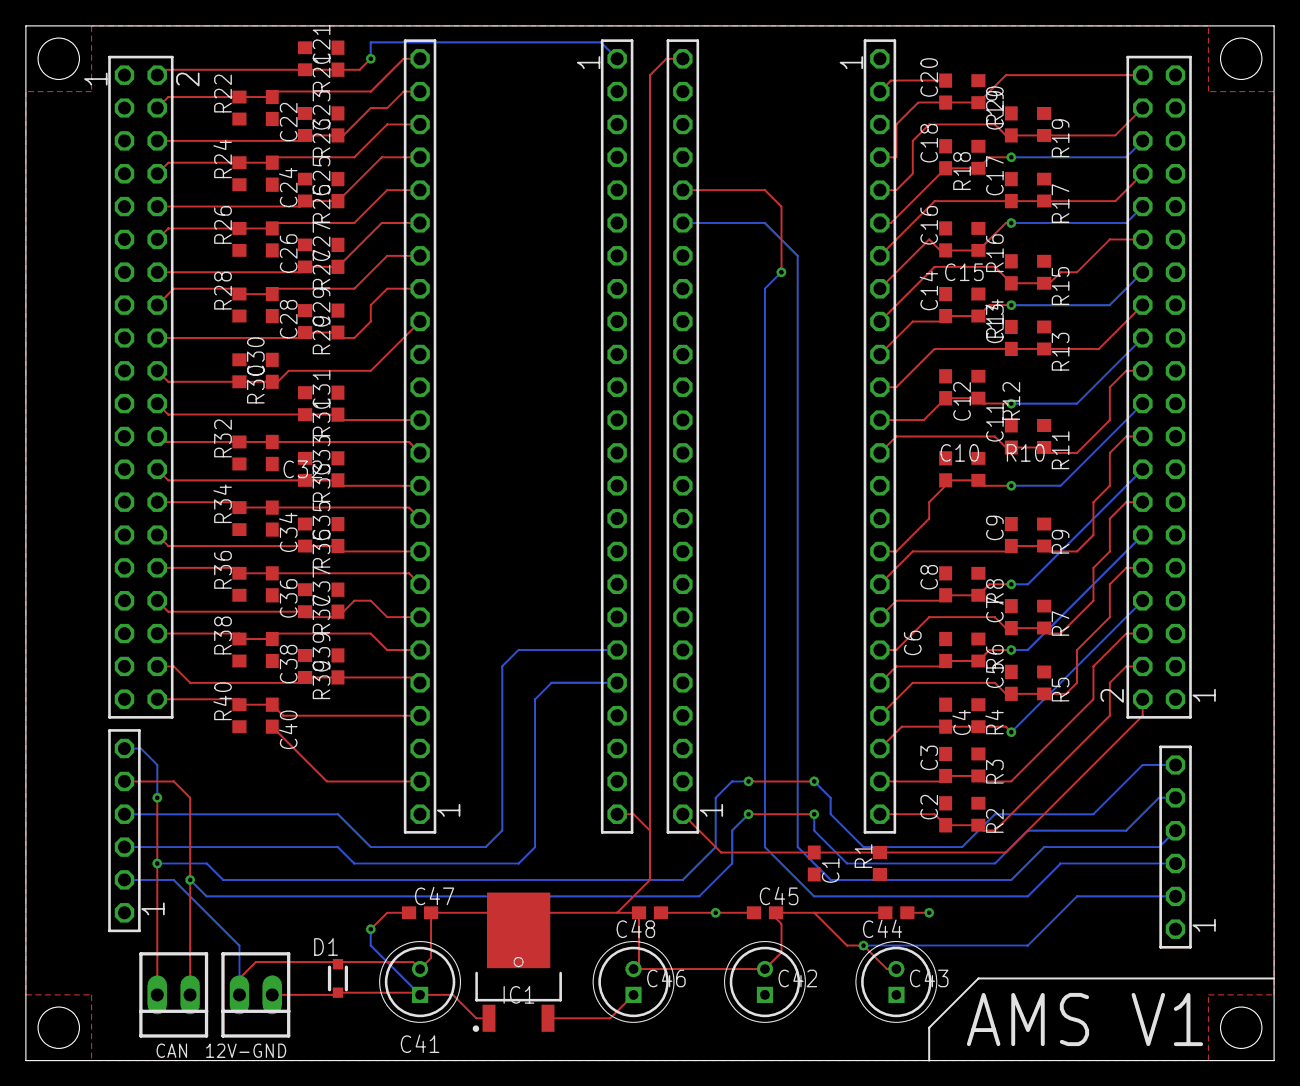
[picture p687: board AMS_TNN_V1.0.brd from above]

Board: 2 copper layers, 96.5 x 80.0 mm, 100 parts (0 on the bottom side), 50 nets.
