EOSCogniton/ELIZ-2021/EL_Electrical/Autre/Vehicule Control Unit/BusCAN to serial TTL/Convertisseur_BusCAN_vers_serial_TTL_TNN_V1.0.brd

## EAGLE design EL_Electrical/Autre/Vehicule Control Unit/BusCAN to serial TTL/Convertisseur_BusCAN_vers_serial_TTL_TNN_V1.0.brd (2021-12-28)

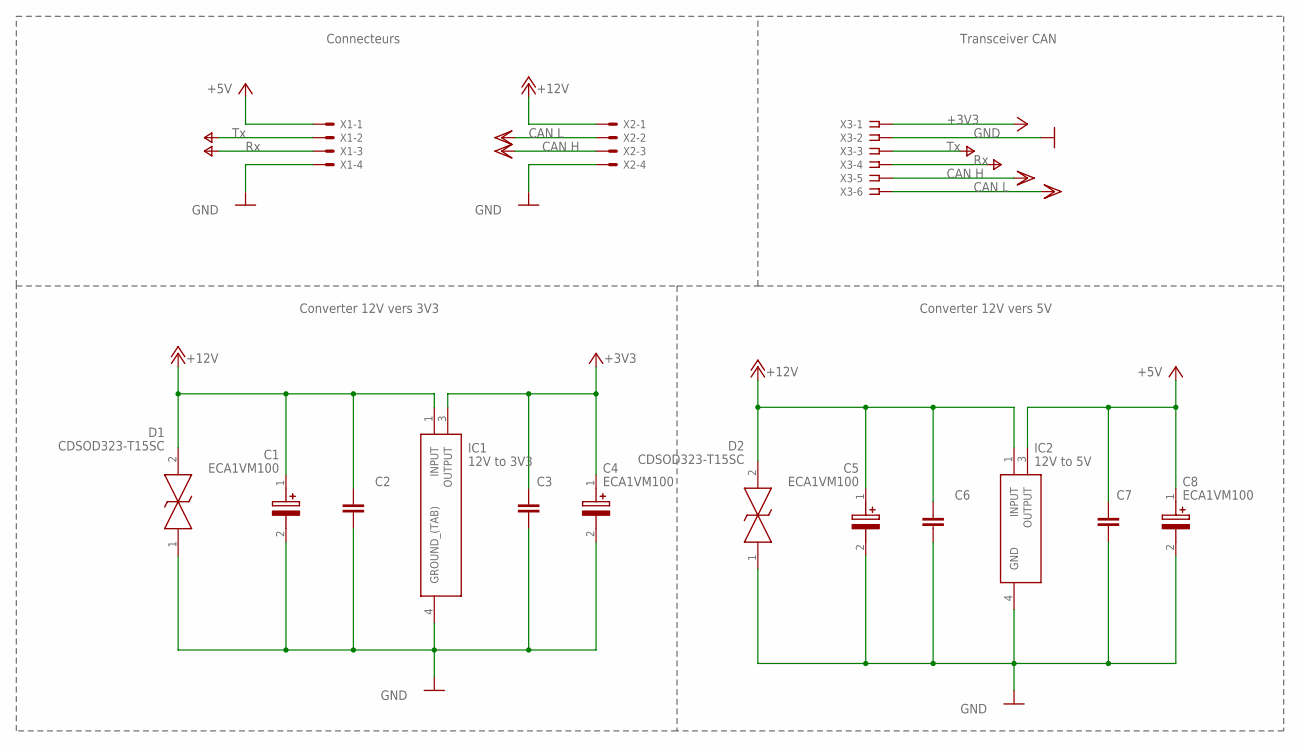
[picture p688: schematic Convertisseur_BusCAN_vers_serial_TTL_TNN_V1.0.sch]

Parts:
C1, C4, C5, C8: ECA1VM100; CAPPRD200W55D525H1200
C2, C3, C6, C7: C-EUC0603; C0603
D1, D2: CDSOD323-T15SC; SOD-323
IC1: 12V to 3V3; TO228P972X240-3N
IC2: 12V to 5V; TO228P972X240-3N
X1, X2: KK-156-4
X3: SSW-106-02-G-S

Connections:
+3V3: C3.1, C4.1 (+), IC1.3 (OUTPUT), X3.1
+5V: C7.1, C8.1 (+), IC2.3 (OUTPUT), X1.1
+12V: C1.1 (+), C2.1, C5.1 (+), C6.1, D1.2, D2.2, IC1.1 (INPUT), IC2.1 (INPUT), X2.1
CANH: X2.3, X3.5
CANL: X2.2, X3.6
GND: C1.2 (-), C2.2, C3.2, C4.2 (-), C5.2 (-), C6.2, C7.2, C8.2 (-), D1.1, D2.1, IC1.4 (GROUND_(TAB)), IC2.4 (GND), X1.4, X2.4, X3.2
RX: X1.3, X3.4
TX: X1.2, X3.3

Notes on the sheet:
Converter 12V vers 3V3
Converter 12V vers 5V
Transceiver CAN
Connecteurs

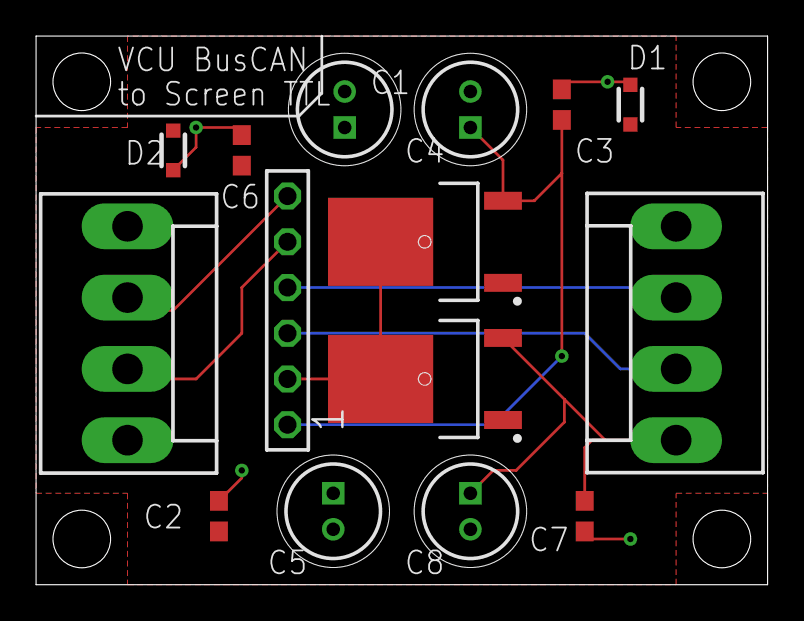
[picture p689: board Convertisseur_BusCAN_vers_serial_TTL_TNN_V1.0.brd from above]

Board: 2 copper layers, 40.6 x 30.5 mm, 15 parts (0 on the bottom side), 8 nets.
