EOSCogniton/ELIZ-2021/EL_Electrical/Autre/Shutdown_circuit/BSPD/BSPD_TNN_V1.0.brd

## EAGLE design EL_Electrical/Autre/Shutdown_circuit/BSPD/BSPD_TNN_V1.0.brd (2021-12-28)

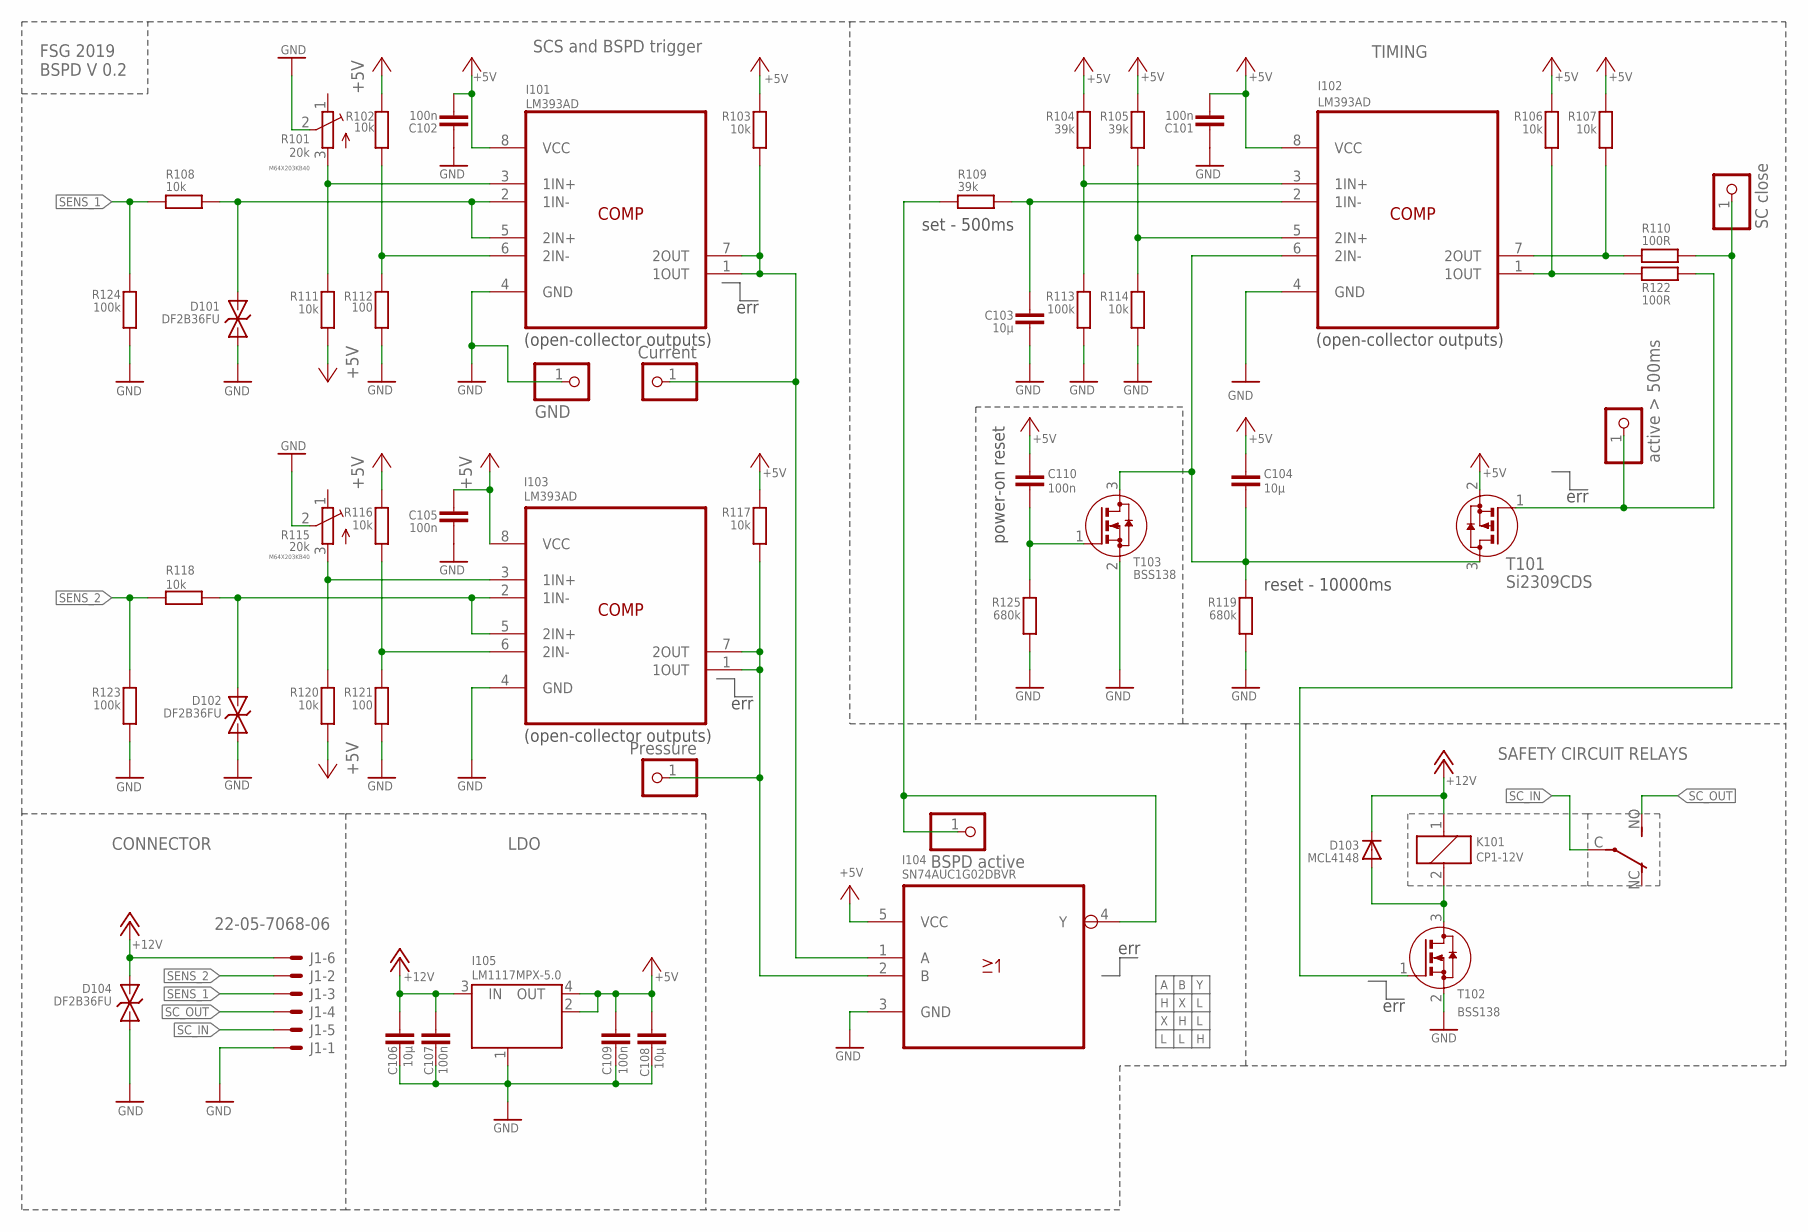
[picture p690: schematic BSPD_TNN_V1.0.sch]

Parts:
C101, C102, C105, C107, C109, C110: 100n; C0603
C103, C106, C108: 10µ; C1206
C104: 10µ; C1206K
D101, D102, D104: DF2B36FU; SOD323
D103: MCL4148; MICROMELF
I101, I102, I103: LM393AD; SOIC127P600X175-8N
I104: SN74AUC1G02DBVR; SOT95P280X145-5N
I105: LM1117MPX-5.0; LINEAR_SOT223
J1: 22-05-7068-06; 7395-06
JP1: Pressure; 1X01
JP2: Current; 1X01
JP3: BSPD active; 1X01
JP4: active > 500ms; 1X01
JP5: SC close; 1X01
JP6: GND; 1X01
K101: CP1-12V; CP1
R101, R115: 20k; M64X201KB40
R102, R103, R106, R107, R108, R111, R114, R116, R117, R118, R120: 10k; R0603
R104, R105, R109: 39k; R0603
R110, R122: 100R; R0603
R112, R121: 100; R0603
R113, R123, R124: 100k; R0603
R119, R125: 680k; R0603
T101: Si2309CDS; SOT-23
T102, T103: BSS138; SOT-23

Connections:
+5V: C101.2, C102.2, C104.1, C105.2, C108.1, C109.2, C110.1, I101.8 (VCC), I102.8 (VCC), I103.8 (VCC), I104.5 (VCC), I105.2 (OUT), I105.4 (OUT), R102.1, R103.1, R104.2, R105.2, R106.2, R107.2, R111.2, R116.1, R117.1, R120.2, T101.2 (S)
+12V: C106.1, C107.1, D103.C, D104.2 (C), I105.3 (IN), J1.6, K101.1
BRAKE_F: D101.2 (C), I101.2 (1IN-), I101.5 (2IN+), R108.2
DF: D102.2 (C), I103.2 (1IN-), I103.5 (2IN+), R118.2
GND: C101.1, C102.1, C103.2, C105.1, C106.2, C107.2, C108.2, C109.1, D101.1 (A), D102.1 (A), D104.1 (A), I101.4 (GND), I102.4 (GND), I103.4 (GND), I104.3 (GND), I105.1 (GND/ADJ), J1.1, JP6.1, R101.2 (M), R112.2, R113.1, R114.1, R115.2 (M), R119.1, R121.2, R123.1, R124.1, R125.1, T102.2 (S), T103.2 (S)
unnamed: I102.5 (2IN+), R105.1, R114.2
unnamed: I103.1 (1OUT), I103.7 (2OUT), I104.2 (B), JP1.1, R117.2
unnamed: I101.1 (1OUT), I101.7 (2OUT), I104.1 (A), JP2.1, R103.2
unnamed: I102.1 (1OUT), R106.1, R122.2
unnamed: C110.2, R125.2, T103.1 (G)
unnamed: I101.3 (1IN+), R101.3 (A), R111.1
unnamed: C104.2, I102.6 (2IN-), R119.2, T101.3 (D), T103.3 (D)
unnamed: I103.3 (1IN+), R115.3 (A), R120.1
unnamed: JP5.1, R110.1, T102.1 (G)
unnamed: D103.A, K101.2, T102.3 (D)
unnamed: C103.1, I102.2 (1IN-), R109.1
unnamed: I102.3 (1IN+), R104.1, R113.2
unnamed: I101.6 (2IN-), R102.2, R112.1
unnamed: I102.7 (2OUT), R107.1, R110.2
unnamed: I103.6 (2IN-), R116.2, R121.1
unnamed: JP4.1, R122.1, T101.1 (G)
unnamed: I104.4 (Y), JP3.1, R109.2
SC_IN: J1.5, K101.C
SC_OUT: J1.4, K101.NO (S)
SENS_1: J1.3, R108.1, R124.2
SENS_2: J1.2, R118.1, R123.2

Notes on the sheet:
COMP
M64X203KB40
FSG 2019 BSPD V 0.2
CONNECTOR
LDO
SAFETY CIRCUIT RELAYS
err
TIMING
SCS and BSPD trigger
power-on reset
set - 500ms
reset - 10000ms
(open-collector outputs)

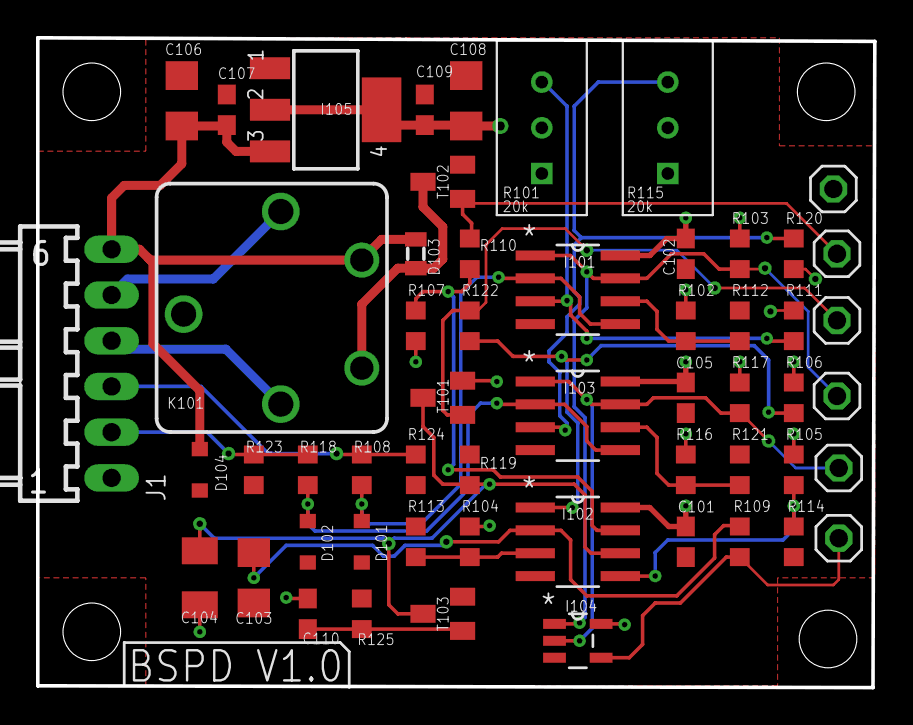
[picture p691: board BSPD_TNN_V1.0.brd from above]

Board: 2 copper layers, 46.5 x 36.1 mm, 55 parts (0 on the bottom side), 26 nets.
