EOSCogniton/ELIZ-2021/EL_Electrical/Autre/Shutdown_circuit/AMS & IMD SC logic/Shutdown_circuit_logic_TNN_V1.0.brd

## EAGLE design EL_Electrical/Autre/Shutdown_circuit/AMS & IMD SC logic/Shutdown_circuit_logic_TNN_V1.0.brd (2021-12-28)

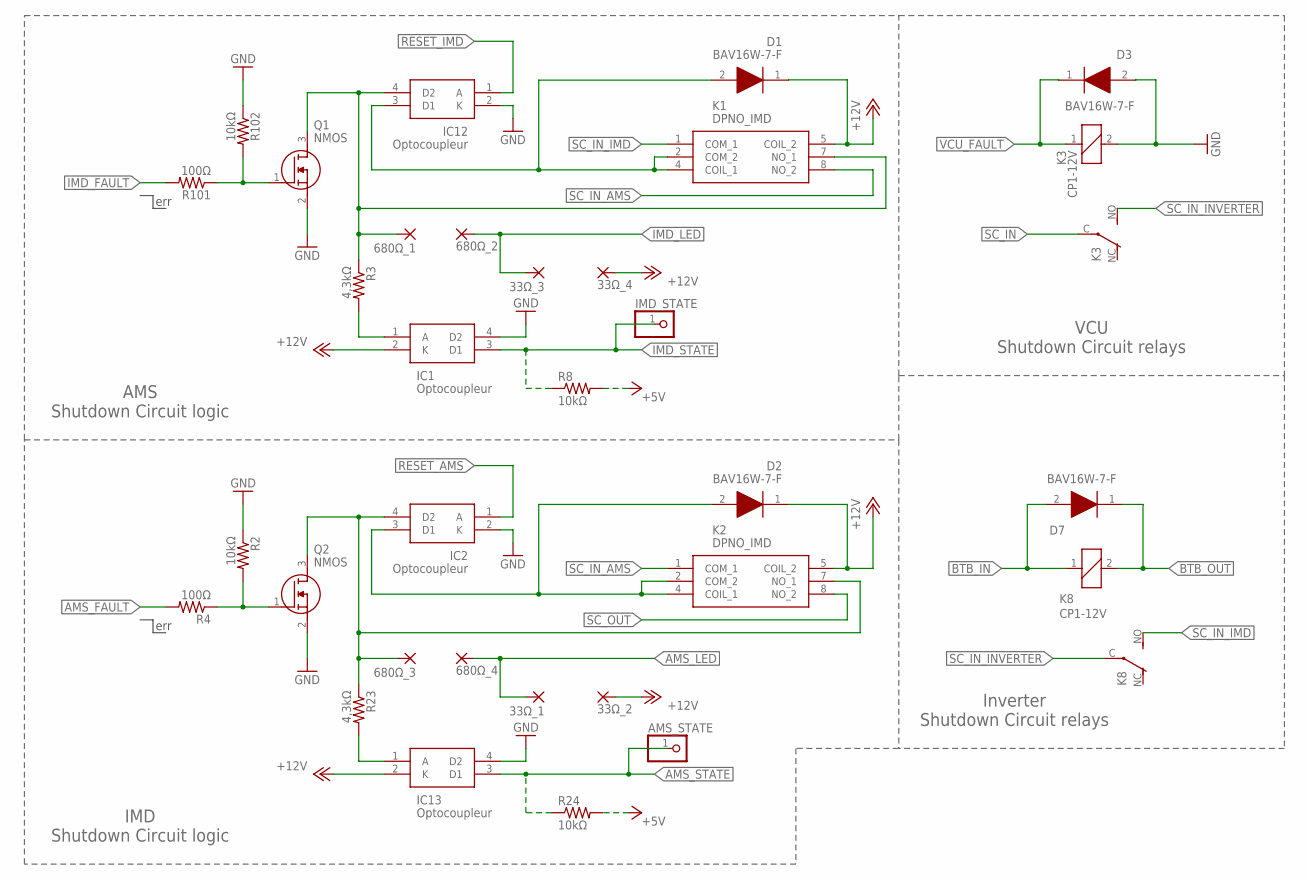
[picture p692: schematic Shutdown_circuit_logic_TNN_V1.0.sch, sheet 1]

Parts:
33Ω_1, 33Ω_2, 33Ω_3, 33Ω_4, 680Ω_1, 680Ω_2, 680Ω_3, 680Ω_4: 1,6/0,8
AMS_STATE: PINHD-1X1; 1X01
D1, D2, D3, D7: BAV16W-7-F; SOD3716X145N
IC1, IC2, IC12, IC13: Optocoupleur; SOP254P680X230-4N
IMD_STATE: PINHD-1X1; 1X01
K1, K2: DPNO_IMD; AHES3292
K3, K8: CP1-12V; CP1
Q1, Q2: NMOS; SOT96P240X110-3N
R2, R8, R24, R102: 10kΩ; R0603
R3, R23: 4,3kΩ; R0603
R4, R101: 100Ω; R0603

Connections:
+5V: R8.2, R24.2; also elsewhere on the board
+12V: 33Ω_2.1, 33Ω_4.1, D1.1 (K), D2.1 (K), IC1.2 (K), IC13.2 (K), K1.5 (COIL_2), K2.5 (COIL_2); also elsewhere on the board
AMS_FAULT: R4.2; also elsewhere on the board
AMS_LED: 33Ω_1.1, 680Ω_4.1; also elsewhere on the board
AMS_STATE: AMS_STATE.1, IC13.3 (D1), R24.1; also elsewhere on the board
BTB_IN: D7.2 (A), K8.1; also elsewhere on the board
BTB_OUT: D7.1 (K), K8.2; also elsewhere on the board
GND: D3.2 (A), IC1.4 (D2), IC2.2 (K), IC12.2 (K), IC13.4 (D2), K3.2, Q1.2 (S), Q2.2 (S), R2.1, R102.1; also elsewhere on the board
IMD_FAULT: R101.2; also elsewhere on the board
IMD_LED: 33Ω_3.1, 680Ω_2.1; also elsewhere on the board
IMD_STATE: IC1.3 (D1), IMD_STATE.1, R8.1; also elsewhere on the board
unnamed: Q2.1 (G), R2.2, R4.1
unnamed: Q1.1 (G), R101.1, R102.2
unnamed: 680Ω_3.1, IC2.4 (D2), K2.7 (NO_1), Q2.3 (D), R23.1
unnamed: IC1.1 (A), R3.2
unnamed: 680Ω_1.1, IC12.4 (D2), K1.7 (NO_1), Q1.3 (D), R3.1
unnamed: D2.2 (A), IC2.3 (D1), K2.2 (COM_2), K2.4 (COIL_1)
unnamed: IC13.1 (A), R23.2
unnamed: D1.2 (A), IC12.3 (D1), K1.2 (COM_2), K1.4 (COIL_1)
RESET_AMS: IC2.1 (A); also elsewhere on the board
RESET_IMD: IC12.1 (A); also elsewhere on the board
SC_IN: K3.C; also elsewhere on the board
SC_IN_AMS: K1.8 (NO_2), K2.1 (COM_1)
SC_IN_IMD: K1.1 (COM_1), K8.NO (S)
SC_IN_INVERTER: K3.NO (S), K8.C
SC_OUT: K2.8 (NO_2); also elsewhere on the board
VCU_FAULT: D3.1 (K), K3.1; also elsewhere on the board

Notes on the sheet:
err
AMS Shutdown Circuit logic
IMD Shutdown Circuit logic
VCU Shutdown Circuit relays
Inverter Shutdown Circuit relays

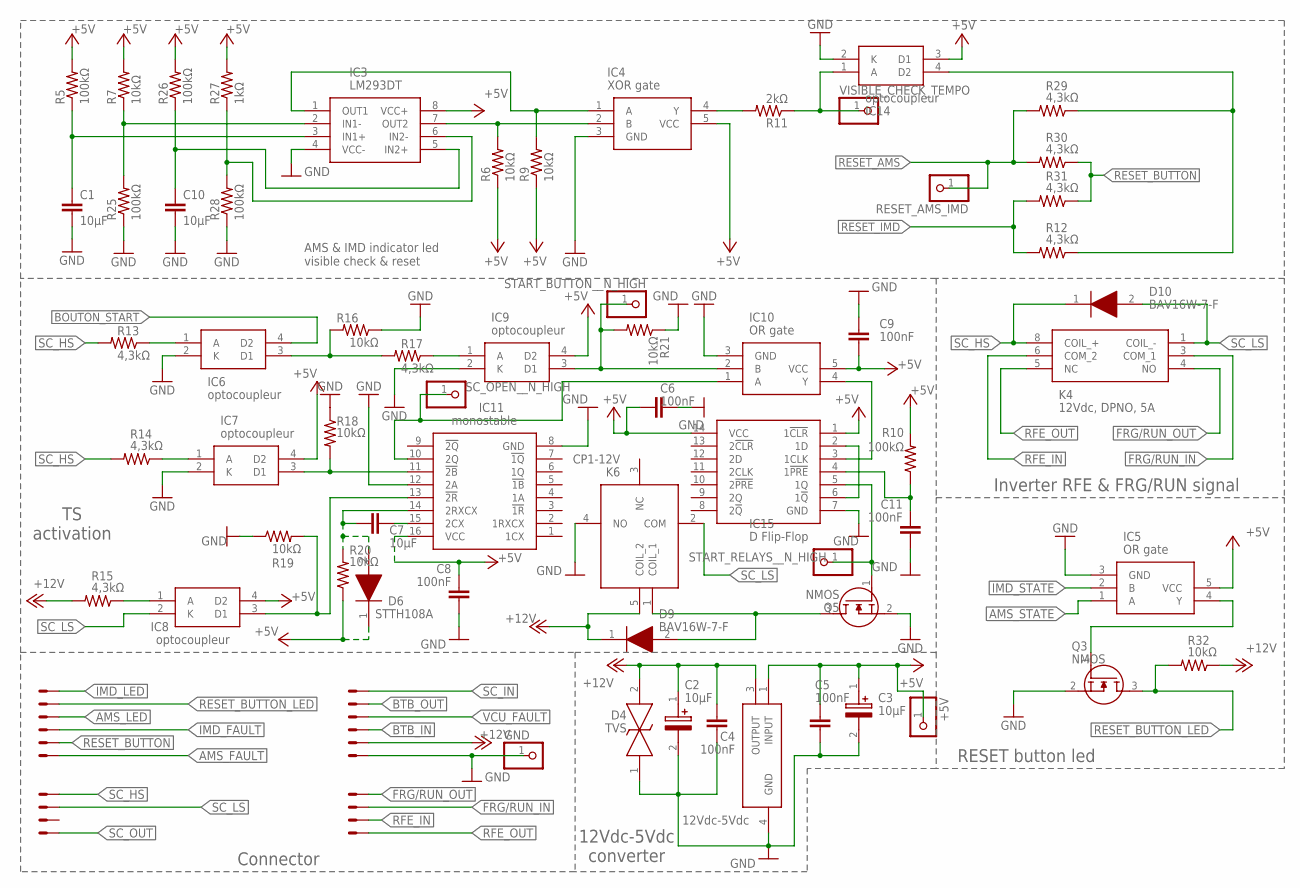
[picture p693: schematic Shutdown_circuit_logic_TNN_V1.0.sch, sheet 2]

Parts:
+5V: PINHD-1X1; 1X01
C1, C7, C10: 10μF; C0603
C2, C3: 10μF; CAPPRD200W55D525H1200
C4, C5, C6, C8, C9, C11: 100nF; C0603
CONVERTER: 12Vdc-5Vdc; TO228P972X240-3N
D4: TVS; SOD-323
D6: STTH108A; DIOM5126X265N
D9, D10: BAV16W-7-F; SOD3716X145N
GND: PINHD-1X1; 1X01
IC3: LM293DT; SOIC127P600X175-8N
IC4: XOR gate; SOT65P210X110-5N
IC5, IC10: OR gate; SOT95P280X145-5N
IC6, IC7, IC8, IC9, IC14: optocoupleur; SOP254P680X230-4N
IC11: monostable; SOIC127P600X175-16N
IC15: D Flip-Flop; SOIC127P600X175-14N
K4: 12Vdc, DPNO, 5A; G6B2214PUS12DC
K6: CP1-12V; CP1FORMC_1
Q3, Q5: NMOS; SOT96P240X110-3N
R5, R10, R25, R26, R28: 100kΩ; R0603
R6, R7, R9, R16, R18, R19, R20, R21, R32: 10kΩ; R0603
R11: 2kΩ; R0603
R12, R13, R14, R15, R17, R29, R30, R31: 4,3kΩ; R0603
R27: 1kΩ; R0603
RESET_AMS_IMD: PINHD-1X1; 1X01
SC_OPEN__N_HIGH: PINHD-1X1; 1X01
START_BUTTON__N_HIGH: PINHD-1X1; 1X01
START_RELAYS__N_HIGH: PINHD-1X1; 1X01
VISIBLE_CHECK_TEMPO: PINHD-1X1; 1X01
X1, X2: 22-23-2041
X3, X4: 22-23-2061

Connections:
+5V: +5V.1, C3.1 (+), C5.1, C6.2, C8.2, C9.2, CONVERTER.1 (INPUT), D6.1 (K), IC3.8 (VCC+), IC4.5 (VCC), IC5.5 (VCC), IC7.4 (D2), IC8.4 (D2), IC9.4 (D2), IC10.5 (VCC), IC11.16 (VCC), IC14.3 (D1), IC15.1 (1!CLR), IC15.14 (VCC), R5.2, R6.1, R7.2, R9.1, R10.2, R20.1, R26.2, R27.2; also elsewhere on the board
+12V: C2.1 (+), C4.1, CONVERTER.3 (OUTPUT), D4.2, D9.1 (K), K6.5 (COIL_2), R15.2, R32.1, X4.2; also elsewhere on the board
AMS_FAULT: X3.1; also elsewhere on the board
AMS_LED: X3.4; also elsewhere on the board
AMS_STATE: IC5.1 (A); also elsewhere on the board
BOUTON_START: IC6.4 (D2)
BTB_IN: X4.3; also elsewhere on the board
BTB_OUT: X4.5; also elsewhere on the board
FRG/RUN_IN: K4.3 (COM_1), X2.3
FRG/RUN_OUT: K4.4 (NO), X2.4
GND: C1.2, C2.2 (-), C3.2 (-), C4.2, C5.2, C6.1, C8.1, C9.1, C10.2, C11.1, CONVERTER.4 (GND), D4.1, GND.1, IC3.4 (VCC-), IC4.3 (GND), IC5.3 (GND), IC6.2 (K), IC7.2 (K), IC9.2 (K), IC10.3 (GND), IC11.8 (GND), IC11.12 (2A), IC14.2 (K), IC15.7 (GND), K6.4 (NO), Q3.2 (S), Q5.2 (S), R16.1, R18.1, R19.1, R21.1, R25.1, R28.1, X4.1; also elsewhere on the board
IMD_FAULT: X3.3; also elsewhere on the board
IMD_LED: X3.6; also elsewhere on the board
IMD_STATE: IC5.2 (B); also elsewhere on the board
unnamed: C1.1, IC3.3 (IN1+), R5.1
unnamed: IC3.2 (IN1-), R7.1, R25.2
unnamed: IC6.1 (A), R13.1
unnamed: C10.1, IC3.5 (IN2+), R26.1
unnamed: IC6.3 (D1), R16.2, R17.2
unnamed: IC10.1 (A), IC11.10 (2Q), SC_OPEN__N_HIGH.1
unnamed: C7.2, D6.2 (A), IC11.14 (2RXCX), R20.2
unnamed: IC7.1 (A), R14.1
unnamed: IC7.3 (D1), IC11.11 (!2B), R18.2
unnamed: IC8.1 (A), R15.1
unnamed: IC8.3 (D1), IC11.13 (!2R), R19.2
unnamed: IC9.1 (A), R17.1
unnamed: IC9.3 (D1), IC10.2 (B), R21.2, START_BUTTON__N_HIGH.1
unnamed: IC15.5 (1Q), Q5.1 (G), START_RELAYS__N_HIGH.1
unnamed: IC5.4 (Y), Q3.1 (G)
unnamed: IC10.4 (Y), IC15.3 (1CLK)
unnamed: IC3.6 (IN2-), R27.1, R28.2
unnamed: IC3.1 (OUT1), IC4.1 (A), R9.2
unnamed: IC3.7 (OUT2), IC4.2 (B), R6.2
unnamed: IC14.1 (A), R11.1, VISIBLE_CHECK_TEMPO.1
unnamed: IC14.4 (D2), R12.1, R29.1
unnamed: IC4.4 (Y), R11.2
unnamed: C7.1, IC11.15 (2CX)
unnamed: IC15.2 (1D), IC15.6 (1!Q)
unnamed: D9.2 (A), K6.1 (COIL_1), Q5.3 (D)
unnamed: C11.2, IC15.4 (1!PRE), R10.1
RESET_AMS: R29.2, R30.2, RESET_AMS_IMD.1; also elsewhere on the board
RESET_BUTTON: R30.1, R31.1, X3.2
RESET_BUTTON_LED: Q3.3 (D), R32.2, X3.5
RESET_IMD: R12.2, R31.2; also elsewhere on the board
RFE_IN: K4.6 (COM_2), X2.2
RFE_OUT: K4.5 (NC), X2.1
SC_HS: D10.1 (K), K4.8 (COIL_+), R13.2, R14.2, X1.4
SC_IN: X4.6; also elsewhere on the board
SC_LS: D10.2 (A), IC8.2 (K), K4.1 (COIL_-), K6.2 (COM), X1.3
SC_OUT: X1.1; also elsewhere on the board
VCU_FAULT: X4.4; also elsewhere on the board

Notes on the sheet:
AMS & IMD indicator led visible check & reset
TS activation
Connector
12Vdc-5Vdc converter
Inverter RFE & FRG/RUN signal
RESET button led

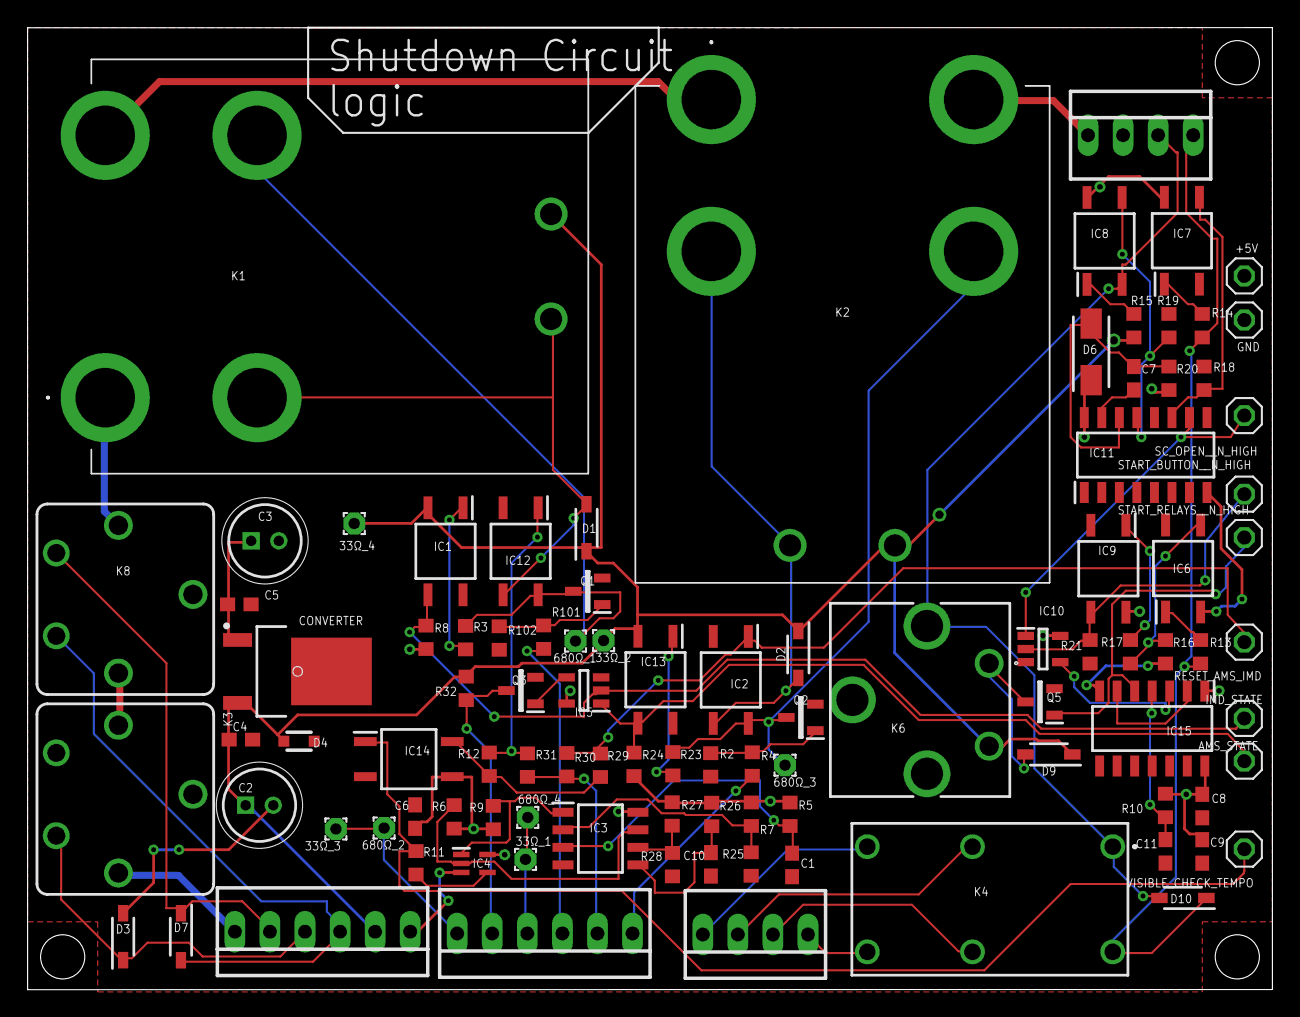
[picture p694: board Shutdown_circuit_logic_TNN_V1.0.brd from above]

Board: 2 copper layers, 90.2 x 69.7 mm, 98 parts (0 on the bottom side), 61 nets.
