EOSCogniton/ELIZ-2021/EL_Electrical/Autre/TSAL/TSAL logic/TSAL_logic_TNN_V1.0.brd

## EAGLE design EL_Electrical/Autre/TSAL/TSAL logic/TSAL_logic_TNN_V1.0.brd (2021-12-28)

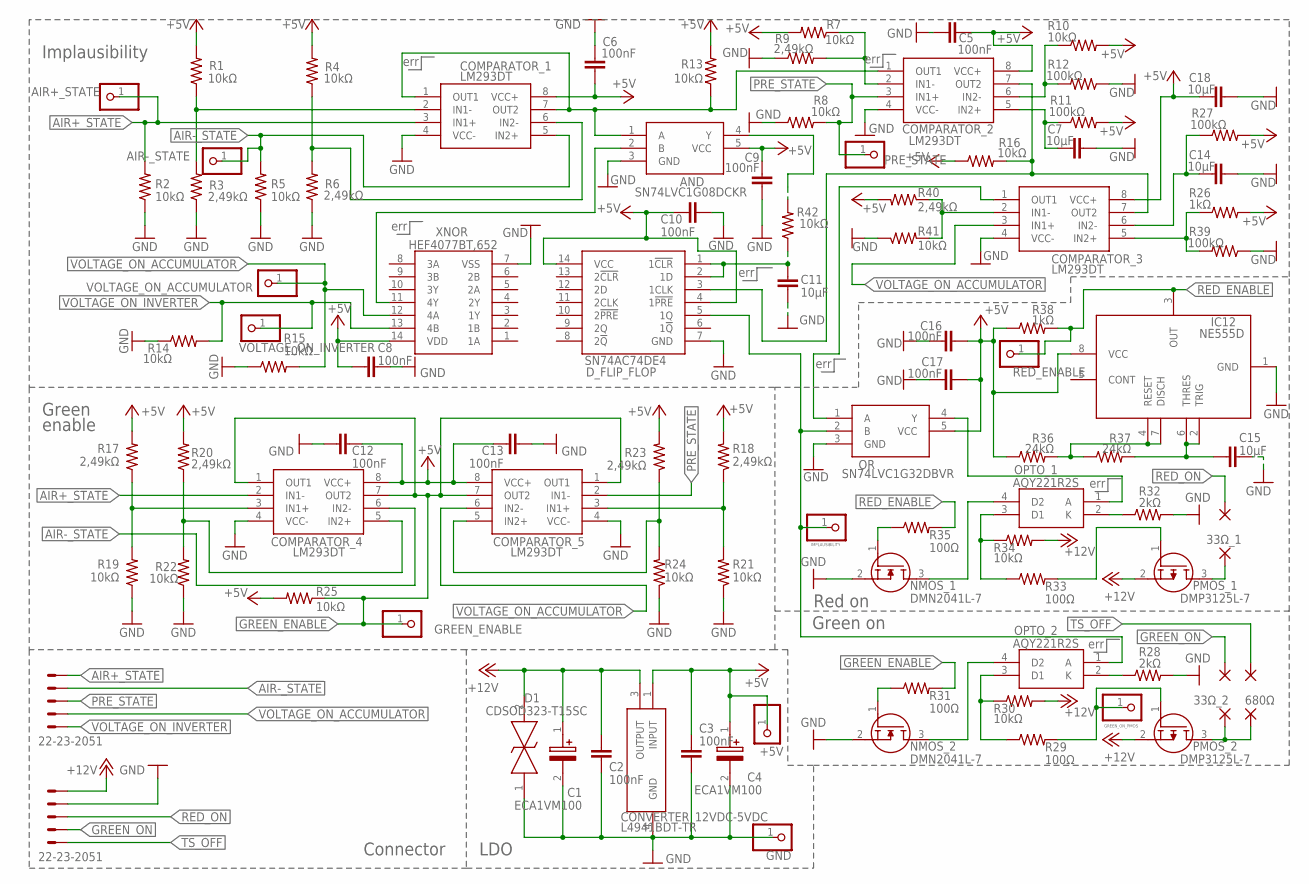
[picture p695: schematic TSAL_logic_TNN_V1.0.sch]

Parts:
33Ω_1, 33Ω_1_, 33Ω_2, 33Ω_2_, 680Ω, 680Ω_: 1,6/0,8
+5V: PINHD-1X1; 1X01
AIR+_STATE: PINHD-1X1; 1X01
AIR-_STATE: PINHD-1X1; 1X01
AND: SN74LVC1G08DCKR; SOT65P210X110-5N
C1, C4: ECA1VM100; CAPPRD200W55D525H1200
C2, C3, C5, C6, C8, C9, C10, C12, C13, C16, C17: 100nF; C0603
C7, C11, C14, C15, C18: 10μF; C0603
COMPARATOR_1, COMPARATOR_2, COMPARATOR_3, COMPARATOR_4, COMPARATOR_5: LM293DT; SOIC127P600X175-8N
CONTACTOR_STATE_AND_VOLTAGE_MEASUREMENT: 22-23-2051
CONVERTER_12VDC-5VDC: L4941BDT-TR; TO228P972X240-3N
D1: CDSOD323-T15SC; SOD-323
D_FLIP_FLOP: SN74AC74DE4; SOIC127P600X175-14N
GND: PINHD-1X1; 1X01
GREEN_ENABLE: PINHD-1X1; 1X01
GREEN_ON_PMOS: PINHD-1X1; 1X01
IC12: NE555D; SOIC127P600X175-8N
IMPLAUSIBILITY: PINHD-1X1; 1X01
NMOS_1, NMOS_2: DMN2041L-7; SOT96P240X110-3N
OPTO_1, OPTO_2: AQY221R2S; SOP254P680X230-4N
OR: SN74LVC1G32DBVR; SOT95P280X145-5N
PMOS_1, PMOS_2: DMP3125L-7; SOT96P240X110-3N
PRE_STATE: PINHD-1X1; 1X01
R1, R2, R4, R5, R7, R8, R10, R13, R14, R15, R16, R19, R21, R22, R24, R25, R30, R34, R41, R42: 10kΩ; R0603
R3, R6, R9, R17, R18, R20, R23, R40: 2,49kΩ; R0603
R11, R12, R27, R39: 100kΩ; R0603
R26, R38: 1kΩ; R0603
R28, R32: 2kΩ; R0603
R29, R31, R33, R35: 100Ω; R0603
R36, R37: 24kΩ; R0603
RED_ENABLE: PINHD-1X1; 1X01
TSAL_LED_AND_POWER: 22-23-2051
VOLTAGE_ON_ACCUMULATOR: PINHD-1X1; 1X01
VOLTAGE_ON_INVERTER: PINHD-1X1; 1X01
XNOR: HEF4077BT,652; SOIC127P600X175-14N

Connections:
+5V: +5V.1, AND.5 (VCC), C3.1, C4.1 (+), C5.2, C6.2, C8.1, C9.1, C10.1, C12.1, C13.1, C16.1, C17.1, C18.1, COMPARATOR_1.8 (VCC+), COMPARATOR_2.8 (VCC+), COMPARATOR_3.8 (VCC+), COMPARATOR_4.8 (VCC+), COMPARATOR_5.8 (VCC+), CONVERTER_12VDC-5VDC.1 (INPUT), D_FLIP_FLOP.4 (1!PRE), D_FLIP_FLOP.14 (VCC), IC12.8 (VCC), OR.5 (VCC), R1.2, R4.2, R7.2, R10.2, R11.2, R13.2, R16.1, R17.2, R18.2, R20.2, R23.2, R25.2, R26.2, R27.2, R36.1, R38.1, R40.2, XNOR.14 (VDD)
+12V: C1.1 (+), C2.1, CONVERTER_12VDC-5VDC.3 (OUTPUT), D1.2, PMOS_1.2 (S), PMOS_2.2 (S), R30.2, R34.2, TSAL_LED_AND_POWER.5
AIR+_STATE: AIR+_STATE.1, COMPARATOR_1.3 (IN1+), COMPARATOR_4.2 (IN1-), CONTACTOR_STATE_AND_VOLTAGE_MEASUREMENT.5, R2.2
AIR-_STATE: AIR-_STATE.1, COMPARATOR_1.5 (IN2+), COMPARATOR_4.6 (IN2-), CONTACTOR_STATE_AND_VOLTAGE_MEASUREMENT.4, R5.2
GND: AND.3 (GND), C1.2 (-), C2.2, C3.2, C4.2 (-), C5.1, C6.1, C7.2, C8.2, C9.2, C10.2, C11.2, C12.2, C13.2, C14.2, C15.2, C16.2, C17.2, C18.2, COMPARATOR_1.4 (VCC-), COMPARATOR_2.4 (VCC-), COMPARATOR_3.4 (VCC-), COMPARATOR_4.4 (VCC-), COMPARATOR_5.4 (VCC-), CONVERTER_12VDC-5VDC.4 (GND), D1.1, D_FLIP_FLOP.7 (GND), GND.1, IC12.1 (GND), NMOS_1.2 (S), NMOS_2.2 (S), OR.3 (GND), R2.1, R3.1, R5.1, R6.1, R8.1, R9.1, R12.1, R14.1, R15.1, R19.1, R21.1, R22.1, R24.1, R28.2, R32.2, R39.1, R41.1, TSAL_LED_AND_POWER.4, XNOR.7 (VSS)
GREEN_ENABLE: COMPARATOR_4.1 (OUT1), COMPARATOR_4.7 (OUT2), COMPARATOR_5.1 (OUT1), COMPARATOR_5.7 (OUT2), GREEN_ENABLE.1, R25.1, R31.2
GREEN_ON: 33Ω_2_.1, TSAL_LED_AND_POWER.2
IMPLAUSIBILITY: D_FLIP_FLOP.5 (1Q), IMPLAUSIBILITY.1, OPTO_2.1 (A), OR.2 (B)
unnamed: COMPARATOR_1.2 (IN1-), R1.1, R3.2
unnamed: AND.1 (A), COMPARATOR_1.1 (OUT1), COMPARATOR_1.7 (OUT2), COMPARATOR_2.1 (OUT1), R13.1
unnamed: COMPARATOR_1.6 (IN2-), R4.1, R6.2
unnamed: COMPARATOR_2.2 (IN1-), R7.1, R9.2
unnamed: COMPARATOR_2.6 (IN2-), R10.1, R12.2
unnamed: C7.1, COMPARATOR_2.5 (IN2+), R11.1
unnamed: COMPARATOR_2.7 (OUT2), COMPARATOR_3.7 (OUT2), D_FLIP_FLOP.3 (1CLK), R16.2
unnamed: AND.2 (B), XNOR.11 (4Y)
unnamed: COMPARATOR_5.5 (IN2+), R23.1, R24.2
unnamed: COMPARATOR_5.3 (IN1+), R18.1, R21.2
unnamed: COMPARATOR_4.3 (IN1+), R17.1, R19.2
unnamed: COMPARATOR_4.5 (IN2+), R20.1, R22.2
unnamed: COMPARATOR_3.5 (IN2+), R26.1, R39.2
unnamed: 33Ω_2.1, 680Ω.1, PMOS_2.3 (D)
unnamed: OPTO_2.2 (K), R28.1
unnamed: 33Ω_1.1, PMOS_1.3 (D)
unnamed: NMOS_2.3 (D), OPTO_2.4 (D2)
unnamed: OPTO_2.3 (D1), R29.1, R30.1
unnamed: GREEN_ON_PMOS.1, PMOS_2.1 (G), R29.2
unnamed: NMOS_2.1 (G), R31.1
unnamed: NMOS_1.3 (D), OPTO_1.4 (D2)
unnamed: OPTO_1.3 (D1), R33.1, R34.1
unnamed: PMOS_1.1 (G), R33.2
unnamed: NMOS_1.1 (G), R35.1
unnamed: OPTO_1.2 (K), R32.1
unnamed: COMPARATOR_3.1 (OUT1), OR.1 (A)
unnamed: OPTO_1.1 (A), OR.4 (Y)
unnamed: C14.1, COMPARATOR_3.6 (IN2-), R27.1
unnamed: C15.1, IC12.2 (TRIG), IC12.6 (THRES), R37.2
unnamed: IC12.4 (RESET), IC12.7 (DISCH), R36.2, R37.1
unnamed: COMPARATOR_3.2 (IN1-), R40.1, R41.2
unnamed: C11.1, D_FLIP_FLOP.1 (1!CLR), D_FLIP_FLOP.2 (1D), R42.1
unnamed: AND.4 (Y), R42.2
PRE_STATE: COMPARATOR_2.3 (IN1+), COMPARATOR_5.2 (IN1-), CONTACTOR_STATE_AND_VOLTAGE_MEASUREMENT.3, PRE_STATE.1, R8.2
RED_ENABLE: IC12.3 (OUT), R35.2, R38.2, RED_ENABLE.1
RED_ON: 33Ω_1_.1, TSAL_LED_AND_POWER.3
TS_OFF: 680Ω_.1, TSAL_LED_AND_POWER.1
VOLTAGE_ON_ACCUMULATOR: COMPARATOR_3.3 (IN1+), COMPARATOR_5.6 (IN2-), CONTACTOR_STATE_AND_VOLTAGE_MEASUREMENT.2, R15.2, VOLTAGE_ON_ACCUMULATOR.1, XNOR.12 (4A)
VOLTAGE_ON_INVERTER: CONTACTOR_STATE_AND_VOLTAGE_MEASUREMENT.1, R14.2, VOLTAGE_ON_INVERTER.1, XNOR.13 (4B)

Notes on the sheet:
Implausibility
Green enable
Connector
LDO
Green on
Red on
err

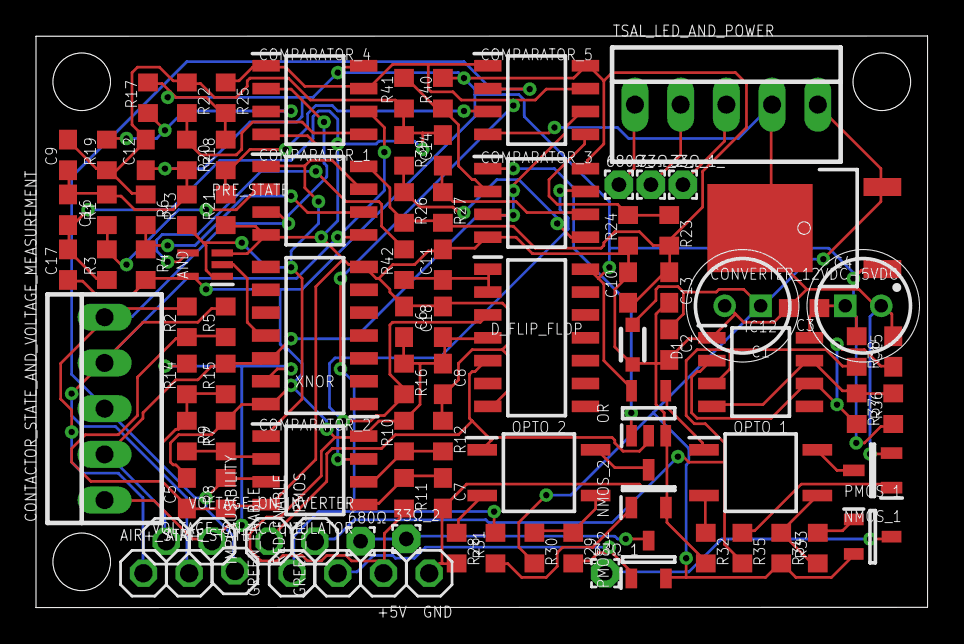
[picture p696: board TSAL_logic_TNN_V1.0.brd from above]

Board: 2 copper layers, 49.5 x 31.8 mm, 97 parts (0 on the bottom side), 47 nets.
