EOSCogniton/ELIZ-2021/SU_Suspension/01_LAS-Auto/01_Fichiers-lotus/01-Evolution_paramètres.txt

v01 : Invictus copié/collé
v02 : Invictus avec paramètres du cdcf (hauteur CG, empattement, brake)
v03 : Baisse de tous les points de 5cm (Suppression de la sur-marge mise sur Invictus pour l'aéro)
v04 : y11mm/° en roll front
v05 : y10mm/° en roll front et hCG 89mm (élevé)
v06 : élargissement à l'arrière de 30mm
v07 : Réduction camber à 2.7° en bump 35mm ; y1mm/°roll ; Zrf/Zrr=100/48=2
=>continuer de réduire le camber
=>vérifier toe
v08 : Motion ratio Front 1.15->1.2 71mm amplitude d'amortisseur, distance rotule pull bar 31mm
v09 et v10 : deplacement point 11 et 12 pour satisfaire les conditions voulues
v11 : placement 11, 12 pour avoir un angle de steering de 22,95 + deplacement cremaillère -->21,975
v12 : déplacement front damper pour vérifier collision =>le faire sur catia
v13 : rear limitation camber en bump et variations roll center y
v14 : rear perfect toe angle
v15 : Modification point 12
v16 : camber static -1/-1.1 °
v17 : descente du centre de roulis avant 
v18 : évite le contact damper pullrod
v19 : premier placement amo arrière
v20 : test de placement
v21 : déplacement vers l'extérieur rear front pivot pour que la cellule arrière soit mieux
v22 : deuxième placement amo arrière
v22b : Mise en place amo arrière en prise directe
v23a : symétrisation des triangles arrières
v24a : symétrisation des triangles avant
v24b : symétrisation version b
v25a : Point invictus avant pour réutilisation carrosserie
v26a : Front damper to body point mieux placé
v27a : Remise en place triangle arrière pour élevé centre de roulis
v28a : Placement rear damper with rocker
v29a : Modification point 11 des points front pour corriger le bump et le roll 
v30a : Modification points 11 et 12 front pour relever la cremaillère et éviter les collisions avec le chassis 
v31a : Remontage du centre de roulis arrière pour être le plus au dessus de l'avant. et réduction de l'amplitude du carrossage.
v32a : Replacement biellette de pince
v33a : Placement damper arrière motion ratio 1.1
v34a : Amortisseur 175mm en static
v35a : Redescente du centre de roulis arrière
v36a : (Allongement de l'empattement de 35mm) FAUX
v37a : Erratum, véritable allongement de l'empattement de 35mm pour permettre plus de place dans la celule arrière
v38a : Modification de la hauteur du point 12 (crémaillère) suite à la mise à jour de la cellule avant 
v39a : Relève légèrment le centre de roulis de 10mm pour prendre de la marge sur le centre de l'avant et ainsi éviter que l'avant passe au dessu sde l'arrière
v40a : damper ratio >1.1 <1.2
v42a : allongement de la track rod pour meilleur PM
v43a : décallage vers l'intérieur de 3mm des point 3 et 7 pour permettre à la vis du point 7 de ne pas toucher le congé
v44a : oublie de déplacer le point 8
v45a: déplacement poit 12 vers l'exté pour etre en face du tube
v46a : Deplacement point 12 vers lavant de 9mm
