EOSCogniton/ELIZ-2021/EL_Electrical/Autre/Vehicule Control Unit/FIchiers simulink/Code_TDN_SAVE/VCU_TDN_MPC5644A_rtw/ASW_IO_Init.c

/******************************************************************************
 * Copyright (C),
 * File name:         ASW_IO_Init.c
 *   <Author>         <Version>        <Date>
 *   HXL              0.2             2018-5-29
 * Description:
 * Develop pack:
 * Function List:
 ******************************************************************************/

/******************************************************************************
   Includes
 ******************************************************************************/
#include "Abstraction_HLSO.h"
#include "ASW_IO_Init.h"
#include <string.h>
#include "VCU_TDN.h"

/******************************************************************************
 *   Function:
 *   Description:
 *   Input:
 *   Output:
 *   Return:
 *   Others:
 ******************************************************************************/
void F_ASW_IO_init(void)
{
  {
  }
}
