EOSCogniton/ELIZ-2021/EL_Electrical/Autre/Vehicule Control Unit/FIchiers simulink/Code_TDN_SAVE/VCU_TDN_MPC5644A_rtw/ASW_IO_Init.h

/******************************************************************************
 * Copyright (C),
 * File name:         ASW_IO_Init.h
 *   <Author>         <Version>        <Date>
 *   HXL              0.2             2018-5-29
 * Description:
 * Develop pack:
 * Function List:
 ******************************************************************************/

#ifndef _H_ASW_IO_Init_H_
#define _H_ASW_IO_Init_H_

/******************************************************************************
   Includes
 ******************************************************************************/

/******************************************************************************
   Exported Function Declarations
 ******************************************************************************/
extern void F_ASW_IO_init(void);

#endif                                 /* _ASW_IO_H_ */
