EOSCogniton/ELIZ-2021/EL_Electrical/Autre/Vehicule Control Unit/FIchiers simulink/Code_TDN_SAVE/VCU_TDN_MPC5644A_rtw/Service_LIN.c

/******************************************************************************
 * Copyright (C),
 * File name:         Service_LIN.c
 *   <Author>         <Version>        <Date>
 *   YYL              0.1             2019-2-20
 * Description:
 * Develop pack:      CodeWarrior
 * Function List:
 *   1.
 * History:
 *   1. Date:         2019-2-20
 *      Author:       YYL
 *      Ver:          0.1
 *      Modification: Create
 *   2. Date:
 *      Author:
 *      Ver:
 *      Modification:
 *   Standards:
 ******************************************************************************/
/******************************************************************************
   Includes
 ******************************************************************************/
#include "Service_LIN.h"

void F_Service_LIN_Init(void)
{
}
