EOSCogniton/ELIZ-2021/(commit log)

2020-09-27 Mise en place maquette
    [EL_Electrical.CATProduct, EN_Engine_Drivetrain.CATProduct, F Rocker.CATPart, F Wheel.CATPart, F pullpush rod.CATPart, FL A-Arm.CATPart, FR_Filaire.CATPart, FR_Frame.CATProduct]
2020-09-29 Suppression tubes moteurs
    [FR_Filaire.CATPart]
2020-10-05 Update Frame
    Supression cellule arrière
    Ajout CATpart tubes
    Arborescence Frame
    [12x2.5.CATProduct, 15x1.5.CATPart, 15x1.5.CATProduct, 20x1.5.CATPart, 20x1.5.CATProduct, 25x1.5.CATPart, 25x1.5.CATProduct, 28x1.5.CATPart]
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2020-11-03 Emplacement de la chaîne de puissance
    Version primitive de l'emplacement dans l'espace de la chaîne de puissance
    [AMPSEAL776231-05-3.CATPart, Bracket_X_228.CATPart, C-0776228-01-3.CATPart, EN_Engine_Drivetrain.CATProduct, HJNUT 0.5625-18-D-N_HJNUT 0.5625-18-D-N.CATPart, MCGB-M25.CATPart, Modele_batterie.CATPart, PM100 Package Outline.CATPart]
2020-11-08 Ajout Crashbox & AIP
    [FR_Frame.CATProduct, Frame&Body.CATProduct]
2020-11-08 Ajout BAR Wireframe
    [F ARB Wireframe.CATPart]
2020-11-08 Ajout Crashbox & AIP correction
    [FRA0500 (CrashBox + AIP).CATProduct, FR_05001 (CrashBox).CATPart, FR_05002 (AIP).CATPart]
2020-11-08 Ajout Crashbox & AIP correction 2
    [FR_Frame.CATProduct, Frame&Body.CATProduct]
2020-11-08 Correction liens fichiers
    [EL_Electrical.CATProduct, FRA0500 (CrashBox + AIP).CATProduct, FR_05001 (CrashBox).CATPart, Frame&Body.CATProduct, MS_Miscellaneous.CATProduct, Suspension.CATProduct, Valkyriz.CATProduct]
2020-11-09 Ajout assemblage Seat&Driver
    [MS_A0100 (Seat & Driver).CATProduct]
2020-11-09 Ajout Pédalier adapté v1
    [FR_10001 (Frame Brake).CATPart, FR_10001_1 (Frame Brake).CATPart, FR_10001_1 (Frame Brake).igs, FR_10001_1 (Frame Brake).stp, FR_10001_10 (Frame Brake).CATPart, FR_10001_10 (Frame Brake).igs, FR_10001_10 (Frame Brake).stp, FR_10001_11 (Frame Brake).CATPart]
2020-11-09 Pièce perdue pédalier
    [ISO_7089_5x10_STEEL_GRADE_A_NORMAL_SERIES_PLAIN_WASHER.CATPart]
2020-11-10 Ajout pièces Seat & Driver
    [MS_01003 (Driver v2).CATProduct, MS_01010(Chape Harnais Submarine).CATPart]
2020-11-10 Assemblage Seat & Driver
    [MS_01003 (Driver v2).CATProduct, MS_A0100 (Seat & Driver).CATProduct]
2020-11-10 Ajout Seat & Driver dans Miscellaneous
    [MS_Miscellaneous.CATProduct]
2020-11-10 MAJ Miscellaneous
    [MS_01001 (Seat).CATPart, MS_01003 (Driver v2).CATProduct, MS_Miscellaneous.CATProduct]
2020-11-10 Fin Seat & Driver
    [FR_Filaire.CATPart, FR_Frame.CATProduct, MS_01003 (Driver v2).CATProduct, MS_Miscellaneous.CATProduct]
2020-11-10 Points LAS - fichiers lotus
    V01 et v02
    [01-Evolution_paramètres.txt]
2020-11-10 Template pilote cercles
    [Template_Pilote_Cercle.CATPart]
2020-11-10 Gabarits scrut
    [Cockpit opening template.CATPart, T2-3-2 (ground clearance).CATPart, T_2-1-3 (Wheel).CATPart, internal cross section template.CATPart]
2020-11-11 Ajout tubes maquette
    [15x1.5.CATProduct, 20x1.5.CATProduct, 25x1.5.CATProduct, 28x1.5.CATProduct, 30x2.CATProduct, Shape_027.CATPart, Shape_028.CATPart, Shape_029.CATPart]
2020-11-11 Réparation conflit + tubes dans frame
    [28x1.5.CATProduct, FRA0500 (CrashBox + AIP).CATProduct, FR_Frame.CATProduct, Frame&Body.CATProduct, Shape_034.CATPart, Shape_035.CATPart, Shape_036.CATPart, Shape_037.CATPart]
2020-11-11 Première itération LASAuto
    [LotusPoints.CATPart, WireframeDefinition.CATProduct]
2020-11-11 Renommer miscelleanous
    [MS_A0100 (Seat & Driver).CATProduct]
2020-11-12 Ajout dans dossiers filaires triangles
    [FL A-Arm.CATPart, FU A-Arm.CATPart, RL A-Arm.CATPart, RU A-Arm.CATPart, SU_01001 (Front Rod).CATPart, SU_01002 (Rear Rod) .CATPart, SU_01003 (Front Upper Rod-End Support).CATPart, SU_01003 (Front Upper Bearing Support).CATPart]
2020-11-12 Ajout systèmes de l'année dernière pour 0As
    [FR_04001 (Partie Inferieure).CATPart, FR_04002 (Partie Intermediaire).CATPart, FR_04003 (Partie Superieure).CATPart, FR_04004 (Chape 1 PareFeu).CATPart, FR_04005 (Chape 2 PareFeu).CATPart, FR_09001 (Support appui tete).CATPart, FR_09002 (bracket upright).CATPart, FR_09003 (mousse appui tete).CATPart]
2020-11-12 Ajout SES
    [2020-FSAE-SES-v1.0.xlsx]
2020-11-12 Correction head restraint
    [FR_A0900.CATProduct, FR_A09001.CATPart, FR_A09002.CATPart, FR_A09003.CATPart, FR_A09004.CATPart]
2020-11-12 Ajout nez
    [FR_02001 (Nose).CATPart]
2020-11-12 Couleur tube
    [FR_Frame.CATProduct]
2020-11-12 MAJ micellaneous
    [MS_01003 (Driver v2).CATProduct, MS_01010(Chape Harnais Submarine).CATPart, MS_A0100 (Seat & Driver).CATProduct, MS_Miscellaneous.CATProduct]
2020-11-12 Ajout support batterie Invictus pour ACE
    [Battery Assembly.CATProduct, EL_03001(Batterie).CATPart, EL_03002 (Base ancien).CATPart, EL_03002 (Base).CATPart, EL_03003 (Anse ancien).CATPart, EL_03003 (Anse).CATPart, EL_03004 (Chape ancien).CATPart, EL_03004 (Chape2.2).CATPart]
2020-11-12 Carrosserie v1
    [FR_02001 (Nose).CATPart, Frame&Body.CATProduct]
2020-11-12 maj carrosserie
    [FR_02001 (Nose).CATPart, FR_A0200 (Body).CATProduct, Frame&Body.CATProduct]
2020-11-12 Commencement cellule arrière
    [20x1.5.CATProduct, 25x1.5.CATProduct, 28x1.5.CATProduct, FR_Filaire.CATPart, FR_Frame.CATProduct, Shape_034.CATPart, Shape_035.CATPart, Shape_036.CATPart]
2020-11-12 Mise en place Suspension sur la maquette
    [F Rocker.CATPart, F Wheel.CATPart, F pullpush rod.CATPart, FL A-Arm.CATPart, FR_Frame.CATProduct, FU A-Arm.CATPart, FrameWireframe.CATPart, Front Left Wheel Assy.CATProduct]
2020-11-13 Résolution 2
    [FR_Frame.CATProduct]
2020-11-13 Résolution 3
    [Valkyriz.CATProduct]
2020-11-13 Correction miscellaneous
    [MS_01010(Chape Harnais Submarine).CATPart, MS_Miscellaneous.CATProduct]
2020-11-13 Ajout template pilote cercles
    [MS_Miscellaneous.CATProduct]
2020-11-14 Positionnement Bodywork
    [FRA0500 (CrashBox + AIP).CATProduct, FR_Frame.CATProduct, Frame&Body.CATProduct]
2020-11-14 Correction conflit
    [FRA0500 (CrashBox + AIP).CATProduct, FR_02001 (Nose).CATPart, FR_A0200 (Body).CATProduct, FR_Frame.CATProduct, Frame&Body.CATProduct, Tubes.CATProduct]
2020-11-14 Correction conflit 2
    [FRA0500 (CrashBox + AIP).CATProduct, FR_02001 (Nose).CATPart, FR_A0200 (Body).CATProduct, FR_Frame.CATProduct, Frame&Body.CATProduct]
2020-11-14 Nose v2
    [FR_02001 (Nose).CATPart]
2020-11-15 Ajout section vérif collision
    [Frame&Body.CATProduct]
2020-11-16 Début des inserts
    [SU_01003 (Front Upper Rod-End Support).CATPart]
2020-11-17 maj Nose
    [FR_02001 (Nose).CATPart]
2020-11-17 Premier jet châssis
    premier jet, main hoop dessiné, première cellule arrière très simple pour partir d'un point de départ.
    [25x1.5.CATProduct, 28x1.5.CATProduct, FR_Filaire.CATPart, FR_Frame.CATProduct, Frame&Body.CATProduct, Shape_080.CATPart, Shape_081.CATPart, Shape_082.CATPart]
2020-11-17 plus de plan 39
    [25x1.5.CATProduct, 28x1.5.CATProduct, FR_Filaire.CATPart, FR_Frame.CATProduct, Frame&Body.CATProduct, Shape_080.CATPart, Shape_083.CATPart, Shape_084.CATPart]
2020-11-17 Autre gabarit pilote
    [MS_01003 (Driver v2).CATProduct, MS_01004 (Driver v3) (Small size).CATProduct, MS_A0100 (Seat & Driver).CATProduct]
2020-11-17 bakcup filaire
    [FR_Filaire.CATPart]
2020-11-17 deuxième jet de cellule arrière /!\ lire description
    Cellule arrière paramétrée sur les points LAS néanmoins cellule beaucoup trop petite pour faire rentrer la batterie il faut augmenter la voie arrirère
    [25x1.5.CATProduct, FR_Filaire.CATPart, FR_Frame.CATProduct, Frame&Body.CATProduct, Shape_076.CATPart, Shape_082.CATPart, Shape_087.CATPart, Shape_088.CATPart]
2020-11-17 supression fichier inutile
    [FR_Filaire.CATPart]
2020-11-18 Correction incohérence filaire body/frame
    [25x1.5.CATProduct, 28x1.5.CATProduct, FR_02001 (Nose).CATPart, FR_Frame.CATProduct, Frame&Body.CATProduct, Shape_080.CATPart, Shape_083.CATPart, Shape_086.CATPart]
2020-11-18 maj miscellaneous
    Ajout du deuxième gabarit de pilote dans l'assemblage
    [MS_01003 (Driver v2).CATProduct, MS_01004 (Driver v3) (Small size).CATProduct, MS_01005 (Driver v3) (Small size).CATProduct, MS_A0100 (Seat & Driver).CATProduct]
2020-11-18 ajustement deuxième pilote miscellaneous
    [FR_A1200 (Pedal Assy).CATProduct, FR_Frame.CATProduct, MS_01003 (Driver v2).CATProduct, MS_A0100 (Seat & Driver).CATProduct, MS_Miscellaneous.CATProduct]
2020-11-18 maj miscellaneous
    fin du positionnement des deux gabarits de pilote
    [12x2.5.CATProduct, FR_Filaire.CATPart, MS_01001 (Seat).CATPart, MS_01003 (Driver v2).CATProduct, MS_01005 (Driver v3) (Small size).CATProduct, MS_01010(Chape Harnais Submarine).CATPart, MS_A0100 (Seat & Driver).CATProduct, MS_Miscellaneous.CATProduct]
2020-11-19 Correction pédalier miscellaneous
    [FR_Frame.CATProduct, MS_01003 (Driver v2).CATProduct, MS_01005 (Driver v3) (Small size).CATProduct, MS_A0100 (Seat & Driver).CATProduct, MS_Miscellaneous.CATProduct]
2020-11-19 Fin positionnement pilotes
    [25x1.5.CATProduct, 28x1.5.CATProduct, FR_Filaire.CATPart, FR_Frame.CATProduct, MS_01003 (Driver v2).CATProduct, MS_01005 (Driver v3) (Small size).CATProduct, MS_A0100 (Seat & Driver).CATProduct, MS_Miscellaneous.CATProduct]
2020-11-19 Barre harnais filaire
    [FR_Filaire.CATPart]
2020-11-21 rangement frame and body
    rangement des modèles CATIA pour les 0A
    [Battery Assembly.CATProduct, EL_03001(Batterie).CATPart, EL_03002 (Base ancien).CATPart, EL_03002 (Base).CATPart, EL_03003 (Anse ancien).CATPart, EL_03003 (Anse).CATPart, EL_03004 (Chape ancien).CATPart, EL_03004 (Chape2.2).CATPart]
2020-11-21 battery assembly
    premier jet support batterie LV
    [Battery Assembly.CATProduct, FR_03001 (batterie).CATPart, FR_03002 (anse).CATPart, FR_03003 (base).CATPart]
2020-11-22 Design table pour inserts
    [SU_01003 (Front Upper Rod-End Support).CATPart, params.xlsx]
2020-11-23 Insert v1
    [SU_01003 (Front Upper Rod-End Support).CATPart]
2020-11-23 attaches pullrod sur inserts
    [SU_01003 (Front Upper Rod-End Support).CATPart, params.xlsx]
2020-11-24 tube harnais
    [30x2.CATProduct, Shape_102.CATPart]
2020-11-24 ajout tube
    [20x1.5.CATProduct, FR_Filaire.CATPart, FR_Frame.CATProduct, Shape_103.CATPart, Tubes.CATProduct]
2020-11-24 cache plan de construction
    [FR_Filaire.CATPart]
2020-11-24 Ajout templates miscellaneous
    [Cockpit opening template.CATPart, Internal_cross_section_template.CATPart, MS_Miscellaneous.CATProduct]
2020-11-24 Un tube avait sauté je l'ai remis
    [28x1.5.CATProduct, FR_Frame.CATProduct, Shape_104.CATPart, Tubes.CATProduct]
2020-11-24 Side plates
    [FR_02002 (Side plates).CATPart, FR_A0200 (Body).CATProduct]
2020-11-24 version 1 Batterie sortie par le haut
    [15x1.5.CATProduct, 25x1.5.CATProduct, 28x1.5.CATProduct, EN_Engine_Drivetrain.CATProduct, FR_Filaire.CATPart, FR_Frame.CATProduct, Frame&Body.CATProduct, Shape_034.CATPart]
2020-11-24 réparation tubes
    [15x1.5.CATPart, 20x1.5.CATPart, 25x1.5.CATPart, 28x1.5.CATPart, 30x2.CATPart]
2020-11-24 réparation tubes v2
    [28x1.5.CATProduct, Frame&Body.CATProduct, Shape_027.CATPart, Shape_028.CATPart, Shape_029.CATPart, Shape_030.CATPart, Shape_031.CATPart, Shape_032.CATPart]
2020-11-24 Contraintes cachées
    oupsi
    [Frame&Body.CATProduct]
2020-11-24 v1 Batterie fixed
    [15x1.5.CATProduct, FR_Filaire.CATPart, FR_Frame.CATProduct, Shape_105.CATPart, Shape_106.CATPart, Shape_107.CATPart, Shape_108.CATPart, Shape_109.CATPart]
2020-11-24 Choix push rod à l'avant
    Comparaison pushpull rod optimus Invictus
    [Comparaison pullpush rod optimus invictus.xlsx]
2020-11-25 déplacement LV battery assembly FR->EL
    [Battery Assembly.CATProduct, EL_03001 (batterie).CATPart, EL_03002 (anse).CATPart, EL_03003 (base).CATPart]
2020-11-25 Placement Crémaillle
    Placement crémaillere sur steering product
    [FR_Frame.CATProduct, ST_01001_rack (Steering Rack Narrco).CATPart, ST_01001_rod (Steering Rack Narrco).CATPart, ST_Steering.CATProduct]
2020-11-25 Placement Crémaillère
    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
    [FR_Frame.CATProduct, ST_01001_rack (Steering Rack Narrco).CATPart, ST_01001_rod (Steering Rack Narrco).CATPart, ST_Steering.CATProduct]
2020-11-25 Crémaillère
    fichier manquant
    [ST_01001 (Steering Rack Narrco).CATProduct]
2020-11-25 Insert V1 fini
    [SU_01003 (Front Upper Rod-End Support).CATPart, params.xlsx]
2020-11-25 Cremaillière v2
    [ST_Steering.CATProduct]
2020-11-25 Basculeurs v1
    [SU_06001.CATPart, SU_A0600 (Front Bell Crank).CATProduct]
2020-11-25 Ajout pédalier
    [FR_10001 (Frame Brake).CATPart, FR_10001_1 (Frame Brake).CATPart, FR_10001_1 (Frame Brake).igs, FR_10001_1 (Frame Brake).stp, FR_10001_10 (Frame Brake).CATPart, FR_10001_10 (Frame Brake).igs, FR_10001_10 (Frame Brake).stp, FR_10001_11 (Frame Brake).CATPart]
2020-11-25 update LV battery assembly
    adaptation aux dimensions de la batterie LV retenue
    [EL_03001 (batterie).CATPart, EL_03002 (anse).CATPart, EL_03003 (base).CATPart, LV Battery Assembly.CATProduct]
2020-11-26 Ajout support batterie LV sur Valkyriz
    [EL_Electrical.CATProduct, LV Battery Assembly.CATProduct]
2020-11-27 maj barre harnais
    [FR_Filaire.CATPart]
2020-11-27 update batterie LV
    [EL_03001 (batterie).CATPart, EL_03002 (anse).CATPart, EL_03003 (base).CATPart, LV Battery Assembly.CATProduct]
2020-11-28 fin positionnement barre harnais
    [FR_Filaire.CATPart]
2020-11-28 actualisation frame
    [15x1.5.CATProduct, 25x1.5.CATProduct, 28x1.5.CATProduct, 30x2.CATProduct, FR_Frame.CATProduct, Shape_034.CATPart, Shape_035.CATPart, Shape_036.CATPart]
2020-11-28 2ème itération points LAS
    [01-Evolution_paramètres.txt]
2020-11-29 MAJ points de LAS
    + cache contraintes ST
    [F Rocker.CATPart, F Wheel.CATPart, F pullpush rod.CATPart, FL A-Arm.CATPart, FU A-Arm.CATPart, FrameWireframe.CATPart, LotusPoints.CATPart, R Rocker.CATPart]
2020-11-29 Résolution position plan
    Problème dès les premières itérations. Résolution par replacement du repère absolu dans FR_A01
    [15x1.5.CATProduct, 20x1.5.CATProduct, 25x1.5.CATProduct, FR_Filaire.CATPart, FR_Frame.CATProduct, Frame&Body.CATProduct, ST_Steering.CATProduct, SU_01003 (Front Upper Rod-End Support).CATPart]
2020-11-29 Nettoyage maquette
    [FRA0500 (CrashBox + AIP).CATProduct, FR_02001 (Nose).CATPart, FR_02002 (Side plates).CATPart, FR_A0200 (Body).CATProduct, FR_Frame.CATProduct, Frame&Body.CATProduct, MS_01003 (Driver v2).CATProduct, MS_01005 (Driver v3) (Small size).CATProduct]
2020-11-30 Volume enveloppe BAMOCAR
    [EN_12001 BAMOCAR D3.CATPart, EN_A1200 Motor Controller.CATProduct, EN_Engine_Drivetrain.CATProduct]
2020-12-01 Modèle CAO BAMOCAR
    [3d2-fb-rahmen34 01.CATPart, 3d2-led-7seg 01.CATPart, 3d2-pg-metr-25.CATPart, Binder_09-0463-90-19.CATPart, Binder_09-0464-90-19.CATPart, Block 01.CATPart, Block 02.CATPart, Cylinder.CATPart]
2020-12-01 2000 lignes et plus de cachées
    [3d2-led-7seg 01.CATPart, EN_Engine_Drivetrain.CATProduct, MCGB-M25.CATPart, Plug.CATPart]
2020-12-01 Moteur derrière le diff
    [EN_Engine_Drivetrain.CATProduct, FR_Filaire.CATPart]
2020-12-01 tubes moteur
    [15x1.5.CATProduct, 20x1.5.CATProduct, 25x1.5.CATProduct, 28x1.5.CATProduct, FR_Filaire.CATPart, FR_Frame.CATProduct, Shape_073.CATPart, Shape_074.CATPart]
2020-12-01 début inserts v2
    [SU_01003 (Front Upper Rod-End Support).CATPart, params.xlsx]
2020-12-01 maj seat & driver
    [Cockpit opening template.CATPart, MS_01003 (Driver v2).CATProduct, MS_01005 (Driver v3) (Small size).CATProduct, MS_A0100 (Seat & Driver).CATProduct, MS_Miscellaneous.CATProduct]
2020-12-01 maj seat & driver
    [MS_01003 (Driver v2).CATProduct, MS_01005 (Driver v3) (Small size).CATProduct, MS_A0100 (Seat & Driver).CATProduct, MS_Miscellaneous.CATProduct]
2020-12-01 Mise en place EN
    [3d2-fb-rahmen34 01.CATPart, 3d2-led-7seg 01.CATPart, 3d2-pg-metr-25.CATPart, Binder_09-0463-90-19.CATPart, Binder_09-0464-90-19.CATPart, Block 01.CATPart, Block 02.CATPart, Bracket_X_228.CATPart]
2020-12-01 Mise au propre
    [AMPSEAL776231-05-3.CATPart, C-0776228-01-3.CATPart, EL_03001 (batterie).CATPart, EL_03002 (anse).CATPart, EL_03003 (base).CATPart, EL_A0300 (LV Battery Assembly).CATProduct, EL_Electrical.CATProduct, HJNUT 0.5625-18-D-N_HJNUT 0.5625-18-D-N.CATPart]
2020-12-01 MAJ Steering
    [ST_01001 (Steering Rack Narrco).CATProduct, ST_01001_rack (Steering Rack Narrco).CATPart, ST_01001_rod (Steering Rack Narrco).CATPart, ST_Steering.CATProduct]
2020-12-01 Mise en place assemblage Triangle
    [FL A-Arm.CATPart, FU A-Arm.CATPart, RL A-Arm.CATPart, RU A-Arm.CATPart, SU_01001 (Front_Upper_A_Arm_Front_Rod).CATPart, SU_01002 (Front_Upper_A_Arm_Rear_Rod).CATPart, SU_01004 (Inner Bearing Support).CATPart, SU_02001 (Front Rod).CATPart]
2020-12-01 Ajout assemblage BAR
    [SU_A1400 (Front ARB).CATProduct]
2020-12-01 ajout plan front hoop
    [FR_Filaire.CATPart]
2020-12-01 correction mineure sur inserts
    [SU_01003 (Front Upper Rod-End Support).CATPart]
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2020-12-02 basculeur avant
    [SU_06001.CATPart]
2020-12-02 MAJ Front rocker
    [SU_06001.CATPart, SU_A0600 (Front Bell Crank).CATProduct]
2020-12-02 correction nomenclature
    [EL_03001 (battery).CATPart, EL_03002 (handle).CATPart]
2020-12-02 Insert V2
    [SU_01003 (Front Upper Rod-End Support).CATPart]
2020-12-02 deplacement batterie LV
    [EL_A0300 (LV Battery Assembly).CATProduct, EL_Electrical.CATProduct, Frame&Body.CATProduct]
2020-12-02 SU_01004 v1
    [SU_01004 (Inner Bearing Support).CATPart]
2020-12-02 Modification LV battery
    [EL_03001 (LV battery).CATPart, EL_03002 (handle).CATPart, EL_03003 (base).CATPart, EL_A0300 (LV Battery Assembly).CATProduct]
2020-12-02 SU_02003 + modif sur 01003
    [SU_01003 (Front Upper Rod-End Support).CATPart, SU_02003 (Front Lower Rod-End Support).CATPart]
2020-12-02 MAJ pedalier
    [FR_11001 (Frame Throttle).CATPart, FR_11004 (Throttle Pedal Stick).CATPart, FR_A1100 (Throttle Pedal).CATProduct, FR_A1200 (Pedal Assy).CATProduct, Guidage ressort male.CATPart, IS0_10511_M6_STEEL_PREVAILING_TORQUE_TYPE_HEXAGON_THIN_NUT.CATPart, ISO_7091_8x16_STEEL_GRADE_A_NORMAL_SERIES_PLAIN_WASHER.CATPart, Volume enveloppe de potentiometre.CATPart]
2020-12-02 maj LV batterie assembly
    [EL_A0300 (LV Battery Assembly).CATProduct, EL_Electrical.CATProduct, FR_Frame.CATProduct]
2020-12-03 MAJ paliers lisses pédalier
    [FR_11001 (Frame Throttle).CATPart, FR_11004 (Throttle Pedal Stick).CATPart, FR_A1100 (Throttle Pedal).CATProduct, FR_A1200 (Pedal Assy).CATProduct, Palier lisse.CATPart, Volume enveloppe de potentiometre.CATPart, axe pedale d'axel.CATPart]
2020-12-03 SU_01003 version 2.5
    [SU_01003 (Front Upper Rod-End Support).CATPart]
2020-12-04 ajout points harnais
    [FR_Filaire.CATPart]
2020-12-04 MAJ support batterie LV
    [EL_03001 (LV battery) - Copie.CATPart, EL_03002 (handle) - Copie.CATPart, EL_03003 (base) - Copie.CATPart, EL_A0300 (LV Battery Assembly) - Copie.CATProduct, ansecopiecopoe.CATPart]
2020-12-05 ajout floor pan + correction nose
    [Chape_FL_Cell_Avant.CATPart, Chape_FL_Cockpit.CATPart, Chape_RL_Cell_Avant.CATPart, Chape_RL_Cockpit.CATPart, Chapes_Floor_Pan.CATProduct, FR_02001 (Nose).CATPart, FR_A0800 (Floor pan).CATProduct, FR_A0801 (Front plate).CATPart]
2020-12-05 maj floor pan
    [FRA0500 (CrashBox + AIP).CATProduct, FR_02002 (Side plates).CATPart, FR_Frame.CATProduct, Frame&Body.CATProduct]
2020-12-05 maj filaire support baquet
    [FR_Filaire.CATPart]
2020-12-05 MAJ support batterie LV
    ajout chapes de fixation
    [EL_03001 (LV battery).CATPart, EL_03003 (base).CATPart, EL_03004 (screed1).CATPart, EL_03005 (screed2).CATPart, EL_A0300 (LV Battery Assembly).CATProduct, EL_Electrical.CATProduct]
2020-12-05 ajout firewall
    [FR_04001 (Partie Inferieure).CATPart, FR_04002 (Partie Intermediaire).CATPart, FR_04003 (Partie Superieure).CATPart, FR_04004 (Chape 1 PareFeu).CATPart, FR_04005 (Chape 2 PareFeu).CATPart, FR_A0400.CATProduct, Symmetry of chappe_11_.CATPart, Symmetry of chappe_1_1.CATPart]
2020-12-05 maj firewall
    [FRA0500 (CrashBox + AIP).CATProduct, FR_A0400.CATProduct, FR_Frame.CATProduct, Frame&Body.CATProduct]
2020-12-05 positionnement sous-systèmes dans Frame&Body
    [FR_A0400.CATProduct, FR_A0802 (Cockpit plate).CATPart, Frame&Body.CATProduct]
2020-12-05 maj partie supérieure firewall
    [FR_04003 (Partie Superieure).CATPart]
2020-12-05 réorganisation git
    [FRA0500 (CrashBox + AIP).CATProduct, FR_04001 (Lower part).CATPart, FR_04001 (Partie Inferieure).CATPart, FR_04002 (Partie Intermediaire).CATPart, FR_04002 (Upper part).CATPart, FR_04004 (Chape 1 PareFeu).CATPart, FR_04005 (Chape 2 PareFeu).CATPart, FR_A0400 (Firewall).CATProduct]
2020-12-05 réorganisation git suite
    [Chapes_Floor_Pan.CATProduct, FR_02001 (Nose).CATPart, FR_02002 (Side plates).CATPart, FR_04001 (Lower part).CATPart, FR_04002 (Upper part).CATPart, FR_05001 (CrashBox).CATPart, FR_05002 (AIP).CATPart, FR_08001 (Front plate).CATPart]
2020-12-05 Maj Point LAS v08
    Placement pullbar (front)
    [01-Evolution_paramètres.txt]
2020-12-06 partie supérieure firewall v1
    [FR_04002 (Upper part).CATPart]
2020-12-06 partie inférieure firewall v1
    [FR_04001 (Lower part).CATPart]
2020-12-06 correction floor pan
    [FRA0500 (CrashBox + AIP).CATProduct, FR_04002 (Upper part).CATPart, FR_08001 (Front plate).CATPart, FR_A0400 (Firewall).CATProduct, FR_A0800 (Floor pan).CATProduct, FR_Frame.CATProduct, Frame&Body.CATProduct]
2020-12-06 fin firewall v1
    [FR_04001 (Lower part).CATPart, FR_04002 (Upper part).CATPart, FR_A0400 (Firewall).CATProduct, Frame&Body.CATProduct]
2020-12-06 Crémaillère Lotus
    Placement crémaillère avant axe roues
    [01-Evolution_paramètres.txt]
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2020-12-06 MAJ pédalier potentiomètre et ressort
    [FR_10015 (M4 nut).CATPart, FR_11001 (Frame Throttle).CATPart, FR_11004 (Throttle Pedal Stick).CATPart, FR_11014 (Throttle Fixing Rail).CATPart, FR_11015 (Throttle Fixing Rail Wedge).CATPart, FR_11017 (Front Throttle Fixing Rail Wedge).CATPart, FR_11021 (M4x25 Screw).CATPart, FR_A1100 (Throttle Pedal).CATProduct]
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2020-12-06 placement moteur pas rapport au différentiel
    [EN_Engine_Drivetrain.CATProduct]
2020-12-06 Cellule arrière moteur derrière le différentiel
    [15x1.5.CATProduct, 20x1.5.CATProduct, FR_Filaire.CATPart, FR_Frame.CATProduct, Shape_167.CATPart, Shape_168.CATPart, Shape_169.CATPart, Shape_170.CATPart]
2020-12-06 réparation tube cellule arrière v1
    [15x1.5.CATProduct, 20x1.5.CATProduct, Shape_185.CATPart, Tubes.CATProduct]
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2020-12-06 Cellule arrière V1 batterie par le bas
    [15x1.5.CATProduct, 25x1.5.CATProduct, 28x1.5.CATProduct, 30x2.CATProduct, FR_Filaire.CATPart, FR_Frame.CATProduct, Frame&Body.CATProduct, Shape_034.CATPart]
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2020-12-06 rangement frame & body
    [15x1.5.CATProduct, 20x1.5.CATProduct, 25x1.5.CATProduct, 28x1.5.CATProduct, 30x2.CATProduct, FRA0500 (CrashBox + AIP).CATProduct, FR_02002 (Side plates).CATPart, FR_02003 (Chape).CATPart]
2020-12-06 ajout chape push clips
    [FR_A0200 (Body).CATProduct, Frame&Body.CATProduct]
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2020-12-06 placement moteur v2 au dessus du diff
    [EN_Engine_Drivetrain.CATProduct]
2020-12-06 Ajout points framewireframe - outer ball joints
    [FrameWireframe.CATPart]
2020-12-06 Cellule arrière V2 moteur dessus diff
    [15x1.5.CATProduct, 20x1.5.CATProduct, 25x1.5.CATProduct, 28x1.5.CATProduct, FR_Filaire.CATPart, FR_Frame.CATProduct, Shape_073.CATPart, Shape_074.CATPart]
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2020-12-07 Modification catia front rocker
    [F Rocker.CATPart, SU_06001 (Front Rocker).CATPart, SU_06001.CATPart, SU_08001.CATPart, SU_A0600 (Front Bell Crank).CATProduct, SU_A0800 (Rear Bell Crank).CATProduct, SU_A0800 (Rear Belle Crank).CATProduct, Suspension.CATProduct]
2020-12-07 maj LV battery
    revue de l'emplacement
    [EL_A0300 (LV Battery Assembly).CATProduct, EL_Electrical.CATProduct]
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2020-12-07 Cremaillère lotus v11
    points 11, 12
    [01-Evolution_paramètres.txt]
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2020-12-07 lotus v11.2
    steering angle --> 23°
    [01-Evolution_paramètres.txt]
2020-12-07 Mise en place suspension rod
    [F pullpush rod.CATPart, R pullpush rod.CATPart, SU_12001 (Front Suspension Rod).CATPart, SU_13001 (Rear Suspension Rod).CATPart, SU_A1200 (Front Suspension Rod).CATProduct, SU_A1300 (Rear Suspension Rod).CATProduct, Suspension.CATProduct, params.xlsx]
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2020-12-08 ajout modèle potentiomètre pédalier
    [Exemple_potentiometre.stp]
2020-12-08 Mise en place des roues
    [Front Left Wheel Assy.CATProduct, Rear Left Wheel Assy.CATProduct, Suspension.CATProduct, WT_01001 (OZ Mg Rim).CATPart, WT_01002 (Tire).CATPart, WT_A0100 (Wheel Assy).CATProduct]
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2020-12-08 mise à jour points LAS v14
    [F Rocker.CATPart, F Wheel.CATPart, F pullpush rod.CATPart, FL A-Arm.CATPart, FU A-Arm.CATPart, FrameWireframe.CATPart, LotusPoints.CATPart, R Wheel.CATPart]
2020-12-08 Suite Maj points LAS V
    [ST_Steering.CATProduct, SU_06001 (Front Rocker).CATPart, SU_12001 (Front Suspension Rod).CATPart, SU_A0100 (Front Upper A-Arm).CATProduct, SU_A0600 (Front Bell Crank).CATProduct, SU_A1200 (Front Suspension Rod).CATProduct, Suspension.CATProduct, Symmetry of SU_06001 (Front Rocker).CATPart]
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2020-12-09 MAJ support batterie LV
    maj dimensions, emplacements et chapes
    [EL_03001 (LV battery) - Copie.CATPart, EL_03001 (LV battery).CATPart, EL_03002 (handle) - Copie.CATPart, EL_03002 (handle).CATPart, EL_03003 (base) - Copie.CATPart, EL_03003 (base).CATPart, EL_03004 (screed1).CATPart, EL_03005 (screed2).CATPart]
2020-12-09 Revert "Crémaillère catia"
    This reverts commit 341a6f4f1b888d2e8ba32574570663651a92ea67.
    [FR_Frame.CATProduct, ST_Steering.CATProduct]
2020-12-09 Ajout piece colonne directino
    [ST_02005 (tube colonne).CATPart, ST_02008 (adaptateur cardan).CATPart]
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2020-12-09 Front Rocker v0.2 (assemblage) / Rear Rocker v0.1
    [SU_08001 (Rear Rocker).CATPart, SU_A0600 (Front Bell Crank).CATProduct, SU_A0800 (Rear Bell Crank).CATProduct, Symmetry of SU_06001 (Front Rocker).CATPart, Symmetry of SU_08001.CATPart]
2020-12-09 Ajout steering column assembly
    [ST_02003 (U-joint adapter).CATPart, ST_02004 ( U-Joint) HPC - GD1-A-16_16.CATProduct, ST_02004_1 Croisillon.CATPart, ST_02004_2 Fork.CATPart, ST_02004_3 Intermediate.CATPart, ST_02005 (Rigid Coupling).CATPart]
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2020-12-09 Lotus steering system v15
    [01-Evolution_paramètres.txt]
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2020-12-09 Sterring column assembly v3
    [ST_02001 (column).CATPart, ST_02003 (U-joint adapter).CATPart, ST_02004 ( U-Joint) HPC - GD1-A-16_16.CATProduct, ST_02005 (Rigid Coupling).CATPart, ST_A0200 (steering column assembly).CATProduct]
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2020-12-10 v0.3 Front / v0.2 Rear Rocker
    [SU_06001 (Front Rocker).CATPart, SU_08001 (Rear Rocker).CATPart, SU_A0600 (Front Bell Crank).CATProduct, SU_A0800 (Rear Bell Crank).CATProduct, Symmetry of SU_06001 (Front Rocker).CATPart, Symmetry of SU_08001.CATPart]
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2020-12-13 Ajustement offset RU + nettoyage SU_01003
    [RU A-Arm.CATPart, SU_01003 (Front Upper Rod-End Support).CATPart, SU_01004 (Inner Bearing Support).CATPart, SU_03001 (Rear_Upper_A_Arm_Front_Rod).CATPart, SU_03003 (Rear Upper Rod-End Support).CATPart, SU_A0300 (Rear Upper A-Arms).CATProduct, params.xlsx]
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2020-12-14 Ajout pièces chassis HandCart
    [HD_01001(great_tube).CATPart, HD_01002(small_tube).CATPart, HD_01003(tube-tri).CATPart]
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2020-12-15 Connecteur interne de batterie
    [EN_01001_1 Batterie_conn.CATPart, EN_A0100 (Accumulator Container).CATProduct, EN_Engine_Drivetrain.CATProduct]
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2020-12-15 Lotus points v20
    abaisse centre de roulis et test placement amo rear
    [01-Evolution_paramètres.txt]
2020-12-15 Résolution ref ext tubes front upper
    [SU_01001 (Front_Upper_A_Arm_Front_Rod).CATPart, SU_01002 (Front_Upper_A_Arm_Rear_Rod).CATPart, SU_A0100 (Front Upper A-Arm).CATProduct]
2020-12-15 MAJ Points de LAS
    Lotus v20
    [FR_Frame.CATProduct, LotusPoints.CATPart, RL A-Arm.CATPart, RU A-Arm.CATPart, SU_03001 (Rear_Upper_A_Arm_Front_Rod).CATPart, SU_03002 (Rear_Upper_A_Arm_Rear_Rod).CATPart, SU_03003 (Rear Upper Rod-End Support).CATPart, SU_04001 (Rear_Lower_A_Arm_Front_Rod).CATPart]
2020-12-16 Steering assembly
    Stuf to ELiz
    [ST_01002_01 (Bracket_right).CATPart, ST_01002_02 (Bracket_left).CATPart, ST_01002_left (Bracket_Assy_left).CATProduct, ST_01002_right (Bracket_Assy_right).CATProduct, ST_01003_01 (Half Moon_below).CATPart, ST_01003_02 (Half Moon top).CATPart, ST_0700 (protection rack).CATPart, ST_0701_01 (chape_droite).CATPart]
2020-12-16 Orientation du steering rack
    [FR_Frame.CATProduct, ST_Steering.CATProduct]
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2020-12-16 Maj Crémaillère STeering system
    [F Rocker.CATPart, F Wheel.CATPart, F pullpush rod.CATPart, FL A-Arm.CATPart, FU A-Arm.CATPart, FrameWireframe.CATPart, R Rocker.CATPart, R Wheel.CATPart]
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2020-12-18 Itération Points LAS
    Lotus v22
    [15x1.5.CATProduct, 20x1.5.CATProduct, 25x1.5.CATProduct, EL_Electrical.CATProduct, EN_Engine_Drivetrain.CATProduct, FRA0500 (CrashBox + AIP).CATProduct, FR_02002 (Side plates).CATPart, FR_04001 (Lower part).CATPart]
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2020-12-22 ST création ST_A0300 Tie rod
    [Front_Tie_Rod_Wireframe.CATPart, ST_0300 (Tie rod assembly).CATProduct, ST_03001 (Tie rod end).CATPart, ST_03002 (Inner rod support).CATPart, ST_03004 (tie rod tube).CATPart, ST_A0200 (steering column assembly).CATProduct, ST_A0300 (Connecting rod).CATProduct, ST_Steering.CATProduct]
2020-12-22 conception pigon/moyeu/fixations
    [6005_2RSH.catproduct, 6005_2RSH_14.catpart, 6005_2RSH_25.catpart, 6005_2RSH_27.catpart, 6005_2RSH_3.catpart, EN_13002 (flanged shaft) v1.CATPart, EN_13002 (flanged shaft) v2.CATPart, EN_13002 (flanged shaft).CATPart]
2020-12-23 Rod + U-joint modif
    Rod a vérifier, U-jont OK
    [FR_Frame.CATProduct, ST_02004 ( U-Joint) HPC - GD1-A-16_16.CATProduct, ST_03001 ( rod tube).CATPart, ST_A0100 (Steering Rack Narrco).CATProduct, ST_A0300 (Connecting rod).CATProduct, ST_Steering.CATProduct]
2020-12-23 Steering
    Ajout colonne avec les points de ref externe, problème de contrainte je n'arrive pas a comprendre pq
    [FR_Frame.CATProduct, ST_02001 (column).CATPart, ST_02004 ( U-Joint) HPC - GD1-A-16_16.CATProduct, ST_02005 (Rigid Coupling).CATPart, ST_02006 (adaptateur cardan).CATPart, ST_03001 ( rod tube).CATPart, ST_A0200 (steering column assembly).CATProduct, ST_Steering.CATProduct]
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2020-12-25 Correction STeering
    [Front_Tie_Rod_Wireframe.CATPart, ST_02001 (Steering Column).CATPart, ST_02001 (column).CATPart, ST_02002 (Rigid Coupling).CATPart, ST_02003 (Column_Ujoint adaptater).CATPart, ST_02003 (U-joint adapter).CATPart, ST_02004 ( U-Joint) HPC - GD1-A-16_16.CATProduct, ST_02004_1 Croisillon.CATPart]
2020-12-31 ST Recul colonne de 65mm et fixe cardan
    [FrameWireframe.CATPart, ST_02001 (Steering Column).CATPart, ST_02004 ( U-Joint) HPC - GD1-A-16_16.CATProduct, ST_A0200 (steering column assembly).CATProduct, ST_Steering.CATProduct, Steering column assembly wireframe.CATPart, SteeringWireframe.CATPart, WireframeDefinition.CATProduct]
2021-01-02 Fichier assemblage Cooling system + pièce radiateur
    [EN_0800_01 (Radiator).CATPart]
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2021-01-02 Mise en place Porte-moyeux
    SU_A1000 et SU_A1100
    [SU_10001 (Front Left Upright).CATPart, SU_11001 (Rear Left Upright).CATPart, SU_A1000 (Front Left Upright).CATProduct, SU_A1100 (Rear Left Upright).CATProduct]
2021-01-04 Point LAS v24 symétrisation des triangles
    [01-Evolution_paramètres.txt]
2021-01-05 MAJ Points de LAS
    Fichier Lotus v24a
    [FL A-Arm.CATPart, FR_Frame.CATProduct, FU A-Arm.CATPart, FrameWireframe.CATPart, LotusPoints.CATPart, RL A-Arm.CATPart, RU A-Arm.CATPart, ST_02001 (Steering Column).CATPart]
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2021-01-06 Steering shaft pivot v1
    [ST_06002_STEERING BORE.CATPart, ST_A0600 (Steering Shaft Pivot).CATProduct, ST_A06003 (Right Fixation Tube).CATProduct, ST_A06003_1.CATPart]
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2021-01-11 [LAS] Maj point LAS v28
    Avant -> comme invictus arrière -> placement damper
    [01-Evolution_paramètres.txt]
2021-01-11 Itération points LAS
    Lotus v28a
    [15x1.5.CATProduct, 20x1.5.CATProduct, F Rocker.CATPart, F pullpush rod.CATPart, FL A-Arm.CATPart, FRA0500 (CrashBox + AIP).CATProduct, FR_02002 (Side plates).CATPart, FR_04001 (Lower part).CATPart]
2021-01-11 Correction incohérence Frame&Body
    [FRA0500 (CrashBox + AIP).CATProduct, FR_Frame.CATProduct, Frame&Body.CATProduct]
2021-01-12 SU Mise en place porte moyeu dans roue équipée
    [Front Left Wheel Assy.CATProduct, Rear Left Wheel Assy.CATProduct, SU_A1000 (Front Left Upright).CATProduct, SU_A1100 (Rear Left Upright).CATProduct]
2021-01-12 Auto stash before rebase of "origin/master"
    [BR_01001 (Front Brake Caliper AP-CP4227-2).CATPart, BR_01001 (front Brake Disc).CATPart, BR_02001 (Rear Brake Caliper AP-CP).CATPart, BR_02001 (Rear Brake Disc).CATPart, BR_02002 (Rear Brake caliper).CATPart, BR_02003 (Rear Brake Pad).CATPart, BR_02004 (Symmetry of BR_02003).CATPart, BR_03001 (Master Cylinder).CATPart]
2021-01-12 push BAR + modif params
    [SU_14001 (Front ARB).CATProduct.CATPart, SU_A1400 (Front ARB).CATProduct, params.xlsx]
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2021-01-12 params+porte couteaux + couteaux + barre
    [SU_14001 (Front ARB).CATProduct.CATPart, SU_14002 (blade).CATProduct.CATPart, SU_14005 (blade support).CATProduct.CATPart, SU_A1400 (Front ARB).CATProduct, params.xlsx]
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2021-01-13 Steering shaft pivot v2
    [FR_Frame.CATProduct, ST_02001 (Steering Column).CATPart, ST_02004 ( U-Joint) HPC - GD1-A-16_16.CATProduct, ST_A0200 (steering column assembly).CATProduct, ST_A06003_1.CATPart, ST_Steering.CATProduct, Steering column assembly wireframe.CATPart]
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2021-01-13 ST Mise en place roulement axe volant
    [ST_A0600 (Steering Shaft Pivot).CATProduct, ST_Steering.CATProduct, W_61806_PART1.CATPart, W_61806_PART2.CATPart, W_61806_PART3.CATPart, W_61806_bearing.CATProduct]
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2021-01-16 Front left upright (pas fini encore)
    [SU_10001 (Front Left Upright).CATPart]
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2021-01-16 WT Mise en place Hub
    [Front Left Wheel Assy.CATProduct, Rear Left Wheel Assy.CATProduct, WT_02001 (Front Hub).CATPart, WT_03001 (Rear Hub).CATPart, WT_A0200 (Front Hub).CATProduct, WT_A0300 (Rear Hub).CATProduct]
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2021-01-27 Mise en place EL
    [EL_A0100 (Dash panel).CATProduct, EL_A0200 (Wire Harness).CATProduct, EL_A0400 (sensors).CATProduct, EL_A0600 (Kill Switch).CATProduct, EL_A0700 (Relays).CATProduct, EL_A0800 (TSAL).CATProduct, EL_A0900 Control Unit.CATProduct, EL_Electrical.CATProduct]
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2021-01-28 wireframe ARB
    la modification du param ne fait rien casser
    [ARB Wireframe.CATPart, params.xlsx]
2021-01-28 barre torsion + porte couteaux
    [SU_14001 (torsion bar).CATPart, SU_14005 (blade support).CATPart]
2021-01-29 ST Résolution problème mise à jour
    Des contraintes n'étaient pas cohérente ce qui empêchait la mise à jour
    [ST_02001 (Steering Column).CATPart, ST_02004 ( U-Joint) HPC - GD1-A-16_16.CATProduct, ST_A0200 (steering column assembly).CATProduct, ST_Steering.CATProduct, Steering column assembly wireframe.CATPart]
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2021-01-29 SU ARB Remise en forme
    [ARB Wireframe.CATPart, SU_14001 (torsion bar).CATPart, SU_14005 (blade support).CATPart, SU_A1400 (Front ARB).CATProduct]
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2021-01-29 mise a jour ARB
    [ARB Wireframe.CATPart, SU_14001 (torsion bar).CATPart, SU_14005 (blade support).CATPart, SU_A1400 (Front ARB).CATProduct, Suspension.CATProduct]
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2021-02-02 Front left upright catia
    [SU_10001 (Front Left Upright).CATPart]
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2021-02-02 WT Front hub catia
    [WT_02001 (Front Hub).CATPart]
2021-02-02 Ajout de pièce à l'assemblage steering shaft pivot
    [FR_Frame.CATProduct, ST_A0600 (Steering Shaft Pivot).CATProduct, ST_A06001 (Steering upper shaft).CATPart, ST_A06004 (QR Shaft).CATPart, ST_A06005 (Circlips M30).CATPart, ST_Steering.CATProduct]
2021-02-03 MAJ Points LAS
    Lotus points v29a
    [F Wheel.CATPart, Front Left Wheel Assy.CATProduct, Front_Tie_Rod_Wireframe.CATPart, LotusPoints.CATPart, ST_02001 (Steering Column).CATPart, ST_02004 ( U-Joint) HPC - GD1-A-16_16.CATProduct, ST_03001 ( rod tube).CATPart, ST_A0200 (steering column assembly).CATProduct]
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2021-02-03 MAJ points LAS
    Lotus points v30a
    [F Wheel.CATPart, Front_Tie_Rod_Wireframe.CATPart, LotusPoints.CATPart, ST_02001 (Steering Column).CATPart, ST_02004 ( U-Joint) HPC - GD1-A-16_16.CATProduct, ST_03001 ( rod tube).CATPart, ST_A0200 (steering column assembly).CATProduct, ST_A0300 (Connecting rod).CATProduct]
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2021-02-03 Contraintes sur ST Steering + fixation U joint
    [FR_Frame.CATProduct, ST_A0200 (steering column assembly).CATProduct, ST_A0600 (Steering Shaft Pivot).CATProduct, ST_A06003_1.CATPart, ST_A06006 (Fixation U Joint).CATProduct, ST_A06006.CATPart, ST_Steering.CATProduct]
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2021-02-03 Fix Bug colonne
    [ST_02001 (Steering Column).CATPart, ST_A0200 (steering column assembly).CATProduct, ST_Steering.CATProduct]
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2021-02-05 SU Mise en place shock absorber
    [Front shock absorber wireframe.CATPart, Rear shock absorber wireframe.CATPart, SU_05002 (Ohlins ball joint spacer M8 20mm).CATPart, SU_07002 (Ohlins ball joint spacer M8 20mm).CATPart, SU_A0700 (Front shock absorber assembly).CATProduct, SU_A0900 (Rear shock absorber Assembly).CATProduct, ShockAbsorber.CATProduct, Shock_Piston.CATPart]
2021-02-05 simulation pignon + màj cannelures
    [EN_01002 (flanged shaft) v3.CATPart, EN_01003 (engine sprocket).CATPart]
2021-02-07 MAJ Front rocker
    Ajout matière pour éviter casse si MAJ points LAS
    [SU_06001 (Front Rocker).CATPart, SU_A0600 (Front Bell Crank).CATProduct, Symmetry of SU_06001 (Front Rocker).CATPart]
2021-02-07 Maj BOM plus support rack v2
    [Rack_Chape_Wireframe.CATPart, ST_01002_01 (Bracket_right).CATPart, ST_01002_02 (Bracket_left).CATPart, ST_01002_left (Bracket_Assy_left).CATProduct, ST_01002_right (Bracket_Assy_right).CATProduct, ST_01003_01 (Half Moon_below).CATPart, ST_01003_02 (Half Moon top).CATPart, ST_04001 (Half Moon top).CATPart]
2021-02-07 SU Replacement de l'amortisseur avant
    [Suspension.CATProduct]
2021-02-07 SU/ST Maj point LAS v33
    Sur Lotus, travail sur l'arrière
    [01-Evolution_paramètres.txt]
2021-02-07 MAJ Points LAS v33
    Lotus points v33a
    [15x1.5.CATProduct, 20x1.5.CATProduct, 25x1.5.CATProduct, EL_Electrical.CATProduct, EN_A0100 (Engine).CATProduct, EN_Engine_Drivetrain.CATProduct, FRA0500 (CrashBox + AIP).CATProduct, FR_02002 (Side plates).CATPart]
2021-02-07 MAJ du fichier évolution des parametres des points LAS
    [01-Evolution_paramètres.txt]
2021-02-07 Premier jet simu chapes moteur
    [20x1.5.CATProduct, FR_Filaire.CATPart, FR_Frame.CATProduct, Shape_227.CATPart, Shape_231.CATPart, Tubes.CATProduct]
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2021-02-08 Avancement Patte renfort double_cardan
    [ST_A0600 (Steering Shaft Pivot).CATProduct, ST_A06003_1.CATPart, ST_A06006.CATPart, ST_Steering.CATProduct]
2021-02-09 Correction Bug ST_A0400
    [ST_03001 ( rod tube).CATPart, ST_03002 (insert left).CATPart, ST_A0300 (Connecting rod).CATProduct, ST_A0400 ( Rack support) .CATProduct, ST_A0400.CATProduct, ST_Steering.CATProduct]
2021-02-09 SU/ST Points LAS v34
    Lotus déplacement point amo ar
    [01-Evolution_paramètres.txt]
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2021-02-09 ajout bspd, discharge circuit, data logger
    [EL_06005 (BSPD box).CATPart, EL_1200x (Discharge circuit box).CATPart, EL_1400x (Data Logger box).CATPart]
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2021-02-09 SU Ajout Tie rod
    [SU_05001 (Tie rod).CATPart, SU_A0500 (Tie Rod).CATProduct, params.xlsx, toe rod.CATPart]
2021-02-09 placement approximatif éléments élec
    [EL_A0600 (Kill Switch).CATProduct, EL_Electrical.CATProduct]
2021-02-09 mise en place des éléments élec dans la cellule arrière
    [EL_A0600 (Kill Switch).CATProduct, EL_A0900 Control Unit.CATProduct, EL_A1000 (Accumulator).CATProduct, EL_Electrical.CATProduct]
2021-02-09 Changer position des trous
    [SU_10002 (Upper Arm Bracket).CATPart]
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2021-02-09 SU/ST Points LAS v 35
    [01-Evolution_paramètres.txt]
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2021-02-10 MAJ point LAS v35
    Lotus points v35a
    [15x1.5.CATProduct, 20x1.5.CATProduct, EL_02002 (Discharge circuit box).CATPart, EL_06005 (BSPD box).CATPart, EL_06010(HVD)(volume enveloppe).CATPart, EL_A0200 (Wire Harness).CATProduct, EL_A0600 (Kill Switch).CATProduct, EL_A1000 (Accumulator).CATProduct]
2021-02-10 Modif Renfort fixation U joint
    [ST_A06006.CATPart]
2021-02-10 Ajout rotule + modif renfort rotule
    [FR_Frame.CATProduct, ST_02001 (Steering Column).CATPart, ST_02004 ( U-Joint) HPC - GD1-A-16_16.CATProduct, ST_A0200 (steering column assembly).CATProduct, ST_A0600 (Steering Shaft Pivot).CATProduct, ST_A06006.CATPart, ST_A06007 (Ball Joint).stp, ST_A06007.CATPart]
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2021-02-10 Steering rack support v2
    [ST_A0400 ( Rack support) .CATProduct]
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2021-02-10 Ajout ecrou x2 + rondelle et mise en place système renfort U joint
    [Ecrou H M16.1.CATPart, Ecrou H M16_New_156.CATPart, Rondelle_M16.CATPart, ST_A0600 (Steering Shaft Pivot).CATProduct, ST_A06006.CATPart, ST_Steering.CATProduct]
2021-02-10 Mise en place contrainte + ajustement renfort U joint
    [ST_02001 (Steering Column).CATPart, ST_02004 ( U-Joint) HPC - GD1-A-16_16.CATProduct, ST_A0200 (steering column assembly).CATProduct, ST_A0600 (Steering Shaft Pivot).CATProduct, ST_A06006.CATPart, ST_Steering.CATProduct, Steering column assembly wireframe.CATPart]
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2021-02-10 ajustement inserts nouvelles rotules
    [SU_01003 (Front Upper Rod-End Support).CATPart, SU_01004 (Inner Bearing Support).CATPart, SU_02003 (Front Lower Rod-End Support).CATPart, SU_03003 (Rear Upper Rod-End Support).CATPart, SU_04003 (Rear Lower Rod-End Support).CATPart, params.xlsx]
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2021-02-10 maj appui tete 2
    [FR_09002 (Brackets up).CATPart, FR_09004 (Brackets down).CATPart, FR_A0900 (Head Restraint).CATProduct, Frame&Body.CATProduct]
2021-02-10 maj appui tete 3, la derr
    [FR_A0900 (Head Restraint).CATProduct]
2021-02-10 Premier essais de châssis pédalier usiné - Throttle
    [FR_03001_frame_throttle.CATPart]
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2021-02-11 MAJ géométrie frame throttle
    [FR_03001_frame_throttle.CATPart]
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2021-02-11 MAJ placement perçage potentiomètre
    [FR_03001_frame_throttle.CATPart]
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2021-02-11 ST/FR Descente du volant de 67mm
    Pour respecter T2.6.8
    [FrameWireframe.CATPart, Front_Tie_Rod_Wireframe.CATPart, Rack_Chape_Wireframe.CATPart, ST_02001 (Steering Column).CATPart, ST_02004 ( U-Joint) HPC - GD1-A-16_16.CATProduct, ST_03001 ( rod tube).CATPart, ST_07002 (Shift_Spacer Light).CATPart, ST_A0200 (steering column assembly).CATProduct]
2021-02-11 placement chaîne à droite+màj pignon+ajout roulement à rouleau
    [EN_01002 (flanged shaft) v2.CATPart, EN_01003 (engine sprocket).CATPart, EN_A0100 (Engine).CATProduct, EN_Engine_Drivetrain.CATProduct, N_206_ECP.catproduct, N_206_ECP_17.catpart, N_206_ECP_19.catpart, N_206_ECP_21.catpart]
2021-02-11 ST Rapproche la column
    Suite
    [FrameWireframe.CATPart, Rack_Chape_Wireframe.CATPart, ST_02001 (Steering Column).CATPart, ST_02004 ( U-Joint) HPC - GD1-A-16_16.CATProduct, ST_A0200 (steering column assembly).CATProduct, ST_A0400 ( Rack support) .CATProduct, ST_A0600 (Steering Shaft Pivot).CATProduct, ST_A06003_1.CATPart]
2021-02-11 ajout engine scatter shield
    [EN_01006 (stator scatter shield).CATPart, EN_01007 (rotor scatter shield round).CATPart, EN_01008 (rotor scatter shield flat).CATPart, EN_A0100 (Engine).CATProduct, EN_A0400 (Drivetrain).CATProduct, EN_Engine_Drivetrain.CATProduct]
2021-02-12 ST Correction sur shaft pivot
    [ST_A0600 (Steering Shaft Pivot).CATProduct, ST_A06003_1.CATPart, ST_A06006.CATPart]
2021-02-12 ST Nvelle Géométrie renfort fixation U joint
    [ST_06008.CATPart, ST_A0600 (Steering Shaft Pivot).CATProduct, ST_A06006.CATPart]
2021-02-12 ST A0600 Modif et correction bug
    [ST_06008.CATPart, ST_A0600 (Steering Shaft Pivot).CATProduct, ST_A06006.CATPart]
2021-02-13 ST A0600 Correction bug v2
    [ST_06008.CATPart, ST_A0600 (Steering Shaft Pivot).CATProduct, ST_Steering.CATProduct]
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2021-02-13 nomenclature seat & driver
    [MS_01001 (Seat).CATPart, MS_01003 (Driver v2).CATProduct, MS_01005 (Driver v3) (Small size).CATProduct, MS_A0100 (Seat & Driver).CATProduct]
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2021-02-13 màj scatter shield + modif moyeu & pignon
    [EN_01002 (flanged shaft) v2.CATPart, EN_01003 (engine sprocket).CATPart, EN_01004 (rondelle de serrage).CATPart, EN_01006 (stator scatter shield).CATPart, EN_01007 (rotor scatter shield round).CATPart, EN_A0100 (Engine).CATProduct]
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2021-02-14 Mise en position des connecteurs
    [EN_Engine_Drivetrain.CATProduct, Valkyriz.CATProduct]
2021-02-14 position de connecteur de batterie
    [EL_A1000 (Accumulator).CATProduct, EL_Electrical.CATProduct, EN_Engine_Drivetrain.CATProduct, Valkyriz.CATProduct]
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2021-02-15 Correctif HV Wiring
    [3d2-pg-metr-25.CATPart, Accumulator_Discharge_P.CATPart, Accumulator_data_logger_N.CATPart, Data_logger_Inverter_N.CATPart, Discharge_Inverter_P.CATPart, EL_02001 (HV Wires).CATProduct, EL_0200X (Connector).CATPart, EL_06004 (BSPD box).CATPart]
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2021-02-15 Résolution conflit MOT Steering
    Conflit Elec ZHOU
    [ST_A0400 ( Rack support) .CATProduct, ST_Steering.CATProduct]
2021-02-15 ST Mise en place ST_A0400
    Suite et fin des problèmes
    [Rack_Chape_Wireframe.CATPart, Rack_support_Wireframe.CATPart, ST_04001 (Half Moon top).CATPart, ST_04002 (Half Moon below).CATPart, ST_04003 (Left bracket).CATPart, ST_04003 (bracket).CATPart, ST_A0400 ( Rack support) .CATProduct, ST_A0400 (Rack support) .CATProduct]
2021-02-15 ST_A0400 V2
    Modification du half moon
    [Rack_support_Wireframe.CATPart, ST_04001 (Half Moon top).CATPart, ST_04002 (Half Moon below).CATPart, ST_04003 (bracket).CATPart, ST_A0400 (Rack support) .CATProduct]
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2021-02-15 ajout plaque pour tenir moteur & diff style MIT
    [EN_01002 (flanged shaft) v2.CATPart, EN_01XXX.CATPart, EN_A0100 (Engine).CATProduct]
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2021-02-16 Tri ST_A0400 + modif half moon
    [ST_01002_01 (Bracket_right).CATPart, ST_01002_02 (Bracket_left).CATPart, ST_01002_left (Bracket_Assy_left).CATProduct, ST_01002_right (Bracket_Assy_right).CATProduct, ST_01003_01 (Half Moon_below).CATPart, ST_01003_02 (Half Moon top).CATPart, ST_04001 (Half Moon top).CATPart, ST_04002 (Half Moon below).CATPart]
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2021-02-16 Rack support bracket v1
    [ST_04003 (bracket).CATPart, ST_A0400 (Rack support) .CATProduct]
2021-02-16 SU MAJ track bracket
    [SU_10001 (Front Left Upright).CATPart, SU_10005 (track bracket).CATPart, SU_A1000 (Front Left Upright).CATProduct]
2021-02-16 Modification nom pièce radiateur
    [EN_02001 (Radiator).CATPart]
2021-02-16 chape test container 1
    [FR_010001 (Chape_test_1).CATPart]
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2021-02-16 Assemblage rear upright + modif shim
    [SU_11002 (Upper arm bracket).CATPart, SU_11003 (Camber Shim).CATPart, SU_A1100 (Rear Left Upright).CATProduct, WT_02007 (Wheel Bearing).CATPart]
2021-02-16 inserts triangles sur maquette
    [SU_A0200 (Front Lower A-Arms).CATProduct]
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2021-02-16 rotules suspension sur maquette
    [ASKUBAL_G_8_D0_0.catproduct, ASKUBAL_G_8_D0_0_3.catpart, ASKUBAL_G_8_D0_0_5.catpart, ASKUBAL_G_8_D0_0_7.catpart, SU_02003 (Front Lower Rod-End Support).CATPart, SU_A0100 (Front Upper A-Arm).CATProduct, SU_A0200 (Front Lower A-Arms).CATProduct, SU_A0300 (Rear Upper A-Arms).CATProduct]
2021-02-16 Ref externe Rack Suppport
    [ST_05001.CATPart, ST_A0500.CATProduct, ST_Steering.CATProduct, Suspension.CATProduct]
2021-02-16 fichier qui disparait tout seul
    [ASKUBAL_G_8_D0_0.catproduct]
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2021-02-16 roulements avant + nomenclature
    [SU_A0100 (Front Upper A-Arm).CATProduct, SU_A0200 (Front Lower A-Arms).CATProduct, SU_A0300 (Rear Upper A-Arms).CATProduct, SU_A0400 (Rear Lower A-Arm).CATProduct, SU_A1000 (Front Left Upright).CATProduct, SU_A1100 (Rear Left Upright).CATProduct]
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2021-02-16 Ajout radiateur sur maquette
    [EN_A0100 (Engine).CATProduct, EN_A0200 (Cooling system).CATProduct, EN_A0400 (Drivetrain).CATProduct, EN_Engine_Drivetrain.CATProduct]
2021-02-16 Ajout Pompe assemblage EN
    [EN_A0200 (Cooling system).CATProduct]
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2021-02-16 Ajout pompe circulation eau
    [EN_A0200 (Cooling system).CATProduct, EN_Engine_Drivetrain.CATProduct]
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2021-02-16 ST_A0500 v4
    plus tri
    [ST_05001.CATPart, ST_0700 (protection rack).CATPart, ST_A0500.CATProduct, ST_Steering.CATProduct, Suspension.CATProduct]
2021-02-16 ST_A0400 rack support
    A vérifier
    [ST_04003 (bracket).CATPart, ST_05001.CATPart, ST_A0400 (Rack support) .CATProduct, ST_Steering.CATProduct]
2021-02-16 SU/ST Maj point LAS v36
    Allongement de l'empattement de 35mm
    [01-Evolution_paramètres.txt]
2021-02-16 SU Maj tubes et cache contraintes
    Maj rayon tubes -> comme l'an dernier
    Caches contraintes dans divers assemblages et caches plan, repères et wire
    [ARB Wireframe.CATPart, ASKUBAL_G_8_D0_0_3.catpart, ASKUBAL_G_8_D0_0_5.catpart, ASKUBAL_G_8_D0_0_7.catpart, F Wheel.CATPart, F pullpush rod.CATPart, FL A-Arm.CATPart, FU A-Arm.CATPart]
2021-02-17 ST_Steering Rack support + protection
    [Rack_support_Wireframe.CATPart, ST_04002 (Half Moon below).CATPart, ST_04003 (Left Bracket).CATPart, ST_05001.CATPart, ST_A0400 (Rack support) .CATProduct, ST_Steering.CATProduct]
2021-02-17 ST_0500 Ajout Chape
    Chape rack protectio,
    [ST_04003 (bracket compliqué).CATPart, ST_05001.CATPart, ST_05002 (Chape Av).CATPart, ST_05003 (Chape AR).CATPart, ST_A0500.CATProduct]
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2021-02-17 Changement chaine et dents couronne
    [EN_04002(Chain).CATProduct, EN_04003(Driven sprocket).CATPart, EN_A0400 (Drivetrain).CATProduct, EN_Engine_Drivetrain.CATProduct, Enveloppe_couronne.CATPart, Frame.CATPart, Valkyriz.CATProduct]
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2021-02-17 ST Normalisation Nom instance pieces
    [Rondelle_M16.CATPart, ST_06001 (Steering upper shaft).CATPart, ST_06002 (Steering Bore).CATPart, ST_06002_STEERING BORE.CATPart, ST_06003 (Right Fixation Tube).CATProduct, ST_06004 (QR Shaft).CATPart, ST_06005 (Circlips M30).CATPart, ST_06006 (Fixation U Joint).CATProduct]
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2021-02-17 ST Deplacement du shaft Pivot en x de 35mm
    [ST_06003 (Right Fixation Tube).CATProduct, ST_06003_1.CATPart, ST_A0600 (Steering Shaft Pivot).CATProduct, ST_A06003_1.CATPart, ST_A06006.CATPart, ST_Steering.CATProduct]
2021-02-17 SU/ST Maj lotus des points LAS v37a
    V36a fausse, réel allongement dans la v37a
    [01-Evolution_paramètres.txt]
2021-02-17 ST Rapprochement du cardan et du volant
    36 mm de rapprochement
    [FrameWireframe.CATPart, ST_02001 (Steering Column).CATPart, ST_02004 ( U-Joint) HPC - GD1-A-16_16.CATProduct, ST_A0200 (steering column assembly).CATProduct, Steering column assembly wireframe.CATPart, SteeringWireframe.CATPart, WireframeDefinition.CATProduct]
2021-02-17 SU Maj nomenclature Rotules
    [ASKUBAL_G_8_D0_0.catproduct, SU_10005 (track bracket).CATPart, SU_A0100 (Front Upper A-Arm).CATProduct]
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2021-02-17 MAJ Points LAS v37
    [15x1.5.CATProduct, 20x1.5.CATProduct, 25x1.5.CATProduct, FR_Filaire.CATPart, FR_Frame.CATProduct, FrameWireframe.CATPart, LotusPoints.CATPart, R Rocker.CATPart]
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2021-02-17 ST_A0600 v3 nouvelle configuration avec le volant + proche du pilote
    [ST_06001 (Steering upper shaft).CATPart, ST_06006 (Fixation U Joint).CATProduct, ST_06008.CATPart, ST_06011 (Nut H M16).CATPart, ST_A0600 (Steering Shaft Pivot).CATProduct, ST_A06006.CATPart, ST_Steering.CATProduct]
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2021-02-17 ST Normalisation Nom Instance Pieces v2
    [Ecrou H M16.1.CATPart, Ecrou H M16_New_156.CATPart, ST_06006 (Fixation U Joint).CATProduct, ST_06006 (Fixation U joint).CATPart, ST_06008 (Plaque).CATPart, ST_06008.CATPart, ST_A0600 (Steering Shaft Pivot).CATProduct, ST_A06006.CATPart]
2021-02-17 ST_A0600 Normalisation dénomination contrainte
    [ST_A0600 (Steering Shaft Pivot).CATProduct]
2021-02-17 modif plaque diff/moteur + changement taille carter moteur
    [EN_01006 (stator scatter shield).CATPart, EN_01007 (rotor scatter shield round).CATPart, EN_01XXX.CATPart, EN_A0100 (Engine).CATProduct]
2021-02-18 Ajout attaches chapes sur radiateur
    [EN_02001 (Radiator).CATPart]
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2021-02-18 Chapes pour fixer radiateur
    Création des pièces
    [EN_02003 (High Screed).CATPart, EN_02003 (Low screed).CATPart, EN_02003 (Transverse Screed).CATPart]
2021-02-18 Modification Chape du bas radiateur
    [EN_02003 (Low screed).CATPart]
2021-02-18 Modification chape transverse et haute
    [EN_02003 (High Screed).CATPart, EN_02003 (Low screed).CATPart, EN_02003 (Transverse Screed).CATPart]
2021-02-18 Ajoute chapes bas et transverse sur Cooling system
    [EN_02001 (Radiator).CATPart, EN_A0200 (Cooling system).CATProduct]
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2021-02-18 Ajout de toutes les chapes radiateur et contraintes
    [EN_02001 (Radiator).CATPart, EN_02003 (High Screed).CATPart, EN_02003 (Low screed).CATPart, EN_02003 (Transverse Screed).CATPart, EN_A0200 (Cooling system).CATProduct, EN_Engine_Drivetrain.CATProduct]
2021-02-18 Ajout attache chapes/structure tubulaire
    [EN_A0200 (Cooling system).CATProduct, EN_Engine_Drivetrain.CATProduct, Fixation chape-structure tubulaire.CATPart]
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2021-02-18 réparation collision bracket arrière
    [SU_11002 (Upper arm bracket).CATPart, SU_A1100 (Rear Left Upright).CATProduct]
2021-02-18 réparation bracket arrière 2
    [SU_11002 (Upper arm bracket).CATPart, SU_A1100 (Rear Left Upright).CATProduct, Suspension.CATProduct]
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2021-02-18 MAJ contrainte port-couronne + roulement
    [EN_04001 (Excentrique).CATPart, EN_04002(Chain).CATProduct, EN_A0400 (Drivetrain).CATProduct]
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2021-02-19 Importation de la macro de visserie
    [10x100.CATPart, 10x100CHC.CATPart, 10x20.CATPart, 10x20CHC.CATPart, 10x25.CATPart, 10x25CHC.CATPart, 10x30.CATPart, 10x30CHC.CATPart]
2021-02-19 SU Mise en place product des chapes de suspension
    Pour l'instant 2 chapes de test dans l'arbre
    [Suspension.CATProduct, Suspension_chape_assembly.CATProduct, chapetest2.CATPart, testchape.CATPart]
2021-02-19 maj firewall
    contour tube baquet
    [FR_04001 (Middle part).CATPart, FR_04002 (Upper part).CATPart, FR_04003 (Lower part).CATPart, FR_A0400 (Firewall).CATProduct]
2021-02-19 ajout support diff/moteur côté chaîne
    [EN_01005.CATPart, EN_01XXX.CATPart, EN_A0100 (Engine).CATProduct]
2021-02-19 SU suppression doublon visserie
    [10x100.CATPart, 10x100CHC.CATPart, 10x20.CATPart, 10x20CHC.CATPart, 10x25.CATPart, 10x25CHC.CATPart, 10x30.CATPart, 10x30CHC.CATPart]
2021-02-19 SU debut assemblage Front Rocker
    [SU_06001 (Front Rocker).CATPart, SU_A0600 (Front Bell Crank).CATProduct, Symmetry of SU_06001 (Front Rocker).CATPart, params.xlsx]
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2021-02-19 maj frame cellule avant + cockpit
    [15x1.5.CATProduct, 20x1.5.CATProduct, 25x1.5.CATProduct, 28x1.5.CATProduct, 30x2.CATProduct, FR_Filaire.CATPart, FR_Frame.CATProduct, Shape_027.CATPart]
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2021-02-19 modif shaft + calculs RDM
    [EN_01002 (flanged shaft) v2.CATPart, EN_A0100 (Engine).CATProduct]
2021-02-20 ajout inboard tripod housing
    [EN_04004 (Tripod).CATProduct, EN_04008 (Inboard Tripod Housing).CATPart, EN_A0400 (Drivetrain).CATProduct, FSAE Tripod V2.CATPart, FSAE roller_2451.CATPart, Tripod Retainer.CATPart, needle.CATPart]
2021-02-20 Fixation radiateur
    [EN_A0200 (Cooling system).CATProduct, EN_Engine_Drivetrain.CATProduct, FR_Frame.CATProduct]
2021-02-20 Fixation radiateur
    Ajout des attaches chape/chassis
    [EL_A0300 (LV Battery Assembly).CATProduct, EL_Electrical.CATProduct, EN-02003 (Junction Screed-Frame).CATPart, EN_A0200 (Cooling system).CATProduct, EN_Engine_Drivetrain.CATProduct, FR_04003 (Lower part).CATPart, MS_Miscellaneous.CATProduct, Rear Left Wheel Assy.CATProduct]
2021-02-20 SU suite assemblage Front Rocker
    mise en place des vis pour BAR, Triangle et Damper. Rectification : suppression des rondelles côté écrou Knut
    [SU_06001 (Front Rocker).CATPart, SU_A0600 (Front Bell Crank).CATProduct, Symmetry of SU_06001 (Front Rocker).CATPart, params.xlsx]
2021-02-20 Ajout tripodes + chainshield
    ajout des contraintes sur les tripodes + dépôt chainshield autour chaîne (sans contraintes)
    [EN_04004 (Tripod).CATProduct, EN_04008 (Inboard Tripod Housing).CATPart, EN_04010 (Chain shield front).CATPart, EN_04011 (Chain shield rear).CATPart, EN_A0400 (Drivetrain).CATProduct]
2021-02-20 correction facteur d'échelle pédalier
    [Sodemann 31420.CATPart]
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2021-02-20 repositionnement tubes baquet/harnais correction
    [15x1.5.CATProduct, 25x1.5.CATProduct, 28x1.5.CATProduct, 30x2.CATProduct, FR_Filaire.CATPart, FR_Frame.CATProduct, MS_Miscellaneous.CATProduct, Shape_034.CATPart]
2021-02-20 SU suite assemblage Front Rocker
    Mise en place visserie Rod et Suspension. Importation entretoises et spacer. Contraintes à regrouper et cacher
    [PSMF_081206_A51.catpart, SU_05002 (Ohlins ball joint spacer M8 20mm).CATPart, SU_06001 (Front Rocker).CATPart, SU_06002 (pivot joint spacer).CATPart, SU_06003 (ball joint spacer M6 5mm).CATPart, SU_A0600 (Front Bell Crank).CATProduct, Symmetry of SU_06001 (Front Rocker).CATPart, emile_maurin_31_520_6_35.catpart]
2021-02-20 maj firewall
    ajustement autour du tube baquet
    [FR_04001 (Middle part).CATPart, FR_04002 (Upper part).CATPart, FR_04003 (Lower part).CATPart, FR_A0400 (Firewall).CATProduct]
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2021-02-20 maj placement chapes container
    [EL_A1000 (Accumulator).CATProduct]
2021-02-20 Elem finis chassis pedale
    [FR_11001 (Frame Throttle) (version propre).CATPart]
2021-02-20 ajout chape container côté main hoop
    [FR_A01000 (Chape main hoop).CATPart, Frame&Body.CATProduct]
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2021-02-20 maj chape container
    maj chape côté main hoop
    [FR_A01000 (Chape main hoop).CATPart, Frame&Body.CATProduct]
2021-02-20 ajout chappe container 2
    [FR_010001 (Chape_test_1).CATPart, FR_010001 (Chape_test_butterfly).CATPart, FR_010002 (Chape tube vert).CATPart, Frame&Body.CATProduct]
2021-02-20 I added the rear brake bell
    [WT_03002 (Rear Brake Bell).CATPart]
2021-02-20 I added the rear brake bell to the assembly
    [WT_A0300 (Rear Hub).CATProduct]
2021-02-20 Butée positive nouvelle version et elem finis
    [FR_03102 (Throttle Pedal Stick).CATPart, FR_03107 (Negative Throttle Mechanical Stop).CATPart, FR_03108 (Positive Throttle Mechanical Stop).CATPart, FR_11001 (Frame Throttle) (version propre).CATPart, FR_A0310 (Throttle Pedal).CATProduct, butee positive.CATPart]
2021-02-20 Maj pédalier entretoises axes pot
    [Entretoise M3x10.CATPart, FR_03103 (Throttle Fixing Rail).CATPart, FR_11001 (Frame Throttle) (version propre).CATPart, FR_11004 (Throttle Pedal Stick).CATPart, FR_11007 (Throttle Pedal Bearing).CATPart, FR_A0310 (Throttle Pedal).CATProduct, FR_tba_potentio_corps.CATPart, Sodemann 31420.CATPart]
2021-02-20 SU/ST Préparation Wireframedefinition pour simus MECAmaster
    Mise en place des roues + CG
    [F Wheel.CATPart, FrameWireframe.CATPart, R Wheel.CATPart, Symmetry of Wheel.CATPart, Wheel.CATPart, WireframeDefinition.CATProduct]
2021-02-21 SU fin assemblage Front Rocker
    [SU_06001 (Front Rocker).CATPart, SU_A0600 (Front Bell Crank).CATProduct, Symmetry of SU_06001 (Front Rocker).CATPart]
2021-02-21 MAJ finale montage pédale accel
    [FR_03103 (Throttle Fixing Rail).CATPart, FR_11001 (Frame Throttle) (version propre).CATPart, FR_11004 (Throttle Pedal Stick).CATPart, FR_11013 (Axle Throttle Pedal Spacer).CATPart, FR_A0310 (Throttle Pedal).CATProduct, FR_tba_potentio_corps.CATPart, IS0_10511_M8_STEEL_PREVAILING_TORQUE_TYPE_HEXAGON_THIN_NUT.CATPart, M4 nut.2.CATPart]
2021-02-21 Rack protection
    Modif chape
    [ST_05001.CATPart, ST_05002 (Chape Av).CATPart, ST_05003 (Chape AR).CATPart, ST_A0500.CATProduct, ST_Steering.CATProduct]
2021-02-21 Chassis pédale frein 3mm
    [FR_10001 (Frame Brake).CATPart, FR_10003 (Master Cylinder).CATPart, FR_10023 (Brake Fixing Rail).CATPart, FR_A1000 (Brake Pedale).CATProduct]
2021-02-21 SU Premières Chapes triangles
    Chape_Rw_Ua_Fp_Up & Low Bug sur la 2e
    [Chape_Rw_Ua_Fp_Low.CATPart, Chape_Rw_Ua_Fp_Up.CATPart, Suspension_chape_assembly.CATProduct]
2021-02-21 Driveshaft Left
    Arbres de transmission gauche a acheté chez RCV performance
    [EN_04012 (Driveshaft Left).CATPart, EN_04013 (Driveshaft Right).CATPart]
2021-02-21 Driveshaft Left and Right
    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
    [EN_04012 (Driveshaft Left).CATPart, EN_04013 (Driveshaft Right).CATPart]
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2021-02-21 Drexler FS2010
    Différentiel Drexler FS2010
    [400-040-0096-00 Quadring3,68.CATPart, 6010.CATProduct, 6011.CATProduct, Achskegelrad Formula Student 2008 - 2009-oa3.CATPart, Achskegelrad Formula Student 2008 - 2009.CATPart, Anlaufscheilbe 001-oa7.CATPart, Anlaufscheilbe 001.CATPart, Aussenlamelle 001 2010-oa4.CATPart]
2021-02-21 Mise en place Drexler
    [EN_A0100 (Engine).CATProduct, EN_A0200 (Cooling system).CATProduct, EN_A0400 (Drivetrain).CATProduct, EN_Engine_Drivetrain.CATProduct, FR_Frame.CATProduct]
2021-02-21 Mise en place Drexler FS2010
    [EN_04005 (Drexler).CATProduct]
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2021-02-22 Différentiel
    Mise en place
    [EN_A0400 (Drivetrain).CATProduct]
2021-02-22 Modif camber shim et rear upright
    [SU_11001 (Rear Left Upright).CATPart, SU_11003 (Camber shim 1mm).CATPart, SU_11003 (Camber shim 2mm).CATPart, SU_A1100 (Rear Left Upright).CATProduct]
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2021-02-22 ST Changement géométrie Fixation Renfort U Joint
    [ST_06006 (Fixation U joint).CATPart, ST_06008 (Plaque).CATPart, ST_A0600 (Steering Shaft Pivot).CATProduct]
2021-02-22 Mise en place du Différentiel
    ajustement de la position du différentiel
    [EN_04005 (Différentiel Drexler FS2010).CATProduct]
2021-02-22 Mise en place du Différentiel
    Suppressions de fichiers inutiles du document du Diff
    [6010.CATProduct, 6011.CATProduct, Achskegelrad Formula Student 2008 - 2009-oa3.CATPart, Achskegelrad Formula Student 2008 - 2009.CATPart, Anlaufscheilbe 001-oa7.CATPart, Anlaufscheilbe 001.CATPart, Aussenlamelle 001 2010-oa4.CATPart, Aussenlamelle 001 2010-oa5.CATPart]
2021-02-22 Modification circuit de décharge faisceau
    [Accumulator_Discharge_P.CATPart, Accumulator_data_logger_N.CATPart, Data_logger_Inverter_N.CATPart, Discharge_Inverter_P.CATPart, EL_02001 (HV Wires).CATProduct, EL_0200X (Connector).CATPart, EL_A0200 (Wire Harness).CATProduct, EL_Electrical.CATProduct]
2021-02-22 Mise en place du différentiel
    Positionnement du differentiel
    [EN_04005 (Differentiel Drexler).CATProduct, EN_04005 (Différentiel Drexler FS2010).CATProduct, EN_A0400 (Drivetrain).CATProduct, EN_Engine_Drivetrain.CATProduct]
2021-02-22 inner triopde housing
    Décacher
    [EN_Engine_Drivetrain.CATProduct]
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2021-02-22 ajout chappes par feu
    [FR_04004 (Assemblage chappes).CATProduct, FR_04004.1 (Chappe 1).CATPart, FR_04004.2 (Chape 2).CATPart, FR_A0400 (Firewall).CATProduct]
2021-02-22 maj chappes pare feu
    [FR_04004 (Assemblage chappes).CATProduct, FR_04004.2 (Chape 2).CATPart, FR_A0400 (Firewall).CATProduct]
2021-02-22 Ajout assemblage et pièces Vase expansion
    [EN_03001_(Overflow Bottle Body).CATPart, EN_03002_(Overflow cap).CATPart, EN_03003_(Fixation).CATPart, EN_A0300 (Overflow bottles).CATProduct, EN_A0300_(Overflow Bottle).CATProduct]
2021-02-22 Nomenclature et ajout fixation vase expansion
    [EN_03003_(Fixation).CATPart, EN_A0300_(Overflow Bottle).CATProduct]
2021-02-22 Ajout vase expansion et placement pour contrainte
    [EN_A0100 (Engine).CATProduct, EN_A0200 (Cooling system).CATProduct, EN_A0300_(Overflow Bottle).CATProduct, EN_A0400 (Drivetrain).CATProduct, EN_Engine_Drivetrain.CATProduct, FR_Frame.CATProduct]
2021-02-22 Modification fixation vase expansion
    [EN_03003_(Fixation).CATPart]
2021-02-22 Ajustement vase d'expansion pour mise en contrainte
    [EN_03003_(Fixation).CATPart, EN_A0100 (Engine).CATProduct, EN_A0200 (Cooling system).CATProduct, EN_A0300_(Overflow Bottle).CATProduct, EN_A0400 (Drivetrain).CATProduct, EN_Engine_Drivetrain.CATProduct, FR_Frame.CATProduct]
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2021-02-22 ST MAJ point LAS suite à la MAJ de la cellule avant
    [01-Evolution_paramètres.txt]
2021-02-22 MAJ Points LAS pour ST
    [F Wheel.CATPart, Front_Tie_Rod_Wireframe.CATPart, LotusPoints.CATPart, Rack_support_Wireframe.CATPart, ST_02001 (Steering Column).CATPart, ST_02004 ( U-Joint) HPC - GD1-A-16_16.CATProduct, ST_03001 ( rod tube).CATPart, ST_04002 (Half Moon below).CATPart]
2021-02-22 ST Modification complète Shaft Pivot suite MAJ points LAS
    [ST_06001 (Steering upper shaft).CATPart, ST_06003_1.CATPart, ST_06006 (Fixation U joint).CATPart, ST_06008 (Plaque).CATPart, ST_A0600 (Steering Shaft Pivot).CATProduct]
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2021-02-23 maj BAR remise ref
    [ARB Wireframe.CATPart, SU_14001 (torsion bar).CATPart, SU_14004 (blade).CATPart, SU_A1400 (Front ARB).CATProduct, Symmetry of SU_14001.CATPart, Symmetry of SU_14004.CATPart, Symmetry of Symmetry of SU_14004.CATPart]
2021-02-23 SU/ST Points LAS v40 Lotus
    [01-Evolution_paramètres.txt]
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2021-02-23 MAJ Points LAS v40
    [15x1.5.CATProduct, 20x1.5.CATProduct, 25x1.5.CATProduct, ARB Wireframe.CATPart, Chape_Rw_Ua_Fp_Low.CATPart, Chape_Rw_Ua_Fp_Up.CATPart, FR_Filaire.CATPart, FR_Frame.CATProduct]
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2021-02-23 Tube qui avait sauté
    [25x1.5.CATProduct, FR_Filaire.CATPart, FR_Frame.CATProduct, Shape_003.CATPart, Tubes.CATProduct]
2021-02-23 maj nomenclature chape container
    [FR_010001 (Chape tube vert).CATPart, FR_010002 (Chape main hoop).CATPart, FR_010003 (Chape tube jaune).CATPart, FR_010004 (Chape tube bleu).CATPart, FR_A01000 (Chapes container).CATProduct]
2021-02-23 maj nomenclature frame & body
    [Frame&Body.CATProduct]
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2021-02-23 Modification emplacement support MS
    [EL_06002 (support MS bis).CATPart, EL_A0600 (Kill Switch).CATProduct]
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2021-02-23 ST Steering rack support - création d'un wireframe
    [ST_05001.CATPart, ST_05002 (Chape Av).CATPart, ST_05003 (Chape AR).CATPart, ST_05004 (Chape AR).CATPart, ST_A0500.CATProduct, ST_Steering.CATProduct, Wireframe_ST_A0500.CATPart]
2021-02-23 maj nomenclature frame & body
    correction commit précedent
    [Frame&Body.CATProduct]
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2021-02-23 MAJ position batterie + DCDC
    [EL_A0300 (LV Battery Assembly).CATProduct, EL_A1000 (Accumulator).CATProduct, EL_Electrical.CATProduct]
2021-02-23 maj contraintes frame & body
    [Frame&Body.CATProduct]
2021-02-23 maj chape container main hoop
    restriction du volume enveloppe
    [FR_010002 (Chape main hoop).CATPart, Frame&Body.CATProduct]
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2021-02-23 Brake bell smaller
    pour avoir un disque flottant
    [WT_02002 (Brake Bell).CATPart]
2021-02-23 fusion track rod et PM
    [Front Left Wheel Assy.CATProduct, SU_10001 (Front Left Upright).CATPart, SU_10005 (track bracket).CATPart, SU_A1000 (Front Left Upright).CATProduct]
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2021-02-23 Rack protection NEW V1
    [ST_05001 (Rack protection).CATPart, ST_05002 (Front support).CATPart, ST_05003 (Rear support).CATPart, ST_A0500.CATProduct]
2021-02-23 Frein sur rear upright
    [SU_11001 (Rear Left Upright).CATPart]
2021-02-23 SU assemblage rear rocker
    [SU_06001 (Front Rocker).CATPart, SU_08001 (Rear Rocker).CATPart, SU_A0600 (Front Bell Crank).CATProduct, SU_A0800 (Rear Bell Crank).CATProduct, Symmetry of SU_06001 (Front Rocker).CATPart, Symmetry of SU_08001.CATPart]
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2021-02-23 SU reparation rear rocker
    [SU_08001 (Rear Rocker).CATPart, SU_A0800 (Rear Bell Crank).CATProduct, Symmetry of SU_08001.CATPart]
2021-02-23 maj chape container tube bleu
    [FR_010004 (Chape tube bleu).CATPart]
2021-02-23 maj chape containe tube bleu
    correction problème symétrie
    [Frame&Body.CATProduct, Symmetry of FR_010001.CATPart, Symmetry of FR_010002.CATPart, Symmetry of FR_010003.CATPart, Symmetry of FR_010004.CATPart]
2021-02-23 actualisation contraintes frame & body
    [Frame&Body.CATProduct, Symmetry of FR_010004.CATPart]
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2021-02-23 ajustement batterie LV cooling system
    [EL_A0300 (LV Battery Assembly).CATProduct, EN_A0200 (Cooling system).CATProduct, EN_Engine_Drivetrain.CATProduct, Valkyriz.CATProduct]
2021-02-24 WT Réparation Rear Hub WT_03001
    [WT_03001 (Rear Hub).CATPart]
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2021-02-24 WT assemblage rear hub
    [WT_03001 (Rear Hub).CATPart, WT_03002 (Rear Brake Bell).CATPart, WT_03004 (Tripod Housing Spacer).CATPart, WT_A0300 (Rear Hub).CATProduct]
2021-02-24 SU caliper sur rear upright
    [SU_A1100 (Rear Left Upright).CATProduct]
2021-02-24 Relink chain shield
    dépôt + re-contraintes du chain shield
    [EN_04011 (Chain shield rear).CATPart, EN_A0400 (Drivetrain).CATProduct]
2021-02-24 Réparation assemblage rear hub
    [Rear Left Wheel Assy.CATProduct, WT_03001 (Rear Hub).CATPart, WT_A0300 (Rear Hub).CATProduct]
2021-02-24 dépôt outboard tripod housing
    [WT_03003.CATPart]
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2021-02-24 SU visserie sur rear upright
    [SU_11001 (Rear Left Upright).CATPart, SU_A1100 (Rear Left Upright).CATProduct, rondelle_M6.CATPart]
2021-02-24 SU début chape front rocker
    mise en place des repères, plans et créations de la pièce
    [Chape_FrontRocker_R.CATPart, Chape_Rw_Ua_Fp_Up.CATPart, SU_A0600 (Front Bell Crank).CATProduct, Suspension_chape_assembly.CATProduct]
2021-02-24 WT tripod housing sur rear hub
    [WT_03003.CATPart, WT_A0300 (Rear Hub).CATProduct]
2021-02-24 SU réparation chemin d'accès visserie
    [Rear Left Wheel Assy.CATProduct, SU_A1100 (Rear Left Upright).CATProduct]
2021-02-24 MAJ chain shield
    réparation chape
    [EN_04006(Porte_couronne).CATPart, EN_04011 (Chain shield rear).CATPart, EN_A0400 (Drivetrain).CATProduct]
2021-02-24 ST Modif Renfort Fixation U joint après simulation Elem. finis
    [ST_06006 (Fixation U joint).CATPart]
2021-02-24 Ajout deuxième excentrique v1
    [EN_04001 (Excentrique).CATPart, EN_04006(Porte_couronne).CATPart, EN_04007 (Drexler Bearing Right).CATPart, EN_04014 (Drexler Bearing Left).CATPart, EN_04015 (Excentrique Gauche).CATPart, EN_A0400 (Drivetrain).CATProduct]
2021-02-24 SU Réparation Basculeur arrière
    [8x40CHC.CATPart, PSMF_081206_A51.catpart, R Rocker.CATPart, SU_06002 (pivot joint spacer).CATPart, SU_06003 (ball joint spacer M6 5mm).CATPart, SU_08001 (Rear Rocker).CATPart, SU_A0800 (Rear Bell Crank).CATProduct, emile_maurin_31_520_6_35.catpart]
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2021-02-25 Ajout pièce pour HVD
    [EL_06010 (HVD Assembly).CATProduct]
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2021-02-25 Modification attache radiateur
    ajout rotule partie supérieur et recul
    [EN_02001 (Radiator).CATPart, EN_A0200 (Cooling system).CATProduct, EN_Engine_Drivetrain.CATProduct]
2021-02-26 Importation Cas de charges Inv et Opt
    [Cas de charges Invictus.xlsx, Cas de charges Optimus.xlsx]
2021-02-26 SU/ST Mise en place MECAMaster
    Pour l'instant Hyperstatique =1
    [F Rocker.CATPart, F Wheel.CATPart, F pullpush rod.CATPart, FL A-Arm.CATPart, FU A-Arm.CATPart, FrameWireframe.CATPart, MECAmaster - [WireframeDefinition].CATProduct, R Rocker.CATPart]
2021-02-27 MAJ couronne + porte couronne
    [EN_04003(Driven sprocket).CATPart, EN_04006(Porte_couronne).CATPart]
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2021-02-28 Réglage problème MAJ ST_Steering
    [ST_04001 (Half Moon top).CATPart, ST_04002 (Half Moon below).CATPart, ST_04003 (Left Bracket).CATPart, ST_A0400 (Rack support) .CATProduct, ST_Steering.CATProduct, Wireframe_ST_A0500.CATPart]
2021-02-28 Ajout boitier data logger
    [03238000_T-238.stp]
2021-02-28 ajout presse-etoupe capteur courrant
    [03238000_T-238.stp, EL_04001 (Data Logger box).CATPart, EL_04001 (Data Logger box).stp, EL_04002 (Cable gland).stp]
2021-02-28 Ajout pièce data logger
    [EL_0200X (Connector).CATPart, EL_04001 (Data Logger box).CATProduct, EL_04002 (Cable gland).stp, EL_04002 (Cable gland)_1.CATPart, EL_A0400 (sensors).CATProduct, Part180.CATPart, Part181.CATPart, _NPart1.CATPart]
2021-02-28 Agencement boitier data logger
    [212 OT_1002699_3DSYM.CATPart, 212 UT_1002700_3DSYM.CATPart, Accumulator_Discharge_P.CATPart, Accumulator_data_logger_N.CATPart, EL_02001 (HV Wires).CATProduct, EL_02002 (Discharge circuit box).CATPart, EL_02003 (Discharge circuit fixation).CATPart, EL_02004 (current sensor).CATProduct]
2021-02-28 Réparation de la maquette en tout genre SU/ST/WT
    [ARB Wireframe.CATPart, Chape_FrontRocker_R.CATPart, Chape_Rw_Ua_Fp_Low.CATPart, Chape_Rw_Ua_Fp_Up.CATPart, F pullpush rod.CATPart, Front Left Wheel Assy.CATProduct, Front shock absorber wireframe.CATPart, Front_Tie_Rod_Wireframe.CATPart]
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2021-03-01 maj body
    ajout ancier nez pour comparaison
    [FR_02005 (nose invictus original).CATPart, FR_A0200 (Body).CATProduct]
2021-03-01 ajout supports moteur encore une fois, merci de plus péter l'assemblage
    [EN_01002 (flanged shaft) v2.CATPart, EN_01008.CATPart, EN_01009.CATPart, EN_01011 (left bracket).CATPart, EN_01012 (right bracket).CATPart, EN_01XXX.CATPart, EN_A0100 (Engine).CATProduct, EN_A0400 (Drivetrain).CATProduct]
2021-03-02 Ajout d'une chape pour radiateur
    [EN_02003 (Low screed).CATPart, EN_A0200 (Cooling system).CATProduct]
2021-03-02 modif data logger
    modif data logger
    [EL_A0400 (sensors).CATProduct, EL_Electrical.CATProduct]
2021-03-02 Ajout des chapes manquantes
    [EN_02003 (High Screed).CATPart, EN_02003 (Transverse Screed).CATPart, EN_A0200 (Cooling system).CATProduct]
2021-03-02 Allongement d'une chape trop courte
    [EN_02003 (High Screed).CATPart, EN_A0200 (Cooling system).CATProduct]
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2021-03-02 fin réajustement nez invictus
    [FR_02004 (Nose Invictus).CATPart]
2021-03-02 Maj cellule avant chapes LAS
    [15x1.5.CATProduct, 20x1.5.CATProduct, 25x1.5.CATProduct, 28x1.5.CATProduct, FR_Filaire.CATPart, FR_Frame.CATProduct, Shape_002.CATPart, Shape_003.CATPart]
2021-03-02 Maj cellule arrière suspension
    [15x1.5.CATProduct, 20x1.5.CATProduct, FR_Filaire.CATPart, FR_Frame.CATProduct, Shape_214.CATPart, Shape_215.CATPart, Shape_216.CATPart, Shape_217.CATPart]
2021-03-02 Maj cellule avant châssis
    [15x1.5.CATProduct, 20x1.5.CATProduct, 25x1.5.CATProduct, 28x1.5.CATProduct, FR_Filaire.CATPart, FR_Frame.CATProduct, Shape_030.CATPart, Shape_031.CATPart]
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2021-03-02 Mise en position du container
    [EL_A1000 (Accumulator).CATProduct, Part586.CATPart, Part587.CATPart]
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2021-03-03 Suppression lien cassé ST_A0600
    [ST_A0600 (Steering Shaft Pivot).CATProduct]
2021-03-03 SU/ST Pour tuto chapes
    [Chape_Rw_La_Rp_Up.CATPart, Suspension_chape_assembly.CATProduct]
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2021-03-03 ST MAJ Shaft pivot pour régler problème sur esquisse 3
    [ST_06001 (Steering upper shaft).CATPart, ST_06006 (Fixation U joint).CATPart, ST_06008 (Plaque).CATPart, ST_A0600 (Steering Shaft Pivot).CATProduct]
2021-03-03 ST MAJ Shaft Pivot v2
    [ST_06006 (Fixation U joint).CATPart, ST_A0600 (Steering Shaft Pivot).CATProduct]
2021-03-03 MAJ 7mm assemblage ST_A0400 A0500
    [ST_04001 (Half Moon top).CATPart, ST_04002 (Half Moon below).CATPart, ST_04003 (Left Bracket).CATPart, ST_05001 (Front Bracket).CATPart, ST_05003 (Rack Protection).CATPart, ST_A0400 (Rack support) .CATProduct, ST_A0500.CATProduct]
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2021-03-03 maj frame and body avec chappes
    [FR_010003 (Chape tube jaune).CATPart, Frame&Body.CATProduct]
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2021-03-03 WT réparation collision rear hub
    [WT_03001 (Rear Hub).CATPart]
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2021-03-03 SU changement rotules triangles
    [ASKUBAL_G_6_D0_0.catproduct, SU_01003 (Front Upper Rod-End Support).CATPart, SU_01004 (Inner Bearing Support).CATPart, SU_02003 (Front Lower Rod-End Support).CATPart, SU_03003 (Rear Upper Rod-End Support).CATPart, SU_04003 (Rear Lower Rod-End Support).CATPart, SU_A0100 (Front Upper A-Arm).CATProduct, SU_A0200 (Front Lower A-Arms).CATProduct]
2021-03-03 mise en position batterie
    réorganisation du git (pièces EL => FR)
    [FR_010005 (Mise en position 1).CATPart, FR_010006 (Mise en position 2).CATPart, Frame&Body.CATProduct, Part586.CATPart, Part587.CATPart]
2021-03-04 Maj pédalier longueur pédale
    [FR_11004 (Throttle Pedal Stick).CATPart, FR_A0310 (Throttle Pedal).CATProduct, FR_A1000 (Brake Pedale).CATProduct, FR_A1200 (Pedal Assy).CATProduct]
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2021-03-04 SU/ST Résolution de problème sur la maquette
    On peut maintenant bouger la roue avant en plus de l'arrière
    [ARB Wireframe.CATPart, BR_02001 (Rear Brake Disc).CATPart, Rack_support_Wireframe.CATPart, Rear Left Wheel Assy.CATProduct, ST_03001 ( rod tube).CATPart, ST_04001 (Half Moon top).CATPart, ST_04003 (Left Bracket).CATPart, ST_05003 (Rack Protection).CATPart]
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2021-03-05 SU WT réparation collision rear upright, le retour
    [Rear Left Wheel Assy.CATProduct, SU_11001 (Rear Left Upright).CATPart, SU_A1100 (Rear Left Upright).CATProduct, WT_02003 (Front Bearing Washer).CATPart, WT_03001 (Rear Hub).CATPart, WT_03004 (Tripod Housing Spacer).CATPart, WT_A0300 (Rear Hub).CATProduct]
2021-03-05 Ajustement cellule arrière faisceau
    [Accumulator_data_logger_N.CATPart, EL_02001 (HV Wires).CATProduct, EL_04002 (Harness).CATProduct, EL_04005 (Cable gland)_2.CATPart, EL_A0200 (Wire Harness).CATProduct, EL_A0600 (Kill Switch).CATProduct, EL_Electrical.CATProduct, HVD_data_logger.CATPart]
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2021-03-05 Ajout composants discharge circuit
    [DBR71210P.CATPart, EL_02004 (current sensor).CATProduct, EL_02005 (resistance).IGS, EL_02006 (relay).CATProduct, EL_02006 (relay).STEP, EL_A0200 (Wire Harness).CATProduct, Panel mount nut.CATPart]
2021-03-05 SU WT réparation collision rear upright, suite et fin
    [Rear Left Wheel Assy.CATProduct, SU_11001 (Rear Left Upright).CATPart, SU_A1100 (Rear Left Upright).CATProduct, WT_02003 (Front Bearing Washer).CATPart, WT_03001 (Rear Hub).CATPart, WT_03004 (Tripod Housing Spacer).CATPart, WT_A0300 (Rear Hub).CATProduct]
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2021-03-05 SU WT révision rear upright
    [Rear Left Wheel Assy.CATProduct, SU_11001 (Rear Left Upright).CATPart, SU_11002 (Upper arm bracket).CATPart, SU_A1100 (Rear Left Upright).CATProduct, WT_02003 (Front Bearing Washer).CATPart, WT_03001 (Rear Hub).CATPart, WT_03004 (Tripod Housing Spacer).CATPart, WT_A0300 (Rear Hub).CATProduct]
2021-03-05 Elements finis Porte couronne
    [EN_04006(Porte_couronne).CATPart]
2021-03-05 SU modif rear upright
    [SU_11001 (Rear Left Upright).CATPart]
2021-03-05 maj mise en position container
    contrainte frame&body
    [FR_010005 (Mise en position 1).CATPart, FR_010006 (Mise en position 2).CATPart, FR_02004 (Nose Invictus).CATPart, Frame&Body.CATProduct]
2021-03-05 Repositionnement batterie
    batterie remontée dans la cellule arrière
    [Frame&Body.CATProduct, Valkyriz.CATProduct]
2021-03-05 maj mise en position container
    dessin + contraintes
    [FR_010005 (Mise en position 1).CATPart, FR_010006 (Mise en position 2).CATPart, FR_010006 (Mise en position 2.CATPart, Frame&Body.CATProduct]
2021-03-06 MAJ rack protection
    Suite au remarque RT
    [ST_05001 (Front Bracket).CATPart, ST_05002 (Rear Bracket).CATPart, ST_05003 (Rack Protection).CATPart, ST_A0500.CATProduct]
2021-03-06 MAJ Chapes ST
    Suite de la RT
    [ST_04003 (Left Bracket).CATPart, ST_05003 (Rack Protection).CATPart, ST_A0400 (Rack support) .CATProduct, ST_A0500.CATProduct]
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2021-03-06 SU/ST MECAmaster Mise ne place Static
    [FrameWireframe.CATPart, MECAmaster - [WireframeDefinition].CATProduct, Symmetry of Wheel.CATPart, Wheel.CATPart, WireframeDefinition.CATProduct]
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2021-03-07 SU/ST Premiers cas de charges
    La suite ne fonctionne pas pour l'instant
    [Cas de charges Valkyriz.xlsx, FrameWireframe.CATPart, MECAmaster - [WireframeDefinition].CATProduct, WireframeDefinition.CATProduct]
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2021-03-07 Modif chaine + excentrique
    [EN_04001 (Excentrique).CATPart, EN_04002(Chain).CATProduct, EN_04006(Porte_couronne).CATPart, EN_A0400 (Drivetrain).CATProduct, EN_Engine_Drivetrain.CATProduct, Frame.CATPart, Maillon.CATProduct]
2021-03-07 Maj Trou oblong bracket
    [ST_04003 (Left Bracket).CATPart]
2021-03-07 MAJ taille pédalier et assemblage vissé
    [FR_03103 (Throttle Fixing Rail).CATPart, FR_11001 (Frame Throttle) (version propre).CATPart, FR_A0310 (Throttle Pedal).CATProduct]
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2021-03-07 contact excentrique G + roulement
    [EN_04015 (Excentrique Gauche).CATPart, EN_A0400 (Drivetrain).CATProduct, EN_Engine_Drivetrain.CATProduct]
2021-03-08 MAJ modèle récent roulement
    [6010_2Z.catproduct, 6010_2Z_18.catpart, 6010_2Z_3.catpart, 6010_2Z_33.catpart, 6010_2Z_35.catpart, 6011_2Z.catproduct, 6011_2Z_17.catpart, 6011_2Z_3.catpart]
2021-03-08 contrainte chaine et couronne
    [EN_A0400 (Drivetrain).CATProduct]
2021-03-09 SU/ST MECAmaster Cas de charges
    Cas de charges en Static/max Speed/Breaking/Bump
    [MECAmaster - [WireframeDefinition].CATProduct, WireframeDefinition.CATProduct]
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2021-03-09 Tube chelou fix
    [15x1.5.CATProduct, FR_Frame.CATProduct, Shape_004.CATPart, Shape_005.CATPart, Shape_006.CATPart, Shape_007.CATPart, Tubes.CATProduct]
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2021-03-09 Durite
    Tracé durite Pompe-radiateur
    [EN_A0200 (Cooling system).CATProduct]
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2021-03-09 Début simu + réparation tube 228
    [12x2.5.CATProduct, 15x1.5.CATProduct, 20x1.5.CATProduct, 25x1.5.CATProduct, 28x1.5.CATProduct, 30x2.CATProduct, FR_Filaire.CATPart, FR_Frame.CATProduct]
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2021-03-09 Dernière modif CDD et data log
    [01120000_A-120.CATProduct, EL_02008 (Cable Gland).2.CATPart, EL_02008 (Cable Gland).3.CATPart, EL_02010 (Locking nut).1.CATPart, EL_02010 (Locking nut).2.CATPart, EL_A0200 (Wire Harness).CATProduct, EL_A0400 (sensors).CATProduct, EL_Electrical.CATProduct]
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2021-03-09 I modified the hub in order to include the Beringer brake bell
    [Front Left Wheel Assy.CATProduct, SU_10001 (Front Left Upright).CATPart, WT_02001 (Front Hub).CATPart, WT_02002 (Brake Bell).CATPart, WT_02002 (Brake Bell_beringer).CATPart, WT_02003 (Front Bearing Washer).CATPart, WT_A0200 (Front Hub).CATProduct]
2021-03-09 maj contraintes electrical
    repositionnement container
    [EL_Electrical.CATProduct]
2021-03-09 nouvelle chape en tole BAR
    [ARB Wireframe.CATPart, SU_14001 (torsion bar).CATPart, SU_14004 (blade).CATPart, SU_14011 (Chape tole).CATPart, SU_14011 (Chape).CATPart, SU_A1400 (Front ARB).CATProduct, Symmetry of SU_14001.CATPart, Symmetry of SU_14004.CATPart]
2021-03-09 positionnement moteur + modifs supports moteur
    [EN_01008.CATPart, EN_01009.CATPart, EN_A0100 (Engine).CATProduct, EN_Engine_Drivetrain.CATProduct]
2021-03-10 MECAmaster Premiers cas de charges
    Cas plutôt extrêmes
    [Cas de charges Valkyriz.xlsx, MECAmaster - [WireframeDefinition].CATProduct, WireframeDefinition.CATProduct]
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2021-03-10 Rod end steering + basculeurs
    [ASKUBAL_KA_6_D0_0.catproduct, _Gelenkkopf_KI_D_4.catpart, _Rod_ends_KA_6_D_Rod_ends3D_6.catpart, _Rod_ends_KA_6_D_rod_ends3_2.catpart, _Rod_ends_KI__6_D_R_8.catpart]
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2021-03-10 Ajustement boitier data log
    [EL_04002 (Harness).CATProduct, EL_04006 (Connector elbow).CATPart, EL_A0400 (sensors).CATProduct, Segment de harnais11.CATPart, data logger sortie.CATPart]
2021-03-10 suppression mise en position acumulator
    déplacement vers frame&body
    [EL_A1000 (Accumulator).CATProduct]
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2021-03-10 Fin MAJ Archives COST
    [Changelogs.xlsx, Commandes - Optimus 2019.xlsx, Cost.xlsx, Cost_v1.5.xlsx, Facture_La_Mache_2019.xlsx, Fastener_cost.xlsx, Machining volume and time.xlsx, Manufacturing_Gantt.xlsm]
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2021-03-10 Modif ST_A0600 tube en U
    [ST_06006 (Fixation U joint).CATPart, ST_06008 (Plaque).CATPart, ST_A0600 (Steering Shaft Pivot).CATProduct]
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2021-03-10 ST_A0600 Ajout Nut et dished washer
    [ST_A0600 (Steering Shaft Pivot).CATProduct]
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2021-03-10 Ajout espace pour real Cases COST
    [Commandes - Optimus 2019.xlsx, Manufacturing_Gantt.xlsm, Manufacturing_framework.xlsm, Oil pan.CATPart, Plenum partie haute v4.CATPart, données rapport financier.xlsx, ex_gantt_powertrain_system.xls, margin vs volume.xlsx]
2021-03-10 ST_06006 Modif Fixation U joint
    [ST_06006 (Fixation U joint).CATPart, ST_A0600 (Steering Shaft Pivot).CATProduct]
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2021-03-11 maj plaques support container
    [EL_01004Chapeau container.CATPart, EL_A1000 (Accumulator).CATProduct, FR_010007 (Plaque).CATPart, FR_01007 (Plaque châssis).CATPart, Frame&Body.CATProduct]
2021-03-11 SU chape fw la fp low
    j'ai mis tt les refs
    [Chape_Fw_La_Fp_Low.CATPart, Chape_Fw_La_Fp_Up.CATPart, Suspension_chape_assembly.CATProduct, chapetest2.CATPart, testchape.CATPart]
2021-03-11 Modif nombre trou excentriques
    [EN_04001 (Excentrique).CATPart, EN_04015 (Excentrique Gauche).CATPart]
2021-03-12 MAJ Couronne + PCouronne
    [EN_04002(Chain).CATProduct, EN_04003(Driven sprocket).CATPart, EN_04006(Porte_couronne).CATPart, EN_A0400 (Drivetrain).CATProduct, Frame.CATPart, Inner_link.CATPart, Maillon.CATProduct, Outer_Link.CATPart]
2021-03-12 Mise en place de arbres de transmission
    Rallongement des arbres de transmission
    [D5159.CATPart, EN_04012 (Driveshaft Left).CATPart, EN_A0100 (Engine).CATProduct, EN_A0400 (Drivetrain).CATProduct, EN_Engine_Drivetrain.CATProduct, Valkyriz.CATProduct]
2021-03-12 Mise en place arbres de transmission
    Mise en place complète
    [EN_04012 (Driveshaft Left).CATPart, EN_04012 (Driveshaft Right).CATPart, EN_04013 (Driveshaft Right).CATPart, EN_A0400 (Drivetrain).CATProduct, EN_Engine_Drivetrain.CATProduct]
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2021-03-12 renommage dossier
    chapes container => plaque container
    [FR_010001 (Chape tube vert).CATPart, FR_010002 (Chape main hoop).CATPart, FR_010003 (Chape tube jaune).CATPart, FR_010004 (Chape tube bleu).CATPart, FR_010005 (Mise en position 1).CATPart, FR_010006 (Mise en position 2.CATPart, FR_010007 (Plaque).CATPart, FR_A01000 (Chapes container).CATProduct]
2021-03-12 maj plaque container
    ajout mise en position et réorganisation Frame&Body
    [FR_010001 (Plaque).CATPart, FR_010002 (Mise en position).CATPart, FR_010007 (Plaque).CATPart, FR_A01000 (Plaque container).CATProduct, Frame&Body.CATProduct]
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2021-03-12 correction affichage main hoop
    [FR_Filaire.CATPart]
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2021-03-12 EF Porte_courpnne + MAJ chaine
    [EN_04002(Chain).CATProduct, EN_04006(Porte_couronne).CATPart, Inner_link.CATPart, Maillon.CATProduct, Outer_Link.CATPart]
2021-03-12 maj taille trou vis
    [EN_04006(Porte_couronne).CATPart]
2021-03-12 SU/ST Cas de charges MECAmaster
    Ya plus qu'à mettre dans l'excel
    [Cas de charges Invictus.xlsx, Cas de charges Valkyriz.xlsx, MECAmaster - [WireframeDefinition].CATProduct, Symmetry of Wheel.CATPart, Wheel.CATPart, WireframeDefinition.CATProduct]
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2021-03-13 Durites
    Création fichier + tracé de la première entre radiateur et pompe
    [Coolant lines.CATPart, EN_02004 (Coolant lines).CATPart, EN_A0200 (Cooling system).CATProduct, EN_A0400 (Drivetrain).CATProduct, EN_Engine_Drivetrain.CATProduct]
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2021-03-13 maj chapeau container
    début éléments finis
    [EL_01004Chapeau container.CATPart, EL_A1000 (Accumulator).CATProduct]
2021-03-13 new Tripod Housing
    raccourcissement du left inboard tripod housing + re-déf des contraintes
    [EN_04008 (Inboard Tripod Housing).CATPart, EN_04008 (Right Inboard Tripod Housing).CATPart]
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2021-03-13 Mise en page cas de charges MECAmaster
    [Cas de charges Valkyriz.xlsx]
2021-03-13 ST Modif Fixation U Joint et simu
    [ST_06006 (Fixation U joint).CATPart]
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2021-03-13 replacement batterie
    maj des contraintes
    [EL_Electrical.CATProduct, Valkyriz.CATProduct]
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2021-03-14 adaptation support batterie LV
    [EL_03002 (handle).CATPart, EL_03003 (base).CATPart]
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2021-03-14 Durite
    Tracé durites radiateur-moteur et pompe-bamocar
    [Coolant lines.CATPart, EN_A0200 (Cooling system).CATProduct]
2021-03-14 WT Cannelures rear hub
    [WT_03001 (Rear Hub).CATPart]
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2021-03-14 Modifications arbres de transmissions
    [EN_04012 (Driveshaft Left).CATPart, EN_04012 (Driveshaft Right).CATPart, EN_04013 (Driveshaft Right).CATPart, EN_A0400 (Drivetrain).CATProduct, EN_Engine_Drivetrain.CATProduct]
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2021-03-14 contrainte PC et couronne
    [EN_A0400 (Drivetrain).CATProduct]
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2021-03-14 SU Correction épaisseur inserts
    [SU_01003 (Front Upper Rod-End Support).CATPart, SU_01004 (Inner Bearing Support).CATPart, SU_02003 (Front Lower Rod-End Support).CATPart, SU_03003 (Rear Upper Rod-End Support).CATPart, SU_04003 (Rear Lower Rod-End Support).CATPart, params.xlsx]
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2021-03-14 début tubes carrés pour attache container
    [FR_010007 (Tube carre).CATPart, FR_010007.CATPart]
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2021-03-14 Publication vis + trou vis PC
    [EN_04003(Driven sprocket).CATPart, EN_04006(Porte_couronne).CATPart]
2021-03-14 maj tubes carrés
    amélioration EF
    [FR_010007 (Tube carre).CATPart]
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2021-03-15 SU chape Fw La
    [Chape_Fw_La_Fp_Low.CATPart, Chape_Fw_La_Fp_Up.CATPart, Suspension_chape_assembly.CATProduct]
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2021-03-15 trou chape pour fixer la protection de la crémaillère
    [SU_14011 (Chape tole).CATPart]
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2021-03-15 Maj porte-couronne et vis
    [EN_04006(Porte_couronne).CATPart, EN_A0400 (Drivetrain).CATProduct]
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2021-03-15 maj floor pan
    réduction longueur derrière la pare-feu
    [FR_A0802 (Cockpit plate).CATPart]
2021-03-15 Maj problème BOTS et Butée positive accel
    [FR_03103 (Throttle Fixing Rail).CATPart, FR_03107 (Negative Throttle Mechanical Stop).CATPart, FR_10001 (Frame Brake).CATPart, FR_11001 (Frame Throttle) (version propre).CATPart, FR_11004 (Throttle Pedal Stick).CATPart, FR_A0310 (Throttle Pedal).CATProduct, butee positive.CATPart]
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2021-03-15 SU_A14 Remise en forme d'une contrainte BAR
    [SU_14011 (Chape tole).CATPart]
2021-03-15 SU A14 Suite de la modif
    [SU_14011 (Chape tole).CATPart]
2021-03-15 SU A14 Suite et fin ?
    [ARB Wireframe.CATPart, SU_14001 (torsion bar).CATPart, SU_14004 (blade).CATPart, SU_14011 (Chape tole).CATPart, SU_14011 (Chape).CATPart, SU_A1400 (Front ARB).CATProduct, Symmetry of SU_14001.CATPart, Symmetry of SU_14004.CATPart]
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2021-03-15 maj chapes support batterie LV
    [EL_03003 (base).CATPart, EL_03004 (screed1).CATPart, EL_03005 (screed2).CATPart, EL_A0300 (LV Battery Assembly).CATProduct]
2021-03-15 début soutien container arrière
    [FR_010007.CATPart, FR_010009 (Tube carre 3).CATPart, FR_01008 (Tube carre 2).CATPart, FR_A_01000 (Tube carre rear).CATProduct]
2021-03-15 Ajout garde, déplacement batterie
    [Handcartv2.CATProduct, garde.CATPart]
2021-03-15 Remise des tripod housing
    suite à push problématique
    [EN_04008 (Inboard Tripod Housing).CATPart, EN_04008 (Right Inboard Tripod Housing).CATPart, EN_04008.2 (Left Inboard Tripod Housing).CATPart, EN_A0400 (Drivetrain).CATProduct]
2021-03-15 SU Cas de charges ARB
    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
    [ARB Wireframe.CATPart, MECAmaster - [WireframeDefinition].CATProduct, WireframeDefinition.CATProduct]
2021-03-15 SU simu rocker
    fonctionne pas
    [SU_06001 (Front Rocker).CATPart, SU_A0600 (Front Bell Crank).CATProduct, Symmetry of SU_06001 (Front Rocker).CATPart]
2021-03-15 Axe pot arrière pédalier
    [axe potentiometre M3 arriere.CATPart]
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2021-03-16 gueule de loup tube arrière
    [FR_010009 (Tube carre 3).CATPart, FR_01008 (Tube carre 2).CATPart, FR_A_01000 (Tube carre rear).CATProduct, Frame&Body.CATProduct]
2021-03-16 création des tubes symétriques
    [FR_010007 (Tube carre).CATPart, Frame&Body.CATProduct, Symmetry of FR_010007.CATPart, Symmetry of FR_010009.CATPart, Symmetry of FR_01008.CATPart, Symmetry of FR_A01000.CATProduct]
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2021-03-16 left inboard tripod housing
    taille modifiée
    [EN_04008.1 (Right Inboard Tripod Housing).CATPart, EN_A0400 (Drivetrain).CATProduct]
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2021-03-16 Ajout Chappes Support switch
    [Accumulator_data_logger_N.CATPart, Chappe.CATPart, EL_06001(Master switch).CATPart, EL_06002 (support MS bis).CATPart, EL_06004 (BSPD box).CATPart, EL_06006.CATProduct, EL_06010 (HVD Assembly).CATProduct, EL_A0600 (Kill Switch).CATProduct]
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2021-03-16 positionnement cockpit internal cross section template
    [MS_Miscellaneous.CATProduct]
2021-03-16 Réparation EN Cooling system
    [EN_A0200 (Cooling system).CATProduct, EN_Engine_Drivetrain.CATProduct]
2021-03-16 LAS Auto v42
    Alloongement de la track rod
    [01-Evolution_paramètres.txt]
2021-03-16 maj cahpes batterie LV
    [EL_03003 (base).CATPart, EL_03004 (screed1).CATPart, EL_03005 (screed2).CATPart, EL_A0300 (LV Battery Assembly).CATProduct]
2021-03-16 SU pull rod bearing
    [ASKUBAL_KA_6_D0_0.catproduct, SU_A1200 (Front Suspension Rod).CATProduct]
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2021-03-16 MAJ tube carré Accumulator
    [FR_010007 (Tube carre).CATPart]
2021-03-16 SU simulation FRocker Encastrement
    [SU_06001 (Front Rocker).CATPart]
2021-03-16 MAJ Points LAS v42
    [15x1.5.CATProduct, 20x1.5.CATProduct, 25x1.5.CATProduct, 28x1.5.CATProduct, ARB Wireframe.CATPart, Chape_Rw_La_Rp_Up.CATPart, F Wheel.CATPart, FRA0500 (CrashBox + AIP).CATProduct]
2021-03-16 Maj replacement pédalier
    [FR_10001 (Frame Brake).CATPart, FR_10002 (Brake Pedale Stick).CATPart, FR_10003 (Master Cylinder).CATPart, FR_10004 (Distribution Brake Axle).CATPart, FR_10007 (Distribution Brake Axle Tread).CATPart, FR_10008 (Distribution Brake Cylinder).CATPart, FR_10009 (Cylinder Screw Disctribution).CATPart, FR_10011 (Brake Distribution Ball Joint).CATPart]
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2021-03-16 Gueules de loup pour container suite
    [FR_010007 (Tube carre).CATPart, Symmetry of FR_010007.CATPart]
2021-03-16 Modif rangement data logger
    [EL_02003.CATProduct, EL_04001 (Data Logger box).CATProduct, EL_04002 (Harness).CATProduct, EL_04003 (Data logger FSG).CATProduct, EL_A0200 (Wire Harness).CATProduct, EL_Electrical.CATProduct, Produit1.CATProduct]
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2021-03-16 MAJ MS_A0400(Firewall) réparation liens
    [FR_04001 (Middle part).CATPart, FR_04002 (Upper part).CATPart, FR_04003 (Lower part).CATPart, FR_04004 (Assemblage chappes).CATProduct, FR_04004.1 (Chappe 1).CATPart, FR_04004.2 (Chape 2).CATPart, MS_0400(4-5) (Assemblage chappes).CATProduct, MS_04001 (Middle part).CATPart]
2021-03-16 MAJ MS_A0200 réparation liens
    [FR_09001 (Support).CATPart, FR_09002 (Brackets up).CATPart, FR_09003 (Foam).CATPart, FR_09004 (Brackets down).CATPart, FR_A0900 (Head Restraint).CATProduct, Frame&Body.CATProduct, Gabarit Appuie-tete.CATPart, MS_02001 (Support).CATPart]
2021-03-16 Modif jonction durite avec moteur
    [Coolant lines.CATPart]
2021-03-16 suppression dossier inutile Frame&Body
    [FR_010001 (Chape_test_1).CATPart, FR_010001 (Chape_test_butterfly).CATPart, FR_010002 (Chape tube vert).CATPart, FR_A01000 (Chape main hoop).CATPart]
2021-03-16 Changement jonction durite moteur
    [Coolant lines.CATPart]
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2021-03-16 MAJ nomenclature Pédal Accel
    [Entretoise M3x10.CATPart, Exemple_potentiometre.stp, FR_03001_frame_throttle.CATPart, FR_03101 (Frame Throttle).CATPart, FR_03101 (new Frame Throttle).CATPart, FR_031010 (Throttle pedal axis).CATPart, FR_031011 (Throttle pedal bearing).CATPart, FR_03102 (Throttle Pedal Stick).CATPart]
2021-03-16 suppression fichier inutile floor pan
    [FR_08002 (Cockpit plate).CATPart]
2021-03-16 Changement nom fichier et ajout de nouvelles fixations
    [EN_02004 (Low screed).CATPart, EN_02005 (Transverse Screed).CATPart, EN_02006 (Junction Screed_Frame).CATPart, EN_02007 (Junction Screed_Frame 2).CATPart, EN_02008 (Junction Radiator_Frame).CATPart, EN_02009 (Coolant lines).CATPart]
2021-03-16 maj diamètre trous tubes carrés
    [FR_010007 (Tube carre).CATPart, FR_01008 (Tube carre 2).CATPart, Frame&Body.CATProduct]
2021-03-16 Nettoyage dossier pédale accel
    [Entretoise M3x10.CATPart, Exemple_potentiometre.stp, FR_03001_frame_throttle.CATPart, FR_03101 (Frame Throttle).CATPart, FR_03101 (new Frame Throttle).CATPart, FR_031010 (Throttle pedal axis).CATPart, FR_03102 (Throttle Pedal Stick).CATPart, FR_11004 (Throttle Pedal Stick).CATPart]
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2021-03-16 maj accumulator
    ajout épaisseur reprise d'efforts
    [EL_10001 Battery Volume.CATPart, EL_A1000 (Accumulator).CATProduct]
2021-03-16 Filaire mise en place simu
    [FR_Filaire.CATPart, FR_Frame.CATProduct, Valkyriz_rigidité.xlsx]
2021-03-16 SU simu + modif Frocker
    [SU_06001 (Front Rocker).CATPart, SU_A0600 (Front Bell Crank).CATProduct, Symmetry of SU_06001 (Front Rocker).CATPart]
2021-03-16 replacement chapes container
    [EL_A1000 (Accumulator).CATProduct]
2021-03-16 maj symétrie chapes firewall
    [MS_A0400 (Firewall).CATProduct, Symmetry of MS_0400(4-5).CATProduct, Symmetry of MS_04004.CATPart, Symmetry of MS_04005.CATPart]
2021-03-16 suppression contrainte incohérente pédalier
    [FR_A(03-04)00 (Pedal Assy).CATProduct]
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2021-03-16 SU modif inserts post simus
    [SU_01003 (Front Upper Rod-End Support).CATPart, SU_01004 (Inner Bearing Support).CATPart, SU_02003 (Front Lower Rod-End Support).CATPart, SU_03003 (Rear Upper Rod-End Support).CATPart]
2021-03-16 Réorganisation arborescence Throttle Pedal
    [FR_11001 (Frame Throttle) (version propre).CATPart, FR_A0300 (Throttle Pedal).CATProduct]
2021-03-16 maj positionnement tubes carrés
    [FR_010009 (Tube carre 3).CATPart, FR_01008 (Tube carre 2).CATPart, FR_A_01000 (Tube carre rear).CATProduct, Frame&Body.CATProduct, Symmetry of FR_010007.CATPart, Symmetry of FR_A01000.CATProduct]
2021-03-16 Modif connecteur ev engine
    [EL_04006 (Connector elbow).CATPart, EL_06002 (support MS bis).CATPart, EL_A0200 (Wire Harness).CATProduct, EL_A0400 (sensors).CATProduct, EN_A0100 (Engine).CATProduct, EN_Engine_Drivetrain.CATProduct, Motor_phase_1.CATPart, Valkyriz.CATProduct]
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2021-03-16 Ajout chape et modif durite
    [Coolant lines.CATPart, EN_02006 (Junction Screed_Frame).CATPart]
2021-03-16 Rear Bracket ST v2
    [ST_05002 (Rear Bracket).CATPart, ST_05003 (Rack Protection).CATPart, ST_A0500.CATProduct]
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2021-03-16 SU modif rear upright avant simus
    [SU_11001 (Rear Left Upright).CATPart]
2021-03-16 J'ai modifié encore le Hub
    [WT_02002 (Brake Bell_beringer).CATPart]
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2021-03-16 SU / ST rotules rod
    [ST_03001 ( rod tube).CATPart, ST_A0300 (Connecting rod).CATProduct, SU_05001 (Tie rod).CATPart, SU_12001 (Front Suspension Rod).CATPart, SU_13001 (Rear Suspension Rod).CATPart, SU_A0500 (Tie Rod).CATProduct, SU_A1200 (Front Suspension Rod).CATProduct, SU_A1300 (Rear Suspension Rod).CATProduct]
2021-03-16 maj tube carré front
    [FR_010007 (Tube carre).CATPart, Frame&Body.CATProduct]
2021-03-16 maj positionnement chapes container (front)
    [EL_A1000 (Accumulator).CATProduct]
2021-03-16 SU Points LAS v43
    PM arrière pour éviter de toucher le congé
    [01-Evolution_paramètres.txt]
2021-03-16 maj positionnement chapes container (rear)
    [EL_A1000 (Accumulator).CATProduct]
2021-03-16 maj tube carré rear
    [FR_01008 (Tube carre 2).CATPart, FR_A_01000 (Tube carre rear).CATProduct, Frame&Body.CATProduct]
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2021-03-16 ajout quick jack
    pas définitif
    [quickjack.CATPart]
2021-03-16 Ajout durite moteur/inverseur et vase expansion
    [Coolant lines.CATPart, EN_03001_(Overflow Bottle Body).CATPart, EN_Engine_Drivetrain.CATProduct]
2021-03-16 Auto stash before rebase of "origin/master"
    Idem
    [EN_Engine_Drivetrain.CATProduct]
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2021-03-16 venting holes floor pan
    [FR_06002 (Cockpit plate).CATPart]
2021-03-16 SU Point LAS v44
    Oublie de bouger le point 8
    [01-Evolution_paramètres.txt]
2021-03-16 chape container front v2
    [EL_01003 (Chape_test_butterfly).CATPart]
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2021-03-16 suppression fichiers inutiles container
    [EL_01004Chapeau container.CATPart]
2021-03-16 chape container rear v2
    [EL_01004 (Chape rear).CATPart, EL_A1000 (Accumulator).CATProduct, Symmetry of EL_01003.CATPart, Symmetry of EL_01004.CATPart]
2021-03-16 MAJ Points LAS v44
    [15x1.5.CATProduct, 20x1.5.CATProduct, 25x1.5.CATProduct, 28x1.5.CATProduct, Chape_Fw_La_Fp_Low.CATPart, Chape_Fw_La_Fp_Up.CATPart, Chape_Fw_La_Rp_Up.CATPart, Chape_Fw_Ra_Rp_Low.CATPart]
2021-03-16 Nomenclature Pédale Accec MAJ1
    [FR_03103 (Throttle Fixing Rail).CATPart, FR_03104 (Throttle Fixing Rail Wedge).CATPart, FR_03105 (Throttle Threated Rod).CATPart, FR_03106 (Front Throttle Fixing Rail Wedge).CATPart, FR_03107 (Negative Throttle Mechanical Stop).CATPart, FR_03108 (Positive Throttle Mechanical Stop).CATPart, FR_10026 (footrest).CATPart, FR_11004 (Throttle Pedal Stick).CATPart]
2021-03-16 SU réparation collision rear upright
    [SU_11001 (Rear Left Upright).CATPart, SU_A1100 (Rear Left Upright).CATProduct]
2021-03-16 ST Modif Tube Fixation suite MAJ cellule av
    [ST_06003_1.CATPart]
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2021-03-16 Nomenclature Pédale Accel MAJ2
    [FR_03105 (Throttle Threated Rod).CATPart, FR_11013 (Axle Throttle Pedal Spacer).CATPart, FR_A0300 (Throttle Pedal).CATProduct, FR_tba_potentio_corps.CATPart, FR_tba_potentio_tige.CATPart, axe potentiometre M3 arriere.CATPart, axe potentiometre M3.CATPart]
2021-03-16 Ajout chappes data log
    [Data_logger_Inverter_N.CATPart, EL_04009.CATPart, EL_04010.CATPart, EL_04011.CATPart, EL_2008.CATPart, EL_A0200 (Wire Harness).CATProduct, EL_A0300 (LV Battery Assembly).CATProduct, EL_A0400 (sensors).CATProduct]
2021-03-16 ajout pushbar & jackingbar
    [FR_07001 (Pushbar).CATPart, FR_07002 (Quick jack).CATPart, quickjack.CATPart]
2021-03-16 SU début simus rear upright
    [SU_11001 (Rear Left Upright).CATPart, SU_A1100 (Rear Left Upright).CATProduct]
2021-03-16 Nomenclature Pédale Accel FIN <3
    [FR_03001 (Frame Throttle).CATPart, FR_03002 (Footrest).CATPart, FR_03003 (Throttle Pedal Stick).CATPart, FR_03004 (Throttle Fixing Rail).CATPart, FR_03005 (Throttle Fixing Rail Wedge).CATPart, FR_03006 (Throttle Threated Rod).CATPart, FR_03007 (Front Throttle Fixing Rail Wedge).CATPart, FR_03008 (Negative Throttle Mechanical Stop).CATPart]
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2021-03-16 Nomenclature Pédale Frein MAJ1
    [FR_A0400 (Brake Pedal).CATProduct]
2021-03-16 chape container rear v2.1
    [EL_01004 (Chape rear).CATPart, EL_A1000 (Accumulator).CATProduct, EL_Electrical.CATProduct, Symmetry of EL_01004.CATPart]
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2021-03-16 Nomenclature Pédale frein MAJ2
    [FR_04002 (Brake Pedale Stick).CATPart, FR_04004 (Master Cylinder).CATPart, FR_04005 (Master Cylinder Wedge).CATPart, FR_A0400 (Brake Pedal).CATProduct]
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2021-03-16 Nomenclature Pédale Frein MAJ3
    [FR_04002 (Brake Pedale Stick).CATPart, FR_04004 (Master Cylinder).CATPart, FR_04005 (Master Cylinder Wedge).CATPart, FR_04006 (Brake Fixing Rail).CATPart, FR_10023 (Brake Fixing Rail).CATPart, FR_A0400 (Brake Pedal).CATProduct]
2021-03-16 chape container rear v2.2
    correction collision en sortie
    [EL_01004 (Chape rear).CATPart]
2021-03-16 Support bracing plus haut
    [15x1.5.CATProduct, 20x1.5.CATProduct, 25x1.5.CATProduct, 28x1.5.CATProduct, FR_Filaire.CATPart, FR_Frame.CATProduct, Shape_002.CATPart, Shape_003.CATPart]
2021-03-16 BAR mise à jour après test
    [SU_14001 (torsion bar).CATPart, SU_14003 (y stop).CATPart, SU_14004 (blade).CATPart, SU_14005 (coussinet).CATPart, SU_14006 (blade link).CATPart, SU_14007 (brushing support).CATPart, SU_14011 (Chape tole).CATPart, SU_14011 (Chape).CATPart]
2021-03-16 Croix arrière haute chassis maj
    [15x1.5.CATProduct, 20x1.5.CATProduct, FR_Filaire.CATPart, FR_Frame.CATProduct, Shape_004.CATPart, Shape_005.CATPart, Shape_006.CATPart, Shape_007.CATPart]
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2021-03-16 Nomenclature Pédale Frein MAJ4
    [FR_04007(Brake Fixing Rail Wedge).CATPart, FR_04008 (Front Fixing Rail Wedge).CATPart, FR_04009 (Distribution Brake Axle).CATPart, FR_04010 (Distribution Brake Axle Tread).CATPart, FR_04011 (Distribution Brake Cylinder).CATPart, FR_04012 (Brake Distribution Ball Joint).CATPart, FR_10004 (Distribution Brake Axle).CATPart, FR_10007 (Distribution Brake Axle Tread).CATPart]
2021-03-16 maj tubes carrés container rear
    déplacement + mise à jour des contraintes
    [FR_010009 (Tube carre 3).CATPart, FR_01008 (Tube carre 2).CATPart, FR_A_01000 (Tube carre rear).CATProduct, Frame&Body.CATProduct]
2021-03-16 maj symétrie attaches container
    [EL_A1000 (Accumulator).CATProduct, FR_010007 (Tube carre).CATPart, FR_010009 (Tube carre 3).CATPart, FR_01008 (Tube carre 2).CATPart, FR_A_01000 (Tube carre rear).CATProduct, Frame&Body.CATProduct, Symmetry of EL_01004.CATPart, Symmetry of FR_010007.CATPart]
2021-03-16 Nomenclature Pédale Frein MAJ5
    [FR_04013 (BOTS Support).CATPart, FR_04014 (BOTS).CATPart, FR_04015 (Brake Pedal Hose Wedge.CATPart, FR_04016 (Cylinder Screw Disctribution).CATPart, FR_04017 (Brake Pedale Bearing).CATPart, FR_04018(Brake Threated Rod).CATPart, FR_A0400 (Brake Pedal).CATProduct]
2021-03-16 ajout rotule pour liaison basculeur/couteaux
    [ARB Wireframe.CATPart, SU_06005 (spacer BAR).CATPart, SU_14001 (torsion bar).CATPart, SU_14002 (ball joint spacer M6 5mm).CATPart, SU_14003 (y stop).CATPart, SU_14004 (blade).CATPart, SU_14006 (blade link).CATPart, SU_14011 (Chape tole).CATPart]
2021-03-16 Nomenclature Pédale Frein FIN <3
    [FR_04013 (BOTS Support).CATPart, FR_04014 (BOTS).CATPart, FR_04015 (Brake Pedal Hose Wedge.CATPart, FR_04016 (Cylinder Screw Disctribution).CATPart, FR_04017 (Brake Pedale Bearing).CATPart, FR_04018(Brake Threated Rod).CATPart, FR_A0400 (Brake Pedal).CATProduct]
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2021-03-17 modif assemblage moteur
    ajout roulement à rotule
    réduction taille pignon
    ajout sprocket spacer
    trous pour excentriques sur les supports
    [1206_EM.catproduct, 1206_EM_18.catpart, 1206_EM_3.catpart, 1206_EM_33.catpart, 1206_EM_35.catpart, 1206_EM_37.catpart, 1206_EM_39.catpart, EN_01002 (flanged shaft) v2.CATPart]
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2021-03-17 Maj contraintes reconstruction pédalier
    [FR_03002 (Footrest).CATPart, FR_04006 (Brake Fixing Rail).CATPart, FR_A0300 (Throttle Pedal).CATProduct, FR_A0400 (Brake Pedal).CATProduct]
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2021-03-17 maj tubes carrés container
    prolongement de l'extrusion
    [FR_010007 (Tube carre).CATPart, FR_010009 (Tube carre 3).CATPart, FR_01008 (Tube carre 2).CATPart, FR_A_01000 (Tube carre rear).CATProduct]
2021-03-17 correction épaisseur tube carré front
    [FR_010007 (Tube carre).CATPart]
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2021-03-17 Préparation maquette pour TOP
    [Chape TSAL.CATPart, Chape_Fw_La_Fp_Up.CATPart, Chape_Fw_La_Rp_Up.CATPart, Chape_Fw_Ra_Rp_Low.CATPart, Chape_Fw_Ua_Fp_Low.CATPart, Chape_Fw_Ua_Fp_Up.CATPart, Chape_Fw_Ua_Rp_Up.CATPart, Chape_Rw_La_Fp_Low.CATPart]
2021-03-17 matériau + contraintes tube carré rear
    [FR_010009 (Tube carre 3).CATPart, FR_01008 (Tube carre 2).CATPart, FR_A_01000 (Tube carre rear).CATProduct]
2021-03-17 Maj simu chape rear container
    [EL_01004 (Chape rear).CATPart]
2021-03-17 MAJ EL position DC/DC
    [Data_logger_Inverter_N.CATPart, EL_01003 (Chape_test_butterfly).CATPart, EL_02001 (HV Wires).CATProduct, EL_03007 (Bracket).CATPart, EL_10001 Battery Volume.CATPart, EL_A0200 (Wire Harness).CATProduct, EL_A0300 (LV Battery Assembly).CATProduct, EL_A0400 (sensors).CATProduct]
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2021-03-17 maj mise en position container sur chape rear
    [EL_01004 (Chape rear).CATPart, Symmetry of EL_01004.CATPart]
2021-03-17 maj contraintes chapes accumulator
    [EL_01003 (Chape_test_butterfly).CATPart, EL_A1000 (Accumulator).CATProduct, Symmetry of EL_01003.CATPart, Symmetry of EL_01004.CATPart]
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2021-03-17 SU chape RRocker
    fini
    [Chape_RRocker_F.CATPart, Chape_RRocker_R.CATPart, Suspension_chape_assembly.CATProduct]
2021-03-17 Ajout connexion convertisseur dcdc
    [10000100_BF-7.CATPart, 10000100_BF-7.stp, EL_02010.CATProduct, EL_02015.CATPart, EL_040013.CATPart, EL_04006 (Connector elbow).CATPart, EL_A0200 (Wire Harness).CATProduct, EL_A0400 (sensors).CATProduct]
2021-03-17 Ajout connecxion converissuer dcdc
    [10000100_BF-7.CATPart, 10000100_BF-7.stp, EL_02015.CATPart]
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2021-03-17 SU fin simu rear upright
    [SU_11001 (Rear Left Upright).CATPart, SU_A1100 (Rear Left Upright).CATProduct]
2021-03-17 Ajout faisceau inverter dcdc
    [Data_logger_Inverter_N.CATPart, EL_02001 (HV Wires).CATProduct, EL_A0200 (Wire Harness).CATProduct, EL_Electrical.CATProduct, Inverterdcdc_CDD_P.CATPart, Segment de harnais12.CATPart, Segment de harnais13.CATPart, Segment de harnais14.CATPart]
2021-03-17 SU modif rear upright post simus
    [SU_11001 (Rear Left Upright).CATPart, SU_A1100 (Rear Left Upright).CATProduct]
2021-03-17 MAJ fixation BAMOCAR
    [EL_09002 (Inverter Bracket 1).CATPart, EL_09004 (Inverter Bracket 2).CATPart, EL_A0900 Control Unit.CATProduct]
2021-03-17 Ajout volume enveloppe VCU
    [EL_09005.CATPart, EL_Electrical.CATProduct, Valkyriz.CATProduct]
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2021-03-17 Rajout chappes DC DC
    [EL_03008 (DC DC Bracket).CATPart, EL_A0300 (LV Battery Assembly).CATProduct]
2021-03-17 SU réparation rear hub
    [Rear Left Wheel Assy.CATProduct, WT_03001 (Rear Hub).CATPart]
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2021-03-17 MAJ trous pare feu
    [MS_04003 (Lower part).CATPart]
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2021-03-17 maj nez
    affinage de la découpe
    [FR_02004 (Nose Invictus).CATPart, Frame&Body.CATProduct]
2021-03-17 ST Ajout point pour simu chape
    [ST_04003 (Left Bracket).CATPart]
2021-03-17 MAJ Points LAS Tie Rod
    [FrameWireframe.CATPart, LotusPoints.CATPart, SU_05001 (Tie rod).CATPart, SU_A0500 (Tie Rod).CATProduct, WireframeDefinition.CATProduct, toe rod.CATPart]
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2021-03-17 maj quick jack + head restraint
    [FR_07002 (Quick jack).CATPart, MS_02001 (Support).CATPart]
2021-03-17 SU simu Front Rocker
    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
    [SU_06001 (Front Rocker).CATPart, SU_A0600 (Front Bell Crank).CATProduct, Symmetry of SU_06001 (Front Rocker).CATPart]
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2021-03-17 maj chapes côté container
    [EL_01003 (Chape_test_butterfly).CATPart, EL_01004 (Chape rear).CATPart, EL_10001 Battery Volume.CATPart, EL_A1000 (Accumulator).CATProduct, Symmetry of EL_01003.CATPart, Symmetry of EL_01004.CATPart]
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2021-03-17 correction erreur chape
    [EL_01004 (Chape rear).CATPart, EL_A1000 (Accumulator).CATProduct, Symmetry of EL_01004.CATPart]
2021-03-17 Modif chapes triangles
    Reglement rapport e/D + qq chapes etaient en M8
    [Chape_Fw_La_Fp_Low.CATPart, Chape_Fw_La_Fp_Up.CATPart, Chape_Fw_La_Rp_Up.CATPart, Chape_Fw_Ra_Rp_Low.CATPart, Chape_Fw_Ua_Fp_Low.CATPart, Chape_Fw_Ua_Fp_Up.CATPart, Chape_Fw_Ua_Rp_Low.CATPart, Chape_Fw_Ua_Rp_Up.CATPart]
2021-03-17 ajout mise en position
    [EL_01004 (Chape rear).CATPart]
2021-03-17 SU masse Front Rocker
    [SU_06001 (Front Rocker).CATPart, SU_A0600 (Front Bell Crank).CATProduct, Symmetry of SU_06001 (Front Rocker).CATPart]
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2021-03-18 SU Rear Rocker
    Modif de la pièce et préparation simu
    [SU_08001 (Rear Rocker).CATPart, SU_A0800 (Rear Bell Crank).CATProduct, Symmetry of SU_08001.CATPart, params.xlsx]
2021-03-18 SU Réparation basculeur
    Attention la rotule le la BAR trop grosse pour le basculeur
    [SU_06001 (Front Rocker).CATPart, SU_A0600 (Front Bell Crank).CATProduct, Symmetry of SU_06001 (Front Rocker).CATPart]
2021-03-18 WT Suppression part fantome
    [WT_A0200 (Front Hub).CATProduct]
2021-03-18 ST Réparation ref externes
    [Rack_support_Wireframe.CATPart, ST_04001 (Half Moon top).CATPart, ST_04003 (Left Bracket).CATPart, ST_A0400 (Rack support) .CATProduct]
2021-03-18 ST 2e Réparation des ref externes
    [Rack_support_Wireframe.CATPart, ST_04001 (Half Moon top).CATPart, ST_04003 (Left Bracket).CATPart, ST_05003 (Rack Protection).CATPart, ST_A0400 (Rack support) .CATProduct, ST_A0500.CATProduct, ST_A0600 (Steering Shaft Pivot).CATProduct, ST_Steering.CATProduct]
2021-03-18 SU Réparation Chape assembly
    [Chape_FRocker_F.CATPart, Chape_FRocker_R.CATPart, Chape_Fw_La_Fp_Low.CATPart, Chape_Fw_La_Fp_Up.CATPart, Chape_Fw_La_Rp_Up.CATPart, Chape_Fw_Ra_Rp_Low.CATPart, Chape_Fw_Ua_Fp_Low.CATPart, Chape_Fw_Ua_Fp_Up.CATPart]
2021-03-18 SU Points LAS v46
    [01-Evolution_paramètres.txt]
2021-03-18 SU Chape tie rod + modif
    [Chape_Rw_La_Fp_Up.CATPart, Chape_Rw_Ua_Fp_Low.CATPart, Chape_Rw_Ua_Fp_Up.CATPart, Chape_tie-rod_Low.CATPart, Chape_tie-rod_Up.CATPart, Suspension_chape_assembly.CATProduct]
2021-03-18 SU Prépara chapes rear absorber
    [Chape_Rw_Ua_Fp_Up.CATPart, FrameWireframe.CATPart, Suspension_chape_assembly.CATProduct]
2021-03-18 SU MAJ Points LAS v46
    [15x1.5.CATProduct, 20x1.5.CATProduct, Chape_tie-rod_Low.CATPart, Chape_tie-rod_Up.CATPart, FR_Filaire.CATPart, FR_Frame.CATProduct, FrameWireframe.CATPart, LotusPoints.CATPart]
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2021-03-21 FR Point suspension avant
    [25x1.5.CATProduct, FR_Filaire.CATPart, FR_Frame.CATProduct, Shape_046.CATPart, Shape_048.CATPart, Shape_049.CATPart, Shape_054.CATPart, Shape_055.CATPart]
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2021-03-21 SU Préparation formation EF
    [Chape_Fw_Ua_Rp_Up.CATPart]
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2021-03-23 maj renforts aux coins container
    [EL_01004 (Chape rear).CATPart, EL_10001 Battery Volume.CATPart, EL_A1000 (Accumulator).CATProduct, Symmetry of EL_01004.CATPart]
2021-03-23 maj renforts aux coins container (suite)
    [EL_10001 Battery Volume.CATPart]
2021-03-23 chape côté container plaques laser + entretoises v1
    [EL_01003 (Chape front).CATPart, EL_01003 (Chape_test_butterfly).CATPart, EL_01004 (Chape rear) (2).CATPart, EL_01004 (Chape rear).CATPart, EL_A1000 (Accumulator).CATProduct, Symmetry of EL_01003.CATPart, Symmetry of EL_01004.CATPart]
2021-03-23 maj chape container front
    coaxialité avec tube carré
    [EL_01003 (Chape front).CATPart, EL_10001 Battery Volume.CATPart, EL_A1000 (Accumulator).CATProduct, Symmetry of EL_01003.CATPart, Symmetry of EL_01004.CATPart]
2021-03-23 maj chape container rear
    coaxialité
    [EL_01004 (Chape rear) (2).CATPart, EL_A1000 (Accumulator).CATProduct, Symmetry of EL_01004.CATPart]
2021-03-23 maj entretoises chapes container
    [EL_01003 (Chape front).CATPart, EL_01004 (Chape rear) (2).CATPart]
2021-03-23 FR tubes main hoop pour simulation
    [30x2.CATProduct, FR_Filaire.CATPart, FR_Frame.CATProduct, Shape_008.CATPart, Shape_009.CATPart, Shape_010.CATPart, Shape_011.CATPart, Shape_012.CATPart]
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2021-03-23 maj entretoises chapes container
    réduction longueur et épaisser
    [EL_01003 (Chape front).CATPart, EL_01004 (Chape rear) (2).CATPart]
2021-03-23 trous oblongs chapes container
    [EL_01003 (Chape front).CATPart, EL_01004 (Chape rear) (2).CATPart]
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2021-03-23 maj filaire tube front
    [FR_Filaire.CATPart]
2021-03-23 correction filaire
    coordonnées avec le mauvais signe corrigées
    [FR_Filaire.CATPart]
2021-03-23 FR ajout d'un fichier de création de tube 28x2
    [28x2.CATPart]
2021-03-23 maj filaire tubes container
    [FR_Filaire.CATPart]
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2021-03-23 MAJ trou oblong chappe container arrière
    [EL_01004 (Chape rear) (2).CATPart]
2021-03-23 FR ajout fichier de création tube 25x2
    [25x2.CATPart]
2021-03-23 FR Ajout tube soutient container
    [25x2.CATProduct, 28x2.CATProduct, FR_Frame.CATProduct, Shape_232.CATPart, Shape_233.CATPart, Shape_236.CATPart, Shape_237.CATPart, Shape_238.CATPart]
2021-03-23 FR tubes attaches arrière container changement de diamètre
    [FR_Frame.CATProduct, Shape_236.CATPart, Shape_237.CATPart, Shape_238.CATPart, Shape_239.CATPart]
2021-03-23 insert container front v1
    [FR_010001 (Insert front).CATPart, Frame&Body.CATProduct]
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2021-03-23 FEA Data Logger Bracket
    [EL_03007 (Bracket).CATPart]
2021-03-24 fin insert front v1
    [EL_10001 Battery Volume.CATPart, EL_A1000 (Accumulator).CATProduct, EL_Electrical.CATProduct, FR_010001 (Insert front).CATPart, Frame&Body.CATProduct, Symmetry of EL_01003.CATPart, Symmetry of EL_01004.CATPart]
2021-03-24 maj tubes container rear
    [25x2.CATProduct, FR_Filaire.CATPart, Shape_236.CATPart, Shape_237.CATPart, Tubes.CATProduct]
2021-03-24 insert container rear v1
    [FR_010001 (Insert front).CATPart, FR_010002 (Insert rear).CATPart]
2021-03-24 mise en place insert rear
    [FR_010001 (Insert front).CATPart, FR_06003_Chapes_Floor_Pan.CATProduct, FR_A0600 (Floor pan).CATProduct, Frame&Body.CATProduct]
2021-03-24 fin positionnement inserts container
    [25x2.CATProduct, FR_010002 (Insert rear).CATPart, FR_Frame.CATProduct, Frame&Body.CATProduct, Shape_233.CATPart, Shape_238.CATPart, Shape_239.CATPart, Symmetry of FR_010001.CATPart]
2021-03-24 premières simus insert front
    [FR_010001 (Insert front).CATPart]
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2021-03-24 maj insert rear
    épaississement surface
    [FR_010002 (Insert rear).CATPart, Frame&Body.CATProduct, Symmetry of FR_010002_1.CATPart]
2021-03-24 maj position oblong chape rear container
    [EL_01004 (Chape rear) (2).CATPart]
2021-03-24 maj positionnement insert container rear
    [EL_A1000 (Accumulator).CATProduct, FR_010002 (Insert rear).CATPart, Frame&Body.CATProduct, Shape_236.CATPart, Symmetry of EL_01004.CATPart]
2021-03-24 réduction plaques supports container
    [EL_10001 Battery Volume.CATPart]
2021-03-24 mise en place EF insert rear
    [FR_010002 (Insert rear).CATPart]
2021-03-24 suite simus insert rear + repositionnement chape container rear
    [EL_01004 (Chape rear) (2).CATPart, EL_A1000 (Accumulator).CATProduct, FR_010002 (Insert rear).CATPart, Symmetry of EL_01004.CATPart]
2021-03-24 SU Pour traçage propre des résultats lotus pour design
    [Résultats v46a.xlsx]
2021-03-24 maj positionnement chape container front
    [EL_A1000 (Accumulator).CATProduct]
2021-03-24 Calcul masse pour BOM
    [EN_02001 (Radiator).CATPart, EN_02003 (High Screed).CATPart, EN_02004 (Low screed).CATPart, EN_02005 (Transverse Screed).CATPart, EN_02006 (Junction Screed_Frame).CATPart, EN_02009 (Coolant lines).CATPart, EN_03001_(Overflow Bottle Body).CATPart]
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2021-03-25 EL Fixation BAMOCAR
    [CDD Exit 2 Unshielded HV.CATPart, CDD entry 2 unshielded.CATPart, Data logger CDD entry 1.CATPart, Data logger CDD entry 2 unshielded.CATPart, Data logger entry.CATPart, Data logger_ CDD .CATPart, EL_03008 (DC DC Bracket).CATPart, EL_09002 (Inverter Bracket 1).CATPart]
2021-03-27 SU Traçage courbe pour rapport PA
    [Résultats v46a.xlsx]
2021-03-30 SU préparation simus PM avant
    [SU_10001 (Front Left Upright).CATPart]
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2021-03-30 FR petite maj cockpit
    [15x1.5.CATProduct, 25x1.5.CATProduct, 28x1.5.CATProduct, 28x2.CATProduct, 30x2.CATProduct, FR_Filaire.CATPart, FR_Frame.CATProduct, Shape_003.CATPart]
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2021-03-30 correction test push
    c'est bon je suis content. Bonne journée à qui lit ce message <3
    [FR_05002 (AIP).CATPart]
2021-03-30 petit modification sur port-moyeu
    j'ai dû faire la partie de "front tie rod outboard" plus gross pour diminuer les efforts
    [SU_10001 (Front Left Upright).CATPart]
2021-03-30 petit modification sur le port_moyeu à l'avant
    j'ai enlevé une partie que j'avais ajouté pour faire des simulations
    [Front Left Wheel Assy.CATProduct, SU_10001 (Front Left Upright).CATPart]
2021-03-30 Auto stash before merge of "master" and "origin/master"
    [EL_02011.CATPart, EL_02012.CATPart]
2021-03-31 WT réparation pb bearing washer avant/arrière
    [Front Left Wheel Assy.CATProduct, Rear Left Wheel Assy.CATProduct, WT_02003 (Front Bearing Washer).CATPart, WT_03003 (Rear Bearing Washer).CATPart, WT_A0200 (Front Hub).CATProduct, WT_A0300 (Rear Hub).CATProduct]
2021-03-31 SU simu Rear Rocker
    [SU_06001 (Front Rocker).CATPart, SU_08001 (Rear Rocker).CATPart, SU_A0600 (Front Bell Crank).CATProduct, SU_A0800 (Rear Bell Crank).CATProduct, Symmetry of SU_06001 (Front Rocker).CATPart, Symmetry of SU_08001.CATPart]
2021-04-01 SU WT ajout visserie rear brake bell
    [Rear Left Wheel Assy.CATProduct, SU_A1100 (Rear Left Upright).CATProduct, Visserie.CATProduct, WT_03001 (Rear Hub).CATPart, WT_03002 (Rear Brake Bell).CATPart, WT_A0300 (Rear Hub).CATProduct]
2021-04-01 SU réparation collision front caliper
    [Front Left Wheel Assy.CATProduct, SU_10001 (Front Left Upright).CATPart, SU_A1000 (Front Left Upright).CATProduct]
2021-04-01 SU visserie roue avant
    [Front Left Wheel Assy.CATProduct, Produit1.CATProduct, Produit3.CATProduct, SU_A1000 (Front Left Upright).CATProduct, WT_A0200 (Front Hub).CATProduct]
2021-04-01 SU visserie chapes triangles
    [Produit1.CATProduct, Suspension_chape_assembly.CATProduct]
2021-04-01 FR Essai simu encore
    [FR_Filaire.CATPart]
2021-04-02 EL mal positionnement support batterie LV
    [EL_A0300 (LV Battery Assembly).CATProduct]
2021-04-03 Mise en place simus châssis
    fichier de simu chape damper + tube pour imposer le déplacement
    [Chape damper+ tube arriere.CATPart]
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2021-04-04 SU Front wheel relinkage cassé
    [WT_A0200 (Front Hub).CATProduct]
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2021-04-05 point caché pour simus frame
    [FR_Filaire.CATPart]
2021-04-06 Chape tie rod up
    [Front Left Wheel Assy.CATProduct, Rear Left Wheel Assy.CATProduct, Suspension.CATProduct]
2021-04-06 Chape tie rod up MAJ
    (problème de commit)
    [Chape_tie-rod_Up.CATPart, Suspension_chape_assembly.CATProduct]
2021-04-06 new tentative chape tie rod
    changement de plan d'esquisse
    [Chape_tie-rod_Up.CATPart]
2021-04-10 Ajout prise tension data logg
    [CDD Exit 2 Unshielded HV.CATPart, CDD entry 2 unshielded.CATPart, Data logger CDD entry 1.CATPart, EL_02001 (HV Wires).CATProduct, EL_02014.CATPart, EL_A0200 (Wire Harness).CATProduct, EL_A0400 (sensors).CATProduct, EL_Electrical.CATProduct]
2021-04-10 Maj faisceau prise de tension data logg
    [Data_logg CDD prise de tension.CATPart, EL_02001 (HV Wires).CATProduct, EL_A0200 (Wire Harness).CATProduct, EL_Electrical.CATProduct]
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2021-04-14 SU suppression rotules m8
    suppression rotules m8
    [SU_06001 (Front Rocker).CATPart, SU_A0600 (Front Bell Crank).CATProduct, Symmetry of SU_06001 (Front Rocker).CATPart]
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2021-04-16 Ajout Ground Measuring Point
    [Data logger CDD entry 1.CATPart, EL_06001(Master switch).CATPart, EL_06002 (support MS bis).CATPart, EL_A0600 (Kill Switch).CATProduct, EL_Electrical.CATProduct]
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2021-04-18 Modif diamètre poches pour les chapes du radiateur
    [EN_02004 (Low screed).CATPart, EN_02006 (Junction Screed_Frame).CATPart]
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2021-04-18 Inversement sens tubulure supérieure
    [EN_02001 (Radiator).CATPart]
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2021-04-18 màj engine
    nouveau pignon + nouveau carter
    [EN_01002 (flanged shaft) v2.CATPart, EN_01003 (engine sprocket).CATPart, EN_01004 (rondelle de serrage).CATPart, EN_01007 (rotor scatter shield round).CATPart, EN_01010 (sprocket spacer).CATPart, EN_A0100 (Engine).CATProduct, SKF_W_6206_2Z.catproduct, SKF_W_6206_2Z_13.catpart]
2021-04-19 MAJ SU ST WT
    [Chape_FL_Damper_Down.CATPart, Chape_FL_Damper_Up.CATPart, Chape_Fw_La_Fp_Low.CATPart, Chape_Fw_La_Fp_Up.CATPart, Chape_Fw_La_Rp_Up.CATPart, Chape_Fw_Ra_Rp_Low.CATPart, Chape_Fw_Ua_Fp_Low.CATPart, Chape_Fw_Ua_Fp_Up.CATPart]
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2021-04-20 chapes baquet
    oublie de push
    [FR_03001 (Frame Throttle).CATPart, MS_01006 (Rear bracket).CATPart, MS_01009(Chape fixation baquet).CATPart]
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2021-04-22 SU Insertion vis chapes triangles
    [Bolted_assembly.CATProduct, Chape_FL_Damper_Down.CATPart, Chape_FL_Damper_Up.CATPart, Chape_FRocker_F.CATPart, Chape_FRocker_R.CATPart, Chape_Fw_La_Fp_Low.CATPart, Chape_Fw_La_Fp_Up.CATPart, Chape_Fw_La_Rp_Up.CATPart]
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2021-04-23 2e set de chape engine
    [Chape_EngineSupport_L1.CATPart, Chape_EngineSupport_L1b.CATPart, Chape_EngineSupport_U1.CATPart, Chape_EngineSupport_U1b.CATPart, Chape_EngineSupport_U2.CATPart, Chape_EngineSupport_U2b.CATPart, Chape_L1.CATPart, Chape_L1b.CATPart]
2021-04-28 SU Sym pour Design
    [SU_06001 (Front Rocker).CATPart, SU_A0100 (Front Upper A-Arm).CATProduct, SU_A0600 (Front Bell Crank).CATProduct, SU_A1400 (Front ARB).CATProduct, Suspension.CATProduct, Suspension_chape_assembly.CATProduct, Symmetry of 6x16CHC.CATPart, Symmetry of 6x35CHC.CATPart]
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2021-04-29 Réparation Roue RL
    Pblm au moyeu qui a tout décalé donc modif et réparation de contraintes partout
    [BR_02001 (Rear Brake Disc).CATPart, R Wheel.CATPart, Rear Left Wheel Assy.CATProduct, SU_11001 (Rear Left Upright).CATPart, SU_A1100 (Rear Left Upright).CATProduct, Visserie.CATProduct, WT_03001 (Rear Hub).CATPart, WT_03003 (Rear Bearing Washer).CATPart]
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2021-05-02 Préparation maquette pour visuels
    [15x1.5.CATProduct, 20x1.5.CATProduct, 25x1.5.CATProduct, 25x2.CATProduct, 28x1.5.CATProduct, 30x2.CATProduct, CDD Entry.CATPart, CDD Exit 2 Unshielded HV.CATPart]
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2021-05-04 I added Camber shim 2mm
    [SU_10001 (Front Left Upright).CATPart, SU_11003 (Camber shim 2mm).CATPart, SU_11004 (Camber shim 1mm).CATPart]
2021-05-04 I added the camber shim again...
    [Front Left Wheel Assy.CATProduct, SU_A1000 (Front Left Upright).CATProduct, WT_A0200 (Front Hub).CATProduct]
2021-05-05 SU Rocker
    Evidage + Simu + fini
    [SU_06001 (Front Rocker).CATPart, SU_08001 (Rear Rocker).CATPart]
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2021-05-06 DE Préparation livrables rendu
    [281_Ecurie Piston Sport Auto_Spec Sheet.xlsx]
2021-05-06 Raccourcissement du moyeu de 1.5mm
    Il y avait un espace à combler et le speed disque a été replacé au milieu tout comme les roulements mis dans le bon sens pour la vue de coupe
    [WT_03001 (Rear Hub).CATPart, WT_A0300 (Rear Hub).CATProduct]
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2021-05-08 points LAS : pince arrière
    [25x2.CATProduct, Chape_tie-rod_Low.CATPart, Chape_tie-rod_Up.CATPart, FR_Frame.CATProduct, FrameWireframe.CATPart, LotusPoints.CATPart, R Wheel.CATPart, Rear Left Wheel Assy.CATProduct]
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2021-05-13 Mise en place Cost Report Step 0
    [Cost.xlsx, Cost_v1.5.xlsx, Facture_La_Mache_2019.xlsx, Fastener_cost.xlsx, Machining volume and time.xlsx, Materials_cost.xlsx, Processes_cost.xlsx, fasteners_processes_materials.xlsx]
2021-05-13 Création Excel Cost Model
    [COST_Model.xlsx, Cost_v1.5.xlsx]
2021-05-13 Vis excentrique + alignement
    [Boulon_M8x30_Excentrique.CATProduct, EN_01002 (flanged shaft) v2.CATPart, EN_01008.CATPart, EN_01010 (sprocket spacer).CATPart, EN_04001 (Excentrique).CATPart, EN_04006 (Sprocket Bearer).CATPart, EN_04013 (Excentrique Gauche).CATPart, EN_A0400 (Drivetrain).CATProduct]
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2021-05-14 Modification Cost Model Excel
    [COST_Model.xlsx]
2021-05-14 Mise à jour roue équipée avant
    Il y avait un gap entre le moyeu et la jante
    [BR_01001 (front Brake Disc).CATPart, F Wheel.CATPart, Front Left Wheel Assy.CATProduct, SU_10001 (Front Left Upright).CATPart, SU_10002 (Upper Arm Bracket).CATPart, SU_11003 (Camber shim 2mm).CATPart, SU_A1000 (Front Left Upright).CATProduct, WT_01001 (OZ Mg Rim).CATPart]
2021-05-18 chape + cost picture
    [EN_04010 (Chain Shield).CATPart]
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2021-05-19 Découpe colision scatter shield
    [EN_01006 (stator scatter shield).CATPart, EN_01007 (rotor scatter shield round).CATPart]
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2021-05-19 Collision excentrique + chape
    [Chape_chainshield2.CATPart, EN_01006 (stator scatter shield).CATPart, EN_01007 (rotor scatter shield round).CATPart, EN_01008.CATPart, EN_04010 (Chain Shield).CATPart, EN_A0400 (Drivetrain).CATProduct, EN_Engine_Drivetrain.CATProduct]
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2021-05-26 premières gorges de loup
    [FR_Frame_prod.CATProduct, Shape_034.CATPart, Shape_035.CATPart, Shape_036.CATPart, Shape_037.CATPart, Shape_038.CATPart, Shape_040.CATPart, Shape_041.CATPart]
2021-05-26 MAJ chain et scatter shield
    [EN_01006 (rotor scatter shield).CATPart, EN_01011 (rotor scatter shield).CATPart, EN_04010 (Chain Shield).CATPart, EN_A0100 (Engine).CATProduct]
2021-05-26 suites 2 gorges de loup
    [Shape_045.CATPart, Shape_046.CATPart, Shape_047.CATPart, Shape_048.CATPart, Shape_052.CATPart, Shape_054.CATPart, Shape_056.CATPart, Shape_059.CATPart]
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2021-06-02 MEPs Hoop + Tableau longueur tubes
    + screen simulation
    [Commande_longueur_tubes.xlsx]
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2021-06-06 CR MEP pour FR_A01
    [Chassis_EPSA.stp]
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2021-06-15 Réparation maquette
    réparation de copier coller mal faits etc
    [15x1.5.CATProduct, 20x1.5.CATProduct, 25x1.5.CATProduct, 30x2.CATProduct, Data logger CDD entry 1.CATPart, EL_A0300 (LV Battery Assembly).CATProduct, EL_A0400 (sensors).CATProduct, EL_A0900 Control Unit.CATProduct]
2021-06-20 DR supports pour compet
    [281_Ecurie Piston Sport Auto_Spec Sheet.xlsx]
2021-09-07 Modification HD
    passage à la V3 en tube carrés
    [Fixation_chassis.CATPart, HD_02001.CATPart, HD_02002.CATPart, HD_02003.CATPart, HD_02004.CATPart, HD_02005.CATPart, HD_02006.CATPart, HD_02007.CATPart]
2021-09-13 Mise à jour maquette
    [Data logger CDD entry 1.CATPart, EL_A0300 (LV Battery Assembly).CATProduct, EL_A0400 (sensors).CATProduct, EL_A0900 Control Unit.CATProduct, EL_A1000 (Accumulator).CATProduct, FRA0500 (CrashBox + AIP).CATProduct, FR_A(03-04)00 (Pedal Assy).CATProduct, FR_Frame.CATProduct]
2021-09-14 Rack protection modif Retex
    [ST_05003 (Rack Protection).CATPart, ST_A0500.CATProduct]
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2021-09-14 maj geules de loup chassis
    [Shape_060.CATPart, Shape_061.CATPart]
2021-09-21 Ajout proto container Tyva
    [Batterie_EPSA_Tyva.CATProduct, Connecteur.CATPart, Container.CATPart, Couvercle.CATPart, Module.CATPart, PDU.CATPart, Part1.CATPart]
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2021-09-23 MAJ fixation roulement direction
    [ST_06003 (Right Fixation Tube).CATPart, ST_06003 (Right Fixation Tube).CATProduct, ST_A0600 (Steering Shaft Pivot).CATProduct, assemblage_pivot_plaques.CATPart, assemblage_pivot_tubes.CATPart]
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2021-09-28 Màj châssis
    Modification du châssis rules compliance
    [15x1.5.CATProduct, 25x1.5.CATProduct, 28x1.5.CATProduct, 28x2.CATProduct, 30x2.CATProduct, Commande_longueur_tubes.xlsx, FR_Filaire.CATPart, FR_Frame.CATProduct]
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2021-09-28 batterie tyva, ça continue
    [Batterie_EPSA_Tyva.CATProduct, Container.CATPart, Module.CATPart, tige_filetee.CATPart]
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2021-09-29 Création pièce Fixation U Joint pour MEP
    [ST_06006 (Bottom).CATPart, ST_06006 (Front).CATPart, ST_06006 (Side).CATPart, ST_Steering.CATProduct]
2021-10-01 Modif Fixation U joint
    [ST_06006 (Fixation U joint).CATPart, ST_A0600 (Steering Shaft Pivot).CATProduct]
2021-10-01 ST Dessin pièces de Fixation U joint pour MEP
    [ST_06006 (Fixation U joint).CATPart, ST_06006 (Side).CATPart]
2021-10-03 ST Premiere modif bielette de pinces
    [ST_03004 (Insert middle).CATPart]
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2021-10-04 MaJ chapes + baquet
    [MS_01006 (Rear bracket).CATPart]
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2021-10-04 Ajustement new frette + moyeu
    [Front Left Wheel Assy.CATProduct, WT_02001 (Front Hub).CATPart, WT_A0200 (Front Hub).CATProduct]
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2021-10-05 ST connecting rod modif v01
    [ST_03003 (cale) .CATPart, ST_03004 (Insert middle).CATPart, ST_03005 (insert sup).CATPart, ST_A0300 (Connecting rod).CATProduct, croquis.CATPart]
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2021-10-12 SU Sim Rocker (LFI's push)
    [SU_06001 (Front Rocker).CATPart]
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2021-10-12 MEP des frame brake
    [FR_04001_10(Frame Brake).CATPart, FR_04001_11(Frame Brake).CATPart]
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2021-10-12 Simu + rectif moyeu et frette
    [WT_02001 (Front Hub).CATPart, WT_02002 (Brake Bell).CATPart]
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2021-10-13 Ajout analyse frette, moyeu, plaque
    [Analyse_plaques.xlsx, WT_02002 (Brake Bell).CATPart]
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2021-10-15 Intégration batterie tyva sur châssis
    [Arret vertical.CATPart, Base.CATPart, Batterie Tyva v2.CATProduct, Batterie_EPSA_Tyva.CATProduct, Boite controle.CATPart, Bracket PDU.CATPart, Bracket.CATPart, Capot boite controle.CATPart]
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2021-10-19 Insert susp + direction VF
    [ST_03003 (cale) .CATPart, ST_03004 (Insert middle).CATPart, ST_03005 (insert sup).CATPart, ST_A0300 (Connecting rod).CATProduct]
2021-10-19 Màj frame
    colision bamocar
    [Shape_505.CATPart, Shape_506.CATPart, Shape_514.CATPart, Shape_515.CATPart, Shape_516.CATPart]
2021-10-19 Màj frame
    Ajout tube fixation bamocar + collision
    [15x1.5.CATProduct, FR_Filaire.CATPart, FR_Frame.CATProduct, Frame&Body.CATProduct, Shape_102.CATPart, Shape_236.CATPart, Shape_237.CATPart, Tubes.CATProduct]
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2021-10-19 Ajout Shoulder Belt Mountings
    [MS_03006 (Sous Assembly Shoulders Belt Mounting).CATProduct, MS_03006.1 (Shoulder Belt Mounting).CATPart, MS_A0300(Harness).CATProduct]
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2021-10-19 Modif MEP et moyeu
    [WT_02001 (Front Hub).CATPart]
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2021-10-20 Ajout arrêt d'urgence sur armature dash panel
    [EL_A0101 (Armature).CATPart]
2021-10-20 Replacement des boutons du DashPanel
    [EL_A0101 (Armature).CATPart]
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2021-10-26 Ajout rotule bielette direction
    [ST_03002 (insert sup).CATPart, ST_03003 (cale) .CATPart, ST_A0300 (Connecting rod).CATProduct]
2021-10-27 Modif réglage pince arrière
    [SU_05001 (Tie rod).CATPart, SU_05002 (Inner insert sup ).CATPart, SU_05002 (tapped insert right).CATPart, SU_05003 (cale) .CATPart, SU_05003 (tapped insert left).CATPart, SU_05004 (Inner insert middle).CATPart, SU_13002 (tapped insert right).CATPart, SU_13003 (tapped insert left).CATPart]
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2021-10-27 Ajout de l'Inertia Switch
    [EL_12001(Inertia Switch).CATPart, EL_12002(Chape).CATPart, EL_A1200 (Inertia Switch).CATProduct]
2021-10-27 MEP Front Left upright
    [SU_10001 (Front Left Upright).CATPart]
2021-10-27 Début MEP Front Hub + Modif Part du Front Hub
    [WT_02001 (Front Hub).CATPart]
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2021-10-28 MAJ ST SU Biellette
    [ST_03001 ( rod tube).CATPart, ST_03002 (insert sup).CATPart, ST_03003 (cale) .CATPart, ST_03004 (Insert middle).CATPart, ST_A0300 (connecting rod).CATProduct, Suspension.CATProduct]
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2021-11-03 Intégration Tdb sur EL
    [EL_02001 (HV Wires).CATProduct, EL_09004 (Inverter Bracket 2).CATPart, EL_A0100 (Dash panel).CATProduct, EL_A0200 (Wire Harness).CATProduct, EL_A0300 (LV Battery Assembly).CATProduct, EL_A0400 (sensors).CATProduct, EL_A0900 Control Unit.CATProduct, EL_Electrical.CATProduct]
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2021-11-06 MAJ MEP et export en DXF
    [EN_01007 Round Scatter Shield.dxf, EN_01008 Right Engine Bracket.dxf, EN_01011 Rotor Scatter Shield.dxf, En_01009 Left Engine Bracket.dxf]
2021-11-06 Création du dossier et mise en place des premiers fichiers
    [212 OT_1002699_3DSYM.CATPart, 212 UT_1002700_3DSYM.CATPart, EL_04003 (Data logger FSG).CATProduct, GFK-Verdrehschutz.CATPart, IVTModul.CATPart, Kupferkontakt.CATPart, LED.CATPart, Molex Stecker.CATPart]
2021-11-06 Setup du data log
    Choix d'une boite et placement des presse étoupes
    [1554WAGY.stp, EL_04004 (Data Logger Box).CATProduct, EL_04004_3 (Cable Gland).CATPart, EL_04004_4 (Cable Gland tiny)cable gland.CATPart, FIBOX_EKH30C.CATPart, FIBOX_EKH30C.STEP, Fibox_EKHA_190x190x100_B.CATPart, Fibox_EKHA_190x190x100_B.STEP]
2021-11-07 Résolution Contrainte EL_Electrical
    Update des contraintes dans le fichier EL_Electrical
    [15x1.5.CATProduct, 20x1.5.CATProduct, 25x1.5.CATProduct, 28x1.5.CATProduct, 30x2.CATProduct, Data logger CDD entry 1.CATPart, EL_02013.CATPart, EL_03008 (DC DC Bracket).CATPart]
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2021-11-07 Ajout du nouveau Data Log sur EL_electrical
    [EL_A0400 (sensors).CATProduct, EL_Electrical.CATProduct]
2021-11-08 Refresh des fichiers Data Log
    [10000100_BF-7.stp, 1554WAGY.stp, 212 OT_1002699_3DSYM.CATPart, 212 UT_1002700_3DSYM.CATPart, DIN 84 - ersetzt durch DIN EN ISO 1207 M6 x 30.CATPart, EL_02008 (Cable Gland).2.CATPart, EL_02008 (Cable Gland).3.CATPart, EL_02010 (Locking nut).1.CATPart]
2021-11-08 Deuxieme partie du refresh
    [10000100_BF-7.stp, 1554WAGY.stp, 212 OT_1002699_3DSYM.CATPart, 212 UT_1002700_3DSYM.CATPart, DIN 84 - ersetzt durch DIN EN ISO 1207 M6 x 30.CATPart, Data logger CDD entry 1.CATPart, Data logger CDD entry 2 unshielded.CATPart, Data logger entry.CATPart]
2021-11-08 Ajout de la plaque de maintien inférieur
    Première esquisse de la plaque de maintien du data log
    [EL_04000 (Data Logger Box).CATProduct, EL_04004.CATProduct, EL_04004_1.CATPart, EL_04004_2.CATPart, EL_04004_3.CATPart]
2021-11-08 Ajout des Ecrou sur la plaque maintient Data Log
    [EL_04000 (Data Logger Box).CATProduct, EL_04004.CATProduct, EL_04004_1.CATPart, EL_04004_2.CATPart]
2021-11-09 Bamocar trous pour tubes
    [EL_09004 (Inverter Bracket 2).CATPart]
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2021-11-09 MEP Rear left upright and modif épaisseur PM à checker
    [SU_11001 (Rear Left Upright).CATPart]
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2021-11-10 MEP Rear Upright rectifié + enlevement surface pour les simus
    [SU_11001 (Rear Left Upright).CATPart]
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2021-11-11 MaJ Gueule de Loup
    [Shape_435.CATPart, Shape_514.CATPart, Shape_515.CATPart, Shape_516.CATPart, Shape_519.CATPart, Shape_520.CATPart]
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2021-11-12 MaJ Gueules de Loup 2
    [FR_Frame.CATProduct, Shape_073.CATPart, Shape_080.CATPart, Shape_083.CATPart, Shape_217.CATPart, Shape_226.CATPart]
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2021-11-13 MAJ upright, suspension, rocker
    [SU_06001 (Front Rocker).CATPart, SU_10001 (Front Left Upright).CATPart, Suspension.CATProduct, Symmetry of SU_06001 (Front Rocker).CATPart]
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2021-11-13 MAJ Rack protection + MEP
    [ST_05001 (Front Bracket).CATPart, ST_05003 (Rack Protection).CATPart]
2021-11-13 Ajout des composants de La CDD Box
    [HS50-RSPRO.sldprt, HeatSink.CATPart]
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2021-11-13 MaJ gueules de loup
    y en a trop put1
    [Shape_073.CATPart, Shape_074.CATPart, Shape_083.CATPart, Shape_189.CATPart, Shape_202.CATPart, Shape_218.CATPart, Shape_227.CATPart]
2021-11-13 maj gueules de loup
    on s'arrete jamais
    [FR_Frame.CATProduct, Shape_003.CATPart, Shape_188.CATPart, Shape_193.CATPart, Shape_194.CATPart, Shape_202.CATPart, Shape_208.CATPart, Shape_212.CATPart]
2021-11-14 Auto stash before rebase of "origin/master"
    MEPS frame brake
    [FR_04002 (Brake Pedale Stick).dxf, FR_04015 (Brake Pedal Hose Wedge).dxf, FR_04016 (Cylinder Screw Distribution).dxf, FR_04018 (Brake Threated Rod).dxf]
2021-11-14 maj gueules de lou
    aled jpp
    [20x1.5.CATProduct, 25x1.5.CATProduct, FR_Frame.CATProduct, Shape_002.CATPart, Shape_188.CATPart, Shape_193.CATPart, Shape_203.CATPart, Shape_204.CATPart]
2021-11-14 maj gueules de loup
    bordel
    [Shape_004.CATPart, Shape_005.CATPart, Shape_006.CATPart, Shape_007.CATPart, Shape_050.CATPart, Shape_053.CATPart, Shape_057.CATPart, Shape_496.CATPart]
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2021-11-15 MAJ MEP + chainshield
    [EN_04010 (Chain Shield).CATPart]
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2021-11-15 step pièces la mache prod
    [EN_01002 (flanged shaft).stp, EN_01005 (bearing housing).stp, EN_01010 (sprocket spacer).stp, EN_04001 (Excentrique droit).stp, EN_04013 (Excentrique Gauche).stp, ST_02001 (Steering Column).stp, SU_06002 (pivot joint spacer).stp, SU_06003 (ball joint spacer M6 5mm).stp]
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2021-11-15 Ajout de la boite du CDD, TSMP et capteur de courant
    [EL_A1300 (High Tension Derivation Box).CATProduct, FIBOX TEMPO 1912 Base.CATPart, FIBOX TEMPO 1912 Base.STEP, FIBOX TEMPO 1912 Cover.CATPart, FIBOX TEMPO 1912 Cover.STEP, FIBOX_EKH30C.CATPart, FIBOX_EKH30C.STEP, FIBOX_TEMPO_1313B.IGS]
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2021-11-16 support batterie LV + dcdc
    [EL_03002 (LV Battery support).CATPart, EL_04000 (Data Logger Box).CATProduct, EL_04004.CATProduct, EL_A0300 (LV Battery Assembly).CATProduct]
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2021-11-16 Ajout Nouveau Boitier TS
    [01116000_A-116.CATProduct, 1.1.2.CATPart, 1.1.CATPart, 212 OT_1002699_3DSYM.CATPart, 212 UT_1002700_3DSYM.CATPart, 3d2-fb-rahmen34 01.CATPart, 3d2-led-7seg 01.CATPart, 3d2-pg-metr-25.CATPart]
2021-11-16 MEP outter bearing support
    [SU_01003 (Front Upper Rod-End Support).CATPart]
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2021-11-16 Nouvelle boite TS box
    [EL_04002 (Data logger FSG).CATProduct, EL_A0400 (TS Box).CATProduct, EL_A040011.CATProduct, EL_A040011_1.CATPart, EL_A04007.CATProduct, EL_A04007_1.CATPart, EL_A04007_2.CATPart, EL_A0900 Control Unit.CATProduct]
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2021-11-16 Ebauche insert suspension v2
    [ebauche insert Upper Front.CATPart]
2021-11-16 réparation container batterie hv
    [EL_01011 (Container lid).CATPart, Upper container.CATProduct]
2021-11-16 maj connecteurs batterie hv
    [EL_06010 (HVD Assembly).CATProduct, Upper container.CATProduct, cable gland - Copie.CATPart]
2021-11-17 modif LV battery support
    [EL_03002 (LV Battery support).CATPart, EL_A0300 (LV Battery Assembly).CATProduct]
2021-11-17 Ajout de la TS box
    [16mm2-5.stp, 25mm2-10.stp, Cosse 50mm2 - 10.CATPart, EL_04002 (Data logger FSG).CATProduct, EL_A040010.CATProduct, EL_A040011.CATProduct, EL_A040011_1.CATPart, EL_A040013 (HeatSink).CATPart]
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2021-11-17 ébauche chape TS box
    [EL_04012 (TS box support).CATPart, EL_A0400 (TS Box).CATProduct, EL_Electrical.CATProduct]
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2021-11-17 réajout chape ts box
    [EL_04012 (TS box support).CATPart, EL_A0400 (TS Box).CATProduct]
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2021-11-17 Ajout de la chape
    [EL_04002 (Data logger FSG).CATProduct, EL_04012 (TS box support).CATPart, EL_A0400 (TS Box).CATProduct, EL_A040011.CATProduct, EL_Electrical.CATProduct, GeometricalBundle1.CATProduct, Wire Harness.CATPart]
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2021-11-17 Fin de cables hautes puissance
    [ACC+Wire.CATPart, ACC-Wire.CATPart, EL_02001_V2.CATProduct, EL_A0600 (Kill Switch).CATProduct, EL_A1000 (Accumulator).CATProduct, EL_A1400 (Wire Harness ).CATPart, EL_Electrical.CATProduct, El_02007.CATPart]
2021-11-17 Cheey pick Battery support
    [EL_A0300 (LV Battery Assembly).CATProduct]
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2021-11-17 MAJ Câbles haute puissance
    [EL_A1400 (Wire Harness ).CATPart]
2021-11-17 MaJ support baterrie LV
    epaisseur 1.5
    [EL_03002 (LV Battery support).CATPart]
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2021-11-17 MEP Boisard en pdf
    [EL_A0800 (TSAL).CATProduct, EL_Electrical.CATProduct]
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2021-11-23 MaJ GDL
    oubli de qq tubes de 15
    [Shape_006.CATPart, Shape_007.CATPart, Shape_529.CATPart, Shape_530.CATPart, Shape_531.CATPart, Shape_532.CATPart]
2021-11-23 MaJ GDL
    début symétries
    [20x1.5.CATProduct, 25x1.5.CATProduct, FR_Frame.CATProduct, Shape_206.CATPart, Shape_210.CATPart, Shape_222.CATPart, Symmetry of Shape_206.CATPart, Symmetry of Shape_210.CATPart]
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2021-12-05 Suppression ancien data log
    [10000100_BF-7.stp, 1554WAGY.stp, 212 OT_1002699_3DSYM.CATPart, 212 UT_1002700_3DSYM.CATPart, DIN 84 - ersetzt durch DIN EN ISO 1207 M6 x 30.CATPart, EL_02008 (Cable Gland).2.CATPart, EL_02008 (Cable Gland).3.CATPart, EL_02010 (Locking nut).1.CATPart]
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2021-12-05 Remise en place des cables
    [15x1.5.CATProduct, 20x1.5.CATProduct, 25x1.5.CATProduct, 3d2-pg-metr-25.CATPart, ACC+Wire.CATPart, EL_02001_V2.CATProduct, EL_03002 (LV Battery support).CATPart, EL_09002 (Inverter Bracket 1).CATPart]
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2021-12-08 Changement de boite tu TS Box
    [01140010_A-140-SIL.CATProduct, 01140010_A-140-SIL.stp, 01155010_A-155-SIL.CATProduct, 01155010_A-155-SIL.stp, 212 OT_1002699_3DSYM.CATPart, 212 UT_1002700_3DSYM.CATPart, A140 UT_3Dsym.CATPart, A140_150_OT_3Dsym.CATPart]
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2021-12-08 On enlève un truc qui sert à rien de la maquette
    [EL_06004 (BSPD box).CATPart]
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2021-12-11 MaJ fichiers stp
    cellule arrière ok
    [10.stp, 113.stp, 114.stp, 29.stp, 30.stp, 4.stp, 5.stp, 56.stp]
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2021-12-11 Fin des cables au moteurs
    [EL_A0200.ext.CATProduct, EL_Electrical.CATProduct, EN_Engine_Drivetrain.CATProduct, Engine_Chape_Assembly.CATProduct, Frame&Body.CATProduct, HV cable.ext.CATPart, MS_Miscellaneous.CATProduct, ST_Steering.CATProduct]
2021-12-12 MaJ finale fichiers stp
    tous les fichiers stp sont créés et en accord avec la num
    [100.stp, 101.stp, 102.stp, 103.stp, 104.stp, 105.stp, 106.stp, 107.stp]
2021-12-14 Maj TSMP box +stickers
    [EL_06002 (support MS ter).CATPart, EL_A0600 (Kill Switch).CATProduct, EL_Electrical.CATProduct]
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2021-12-14 Maj Resistance CDD '
    [EL_A0400 (TS Box).CATProduct, EL_A04007_2.CATPart]
2021-12-14 MEP upright validé MKI
    [SU_10001 (Front Left Upright).CATPart]
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2021-12-14 Coolant lines colision frame
    [Coolant lines.CATPart]
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2021-12-14 Prod mache laser 1/3
    [Chape_FL_Damper_Down.dxf, Chape_FL_Damper_Up.dxf, Chape_FRocker_F.dxf, Chape_FRocker_R.dxf, Chape_Fw_La_Fp_Low.dxf, Chape_Fw_La_Fp_Up.dxf, Chape_Fw_La_Rp_Up.dxf, Chape_Fw_Ra_Rp_Low.dxf]
2021-12-14 Prod mache laser 2/3
    [Chape_L1.dxf, Chape_L1b.dxf, Chape_L2.dxf, Chape_L2b.dxf, Chape_M1.dxf, Chape_M1b.dxf, Chape_M2.dxf, Chape_M2b.dxf]
2021-12-14 Prod mache laser 3/3
    [Chape_RRocker_F.dxf, Chape_RRocker_R.dxf, Chape_Re_Damper_Down.dxf, Chape_Re_Damper_Up.dxf, Chape_Rw_La_Fp_Low.dxf, Chape_Rw_La_Fp_Up.dxf, Chape_Rw_La_Rp_Up.dxf, Chape_Rw_Ua_Fp_Low.dxf]
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2021-12-15 Revert "Maj TSMP box +stickers"
    This reverts commit 17005fc1ee1b2071820b44bd852353022c45ed87.
    [EL_06002 (support MS ter).CATPart, EL_A0600 (Kill Switch).CATProduct, EL_Electrical.CATProduct]
2021-12-15 Revert "Maj Resistance CDD"
    This reverts commit 2a772e905ab4b8b855edc12b644b6bfb42618e5c.
    [EL_A0400 (TS Box).CATProduct, EL_A04005(1).CATPart, EL_A04005.CATPart, EL_A04007 (Kit de montage).CATProduct, EL_A04007_1.CATPart, EL_A04007_2.CATPart, EL_A04007_3.CATPart, EL_A04007_4.CATPart]
2021-12-15 Revert "Maj Resistance CDD '"
    This reverts commit b6507f2300554acf37ea9c5d36d30db62c1f2aa8.
    [EL_A0400 (TS Box).CATProduct, EL_A04007_2.CATPart]
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2021-12-15 Remise TSMP et solution de RBX pour le connecteur
    [EL_06002 (boitier TSMP montage).CATProduct, EL_09002 (Inverter Bracket 1).CATPart, EL_A0200.CATProduct, EL_A0400 (TS Box).CATProduct, EL_A04005.CATPart, EL_A04005.old.CATPart, EL_A04007_2.CATPart, EL_A04007_3.CATPart]
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2021-12-15 Fin de la TS Box
    [EL_A0400 (TS Box).CATProduct, EL_A04005.CATPart, EL_A04007 (Kit de montage).CATProduct, EL_A04007_3.CATPart, EL_A04007_4.CATPart, Reseaux de cable.CATProduct, cable.CATPart]
2021-12-15 Fin du kit de montage
    [EL_A0400 (TS Box).CATProduct, EL_A04007_1.CATPart, EL_A04007_2.CATPart, EL_A04007_3.CATPart, EL_A04007_4.CATPart, cable.CATPart]
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2021-12-26 Correctifs TdB
    [EL_04001 (Armature).CATPart, EL_04006 (Screen).CATPart, EL_04013 (Screen support).CATPart, EL_A0100 (Dash panel).CATProduct]
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2022-01-04 un max de truc qui font toujours planter le git
    [01116000_A-116.CATProduct, 01116000_A-116.stp, 01120000_A-120.CATProduct, 01140010_A-140-SIL.CATProduct, 01140010_A-140-SIL.stp, 01155010_A-155-SIL.CATProduct, 01155010_A-155-SIL.stp, 04337100_P-337-SIL.stp]
2022-01-04 Première vague réparation fchier stp
    [122.stp, 123.stp, 125.stp, 127.stp, 15x1.5.CATProduct, 33.stp, 35.stp, 62.stp]
2022-01-04 Seconde vague réparation fichiers stp
    [82.stp, 83.stp, 85.stp, 92.stp, 93.stp, Shape_211.CATPart, Shape_212.CATPart, Shape_214.CATPart]
2022-01-05 modifs container de cedric
    [Container Control Box AN.CATPart, EL_01009-Container-mounting-point-front.v2.0.catpart, EL_01021 (Accumulator data connector).CATPart, Laine de verre.CATPart]
2022-01-05 réparation chemin d'acces electrical
    [EL_Electrical.CATProduct]
2022-01-05 Auto stash before rebase of "origin/master"
    Modif frame throttle
    [FR3001_8 cylindre.CATPart, FR_03001_10 cylindre back right.CATPart, FR_03001_4 bord interieur.CATPart, FR_03001_7 Frame Throttle Back.CATPart, FR_03001_8 cylindres middle.CATPart, FR_03001_9 cylindre back left.CATPart]
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2022-01-07 Intégration PDU dans le container
    [EL_01011 (Container lid).CATPart, EL_01012 (Container control box).CATPart, EL_01017 (Control box lid).CATPart, EL_01018 (Accumulator fan).CATPart, EL_1022 (Relay housing).CATPart, EL_1023 (Relay housing cover).CATPart, EL_A1400 (Power Distribution Unit).CATProduct, Upper container.CATProduct]
2022-01-07 integration nouvelles chapes container
    [1,8nF, 50V.CATPart, 100nF, 50V.CATPart, 100nF.CATPart, 150nF, 450V.CATPart, 1N4148_SOD-123_.CATPart, 1mH, 300mA.CATPart, 2,2mH, 250mA.CATPart, 22-23-2021.CATPart]
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2022-01-11 Ajout filaire stp hoop
    [filaire front hoop.stp, filaire main hoop.stp]
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2022-01-12 MEP mache laser + dxf
    [FR_03005 (Rear Throttle bracket).dxf, FR_03007 (Front Throttle bracket).dxf, FR_04001_1 (Frame Brake).dxf, FR_04001_10 (Frame Brake).dxf, FR_04001_11 (Frame Brake).dxf, FR_04001_2 (Frame Brake).dxf, FR_04001_3 (Frame Brake).dxf, FR_04001_5 (Frame Brake).dxf]
2022-01-12 Re-positionnement de la TS box
    La TS box a été légèrement déplacée vers l'avant pour faire de la place pour la batterie LV.
    [EL_03002 (LV Battery support).CATPart, EL_04001 (Armature).CATPart, EL_09002 (Inverter Bracket 1).CATPart, EL_A0100 (Dash panel).CATProduct, EL_A0300 (LV Battery Assembly).CATProduct, EL_A0400 (TS Box).CATProduct, EL_A04007 (Kit de montage).CATProduct, EL_A04007_2.CATPart]
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2022-01-12 Fin des MEP+dxf+dessin pour Guillaume
    [Chape_FL_Damper_Down.dxf, Chape_FL_Damper_Up.dxf, Chape_FRocker_F.dxf, Chape_FRocker_R.dxf, Chape_Fw_La_Fp_Low.dxf, Chape_Fw_La_Fp_Up.dxf, Chape_Fw_La_Rp_Up.dxf, Chape_Fw_Ra_Rp_Low.dxf]
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2022-01-12 Reparation
    à cause d'un chien maigre anonyme
    [122.stp, 123.stp, 125.stp, 127.stp, 15x1.5.CATProduct, 33.stp, 35.stp, 62.stp]
2022-01-13 Ajout tube manquant stp
    [1.stp]
2022-01-13 Ajout tube manquant MaJ
    [1.stp, Shape_7119.CATPart]
2022-01-13 Changement épaisseur tôle countainer
    [Chape_L1b.CATPart, EL_01004 (Container ZY wall).CATPart, EL_01005 (Accumulator ZX wall).CATPart, EL_01006 (Container main divider).CATPart, EL_01009-Container-mounting-point-front.v2.0.catpart, EL_01010-Container-mounting-point-rear.v2.0.catpart, El_01003 (Container bottom).CATPart, El_01007 (Container subdivider).CATPart]
2022-01-13 Changement épaisseur tôle bis
    [EL_01004 (Container ZY wall).CATPart, EL_01005 (Accumulator ZX wall).CATPart, EL_01006 (Container main divider).CATPart, EL_01011 (Container lid).CATPart, EL_01012 (Container control box).CATPart, EL_1022 (Relay housing).CATPart, EL_1023 (Relay housing cover).CATPart, El_01003 (Container bottom).CATPart]
2022-01-15 suppression doublons MEPs la mache laser
    [FR_04007 (Brake R Fixing Rail Wedge).dxf, FR_04008 (Front Fixing Rail Wedge).dxf]
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2022-02-02 Engine Bracket pour Acquacut
    [EN_01008 Right Engine Bracket.dxf, EN_01008.CATPart, EN_01009.CATPart, En_01009 Left Engine Bracket.dxf]
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2022-02-07 meps la mache laser modifiées
    [MS_04003_1 (Lower part).dxf, MS_04003_2 (Lower part).dxf]
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2022-02-08 Pour Guillaume v3
    Toujours un problème, ça vient du fait que 2 tubes sont pas symétriques alors qu'ils devraient l'être
    [EL_01010-Container-mounting-point-rear.v2.0.catpart, EL_A1000 (Accumulator).CATProduct, FR_Frame.CATProduct, Frame&Body.CATProduct, Lower container.CATProduct, Upper container.CATProduct]
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2022-02-16 Ajout fente carte SD
    [EL_04006 (Screen).CATPart, EL_04013 (Screen support).CATPart]
2022-02-16 Auto stash before rebase of "origin/master"
    Support LV
    [EL_03002 (LV Battery support).CATPart, EL_03002-LV-Battery-support.catpart, EL_A0300 (LV Battery Assembly).CATProduct, EL_Electrical.CATProduct, Shape_080.CATPart, Symmetry of Shape_225.CATPart]
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2022-02-16 Ajout support écran en stp
    [EL_04013 (Screen support).CATPart, EL_04013 (Screen support).stp]
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2022-03-02 meps lm prod / centrale
    [EN_04006 (Sprocket Bearer).CATPart, FR_04002 (Brake Pedale Stick).stp]
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2022-03-08 Ajout Electrical System Form
    [ESF.xlsx]
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2022-03-11 LV Battery support + gabarit appui tete
    [EL_03002 (LV Battery support).CATPart, EL_03002-LV-Battery-support.catpart, Gabarit_appui_tete.CATPart]
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2022-03-14 ha clairement c la merde la
    [ESF.xlsx]
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2022-03-16 proto plaque renfort TS/TSAC protection
    [Chape proto sup.CATPart, FR_A0700.CATProduct, FR_Frame.CATProduct, Frame&Body.CATProduct, Plate prototype.CATPart]
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2022-03-19 ESF charging and TS Schematics
    [ESF.xlsx]
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2022-03-29 plaques renfort chassis v2
    [FR_A0700.CATProduct, Plate prototype.CATPart]
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2022-03-29 Gabarit triangle avant bas
    [E_tr_bas.CATPart, E_tr_bas_2.CATPart, Gabarit_tr_av_bas.CATPart, Gabarit_triangle_bas.CATProduct, triangle_av_g_bas.CATPart]
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2022-03-30 MAJ gabarit pince arrière
    [E_droite.CATPart, E_gauche.CATPart, E_pince.CATPart, Gabarit_assemble_arriere_bas.CATProduct, Gabarit_pince.CATPart, Gabarit_pince_h.CATPart, L_pince.CATPart, piece_principale_arriere_bas.CATPart]
2022-03-31 Ajout gabarit BAR et steering
    [Gabarit_BAR.CATPart, Gabarit_rack.CATPart, ST_05002 (Rear Bracket).CATPart, Support.CATPart, Support_rack.CATPart]
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2022-07-04 reparation lien cassé elec
    [EL_Electrical.CATProduct, chapes_159OU.CATPart]
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2022-07-18 upper container electronics maj
    [22-23-2021.CATPart, 5100-471 Box.CATPart, 5100-471 LID.CATPart, 8STA-00-10_NOT-LISTED.stp, AMS PCB housing.CATProduct, AMS housing.CATPart, AMS_TNN_V1.0.CATProduct, AMS_ext_boitier.stp]
2022-07-18 upper container add souriau connector
    [AMS_LV_souriau_size_06.stp, AMS_ext_boitier.stp, AMS_ntc_sensor_souriau_size_16.stp, EL_14004 (Precharge circuit PCB).CATProduct, EL_14005 (Indicator voltage PCB).CATProduct, EL_14006 (TSAL PCB).CATProduct, EL_A1000 (Accumulator).CATProduct, Indicator_voltage_souriau_size_06.CATPart]
2022-07-18 add battery tyva v2 stp
    [Battery tyva v2.CATProduct]
2022-09-09 Ajout gabarit basculeur AV
    [E_gauche.CATPart, E_pince.CATPart, E_tr_bas.CATPart, E_tr_bas_2.CATPart, Gabarit_arriere_haut_assemble.CATProduct, Gabarit_assemble_arriere_bas.CATProduct, Gabarit_basculeur.CATProduct, Gabarit_basculeur_corp.CATPart]
2022-09-27 Modif chape basculeur AV
    [Chape_FL_Damper_Up.CATPart]
2022-09-28 Mise en plan dossier mache
    [20C_ST_04003 (spacer).igs, Chape_FL_Damper_Up.dxf, Chape_Fw_La_Fp_Low.dxf, Chape_Fw_La_Rp_Up.dxf, Chape_Fw_Ra_Rp_Low.dxf, Chape_Fw_Ua_Fp_Low.dxf, Chape_Fw_Ua_Rp_Up.dxf, Engine_Chape_Assembly.CATProduct]
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2022-10-04 Ajout ancienne version TSAL ZZG
    [TSAL [Proteus 8.0].pdsprj, TSAL_inv_meas.brd, TSAL_inv_meas.sch, TSAL_logic.brd, TSAL_logic.sch, TSAL_mainboard.brd, TSAL_mainboard.sch]
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2022-11-15 Verif MEP + Container mounting point
    [EL_01009 OK(Container mounting point).v2.0.CATPart, EL_06008 SUpport HVD.dxf, EL_06010.dxf, EL_12002 Chape Inertia Switch.dxf]
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2022-11-15 Ajout Gabarit direction + MEP fabrique
    [EL_01010-Container-mounting-point-rear.v2.stp, FR_010001 (Insert front).stp, FR_010002 (Insert rear).stp, FR_XXXX(Insert batterie).dxf, GST_pivot.CATProduct, GST_pivot_1.CATPart, GST_pivot_2.CATPart, GST_pivot_3.CATPart]
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2022-11-16 Ré-organisation Dossier Brake Light
    [EL_A1101 (Brake light).CATPart, EL_A1102 (Chape brake light).CATPart]
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2022-11-23 Gabarit tr av bas et direction
    [Chape_FL_Damper_Up.CATPart, EL_01009 OK(Container mounting point).dxf, EL_01009 OK(Container mounting point).v2.stp, EL_01010-Container-mounting-point-rear.v2.stp, EN_01008 Right Engine Bracket_V3.dxf, E_tr_bas.CATPart, E_tr_bas_2.CATPart, En_01009 Left Engine Bracket_V3.dxf]
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2022-11-24 MEP gabarit MS bis
    [attache main hoop.dxf]
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2022-11-30 ajout MEP gabarit triangles arrières
    [E_gauche_2.dxf, E_pince.dxf, E_pince_2.dxf, Gabarit_arriere_haut_assemble.CATProduct, Gabarit_assemble_arriere_bas.CATProduct, Gabarit_pince.dxf, Gabarit_pince_h.dxf, MEP_goupille.dxf]
2022-11-30 assembly avec triangles arrères
    [Suspension_chape_assembly.CATProduct]
2022-12-07 Gabarit collage+MEP la fabrique igs
    [GSU_collage_AV.CATPart, SU_collage_AV.CATProduct]
2022-12-07 Remise Cylinder screw distribution
    [Attache front hoop bis.CATPart, Attache front hoop bis.dxf, Attache front hoop.dxf, FR_04009 (Distribution Brake Axle).CATPart, FR_04011 (Distribution Brake Cylinder).CATPart, FR_04016 (Cylinder Screw Disctribution).CATPart, FR_A(03-04)00 (Pedal Assy).CATProduct, FR_A0400 (Brake Pedal).CATProduct]
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2022-12-31 Duplication du pédalier et ajout de la frame d'Invictus
    [FR_04001 (Frame Brake).CATPart, FR_04001 (Frame Brake).CATProduct, FR_04001_1 (Frame Brake).CATPart, FR_04001_10 (Frame Brake).CATPart, FR_04001_11 (Frame Brake).CATPart, FR_04001_12 (Frame Brake).CATPart, FR_04001_13 (Frame Brake).CATPart, FR_04001_14 (Frame Brake).CATPart]
2023-01-04 mise en place du nouveau système de fixation du BOTS
    [6x25.CATPart, FR_03002 (Footrest).CATPart, FR_04001 (Frame Brake).CATProduct, FR_04001_1 (Frame Brake).CATPart, FR_04001_10 (Frame Brake).CATPart, FR_04001_11 (Frame Brake).CATPart, FR_04001_12 (Frame Brake).CATPart, FR_04001_13 (Frame Brake).CATPart]
2023-01-04 J'avais oublié ces pièces de la fixation BOTS
    [FR_04019 (BOTS support 1).CATPart, FR_04020 (BOTS support 2).CATPart]
2023-01-08 Nouvelle version Pédale avec BOTS
    [FR_04001 (Frame Brake).CATProduct, FR_A0400 (Brake Pedal BOTS).CATProduct, Support BOTS v2.1_piece 1.CATPart, Support BOTS v2.1_piece 2.CATPart]
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2023-01-10 Mise en place support BOTS
    [FR_04001 (Frame Brake).CATProduct, FR_A0400 (Brake Pedal BOTS).CATProduct, Part170.CATPart, Support BOTS v2.1_piece 1.CATPart, Support BOTS v2.1_piece 2.CATPart]
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2023-01-11 Ajout assemblage BOTS 1
    [BOTS 1.CATProduct, FR_04001 (Frame Brake).CATProduct, FR_04001_2 (Frame Brake).CATPart, FR_04002 (Brake Pedale Stick).CATPart, FR_04006 (Brake Fixing Rail).CATPart, FR_04015 (Brake Pedal Hose Wedge.CATPart, FR_A0400 (Brake Pedal BOTS).CATProduct, Support 2.CATPart]
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2023-01-11 Ajout des 2 versions du BOTS
    [BOTS 1.CATProduct, BOTS 2.CATProduct, FR_04001 (Frame Brake).CATProduct, FR_04001_1 (Frame Brake).CATPart, FR_04001_2 (Frame Brake).CATPart, FR_04006 (Brake Fixing Rail).CATPart, FR_04008 (Front Fixing Rail Wedge).CATPart, FR_04013 (BOTS Support).CATPart]
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2023-01-12 Résolution pièces cachées BOTS
    [FR_04001_1 (Frame Brake).CATPart, FR_04001_2 (Frame Brake).CATPart, FR_04004 (Master Cylinder).CATPart, FR_04006 (Brake Fixing Rail).CATPart, FR_04008 (Front Fixing Rail Wedge).CATPart, FR_A0400 (Brake Pedal BOTS).CATProduct]
2023-01-16 MEP la mache laser
    [ST_03003 (cale) .CATPart, ST_03003 (cale).stp, SU_05003 (cale) .CATPart, SU_06001 (Front Rocker).stp, SU_06001 (front Rocker 3 mm).dxf, SU_08001 (Rear Rocker 3 mm).dxf, SU_08001 (Rear Rocker).stp]
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2023-02-01 Placement boitiers LV - TSAL, BSPD, FuseBox
    [1.1.CATPart, EL_03002 (LV Battery support).CATPart, EL_Electrical.CATProduct, enclosure_rnd_455-00854.CATPart, fuseBox.CATPart]
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2023-02-01 Mise à jour trous dashboard
    Corrections trous du dashboard
    [EL_04001 (Armature).CATPart]
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2023-02-22 cale Front brake disc
    [BR_01003 (Cale Front Brake Disc).CATPart, FR_Frame.CATProduct, Front Left Wheel Assy.CATProduct, ST_A0300 (connecting rod).CATProduct, ST_A0500.CATProduct, ST_A0600 (Steering Shaft Pivot).CATProduct, ST_Steering.CATProduct, SU_06001 (Front Rocker).CATPart]
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2023-02-28 Modification distribution brake cylinder
    [FR_04011 (Distribution Brake Cylinder).CATPart, FR_A0400 (Brake Pedal).CATProduct]
2023-03-05 Fin de rémi madness
    [ARB Wireframe.CATPart, ASKUBAL_G_6_D0_0_rear_tie_rod.catproduct, ASKUBAL_KA_6_D0_0_direction1.catproduct, ASKUBAL_KA_6_D0_0_direction2.catproduct, EN_01002 (flanged shaft).stp, EN_01008_V2.CATPart, EN_01009_V2.CATPart, FR_Frame.CATProduct]
2023-03-05 Retour de la LAS
    [FR_Frame.CATProduct, Front Left Wheel Assy.CATProduct, ST_A0300 (connecting rod).CATProduct, ST_A0500.CATProduct, ST_A0600 (Steering Shaft Pivot).CATProduct, ST_Steering.CATProduct, SU_06001 (Front Rocker).CATPart, SU_10001 (Front Left Upright).CATPart]
2023-03-05 Rajout de la dernière pièce de merde
    [WT_02003 (Front Bearing Washer).CATPart]
2023-03-07 Début design upper_container busbars
    [EL_1021 (Accumulator power connector male part).CATPart, Upper container.CATProduct]
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2023-03-14 Design busbars v1
    Crétion de deux pièces busbar dans upper containes
    [EL_01024 (Rear busbar).CATPart, EL_01025 (Front busbar).CATPart, EL_1021 (Accumulator power connector male part).CATPart, Upper container.CATProduct]
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2023-03-14 SES + qqs MEP non pushées
    [EL_04001 (Armature).CATPart, FS23_SES_Valkyriz_v1.0.xlsx, FS23_SES_Valkyriz_v3.0.xlsx]
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2023-03-16 ses accumulator mounting point
    [EL_01009 (Container mounting point front).CATPart, EL_01009 (Container mounting point front).v2.0.CATPart, EL_01009 OK(Container mounting point).dxf, EL_01009 OK(Container mounting point).v2.stp, EL_01009 v3.0 (Container mounting point fron)..CATPart, EL_01009 v3.0 (Container mounting point).CATPart, EL_01009-Container-mounting-point-front.v2.0.catpart, EL_01010 (Container mounting point rear).CA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]
2023-03-16 tubes qui apparaissaient pas
    [FR_Frame.CATProduct]
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2023-03-17 Mise à jour lower container avec support + vis M8 + SES finis pour Container Attachment
    [Lower container.CATProduct, boulon container mounting point.CATProduct]
2023-03-17 Ajout de la facture de la crashbox
2023-03-17 SE3D igs avec les tubes
    [15x1.5.CATProduct, 25x1.5.CATProduct, FR_Frame.CATProduct, Frame&Body.CATProduct, Shape_188.CATPart, Tubes.CATProduct, pute.CATPart, pute2.CATPart]
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2023-03-30 Auto stash before rebase of "origin/master"
    MEP pour caisson batterie bois
    [(((Attaches Lower (x2)))).dxf, Container bas plaque largeur (x2).dxf, Couvercle (x1).dxf, Moyen container dessus coté 1 (x2).dxf, Moyen container dessus coté 2 (x2).dxf, Petit container dessus grand côté (x1).dxf, Petit container dessus petit côté (x2).dxf, Plaque latérale (x2).dxf]
2023-04-26 Support pompe + quelques modifs show/hide
    [Chape_U1b.CATPart, Chape_U2b.CATPart, EN_02010 (pump_support).CATPart, EN_A0200 (Cooling system).CATProduct, EN_A0400 (Drivetrain).CATProduct, EN_Engine_Drivetrain.CATProduct, Engine_Chape_Assembly.CATProduct, Frame.CATPart]
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2023-05-11 Rectification cover sheet ses
    [FS23_SES_v1.0.xlsx]
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2023-05-14 Correction ses EV5 et EV5.5
    Correction partie batterie pour satisfaire les juges
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2023-05-17 SES v3 1e version (+ ajout de points sur la TP)
    [FR_03001 (Frame Throttle).CATPart]
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2023-05-27 Nettoyage maquette (aïe) v1
    [1590U (3).CATProduct, EL_Electrical.CATProduct, EN_02002 (Water Pump).CATPart, EN_A0100 (Engine).CATProduct, EN_A0200 (Cooling system).CATProduct, EN_Engine_Drivetrain.CATProduct, Engine_Chape_Assembly.CATProduct, FRA0500 (CrashBox + AIP).CATProduct]
2023-05-28 Alignement EN avec la maquette
    [1590U (3).CATProduct, EL_06002 (boitier TSMP montage).CATProduct, EL_09002 (Inverter Bracket 1).CATPart, EL_A0100 (Dash panel).CATProduct, EL_A0300 (LV Battery Assembly).CATProduct, EL_A0400 (TS Box).CATProduct, EL_A04007 (Kit de montage).CATProduct, EL_A04007_2.CATPart]
2023-05-28 Nettoyage maquette (aïe) v2
    [EL_03002 (LV Battery support).CATPart, EL_03002-LV-Battery-support.catpart, EL_A03004 (Overflow Bottle Support).CATPart, EN_03003_(Fixation).CATPart, EN_A0100 (Engine).CATProduct, EN_A0300_(Overflow Bottle).CATProduct, Engine_Chape_Assembly.CATProduct, FrameWireframe.CATPart]
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2023-05-28 Nettoyage et archéologie de dingueries
    [EL_06002 (boitier TSMP montage).CATProduct, EL_A0100 (Dash panel).CATProduct, EL_A0200.ext.CATProduct, EL_A0300 (LV Battery Assembly).CATProduct, EL_A0600 (Kill Switch).CATProduct, EL_A1000 (Accumulator).CATProduct, EL_Electrical.CATProduct, FR_Frame.CATProduct]
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2023-05-29 TS Box, BAMOCAR, câbles
    Je crois que je vais mourir jeune
    [EL_02004 (Coolant Lines) NEW.CATPart, EL_02004 (Coolant Lines) NEW2.CATPart, EL_06002 (boitier TSMP montage).CATProduct, EL_09002 (Inverter Bracket 1).CATPart, EL_A0100 (Dash panel).CATProduct, EL_A0200.ext.CATProduct, EL_A0300 (LV Battery Assembly).CATProduct, EL_A0400 (TS Box).CATProduct]
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2023-06-06 Câbles circuit de refroidissement
    [EL_02004 (Coolant Lines) NEW.CATPart, EL_09003 BAMOCAR_D3.CATProduct, EL_A0900 Control Unit.CATProduct, EL_Electrical.CATProduct, EN_02002 (Water Pump).CATPart, EN_A0100 (Engine).CATProduct, EN_A0200 (Cooling system).CATProduct, EN_Engine_Drivetrain.CATProduct]
2023-06-06 Câbles circuit de refroidissement 2
    J'ai fait un câble en trois heures et il était pas au bon endroit. Une bonne productivité finalement.
    [EL_02004 (Coolant Lines) NEW.CATPart]
2023-06-07 Câbles circuit de refroidissement 3
    C'est le début d'une grande aventure
    [EL_02004 (Coolant Lines) NEW.CATPart, EN_02011 (croisement tubes).CATPart, EN_A0200 (Cooling system).CATProduct, EN_Engine_Drivetrain.CATProduct]
2023-06-09 CABLES 2
    Vraiment tout ça pour ça, c'est honteux
    [EL_02004 (Coolant Lines) NEW.CATPart, EN_01009.CATPart, EN_A0100 (Engine).CATProduct, EN_Engine_Drivetrain.CATProduct, FR_Frame.CATProduct, ST_A0300 (Tie Rod V2).CATProduct, ST_A0500.CATProduct, ST_Steering.CATProduct]
2023-06-09 Quelques ajouts
    Je fais plus d'EPSA pour les six prochaines semaines allez
    [EL_Electrical.CATProduct, FR_A(03-04)00 (Pedal Assy).CATProduct, Frame&Body.CATProduct]
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2023-10-24 Ahah je suis une branche
    [branche.xlsx]
2023-10-24 Revert "Ahah je suis une branche"
    This reverts commit 1d6451782a1d9b069bb7d48dd950595e2812da3c.
    [branche.xlsx]
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2023-10-25 mise en plan de Chape_RRocker_R
    [Chape_RRocker_R.CATPart]
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2023-11-08 rangement dossier chapes SU
    [Chape_RRocker_R.dxf]
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2023-11-08 Modif chape + mep rocker
    [Chape_RRocker_R.dxf]
2023-11-08 mise en plan chapes
    [Chape_FL_Damper_Down.CATPart, Chape_FL_Damper_Down.dxf, Chape_Re_Damper_Down.dxf, Chape_Re_Damper_Up.dxf, Chape_tie-rod_Low.dxf]
2023-11-12 Rangement + modification chapes EN
    modification des rayons exterieur pour respecter la règle T10.1.4 pour Engine
    [Chape_FL_Damper_Down.dxf, Chape_L1.CATPart, Chape_L1b.CATPart, Chape_L2.CATPart, Chape_L2b.CATPart, Chape_M1.CATPart, Chape_M1b.CATPart, Chape_M2.CATPart]
2023-11-12 Chapes basculeur avant et roll bar
    ajout du travail de Samuel (SEM)
    [Chape_FL_Damper_Up.dxf, Chape_FRocker_R.dxf, Chape_tie-rod_Up.dxf]
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2023-12-05 Gabarit arriere bas serré
    [E_droite.CATPart, E_gauche.CATPart, E_pince.CATPart, Gabarit_assemble_arriere_bas.CATProduct, Gabarit_pince.CATPart, Gabarit_pince_h.CATPart]
2023-12-05 gabarit arrière haut serré
    [Gabarit_arriere_haut_assemble.CATProduct, piecesupport_arriere_haut_finie.CATPart]
2023-12-05 gabarit avant bas serré
    [E_tr_bas.CATPart, E_tr_bas_2.CATPart, Gabarit_triangle_bas.CATProduct]
2023-12-05 gabarit avant haut serré
    [Gabarit_final_assemble.CATProduct, piece1_finale.CATPart, piece2_finale.CATPart]
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2024-01-04 Mesures sur la batterie TYVA
    [EL_14001(Accumulator Isolation Relays +).CATPart, EL_14003 (Precharge_relays).CATPart, EL_A1000 (Accumulator).CATProduct]
2024-01-24 Revert "Mesures sur la batterie TYVA"
    This reverts commit 2e26c1a6a5b55764fcba92f8e7dcb7fd7e12b945.
    [EL_14001(Accumulator Isolation Relays +).CATPart, EL_14003 (Precharge_relays).CATPart, EL_A1000 (Accumulator).CATProduct]
2024-01-30 Revert "Auto stash before merge of "master" and "origin/master""
    This reverts commit 2e9067c702981155eec5676b5724e46116ad0a90.
    [1,8nF, 50V.CATPart, 1.1.CATPart, 100nF, 50V.CATPart, 100nF.CATPart, 10x25.CATPart, 10x30.CATPart, 150nF, 450V.CATPart, 1590U BOX.CATPart]
2024-01-30 Ajout du système TSAC
    [EL_A1001 (TSAC).CATProduct, Upper container.CATProduct]
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2024-02-07 modif insert arrière haut
    [SU_03003 (Rear Upper Rod-End Support).CATPart, SU_03004 (Couvercle rotule).CATPart, SU_A0300 (Rear Upper A-Arms).CATProduct]
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2024-03-04 de tout pas important
    [Front Left Wheel Assy.CATProduct, Rear Left Wheel Assy.CATProduct, SU_06002 (pivot joint spacer).CATPart, SU_A0100 (Front Upper A-Arm).CATProduct, SU_A0200 (Front Lower A-Arms).CATProduct, SU_A0300 (Rear Upper A-Arms).CATProduct, SU_A0400 (Rear Lower A-Arm).CATProduct, SU_A0500 (Tie Rod).CATProduct]
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2024-03-12 prepa gabarits en 5mm pour Artemiz
    [E_tr_bas.CATPart, E_tr_bas_2.CATPart, GSU_L.dxf, GSU_goupille.dxf, GSU_tr_av_bas_E_1.dxf, GSU_tr_av_bas_L.dxf, GSU_tr_av_bas_cale.dxf, GSU_tr_av_bas_p.dxf]
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2024-05-28 Gabarits SU_14011 et ST_04003
    [GA_ST04003.CATPart, ST_04003 (Left Bracket).CATPart, ST_A0300 (Tie Rod V2).CATProduct, ST_A0400 (Rack support) .CATProduct, ST_A0500.CATProduct, ST_Steering.CATProduct, Wireframe_ST_A0500.CATPart]
2025-02-18 Modifs support moteur
    Retouches support moteur gauche et MEP 1
    [EN_01006 (stator scatter shield).CATPart, EN_01009.CATPart, EN_A0100 (Engine).CATProduct, bracket_resolver_208_228.CATPart, resolver_1pp.CATPart]
2025-05-22 shields
    modifs shield chaine et moteur
    [Chainshield_bracket.CATPart, EN_01002 (flanged shaft) v2.CATPart, EN_01003 (engine sprocket).CATPart, EN_01004 (rondelle de serrage).CATPart, EN_01005.CATPart, EN_01006 (stator scatter shield).CATPart, EN_01007 (rotor scatter shield round).CATPart, EN_01008.CATPart]
2025-05-23 modifs shields
    modifs pour ajouter casing moteur/nouveau protège chaine
    c'est très mal rangé attention
    [EN_02001 (Radiator).CATPart, EN_02002 (Water Pump).CATPart, EN_04010 (Chain Shield).CATPart, EN_A0100 (Engine).CATProduct, EN_A0200 (Cooling system).CATProduct, EN_A0400 (Drivetrain).CATProduct, EN_Engine_Drivetrain.CATProduct, Engine_Chape_Assembly.CATProduct]
