EOSCogniton/ELIZ-2021/(notices)

Notices in the files:
ST_Steering_System/ST_A0600 (Steering shaft pivot)/ST_A06007 (Ball Joint).stp:
FILE_NAME( 'p:/temp/worker_239/temp/exporttempdir_2660_302_Dfhzs/format_0/SALKB 16 F.stp', '2021-02-03T15:56:04', ( 'License CC BY-ND 4.0' ), ( 'CADENAS' ), ' ', 'PARTsolutions', ' ' );
